bigJRo/KerbalControllerMk1/README.md

# KerbalControllerMk1

Code base for the **Kerbal Controller Mk1** — a modular hardware flight controller
for *Kerbal Space Program*, built around Teensy microcontrollers that talk to KSP
via the [KerbalSimpit](https://github.com/Simpit-team/KerbalSimpitRevamped) plugin.
The system is a set of I2C-networked panels and input modules coordinated by a
central master controller.

## Repository layout

| Path | Contents |
|---|---|
| [`Software/KCMk1_Master/`](Software/KCMk1_Master/README.md) | Master controller firmware (Teensy 4.1 on the Ctrl Module) ([design](Documents/Developer/Master_Firmware_Design.md)). It replaced `Controller_Main`, deleted at the cutover |
| `Software/Displays/` | Display-panel firmware and shared display libraries (see below) |
| `Software/Modules/` | Input-module firmware (buttons, switches, joysticks, encoders, 7-segment, etc.) |
| `Software/Libraries/`, `Software/Common/` | Shared cross-project code |
| `Documents/Developer/` | [Hardware inventory](Documents/Developer/Hardware_Inventory.md) (from the schematics; supersedes the Hardware Reference where they differ), [master firmware design](Documents/Developer/Master_Firmware_Design.md), hardware reference, I2C protocol spec, power budget, module/UI reference, ascent-autopilot interface, expansion-module spec, [display test plan](Documents/Developer/Display_Test_Plan.md) |
| `Documents/User/` | [Quick-start guide](Documents/User/Quick_Start_Guide.md), panel operating guide, and the display references: [Annunciator](Documents/User/Annunciator_Caution_Warning_Reference.md), [Information Displays](Documents/User/Info_Display_Screen_Reference.md), [Resource Display](Documents/User/Resource_Display_Reference.md) (each also as `.docx`) |

### Display panels (`Software/Displays/`)

The display subsystem targets **hardware rev 2**: Teensy 4.1 driving a 7″
1024×600 LT7683 (RA8876-compatible) TFT over a 16-bit 8080 parallel bus, with
FT5316 capacitive touch. (The LT7683 is the physical display controller; it is
register-compatible with the RA8876, whose driver library the firmware uses.)
(Porting status and hardware details are in
[`Software/Displays/PORTING_7inch_TFT.md`](Software/Displays/PORTING_7inch_TFT.md)
and [`Documents/Developer/Hardware_Reference.md`](Documents/Developer/Hardware_Reference.md).)

| Sketch / library | Role |
|---|---|
| `KCMk1_Annunciator/` | Caution & Warning annunciator panel (I2C 0x10) |
| `KCMk1_InfoDisp/` | Flight information display — 13 telemetry screens (I2C 0x12) |
| `KCMk1_ResourceDisp/` | Resource display (I2C 0x11) — up to 16 resource tape meters (9 by default) + EVA mode |
| `libraries/KerbalDisplayCommon/` | Shared UI toolkit — drawing, fonts, formatting, threshold colouring |
| `libraries/KCM_Display`, `KCM_Touch`, `KCMk1_SystemConfig` | Display driver wrapper, touch driver, shared pin map + thresholds |
| `libraries/KerbalDisplayAudio/` | Master-alarm audio (PAM8302A amp + speaker) + DFPlayer audio |
| [`SD_Cards/`](Software/Displays/SD_Cards/README.md) | Ready-to-copy microSD card contents, one folder per display firmware (built from `assets/`) |

Each panel sketch has its own README with per-panel wiring, dependencies, and
screen documentation.

## License

Licensed under the GNU General Public License v3.0 (GPL-3.0).
Written by J. Rostoker for Jeb's Controller Works.
