bigJRo/KerbalControllerMk1/Software/Displays/KCMk1_InfoDisp/README.md

# KCMk1_InfoDisp

**Kerbal Controller Mk1 — Information Display Panel Sketch** · v1.18.0
Teensy 4.1 firmware for the KSP flight information display module.
Part of the KCMk1 controller system. Operates as an I2C slave under a Teensy 4.1 master.

---

## Overview

The Information Display is a 1024×600 touchscreen panel that presents real-time KSP flight telemetry sourced from KerbalSimpit. It runs on a Teensy 4.1 and receives telemetry over USB serial from a running KSP instance.

The panel provides fourteen screens — Launch, Ascent Autopilot, Spacecraft/Aircraft/Rover/Vehicle (PFD), Orbit (+ Advanced Elements + Maneuver), Target/Docking/Navigation, Landing (Powered Descent + Re-entry) — ordered to follow mission phase progression from pre-launch through landing. Navigation is via a sidebar of six buttons on the panel's outboard edge. A first press of a button jumps to its context/primary screen; pressing the button that already owns the active screen cycles that button's modes, and the caption shows the active mode. Title-bar taps no longer switch screens.

**Two units, two roles.** The controller carries two Info Displays, and they are not clones. Both run this firmware and every screen is reachable from either panel, but each has a job and a different set of defaults:

| | Info Display 1 (0x12, panel A1) | Info Display 2 (0x13, panel B1) |
|---|---|---|
| Role | Vehicle-type — *what am I flying?* | Mission-phase — *what phase am I in?* |
| Holds | The PFD family: SPACECRAFT / AIRCRAFT / ROVER / VEHICLE | LAUNCH / LANDING / DOCKING / TARGET / NAVIGATION / MANEUVER / ORBIT |
| Resting screen | SPACECRAFT (PFD) | ORBIT |
| Home screen (boot / standby / demo) | SPACECRAFT (PFD) | LAUNCH |
| Sidebar edge | Left (outboard on A1) | Right (outboard on B1) |
| Sixth button | VEH — Vehicle Info | A/P — the autopilot consoles |
| Ascent Autopilot | Not carried; cannot send commands | Sole owner of the command channel |

Both panels sit inboard on their own half of the console, so their content areas meet at the centreline and read as one field, with the two button columns falling outboard under the pilot's respective hands.

**Context-switching:** Each panel runs its own ladder every frame and follows the mission to the most appropriate screen for its role; see [Context Switching](#context-switching) below. A deliberate sidebar selection latches, and releases when the situation it was set against passes, when the pilot presses back to the ladder's choice, or when the vessel or the scene changes.

**Colour conventions** are consistent across all screens: dark green = nominal, yellow = caution, white-on-red = alarm, dark grey = inactive/not applicable, cyan = pilot-entered or pending. Alarm thresholds are aligned with the KCMk1 Annunciator C&W panel.

The sidebar is deliberately outside that vocabulary: its keys are chrome, not data, so they are achromatic — white-on-black unselected, black-on-grey selected — and colour appears on a key only when it carries live state. This is the convention bezel-key flight decks use (a Garmin G1000 softkey row is exactly this), and it keeps the alerting colours available to the telemetry the sidebar frames.

---

## Hardware

| Component | Part | Interface |
|---|---|---|
| Microcontroller | Teensy 4.1 | — |
| Display | LT7683 (RA8876-compatible) 1024×600 7" IPS TFT | 8080 16-bit parallel |
| Touch controller | FT5316 capacitive | software I2C |
| SD card | Teensy 4.1 on-board microSD | SDIO (`BUILTIN_SDCARD`) |
| KSP telemetry | KerbalSimpit plugin | SerialUSB1 (second USB COM port, e.g. COM5) |
| I2C slave bus | Master Teensy 4.1 at 0x12 (Info Display 1) or 0x13 (Info Display 2) | Wire2 (pins 24/25) |

The display controller is the **LT7683** (the physical part on the ER-TFT070A2-6-5633 module); it is register-compatible with the RA8876, so the firmware drives it through the `wwatson4506/TeensyRA8876-8080` FlexIO3 driver (class `RA8876_t41_p`). "RA8876" therefore appears in driver/library/class names throughout, while the hardware part is the LT7683.

See `Documents/Developer/Hardware_Reference.md` (§8.3, KC-01-1912 carrier) for the display-carrier hardware detail.

### Pin Assignments

All pins are defined in `KCMk1_SystemConfig.h` (hardware rev 2: Teensy 4.1 + LT7683 (RA8876-compatible) 8080-parallel carrier, KC-01-1912). The 16 display data lines are driven by the Teensy 4.1 FlexIO3 hardware via the `wwatson4506/TeensyRA8876-8080` driver — the defines below are documentation; the driver owns the data/WR/RD lines.

| Pin(s) | Function | Direction | Define |
|---|---|---|---|
| 19,18,14,15,40,41,17,16,22,23,20,21,38,39,26,27 | Display data bus DB0..DB15 (FlexIO3) | — | `KCM_TFT_DB0..DB15` |
| 34 | Display /CS chip select | OUT | `KCM_TFT_CS` |
| 33 | Display RS register/data select | OUT | `KCM_TFT_RS` |
| 35 | Display /RESET | OUT | `KCM_TFT_RESET` |
| 36 | Display /WR write strobe | OUT | `KCM_TFT_WR` |
| 37 | Display /RD read strobe | OUT | `KCM_TFT_RD` |
| 32 | Display WAIT (busy from LT7683) | IN | `KCM_TFT_WAIT` |
| 31 | Display INT (from LT7683, unused) | IN | `KCM_TFT_INT` |
| 9 | Backlight enable / PWM | OUT | `KCM_TFT_BL` |
| 4 | Touch software-I2C SCL | — | `KCM_CTP_SCL` |
| 5 | Touch software-I2C SDA | — | `KCM_CTP_SDA` |
| 3 | Touch /RESET (active-LOW) | OUT | `KCM_CTP_RST` |
| 6 | Touch INT (data-ready) | IN | `KCM_CTP_INT` |
| 29 | Master-alarm tone → PAM8302A amp | OUT | `KCM_AUDIO_TONE_PIN` |
| 7,8 | DFPlayer Mini serial (Serial2 RX2/TX2) | — | `KCM_DFPLAYER_SERIAL` |
| 11 | DFPlayer BUSY (net AUDIO_BUSY, LOW = playing) | IN | `KCM_AUDIO_BUSY_PIN` |
| 24,25 | I2C slave bus to master (Wire2 SCL2/SDA2) | — | `KCM_I2C_BUS` |
| 0 | I2C INT (active-LOW, output to master) | OUT | `KCM_I2C_INT_PIN` |
| 1 | I2C RST (shared reset line from master) | IN | `KCM_I2C_RST_PIN` |

**Serial ports:**
- `Serial` (USB COM port 1) — debug output when `debugMode = true`
- `SerialUSB1` (second USB COM port, e.g. COM5) — KerbalSimpit telemetry

**I2C note:** The slave interface to the Teensy 4.1 master is on **Wire2 (pins 24/25)**. Pins 18/19 (Wire) and 16/17 (Wire1) are consumed by the display data bus, so FT5316 touch runs on a bit-banged software-I2C bus (pins 4/5).

---

## Dependencies

| Library | Version | Notes |
|---|---|---|
| KerbalDisplayCommon | ≥ 3.11.0 | Display primitives, fonts, value formatting (String and buffer forms), threshold colouring, the shared readout label colour (pulls in KCM_Display) |
| KCM_Display | ≥ 1.1.0 | `KCM_TFT` display type = `RA8876_t41_p` + shared resolution/pins; the `kcmBacklight*()` backlight helper (this repo) |
| KCM_Touch | — | FT5316 5-point capacitive touch driver (this repo) |
| KCMk1_SystemConfig | ≥ 1.3.0 | Shared hardware pin map + cross-panel threshold constants; the backlight defaults and the BACKLIGHT frame constants (this repo) |
| TeensyRA8876-8080 (`RA8876_t41_p`) + TeensyRA8876-GFX-Common | — | RA8876 8080-parallel display driver (wwatson4506) |
| ILI9341_fonts (PaulStoffregen) | — | ILI9341_t3 font format used by KerbalDisplayCommon |
| KerbalDisplayAudio | — | Master-alarm audio (`tone()`, pin 29 → PAM8302A amp) + DFPlayer support |
| KerbalSimpit | 2.4.0 | KSP telemetry plugin interface |

### KerbalSimpit Plugin Settings

Location: `KSP/GameData/KerbalSimpit/PluginData/Settings.cfg`

```
PortName    = COM5       # SerialUSB1 — the second USB COM port (Teensy dual serial)
BaudRate    = 115200
RefreshRate = 125
Verbose     = True
```

---

## Configuration

All tunables are in `AAA_Config.ino`. Cross-panel aligned thresholds are sourced from `KCMk1_SystemConfig.h` — edit there only.

### Operating Mode

| Constant | Default | Description |
|---|---|---|
| `INFO_DISP_UNIT` | `1` | **In `KCMk1_InfoDisp.h`, not this file.** `1` = Info Display 1 (0x12, vehicle-type role, left sidebar), `2` = Info Display 2 (0x13, mission-phase role, right sidebar, owns the Ascent Autopilot). Set before flashing each board. It lives in the header because the layout constants and sidebar tables are compile-time conditional on it. |
| `debugMode` | `false` | Serial debug output. Set `false` for production. |
| `demoMode` | `false` | `true` = sine-wave demo, no KSP. `false` = live Simpit. In demo the panel also stands in for the master on the Ascent Autopilot console: ARM/DISARM and parameter edits are applied to a demo-side autopilot model and echoed back, so the console's round trip closes on the bench. The demo boots armed; DISARM parks the ascent at IDLE and ARM resumes it. A full demo ascent runs about 53 s. At runtime only the master's I2C flag turns demo on or off: see **Demo Mode**. |
| `DISPLAY_ROTATION` | `0` | `0` = normal, `2` = 180° inverted. |

### Parachute CAG Assignments

| Constant | Default | Description |
|---|---|---|
| `DROGUE_DEPLOY_CAG` | `1` | CAG that deploys the drogue |
| `DROGUE_CUT_CAG` | `2` | CAG that cuts the drogue |
| `MAIN_DEPLOY_CAG` | `3` | CAG that deploys the main |
| `MAIN_CUT_CAG` | `4` | CAG that cuts the main |

Set to `0` to disable (always shows STOWED).

### Key Thresholds

Cross-panel aligned thresholds (edit in `KCMk1_SystemConfig.h`):

| Constant | Value | Annunciator equivalent |
|---|---|---|
| `LNDG_TGRND_ALARM_S` | `10.0` s | `CW_GROUND_PROX_S` |
| `G_ALARM_POS` | `9.0` g | `CW_HIGH_G_ALARM` |
| `G_ALARM_NEG` | `−5.0` g | `CW_HIGH_G_WARN` |
| `G_WARN_POS` | `4.0` g | `KCM_HIGH_G_WARN_POS` (caution tier) |
| `LNCH_G_WARN` / `LNCH_G_ALARM` | = `G_WARN_POS` / `G_ALARM_POS` | The ASCENT G readout uses the same two tiers |
| `G_WARN_NEG` | `−2.0` g | `KCM_HIGH_G_WARN_NEG` (caution tier) |
| `DV_STG_ALARM_MS` | `150.0` m/s | `CW_LOW_DV_MS` |
| `LNCH_BURNTIME_ALARM_S` | `60.0` s | `CW_LOW_BURN_S` |

### Context Routing Bounds (Info Display 2)

| Constant | Default | Description |
|---|---|---|
| `TGT_CONTEXT_MAX_M` | `2000.0` m | Outer bound of the TARGET auto-select window. Inside `DOCK_DIST_WARN_M` (200 m) the DOCKING screen takes priority; past this the RPOD scope has nothing useful to show and ORBIT is the better view. |
| `MNVR_CONTEXT_LEAD_S` | `600.0` s | How far ahead of ignition a planned node auto-selects MANEUVER. Gated on the burn being imminent rather than on a node merely existing, since nodes persist long after they matter. |

For the full threshold listing (aircraft, landing, docking, orbit, spacecraft thresholds), see `AAA_Config.ino`.

---

## I2C Protocol

The InfoDisp operates as an I2C slave on the Wire2 bus (`KCM_I2C_BUS`, pins 24/25). Both Info Display boards run this same firmware image; the unit is chosen at compile time by `INFO_DISP_UNIT` in `KCMk1_InfoDisp.h`:

- `INFO_DISP_UNIT 1` → **0x12** (`KCM_I2C_ADDR_INFODISP`) — Info Display 1
- `INFO_DISP_UNIT 2` → **0x13** (`KCM_I2C_ADDR_INFODISP_2`) — Info Display 2

Beyond the address, the unit selects the panel's role: which context ladder runs, which side the sidebar sits on, what button 5 is, and whether the Ascent Autopilot command channel is live. See the role table in the Overview.

The sync/framing byte (0xAE) is shared by both units. The System Info Display (0x14) is separate hardware and is future work — see `Documents/Developer/Hardware_Reference.md`. In the byte layouts below, `I2C_SLAVE_ADDR` resolves to whichever address the build targets.

### Outbound Packet — InfoDisp → Master

Size: **10 bytes** (`I2C_PACKET_SIZE`). Sent in response to `KCM_I2C_BUS.requestFrom(I2C_SLAVE_ADDR, 10)` (Wire2) after INT asserts. Bytes 0–2 are the status header; bytes 3–9 are the Ascent Autopilot command frame (see `Documents/Developer/Ascent_Autopilot_Interface.md`).

| Byte | Field | Description |
|---|---|---|
| 0 | Sync | `0xAE` (`KCM_I2C_SYNC_INFODISP`) — framing validation |
| 1 | Flags | Bit 0: `simpitConnected`  Bit 1: `flightScene`  Bit 2: `demoMode`  Bits 3–7: reserved (0) |
| 2 | `activeScreen` | Current `ScreenType` enum value (0–17) — the master pushes the status frame for the console on screen. **18** while the input test screen is open (unit 1; `inputTestScreenId()`), whatever screen is underneath. The master passes both units' byte 2 to the input test screen, which shows it as a short name |
| 3 | `cmdSeq` | Ascent-AP command sequence (0 = none; else 1–255, unique per queued command) |
| 4 | `cmdOp` | Ascent-AP command opcode (`AP_CMD_*`) |
| 5–8 | `cmdPayload` | IEEE-754 float32, little-endian (command argument) |
| 9 | `xsum` | XOR of bytes 3–8 (command-frame integrity) |

The master executes the command in bytes 4–8 once, then echoes `cmdSeq` back in the inbound `ackSeq` byte to pop it. Bytes 0–2 are unchanged from earlier revisions, so a master that reads only the first 4 bytes still gets valid status.

**Note:** The sync byte is `0xAE`, not `0xAD`. The value `0xAD` is used by the ResourceDisp — using it here would cause framing collisions if the master dispatches based on sync byte. Master sketches written before v0.13.3 should update their InfoDisp sync byte expectation accordingly.

### Inbound Command Packet — Master → InfoDisp

Size: **2 bytes**. Sent by master at any time.

| Byte | Field | Description |
|---|---|---|
| 0 | `controlByte` | See bit map below |
| 1 | `ackSeq` | Ascent-AP command acknowledgement — the `cmdSeq` just executed (0 = none) |

### Inbound Ascent-AP Status Push — Master → InfoDisp

Size: **40 bytes** (`I2C_AP_STATUS_SIZE`), sync `0xA5` (dispatched by sync byte — see the next section). The master pushes the autopilot's `AscentStatus` so the Ascent Autopilot screen can render live guidance and confirm accepted parameters. Byte 1 = flags (bit0 armed, bit1 southerly, bit2 rollEnable), byte 2 = phase, bytes 4–39 = nine float32 (targetAlt, inclination, loft, rollDeg, maxG, cmdPitch, cmdHeading, cmdThrottle, dynPressure). Full layout in `Documents/Developer/Ascent_Autopilot_Interface.md` §5.

### Inbound Autopilot Status Pushes — Master → InfoDisp

`onI2CReceive()` takes any inbound write of 3 to 64 bytes. A 4-byte write with sync `0xB8` is the BACKLIGHT frame and a `0xAA` write the summary, each latched on its own; anything else goes into one 64-byte buffer, which the main thread dispatches on **byte 0, the sync byte**: `0xAB` to `inputTestFrame()` (demo or not, below), the rest to `processStatusPush()` (live only). Lengths are fixed per frame but need not be unique. The master pushes the full frame only for the console on screen (`activeScreen`), at 5–10 Hz or on change; every 100 ms it also writes the 9-byte `0xAA` summary to both units, so the mission ladder and the console ring see an engaged autopilot from any screen (#83).

| Sync | Length | Console | Layout |
|---|---|---|---|
| `0xA5` | 40 | ASCENT AUTOPILOT (12) | `AscentStatus`, above |
| `0xA6` | 48 | AIRCRAFT AUTOPILOT (14) | flags (bit0 anyEngaged, bit1 thrustEngaged, bit2 leverTouched, bit3 leverDriven, bit4 ascentArmed), pitch / lateral / thrust mode bytes (pitch 5 = GS, lateral 3 = NAV), reason, reasonAge, then ten float32 (att, aoa, vs, alt, roll, hdg, ias, mach, gs angle, cmdThrottle) |
| `0xA7` | 36 | ROVER AUTOPILOT (15) | flags (bit0 cruise, bit1 hdg, bit2 tgt, bit3 brakes, bit4 slopeGuard, bit5 targetAvailable, bit6 follow), reason, reasonAge, then eight float32 (cruise, hdg, maxSpeed, maxSlope, maxRoll, followRange, stopDist, cmdWheel) |
| `0xA8` | 52 | ORBITAL AUTOPILOT (16) | flags (bit0 armed, bit1 executing, bit2 autoWarp, bit3 autoStage, bit4 targetAvailable, bit5 nodeAvailable, bit6 apprEngaged), mode, phase, reason, reasonAge, then eleven float32 (targetAp, targetPe, targetInc, apprRate, apprDist, dvTotal, dvRemaining, tIgnition, burnDuration, accelEst, cmdThrottle) |
| `0xAA` | 9 | any (summary) | ascent, aircraft, rover, orbital and landing flag bytes (each as byte 1 of its full frame), landing mode, entryEngaged, and the master's control group 1–6 (byte 8; an 8-byte summary from an older master reads as group 1). Applied after any full frame; ignored in demo mode |
| `0xA9` | 44 | LANDING AUTOPILOT (17) | flags (bit0 engaged, bit1 brakeArmed, bit2 brakeFiring, bit3 attRefVert, bit4 autoStage, bit5 landed, bit6 brakeMarginal, bit7 vertHold), mode, entryEngaged, reason, reasonAge, accelSource, then nine float32 (descRate, hovrAlt, twrOverride, margin, entryAoa, entryRoll, ignitionAlt, accelEst, cmdThrottle) |

Full layouts and opcodes: `Documents/Developer/Hold_Mode_Autopilot.md` §8 (aircraft, rover) and `Documents/Developer/Mission_Autopilot.md` §8 (orbital, landing).

### Inbound Input Test Frames — Master → Info Display 1

Sync `0xAB`, sent by the master only while this panel reports screen 18 in status byte 2 (I2C spec §15.3; byte layout in `Software/KCMk1_Master/input_test.h`):

| Byte 1 (page) | Length | Rate | Carries |
|---|---|---|---|
| `0` | 40 | every 100 ms | Module presence / FAULT / packet-seen bits, every button module's state word exactly as the module sent it (packet bytes 3 onward), both sticks (buttons, three axes as int8 %), GPWS and Pre-Warp recent presses and state, lever %, throttle touch / FINE / ACTIVE and recent presses, Dual Encoder recent presses, control group and ENC2 count, control mode, ABORT / STAGE safe lines |
| `1` | 24 | every 500 ms | Each module's INT line (0xFF none), the GPWS and Pre-Warp display values, each module's lifecycle (2 bits: 0 ACTIVE, 1 SLEEPING, 2 DISABLED, 3 BOOT_READY) |
| `2` | 24 | every 500 ms | The four 7" displays: which are answering, then from each one's last good status packet its flags (KSP link, flight scene, and the Annunciator's master alarm, the Info Displays' demo, the Resource Display's demo / caution / alarm / time tier), the Annunciator's C&W bits, both Info Displays' screens, the Resource Display's bar count and worst resource |

`inputTestFrame()` takes a frame only at its page's exact length, in demo too. See **Input Test Screen**.

### Inbound BACKLIGHT Frame — Master → InfoDisp

**4 bytes** (`KCM_I2C_BACKLIGHT_LEN`): `[0xB8, flight %, standby %, 0]` (`KCM_I2C_SYNC_BACKLIGHT`; I2C spec §15.3, GitHub #47). Latched in `onI2CReceive()` and applied on the main thread by `kcmBacklightSetLevels()` (KCM_Display). The master sends it to all four 7" displays at once on a change and every 2 s. See **Backlight**.

**`controlByte` bit map:**

| Bits | Field | Description |
|---|---|---|
| 7:4 | `requestType` | Command code — see table below |
| 3 | `idle_state` | `1` = switch to Standby when not in a flight scene |
| 2 | `trimEnabled` | `1` = trim hold engaged — shows the cyan `TRIM` annunciation on the SPACECRAFT / AIRCRAFT screens |
| 1 | `demoMode` | `1` = enable demo mode |
| 0 | `debugMode` | `1` = enable Serial debug output |

**Request type codes (`controlByte` bits 7:4):**

| Code | Name | Action |
|---|---|---|
| `0x0` | NOP | No operation |
| `0x1` | STATUS | Force immediate status packet — assert INT now |
| `0x2` | PROCEED | Release boot hold — InfoDisp enters main loop |
| `0x3` | MCU_RESET | Soft reboot the InfoDisp (USB disconnect then ARM AIRCR reset) |
| `0x4` | DISPLAY_RESET | Reset display state and force full redraw of current screen |

### Boot Handshake

After initialisation, the InfoDisp asserts INT and spins on `PROCEED` (0x2) before entering `loop()`. This synchronises the boot sequence across all KCMk1 panels. The master can include configuration flags (`idle_state`, `demoMode`, `debugMode`) in the same packet as PROCEED.

---

## Screens

The panel displays eighteen screens navigated by six outboard-edge sidebar buttons. Screen order follows mission phase progression. A first press of a button jumps to its context/primary screen; pressing the button that already owns the active screen cycles its modes, and the button caption shows the active mode. Several buttons are multi-mode: PFD covers SPACECRAFT / AIRCRAFT / ROVER (plus VEHICLE on unit 2), ORB covers ORBIT / Advanced Elements / MANEUVER, TGT covers TARGET / DOCKING / NAVIGATION, and LNDG covers POWERED DESCENT / RE-ENTRY. Title-bar taps no longer switch screens.

Buttons 0–4 are identical on both units, so every screen stays reachable from either panel and losing one display never costs a screen class. Only button 5 differs.

PFD is pinned to the top key on both units: it is the screen a pilot returns to from anywhere, it is unit 1's entire role, and the top key is the easiest to find without looking away from the content. The remaining five keep the original mission-phase progression — LNCH, ORB, TGT, LNDG — with the single-mode key at the bottom.

| Btn | Sidebar | Screen(s) | First press / cycle | Caption |
|-----|---|---|---|---|
| 0 | PFD | SPACECRAFT / AIRCRAFT / ROVER (/ VEHICLE) | First press = context screen (SPC/ACFT/ROVR by vessel). Press cycles SPC → ACFT → ROVR on unit 1, which carries VEH on its own button; unit 2 keeps the four-deep ring SPC → ACFT → ROVR → VEH | SPC / ACFT / ROVR / VEH |
| 1 | LNCH | LAUNCH | Pre-launch board shown automatically on pad (a press dismisses it into ascent); otherwise press cycles ASCENT ↔ CIRCULARIZATION | PRE / ASC / CIRC |
| 2 | ORB | ORBIT / ORBIT ADVANCED / MANEUVER | First press = ORBIT (Apsides); press cycles ORB → ORB+ (Advanced Elements) → MNVR (Maneuver) | ORB / ORB+ / MNVR |
| 3 | TGT | TARGET / DOCKING / NAVIGATION | First press = DOCKING when a target is within docking range, else TARGET; press cycles TGT → DOCK → NAV. NO TARGET SET / DOCKED fullscreen when applicable. NAV needs no target and works without one | TGT / DOCK / NAV |
| 4 | LNDG | POWERED DESCENT / RE-ENTRY | First press = POWERED DESCENT; press cycles DESC ↔ ENTR | DESC / ENTR |
| 5 | A/P *(unit 2)* | ASCENT / ORBITAL / LANDING / AIRCRAFT / ROVER AUTOPILOT | The five autopilot consoles, parked at the bottom below the display-nav cluster. First press = the console for the situation (a console with a mode engaged wins; else rover → ROVER AP, plane in atmosphere → AIRCRAFT AP, in orbit or with a node → ORBITAL AP, suborbital or descending → LANDING AP, else ASCENT); a repeat press cycles only the consoles the vessel type and situation can use (a landed rover cycles RVAP alone; a plane in atmosphere ACAP → ASC → ORAP → LDAP; a rocket ASC → ORAP → LDAP). Turns green while any autopilot is armed or engaged. On-screen keypad for parameter entry; touch ARM/EXEC or mode buttons. Unit 2 only: it is the sole owner of the autopilot command channel | A/P at rest; ASC / ORAP / LDAP / ACAP / RVAP while a console is on screen |
| 5 | VEH *(unit 1)* | VEHICLE INFO | Standalone, single-mode. Promoted out of the PFD ring on the vehicle-type panel — it is where the ladder routes a recoverable vessel, and moving it here shortens that panel's PFD ring from four modes to three | VEH |

**LNCH** — *Pre-launch board* (automatic when `sit_PreLaunch`, for every vessel type): vessel name, type, SAS, RCS, throttle, EC, crew count, CommNet signal, ΔV.Tot, and parachute CAG states. Tap content area or launch to advance to ascent. *Ascent:* left panel — altitude ladder (vessel + apoapsis markers, read against the labelled tick scale), ATMO gauge, V.VRT bar, V.ORB bar, FPA dial and heading tape. The three bar gauges each carry their **own value** in a boxed window between the name and the top endpoint label, so a bar and its digits read as one instrument. The **atmosphere column is the exception: a name and a bar, no window.** Its bar is the one gauge here whose own quantity is not worth digits — a percentage restates where the triangle already points, and raw density reaches `0.00` around 30 km with the triangle still a quarter of the way up, because the bar plots (ρ/ρ_surface)^0.25 so the thin upper atmosphere stays visible. The sky-to-navy gradient with a triangle on each side reads as "atmosphere, and how deep" without a number under it, and **Q** in the right column is the atmospheric number that does earn digits. The ladder's two markers are labelled **`ALT`** (filled, vessel) and **`Ap`** (hollow, apoapsis). Right column, seven rows, every one a value with no picture anywhere on the screen: **T+Ap, Thrtl, Q, Mach, G, Stg.Brn, ΔV.Stg**.

**Q (dynamic pressure)** is `½·ρ·v²` from `airDensity` and `surfaceVel`, in kPa — yellow past `LNCH_Q_WARN_KPA` (20), white-on-red past `LNCH_Q_ALARM_KPA` (40). This is the number the ATMO gauge cannot show: density falls monotonically from the pad, while Q rises to a peak near 5–8 km (10–15 kPa on a typical Kerbin ascent) and then falls, and that peak is the one structural event of an ascent. **G** uses the Annunciator's crew limits so the panels cannot disagree. **Stg.Brn** is stage endurance from `BURNTIME_MESSAGE` — the same field and the same name the circularisation phase uses.

*Circularization:* left half — orbit diagram with apsis markers, ΔV burn bar, attitude alignment disc, the T+Ign countdown, and on the rail beneath the disc **Ecc** and **Ap−Pe**: the shape of the orbit, beside the picture of it. The right third is an **apsis convergence tape**: a vertical altitude scale with apoapsis fixed near the top, periapsis climbing to meet it, and the orbit-safe altitude (`max(minSafe, lowSpace)` — the same line the mission ladder uses) drawn as the floor the orbit must clear. A bracket spans the two markers, which are **cyan for Ap and magenta for Pe — the same two colours the orbit diagram gives its dots**, so a marker on the tape and a dot on the diagram read as the same apsis. State is annunciated by form rather than hue: a marker draws hollow while its value is off the bottom of the scale. Beneath it, three rows describing the burn: **ΔV.Circ** (velocity change still needed, from vis-viva), **Burn Dur** (how long the planned burn runs) and **Stg.Brn** (seconds of thrust left in the stage, from Simpit's `BURNTIME_MESSAGE`). Read together they answer one question — can this stage finish this burn — which is why they sit together rather than scattered across the screen.

This column was eight numeric rows mirroring the ascent readout — Alt.SL, V.Orb, ApA, PeA, T+Ap, Thrtl, T.Brn, ΔV.Stg — of which seven also sit on the PFD on the other panel, in every phase this screen is up. 38% of the display restated the display beside it, while the one relationship the pilot is actually flying appeared on neither: both apsides are on the PFD as independent numbers, but the *gap between them* and the rate it is closing are not, and no readout can show a rate. The tape's scale quantises its ends to whole tick steps, so the frame holds still while the marker moves — one rescale across a whole Kerbin circularisation, measured on the host. A suborbital periapsis is hundreds of kilometres below the surface and cannot be framed with the apoapsis; its marker clamps to the bottom and draws hollow until the burn brings it into view.

**ASCENT → CIRCULARISATION switches on the engine, not on altitude.** The launch arc has three ordered stages — powered ascent, coast, circularisation burn — and this screen has two modes, so ASCENT is the powered ascent and CIRCULARISATION is everything from the coast onward. Two conditions start it: **throttle at or below `LNCH_COAST_THROTTLE`** (2%), and **apoapsis already at or above the orbit-safe altitude**, the second so a throttle-down through max Q or a staging gap does not read as a coast a minute after liftoff. It then **latches**, because the circularisation burn re-opens the throttle and a live test would drop back to ASCENT for the one burn CIRCULARISATION exists to fly. The latch clears on the surface and whenever apoapsis falls back below the line.

**ASC** — Ascent Autopilot touch console for the Simpit ascent autopilot (which runs on the master, `KCMk1_Master`). The ARM button, the ARMED/DISARMED banner and the sidebar ASC key all annunciate the autopilot's own reported state, never an unacknowledged tap: a tap raises a pending cue (cyan border, `ARMING…`/`DISARMING…`, `...` on the banner) and the state changes only when the master echoes it back. Three columns: MISSION inputs (target apoapsis, inclination, launch N/S), VEH PROFILE inputs (loft, roll hold, max-G) + the ARM/DISARM button, and GUIDANCE outputs (commanded pitch/heading/throttle, G, dynamic pressure, ApA, PeA). Boxed input fields open an on-screen numeric keypad (or toggle) and can be edited at any time; a pilot edit shows in cyan until the autopilot echoes the accepted value back. The phase banner and ARM button colour reflect the autopilot phase (IDLE / VERTICAL / GRAVITY TURN / COAST / CIRCULARIZE / COMPLETE / ABORT). Edits and ARM/DISARM are sent over I2C — see `Documents/Developer/Ascent_Autopilot_Interface.md`.

**ACAP** — Aircraft Autopilot console for the hold-mode autopilot's aircraft modes (which run on the master). Same grid as ASC. Column 1 PITCH: mode buttons ATT / AOA / V/S / ALT with a setpoint box each; column 2 LATERAL / THRUST: ROLL / HDG / IAS / MACH, then the LVL (wings level + V/S 0) and A/P OFF buttons; column 3 FLIGHT DATA: live pitch, roll, heading, V/S, altitude, IAS, Mach from the panel's own telemetry. Mode buttons are three-state — off (grey outline), pending (cyan outline: tap sent, not yet echoed), engaged (green fill). Tapping a mode engages it and the master captures the current value as the setpoint; tapping a box opens the keypad and applies whether or not the mode is engaged. The banner lists the engaged modes, carries a disconnect reason in orange for five seconds (STICK, A/T OFF: LEVER, NO ATMO, TELEMETRY, …), and shows `LEVER OFF` in grey when the autothrottle is engaged but the Throttle Module is not following it. Commanded throttle is deliberately not shown: with the autothrottle engaged the physical lever is the throttle readout. Design and byte contract: `Documents/Developer/Hold_Mode_Autopilot.md`.

**RVAP** — Rover Autopilot console. Column 1 DRIVE: CRUISE (signed speed), HDG (heading) and TGT (drive to the target bearing; HDG and TGT are exclusive); column 2 GUARD LIMITS: editable SPEED, SLOPE and ROLL limits and the A/P OFF button; column 3 DRIVE DATA: signed speed, heading, target bearing, pitch, roll, commanded wheel throttle and brake state. The slope guard scales the cruise setpoint down on steep grades (banner `SLOPE LIMIT`, speed and pitch readouts orange); the roll guard disconnects and brakes. Same three-state buttons, keypad and echo-confirmed cues as ACAP.

**NAV** — Navigation display: a plan view for atmospheric flight, and the other half of a glass-cockpit pair with the PFD on the opposite panel. ROVER's compass card at 1.12× (shared renderer, `Compass.ino`; every radius is ROVER's scaled by one factor, so the two read as one instrument at two sizes), with the nose fixed at 12 o'clock and two bearing markers: **green** for ground track — where the vessel is actually moving — and **violet** for target bearing, matching the target colour used elsewhere. A **ground-track line** runs from the aeroplane out to the green marker, so the crab angle is a visible wedge between the nose and the track rather than only the signed number in DRIFT. An **own-ship aircraft symbol** sits at the card centre with the rose turning around it, so the display reads heading-up rather than as a dial, and a **legend in the bottom-left corner names both markers** — colour alone is not a label, but a legend is reference material, so it sits where the eye goes last and in the smallest font on the screen. Heading box above the card, dark green like every other nominal readout on the panel; left column TRK, DRIFT and **BRG** (the violet marker's own number, so every marker on the card has digits somewhere); right column DIST, V.CLOSE and **T+INT** (all dashed when no target is set); no bottom strip — the card has that height instead. `T+INT` is range over closure rate, closing only — the same quantity, formula and label as TARGET's `T+Int` row, so one number does not carry two names across screens. **DRIFT** — ground track minus heading, the crab angle — is the one number on this screen that appears nowhere else on either panel, and it turns yellow past `NAV_DRIFT_WARN_DEG` (10°): it is the difference between a heading that is holding and one that is quietly sliding off. Track and drift are dashed below `NAV_TRK_MIN_MS` (5 m/s), where KSP's reported velocity heading wanders. Everything is derived from telemetry the panel already receives — no new Simpit channels.

**ORB** — *Apsides (default):* graphical orbit + inclination diagram with numeric readouts SMA, Ecc, PeA, ApA (left panel) and Inc, Period, Arg.Pe, T+Pe/T+Ap (right panel). *Advanced Elements:* text-only readout — SMA, Ecc, PeA, ApA, Alt.SL, V.Orb, Period (left column) and Inc, LAN, Arg.Pe, True Anom, Mean Anom, T+Pe, T+Ap (right column). Reached by cycling the ORB sidebar button (ORB → ORB+ → MNVR); a first press of ORB from another screen returns to Apsides.

**PFD** — Primary Flight Display (SPACECRAFT): full EADI ball with pitch ladder, roll pointer, fixed spacecraft (boresight) symbol, navball velocity/target/maneuver markers, and Hdg/Pitch/Roll readouts. Right panel: Alt.SL, V.Orb/V.Srf (label swaps with orbital mode), ApA, PeA, T+Ap, T+Ign, ΔV.Stg, and RCS/SAS buttons.

*On EVA* the ball is unchanged — you do orient on EVA — but the panel swaps rows 2–6, which otherwise show a Kerbal a stage ΔV, an apoapsis and a time-to-ignition that do not exist: **Alt.Rdr, V.Srf, Dist, V.Close, EC**. Row 1 pins to V.Orb rather than following orbital mode, so V.Orb and V.Srf are both always present — the pair is how you tell station-keeping from drifting. Dist and V.Close dash out when no target is selected; EC (suit charge) uses ROVER's thresholds, 20% caution and 5% alarm, and is the number that ends an EVA. RCS and SAS stay: both are exactly as meaningful for a Kerbal on a jetpack. The swap is triggered by `vesselType == type_EVA` and re-enters the screen so the row labels redraw, the same mechanism the V.Orb/V.Srf swap has always used.

**MNVR** — Burn alignment reticle (blue maneuver marker vs a fixed nose crosshair; neon-green alignment box when within 5°) plus a numeric panel: ΔV.Mnvr, ΔV.Plan (total across all planned nodes), ΔV.Stg, T+Ign, T+Mnvr, Burn Dur, Brg/Elv (nose-to-node error split), and RCS/SAS buttons. A ΔV-burn bar sits under the reticle. **NO MANEUVER** fullscreen when no node is planned.

**TGT** — RPOD scope reticle + numeric panel: Dist, V.Close (signed closure rate — negative = closing), bearing/elevation of the target from the nose (Brg/Elv), approach-path error about the target axis (V.Brg/V.Elv, same labels and quantity as DOCK), and T+Int (intercept time = Dist ÷ |closure|, shown only while closing). All scope markers are nose-referenced: the VEL marker sits at centre when the relative velocity runs along the boresight, and on the TGT marker when it is aimed at the target. Dist turns white-on-green below 200 m. NO TARGET SET fullscreen when no target.

**DOCK** — Approach reticle + numeric panel: Dist, T+Dock (Dist ÷ |closure|, closing only), V.Close (signed closure rate), V.Lat (total lateral drift magnitude), Brg/Elv (the port relative to the nose) and V.Brg/V.Elv (approach-path error about the target axis; `---` past 90°) — the same four angles TGT shows, in the same split-row layout — Nos.Off (total nose angular offset from the port, colour-banded), and RCS/SAS buttons. The green VEL marker shows the craft-to-port **relative velocity** referenced to the nose, and the whole marker layer is rotated into the craft's body axes (by −roll), so it flies like a prograde marker at any roll attitude: marker up and right of the crosshair → thrust left and down to centre it. SAS: TARGET = green, STAB = cyan, OFF = white-on-red, all other modes = red. DOCKED / NO TARGET SET fullscreen when applicable.

**LNDG** — *Powered descent:* V.Vrt, T+Grnd, Alt.Rdr, Stg.Brn, Fwd/Lat horizontal drift (roll-corrected, craft heading frame), ΔV.Stg, Throttle/RCS, Gear/SAS, beside the altitude tape, X-pointer, ATT bullseye, V.Vrt bar and ground-track compass. Fwd/Lat thresholds tighten as T+Grnd decreases.

**ENTR** — *Re-entry* (separate sidebar screen): graphical instrument screen — corridor tape, atmosphere-density bar, G meter, and a heat-shield / retrograde alignment ball — with a text panel of T+Grnd/T+Atm (row 0 toggles by descent phase), Alt.SL/Alt.Rdr (row 1 toggles by atmosphere state), V.Srf, V.Vrt, PeA, Mach, drogue/main parachute states, and Gear/SAS buttons. G load is shown by the graphical G meter, not a row. The corridor bands come from the body's corridor table (`_reCorridor()`, shared with the mission ladder); the two row toggles follow the atmosphere state and periapsis. SAS white-on-red above Mach 3 if OFF.

**VEH** — Vessel name, type, situation, control level, CommNet signal, crew/capacity, ΔV.Stg, ΔV.Tot.

**ACFT** — Full EADI ball (pitch ladder, roll pointer, aircraft symbol, Hdg/Pitch/Roll readouts) plus a right panel: Alt.SL (handing over to Alt.Rdr below `ACFT_ALT_RDR_ON_M`), V.Srf, IAS, V.Vrt, Ma/G split, AoA/Slip split, and GEAR / AIRBRK / BRAKES buttons. V.Vrt and the VSI bar take POWERED DESCENT's landing tiers (caution below 5 m/s down, alarm below 8) only on an approach, with the gear down or below the radar-altimeter handover height; in cruise a descent is reported, not alarmed. The AIRBRK button reads IN (stowed) or OUT (deployed, cyan) from the airbrake CAG: base `AIRBRAKE_CAG` 38, offset by the master's control group like the AIR BRAKE button (`38 + (group − 1) × 40`, the group from the summary frame's byte 8).

**ROVR** — Rotating compass (shared renderer, `Compass.ino`; heading readout, cardinal ring, rover icon, target-bearing triangle when a target is set) with a DIST / T+TGT strip along the bottom. Left column: V.SRF, TTE (time to empty at the measured discharge rate, sampled on every screen so it has an answer on entry), and BRAKES / GEAR / SAS buttons. Top corners: FWD / REV drive-state blocks (both muted = NEUTRAL) driven by wheel throttle. Right column: ALT.TRN (terrain elevation, Alt.SL − Alt.Rdr), Pitch and Roll tilt indicators. The rover art (top view at the compass centre; side and rear views, one pre-rotated frame per degree, in the tilt boxes) is read from the SD card's `/Rover/` folder (made by `tools/rover_art.py`; load the card from `SD_Cards/KCMk1_InfoDisp/`); without it the screen falls back to the vector rover.

### Context Switching

Each panel runs its own ladder. Splitting them is what makes two displays worth more than one: the single-display ladder had to interleave vessel-type and mission-phase rules and rank one above the other, and vessel type won — so a spaceplane on the pad never saw the pre-launch board, and neither a spaceplane nor a rover closing on a target ever auto-routed to DOCKING. With a panel per question, neither ladder masks the other and both are complete.

**Info Display 1 — `vehicleContextScreen()`**

| Priority | Condition | Screen |
|---|---|---|
| 1 | Rover | ROVER |
| 2 | Plane in the atmosphere | AIRCRAFT |
| 3 | Everything else | SPACECRAFT (PFD) |

This panel answers one question and admits no exceptions: the answer is always an instrument for the vehicle. VEHICLE INFO is a status summary rather than an instrument, so it belongs to the mission panel, which routes to it from the surface rule; it stays one press away here on the VEH key. With that, no reachable pairing shows the same screen on both panels.

**Info Display 2 — `missionContextScreen()`**

| Priority | Condition | Screen |
|---|---|---|
| 1 | Pre-launch (`sit_PreLaunch`) — every vessel type, spaceplanes included | LAUNCH (pre-launch board) |
| 2 | Descending, periapsis inside the atmosphere, and either above it or past `REENTRY_CTX_MACH` | RE-ENTRY |
| 3 | Descending faster than `LNDG_CTX_VVERT_MS` below `LNDG_CTX_ALT_M` radar altitude (planes in atmosphere excluded) | POWERED DESCENT |
| 4 | An aircraft flying in an atmosphere, apoapsis below the top of it — flying, not climbing out | NAVIGATION |
| 5 | Target within `DOCK_DIST_WARN_M` (200 m) | DOCKING |
| 6 | Landed or splashed | TARGET if one is set, else VEHICLE INFO |
| 7 | Climbing (vertical speed positive) with periapsis below the orbit-safe altitude | LAUNCH (ascent / circularisation) |
| 8 | Node planned and T+Ign < `MNVR_CONTEXT_LEAD_S` (10 min), including during the burn | MANEUVER |
| 9 | Target between 200 m and `TGT_CONTEXT_MAX_M` (2000 m) | TARGET |
| 10 | On EVA | TARGET |
| 11 | Everything else | ORBIT |

Rule 10 puts a Kerbal outside the craft on the screen for the one thing they are doing: getting to something. Rules 5 and 9 already cover a target that is set and close; rule 10 catches the rest, including the case that matters most — nothing selected, where TARGET's `NO TARGET SET` fullscreen is honest advice rather than a dead end, and where ORBIT was previously offering a Kerbal an apoapsis. It sits below the surface rule deliberately: a Kerbal standing on the Mun is not on an approach. Rule 7 gives LAUNCH the whole arc from liftoff to orbit insertion, not just the pad. Rule 1 covers `sit_PreLaunch` alone, so before this the screen vanished the instant the clamps released and the mission panel spent the entire ascent on ORBIT — a plan view of an orbit that does not exist yet, while the ascent readout it does have (ApA, T+Ap, T.Burn, ΔV.Stg) sat one press away. A circularisation node then pulled it to MANEUVER, the generic burn reticle, rather than the screen built for that specific burn.

Two tests say *going up, and not there yet*. **Periapsis below the orbit-safe altitude** — `max(minSafe, lowSpace)`, which `body_params.h` already defines as the boundary between an orbit and an aerobrake: the top of the atmosphere where there is one, the highest terrain where there is not (Kerbin 70 km, Mun 7.1 km). **Vertical speed positive** — still climbing, which is what keeps the rule off a descent. That second test matters most on an airless body, where neither RE-ENTRY nor POWERED DESCENT is watching: a lander coming down from Mun orbit also has a periapsis below the surface, and without it the panel would read LAUNCH all the way down. The release band (`LNCH_CTX_VVERT_RELEASE_MS`, −20 m/s) lets vertical speed pass through zero at the top of the coast, which is the middle of the arc rather than the end of it. Rovers and Kerbals are excluded — a rover cresting a hill and a Kerbal on a jetpack are both briefly climbing with no periapsis, and neither is launching. The screen picks its own mode inside the arc, so the rule only has to decide that the vessel is launching.

Rule 4 is what NAVIGATION exists for; see the screen entry above. Its condition is exactly the one Info 1 uses to put AIRCRAFT up, so NAV appears if and only if its partner PFD is the aircraft PFD — the two panels are the standard airliner pair, or they are not paired at all. Stated as bare "in an atmosphere" it also caught a booster a kilometre off the pad, handing a rocket a compass rose during ascent and then swapping to ORBIT mid-burn as apoapsis crossed the top of the atmosphere; the apoapsis test does the remaining work, keeping a spaceplane on ORBIT once it is climbing out.

It sits at 4 because nothing below it is an aircraft instrument. From the bottom of the ladder, TARGET and DOCKING outranked it, so a plane cruising to a waypoint 1.5 km ahead got the rendezvous scope and one at 150 m got the docking-port alignment reticle — exactly when the navigation display is most wanted. The only two rules that legitimately beat a compass sit above it: the pre-launch board, and the re-entry corridor, which is what a spaceplane at Mach 6 needs and NAV is not. Rollout and taxi are handed back to rule 6, which routes to the recovery summary.

**Aircraft must be typed as aircraft.** Both the AIRCRAFT PFD and NAVIGATION key off `vesselType == type_Plane`, so a plane KSP thinks is a Probe gets SPACECRAFT and ORBIT — no attitude display for an aircraft, and no navigation display to pair with it. This is a deliberate project rule rather than a gap to paper over: the vessel type is the pilot's declaration of what they are flying, and inferring it from a flight profile instead is what put a rocket on a compass rose in the first place. Rule 2 reuses the RE-ENTRY screen's own corridor classifier (`_reCorridor()` / `_rePeRegime()`), so the rule and the screen cannot disagree about what a re-entry is, and it fires before entry interface. Rule 3 replaced `type_Lander && sit_SubOrb`, which missed every Ship landing on the Mun and fired during ascent, since sub-orbital is also what a rocket climbing out looks like. Rule 6 replaced ORBIT-for-everything, which gave a rover parked on Duna an apoapsis, periapsis, inclination and period.

Three of these are new, and all three are things a single display could not afford:

- **ORBIT as the resting state.** Previously "Orbit is never auto-selected — reach it from the sidebar", because auto-selecting it would have cost the pilot their attitude reference. Info Display 1 now holds that permanently.
- **MANEUVER on an imminent burn** (rule 8), gated on time-to-ignition rather than on a node merely existing — nodes persist long after they stop being the pilot's concern. Negative time-to-ignition passes too, so the screen stays up through the burn.
- **TARGET in the approach window** (rule 9), bounded at both ends: inside 200 m rule 5 has already taken it, and past 2000 m the RPOD scope has nothing useful to show.

A deferred dock-check fires on the next `TARGETINFO` message after a vessel switch to catch the case where target distance is not yet known at switch time; it re-runs the ladder rather than routing to DOCKING directly.

**Both ladders run every frame.** They previously ran only at vessel and scene boundaries, which meant the panels did not follow the mission: liftoff, reaching orbit, a node coming due, a target closing and re-entry all passed without either panel reconsidering. Two guards keep continuous evaluation from flapping — a release band on every numeric rule (once a rule owns the screen its threshold widens, so station-keeping at 200 m cannot oscillate the panel) and a minimum dwell between automatic switches (`CONTEXT_DWELL_MS`).

**Manual selection latch.** A sidebar press that lands somewhere other than the ladder's current choice latches that choice. The override means *not this, now* rather than *never again*, so it releases three ways: when the ladder's answer changes (the situation it was set against has passed), when the pilot presses the button owning the screen the ladder currently wants (an explicit return to automatic), or on vessel change / scene entry. `contextSwitchAllowed()` is the gate every auto-route passes.

**AUTO / MAN chip.** A rounded-outline badge at the right of the title bar states, in words, whether the screen was chosen by the ladder or is being held by hand. MAN is dark green — engaged-mode green, the same assignment the ASC key uses while the autopilot is armed, since a held selection is a mode the pilot has engaged; AUTO is grey. Both are outlined rather than filled, matching the sidebar keys, so the badge reads as status and not as something to press. It covers the LAUNCH screen's own ASC/CIRC phase override too, which replaced that screen's red override dot.

### Annunciator Alignment

| Annunciator | InfoDisp equivalent | Match |
|---|---|---|
| `CW_GROUND_PROX` — T.Grnd < 10 s, gear up | T.Grnd / V.Vrt white-on-red at same condition | ✓ Exact |
| `CW_HIGH_G` — g > 9 or < −5 | G: white-on-red at same values | ✓ Exact |
| `CW_LOW_DV` — stage ΔV < 150 m/s | ΔV.Stg white-on-red at same value | ✓ Exact |
| `CW_ALT` — alt < 200 m | Alt.Rdr yellow at 500 m, white-on-red at 50 m | Related (different thresholds) |

### Input Test Screen (Info Display 1)

A hidden full-panel screen, sidebar included, showing what the master reads from every module, raw (Hardware Inventory §8.11). `InputTest.ino`; unit 1 only (unit 2 ignores the gesture).

- **Open and close:** a two-finger diagonal pull down from the top-right corner. Both fingers must land in the corner zone (`IT_ZONE_W` × `IT_ZONE_H`, 320 × 220 px), then their midpoint must move at least `IT_PULL_PX` (140 px) left **and** 140 px down within `IT_PULL_MS` (1.5 s). The same pull closes it. Available any time: flight, standby or demo. `processTouchEvents()` now runs on standby too, and hands every touch to `inputTestTouch()` before the single-finger filter; a touch the gesture has claimed never reaches the tap handling, even as the fingers lift one at a time.
- **While open:** taps do nothing; status byte 2 reads 18; `loop()` services only the overlay. The screen underneath is kept, and closing repaints it in full (or the standby splash, out of a flight scene and demo).
- **Data:** the master's three `0xAB` frames (above). The overlay is repainted when a frame arrives and at least every 250 ms. The title shows **LIVE**, or **NO DATA** when no page 0 has arrived for 1.5 s.
- **Module rows:** a row per module (UI, FUNCTION, ACTION, STABILITY, VEHICLE, TIME, AUX, ROTATION, TRANSLATION, GPWS, PRE-WARP, THROTTLE, DUAL ENC) with its address, INT line, state and inputs.
  - **State:** the lifecycle the module reports (page 1): ACTIVE green, SLEEPING sky, DISABLED amber, BOOT RDY magenta; MISSING red when it is not present; `...` until page 1 arrives. If its last packet had the FAULT bit (status byte bit 2) the cell is white on red. The header reads "INPUTS (lit = bit set)" and "red STATE = FAULT".
  - **Inputs** (lit boxes = bit set): on the button modules, the state word exactly as the module sent it, buttons and switches; stick buttons and axis %; recent presses with the module state and value on GPWS / Pre-Warp; recent presses, TOUCH, FINE, NOT ACTIVE on the throttle; recent presses, control group and ENC2 count on the Dual Encoder.
- **Right column:** TRANSLATION (left) and ROTATION (right), each with a position dot, twist bar, values as `X:+n  Y:+n  Z:+n` and STK / B1 / B2; the lever bar and % (blue while touched); the mode selector (SPC / PLN / RVR); the ABORT / STAGE safe lines; `CONTROL GROUP  n` on one line.
- **DISPLAYS** (bottom right, page 2): a row each for ANNUNC, INFO 1, INFO 2 and RESOURCE. `--` until page 2 arrives; NO ANSWER (red) when the master's last status read of it failed; otherwise LINK (green) / NO LINK (red), FLIGHT / STBY, then:
  - Annunciator: ALARM (red) while the master alarm is on, and `C&W n`, the number of lit tiles;
  - Info Displays: DEMO, and the screen on view as a short name (`itScreenName()`: LNCH, ORB, … ASC AP …, INPUT for screen 18, `?` past the table);
  - Resource Display: DEMO, CAUTION (yellow) or ALARM (red), and `n bars`.
- **Render:** `Documents/User/assets/InfoDisp1_INPUT.png`, made with `python3 tools/render_screen.py --sketch KCMk1_InfoDisp --suffix 1 INPUT` (in `Software/Displays`).

### Demo Mode

Demo follows the master's I2C flag and nothing else (Hardware Inventory §8.8). A scene change no longer clears it (the `demoMode = false` in `enterFlightScene()` and on leaving flight is gone).

- **In demo** `Demo.ino` drives `state`. `simpit.update()` still runs whenever `simpitConnected`, so the link stays up, but `onSimpitMessage()` hands every message to `demoLifecycle()`: `SCENE_CHANGE` and `FLIGHT_STATUS` keep `flightScene` current and a dock / undock keeps the docked flag; no screen changes, and the telemetry is dropped.
- **Leaving demo** (`leaveDemoMode()`, from `processI2CCommand()`) is a fresh start. In a flight scene: `resetForVesselSwitch()` (the per-vessel reset a vessel switch runs, now one function), `enterFlightScene()`, and the context switch once `FLIGHT_STATUS` reports the real vessel type. Otherwise the standby splash on the home screen. Then a full telemetry refresh. Simpit is started first if the unit booted in demo.
- A bench unit booted with `demoMode = true` has no Simpit link until the master clears the flag.

### Backlight

The backlight (pin 9, `KCM_TFT_BL`) is driven by the shared `kcmBacklight*()` helper in KCM_Display (GitHub #47): the **standby level** while the standby splash is up (`!flightScene && !demoMode`), the **flight level** otherwise. Both start at the KCMk1_SystemConfig defaults (`KCM_BL_BRIGHTNESS_PCT` 70 %, `KCM_BL_STANDBY_PCT` 20 %) and are replaced by the master's BACKLIGHT frame. Every level is clamped to `KCM_BL_MIN_PCT` (5 %) … 100 %, and the duty ramps to a new level (`KCM_BL_RAMP_MS`, 300 ms for the full range). Still to check on the real panel: flicker at low duty and the usable floor.

---

## Tab Structure

| File | Description |
|---|---|
| `KCMk1_InfoDisp.ino` | `setup()` and `loop()` only |
| `AAA_Config.ino` | All tunable constants |
| `AAA_Globals.ino` | Global state, `AppState`, `switchToScreen()`, the two context ladders + `contextScreen()`, the manual-selection latch, `drawStandbyScreen()` |
| `AAA_Screens.ino` | Shared screen infrastructure, layout constants, `drawValue()` helper, dispatch switches |
| `Screen_LNCH.ino` | Launch dispatcher (selects pre-launch / ascent / circularization) |
| `Screen_LNCH_PreLaunch.ino` | Launch pre-launch checklist board |
| `Screen_LNCH_Ascent.ino` | Launch ascent (graphical: ladder, V.Vrt/V.Orb bars, FPA dial, atmosphere gauge) |
| `Screen_LNCH_Circ.ino` | Launch circularization (graphical: orbit diagram, ATT/IGN/Burn-Dur cluster, ΔV bar) |
| `Screen_LNCH_AscentAP.ino` | Ascent Autopilot touch console (editable params, ARM/DISARM) |
| `Screen_ACFT_AP.ino` | Aircraft Autopilot console — hold modes ATT/AOA/V/S/ALT/GS, ROLL/HDG/NAV, IAS/MACH, LVL, A/P OFF (screen index 14) |
| `Screen_ROVR_AP.ino` | Rover Autopilot console — CRUISE / HDG / TGT / FOLLOW, guard limits, A/P OFF (screen index 15) |
| `Screen_ORBT_AP.ino` | Orbital Autopilot console — NODE / AP / PE / INC burns with plan readout and EXEC, approach-rate hold, auto-warp and auto-stage toggles (screen index 16) |
| `Screen_LNDG_AP.ino` | Landing Autopilot console — DESC / HOVR / BRAKE / ENTRY, ignition-altitude readout, TWR override, attitude reference (screen index 17) |
| `ConsoleShared.ino` | Shared by the five consoles: outbound command queue, numeric keypad modal, grid drawing helpers |
| `Screen_ORB.ino` | Orbit (Apsides default — graphical orbit + inclination diagram) |
| `Screen_OrbAdv.ino` | Orbit Advanced Elements (text-only; second stop on the ORB key's cycle) |
| `Screen_SCFT.ino` | Spacecraft / PFD — full EADI ball (sidebar PFD, screen index 2) |
| `EADIBall.ino` | Shared EADI attitude-ball renderer (used by the SPACECRAFT and AIRCRAFT PFDs) |
| `Screen_MNVR.ino` | Maneuver — alignment reticle + numeric panel |
| `Screen_TGT.ino` | Target / Rendezvous — RPOD scope + numeric panel |
| `Screen_DOCK.ino` | Docking — approach reticle + numeric panel |
| `Screen_LNDG.ino` | Landing dispatcher (selects powered descent / re-entry) |
| `Screen_LNDG_Powered.ino` | Landing powered descent (graphical: tape, X-Pointer, ATT, V.Vrt, ground-track compass) |
| `Screen_LNDG_Reentry.ino` | Landing re-entry (graphical: corridor tape, atmosphere bar, G meter, retro ball, text panel) |
| `Screen_VEH.ino` | Vehicle Info |
| `Screen_ACFT.ino` | Aircraft — full EADI ball |
| `Screen_ROVR.ino` | Rover — compass, FWD/REV drive-state blocks, tilt indicators (screen index 9) |
| `Screen_NAV.ino` | Navigation display — compass rose, ground track, target bearing (screen index 13) |
| `Compass.ino` | Shared rotating compass card renderer (ROVER and NAVIGATION) |
| `TouchEvents.ino` | Touch debounce and sidebar dispatch (mode cycling / screen switch); hands every touch to the input test gesture first |
| `SimpitHandler.ino` | KerbalSimpit message handler and channel registration |
| `I2CSlave.ino` | I2C slave at 0x12/0x13 (`INFO_DISP_UNIT`, set in `KCMk1_InfoDisp.h`) — packet build/fill, command processing, boot handshake |
| `BootScreen.ino` | Randomised KSP-themed boot sequences (B: Mission Log, C: Loading Tips, E: Pre-Flight Checklist) |
| `Demo.ino` | Demo mode — sine-wave `AppState` animation; stands in for the master for the ascent and hold-mode console commands |
| `InputTest.ino` | Input test screen (unit 1): the two-finger gesture tracker, the master's `0xAB` frames, the full-panel overlay (status byte 2 = 18 while open) |

**Tab naming note:** The `AAA_` prefix ensures `AAA_Screens.ino` compiles before all `Screen_*.ino` tabs. The `Screen_LNCH_*.ino` and `Screen_LNDG_*.ino` files are mode-specific sub-files dispatched by `Screen_LNCH.ino` and `Screen_LNDG.ino` respectively. Filename `Screen_SCFT.ino` corresponds to the SPACECRAFT screen (sidebar label PFD, screen index 2).

---

## Boot Sequence

1. Hardware init (display, SD, touch, I2C slave)
2. Boot screen renders (one of three KSP-themed sequences chosen at random; header shows live version string via `snprintf`)
3. Simpit connects (or demo mode initialises)
4. InfoDisp builds a status packet and **asserts pin 0 LOW** (INT)
5. Master reads the 10-byte status packet
6. Master sends a 2-byte command packet with `requestType = 0x2` (PROCEED)
7. InfoDisp receives PROCEED, enters `loop()`

The boot screen sequences are seeded from the ARM cycle counter for genuine boot-to-boot variation. Three themes are available, each drawing from a pool of 15 items: **B** — Jeb's Mission Log, **C** — KSP Loading Screen Tips, **E** — Gene's Pre-Flight Checklist.

---

## Readout label vocabulary

**Style.** Every label follows the KerbalDisplayCommon "Readout label style" rule (its README): grey (`KDC_LABEL_COLOR`), uppercase, no colon, value right-aligned in what the label leaves. Case is layout, not vocabulary, so the names below are unchanged by it; the widths were re-measured in every cell for the caps forms, which are about twelve percent wider than the mixed case they replaced, less the colon.

One quantity, one name. Every readout label on all fourteen screens was collected and
compared; where the same value carried two names, the shorter or less standard one was
renamed. Widths were measured against the real glyph data in each label's actual cell
before any rename was applied — `printValue()` reserves the label's width in the **value**
font and right-aligns the value in what is left, so a longer label eats the value's room.

| Quantity | Canonical | Was, and where |
|---|---|---|
| Throttle | `THRTL` | `THR` on ASCENT AUTOPILOT |
| Inclination | `INC` | `INCL` on ASCENT AUTOPILOT |
| Dynamic pressure | `Q` | `Q` on ASCENT AUTOPILOT |
| Drogue chute | `DROG` | `DROGUE` on PRE-LAUNCH (the RE-ENTRY cell only fits `DROG`) |
| Sideslip | `SLIP` | `SL` on the AIRCRAFT panel row — while the slip **ball** on the same screen said `SLIP` |
| Closure rate | `V.Close` | `V.CLS` on NAVIGATION (now `V.CLOSE`, since that screen's column heads are all-caps — case is layout, a different abbreviation is a second name) |
| Terrain elevation | `ALT.TRN` | `ELEV` on ROVER, one letter from the `ELV` that DOCKING / TARGET / MANEUVER use for an elevation **angle** — a different quantity in different units |
| Throttle (bar) | `THRTL` | `THR` on the SPACECRAFT throttle bar (its vertical label box grew 62 → 88 px to fit five letters) |
| Radar altitude | `ALT.RDR` | `RDR ALT` on LANDING AUTOPILOT |
| Sea-level altitude | `ALT.SL` | `ALT` in the AIRCRAFT AUTOPILOT flight data (the `ALT` mode button keeps its name) |
| Vertical speed | `V.VRT` | `V/S` in the AIRCRAFT and LANDING AUTOPILOT data columns (the `V/S` mode button keeps its name); `V.Vrt` on the ASCENT bar |
| Orbital speed | `V.ORB` | `V.Orb` on the ASCENT bar |
| Surface speed | `V.SRF` | `SPEED` in the ROVER AUTOPILOT data column |
| Stage / total / remaining Δv | `ΔV.STG`, `ΔV.TOT`, `ΔV.REM` | `STG ΔV`, `ΔV TOT`, `ΔV REM` on ORBITAL AUTOPILOT |
| Time to ignition | `T+IGN` | `T-IGN` on ORBITAL AUTOPILOT, which also counted the other way; it now counts down to zero and goes negative once passed, as every other T+ time |
| Burn duration | `BURN DUR` | `BURN` on ORBITAL AUTOPILOT |
| Distance to target | `DIST` | `RANGE` on ORBITAL AUTOPILOT |
| Time to ground | `T+GRND` | `T-IMP` on LANDING AUTOPILOT |
| Elevation / bearing to target | `ELV`, `BRG` | `TGT EL` on AIRCRAFT AUTOPILOT, `TGT BRG` on ROVER AUTOPILOT |
| Electric charge | `EC` | `EC%` on PRE-LAUNCH |
| Angle of attack | `AOA` | `AoA` on the AIRCRAFT arc |
| Battery time to empty | `TTE` | `ENDUR` on ROVER (the Resource Display's term) |
| Chute states | `STOW`, `ARM`, `CUT` | `STOWED`, `ARMED!`, `FIRED!` on PRE-LAUNCH |
| SAS modes | `PRO` `RETR` `NRM` `ANRM` `RAD+` `RAD-` `TGT` `ATGT` `MNVR` | spelled out on the PRE-LAUNCH SAS row; `RETRO` on the LANDING AUTOPILOT ATT REF toggle |
| Vessel situation | `FLIGHT` `SUB-ORBIT` `ORBIT` `ESCAPE` `SPLASH` `DOCK` | `IN FLIGHT`, `SUB-ORBITAL`, `IN ORBIT`, `ESCAPE ORBIT`, `SPLASHED`, `DOCKED` on VEHICLE INFO — now the Annunciator's tile names |

**Apoapsis and periapsis are the one case exception.** They read `Ap` and `Pe` in every
label (`ApA`, `PeA`, `T+Ap`, `T+Pe`, `Ap-Pe`, `ARG.Pe`, `TGT Ap`, the Orbital Autopilot's
`Ap` / `Pe` buttons), matching the graphic markers and the Annunciator's `Pe LOW` /
`Ap LOW`, by the owner's decision (1.16.4).

**One exception, and it is measured rather than careless.** AIRCRAFT keeps `MA` where
ASCENT and RE-ENTRY say `MACH`. Its split cells are 180 px; `MACH` is 101 px at the
value font against a widest reading of 95, which overflows by 26, and dropping a decimal
does not save it. The abbreviation is forced by the cell. It is recorded in the code so it
is not "fixed" later without re-measuring.

Case differences that are purely layout are not renames: NAVIGATION's column heads are
all-caps (`DIST`, `T+INT`) where the same tokens appear as `DIST` and `T+INT` in
label-and-value rows elsewhere.

## Version History

| Version | Notes |
|---|---|
| **1.19.0** | **A proper rover on the ROVER screen.** The compass centre and the PITCH and ROLL boxes showed grey boxes with wheels. They now show an original near-future pressurised rover — white cabin with an orange stripe, wraparound windscreen, roof solar array, comms mast and dish, six wheels on rocker suspension, rear airlock — in matching top, side and rear views. The art is anti-aliased and pre-rendered by `tools/rover_art.py` into `assets/Rover/`: `Top.bmp` (116×164, drawn once with the chrome) and 91 frames per tilt view (`Pm45`..`Pp45`, `Rm45`..`Rp45`, 124×124), so tilting is a single blit of the frame for the whole-degree angle: no erase, no flicker. Each frame fills the box's 125-px picture area and keeps clear of the horizon ticks at ±45°. If a file cannot be drawn (no card, file missing) the screen uses the old vector rover until it is next entered. Copy `Software/Displays/SD_Cards/KCMk1_InfoDisp/` (which includes `Rover/`) to the card root. |
| **1.18.0** | **Input test screen (unit 1); demo follows the master's flag only; backlight dimming.** *Input test screen* (Hardware Inventory §8.11, §11 #14): a hidden full-panel overlay opened and closed by a two-finger diagonal pull down from the top-right corner (both fingers in the 320 × 220 px corner zone, midpoint ≥ 140 px left and down within 1.5 s), any time; status byte 2 reads 18 while open and the master pushes three `0xAB` frames (page 0, the inputs, 40 bytes every 100 ms; page 1, INT lines, display-module values and lifecycles, and page 2, the four 7" displays' status, 24 bytes each every 500 ms), taken in demo too. Button modules light from the state word as sent; STATE shows the reported lifecycle, red on a FAULT; a DISPLAYS section shows the four displays; NO DATA after 1.5 s without page 0. New tab `InputTest.ino`; render scenario `INPUT`. *Demo* (§8.8, §11 #10): the leftover `demoMode = false` on scene changes is removed; Simpit is serviced in demo and `demoLifecycle()` takes only the lifecycle; leaving demo (`leaveDemoMode()`) re-enters the flight scene with the per-vessel reset (`resetForVesselSwitch()`, factored out of the vessel-switch handler) or shows standby. *Backlight* (GitHub #47): the 4-byte BACKLIGHT frame; standby level on the standby splash, clamped to 5 %, ramped over 300 ms (KCM_Display 1.1.0, KCMk1_SystemConfig 1.3.0). Checked on the host by `tools/behaviour_selftest.py`. |
| **1.17.1** | **Names for the master's interlock reasons.** The `KCMk1_Master` autopilots report three new disconnect reasons — 22 A/P INHIB (the A/P INHIB / ARM switch), 23 ENG SAFE (ENGINE SAFE dropped a throttle mode), 24 A/P DISC (the stick's A/P disconnect) — which the consoles showed as a blank note. They now read `A/P INHIB`, `ENG SAFE` and `A/P DISC`. |
| **1.17.0** | **AIRBRK follows the control group.** The indicator read CAG 38 whatever the control group, so in groups 2–6 it showed group 1's air brake while the AIR BRAKE button toggled another group. The master now sends its control group in byte 8 of the summary frame (9 bytes; an 8-byte summary still reads as group 1); the display keeps the last CAGSTATUS and re-reads the indicator when the group changes (`airbrakeCag()`, `refreshCagIndicators()`). |
| **1.16.5** | **One name per quantity across the screens.** The readouts that carried a second name now use the flight screens' one (`ALT.RDR`, `ALT.SL`, `V.VRT`, `V.SRF`, `ΔV.STG`, `ΔV.TOT`, `ΔV.REM`, `T+IGN`, `BURN DUR`, `DIST`, `T+GRND`, `ELV`, `BRG`, `THRTL`, `EC`, `AOA`, `V.ORB`, `TTE`); the PRE-LAUNCH SAS row uses the SAS indicator names and its chute rows the RE-ENTRY states (`DROG`, `STOW`, `ARM`, `CUT`); VEHICLE INFO's STATUS uses the Annunciator's situation tile names; the landing console's ATT REF reads `RETR`. The Orbital Autopilot's T+IGN now counts down to zero and goes negative once passed, as every other T+ time. The SPACECRAFT throttle bar's label box grew to fit `THRTL`. See *Readout label vocabulary*. |
| **1.16.4** | **Apsis labels in mixed case.** Every on-screen abbreviation of apoapsis and periapsis now reads `Ap` / `Pe`, matching the graphic markers and the Annunciator's `Pe LOW` / `Ap LOW` tiles: `ApA` / `PeA` (SPACECRAFT, ORBIT, ORBIT ADVANCED, RE-ENTRY, ASCENT AUTOPILOT), `T+Ap` / `T+Pe` (SPACECRAFT, ASCENT, ORBIT, ORBIT ADVANCED), `Ap-Pe` (CIRCULARIZATION), `ARG.Pe` (ORBIT, ORBIT ADVANCED), `TGT Ap` (ASCENT AUTOPILOT) and the Orbital Autopilot's `Ap` / `Pe` burn buttons. Labels only; no layout or logic change. |
| **1.16.3** | **Autopilot summary on both units** (#83). Controller_Main pushed autopilot status only for the console on screen and only to unit 2, so off that console the mission ladder's rule 0 and the console ring could not see an engaged autopilot, and unit 1 never could. A new 8-byte `0xAA` summary frame (every console's flag byte plus the landing mode and ENTRY) goes to both units every 100 ms; `I2CSlave.ino` keeps it in its own buffer so it never displaces a full frame, and `processSummary()` applies it after any full frame. Demo mode ignores it. |
| **1.16.2** | **Landing Autopilot: VERT replaces RADIAL** (#68). Controller_Main no longer flies the landing on SAS RADIAL OUT, which is vertical only while moving horizontally and lies near the horizon in a vertical descent; near zero speed (and always, with ATT REF on VERT) it holds the nose straight up with its own attitude loop, SAS off. The console's ATT REF toggle reads RETRO / VERT (`ldVert()`, bit 3 still the pilot's choice), and the landing frame's new bit 7, `vertHold`, says the hold is flying: POWERED DESCENT's SAS button then reads `VERT` in green rather than alarming on SAS off. RAD+ on that button is now white on red with the other non-landing modes (it was green while it was the autopilot's reference, #67). The demo reports bit 7 as Controller_Main does. |
| **1.16.1** | **Cleanup sweep.** *DOCKING V.LAT* prints two decimals and is coloured by the value as printed; at one decimal 0.06 m/s read `0.1` in green and 0.10 m/s read `0.1` in yellow (#73). *Autopilot consoles* format whole-number speeds through `conFmtWhole()` with thousands separators (`1,450 m/s`, where they printed `1450 m/s`); the bordered NODE box drops the space before the unit only for a 10,000+ m/s burn, which would otherwise cover the box border (#74). *ROVER* DIST and ALT.TRN print whole metres (`850 m`), not a rounded value through `formatAlt`'s two decimals (`850.00 m`) (#75). *ORBIT* takes radius, atmosphere top and SOI from `currentBody` (the shared `body_params.h`) instead of its own copy, which had drifted for Kerbol; its table is now names only (#76). Cache sentinels written `-1 << 30` (undefined before C++20) on ASCENT and CIRCULARIZATION are named `-(1 << 30)` constants, so the panel builds with no warnings (#78). The unused `CON_LBL` / `CON_EDT` are gone; `panel_lint.py` reports nothing (#79). NAVIGATION's track test takes `fabsf(surfaceVel)` as ROVER does (#81). |
| **1.16.0** | **Stage readouts go neutral on a craft with no propellant** (#72). A re-entry capsule reports 0 stage ΔV and 0 burn time, so every stage readout showed its low-fuel alarm for a vessel with no fuel to be low on. The panel now registers KerbalSimpit's whole-vessel `LF_MESSAGE` and `OX_MESSAGE` (`state.lfAmount` / `oxAmount`, Alternate Resource Panel in KSP1), and while the vessel carries neither (`noPropellant()`, below `PROP_EMPTY_UNITS` of both) the ΔV.STG, STG.BRN, ΔV.TOT and STG ΔV readouts on SPACECRAFT, ASCENT, CIRCULARIZATION, POWERED DESCENT, MANEUVER, VEHICLE INFO, the pre-launch board and the Orbital Autopilot take the neutral dark grey (`propNeutral()`), value kept. LF-only craft (nuclear, jets) are unaffected, and nothing changes until an LF/OX message has arrived for the vessel, so a setup without the mod behaves as before. The node ΔV bars on MANEUVER and CIRCULARIZATION colour by the node, not the stage, and are unchanged. |
| **1.15.3** | **Behaviour review of four screen decisions, and a label bug it found.** *SAS radial modes were named backwards on every screen* (#66): KerbalSimpit's `AutopilotMode` has 5 = radial in and 6 = radial out, and the panel called 5 `RAD+` (pre-launch: `RAD-OUT`); 5 is now `RAD-` / `RAD-IN` and 6 `RAD+` / `RAD-OUT`. *POWERED DESCENT's SAS button* named only STAB and RETR and showed every other mode as a grey, nameless `SAS` — including RAD+, the Landing Autopilot's own vertical reference; it now names every mode, with STAB, RETR and RAD+ green and the rest white on red (#67). *RE-ENTRY holds to the ground* (#69): rule 2 released at Mach 3, so a capsule sat on ORBIT from Mach 3 to 10 km and spent its parachute phase on POWERED DESCENT, whose fuel rows read white on red for a vessel with no engine, while the chute states were on RE-ENTRY. Once chosen it now holds until touchdown, a clear climb (`REENTRY_HOLD_CLIMB_MS`), leaving the atmosphere, or thrust (`REENTRY_HOLD_THROTTLE` with stage burn time), which hands a powered landing to POWERED DESCENT; planes are excluded so a spaceplane reaches NAVIGATION below Mach 3. *V.CLOSE holding-station dead band* (#70): TARGET and DOCKING coloured by the raw sign, so a rate printed as zero flickered green/yellow; anything that prints as zero (`TGT_VCLOSE_HOLD_MS`, `DOCK_VCLOSE_HOLD_MS`) is now green, and TARGET's closure bar uses the same test. ASCENT's Q caution now reads the shared `KCM_HIGH_Q_PA` (still 20 kPa), the Annunciator's new HIGH Q limit (#71). Requires KCMk1_SystemConfig 1.2.0. |
| **1.15.2** | **Bug sweep from the user-manual renders.** Rendering every screen for the manual turned up twelve defects (issues #50–#61) and a set of stale comments (#64). *RE-ENTRY:* the drogue cell's `DROGUE` label lost its last letter under the STOW value and read `DROGUISTOW`; it is now `DROG`, the name the CHUTE DEPLOY tag already used (#50). In thin air both chute safe speeds are past the end of the airspeed scale, and the clamped MAIN and DROG boundary lines and tags were drawn on top of each other at its right end; a boundary is now drawn only when it is on the scale (#51). The RETRO ALIGNMENT ring labels moved to the lower axis, where the bank pointer no longer covers the `40`, and print transparent so they no longer notch the rings (#52). *CIRCULARIZATION:* `ΔV.CIRC` clamped periapsis to the surface before the vis-viva step, so on any real ascent it read a fraction of the burn (74 m/s against a 497 m/s node); it now uses the true ellipse (#53). *ORBIT:* the yellow "dips into the atmosphere" orbit colour never fired below sea level, because it tested the geometry's clamped apsides; it now tests the raw apsides against the orbit-safe altitude (atmosphere top, else highest terrain), so an impact trajectory on an airless body is yellow (#54). *NAVIGATION:* DIST's hundredths froze between whole metres, the same cache-key defect V.CLOSE had in 1.13.0 (#55). *DOCKING:* `tgtDistance` is never cleared, so a target dropped inside 200 m kept the mission ladder (and the TGT key's first press) on DOCKING with NO TARGET SET for the rest of the flight; a target now counts as present while `targetAvailable` is set or a TARGETINFO arrived in the last `TGT_INFO_FRESH_MS` (2 s) (#56). *SPACECRAFT / AIRCRAFT:* the bank pointer turned opposite to the horizon above it; it is now a sky pointer, turning with the horizon as RE-ENTRY's already did (#58). *LAUNCH:* dismissing the pre-launch board with the LNCH key (rather than a tap) set the ASC/CIRC phase override, which survived liftoff, so LAUNCH read MAN and never switched to CIRC at the coast (#59). *ORBITAL AUTOPILOT:* the BURN column hint ran into the column divider (#60). *A/P key:* the first press tested `verticalVel < -LNDG_CTX_VVERT_MS` with a constant that is already negative, so anything below 10 km not climbing faster than 5 m/s got the LANDING console; it is now the mission ladder's own descent test (#61). The Orbital Autopilot's `ACCEL` unit gains its `²` from KerbalDisplayCommon 3.11.1, now required (#57). |
| **1.15.1** | **The autopilot key reads `A/P` at rest.** The sixth key's base caption was `ASC`, the ascent console's own mode caption, so from any other screen the key named one console of five rather than the cluster. It now reads `A/P` until a console is on screen, then that console's caption (ASC / ORAP / LDAP / ACAP / RVAP), the same rule the other multi-mode keys follow. **Demo: A/P OFF disarms the ascent autopilot too.** The demo boots with the ascent autopilot armed and its A/P OFF handler cleared every model but that one, so on the aircraft, rover, orbital and landing consoles A/P OFF left the key green and the ascent phase running; only the ascent console's DISARM turned everything off. Controller_Main's `arbAllOff()` has always disarmed the ascent autopilot on A/P OFF; the demo now does the same. |
| **1.15.0** | **Orbital and Landing Autopilot consoles.** Two more screens on unit 2's sixth key — `ORBITAL AUTOPILOT` (16) and `LANDING AUTOPILOT` (17) — for the mission autopilot on Controller_Main (`Documents/Developer/Mission_Autopilot.md`): node / apoapsis / periapsis / inclination burns with a plan readout and an EXEC button, an approach-rate hold, and DESC / HOVR / BRAKE / ENTRY landing modes with the computed ignition altitude. The aircraft console gains **GS** and **NAV**; the rover console gains **FOLLOW** and a stop distance for TGT. The key is now a five-console ring filtered by vessel type and situation (`apConsoleNext()`), the first press is situation-aware (`apConsoleContextScreen()`), and the mission ladder's rule 0 routes to a console only while that console has a mode engaged (`apConsoleEngaged()`). `I2CSlave.ino` now dispatches every inbound push on its **sync byte** rather than its length: one 64-byte buffer, `processStatusPush()` on the main thread; the aircraft frame grew to 48 bytes and the rover frame to 36, and the new 52-byte orbital (`0xA8`) and 44-byte landing (`0xA9`) frames join them. `AppState` gains the `ob*` / `ld*` echo fields. Demo mode plays Controller_Main for every new opcode. |
| **1.14.0** | **Aircraft and Rover Autopilot consoles.** Two new screens on unit 2's sixth key — `AIRCRAFT AUTOPILOT` (14) and `ROVER AUTOPILOT` (15) — for the hold-mode autopilot that runs on Controller_Main (`Documents/Developer/Hold_Mode_Autopilot.md`). The key becomes a three-mode key: a first press lands on the console for the vessel type (`apConsoleContextScreen()`), a repeat press cycles ASC → ACAP → RVAP, and it is green while *any* autopilot is armed or engaged. Mode buttons are three-state (off / pending / engaged) and, like the ARM button, annunciate only what the master echoes back; a tap shows as a pending outline and times out after 3 s if the master refuses. The ascent console's command queue and keypad moved to `ConsoleShared.ino` so all three consoles use one queue and one modal; the ascent screen's behaviour is unchanged. `I2CSlave.ino` accepts two new inbound pushes (44-byte aircraft, sync `0xA6`; 28-byte rover, sync `0xA7`), dispatched by length as the 40-byte ascent push is, and snapshots them under `noInterrupts()` the same way. `AppState` gains the `hp*` / `rv*` echo fields. Demo mode plays Controller_Main for the new opcodes so both consoles can be laid out and exercised with no master attached. |
| **1.13.1** | **Approach-only VSI tiers, aliased G bands, heap-free row values.** AIRCRAFT coloured vertical speed on POWERED DESCENT's landing tiers at all times, so a normal cruise descent painted the VSI bar and the V.VRT row red; the tiers now apply only with the gear down or below the radar-altimeter handover height (`ACFT_ALT_RDR_ON_M`), and a cruise descent is reported in green. The ASCENT G readout's bands (`LNCH_G_WARN` / `LNCH_G_ALARM`) alias the panel-wide `G_WARN_POS` / `G_ALARM_POS`, the Annunciator's crew limits, in place of their own 3 / 5 g. KerbalDisplayCommon 3.11.0 adds buffer forms of `formatAlt`, `formatTimeCompact`, `formatTime` and `formatSep`; with them ORBIT, ORBIT ADVANCED, the ASCENT AUTOPILOT console and the pre-launch board format every row into a stack buffer and compare against the row cache before a `String` is built, so a frame in which nothing changed allocates nothing (ORBIT ADVANCED alone was fourteen heap allocations a frame). `drawValue` / `drawPanelValue` gained C-string overloads so any screen can do the same. |
| **1.13.0** | **Bug sweep, optimisation and cleanup pass.** *Fixed:* both inbound I2C buffers (the 2-byte command and the 40-byte Ascent-AP status push) were read on the main thread straight from the buffers the Wire interrupt writes, so a push landing mid-read could tear its floats; they are snapshotted under `noInterrupts()` first, and every path that raises INT now goes through one guarded publish. SPACECRAFT's row 4 could never show `T+PE`: the label is chrome and printValue never repaints it, so it kept `T+AP` while showing time to periapsis; the row now repaints its chrome on a swap, as row 5 already did. SPACECRAFT and RE-ENTRY painted one frame of labels over empty rows on entry whenever their mode flags were stale (a vessel switch resets them; EVA can begin on another screen), because the first draw pass found the mismatch and re-entered the screen before writing a value; the chrome now sets the flags to what it paints. TARGET's split-row dividers were drawn for the old seven-row layout and put a line through the `T+INT` row. NAVIGATION's `V.CLOSE` was cached on whole metres while printing tenths, so the decimal froze. The TARGET closure bar and MANEUVER ΔV bar coloured on two inputs but repainted on one, so a range crossing or a staging event left the bar disagreeing with its row. The circularisation tape's static wipe and a bottom-clamped periapsis strip both erased the divider above the three burn rows and nothing redrew it. ROVER's endurance window restarted on every screen entry (so `ENDUR` read `---` for the first seconds of each visit) and survived a vessel switch (so the step in charge became a spurious rate for 48 s); it is now sampled from `loop()` on every screen and reset only on a vessel switch. A LAUNCH sidebar press set a phase override that nothing but leaving the pad ever cleared, so one press killed ASC/CIRC auto-switching for the session; it is cleared with the other latches at vessel change and scene entry. The Ascent Autopilot's pending cues are raised only for a command that was actually queued, as the ARM path already did. The circularisation `T+IGN` cache rounded where the text truncated, so the display lagged the value by up to half a second. The demo never drove the wheel throttle, so ROVER's FWD / REV blocks sat on NEUTRAL. *Label rule:* ROVER, ORBIT, ORBIT ADVANCED and NAVIGATION still drew their readout captions white; all take `KDC_LABEL_COLOR` now, so the 1.12.0 claim holds. *Optimised:* `drawValue` / `drawPanelValue` took their value `String` by copy on every row every frame; the `TRIM` flag on both PFDs was re-rasterised every frame while set; POWERED DESCENT computed the drift vector twice a frame. *Cleaned:* the write-only `_orbAdvancedMode`, the unused `compassUpdateMarker()`, `histGameAgo`-style dead state on SPACECRAFT and ASCENT, ORBIT's leftover minimum-interval gate state, the unused roll arguments to the EADI chevrons, the no-op `clearTouchISR()` calls, redundant row-cache invalidations in five chromes (drawStaticScreen does it), literal screen indices on VEHICLE, DOCKING and POWERED DESCENT, the AIRCRAFT AoA tables sized by a literal, hand-rolled heading wraps where `eadiHdgDelta` exists, and new named constants for the transonic band and the `T+DOCK` tiers. The `intercept*` stubs left AppState. The KerbalDisplayCommon requirement is 3.10.0. *Comments and README:* the title-tap and altitude-switch narratives that survived the sidebar and coast-latch reworks, the "Phase 2 implementation notes" block, the screen summaries for ORBIT, TARGET, POWERED DESCENT, RE-ENTRY, AIRCRAFT and ROVER, the ladder rule numbers in the Context Switching section, the tab table (NAV and Compass were missing), and the pre-launch board's "bypassed for planes and rovers". |
| **1.12.0** | **Readout labels: grey, uppercase, no colon.** All 83 labels now follow the KerbalDisplayCommon 3.10.0 "Readout label style" rule shared by the three panels: `ALT.SL`, `V.ORB`, `ΔV.STG`, `T+IGN`, `THRTL`, in `KDC_LABEL_COLOR` grey with the value carrying the white or state colour, as on the Shuttle's DPS pages and on EICAS/ECAM, where colour and alignment tell a caption from its value rather than punctuation. The abbreviation vocabulary is unchanged; case is layout. Every caps form was measured against the mixed-case one it replaced in the label fonts (24 to 48 px): the growth is 2 to 24 px per label, and the tight cells on record (the AIRCRAFT 180 px halves, the DOCKING halves, the Ascent Autopilot's 122 px label column) all still clear. `MA` stays on AIRCRAFT for the reason `Ma` did. |
| **1.11.5** | **A sidebar press was undoing itself, and it needed no telemetry to move.** Five mission rules widen their threshold once their screen has been chosen, so the panel does not oscillate on a boundary — DOCKING enters at 200 m and leaves at 250, MANEUVER at 600 s and leaves at 700, POWERED DESCENT at 10 km and 12, TARGET at 200/2000 m and 150/2400, LAUNCH at V.Vrt ≥ 0 and releases at −20. Those bands were keyed on `activeScreen`, which `switchToScreen()` sets — so pressing away from an auto-chosen screen collapsed its own band in the same frame. Parked at 220 m the panel shows DOCKING (inside the 250 m release limit); press PFD; `activeScreen` is no longer `screen_DOCK`; the limit snaps back to 200; 220 no longer qualifies; the ladder's answer changes to ORBIT — which releases the manual latch that the same press had just set *against* DOCKING, and the router switches you to ORBIT on that very pass. Deterministic, reproducible with the telemetry frozen, and every band had such a trap; the widest is LAUNCH's, where anything coasting near apoapsis sits. The bands are now keyed on `_lastContextWant`, the ladder's own previous answer, which makes `contextScreen()` a function of telemetry and its own history and nothing else — where the pilot has navigated cannot perturb it. That also fixes the quieter half of the same bug: under the old test the hysteresis did nothing at all while the pilot was parked on a manually chosen screen, so the ladder's answer could oscillate across a threshold unaided and release latches with no press involved. **Second, a press now carries its own dwell.** The gap was recorded only when the *router* switched, so a manual selection had no floor under it: the instant the latch released for any reason, the time since the last automatic switch was usually already spent and the router fired on the same frame — measured at 100 ms after a press. `MANUAL_DWELL_MS` (10 s) against `CONTEXT_DWELL_MS` (4 s), because a deliberate press outranks an automatic one. The latch still carries the meaning; this is only the floor beneath it. Both pieces of routing state are dropped on a vessel or scene change, alongside the latch they already released. |
| **1.11.4** | **The PFD geometry stopped being written out three times.** SPACECRAFT, AIRCRAFT and the shared `EADIBall` renderer draw one instrument, so they have to agree pixel for pixel about where the disc, the tapes and the value boxes are — and they used to say so three times over, each re-deriving the whole layout from its own copy of `CX`/`CY`/`R`. Comparing every `EADI_*` constant against its `ACFT_*` and `SCFT_*` counterpart: **84 pairs, 84 identical, zero differing** — equal only because nobody had yet edited one of the three. Forty of them were entirely **dead**: declared, never read, and reading like live geometry, so editing `SCFT_PTAPE_MRK_HW` moved nothing. `EADIBall.ino` is now the single definition and the screens alias it. **Sixty-four dead constants removed** in total, among them a `LNCH_AS_*PANEL_*` block still describing the rev-1 720×480 screen, and a second copy of the ASCENT readout column under a different name in the same file. **Twenty-one stale value-assertion comments fixed**: when the disc was enlarged, fourteen derived comments across ACFT/SCFT kept quoting the pre-enlargement numbers (`// 133` on a constant that evaluates to 76, `// 406` on one that is 514), and two layout decisions in the 1.11 series were made by reading those comments instead of the arithmetic and came out wrong. **`TGT_VCLOSURE_WARN_MS` removed** — documented in three places as a yellow "fast approach" band, read by no code, and the row's yellow already means the opposite thing (closure *negative*, i.e. opening). That is 1.11.1's `STALL_SPEED_MS` defect again, which is why `tools/panel_lint.py` now exists to fail a build on either. **Version discipline**: this pass also found that the closure-sign fix shipped inside 1.10.19 and the DTCM fix inside 1.11.2, neither with a bump — on a panel where three boards are flashed separately, a version string that does not move is a version string that lies. No behaviour change here: every retained geometry value is provably identical and the formatter's output is byte-identical over 40,269 differential test values. |
| **1.11.3** | **Three readout collisions found on the bench, all invisible to the host harnesses** — which verify what a function draws, never what its neighbours paint over it afterwards. The **SPACECRAFT rate cluster** started at y=96, but the roll readout is right-justified into x 497..583 and paints its value row at y 97..130 — squarely on the "P" label and the top of the pitch bar, so every change in the roll digits erased them. Moved to y=136, bars shortened 100 → 92 so the yaw bar still ends above `TRIM`'s erase rect; both bounds are now measured from real glyph metrics and written into the source. The **IAS trend chevrons** are thicker (3-scanline stroke, height 7, pitch 10) and **magenta** rather than dark green: they are a six-second *prediction*, and magenta is what a glass cockpit reserves for computed guidance as against green for live state. The **ROVER target strip** overlapped its own label at any two-digit minute count — the cells were budgeted for `"59m 30s"` (142 px), but `formatTimeCompact` below one hour is identical to `formatTime`, which emits `"59 m: 30 s"` at 171 px in a 155 px cell, and `textRight` does not clip, it starts further left, so the value walked back over the label. Distance had the same defect and worse, since `formatSep` emits two decimals below 1000. Strip dropped to Roboto_Black_28 and all four cells re-cut so a string *filling* its cell still cannot reach past that cell's left edge. |
| **1.11.2** | **ROVER trades charge level for endurance and gains a time to target — and the build stopped fitting in RAM.** `EC%` was already on the Resource panel and answers the wrong question anyway: a percentage does not tell a driver whether they can get somewhere. `Endur:` is a 32-sample ring at 1.5 s (~48 s window) differentiating the charge, showing `CHG` on a net gain and `---` below the floor, red under 10 minutes and yellow under an hour. `T+Tgt` joins the target strip, computed from `state.tgtVelocity` — which `SimpitHandler` resolves onto the line of sight, so it accounts for a rover's heading rarely pointing at the target — and coloured by **reachability** rather than by the ETA itself: green below 0.8 × endurance, yellow to 1.0×, white-on-red beyond, because arriving at zero charge is not arriving. One-way only; it says nothing about getting home. **Shipped in the same version, without its own bump**, the DTCM fix: the build began failing with `Error while determining sketch size: exit status 0xffffffff`, which is not a compile error — on Teensy 4 the ITCM/DTCM split of the 512 KB FlexRAM is computed *after* linking, so the linker succeeds and `teensy_size` fails with no diagnostic. Cause was ~189 KB of glyph data in `.data`, i.e. DTCM, because a plain `const` array on this part goes there rather than to flash. Fixed in KerbalDisplayCommon 3.7.1; RAM1 went from a 15,840-byte deficit to 144,928 bytes free. **Every panel needs its build cache cleared**, or a stale object links the old DTCM-resident fonts straight back in. Nothing in the host harnesses could have caught this: they compile for x86 against a fake framebuffer and say nothing about ARM section placement. |
| **1.11.1** | **Extreme-attitude chevrons, an IAS trend, and a stall warning that never existed.** Red chevrons at ±30° pitch on the shared ladder (hysteresis 32/28), drawn from inside `eadiDrawLadder` so they inherit its dirty-scanline erase. A **1–3 chevron IAS trend** on a six-second prediction, the standard Garmin cue. And the removal of a branch on `STALL_SPEED_MS`, which was `0.0f` in `AAA_Config.ino` — so the threshold arm had never once executed, the row was permanently dark green, and the code implied a feature the panel did not have. KSP and Simpit give no V-speeds at any price, so the banded version is unavailable; AoA is available, is already computed, and is the physically correct stall predictor regardless of speed, so the AoA arc and row are the single stall channel. Do not re-add a speed threshold without a real per-airframe stall speed to put in it. |
| **1.11.0** | **The pilot can choose the reference frame, and AIRCRAFT gets a radar altimeter.** A `SRF`/`ORB` chip mirrors `TRIM` at the heading tape's left edge and annunciates the velocity reference for the prograde marker, both tapes and row 1; one tap pins the other reference, or drops back to automatic if that is what automatic already wants. It deliberately does *not* cover altitude — SRF and ORB differ by a rotation about the body's spin axis, and altitude is radial and unchanged by that rotation, so `Alt.SL` is the same number in both frames and there is no such thing as an orbital altitude. AIRCRAFT row 0 switches `Alt.SL`/`Alt.Rdr` on the same mechanism with 750/850 m hysteresis, formatted to 0.1 m under 10 m and 1 m under 100 m, because the last hundred metres is where a radar altimeter is actually read. Generalised into `ModeOverride` + `modeResolve`/`modeToggle`/`modeClearOverride` in the sketch header — a struct passed by reference to a hoisted prototype has to live in the header, since the Arduino builder hoists prototypes but not types. |
| **1.10.21** | **PFD row 5 counts a noded burn down.** The row was always `V.Vrt`, which on a spacecraft above the atmosphere is a number nothing is flown to. It is now three-state — `V.Vrt` when vertical speed means something, `T+Ign` when a node is pending, and `dV.Rem` once the burn is lit — so the row carries whichever of the three the current phase actually turns on. `dV.Rem` comes from the maneuver message's `deltaVNextManeuver`, which KSP decrements as the burn proceeds, so it counts down to zero the way a real burn is flown. |
| **1.10.20** | **The SPACECRAFT ball gets rate pointers.** The one conspicuous thing both real attitude balls carry that this one did not: the Shuttle ADI has three rate pointers and the Apollo FDAI the same three needles, because a spacecraft is flown on rates — an RCS pulse is judged by the rate it produces, not by where the ball settles ten seconds later. Three stacked vertical bars right of the disc, ±10°/s full scale, all reading the same way (up is positive: roll right, nose up, nose right). The placement is not the Shuttle's, and the numbers say why rather than the eye: the throttle scale runs to x≈54, the pitch tape occupies 75..112, the bezel is 137..553, the bank labels reach x=556 and the panel divider is at 578 — three usable columns of 18, 23 and 20 px, and nothing horizontal wider than 23 px anywhere on the screen. Consistency between the three beat matching a layout that does not fit. Rates come from `kcmRateUpdate` (KerbalDisplayCommon 3.7.0), which differentiates the *rotation* rather than the Euler angles so it stays conditioned at the ±90° pitch a launch sits in. |
| **1.10.19** | **The spacecraft PFD gets vertical speed — in the regime where it means something.** The panel had no `V.Vrt` at all. The fix is not to add one: in a circular orbit vertical speed is flatly **zero**, and in an eccentric one it peaks at hundreds of m/s (451 m/s in a 100×500 km Kerbin orbit, 1,156 on a Mun transfer) but goes to zero **exactly at the apsides** — so in orbit it is a worse-resolution restatement of where you are between them, which `T+Ap`/`T+Pe` already answers better. It is the number being flown only near a body. **Real spacecraft agree, and treat altitude rate as phase-specific rather than permanent.** The Shuttle's MEDS PFD carries a vertical-speed tape only in its entry configuration — on orbit (MM 105–303) it shows the ADI ball alone — and its dedicated AVVI has a radar portion live only in MM305. Apollo gave the **LM** a dedicated ALT/ALT RATE tapemeter because the LM lands; the **CM** had none and read altitude rate from the DSKY on demand (V06 N62). Orion puts altitude rate on its **entry** format. So PFD row 5 is now regime-switched on `_scftOrbMode()` — the mission-mode switch the screen already runs for row 1 — showing **`T+Ign` above** the switch altitude (36 km climbing / 33 km descending on Kerbin, scaled by body radius) and **`V.Vrt` below**. Each row shows the useful half: above, a node countdown, and the PFD is the *only* place one appears outside MANEUVER's ten-minute window, so it must not simply be dropped; below, descent rate. The existing `orbMode != _scftPrevOrbMode` handler already forces a full chrome repaint, so the label follows. `V.Vrt` is **reported, not alarmed** — reusing POWERED DESCENT's landing thresholds (alarm −8 m/s) would paint the row red for the whole of a normal descent, the always-on alarm that teaches a pilot to ignore colour; that screen owns the alarm and has the radar altitude to justify it, and the Shuttle's AVVI is likewise an unalarmed tape. |
| **1.10.19a** | **Target closure had never been signed, so three time-to-arrival readouts had never worked.** Shipped inside 1.10.19 without its own bump — recorded separately here because it is a behaviour change and the version string did not say so. `AppState` documented `tgtVelocity` as "negative = closing", but Simpit's `TargetInfo.cs` sets `velocity = ship_tgtVelocity.magnitude` and never returns a negative. So `T+INT`, `T+Int` and `T+Dock` were gated on a condition that could not be true and showed `---` forever, and two `V.Close` rows could never go green. Fixed at ingestion in both InfoDisp and Annunciator by resolving the velocity onto the line of sight (`-|v| · cos θ` between the velocity and bearing unit vectors), so the sign now means what every consumer already assumed it meant. It survived two content reviews because `Demo.ino` writes `state.tgtVelocity` directly with a signed sine and bypasses ingestion entirely — the demo showed the feature working. |
| **1.10.18** | **The missing glyph got added instead of worked around.** 1.10.17 spelled VEHICLE's status separator as `-` because `0xB7` was not in `Roboto_Black_48`. It was not in *any* Roboto Black size: the family's second index range ended at 181 and `0xB7` is 183. `KerbalDisplayCommon 3.6.0` adds it to all ten sizes via `fonts_ili/add_middot.py`, which builds the dot from each size's **own period ink** centred on that size's cap band rather than drawing one by hand, and asserts all 149 pre-existing glyphs decode identically before and after. The status row now reads `SPLASHED · RECOVERABLE`. Worth knowing generally: a glyph outside a font's index range **measures zero and draws nothing** — both `getFontStringWidth()` and `kcmDrawString()` skip it — so a missing character is a silent gap, never an error, and is only ever caught by measuring. |
| **1.10.17** | **VEHICLE's status row stopped throwing away the situation.** `RECOVERABLE` *replaced* the situation rather than qualifying it, and it discarded the more informative half exactly where it mattered: KSP reports a vessel on the pad as recoverable — the same quirk `vehicleContextScreen()` already has to shield against — so the row read `RECOVERABLE` instead of `PRE-LAUNCH`. Splashed lost to it too, and being in the water is worth knowing before pressing recover. It now reads `SPLASHED - RECOVERABLE`, still sky blue when recoverable. There was never a reason to choose: the value cell is 749 px against a worst case of 689. Spelled out rather than marked with a middle dot, because **0xB7 is not in `Roboto_Black_48`** — a missing glyph measures zero and draws nothing, so the row would have silently read `LANDED  RECOVERABLE` with an unexplained gap. **Nothing was added to the screen.** Its eight rows are the only ones on the mission panel with no duplication against their Info 1 partner at all, and every plausible addition already lives on another panel of the controller: the **SOI body** and **core temperature** are on the Annunciator, and **electric charge** has a whole panel of its own in the Resource Display. That check — against all four panels rather than the two Info Displays — is one the duplication review had not previously made. |
| **1.10.16** | **One name per quantity, across all fourteen screens.** Every readout label was collected and compared; seven quantities carried two names and are now canonical — `Thrtl:` (was `Thr:` on the autopilot), `Inc:` (was `Incl:`), `Q:` (was `q:`), `Drogue:` (was `Drog:` on RE-ENTRY), `Slip:` (the AIRCRAFT panel row said `Sl:` while the slip **ball** on the same screen said `Slip:`), `V.CLOSE` on NAVIGATION (was `V.CLS`), and `Alt.Trn:` on ROVER (was `Elev:`, one letter from the `Elv:` that three other screens use for an elevation *angle* — a different quantity in different units). Each rename was **measured in its actual cell first**, against the real glyph data: `printValue()` reserves the label's width in the value font and right-aligns the value in what is left, so a longer label eats the value's room. That check blocked one of them — AIRCRAFT keeps `Ma:` because its 180 px split cell cannot hold `Mach:` (101 px label + 95 px widest value), and dropping a decimal does not save it. The exception is now written into the code so it is not "fixed" later without re-measuring. The full table is under **Readout label vocabulary** above. |
| **1.10.15** | **TARGET drops `Alt.SL` and `V.Orb`, and the five rows that are left grow from 76 px to 106.** Both were duplicated on this screen's partner — TARGET is reached from three of the mission ladder's rules and SPACECRAFT is the vehicle panel in all three — and, unlike `Dist` and `V.Close`, neither related to anything on the scope. That distinction is the whole test: **the scope is purely angular**, plotting the bearing and elevation of the target and of the relative velocity vector, so range and closure are the two numbers it *cannot* show, which is exactly what earns them their rows. Altitude above sea level and orbital speed are not about the target at all. Nothing replaces them — the closest-approach fields in `AppState` are KSP2-only stubs and there is no relative inclination or phase angle in the telemetry — so the height goes to legibility, the same trade ASCENT made when it went from eight rows to seven. |
| **1.10.14** | **POWERED DESCENT trades a row that carried no information for one that decides the landing.** `V.Srf` was not merely duplicated on SPACECRAFT — it was **derivable from three numbers on its own screen**: the panel shows `V.Vrt`, and `Fwd`/`Lat` are the components of the horizontal speed, which is itself √(V.Srf²−V.Vrt²). A reader with the other three already had it. In its place, **`Stg.Brn`** — seconds of thrust left — which has no picture on either panel and is the number a powered descent actually turns on, using the same field, label and thresholds ASCENT and CIRCULARISATION already use, so a burn-time warning means the same thing going up and coming down. |
| **1.10.13** | **ORBIT's readout strip gains the two numbers its own diagram cannot show.** The PLAN side carried three rows against the INCL side's four, and the free slot at y=448 plus `Alt.SL` make two. `Alt.SL` goes because it was duplicated on this screen's partner — ORBIT is the mission panel's resting state, so that partner is SPACECRAFT in every phase it appears in — and because it annotated nothing: `PeA` and `ApA` are duplicated there too and stay regardless, since they are the magenta and blue **labels for the apsis markers**, drawn in the markers' own colours, and an orbit diagram with unnamed apsides is worse than a repeated number. `Alt.SL`'s white label named the green vessel dot only by inference. In their place, **SMA** and **Ecc**, promoted from ORBIT ADVANCED with the same labels, the same formats and the same order — they are the PLAN diagram's own two parameters, since it draws `a_px = MAX_R` *always* (so the picture is normalised and deliberately cannot show orbit size) and `b_px = MAX_R·√(1−e²)`. SMA restores the dimension the normalisation throws away; Ecc names the one it draws. Making room exposed a bound that had gone stale: **`PLAN_Y1` was 478 because the strip used to start at 485**, and the scene repaint `fillRect`s down to it — so the new top row's label, which is chrome drawn once, was wiped on every scene change. It is now 441, level with `INCL_Y1`, which is the same relationship it always encoded (marker labels clamp to `PLAN_Y1−6` and reach `PLAN_Y1+4`). The harness checks the label's **height**, not just its presence: the old bound left 3 rows of 33, which a "did anything paint?" test accepts. And a latent bug the build warnings surfaced: `_orbVesselPxPlan()` returns false on four paths and leaves `vx`/`vy` **unwritten** on every one, while the caller compared them regardless. Besides being undefined, it decided whether a dot that had just passed behind the body got erased — if the indeterminate values landed within `VESSEL_PX_THRESH` of the cached position, the stale dot stayed on the orbit until something else moved. Visibility is now its own trigger. |
| **1.10.12** | **The track arrow's head kept coming off its body.** Not cosmetic — the two were being drawn at *different angles*. `compassUpdateMarkerPair()` redraws **both** markers whenever **either** has changed, re-syncing both caches to the live bearing, so the ground-track triangle followed sub-threshold bearing changes every time the *target* marker moved. The stalk, testing its own movement threshold against the live bearing, did not follow — so the head walked up to a degree away from the body, which at r=123 is two pixels of lateral offset. The stalk now takes its angle from **the marker's own cache** and tests exact equality rather than a threshold, so the two cannot disagree by construction. A second, smaller cause: a marker's erase box is padded 3 px past its triangle and reaches r≈120, one pixel into the stalk's top, so `compassUpdateMarkerPair()` now **returns whether it redrew** and the stalk is redrawn with it. The regression counts connected blobs across the whole arrow, stem through head: it reports **2 blobs with the old code and 1 with the fix**. The **stem is thicker** (5 px) and is now a **filled quad instead of a bundle of parallel lines**. Offsetting several Bresenham lines by a rounded perpendicular gives uneven spacing on a diagonal — at 22° the offsets land on (1,0) and (2,1) — so the stem was stippled along both edges. Two triangles give clean edges at any bearing and make the width a single float. |
| **1.10.11** | **A ground-track line, and why the card gets no range rings.** The obvious use of the compass interior is a range ring and a plotted target, and the measurements argue against it. The free band is r=78 — the aeroplane's furthest painted pixel, a wingtip — to r=123 where the bearing markers start: **45 px of radius**, and it cannot be widened, because the rose's label boxes are 33 px tall centred on r=176 so their inner corners reach r≈150, which is exactly why the markers top out at 143. Auto-ranging defeats itself in that space (keeping the target at 40–100% of the ring means the blip barely moves and the scale label just restates DIST to a decade), and a fixed three-decade log scale would put the decade rings 11 px apart around a bright white aeroplane. What the band does carry well is a **track line**: a stalk from the aeroplane out to the ground-track marker, so **DRIFT** — the one value on this screen that appears nowhere else on either panel, and the only one that had no picture — becomes a visible wedge between the nose at 12 o'clock and the track. Its inner end is found by **sampling the own-ship bitmap along the stalk's own bearing** rather than using a fixed radius: r=78 is the wingtip maximum, but at 22° the silhouette ends at r≈33, so a fixed start left a 53 px gap and the stalk read as a detached dash. Sampling also guarantees the stalk never overlaps the aeroplane at any bearing, which is what lets its erase be a plain black repaint with nothing underneath to repair. Only the ground track gets a stalk: two radial lines from a common centre are collinear whenever their bearings match, so erasing one would erase the other exactly where they overlap — the same collision the two markers had — and a bearing pointer conventionally carries no tail. |
| **1.10.10** | **Four NAVIGATION cells were blank on entry instead of showing `---`.** The bench saw it on DRIFT. The cause is general: every value cell is change-detected against a cached previous value, and DRIFT's cache reset to `-9999` — the *same* sentinel the cell uses for "no ground track". Entering the screen with nothing to show therefore compared equal to the reset value and the cell was never drawn at all, staying black rather than dashed. V.CLS had the identical collision on `-9999`, and DIST and T+INT on `-1`; only BRG escaped, by accident, because its reset and its no-value marker happened to differ. One reset sentinel that no cell can produce (`INT16_MIN` / `INT32_MIN`) ends the class, and DIST's parallel `_navPrevDistAvail` flag goes with it — availability was already encoded in the value. A regression enters the screen with no target and no ground track and requires every one of the seven cells to have painted; with the old sentinels restored it reports four failures, which is how the other three were found. Also: the **TRK and BRG column headings are white** like every other heading on the panel. Tinting them to their marker's colour duplicated the job the corner legend already does. |
| **1.10.9** | **Bench pass on the NAVIGATION card.** The own-ship symbol is **25% larger** (138×152), which the card has room for — its furthest painted pixel is a wingtip at r=78 against the bearing markers' annulus at r=123, and the harness now checks that from the painted pixels rather than the bounding box, since the box's corners are empty and the wingtips are what actually reach. A **stub rectangle poked out behind the tail**: the outline ran the fuselage straight back at full half-width to y=1.0, past the tailplane, instead of tapering to a tail cone. Fixed in `tools/nav_ship_bitmap.py`, which is the point of holding the artwork as geometry — it is a two-point edit to the outline and a regenerate, not pixel surgery. The **marker legend moves to the bottom-left corner** at Black_16 instead of sitting under the left column at Black_24: it is read once and then never again, so it belongs where the eye goes last rather than in line with the readouts. The corner is free — at y=536 the ring's left edge is x=313 and the legend ends at x=151. |
| **1.10.8** | **The compass markers were erasing each other, and the card gets an aeroplane.** Two bugs behind one bench report of green and violet trails. First, the screen cleared each marker cache's `prevAvail` whenever the card rotated, on the premise that the tick and label redraw wiped the marker band — it does not (ticks live at r=199–219 and label boxes at ~164–188, markers at 123–143), so clearing it suppressed the only erase those markers had. Second, and why the green marker eventually vanished outright rather than smearing: the two markers **share one annulus**, so the moving target-bearing marker's erase box sweeps over the stationary ground-track marker and nothing puts it back. New shared primitive `compassUpdateMarkerPair()` applies the discipline the ascent ladder's markers already use — when either has changed, erase both and draw both; a proximity test asking whether they are close enough to interfere is the version that leaves half a marker on screen. A host regression sweeps the heading a full turn and counts connected blobs of each marker colour in the annulus: one each, or it fails. **Own-ship symbol** at the card centre. It is a **1-bit bitmap**, generated by `tools/nav_ship_bitmap.py` from a single normalised outline that is mirrored, supersampled 8× and thresholded — two hand-drawn attempts out of `fillTriangle` primitives came out as arrowheads, because a swept wing is a long thin quadrilateral and neither a rounded nose nor a clean swept leading edge survives at this size. The artwork is edited as geometry and regenerated rather than nudged pixel by pixel. Also from the bench: the heading readout is **dark green**, the house colour for a nominal value and what ASCENT's heading box already uses — white was the odd one out; **BRG** joins the left column so the violet marker has a number the way the green one has TRK; and a two-row **legend** draws each marker's own triangle beside its name. The harness now dumps the content area as an image, which is how the arrowhead was caught — and with it a bug in the harness's own `fillTriangle`, which filled between only the first two edge crossings it recorded and rendered a thin swept wing as a solid wedge. |
| **1.10.7** | **NAVIGATION's bottom strip is gone and the compass card has the height.** The strip carried `V.Srf` and `Alt.Rdr`, and NAV's routing rule is the same condition Info 1 uses to put AIRCRAFT up — so its partner is *always* AIRCRAFT, which shows both numbers at the same size, in 13 phases of 13. A duplicated strip was shrinking the one instrument this screen exists to be. Searching `AppState` for a replacement found none: there is no lat/long in the telemetry (and this screen takes no new Simpit channels), Mach and G are on AIRCRAFT too, and temperatures and EC are not navigation — everything NAV can add beyond its partner is target-dependent, and that is already the right column's job. So the space goes to the card: **r 200 → 224, cy 344 → 370**, chosen from the budget rather than by eye — the heading box hangs off the nose base, which scales with the radius, so `cy - noseRBase - 6 - 52` lands the box at y=67 (5 px under the title rule) and `cy + r` lands the ring at y=594 (5 px above the edge), with the ring spanning x 246–694 and clearing both 190 px side columns by 56. Sizing it by eye is how an earlier attempt put the box four pixels *into* the rule, so the harness now asserts all four constraints, plus that ticks stay inside the ring and labels inside the ticks, plus that **all ten radii are ROVER's scaled by 1.12 to within half a pixel** — the instrument-family claim checked rather than stated. ROVER's own card cannot grow: its strip carries target distance, which is not duplicated anywhere. |
| **1.10.6** | **NAVIGATION's target group is completed with `T+INT`.** DIST and V.CLS were already in the right column and neither answers "how long" — on an approach that is the number being flown to, and it is nowhere on this screen's partner, which is always AIRCRAFT. It is range over closure rate, dashed unless actually closing, in a third block under the other two. It reuses TARGET's **label as well as its formula**: that screen calls the same computation `T+Int`, and one quantity with two names across screens is the thing the label audit exists to prevent. Column widths were measured against the real Black_36 glyph data first — the worst case in a 190 px block is `"999,999 m"` at 176 px, so DIST, V.CLS and T+INT all fit with room. A host harness now compiles `Compass.ino` and `Screen_NAV.ino` together in Arduino's file order on the virtual framebuffer and checks that all three blocks paint, stay inside the column, and clear both the compass ring and the bottom strip. |
| **1.10.5** | **Three bench defects, two of them older than the ascent rework.** The **atmosphere column loses its value window**: the percentage restated the triangle, and the `T+Vac` that briefly replaced it was a different quantity from the one the bar plots, which forced the column name to label the number instead of the gauge. It is a name and a bar now — Q, in the right column, is the atmospheric number worth digits. The ladder's vessel marker is labelled **`ALT`** (it had been `V`, which read as a velocity, then nothing at all) and the apoapsis marker `Ap`. **Chrome the marker erase destroyed was never put back.** The reference-line labels (`GND` / `ATM` / `TGT`+`ORB`) start at x=118 and the marker erase box reaches x=132, so a marker passing a reference line bit a piece out of its label — and `_lnchAsRepairRefLines()` repaired the *lines* only. The label bite stayed until the next ladder scale change. Chrome and repair now draw those labels through one pair of helpers, so they cannot drift apart. **One marker's erase clipped the other.** The redraw guard was `abs(other - this) <= 6`, but the erase box and a marker's own drawn extent are both 19 rows, so they interfere up to 18 px apart: a near miss left a half-erased marker on the ladder indefinitely. The proximity arithmetic is gone — when either marker moves, both are erased, the chrome under both is repaired, and both are redrawn. Two triangles and two short labels cost nothing; getting the guard wrong cost correctness. A regression test diffs the ladder after a 280-frame two-marker sweep against the same chrome drawn once into a clean buffer; it reported 250 differing pixels before these fixes and reports 0 now. And **switching screens flashed a frame that was half of each screen**: `loop()` computed `screenChanged` from `prevScreen` and *then* ran `updateContextScreen()` — the mission and vehicle ladders, the last thing in a frame that can change `activeScreen`. A switch the ladder made on that pass was invisible to the test just above it, so the frame took the incremental branch and drew the **new** screen's change-detected values onto a BTE copy of the **old** screen's chrome: one frame of two screens superimposed, then a proper full paint on the next pass. Touch and Simpit switches never hit it because both run above that point, which is why it showed up only when a panel followed the mission on its own. Transition detection now runs after context routing. |
| **1.10.4** | **Bench fixes on the ascent panel.** The **ATMO and V.Vrt value windows were touching and the divider between them flickered**: the ATMO window was a fixed 100 px box centred on the bar (x 152–252) while the V.Vrt window starts at 248, so the two `drawRect`s painted the same four columns and whichever repainted last owned them. The window now matches the column's true extent, triangle to triangle (166–238, 72 px), giving all three windows the same width and the same 10 px gap between them. The **ATMO window's percentage was dropped**: restating where the triangle already points adds nothing — the same objection that moved the bar values out of the readout column in the first place. It now shows **`T+Vac`**, time until the vessel leaves the atmosphere, which is the question the bar cannot answer: the bar says how deep, this says how much longer the air shapes the trajectory. The name row changed with it, because this is the only column where bar and window differ — see the LNCH notes above. On the ladder, the vessel marker's **`V` label is gone** (it read as a velocity; a filled pointer on an altitude scale is "you are here" without being told) and the apoapsis marker's `A` became **`Ap`**, with `LNCH_AS_MARKER_LBL_W` widened 16 → 24 because that constant sizes the marker *erase* as well as the label cell. Regression tests added to the host harness: the three value windows are checked for overlap from the geometry constants, and a 200-frame ladder sweep confirms each marker leaves exactly one band in the virtual framebuffer (the ORBIT reference line is dashed in the vessel marker's own colour, so its rows are excluded before counting). All new strings measured against the real glyph data: `T+Vac` 58 px, `59:59` 54 px, `Ap` 20 px. |
| **1.10.3** | **Correcting a claim about the ascent ladder.** 1.10.0 said its two markers carry their values. They do not — that half was never built, so `Alt.SL` and `ApA` have no digits on this screen at all, only marker position against the labelled tick scale. Nor can they easily: the left panel is packed to 573 px of 576, and the gap between the ladder's marker letters (ending x=116) and the ATMO gauge's left triangle (x=166) is 10 px, where `"101 km"` needs about 60. Considered and rejected: returning both to the readout column at the cost of two of Q / Mach / G, and inlining them into the ladder's own tick-label column. **Position-only stands as the decision** — the ladder marks both against a labelled scale, and the PFD on the other panel carries both in the great majority of ascent phases. The exception is a spaceplane still in the atmosphere, where that panel is AIRCRAFT and has neither; that is an accepted cost, now written down rather than left implied. Docs and code comments corrected to say what the screen actually does. |
| **1.10.2** | **Bench fixes on the reworked ascent panel.** The gauge windows are **boxed**, so each reads as part of its gauge rather than as loose text floating above it. The **ATMO window showed raw density and appeared dead**: the bar plots (ρ/ρ_surface)^0.25 — a fourth root, precisely so the thin upper atmosphere stays visible — while the window printed kg/m³ at two decimals, which reaches `0.00` around 30 km with the triangle still 23% up the bar. Density was wired correctly; the format was wrong. It now shows the gauge's own scale position as a percentage, so the window is the bar's readout rather than a second, differently-scaled quantity that looks like it stopped updating. Also fixed a change-detection bug in **Q**: its colours were decided from the thresholds and *then* overridden for the `---` placeholder, so every out-of-atmosphere frame compared a green threshold colour against a stored grey one and repainted forever. Colours are now settled before the change test. |
| **1.10.1** | **Dead code from the ascent rework.** `_lnchAs2UpdateAlt()` and `_lnchAs2UpdateApA()` were the shared updaters for the Alt.SL and ApA rows in both LAUNCH phases. Neither has a caller any more — the circularisation phase replaced its readout column with the apsis tape in 1.9.0, and 1.10.0 dropped those two rows in favour of the altitude ladder's markers — so the Teensy build reported both as `defined but not used`. Removed, and the comment above the shared block corrected to name the two updaters that are left. The host harness could have caught this: `-Wunused-function` is in `-Wall` and applies to static functions. It did not, because the harness runs were filtering compiler output for `error` and discarding warnings. They now build with `-Wall -Wextra` and report warnings from the file under test. |
| **1.10.0** | **The ascent gauges get their own digits.** Four of the readout column's eight rows were the numeric readout of a gauge on the same screen — `Alt.SL` and `ApA` for the altitude ladder's two markers, `V.Vrt` and `V.Srf` for the two bars — and none of those gauges printed a value of its own, so the pilot read magnitude on the left and precision 400 px away on the right. A tape whose digital window is at the other end of the display is two half-instruments. The three bar gauges now carry their values in a row between the name and the top endpoint label; one anchor constant makes the room, which is what that anchor block exists for. `Alt.SL` and `ApA` were dropped outright rather than moved — see 1.10.3. The column drops to **seven taller rows carrying only what has no picture**: T+Ap, Thrtl, **Q**, **Mach**, **G**, Stg.Brn, ΔV.Stg. Q is the addition that earns its place — the ATMO gauge shows density, which falls monotonically from the pad, while dynamic pressure peaks near 5–8 km and that peak is the one structural event of an ascent. `T.Brn` becomes **`Stg.Brn`** here too, matching 1.9.3 and ending the split where one field had two labels on two modes of one screen. **TWR was cut from the plan**: there is no mass and no thrust in `AppState`, so it cannot be computed — it was proposed in the review without checking. Two ordering bugs were caught by compiling the whole file in Arduino's order rather than the new code alone: `LNCH_AS2_NROWS` was used 1,300 lines above its definition (the builder hoists function prototypes, not constants), and `_lnchAsShowOrbitalVelocity()` had been deleted with the rows it used to serve while the V.Orb window still needed it. Field widths were measured against the real glyph data before shipping and caught the bar windows overflowing: `fmtMs()` carries " m/s", making even `"-12.0 m/s"` 90 px in a 72 px box, so the windows show bare numbers — the endpoint labels above and below already state the units. |
| **1.9.4** | **Ap−Pe overflowed its box across the whole normal range.** `formatAlt()` only switches to km above 1,000,000 m, so every gap from 100 km to 1000 km rendered as six digits and a separator — `"513,000 m"` measures 135 px against a 130 px rail box. That band is where a Kerbin circularisation *starts*: apoapsis at 101 km with periapsis still hundreds of kilometres underground gives a 513 km gap, so the very first frame of the burn overflowed. A local compact formatter promotes a unit band early enough that the scaled value never reaches five digits, capping the widest output at `"9,999 Mm"` (128 px); the 9999.5 thresholds are what stop rounding at the top of a band producing that fifth digit, and the scaled value goes through `formatSepI64` rather than `formatSep`, which renders two decimals below 1000 and would have given `"513.00 km"` — 134 px, still too wide. Measured, not estimated: a host test compiles the real `Roboto_Black_28` glyph data and the real `getFontCharWidth()` against the helper extracted from the shipping source, and sweeps every gap from 1 m to 1e13 m. The other readouts on the screen were checked the same way and are clear — eccentricity peaks at 88 px, and the three right-column rows have 217 px or more of value width against a 128 px worst case. |
| **1.9.3** | **The circularisation screen sorted by subject rather than by history.** The three numbers that describe the burn were scattered: ΔV Circ and Burn Dur sat on the left rail because that is where they had always been, while the right column carried Ecc and Ap−Pe — which describe the *orbit*, not the burn, and had landed there only because they were the values the PFD did not duplicate. They swap. The right column is now **ΔV.Circ / Burn Dur / Stg.Brn**, three numbers that read top to bottom as one question: can this stage finish this burn. The left rail takes **Ecc** and **Ap−Pe**, beside the orbit diagram they describe — the gap in particular is the distance between the two dots drawn just above it, a number the picture shows but cannot state. `T.Brn` is renamed **`Stg.Brn`**: it is Simpit's `BURNTIME_MESSAGE`, seconds of thrust left in the tank, and the old label read like a countdown of *this* burn beside two numbers that genuinely are. Both rail slots now share one draw helper, and its value box narrows from 140 px to the 130 the ΔV Circ readout used — Burn Dur's 140 reached x=144, past the orbit diagram's documented leftmost extent at 140, and only got away with it because nothing was drawn there. |
| **1.9.2** | **Marker trails on both halves of the circularisation screen.** One cause: the 1.9.1 rename had run over a region defined as "everything after the tape", but the orbit diagram's code sits *below* the tape in the file, so `_lnchOrPrevApY` / `_lnchOrPrevPeY` were renamed there too — leaving the tape and the diagram sharing one marker cache, each erasing at the other's row. Both trailed, which is exactly what was reported. The diagram's names are restored and the two no longer touch. The tape's Ap and Pe markers now take **cyan and magenta**, matching the dots on the diagram beside them, and the green/yellow periapsis state colour is dropped — the hollow off-scale marker and the floor line already carry that. **The harness gained a framebuffer.** The 1.9.1 test recorded only a bounding box, which cannot see a trail by construction; it now rasterises into a real 1024×600 buffer, drives *both* halves of the screen every frame (running only the tape is what let a shared-variable bug through), and counts colour bands per marker — a properly erased marker leaves one, a trail leaves more. Reintroducing the collision makes it fail with three Pe bands, so the test is known to catch the bug it was written for. It also caught its own text stub over-measuring glyphs, which had invented five stale pixels that were not really there. |
| **1.9.1** | **Build fix for the apsis tape.** Three compile errors, all of them things a host test that compiled the new code *in isolation* could not see. `struct OrTape` lived in the `.ino`, and Arduino hoists a generated prototype for every function to the top of the sketch — so the prototype for the helper returning one by value was emitted ahead of the struct: *'OrTape' does not name a type*. It moves to the header beside `ReCorridor`, whose comment documents this exact failure, and is renamed `ApsisTape`. The tape's state block sat below `_lnchOrResetState()`, which clears it, so the reset could not see it; it moves above. And `_lnchOrPrevApY` / `_lnchOrPrevPeY` were already the orbit diagram's own marker pixels a hundred lines up — the tape's are now `_lnchOrTp*`, which also avoids `_lnchOrPrevPeVal` shadowing the diagram's `_lnchOrPrevPeValid` by prefix. The host harness was the real defect: it extracted the new block and compiled that alone, which by construction cannot catch a duplicate definition, a use-before-declaration, or a hoisting problem. It now compiles the whole file in file order with the Arduino builder's prototype hoisting emulated, and drives a full circularisation through it. |
| **1.9.0** | **The circularisation readout becomes an instrument.** Its right third was eight numeric rows mirroring the ascent panel, and the pairing review measured seven of the eight as also present on the PFD beside it in every phase this screen is up — 88% of the column, restating the panel two feet away with 38% of the display. Swapping the values for better ones was the cheap fix and the wrong one: the replacements were all check-once numbers, and the space would still have been spent on text a glance exhausts. What the phase actually needs is a feedback loop. A circularisation burn is a single task — raise periapsis until it meets apoapsis — and while both apsides are on the PFD as independent numbers, the *gap between them* and the rate it is closing are on neither panel, and no readout can show a rate. The column is now an **apsis convergence tape**: apoapsis fixed near the top, periapsis climbing to meet it, the orbit-safe altitude as the floor, a bracket spanning the two, and three rows beneath (Ecc, Ap−Pe, T.Brn) carrying the only values here the PFD lacks. Making the orbit diagram bigger instead was measured and rejected — it has 35 px of slack above and 36 below, so it is boxed in by height while the freed space is 360 px of width; a tape is the instrument that fits a tall narrow column. Scale ends quantise to whole tick steps so the frame holds still while the marker moves (one rescale across a full Kerbin circularisation, measured on the host), the 1-2-5 step walks upward until at most eight ticks fit, and an off-scale suborbital periapsis clamps to the bottom and draws hollow until the burn brings it into view. Verified on the host: tick counts and clamping across Kerbin, Mun, Duna, a 1000 km ellipse and a 72 km grazing orbit, and a 400-frame burn that paints nothing outside x 578–939, y 62–599. |
| **1.8.1** | **The ASCENT/CIRCULARISATION switch moves off altitude.** It fired at 6% of body radius — 36 km on Kerbin — which put the screen into CIRCULARISATION while the vessel was still climbing under power, long before the burn that mode exists to fly. Altitude turned out to be the wrong axis entirely rather than a threshold set too low: a spaceplane can have its apoapsis parked above the atmosphere while still burning at 35 km, and a Mun ascent finishes below the Kerbin threshold altogether, so no single number serves both. The switch now keys off the engine — throttle closed, with apoapsis already above the orbit-safe altitude so a throttle-down through max Q is not mistaken for a coast — and **latches**, since the circularisation burn re-opens the throttle and a live test would bounce back to ASCENT for exactly the burn in question. Walking the missions caught one bug in the latch: it survived a landing, so a Mun surface departure began in CIRCULARISATION, `sit_PreLaunch` being the only reset and a surface launch never passing through it. It now also clears on the ground. The row-3 V.Srf/V.Orb label swap keeps the altitude test — which velocity is the meaningful one really is an altitude question — and the two are no longer the same formula. |
| **1.8.0** | **LAUNCH owns the ascent, not just the pad.** Rule 1 routes to it on `sit_PreLaunch` alone, so the screen vanished the instant the clamps released — and the mission panel spent the whole climb to orbit on ORBIT, a plan view of an orbit that does not exist yet, while the ascent readout it does have sat one press away. A circularisation node then pulled it to MANEUVER, the generic burn reticle, rather than the screen built for that exact burn. New rule 7 gives LAUNCH the arc from liftoff to orbit insertion, on two tests that together say *going up, and not there yet*: periapsis below `max(minSafe, lowSpace)` — the boundary `body_params.h` already defines between an orbit and an aerobrake — and vertical speed positive, with a −20 m/s release band so a coast through apoapsis does not drop the screen. The climb test is what keeps the rule off a descent, and it earns its keep on airless bodies where neither RE-ENTRY nor POWERED DESCENT is watching: a lander returning from Mun orbit also has a periapsis below the surface, and without it the panel would read LAUNCH all the way down. Rovers and Kerbals are excluded — cresting a hill and flying a jetpack are both briefly climbing with no periapsis, and neither is launching. Across the ten missions this converts 20 phases that read ORBIT or MANEUVER into LAUNCH, and ORBIT drops from 29 phases to 18 — it is now the resting state for a vessel that is actually in orbit rather than the fallback for everything that had not been claimed. Also corrected in the scenario harness: Duna's re-entry altitude was 30 km, invented; the real table says 20 km. |
| **1.7.2** | **NAVIGATION moves up the ladder, above DOCKING and TARGET.** The scenario walk found it ranked below both, which meant a plane cruising to a waypoint 1.5 km ahead got the RPOD rendezvous scope, and one at 150 m got the docking-port alignment reticle — two spacecraft instruments, at exactly the moment a navigation display is most wanted. It is now rule 4, directly below the pre-launch board and the re-entry corridor: the only two rules that legitimately beat a compass, the second being what a spaceplane at Mach 6 needs and NAV is not. Landed and splashed are excluded from the rule, so rollout and taxi stay with the surface rule and its recovery summary. Re-walking the ten missions confirms the change is confined to the two aircraft cases; every other phase is byte-identical, and no phase shows the same screen on both panels. Also documented as a project rule: **aircraft must be typed as aircraft.** Both AIRCRAFT and NAVIGATION key off `type_Plane`, so a plane KSP thinks is a Probe gets neither — deliberately, since inferring vessel role from a flight profile is what put a rocket on a compass rose to begin with. |
| **1.7.1** | **NAVIGATION was capturing rocket ascent.** Walking the ten mission scenarios against the ladders caught it immediately: a booster a kilometre off the pad is also in an atmosphere with a trivial apoapsis, so 1.6.0's rule handed a vertical rocket a compass rose from liftoff — and then swapped to ORBIT mid-burn, the moment apoapsis crossed the top of the atmosphere. Two wrong screens and an oscillation, on the busiest three minutes of a flight. The rule now requires the aircraft condition, which is the one Info 1 already uses to put AIRCRAFT up: NAV appears if and only if its partner PFD is the aircraft PFD, so the two panels are the standard airliner pair or they are not paired at all. The apoapsis test stays and does the remaining work, keeping a spaceplane on ORBIT once it is climbing out. |
| **1.7.0** | **EVA gets instruments.** The InfoDisp had no EVA awareness at all — `type_EVA` appeared in exactly two label lookups and in neither ladder — while the other two panels already handled it (the Annunciator tracks `inEVA`, the ResourceDisp swaps to a fixed EVA bar set). What a Kerbal outside the craft actually saw: **SPACECRAFT** on the vehicle panel, whose attitude ball is right but whose numeric panel offered ΔV.Stg, ApA, PeA, T+Ap and T+Ign — five rows, none of which a person holding a jetpack has; and **ORBIT** on the mission panel whenever no target was set, which is an apoapsis for a Kerbal. Both are fixed. SPACECRAFT swaps rows 2–6 to Alt.Rdr, V.Srf, Dist, V.Close and EC, pins row 1 to V.Orb so the V.Orb/V.Srf pair is always readable as one (station-keeping vs drifting), and keeps RCS and SAS, which mean exactly as much on a jetpack. Suit charge takes row 6 because ΔV.Stg would read a flat green 0 m/s, and it is the number that ends an EVA; it uses ROVER's own thresholds and reads the same field. The mission ladder gains rule 8, EVA → TARGET, below the surface rule (a Kerbal standing on the Mun is not on an approach) and above NAVIGATION. With no target that is TARGET's `NO TARGET SET` fullscreen, which at that moment is honest advice rather than a dead end. |
| **1.6.0** | **A navigation display, and one compass instead of two.** The mission panel had nothing to offer during atmospheric flight: every rule above it wanted a spacecraft, so a plane in cruise fell through to ORBIT, whose apsides and period mean nothing to an aircraft. **NAVIGATION** fills that gap as the plan view beside the PFD — the standard airliner pairing — showing where the vessel is pointed, where it is actually going, and where the target is. The discriminator that makes the rule safe is apoapsis against the top of the atmosphere: a jet in cruise and a spaceplane climbing out are both in atmosphere at the same altitude and speed, but only one has an apoapsis above `currentBody.lowSpace`, and the spaceplane keeps ORBIT, which is what it wants. **DRIFT** — ground track minus heading — is the only number on the screen that appears nowhere else on either panel; in an atmosphere it is the crab angle, and it is the difference between a heading that is holding and one that is quietly sliding off. NAV joins the TGT key's ring (TGT → DOCK → NAV) and needs no target to be useful. **The compass rose moved to `Compass.ino`**, shared by ROVER and NAV, following the consolidation the reticle layer (MNVR/TGT/DOCK) and the EADI tape (SCFT/ACFT) already went through — a second hand-maintained rose would have been the third place to fix any bug found in the first. The split is the same one those two use: the shared layer is pure geometry and pixels, owning no telemetry and no state, while each screen supplies its own radii (`CompassGeom`) and its own prev-drawn caches (`CompassCache`, `CompassMarkerCache`) so redraw gating stays per-screen, and decides what a marker means — ROVER draws one, NAV two. ROVER's rendering is unchanged and was proven so rather than assumed: the old and new geometry were extracted and run side by side on the host, comparing every emitted draw call — coordinates, colours and call order — at every heading and every marker bearing in quarter-degree steps, 23,041 comparisons with zero divergence. NAV adopts ROVER's card geometry outright, since the vertical budget between the title rule and the bottom edge is identical on both screens and ROVER's numbers already spend it correctly; sizing the card independently had put the heading box four pixels into the title rule. |
| **1.5.0** | **VEHICLE INFO belongs to the mission panel alone.** Info Display 1 routed to it for a recoverable vessel, which made `VEH \| VEH` reachable — the only pairing where both panels showed the same screen — for a capsule down and awaiting recovery. VEHICLE INFO is a status summary, not an instrument, so it is mission-panel material; the surface rule added in 1.4.0 already routes there. `vehicleContextScreen()` is now exactly the vessel-type question with no exceptions, and every one of the fourteen reachable pairings shows two different screens. VEH remains one press away on Info 1's own key. **AUTO/MAN chip restyled:** a rounded-rectangle outline (`drawRoundRectOutline()`, built from `drawLine` plus a Bresenham quarter-arc since the driver has no round-rect primitive), with MAN in dark green rather than cyan — engaged-mode green, matching the ASC key's armed colour, since a held selection is a mode the pilot has engaged rather than an exception. Outlined rather than filled, like the sidebar keys, so it reads as status and not as a control. |
| **1.4.1** | **The recoverable rule outranked the vehicle it was flying.** `vehicleContextScreen()` tested `isRecoverable` first, so a rover being driven on Kerbin — recoverable, since KSP reports anything on the home body that way — showed VEHICLE INFO instead of ROVER, and a plane rolling out after landing showed it instead of AIRCRAFT. Worse, the mission panel's new surface fallback also routes to VEHICLE INFO, so both panels showed the same static summary while the pilot was actively driving. The single-screen ladder this was split from had the recoverable rule at position 6, below plane and rover; flattening it to the top in 1.1.0 was the regression, and it only became visible once 1.4.0 made the ladder run every frame instead of at boundaries. Vessel type now comes first and recoverable is the fallback before SPACECRAFT, restoring the original precedence. `ROVR \| VEH` and `ACFT \| VEH` are good pairings — the instrument for what you are operating beside the summary of it. |
| **1.4.0** | **The panels follow the mission.** Both ladders were evaluated only at vessel and scene boundaries — `contextScreen()` had three call sites, none of them per-frame — so liftoff, reaching orbit, a node coming due, a target closing and re-entry all passed without either panel reconsidering. Whatever was true at the last boundary stayed on screen until the pilot pressed something, which made the MANEUVER and TARGET rules added in 1.1.0 effectively unreachable in ordinary flight, and left a spaceplane on AIRCRAFT in vacuum showing IAS, Mach and AoA. New `updateContextScreen()` runs both ladders every frame. **Flap guards:** a release band on each numeric rule (the threshold widens once that rule owns the screen, so holding station at 200 m or a burn sitting at ten minutes out cannot oscillate the panel) plus `CONTEXT_DWELL_MS`, a minimum gap between automatic switches, as a blanket guard for what the bands do not cover. **The latch became releasable**, which continuous evaluation requires — otherwise one exploratory press would disable routing for the whole flight. An override now records what the ladder was recommending when it was set (`_latchedAgainst`) and releases when that answer changes, so parking on ORBIT during a rendezvous holds until the target actually reaches docking range; pressing the button that owns the ladder's current choice is an explicit return to automatic. `isManualLockScreen()` is gone: RE-ENTRY pinned itself because it was manual-only and a `VESSEL_CHANGE` would yank it away, and both halves of that are now false. **Three new rules.** RE-ENTRY, reusing the RE-ENTRY screen's own corridor classifier so rule and screen agree by construction, gated on speed so an aircraft in level flight — whose periapsis is far underground and therefore "in the corridor" — does not trip it. POWERED DESCENT re-gated on proximity and descent rate instead of `type_Lander && sit_SubOrb`, which missed every Ship landing on the Mun and fired on the way up. And a surface fallback: landed or splashed routes to TARGET when one is set, otherwise VEHICLE INFO, replacing ORBIT-for-everything. **AUTO / MAN chip** in the title bar states which mode the panel is in, in words rather than a coloured dot; it replaces the LAUNCH screen's red override dot and covers that screen's phase override too. |
| **1.3.1** | **Demo mode now acknowledges the Ascent Autopilot console.** With 1.3.0 making annunciations wait for Controller_Main, and `apEnqueueCmd()` a no-op in demo, the ARM button on the bench did nothing at all — correct, but useless for exercising the console. The demo now plays the master's part: `apDemoApplyCommand()` applies ARM/DISARM and all six parameter setters to a demo-side autopilot model, and `stepDemoState()` publishes that model into `state.ap*` instead of the literals it used to hardcode, so the command-out/value-back round trip closes and the pending cue clears exactly as it does in flight. Previously the demo overwrote every AP field every frame, so even if a command had been applied the demo would have stamped over it on the next tick — which is why a parameter edit's cyan pending value could never clear on the bench either. The ascent animation is now gated on the armed state rather than deriving it: the demo boots armed so the guidance outputs animate as they always have, DISARM parks it in IDLE and holds the timer, ARM resumes where it left off. The `AP_CMD_*` opcodes and `AP_ROLL_OFF` moved from the console tab to `KCMk1_InfoDisp.h`, which is their proper home as the command contract shared by the console, the I2C layer and now the demo — and is required, since `Demo.ino` compiles before `Screen_LNCH_AscentAP.ino` in the concatenated sketch. |
| **1.3.0** | **Armed annunciations now show the autopilot's state, not the pilot's request.** Tapping DISARM flipped the ARM button and the ARMED/DISARMED banner to DISARMED immediately, before Controller_Main had acknowledged anything — so a command that was delayed, dropped, or never sent left the panel reading DISARMED while the autopilot was still flying the vehicle. That is the one direction of this control that must not be optimistic. The two questions are now separate functions and named for which is which: `apArmCommanded()` (what the pilot has asked for) decides only what the *next* tap does, so a second tap reverses a pending command rather than repeating it and a lost acknowledgement cannot lock the button out; `apArmedAnnunciated()` (what the autopilot reports) is what everything that *tells* the pilot anything reads — the button, the banner, and the sidebar ASC key — so none of them can disagree and none can say DISARMED while the vehicle is armed. Applied to ARM as well as DISARM: claiming ARMED before the autopilot has it is the same class of lie. **A tap still gets immediate feedback**, since a touchscreen has no detent — but as a pending cue rather than a state change: the ARM button's border goes to the same cyan the editable fields use for an unreconciled value, its hint reads `ARMING…` / `DISARMING…`, and the banner appends `...`. The cue clears when the echo lands. `apEnqueueCmd()` now returns whether it actually queued anything and the cue is gated on that, so in demo mode — and on unit 1, where the command channel is compiled out — a tap that sends nothing does not leave a cue that can never clear. |
| **1.2.1** | **A panel booting into a running flight no longer sits on standby.** `flightScene` was only ever set by `SCENE_CHANGE_MESSAGE`, which Simpit sends as an *event* — there is no way to ask for the current scene. A panel that boots (or whose USB re-enumerates) while a flight is already running therefore never hears it and sits on the standby screen until the pilot happens to change scene or vessel. Since Simpit sends `FLIGHT_STATUS` only from a flight scene, receiving it while the panel believes it is not in one is proof that the transition was missed, so the panel now adopts the scene there. Both routes go through one new `enterFlightScene()` so they cannot drift apart. The hook sits at the end of the `FLIGHT_STATUS` handler rather than earlier, so the message's own vessel data is already applied and the context ladder routes on the real vessel rather than on default state. The same defect and the same fix apply to the Annunciator and the Resource Display, which share the pattern and boot alongside this panel. |
| **1.2.0** | **PFD is now the top sidebar key on both units.** It was second, below LNCH, because the sidebar was ordered purely by mission phase. That ordering made sense when one panel had to serve every phase; with the roles split it buries the screen a pilot returns to from anywhere — and on unit 1 it buried that panel's entire reason for existing. The remaining five keys keep the mission-phase progression (LNCH, ORB, TGT, LNDG) and the single-mode key (VEH on unit 1, ASC on unit 2) stays at the bottom, so the change is a promotion rather than a reshuffle. Order is identical on both panels, so one reach serves either. `SB_PFD_BTN` and `SB_LNCH_BTN` swap values and the two tables reorder; every consumer already went through the named constants, so nothing else moved. |
| **1.1.3** | **The ASC key stayed green after a DISARM.** The sidebar read `state.apArmed` — the armed flag Controller_Main echoes back in its AscentStatus push — while everything on the Ascent Autopilot screen reads `apGArmed()`, which prefers the pilot's commanded intent while a tap is still in flight. So the ARM button flipped to DISARMED on touch and the key stayed green until the echo landed, and stayed green *indefinitely* whenever it did not: in demo mode `stepDemoState()` drives `state.apArmed` from the demo phase and never acknowledges a DISARM tap at all, so the override never cleared and the two annunciations disagreed permanently. Two things annunciating one fact were reading different sources of truth. New public `apArmedEffective()` exposes what the ARM button itself renders, and both `drawSidebar()` and `updateSidebar()` now read it, so the key and the button cannot disagree — including during the command round-trip, where the key now turns green on the tap rather than on the echo, matching the button. |
| **1.1.2** | **The sidebar stops spending the alerting colours.** Its keys were filled `TFT_NAVY` (#00007B) when unselected and `TFT_CORNELL` when selected — and `TFT_CORNELL` is a red, #B51C19. That put the vocabulary's highest-urgency colour on screen permanently, on every screen, for the whole flight, marking the least urgent fact the panel knows (the page you are already looking at) while this same panel uses white-on-red for the ΔV, G-load and ground-proximity alarms. The ASC key was purple/violet, a hue flight-deck convention does not assign at all. Meanwhile the content-area buttons (RCS, SAS, GEAR, BRAKES) already followed the project's documented language correctly, so the sidebar was the one place using a different vocabulary. The keys are now achromatic and selection is reverse video — white-on-black unselected, black-on-grey selected — which is what bezel-key flight decks do: the Garmin G1000 softkey row, the closest analogue to this sidebar, is exactly this, and FAA display guidance assigns light grey to inactive soft-button labels for the same reason. No new colour constants; both `ButtonLabel` literals come from the existing palette, and legend contrast improves at the ends (21:1 unselected, 5.5:1 selected). **Colour returns to the sidebar with a job:** the ASC key is `TFT_DARK_GREEN` while the autopilot is armed — engaged-mode green, the standard assignment — so the one sidebar key with state worth annunciating is the only key that carries a hue, and only while that state holds. It previously looked identical whether the autopilot was idle or flying the vehicle. That state colour needs a repaint path, since `drawSidebar()` runs from `drawStaticScreen()` and therefore only on a screen change: new `updateSidebar()` runs once per steady-state frame and repaints the 84 px strip only when the armed state actually flips, so the key turns green during an ascent rather than at the pilot's next screen switch. It compiles out on unit 1, which has no state-coloured key. Geometry is unchanged — the flat fills, square corners and 1 px rules were already right. |
| **1.1.1** | **Info Display 1 now actually comes up on the PFD.** Two defaults were still pointing at LAUNCH after the 1.1.0 role split. First, `SCREEN_HOME`: the panel's boot value, its demo-mode entry screen and the screen it parks on behind the standby splash were all hard-coded to `screen_LNCH` on both units, so the vehicle-type panel opened on LAUNCH and only reached the PFD once a scene or vessel change fired a context switch — and never at all if the panel booted into an already-running flight scene. It is now per unit: SPACECRAFT on unit 1, LAUNCH on unit 2. This is the role's resting screen, not its ladder fallback — unit 2's ladder rests on ORBIT, but a panel that has never seen telemetry is far likelier to be about to launch. Second, and the reason the PFD did not appear even on the pad: **`vehicleContextScreen()` returned VEHICLE INFO for a vessel sitting on the launchpad.** KSP reports a pre-launch vessel as recoverable, and the split had left the recoverable rule as the ladder's top entry. In the old combined ladder the pre-launch rule sat above it and shielded it; moving pre-launch to the mission panel removed that shield without replacing it. The rule is now gated on `!(situation & sit_PreLaunch)` explicitly, so a rocket, spaceplane or rover on the pad routes to its attitude screen while a landed-and-recoverable vessel after a flight still routes to VEHICLE INFO. Five ladder cases added for the pad. |
| **1.1.0** | **The two Info Displays stop being clones.** They ran byte-identical firmware differing only in I2C address, so both auto-routed to the same screen at the same moment: two panels showing one screenful of information, twice, and re-converging at exactly the busiest moments — crossing 200 m to a target snapped both to DOCKING and destroyed whatever second view the pilot had set up. Each panel now has a role. **Info Display 1 is the vehicle-type panel** (*what am I flying?*) and holds the PFD family; **Info Display 2 is the mission-phase panel** (*what phase am I in?*) and holds the plan and target views. This is not just a default: the old `contextScreen()` was two unrelated ladders interleaved, forced to rank one above the other, and vessel type won — so its rules 1–2 masked its rules 3–5. A spaceplane on the pad never saw the pre-launch board; neither a spaceplane nor a rover closing on a target ever auto-routed to DOCKING. `contextScreen()` now splits into `vehicleContextScreen()` and `missionContextScreen()`, one per panel, and neither masks the other. The plane/rover exclusion on the pre-launch board — which existed only to paper over that masking — is gone. **Three routes the second panel pays for:** ORBIT becomes the mission panel's resting state (previously never auto-selected, because on one display it would have stolen the attitude reference); MANEUVER auto-selects on an imminent burn, gated on time-to-ignition (`MNVR_CONTEXT_LEAD_S`, 10 min) rather than on a node merely existing, and stays up through the burn; TARGET auto-selects in a bounded approach window (200 m to `TGT_CONTEXT_MAX_M`, 2000 m). **Manual selection now latches** — any sidebar press survives context events until the vessel or scene changes (`contextSwitchAllowed()`), generalising the per-button `_pfdManualOverride` pattern; with each panel doing a job, a screen the pilot parked is a screen they are using. **Sidebars moved outboard.** Both panels sit inboard on their own half of the console, so their inner edges meet at the centreline; unit 1's sidebar moves to its left edge, mirroring the pair about that line. The content areas become adjacent and read as one field, every content-area touch target on unit 1 moves 84 px inboard rather than away, and each button column falls under its own hand. Implemented as a canvas-origin offset (`canvasContentRegion()`) rather than by editing ~700 drawing calls: the RA8876 canvas stride stays `SCREEN_W`, so advancing the base address by `CONTENT_X` pixels shifts every row identically. Unit 2's offset is zero and its register writes are unchanged. **Button 5 is per-unit:** unit 2 keeps the Ascent Autopilot console and is now its sole owner — `apEnqueueCmd()` compiles to a no-op on unit 1, so the single-editor assumption behind the pending-edit reconcile is a property of the command channel rather than of the navigation table. Unit 1 carries VEH there instead, which also shortens its PFD ring from four modes to three. **Cycling is quicker:** a repeat press on the same sidebar button now debounces at 150 ms instead of 500 ms (a first press, a different button, and content-area taps keep the full window), so a three-deep cycle no longer costs 1.5 s of enforced waiting. Buttons 0–4 remain identical on both units and all thirteen screens stay reachable from either panel — the units differ in defaults, not in capability. `INFO_DISP_UNIT` moved from `AAA_Config.ino` to `KCMk1_InfoDisp.h`, since the layout constants and sidebar tables are now compile-time conditional on it. |
| **1.0.8** | **DOCK now carries the same four angle rows as TGT.** It showed only `V.Brg`/`V.Elv`, as two full-width rows, with the nose-to-port angle available solely as the unsigned `Nos.Off` magnitude — so the signed pair TGT shows was missing on the screen that needs it most. Rows 4 and 5 are now split pairs mirroring TGT exactly: `Brg`\|`Elv` (the port relative to the nose, informational) then `V.Brg`\|`V.Elv` (approach-path error about the target axis, colour-banded, `---` past 90°). `Nos.Off` keeps the freed full-width row 6 and stays colour-banded, so alignment status is still signalled and DOCK is a superset of TGT rather than a rearrangement. One trade-off: the half-width cells cannot hold a decimal — measured against the real font, `V.Brg:` plus `+12.3°` needs 204 px against 178 available — so both pairs are whole degrees, matching TGT. `V.Lat` (m/s, two decimals) remains the precision instrument at docking range, and the marker itself gives sub-degree visual resolution. |
| **1.0.7** | **Off-scale markers are now dimmed instead of silently lying.** All three reticles clamp a marker that falls beyond full scale, which keeps its direction honest but discards its distance — and drew it identically to a real reading. The ambiguous bands were wide: DOCK honest to 17.3° then pinned all the way to 162.9° where the anti-target takes over (146° wide), TGT honest to 51.9° then pinned to 128.5° (77°), MNVR honest to 17.3° then pinned to 180° with no antipodal marker at all (163°). A pinned marker is now drawn at half brightness — `TFT_DIM_VIOLET` for the port/target, `TFT_DIM_NEON_GRN` for velocity, `TFT_NAVY` for MNVR's maneuver diamond — so it reads as pegged rather than as a live value, while `Nos.Off` / `Brg` / `Elv` carry the true angle. The colour change is forced through the redraw gate by a cached pinned flag: the transition can move the marker as little as 1 px, which the `>1 px` movement test would otherwise swallow. |
| **1.0.6** | **Angle readouts now come from the same projection the markers do, and each quantity has one name.** The `Brg`/`Elv`/`Err` rows still computed horizon-frame heading/pitch differences after 1.0.3 moved the markers to a true boresight projection, so the numbers contradicted the picture *and* the ring-derived colour bands: a node 10° off the nose printed 13.8° at 45° pitch and 62.9° at 80°, and a 6° approach-path error printed 9.9° at 60° pitch — yellow, while the marker sat inside the green ring. MNVR's `Brg`/`Elv` now come from the same boresight angles that place its marker and gate its alignment box. **TGT's `Brg`/`Elv` row was showing the vessel's compass bearing:** it printed `state.tgtHeading` wrapped to ±180 under a comment claiming "positive = target to the right", so a target dead ahead on heading 120 read +120 instead of 0. It is now nose-relative, the same quantity MNVR shows. **Naming:** DOCK's `Vel.Brg`/`Vel.Elv` and TGT's `Err`/`Err` were the identical value under two names — both are now **`V.Brg`/`V.Elv`**, matching the project's existing `V.` prefix for velocity quantities. That pair is now measured about the target axis, making it the exact 3D approach-path error rather than a horizon-frame difference, and it shows `---` past 90° (the idiom `T+Int`/`T+Dock` already use) where the signed pair stops being flyable — which also keeps it inside TGT's 178 px half-cells, verified against the real font metrics. |
| **1.0.5** | **The reticle rings are now the colour bands.** Every reticle draws its good zone at full-scale/4 and its middle ring at full-scale/2, but the numeric thresholds agreed with neither on DOCK (ring 5°, numbers green to 10°) nor TGT (ring 15°, numbers yellow at 5°). Warn and alarm are now exactly those two radii — DOCK/MNVR 5°/10°, TGT 15°/30° — so green inside the inner ring, yellow to the middle ring, red beyond, and the picture cannot disagree with the numbers. This also corrects an inversion: TGT was *tighter* than DOCK (5/15 vs 10/20), the opposite of its own comment and of what the two phases need. MNVR's `angCol` lambda ignored its argument and returned a fixed colour, so its angle readouts never changed colour at all; it now uses `ATT_ERR_WARN_DEG`/`ATT_ERR_ALARM_DEG` (new) like the other two. A distinct target-prograde glyph for the TGT/DOCK velocity marker was prototyped in this cycle and **not adopted** — the plain prograde symbol is kept on both the reticles (target-relative velocity) and the PFD ball (orbital/surface), with context and the per-screen legend distinguishing them. |
| **1.0.4** | **Every boresight display is now body-referenced.** MNVR and TGT joined DOCK, the EADI ball markers and the re-entry retro ball in building their axes with the vessel roll, so screen up is always the craft's roof and one pilot instinct serves every display. Previously MNVR and TGT were horizon-referenced: with the craft rolled 90°, pitching up slid the MNVR node marker *sideways* rather than toward the crosshair. TGT mattered for a second reason — TGT and DOCK are the same task at different ranges (shared sidebar button; the Dist row goes white-on-green below 200 m to say "switch to DOCK"), so a frame difference re-anchored every marker at exactly the moment the pilot crossed over. With no screen left wanting the horizon frame, `reticleComputeAngles()` drops its `bodyReferenced` argument and the rule is documented rather than configured. Note the two marker classes respond oppositely, on every screen and by design: steer *toward* a position marker (node/port/target), thrust *away* from a velocity marker (prograde). |
| **1.0.3** | **True boresight projection on every attitude display.** MNVR / TGT / DOCK, the EADI ball markers and the re-entry retro ball all plotted world directions by subtracting headings and pitches and scaling the differences — valid only near zero pitch. Because heading lines converge toward the poles, the bearing axis stretched by roughly 1/cos(pitch): a 10° error read 14° at 45° pitch and 20° at 60°, so the degree-labelled rings were misreporting, anisotropically. Past ~80° it inverted outright — which is exactly where **a radial-in/out maneuver node puts the vessel**, making MNVR's alignment marker actively wrong for that class of burn. All five now call `kspBodyAxes` + `kspBoresightAngles` (KerbalDisplayCommon 3.3.0): the vessel attitude resolves into 3D body axes and the direction projects azimuthal-equidistant about the boresight, so a marker's distance from the crosshair is its true angular offset at any attitude. `Nos.Off` (DOCK) and the MNVR alignment box are now exact rather than Pythagorean approximations, and re-entry `AoA` is the true nose-to-airflow angle. `ReticleGeom::rollRef` is gone — body vs horizon reference is now chosen by whether the caller builds its axes with roll or with 0 — and `reticleComputeAngles()` takes that flag. MNVR stays horizon-referenced pending a separate decision (`MNVR_BODY_REF`). Verified over 17,664 attitude/offset combinations: worst radius error 0.02°. |
| **1.0.2** | **Reticle consolidation + one roll handedness.** The marker layer moved out to KerbalDisplayCommon 3.2.0 (`ReticleGeom` / `ReticleDotCache` / `ReticleAngles`, `reticleProject` / `reticleClampDot` / `reticleEraseDot` / `reticleRepairDotChrome` / `reticleUpdateDots`), beside the `reticleDrawBase` chrome it already drew on; `reticleComputeAngles()` stays in `AAA_Screens.ino` as the only reticle code that reads `state`. **MNVR now runs the shared layer**, deleting its own `_mnvrClampMrk` and `_mnvrRepairChrome` copies (a byte-for-byte duplicate of the DOCK/TGT chrome repair) — three reticle screens, one implementation. `reticleUpdateDots` takes a `ReticleAngles` instead of eight loose floats and no longer reads the global `state` for roll (it rides in `ReticleAngles::roll`). **Fixed: the re-entry retro-ball marker rotated by `+state.roll`** while the EADI ball and the re-entry screen's own bank pointer both use `-state.roll` — it spun the wrong way as bank built up. All three body-referenced displays now call the single `kspCockpitOffset`, so this class of disagreement can no longer exist. `eadiHdgDelta` moved to the library; the last three single-use wrappers (`_mnvrWrapErr`, `_reWrap180`, `_dockWrapErr`/`_tgtWrapErr`) are gone. |
| **1.0.1** | **DOCK/TGT velocity marker frame fix.** The green VEL marker was plotted target-referenced (`tgtHeading − tgtVelHeading`) on a nose-referenced reticle, so it mixed two frames and did not respond to RCS translation the way a prograde marker should. All four reticle markers are now nose-referenced in `reticleComputeAngles()`; the target-referenced approach-path error moved to new `appBrg`/`appElv` fields, which still drive DOCK Vel.Brg/Vel.Elv and TGT B.Err/E.Err unchanged (and are now exactly the on-screen VEL↔PORT gap). DOCK additionally sets the new `ReticleGeom::rollRef`, rotating its marker layer by −roll into the craft's body axes — the same transform `eadiDrawAdiMarker()` applies to navball markers — so screen up/right always matches the RCS translation axes: velocity marker up and right → thrust left and down. TGT/MNVR stay horizon-referenced. |
| **1.0.0** | Production release. **Navigation redesign:** mode switching moved from title-bar taps to the left sidebar, which cycles its buttons; sidebar reduced from ten buttons to **six**. A first press of a button jumps to its context/primary screen; pressing the button that already owns the active screen cycles its modes, and the caption shows the active mode. Multi-mode buttons: **PFD** covers SPACECRAFT / AIRCRAFT / ROVER / VEHICLE, **ORB** covers ORBIT / Advanced Elements / MANEUVER, **TGT** covers TARGET / DOCKING, **LNDG** covers POWERED DESCENT / RE-ENTRY; **ASC** (Ascent Autopilot) stays standalone. Title-bar taps no longer switch screens. VEH and MNVR are reachable by cycling their host button (VEH still auto-selected for recoverable vessels via context). **Refactors:** shared `sasNavballLabel()` for SCFT/ACFT/ROVR; heading-wrap routed through `eadiHdgDelta`; dead EADI-ball constants removed; shared Ascent/Circ 8-row readout panel; shared SCFT/ACFT EADI tape + roll-readout scaffolding; shared TGT/DOCK reticle dot layer. **Fixes (audit batches A/E/F):** core/infra cleanup, reticle-bar stale statics, corrected AoA-arc comment. Compile-time `INFO_DISP_UNIT` selector picks the target board (Info Display 1 = 0x12, Info Display 2 = 0x13) from one firmware. Chip naming standardized to LT7683 (RA8876-compatible). README navigation section rewritten for the six-button model. Requires KerbalDisplayCommon ≥ 3.1.2. |
| **0.14.0** | Ascent Autopilot screen added (sidebar button **ASC**, screen index 12) — touch console for the Simpit ascent autopilot with an on-screen numeric keypad, editable mission/vehicle parameters, and touch ARM/DISARM. Outbound I2C packet extended 4→10 bytes with an Ascent-AP command frame (`cmdSeq`/`cmdOp`/float payload/XOR); inbound control byte 1 now carries the command `ackSeq`; new 40-byte Master→InfoDisp `AscentStatus` push (sync `0xA5`, dispatched by length). New `Documents/Developer/Ascent_Autopilot_Interface.md` byte-level contract. ORB+ (Advanced Elements) moved from its own button to an ORBIT title tap; Re-entry is now its own **ENTR** sidebar screen. KSP navball markers (prograde/retrograde/target/maneuver) doubled in size and thickened. Reticle markers now sourced from the shared `KerbalDisplayCommon` library (`drawThickLine` added). Hardware baseline updated to Teensy 4.1 + LT7683 1024×600 parallel carrier (KC-01-1912). Dead code removed (`SCREEN_IDS`, unused row-geometry helpers, `_prevShowAp`); stale comments corrected (INT pin 0, 10-byte packet). Bug fixes: keypad modal reset on screen leave/return, relative reconcile tolerance for high target apoapsis, demo-mode command-queue guard. |
| **0.13.3** | Phase 3 complete: I2C slave interface and boot handshake. I2C sync byte corrected from `0xAD` to `0xAE` (collision with ResourceDisp). I2C constants consolidated to `KCMk1_SystemConfig.h`. `idleState` change now immediately calls `drawStandbyScreen()`. Demo→live I2C transition now calls `initSimpit()`. Loop order corrected: touch processed before Simpit (matches Annunciator/ResourceDisp). `setKDCDebugMode()` moved to immediately after `SerialUSB1.begin()`. `simpit` object moved to `AAA_Globals.ino`. `switchToScreen()` now records `lastScreenSwitch` timestamp. `_lndgReentryMode`, `_orbAdvancedMode`, `_prevShowAp`, `_attPrevOrbMode` now reset on vessel switch. `stepDemoState()` now returns immediately if `!demoMode`. `stgWarn` float cast added in `Screen_VEH`. Touch count filter changed to `!= 1`. Boot screen header shows live version string. Phase markers in comments updated. Updated to KerbalDisplayCommon 2.1.0 (thresholdColor float overload, formatTime int64_t, drawValue split-column overload, drawStandbySplash, fmtTime removed — call sites now call formatTime() directly). |
| **0.13.2** | Phase 2 complete: KerbalSimpit integration verified for all 10 screens. Hover screen name corrected (TARGET/TGT). Parachute state machine (STOWED→ARMED→OPEN) implemented. Re-entry 6-state phase logic. DOCK drift decomposition. ATT heading/pitch error colouring gated on atmosphere. Maneuver screen `---` suppression when no node planned. |
| **0.13.0** | Phase 1 complete: display framework with all 10 screens, sidebar navigation, demo mode. |

---

## Notes

- **`debugMode`** defaults to `false`. Set `true` only during development.
- **`demoMode`** defaults to `false` (live Simpit telemetry). Set `true` for the sine-wave demo without KSP. At runtime only the master's flag changes it.
- **Display rotation** — `DISPLAY_ROTATION = 2` for inverted mounting, `0` for production.
- **Backlight** is on pin 9 (`KCM_TFT_BL`, PWM from the master's BACKLIGHT levels, `KCM_BL_BRIGHTNESS_PCT` / `KCM_BL_STANDBY_PCT` until the first frame; see **Backlight**); the master-alarm tone (`tone()` → PAM8302A amp) is on pin 29 (amp enable TONE_EN on pin 30) and the DFPlayer on Serial2 — all defined in `KCMk1_SystemConfig.h`.
- **KerbalDisplayCommon ≥ 3.11.0** is required (hardware rev 2 / `KCM_TFT`, `RA8876_t41_p`; 3.5.0 carries the shared reticle marker layer and the `kspBodyAxes` / `kspBoresightAngles` boresight projection). Do not downgrade.
- **Closure velocity** — the TARGET and DOCKING screens both show closure as a signed **V.Close** value (negative = closing, positive = opening); the intercept-time rows (T+Int / T+Dock) are shown only while closing.
- **EC** on the pre-launch board and Rover screen may require the Alternate Resource Panel (ARP) mod in KSP1.

Licensed under the GNU General Public License v3.0.
Final code written by J. Rostoker for Jeb's Controller Works.
