bigJRo/KerbalControllerMk1/Documents/Developer/Master_Firmware_Design.md

# KCMk1 Master Firmware — Design

| | |
|---|---|
| **Document type** | Developer — design for approval |
| **Location** | `Documents/Developer/Master_Firmware_Design.md` |
| **Status** | Draft 5, approved. All eight stages are built in `Software/KCMk1_Master` (§16) and `Controller_Main` is deleted (cutover done). Rules settled while building are marked *(stage n)* |
| **Draft 5** | Rebuilt from the board-by-board and panel-by-panel review recorded in `Hardware_Inventory.md`. Adds the start-up / boot reporting design, demo and debug modes, the new autopilot authority rule, the Sys Info Display, and the watchdog design (§12.3) |
| **Supersedes** | Drafts 1–4, and `Controller_Main_IO_Design.md` |

---

## At a glance

We are replacing the master firmware (`Software/Controller_Main`) with a **new sketch written from the ground up**, `Software/KCMk1_Master/`.

- **Why:** the old sketch and the Hardware Reference are out of date and contradict the rev-2 hardware. For example, none of the old sketch's interrupt pins matches the rev-2 Ctrl Module.
- **Built from:** the hardware inventory, made from the schematics and confirmed panel by panel. It covers every board, connector, slot, switch and button label.
- **Kept:** the autopilots' control laws and consoles. They are ported, with one behaviour change agreed in the review: sticks no longer disconnect them (§11).
- **How:** eight stages, one PR each, every one checked on the host before it merges (§16). Display and module firmware changes are a separate list (§17).

---

## Contents

1. [Decisions](#1-decisions)
2. [Sources](#2-sources)
3. [What the master does](#3-what-the-master-does)
4. [Architecture](#4-architecture)
5. [Start-up and boot reporting](#5-start-up-and-boot-reporting)
6. [Module bus](#6-module-bus)
7. [Outputs to KSP](#7-outputs-to-ksp)
8. [Panel behaviour](#8-panel-behaviour)
9. [Annunciator fields](#9-annunciator-fields)
10. [Demo and debug modes](#10-demo-and-debug-modes)
11. [Autopilots](#11-autopilots)
12. [Board services and the watchdog](#12-board-services-and-the-watchdog)
13. [Display carriers](#13-display-carriers)
14. [Sys Info Display](#14-sys-info-display)
15. [Verification](#15-verification)
16. [Stages](#16-stages)
17. [Work outside the master](#17-work-outside-the-master)
18. [Open items](#18-open-items)
- [Appendix A — Pin map](#appendix-a--pin-map)
- [Appendix B — Glossary](#appendix-b--glossary)

---

## 1. Decisions

- **New sketch, from the ground up**, in `Software/KCMk1_Master/`. `Controller_Main` got no further changes and was deleted at cutover (stage 8), after its autopilots were ported (stage 7).
- **The autopilots are ported, not rewritten.** Their control laws, state machines and console protocol carry over. The interfaces they use to reach the rest of the master are re-pointed, and the pilot-override rule is replaced (§11).
- **Hardware truth is `Hardware_Inventory.md`.** It was made from the schematics and confirmed against the panels. The Hardware Reference and the Module UI Reference are rewritten from it at cutover.
- **Plan first.** This document is approved before stage 1 starts.
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
