bigJRo/KerbalControllerMk1/Documents/Developer/assets/sysinfo/SysInfo_BOOT.png

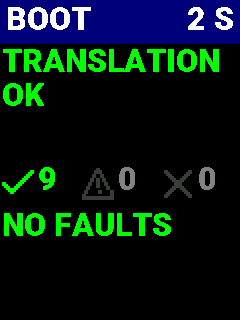
Documents/Developer/assets/sysinfo/SysInfo_BOOT.png
