bigJRo/KerbalControllerMk1/Documents/Developer/assets/sysinfo/SysInfo_BOOT_WAIT.png

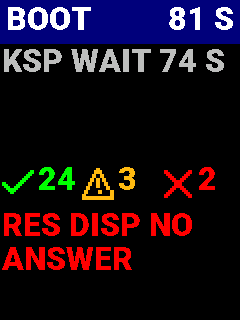
Documents/Developer/assets/sysinfo/SysInfo_BOOT_WAIT.png
