bigJRo/KerbalControllerMk1/Documents/Developer/assets/sysinfo/SysInfo_STATUS_FAULTS_2.png

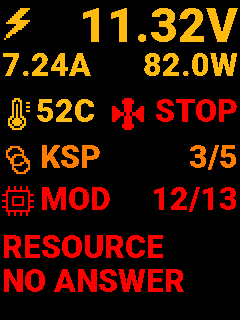
Documents/Developer/assets/sysinfo/SysInfo_STATUS_FAULTS_2.png
