bigJRo/KerbalControllerMk1/Documents/Developer/assets/sysinfo/SysInfo_STATUS_SERVICE.png

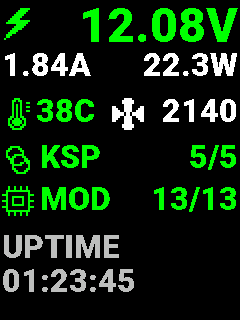
Documents/Developer/assets/sysinfo/SysInfo_STATUS_SERVICE.png
