bigJRo/KerbalControllerMk1/Documents/Developer/assets/sysinfo/SysInfo_SWITCH_ERR.png

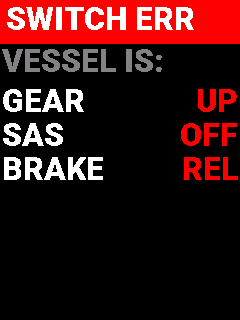
Documents/Developer/assets/sysinfo/SysInfo_SWITCH_ERR.png
