bigJRo/KerbalControllerMk1/Documents/Developer/assets/sysinfo/SysInfo_SWITCH_ERR_PAGED.png

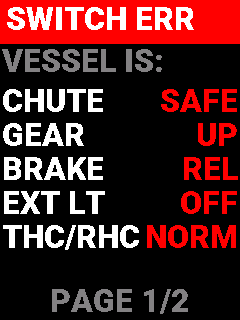
Documents/Developer/assets/sysinfo/SysInfo_SWITCH_ERR_PAGED.png
