bigJRo/KerbalControllerMk1/Documents/Labels/A2/Action_Control_0x22/AG_01.png

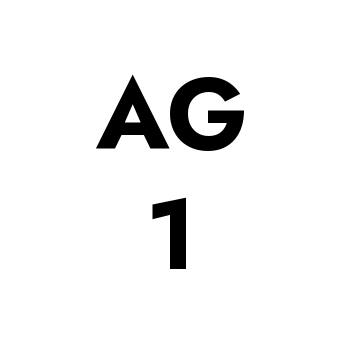
Documents/Labels/A2/Action_Control_0x22/AG_01.png
