bigJRo/KerbalControllerMk1/Documents/Labels/A2/Function_Control_0x21/06_FLAPS.png

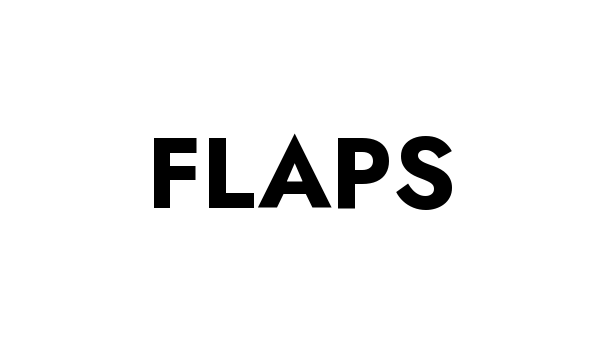
Documents/Labels/A2/Function_Control_0x21/06_FLAPS.png
