bigJRo/KerbalControllerMk1/Documents/Labels/A2/Function_Control_0x21/07_ALT.png

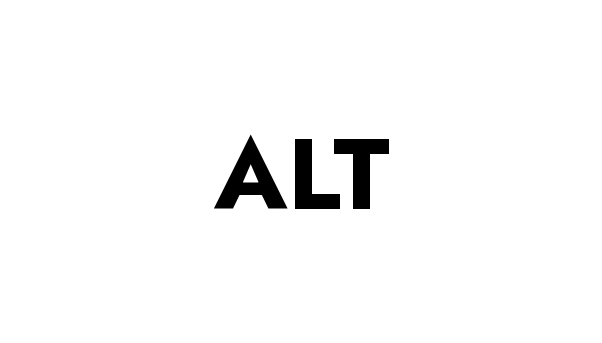
Documents/Labels/A2/Function_Control_0x21/07_ALT.png
