bigJRo/KerbalControllerMk1/Documents/Labels/A2/Function_Control_0x21/08_COLLECT.png

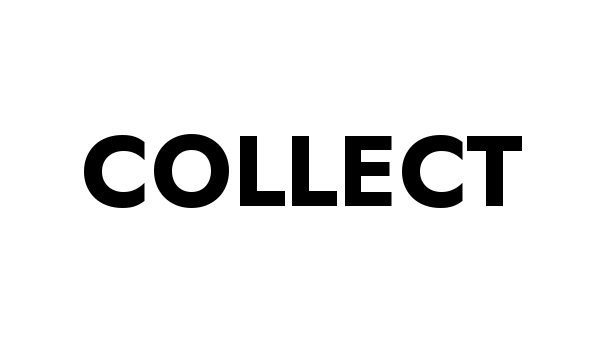
Documents/Labels/A2/Function_Control_0x21/08_COLLECT.png
