bigJRo/KerbalControllerMk1/Documents/Labels/A2/Function_Control_0x21/11_GROUP_2.png

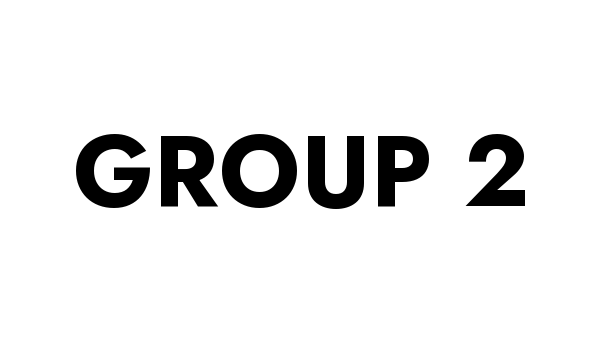
Documents/Labels/A2/Function_Control_0x21/11_GROUP_2.png
