bigJRo/KerbalControllerMk1/Documents/Labels/A2/GPWS_0x2A/02_PROX.png

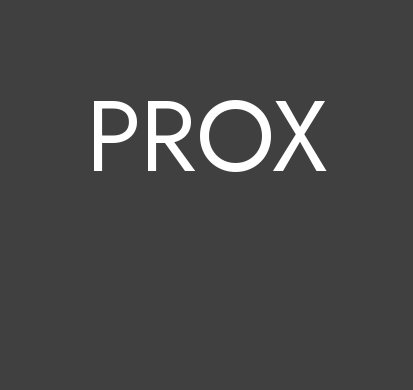
Documents/Labels/A2/GPWS_0x2A/02_PROX.png
