bigJRo/KerbalControllerMk1/Documents/Labels/A2/GPWS_0x2A/GPWS_7seg_8888_fit.png

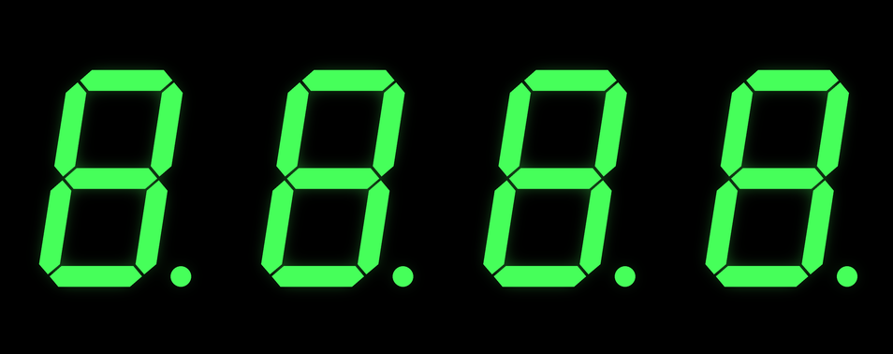
Documents/Labels/A2/GPWS_0x2A/GPWS_7seg_8888_fit.png
