bigJRo/KerbalControllerMk1/Documents/Labels/A2/UI_Control_0x20/01_ENA.png

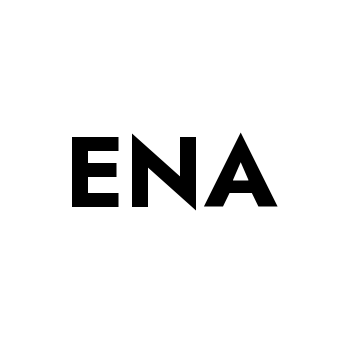
Documents/Labels/A2/UI_Control_0x20/01_ENA.png
