bigJRo/KerbalControllerMk1/Documents/Labels/A2/UI_Control_0x20/02_LEFT.png

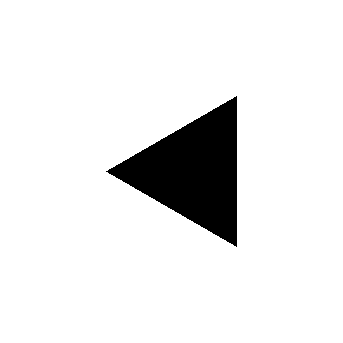
Documents/Labels/A2/UI_Control_0x20/02_LEFT.png
