bigJRo/KerbalControllerMk1/Documents/Labels/A2/UI_Control_0x20/04_RESET.png

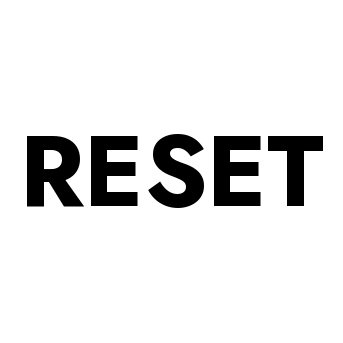
Documents/Labels/A2/UI_Control_0x20/04_RESET.png
