bigJRo/KerbalControllerMk1/Documents/Labels/A2/UI_Control_0x20/06_SCREEN_SHOT.png

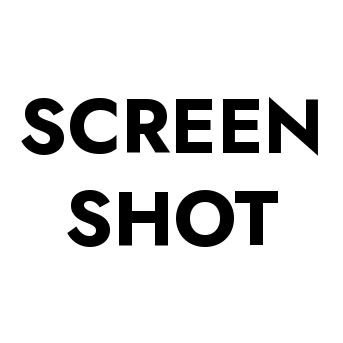
Documents/Labels/A2/UI_Control_0x20/06_SCREEN_SHOT.png
