bigJRo/KerbalControllerMk1/Documents/Labels/A2/UI_Control_0x20/10_CYCLE_NAV.png

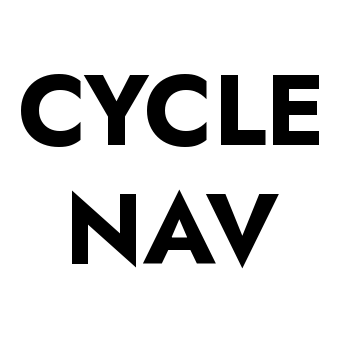
Documents/Labels/A2/UI_Control_0x20/10_CYCLE_NAV.png
