bigJRo/KerbalControllerMk1/Documents/Labels/B2/AUX_CTRL_0x26/B00_EVA_LIGHTS.png

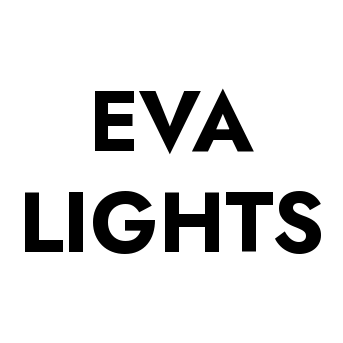
Documents/Labels/B2/AUX_CTRL_0x26/B00_EVA_LIGHTS.png
