bigJRo/KerbalControllerMk1/Documents/Labels/B2/AUX_CTRL_0x26/B05_GRAB.png

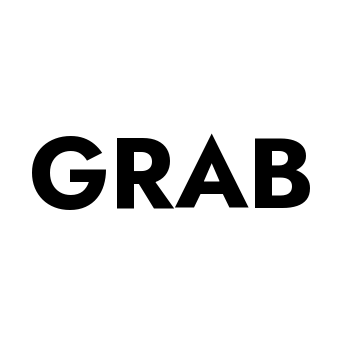
Documents/Labels/B2/AUX_CTRL_0x26/B05_GRAB.png
