bigJRo/KerbalControllerMk1/Documents/Labels/B2/AUX_CTRL_0x26/B06_EVA_CHUTE.png

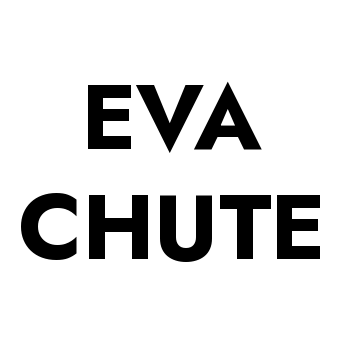
Documents/Labels/B2/AUX_CTRL_0x26/B06_EVA_CHUTE.png
