bigJRo/KerbalControllerMk1/Documents/Labels/B2/AUX_CTRL_0x26/B08_UN_DOCK.png

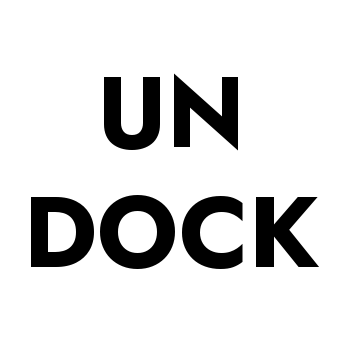
Documents/Labels/B2/AUX_CTRL_0x26/B08_UN_DOCK.png
