bigJRo/KerbalControllerMk1/Documents/Labels/B2/AUX_CTRL_0x26/B11_ALT.png

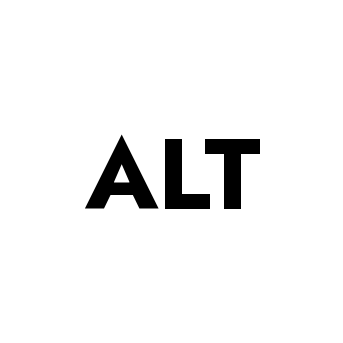
Documents/Labels/B2/AUX_CTRL_0x26/B11_ALT.png
