bigJRo/KerbalControllerMk1/Documents/Labels/B2/PreWarp_Time_0x2B/02_1_HR.png

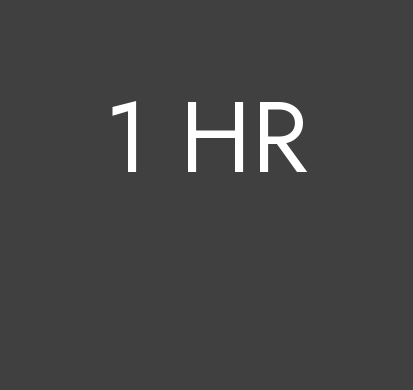
Documents/Labels/B2/PreWarp_Time_0x2B/02_1_HR.png
