bigJRo/KerbalControllerMk1/Documents/Labels/B2/PreWarp_Time_0x2B/03_1_DAY.png

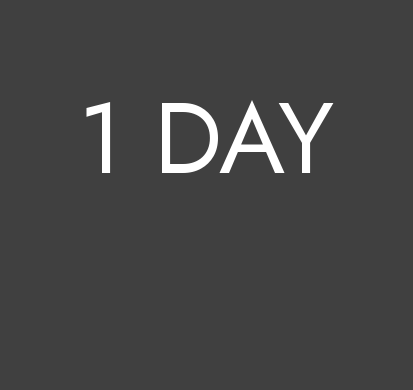
Documents/Labels/B2/PreWarp_Time_0x2B/03_1_DAY.png
