bigJRo/KerbalControllerMk1/Documents/Labels/B2/PreWarp_Time_0x2B/PreWarp_7seg_60.png

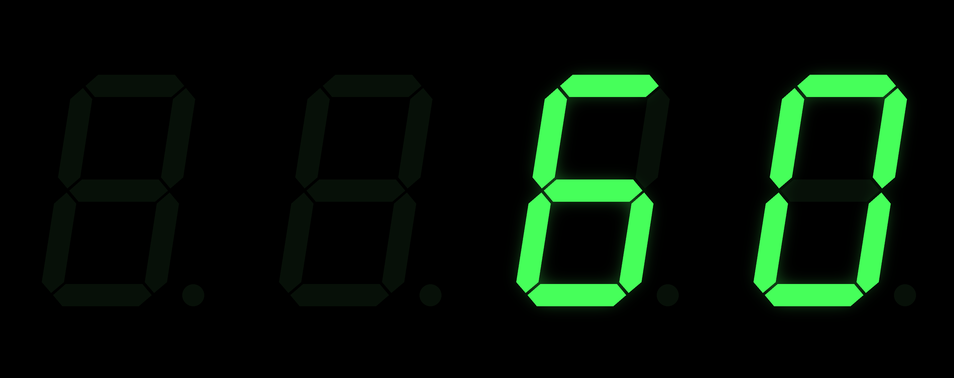
Documents/Labels/B2/PreWarp_Time_0x2B/PreWarp_7seg_60.png
