bigJRo/KerbalControllerMk1/Documents/Labels/B2/Rotation_Joystick_0x28/_layout.png

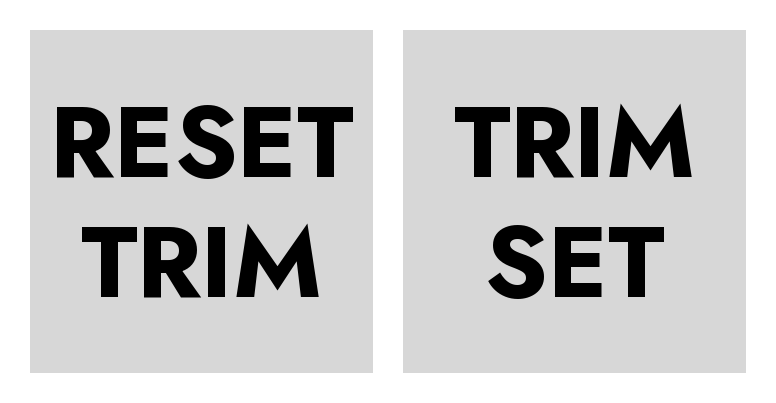
Documents/Labels/B2/Rotation_Joystick_0x28/_layout.png
