bigJRo/KerbalControllerMk1/Documents/Labels/B2/Rotation_Joystick_0x28/BTN01_RESET_TRIM.png

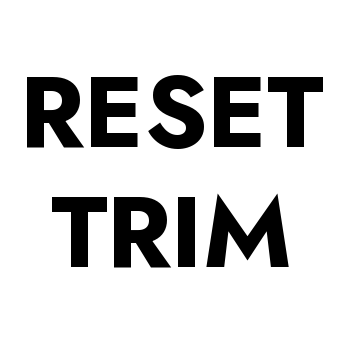
Documents/Labels/B2/Rotation_Joystick_0x28/BTN01_RESET_TRIM.png
