bigJRo/KerbalControllerMk1/Documents/Labels/B2/Rotation_Joystick_0x28/BTN02_TRIM_SET.png

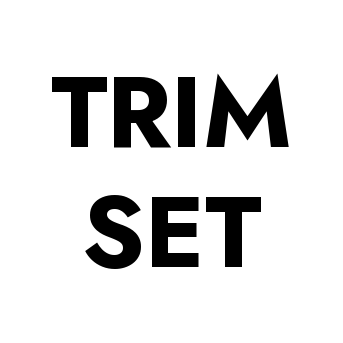
Documents/Labels/B2/Rotation_Joystick_0x28/BTN02_TRIM_SET.png
