bigJRo/KerbalControllerMk1/Documents/Labels/B2/Stability_Control_0x23/_layout_colour.png

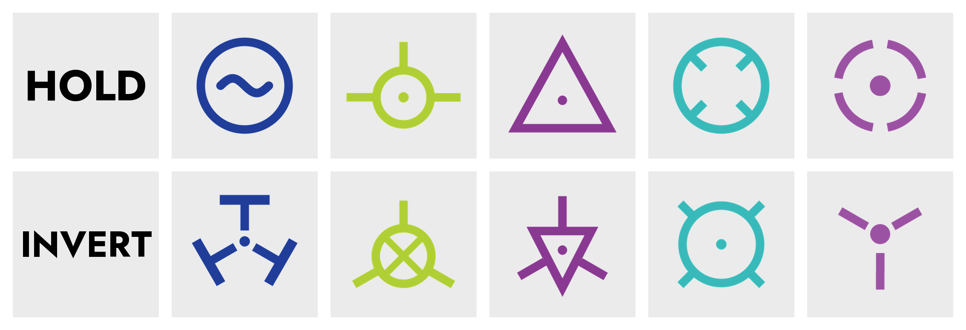
Documents/Labels/B2/Stability_Control_0x23/_layout_colour.png
