bigJRo/KerbalControllerMk1/Documents/Labels/B2/Stability_Control_0x23/black/B01_ANTI_TARGET.png

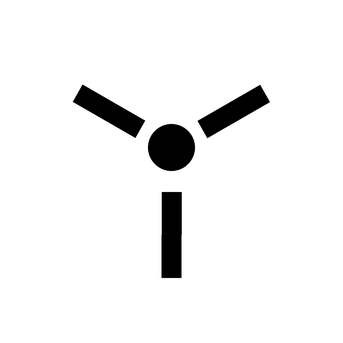
Documents/Labels/B2/Stability_Control_0x23/black/B01_ANTI_TARGET.png
