bigJRo/KerbalControllerMk1/Documents/Labels/B2/Stability_Control_0x23/black/B03_RADIAL_OUT.png

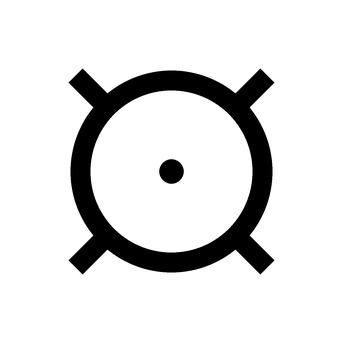
Documents/Labels/B2/Stability_Control_0x23/black/B03_RADIAL_OUT.png
