bigJRo/KerbalControllerMk1/Documents/Labels/B2/Stability_Control_0x23/black/B04_NORMAL.png

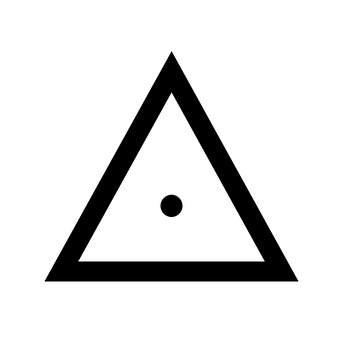
Documents/Labels/B2/Stability_Control_0x23/black/B04_NORMAL.png
