bigJRo/KerbalControllerMk1/Documents/Labels/B2/Time_Control_0x25/_layout.png

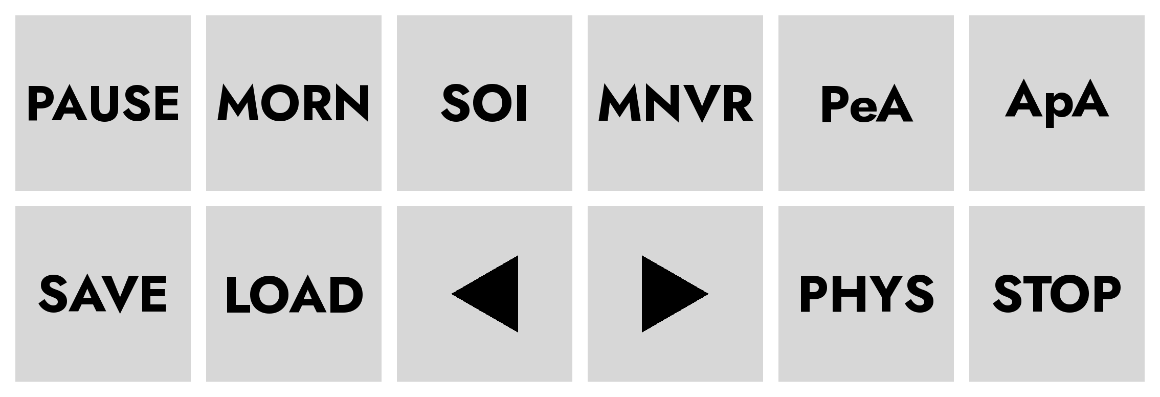
Documents/Labels/B2/Time_Control_0x25/_layout.png
