bigJRo/KerbalControllerMk1/Documents/Labels/B2/Time_Control_0x25/B05_FASTER.png

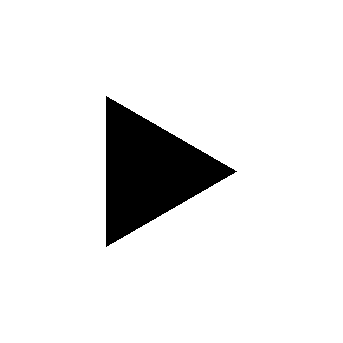
Documents/Labels/B2/Time_Control_0x25/B05_FASTER.png
