bigJRo/KerbalControllerMk1/Documents/Labels/B2/Time_Control_0x25/B10_PAUSE.png

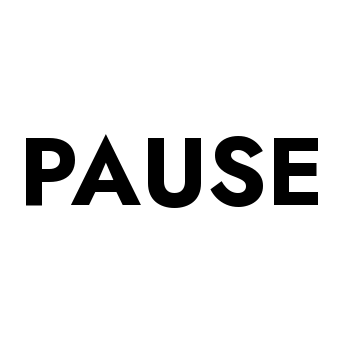
Documents/Labels/B2/Time_Control_0x25/B10_PAUSE.png
