bigJRo/KerbalControllerMk1/Documents/Labels/B2/Vehicle_Control_0x24/B04_FUEL_CELL.png

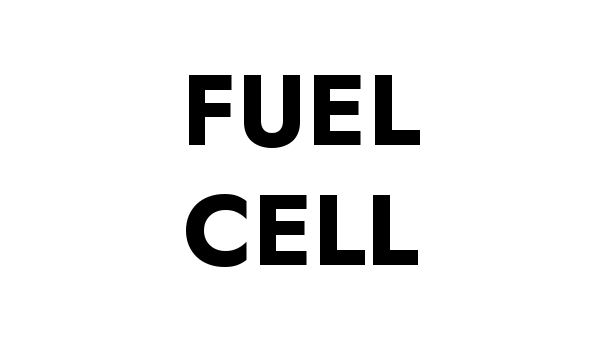
Documents/Labels/B2/Vehicle_Control_0x24/B04_FUEL_CELL.png
