bigJRo/KerbalControllerMk1/Documents/Labels/B2/Vehicle_Control_0x24/B05_SOLAR_ARRAY.png

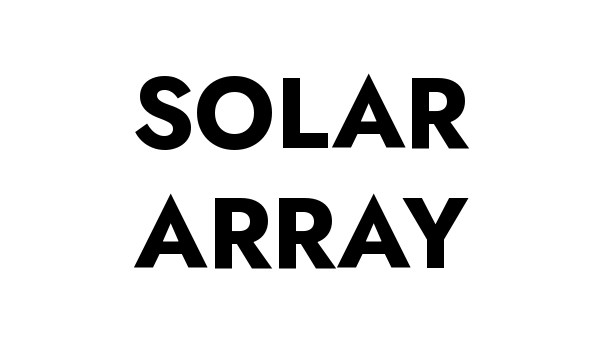
Documents/Labels/B2/Vehicle_Control_0x24/B05_SOLAR_ARRAY.png
