bigJRo/KerbalControllerMk1/Documents/Labels/B2/Vehicle_Control_0x24/B08_HEAT_SHIELD.png

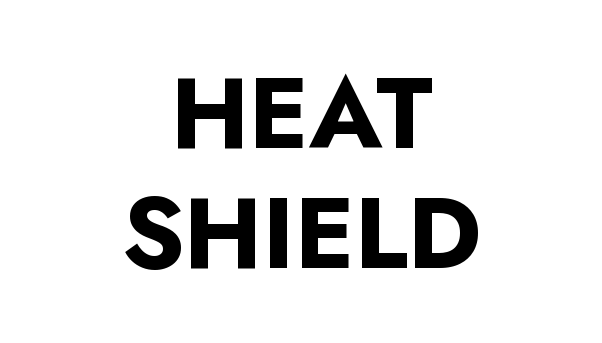
Documents/Labels/B2/Vehicle_Control_0x24/B08_HEAT_SHIELD.png
