bigJRo/KerbalControllerMk1/Documents/Labels/B2/Vehicle_Control_0x24/B10_MAIN.png

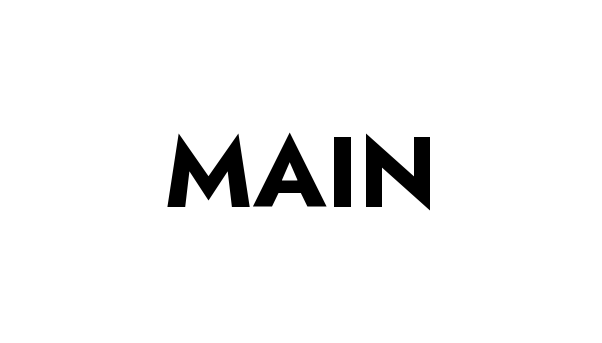
Documents/Labels/B2/Vehicle_Control_0x24/B10_MAIN.png
