bigJRo/KerbalControllerMk1/Documents/User/assets/Annunciator_MainOrbit.png

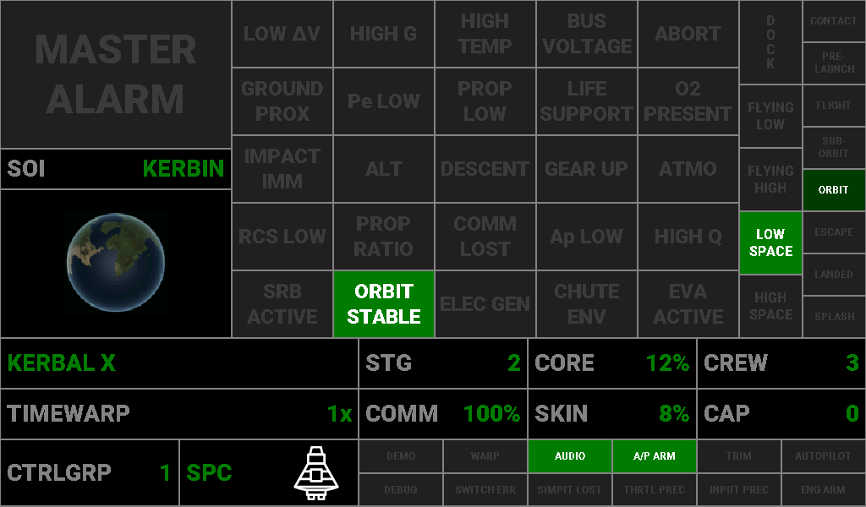
Documents/User/assets/Annunciator_MainOrbit.png
