bigJRo/KerbalControllerMk1/Documents/User/assets/Annunciator_MainReentry.png

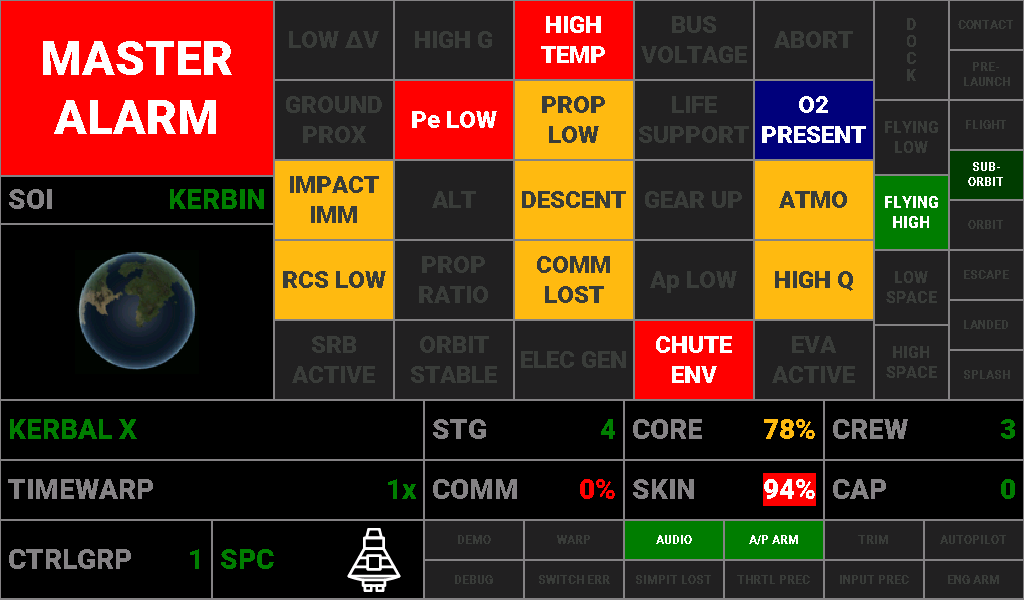
Documents/User/assets/Annunciator_MainReentry.png
