bigJRo/KerbalControllerMk1/Documents/User/assets/InfoDisp1_ACFT.png

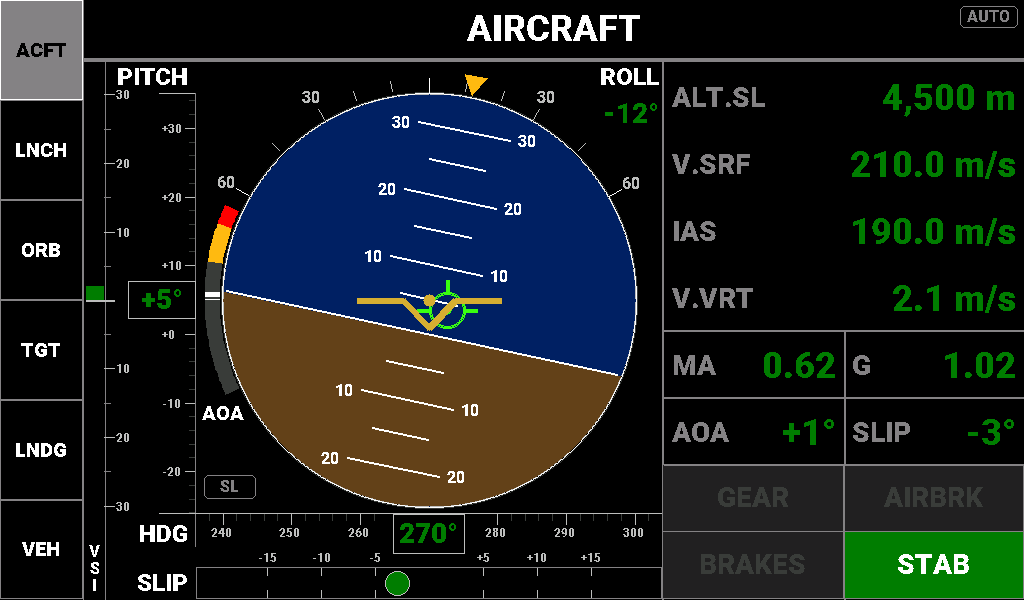
Documents/User/assets/InfoDisp1_ACFT.png
