bigJRo/KerbalControllerMk1/Documents/User/assets/InfoDisp1_ROVR.png

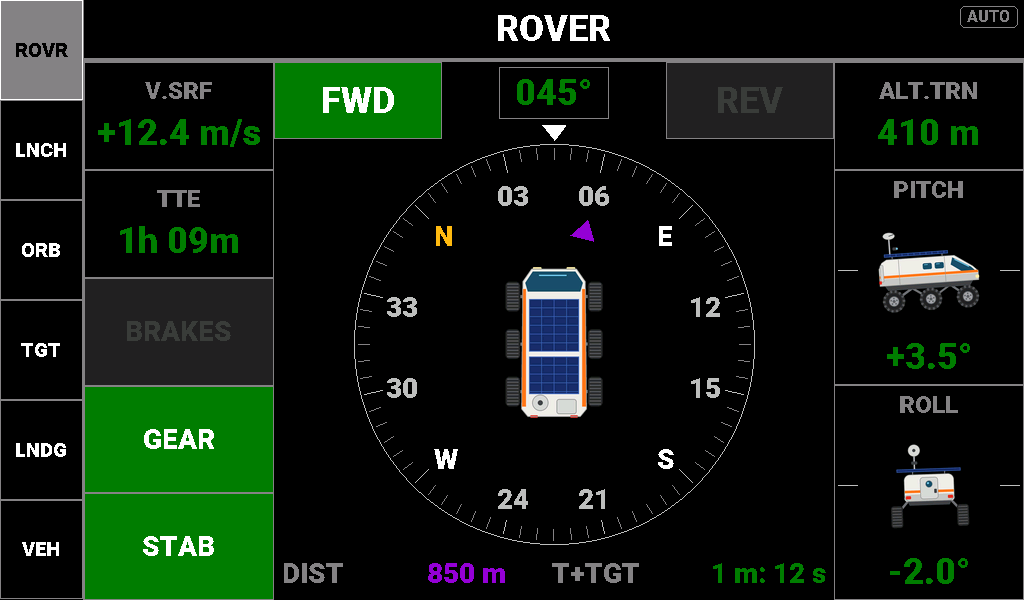
Documents/User/assets/InfoDisp1_ROVR.png
