bigJRo/KerbalControllerMk1/Documents/User/assets/InfoDisp2_ACFTAP.png

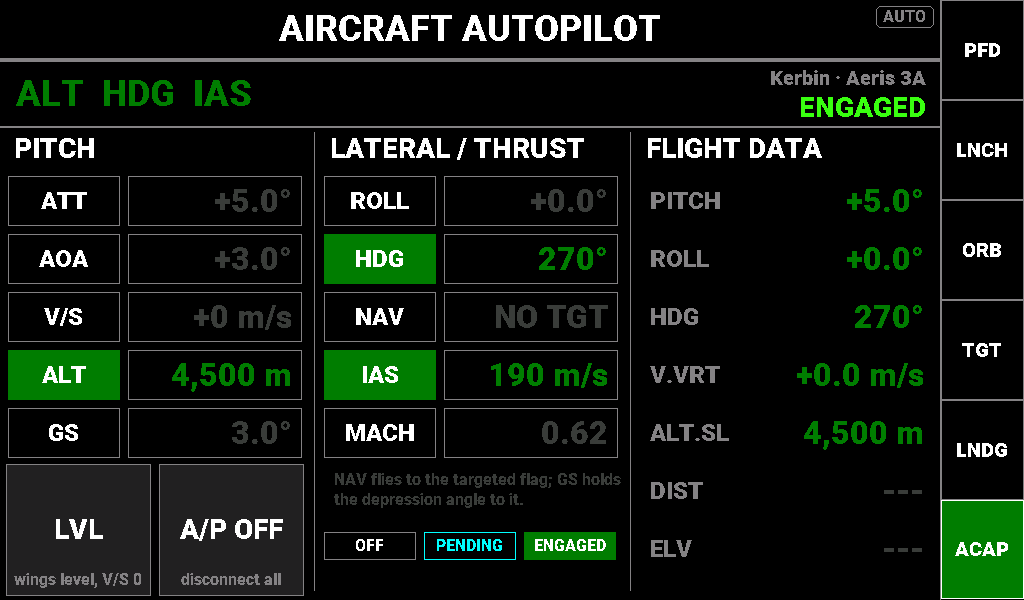
Documents/User/assets/InfoDisp2_ACFTAP.png
