bigJRo/KerbalControllerMk1/Documents/User/assets/InfoDisp2_DOCK.png

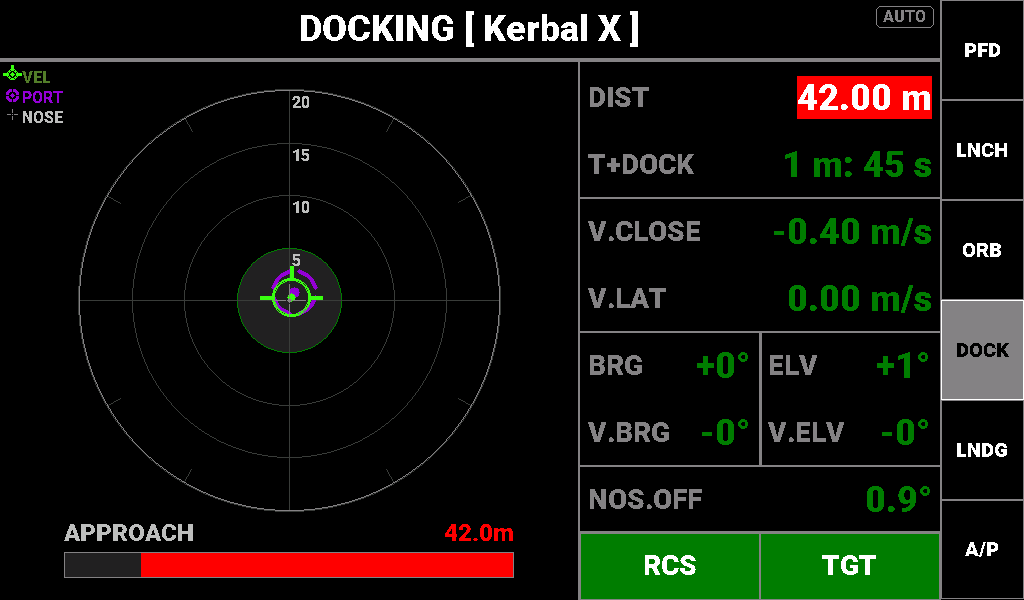
Documents/User/assets/InfoDisp2_DOCK.png
