bigJRo/KerbalControllerMk1/Documents/User/assets/InfoDisp2_LNCH.png

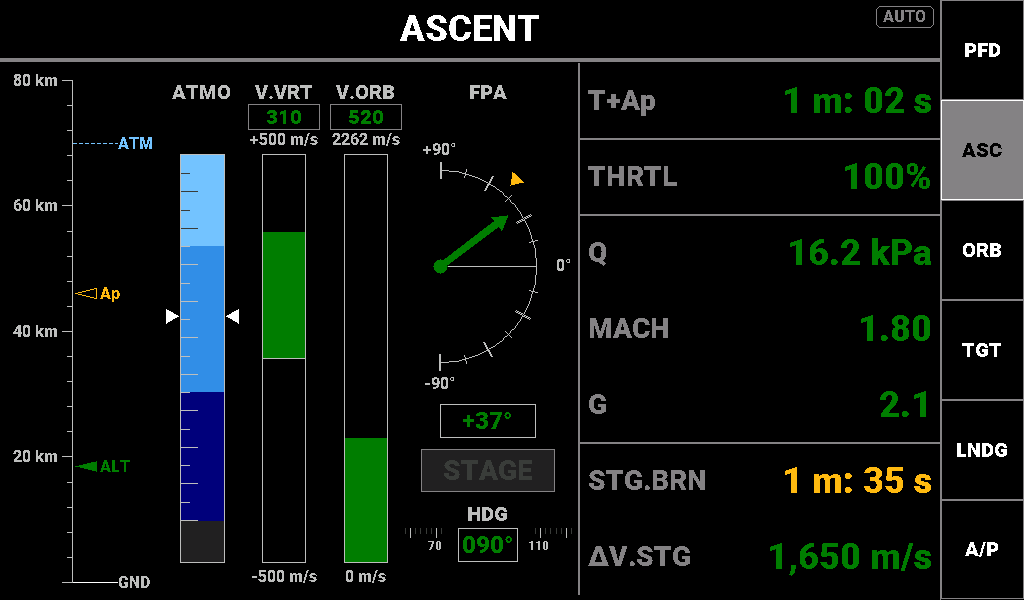
Documents/User/assets/InfoDisp2_LNCH.png
