bigJRo/KerbalControllerMk1/Documents/User/assets/InfoDisp2_LNCHAP.png

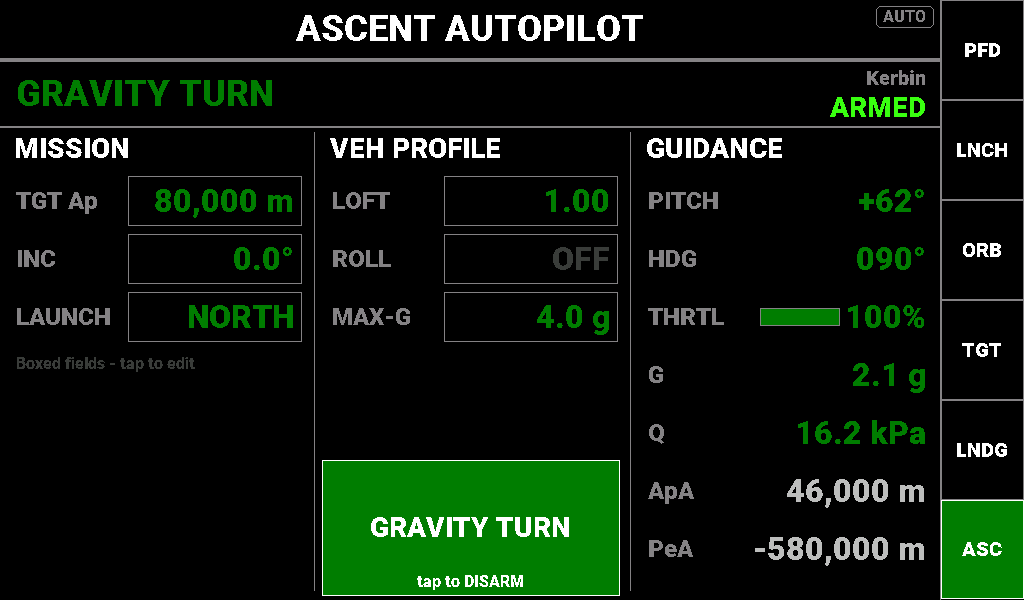
Documents/User/assets/InfoDisp2_LNCHAP.png
