bigJRo/KerbalControllerMk1/Documents/User/assets/InfoDisp2_LNCHPRE.png

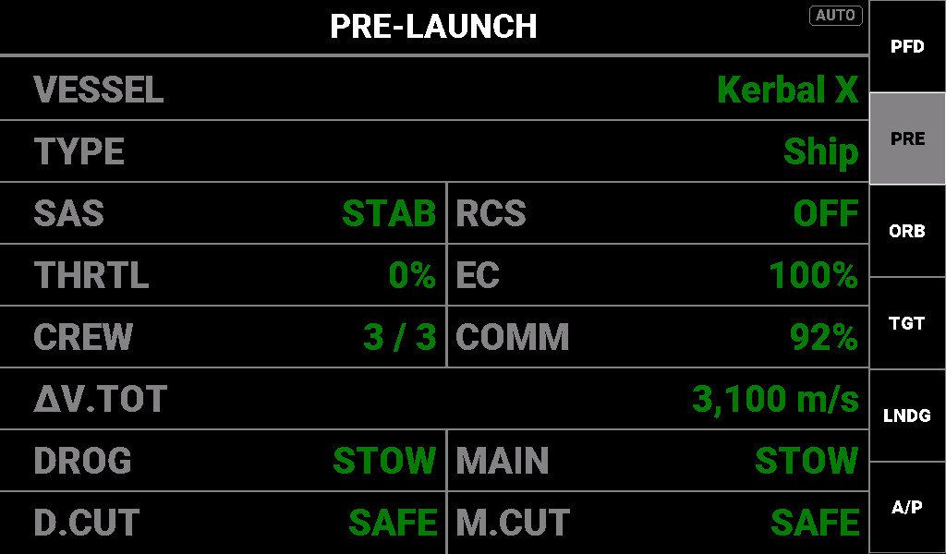
Documents/User/assets/InfoDisp2_LNCHPRE.png
