bigJRo/KerbalControllerMk1/Documents/User/assets/InfoDisp2_ORB.png

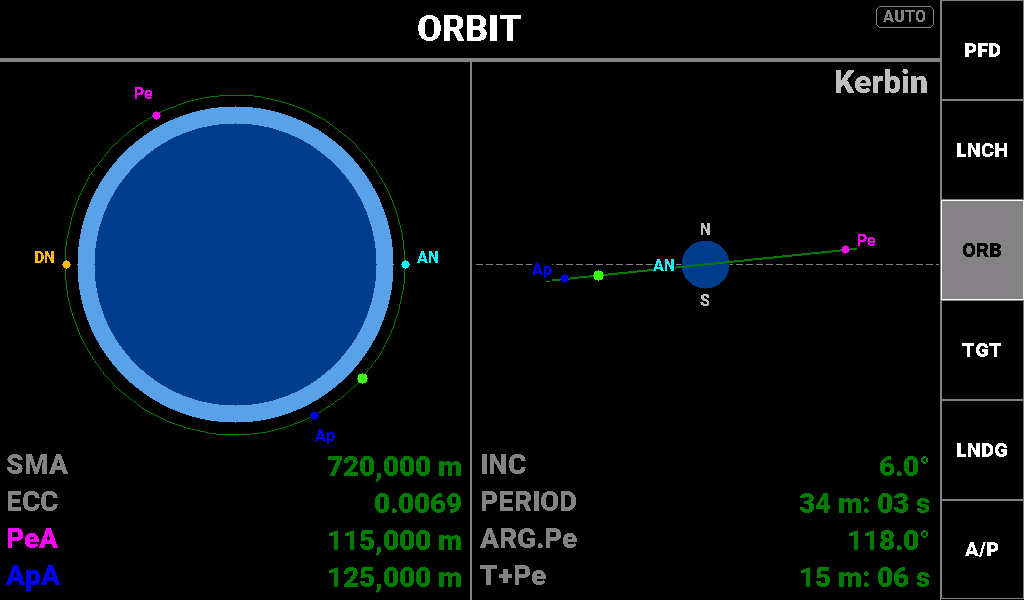
Documents/User/assets/InfoDisp2_ORB.png
