bigJRo/KerbalControllerMk1/Documents/User/assets/InfoDisp2_ROVRAP.png

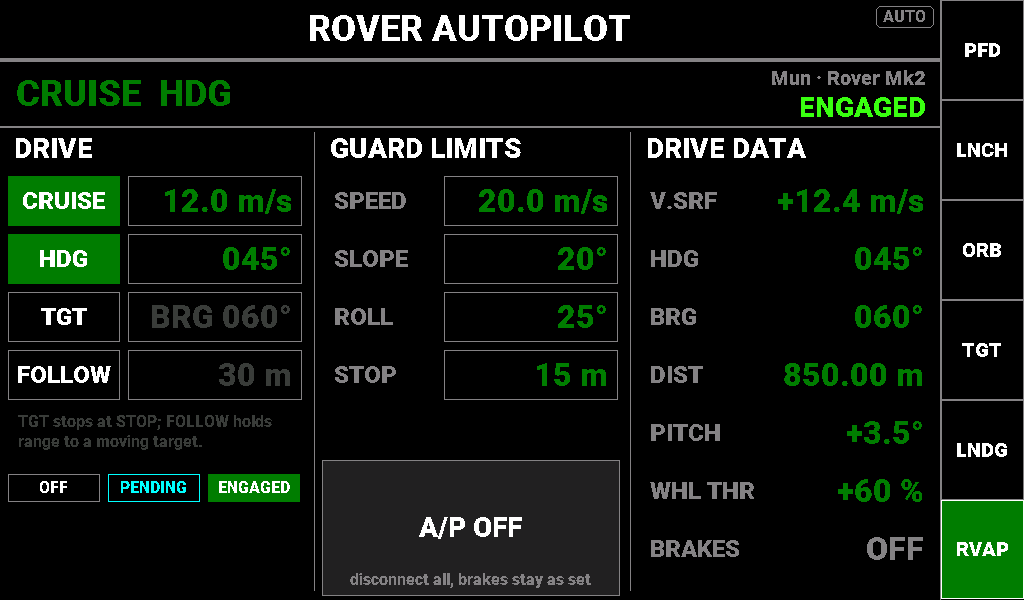
Documents/User/assets/InfoDisp2_ROVRAP.png
