bigJRo/KerbalControllerMk1/Documents/User/assets/InfoDisp2_TGT.png

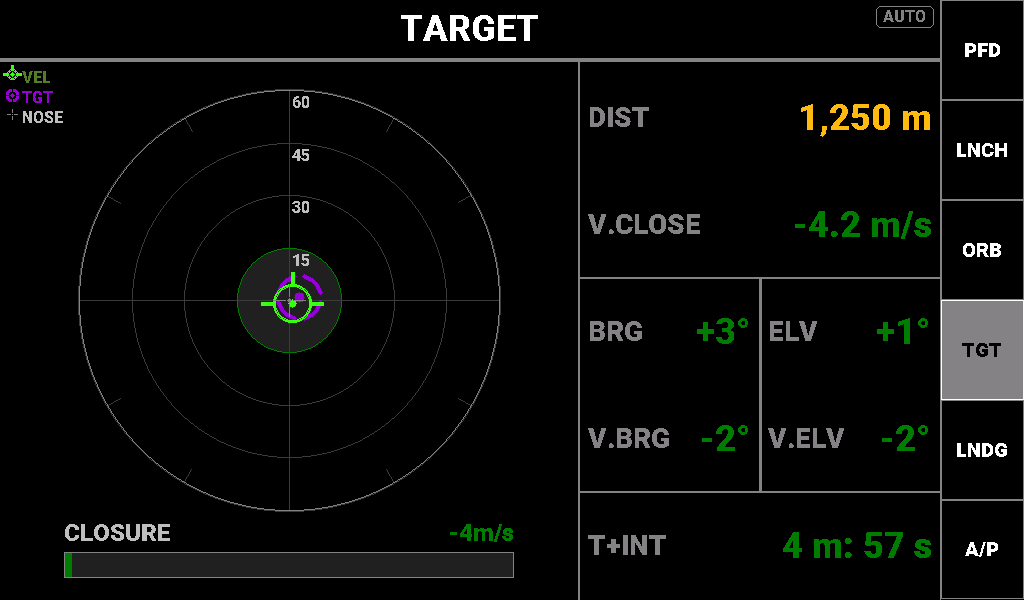
Documents/User/assets/InfoDisp2_TGT.png
