bigJRo/KerbalControllerMk1/Documents/User/assets/ResourceDisp_Detail.png

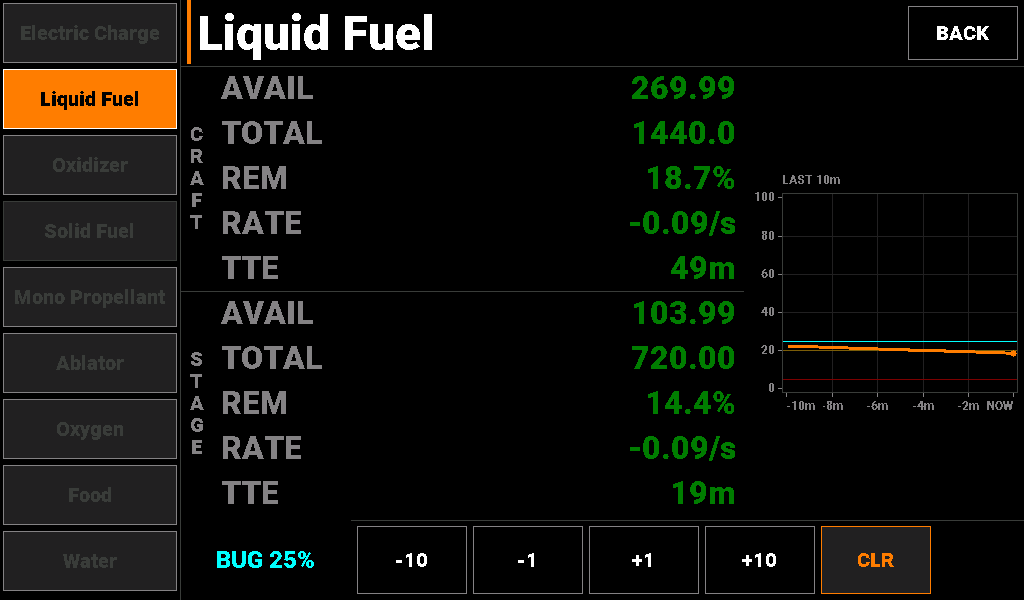
Documents/User/assets/ResourceDisp_Detail.png
