bigJRo/KerbalControllerMk1/Documents/User/assets/ResourceDisp_MainTTE.png

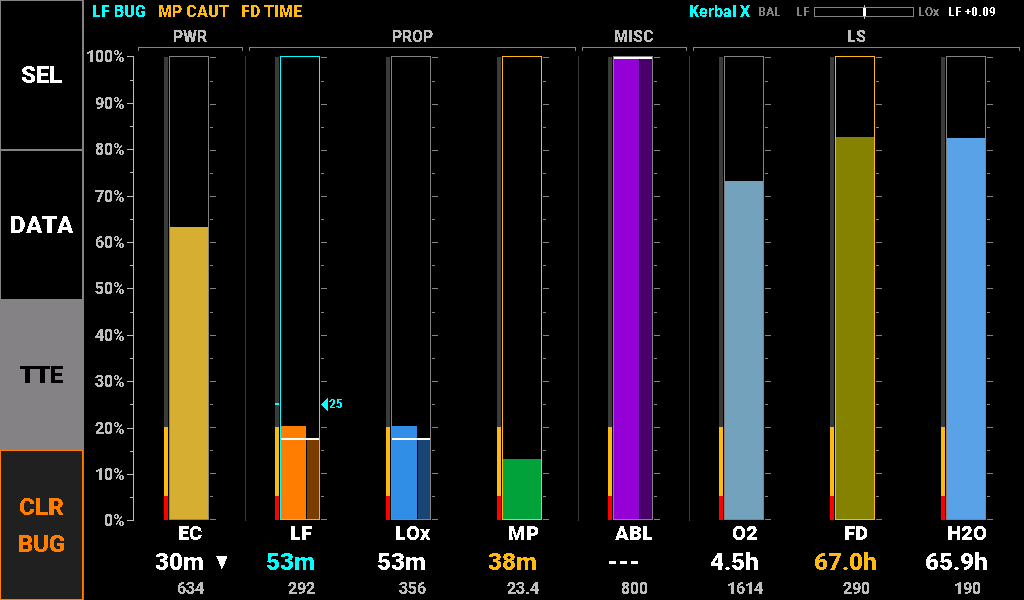
Documents/User/assets/ResourceDisp_MainTTE.png
