bigJRo/KerbalControllerMk1/Documents/User/assets/ResourceDisp_Select.png

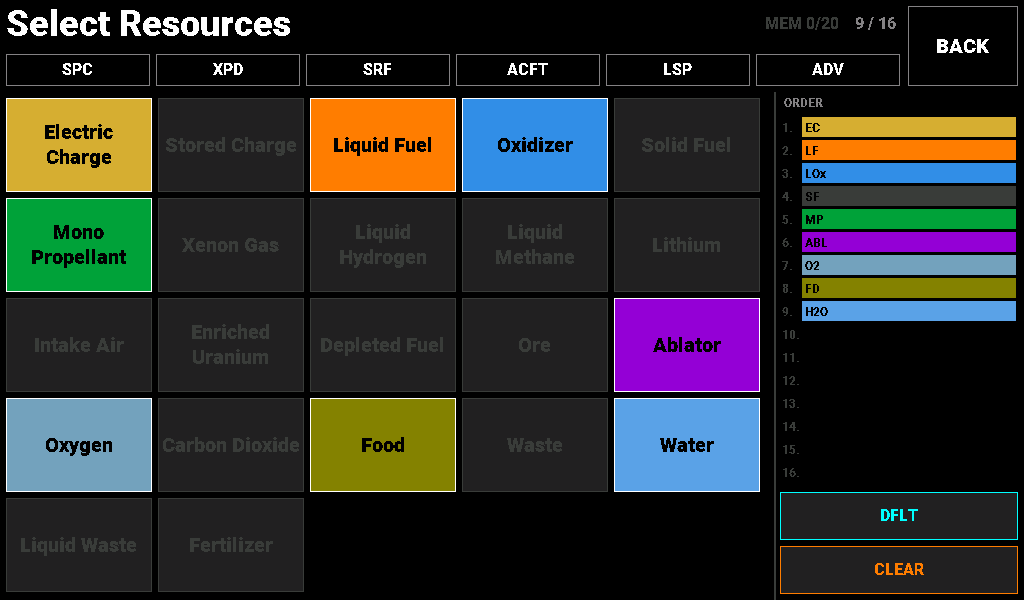
Documents/User/assets/ResourceDisp_Select.png
