bigJRo/KerbalControllerMk1/Documents/User/assets/sysinfo/SysInfo_BOOT_HUNG.png

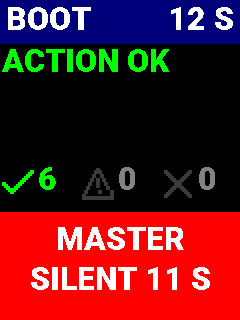
Documents/User/assets/sysinfo/SysInfo_BOOT_HUNG.png
