bigJRo/KerbalControllerMk1/Documents/User/assets/sysinfo/SysInfo_STATUS_FAULTS.png

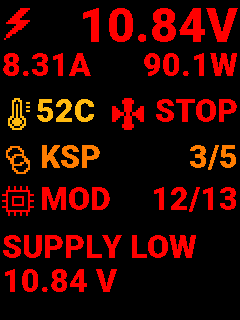
Documents/User/assets/sysinfo/SysInfo_STATUS_FAULTS.png
