bigJRo/KerbalControllerMk1/Documents/User/assets/sysinfo/SysInfo_STATUS_FAULTS_2.png

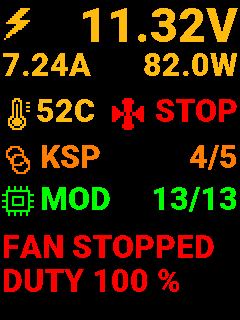
Documents/User/assets/sysinfo/SysInfo_STATUS_FAULTS_2.png
