bigJRo/KerbalControllerMk1/Software/Displays/assets/Bop-Display_236x164.bmp

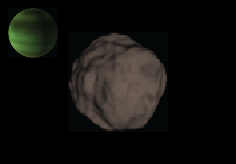
Software/Displays/assets/Bop-Display_236x164.bmp
