bigJRo/KerbalControllerMk1/Software/Displays/assets/Duna-Display_236x164.bmp

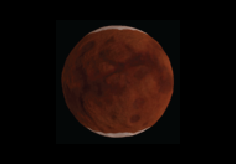
Software/Displays/assets/Duna-Display_236x164.bmp
