bigJRo/KerbalControllerMk1/Software/Displays/assets/Jool-Display_236x164.bmp

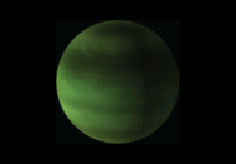
Software/Displays/assets/Jool-Display_236x164.bmp
