bigJRo/KerbalControllerMk1/Software/Displays/assets/KASA_Meatball_236x164.bmp

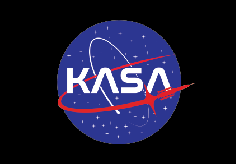
Software/Displays/assets/KASA_Meatball_236x164.bmp
