bigJRo/KerbalControllerMk1/Software/Displays/assets/KASA_Meatball_800x480.bmp

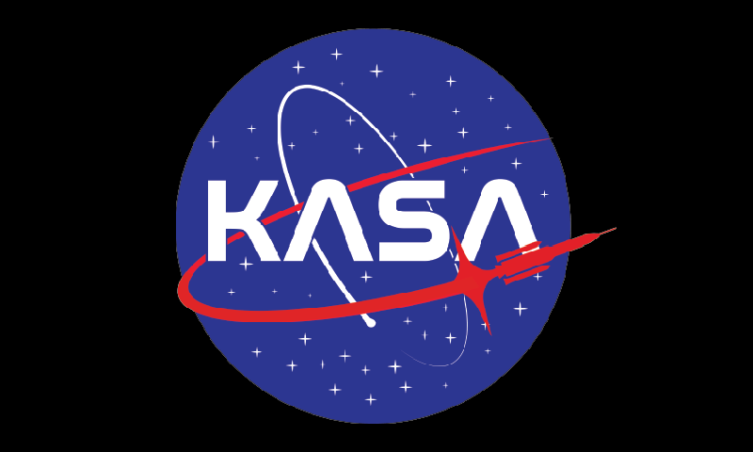
Software/Displays/assets/KASA_Meatball_800x480.bmp
