bigJRo/KerbalControllerMk1/Software/Displays/assets/KASA_Retro_800x480.bmp

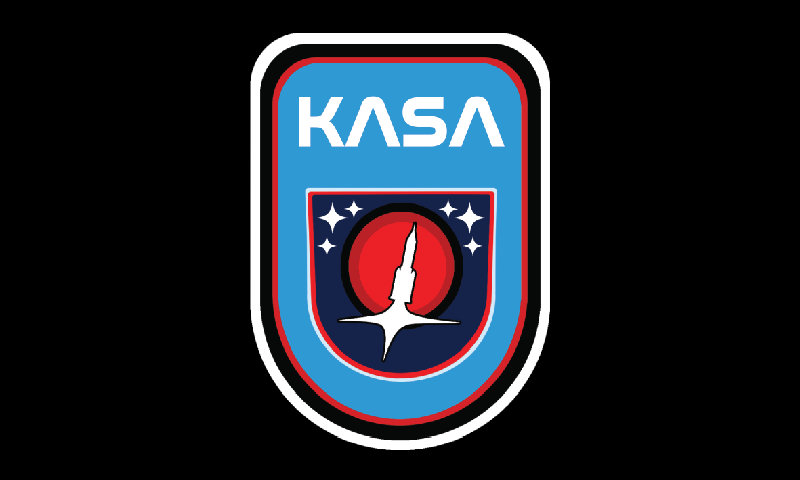
Software/Displays/assets/KASA_Retro_800x480.bmp
