bigJRo/KerbalControllerMk1/Software/Displays/assets/KASA_Worm_1024x600.bmp

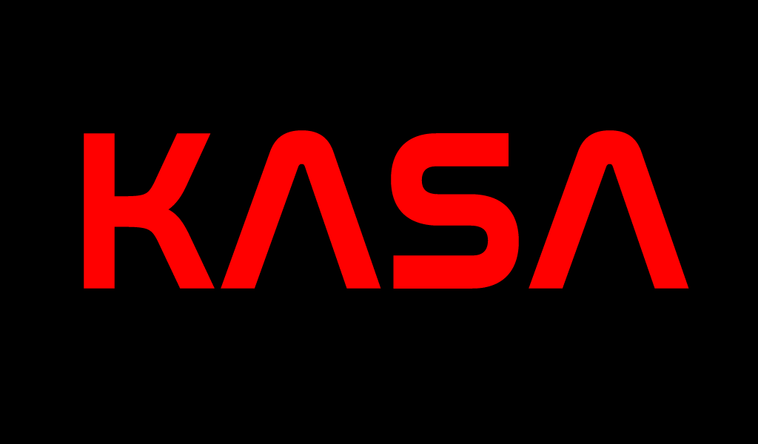
Software/Displays/assets/KASA_Worm_1024x600.bmp
