bigJRo/KerbalControllerMk1/Software/Displays/assets/Kerbin-Display_236x164.bmp

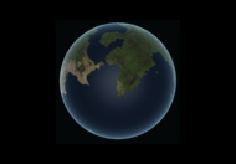
Software/Displays/assets/Kerbin-Display_236x164.bmp
