bigJRo/KerbalControllerMk1/Software/Displays/assets/Kerbol-Display_236x164.bmp

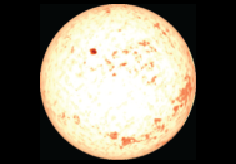
Software/Displays/assets/Kerbol-Display_236x164.bmp
