bigJRo/KerbalControllerMk1/Software/Displays/assets/Laythe-Display_236x164.bmp

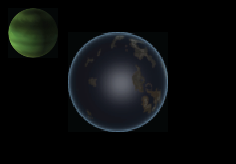
Software/Displays/assets/Laythe-Display_236x164.bmp
