bigJRo/KerbalControllerMk1/Software/Displays/assets/Rover/Pm02.bmp

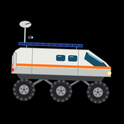
Software/Displays/assets/Rover/Pm02.bmp
