bigJRo/KerbalControllerMk1/Software/Displays/assets/Rover/Pm07.bmp

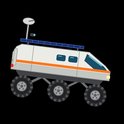
Software/Displays/assets/Rover/Pm07.bmp
