bigJRo/KerbalControllerMk1/Software/Displays/assets/Rover/Pm15.bmp

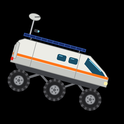
Software/Displays/assets/Rover/Pm15.bmp
