bigJRo/KerbalControllerMk1/Software/Displays/assets/Rover/Pm21.bmp

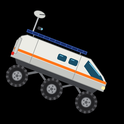
Software/Displays/assets/Rover/Pm21.bmp
