bigJRo/KerbalControllerMk1/Software/Displays/assets/Rover/Pm25.bmp

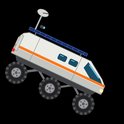
Software/Displays/assets/Rover/Pm25.bmp
