bigJRo/KerbalControllerMk1/Software/Displays/assets/Rover/Pm35.bmp

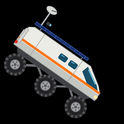
Software/Displays/assets/Rover/Pm35.bmp
