bigJRo/KerbalControllerMk1/Software/Displays/assets/Rover/Pm45.bmp

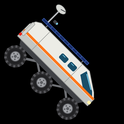
Software/Displays/assets/Rover/Pm45.bmp
