bigJRo/KerbalControllerMk1/Software/Displays/assets/Rover/Pp02.bmp

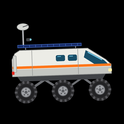
Software/Displays/assets/Rover/Pp02.bmp
