bigJRo/KerbalControllerMk1/Software/Displays/assets/Rover/Pp08.bmp

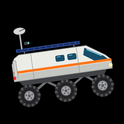
Software/Displays/assets/Rover/Pp08.bmp
