bigJRo/KerbalControllerMk1/Software/Displays/assets/Rover/Pp13.bmp

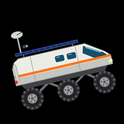
Software/Displays/assets/Rover/Pp13.bmp
