bigJRo/KerbalControllerMk1/Software/Displays/assets/Rover/Pp21.bmp

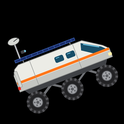
Software/Displays/assets/Rover/Pp21.bmp
