bigJRo/KerbalControllerMk1/Software/Displays/assets/Rover/Pp33.bmp

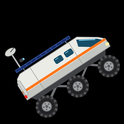
Software/Displays/assets/Rover/Pp33.bmp
