bigJRo/KerbalControllerMk1/Software/Displays/assets/Rover/Pp39.bmp

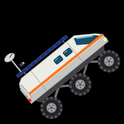
Software/Displays/assets/Rover/Pp39.bmp
