bigJRo/KerbalControllerMk1/Software/Displays/assets/Rover/Rm02.bmp

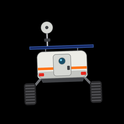
Software/Displays/assets/Rover/Rm02.bmp
