bigJRo/KerbalControllerMk1/Software/Displays/assets/Rover/Rm14.bmp

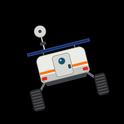
Software/Displays/assets/Rover/Rm14.bmp
