bigJRo/KerbalControllerMk1/Software/Displays/assets/Rover/Rm35.bmp

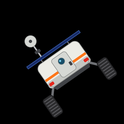
Software/Displays/assets/Rover/Rm35.bmp
