bigJRo/KerbalControllerMk1/Software/Displays/assets/Rover/Rm42.bmp

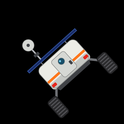
Software/Displays/assets/Rover/Rm42.bmp
