bigJRo/KerbalControllerMk1/Software/Displays/assets/Rover/Rp01.bmp

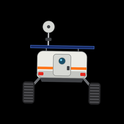
Software/Displays/assets/Rover/Rp01.bmp
