bigJRo/KerbalControllerMk1/Software/Displays/assets/Rover/Rp10.bmp

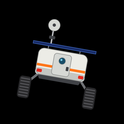
Software/Displays/assets/Rover/Rp10.bmp
