bigJRo/KerbalControllerMk1/Software/Displays/assets/Rover/Rp14.bmp

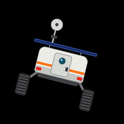
Software/Displays/assets/Rover/Rp14.bmp
