bigJRo/KerbalControllerMk1/Software/Displays/assets/Rover/Rp28.bmp

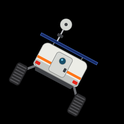
Software/Displays/assets/Rover/Rp28.bmp
