bigJRo/KerbalControllerMk1/Software/Displays/assets/Rover/Rp35.bmp

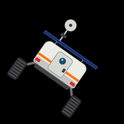
Software/Displays/assets/Rover/Rp35.bmp
