bigJRo/KerbalControllerMk1/Software/Displays/SD_Cards/KCMk1_Annunciator/Eve-Display_236x164.bmp

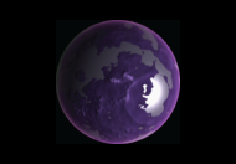
Software/Displays/SD_Cards/KCMk1_Annunciator/Eve-Display_236x164.bmp
