bigJRo/KerbalControllerMk1/Software/Displays/SD_Cards/KCMk1_InfoDisp/Rover/Pm40.bmp

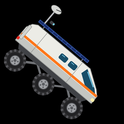
Software/Displays/SD_Cards/KCMk1_InfoDisp/Rover/Pm40.bmp
