bigJRo/KerbalControllerMk1/Software/Displays/SD_Cards/KCMk1_InfoDisp/Rover/Pp27.bmp

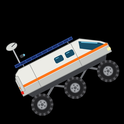
Software/Displays/SD_Cards/KCMk1_InfoDisp/Rover/Pp27.bmp
