bigJRo/KerbalControllerMk1/Software/Displays/SD_Cards/KCMk1_InfoDisp/Rover/Rm05.bmp

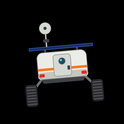
Software/Displays/SD_Cards/KCMk1_InfoDisp/Rover/Rm05.bmp
