bigJRo/KerbalControllerMk1/Software/Displays/SD_Cards/KCMk1_InfoDisp/Rover/Rm10.bmp

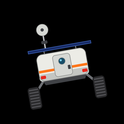
Software/Displays/SD_Cards/KCMk1_InfoDisp/Rover/Rm10.bmp
