bigJRo/KerbalControllerMk1/Software/Displays/SD_Cards/KCMk1_InfoDisp/Rover/Rm21.bmp

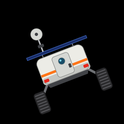
Software/Displays/SD_Cards/KCMk1_InfoDisp/Rover/Rm21.bmp
