bigJRo/KerbalControllerMk1/Software/Displays/SD_Cards/KCMk1_InfoDisp/Rover/Rp43.bmp

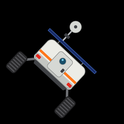
Software/Displays/SD_Cards/KCMk1_InfoDisp/Rover/Rp43.bmp
