bigJRo/KerbalControllerMk1/Documents/Drawings/KC-01-1703_V2.0_Control Module_BOM.pdf

DWG No: | KC-01-1703
Revision: | V2.0
Drawn: | J. Rostoker | 6/20/2026
Approved: | J. Kerman | 6/20/2026
Issued: | 6/20/2026
Status: | RELEASED
Doc Type: | CCA Parts List
No. | Designator | Footprint | Quantity | Manufacturer Part | Manufacturer | Supplier | Supplier Part | Value | JLCPCB Part Class | Primary Category | Secondary Category
1 | C1 | C0805 | 1 | CL21B475KAFNNNE | SAMSUNG(三星) | LCSC | C98195 | 4.7uF | Extended Part | Capacitors | Multilayer Ceramic Capacitors MLCC - SMD/SMT
2 | C2 | C0805 | 1 | CL21B106KAYQNNE | SAMSUNG(三星) | LCSC | C3039694 | 10uF | Extended Part | Capacitors | Multilayer Ceramic Capacitors MLCC - SMD/SMT
3 | C3,C5,C18,C21 | C0402 | 4 | CL05A105KA5NQNC | SAMSUNG(三星) | LCSC | C52923 | 1uF | Basic Part | Capacitors | Multilayer Ceramic Capacitors MLCC - SMD/SMT
4 | C4,C11,C15,C20,C23 | C0402 | 5 | CL05B104KO5NNNC | SAMSUNG(三星) | LCSC | C1525 | 100nF | Basic Part | Capacitors | Multilayer Ceramic Capacitors MLCC - SMD/SMT
5 | C6 | CAP-SMD_BD6.3-L6.6-W6.6-LS7.2-R-RD | 1 | RVT1E101M0607 | HONOR(荣誉) | LCSC | C3338 | 100uF | Extended Part | Capacitors | Aluminum Electrolytic Capacitors - SMD
6 | C7,C8,C13 | C0603 | 3 | CC0603KRX7R9BB104 | YAGEO(国巨) | LCSC | C14663 | 100nF | Basic Part | Capacitors | Multilayer Ceramic Capacitors MLCC - SMD/SMT
7 | C9 | C0805 | 1 | CL21A106KAYNNNE | SAMSUNG(三星) | LCSC | C15850 | 10uF | Basic Part | Capacitors | Multilayer Ceramic Capacitors MLCC - SMD/SMT
8 | C10 | C0603 | 1 | CL10A105KB8NNNC | SAMSUNG(三星) | LCSC | C15849 | 1uF | Basic Part | Capacitors | Multilayer Ceramic Capacitors MLCC - SMD/SMT
9 | C12,C14,C19,C22 | C0603 | 4 | CL10A106KP8NNNC | SAMSUNG(三星) | LCSC | C19702 | 10uF | Basic Part | Capacitors | Multilayer Ceramic Capacitors MLCC - SMD/SMT
10 | C16,C17 | C0402 | 2 | CL05B103KB5NNNC | SAMSUNG(三星) | LCSC | C15195 | 10nF | Basic Part | Capacitors | Multilayer Ceramic Capacitors MLCC - SMD/SMT
11 | CN1 | CONN-TH_4P-P2.54_HF1004E | 1 | HF1004E | FOXCONN(富士康) | LCSC | C2761402 | | Extended Part | Connectors | Wire To Board Connector
12 | CN2 | CONN-TH_50P-P2.54_LX_XDFH-0254-2X25P | 1 | XDFH-0254-2*25P | LX(连欣科技) | LCSC | C19193816 | | Extended Part | Connectors | IDC Connectors
13 | CN3,CN4 | IDC-TH_34P-P2.54_BOOMELE-2X17P | 2 | 2.54-2*17P直简牛 | BOOMELE(博穆精密) | LCSC | C20920 | | Extended Part | Connectors | IDC Connectors
14 | D1 | SOD-323_L1.8-W1.3-LS2.5-RD | 1 | 1N4148WS | CJ(江苏长电/长晶) | LCSC | C2128 | | Basic Part | Diodes | Switching Diodes
15 | DC1 | DC-IN-TH_DC-042C-Z-2.5-A | 1 | DC-042Z-10A-2.5 | XKB Connection(中国星坤) | LCSC | C706901 | | Extended Part | Connectors | DC Power Connectors
16 | H1 | HDR-TH_4P-P2.54-V-M-R2-C2-S2.54 | 1 | PZ254V-12-4P | XFCN(兴飞) | LCSC | C492419 | | Extended Part | Connectors | Pin Headers
17 | H2,H3 | HDR-TH_24P-P2.54-V-F | 2 | X6511FV-24-C85D32 | XKB Connectivity(中国星坤) | LCSC | C2883741 | | Extended Part | Connectors | Female Headers
18 | H4 | HDR-TH_2P-P2.54-V-M-1 | 1 | | | | | | | Connectors | Pin Headers
19 | LED1 | LED0805-R-RD | 1 | KT-0805G | KENTO | LCSC | C2297 | | Basic Part | Optoelectronics | LED Indication - Discrete
20 | LED2 | LED-SMD_L1.6-W0.8-R-RD | 1 | KT-0603R | KENTO | LCSC | C2286 | | Basic Part | Optoelectronics | LED Indication - Discrete
21 | LED3 | LED0805-R-RD | 1 | KT-0805Y | KENTO | LCSC | C2296 | | Basic Part | Optoelectronics | LED Indication - Discrete
22 | Q1 | TO-263-2_L10.0-W9.1-P5.08-LS15.2-TL | 1 | IRF9540NSTRLPBF | Infineon(英飞凌) | LCSC | C33903 | | Extended Part | Transistors/Thyristors | MOSFETs
23 | Q2 | SOT-23-3_L2.9-W1.3-P1.90-LS2.4-BR | 1 | AO3400A | AOS | LCSC | C20917 | | Basic Part | Transistors/Thyristors | MOSFETs
24 | R1 | R0402 | 1 | 0402WGF1003TCE | UNI-ROYAL(厚声) | LCSC | C25741 | 100kΩ | Basic Part | Resistors | Chip Resistor - Surface Mount
25 | R2 | R0402 | 1 | FRC0402F1912TS | FOJAN(富捷) | LCSC | C2998158 | 19.1k Ω | Extended Part | Resistors | Chip Resistor - Surface Mount
26 | R3 | R2512 | 1 | HoYLR2512-3W-15mR-1% | Milliohm(毫欧) | LCSC | C5375466 | 15mΩ | Extended Part | Resistors | Current Sense Resistors / Shunt Resistors
27 | R4 | R0603 | 1 | 0603WAF1002T5E | UNI-ROYAL(厚声) | LCSC | C25804 | 10kΩ | Basic Part | Resistors | Chip Resistor - Surface Mount
28 | R5,R8 | R0603 | 2 | 0603WAF1003T5E | UNI-ROYAL(厚声) | LCSC | C25803 | 100kΩ | Basic Part | Resistors | Chip Resistor - Surface Mount
29 | R6,R9 | R0603 | 2 | 0603WAF2001T5E | UNI-ROYAL(厚声) | LCSC | C22975 | 2kΩ | Basic Part | Resistors | Chip Resistor - Surface Mount
30 | R7 | R0603 | 1 | 0603WAF2700T5E | UNI-ROYAL(厚声) | LCSC | C22966 | 270Ω | Basic Part | Resistors | Chip Resistor - Surface Mount
31 | R10 | R0603 | 1 | 0603WAF3003T5E | UNI-ROYAL(厚声) | LCSC | C23024 | 300kΩ | Basic Part | Resistors | Chip Resistor - Surface Mount
32 | R11,R12,R20,R21,R22,R23 | R0402 | 6 | 0402WGF1002TCE | UNI-ROYAL(厚声) | LCSC | C25744 | 10kΩ | Basic Part | Resistors | Chip Resistor - Surface Mount
33 | R13,R15 | R0603 | 2 | 0603WAF470JT5E | UNI-ROYAL(厚声) | LCSC | C23182 | 47Ω | Basic Part | Resistors | Chip Resistor - Surface Mount
34 | R14,R16,R17,R18,R19 | R0402 | 5 | 0402WGF4701TCE | UNI-ROYAL(厚声) | LCSC | C25900 | 4.7kΩ | Basic Part | Resistors | Chip Resistor - Surface Mount
35 | R24,R25 | R0402 | 2 | 0402WGF5101TCE | UNI-ROYAL(厚声) | LCSC | C25905 | 5.1kΩ | Basic Part | Resistors | Chip Resistor - Surface Mount
36 | TP1 | HDR-TH_3P-P2.54-V-M | 1 | | | | | | | Connectors | Pin Headers
37 | U1 | QFN-20_L5.0-W3.0-TL-MPM3610GQV-Z | 1 | MPM3610GQV-Z | MPS(芯源) | LCSC | C5183856 | | Extended Part | Power Modules | DC-DC Power Modules
38 | U2 | SOT-25-5_L2.9-W1.6-P0.95-LS2.8-BL | 1 | AP2112K-3.3TRG1 | DIODES(美台) | LCSC | C51118 | | Extended Part | Power Management (PMIC) | Voltage Regulators - Linear, Low Drop Out (LDO) Regulators
39 | U3 | VSSOP-10_L3.0-W3.0-P0.50-LS4.9-BL | 1 | INA228AIDGSR | TI(德州仪器) | LCSC | C2887910 | | Extended Part | Amplifiers/Comparators | Current Sense Amplifiers
40 | U5 | MSOP-8_L3.0-W3.0-P0.65-LS4.9-BL | 1 | EMC2101-R-ACZL-TR | MICROCHIP(美国微芯) | LCSC | C626968 | | Extended Part | Sensors | Temperature Sensors
41 | U6,U7 | SC-70-6_L2.1-W1.3-P0.65-LS2.1-BR | 2 | LTC4311CSC6#TRPBF | ADI(亚德诺) | LCSC | C580856 | | Extended Part | Interface | Signal Buffers, Repeaters, Splitters
42 | U8,U9 | QFN-24_L4.0-W4.0-P0.50-BL-EP2.8 | 2 | CH334F | WCH(南京沁恒) | LCSC | C5187527 | | Extended Part | Interface | USB HUB Controllers
43 | USB1,USB2,USB3,USB4,USB 5,USB6 | MICRO-USB-SMD_MICROXNJ_1 | 6 | MicroXNJ | SHOU HAN(首韩) | LCSC | C404969 | | Extended Part | Connectors | USB Connectors
44 | USBC1,USBC2 | USB-C_SMD-TYPE-C-31-M-12_1 | 2 | TYPE-C-31-M-12 | 韩国韩荣 | LCSC | C165948 | | Extended Part | Connectors | USB Connectors

45 | X1,X2 | CRYSTAL-SMD_4P-L3.2-W2.5-BL
2 | X322512MSB4SI | YXC(扬兴晶振
) | LCSC | C9002
12MH z | Basic Part | Crystals, Oscillators, Resonators | Crystals
