bigJRo/KerbalControllerMk1/Documents/Drawings/KC-01-1713_V2.0_Control Module Extension_BOM.pdf

DWG No: | KC-01-1713
Revision: | V2.0
Drawn: | J. Rostoker | 6/20/2026
Approved: | J. Kerman | 6/20/2026
Issued: | 6/20/2026
Status: | RELEASED
Doc Type: | CCA Parts List
No. | Designator | Footprint | Quantity | Manufacturer Part | Manufacturer | Supplier | Supplier Part | Value | JLCPCB Part Class | Primary Category | Secondary Category
1 | CN1 | CONN-TH_50P-P2.54_LX_XDFH-0254-2X25P | 1 | XDFH-0254-2*25P | LX(连欣科技) | LCSC | C19193816 | | Extended Part | Connectors | IDC Connectors
2 | CN2 | CONN-TH_10P-P3.81_DB125-3.81-10P-GN-S | 1 | DB125-3.81-10P-GN-S | DORABO(地博电气) | LCSC | C5137189 | | Extended Part | Connectors | Screw Terminal Blocks
3 | CN3 | CONN-TH_4P-P2.54_HF1004E | 1 | HF1004E | FOXCONN(富士康) | LCSC | C2761402 | | Extended Part | Connectors | Wire To Board Connector
4 | CN4,CN5 | IDC-TH_34P-P2.54_BOOMELE-2X17P | 2 | 2.54-2*17P直简牛 | BOOMELE(博穆精密) | LCSC | C20920 | | Extended Part | Connectors | IDC Connectors
