bigJRo/KerbalControllerMk1/Documents/Drawings/KC-01-1733_V2.0_Panel Hub_BOM.pdf

DWG No: | KC-01-11733
Revision: | V2.0
Drawn: | J. Rostoker | 6/13/2026
Approved: | J. Kerman | 6/13/2026
Issued: | 6/13/2026
Status: | RELEASED
Doc Type: | CCA Parts List
No. | Designator | Footprint | Quantity | Manufacturer Part | Manufacturer | Supplier | Supplier Part | Value | JLCPCB Part Class | Primary Category | Secondary Category
1 | C1 | C0805 | 1 | CL21B475KAFNNNE | SAMSUNG(三星) | LCSC | C98195 | 4.7uF | Extended Part | Capacitors | Multilayer Ceramic Capacitors MLCC - SMD/SMT
2 | C2 | C0805 | 1 | CL21B106KAYQNNE | SAMSUNG(三星) | LCSC | C3039694 | 10uF | Extended Part | Capacitors | Multilayer Ceramic Capacitors MLCC - SMD/SMT
3 | C3,C5 | C0402 | 2 | CL05A105KA5NQNC | SAMSUNG(三星) | LCSC | C52923 | 1uF | Basic Part | Capacitors | Multilayer Ceramic Capacitors MLCC - SMD/SMT
4 | C4 | C0402 | 1 | CL05B104KO5NNNC | SAMSUNG(三星) | LCSC | C1525 | 100nF | Basic Part | Capacitors | Multilayer Ceramic Capacitors MLCC - SMD/SMT
5 | CN1 | IDC-TH_34P-P2.54_BOOMELE-2X17P | 1 | 2.54-2*17P直简牛 | BOOMELE(博穆精密) | LCSC | C20920 | | Extended Part | Connectors | IDC Connectors
6 | P1,P2,P3,P4,P5,P6,P7,P8 | IDC-TH_16P-P2.54_C3406 | 8 | 2.54-2*8P简牛 | BOOMELE(博穆精密) | LCSC | C3406 | | Extended Part | Connectors | IDC Connectors
7 | R1 | R0402 | 1 | 0402WGF1003TCE | UNI-ROYAL(厚声) | LCSC | C25741 | 100kΩ | Basic Part | Resistors | Chip Resistor - Surface Mount
8 | R2 | R0402 | 1 | FRC0402F1912TS | FOJAN(富捷) | LCSC | C2998158 | 19.1kΩ Extended Part | | Resistors | Chip Resistor - Surface Mount
9 | R3 | R0402 | 1 | 0402WGF1002TCE | UNI-ROYAL(厚声) | LCSC | C25744 | 10kΩ | Basic Part | Resistors | Chip Resistor - Surface Mount
10 | R4 | R0402 | 1 | 0402WGF2002TCE | UNI-ROYAL(厚声) | LCSC | C25765 | 20kΩ | Basic Part | Resistors | Chip Resistor - Surface Mount
11 | U1 | QFN-20_L5.0-W3.0-TL-MPM3610GQV-Z | 1 | MPM3610GQV-Z | MPS(芯源) | LCSC | C5183856 | | Extended Part | Power Modules | DC-DC Power Modules
12 | U2 | SOT-25-5_L2.9-W1.6-P0.95-LS2.8-BL | 1 | AP2112K-3.3TRG1 | DIODES(美台) | LCSC | C51118 | | Extended Part | Power Management (PMIC) | Voltage Regulators - Linear, Low Drop Out (LDO) Regulators
13 | U4 | CONN-TH_6P-P5.08_DIBO_DB127S-5.08-6P-GN | 1 | DB127S-5.08-6P-GN-S | DORABO(地博电气) | LCSC | C2997523 | | Extended Part | Connectors | Screw Terminal Blocks
