bigJRo/KerbalControllerMk1/Documents/Drawings/KC-01-1833_V2.0_Joystick Module_BOM.pdf

DWG No: | KC-01-1833
Revision: | V2.0
Drawn: | J. Rostoker | 6/13/2026
Approved: | J. Kerman | 6/13/2026
Issued: | 6/13/2026
Status: | RELEASED
Doc Type: | CCA Parts List
No. | Designator | Footprint | Quantity | Manufacturer Part | Manufacturer | Supplier | Supplier Part | Value | JLCPCB Part Class | Primary Category | Secondary Category
1 | C1,C5,C6,C8 | C0402 | 4 | CL05B104KO5NNNC | SAMSUNG(三星) | LCSC | C1525 | 100nF | Basic Part | Capacitors | Multilayer Ceramic Capacitors MLCC - SMD/SMT
2 | C2 | C0402 | 1 | 0402CG101J500NT | FH(风华) | LCSC | C1546 | 100pF | Basic Part | Capacitors | Multilayer Ceramic Capacitors MLCC - SMD/SMT
3 | C3 | C0805 | 1 | CL21B475KAFNNNE | SAMSUNG(三星) | LCSC | C98195 | 4.7uF | Extended Part | Capacitors | Multilayer Ceramic Capacitors MLCC - SMD/SMT
4 | C4 | C0805 | 1 | CL21B106KAYQNNE | SAMSUNG(三星) | LCSC | C3039694 | 10uF | Extended Part | Capacitors | Multilayer Ceramic Capacitors MLCC - SMD/SMT
5 | C7 | C0402 | 1 | CL05A105KA5NQNC | SAMSUNG(三星) | LCSC | C52923 | 1uF | Basic Part | Capacitors | Multilayer Ceramic Capacitors MLCC - SMD/SMT
6 | D1 | SMA_L4.3-W2.6-LS5.2-RD | 1 | SS34 | MDD(辰达半导体) | LCSC | C8678 | | Basic Part | Diodes | Schottky Diodes
7 | D2 | SOT-23-3_L2.9-W1.6-P1.90-LS2.8-BR | 1 | BAT54C | CJ(江苏长电/长晶) | LCSC | C2135 | | Extended Part | Diodes | Schottky Diodes
8 | F1 | F1812 | 1 | MF-MSMF150/24X-2 | BOURNS | LCSC | C78695 | | Extended Part | Circuit Protection | Resettable Fuses
9 | H1 | HDR-TH_3P-P2.54-V-M-1 | 1 | 2.54-1*3P针 | BOOMELE(博穆精密) | LCSC | C49257 | | Extended Part | Connectors | Pin Headers
10 | P1 | IDC-TH_16P-P2.54_C3406 | 1 | 2.54-2*8P简牛 | BOOMELE(博穆精密) | LCSC | C3406 | | Extended Part | Connectors | IDC Connectors
11 | R1,R2 | R0402 | 2 | 0402WGF4701TCE | UNI-ROYAL(厚声) | LCSC | C25900 | 4.7kΩ | Basic Part | Resistors | Chip Resistor - Surface Mount
12 | R3 | R0402 | 1 | 0402WGF1003TCE | UNI-ROYAL(厚声) | LCSC | C25741 | 100kΩ | Basic Part | Resistors | Chip Resistor - Surface Mount
13 | R4 | R0402 | 1 | FRC0402F1912TS | FOJAN(富捷) | LCSC | C2998158 | 19.1kΩ Extended Part | | Resistors | Chip Resistor - Surface Mount
14 | R5,R7 | R0402 | 2 | 0402WGF1000TCE | UNI-ROYAL(厚声) | LCSC | C25076 | 100Ω | Basic Part | Resistors | Chip Resistor - Surface Mount
15 | R6,R8,R9,R11 | R0402 | 4 | 0402WGF1002TCE | UNI-ROYAL(厚声) | LCSC | C25744 | 10kΩ | Basic Part | Resistors | Chip Resistor - Surface Mount
16 | R10 | R0402 | 1 | 0402WGF2002TCE | UNI-ROYAL(厚声) | LCSC | C25765 | 20kΩ | Basic Part | Resistors | Chip Resistor - Surface Mount
17 | R12 | R0402 | 1 | 0402WGF3300TCE | UNI-ROYAL(厚声) | LCSC | C25104 | 330Ω | Basic Part | Resistors | Chip Resistor - Surface Mount
18 | SW1,SW2 | PB26-13M | 2 | PB26-13M RGB | Honyone
19 | U1 | SM8_L3.2-W2.9-P0.65-LS4.3-BL | 1 | PCA9306DCTR | TI(德州仪器) | LCSC | C123752 | | Extended Part | Logic | Translators, Level Shifters
20 | U2 | QFN-20_L5.0-W3.0-TL-MPM3610GQV-Z | 1 | MPM3610GQV-Z | MPS(芯源) | LCSC | C5183856 | | Extended Part | Power Modules | DC-DC Power Modules
21 | U3,U4 | SOP-8_L4.9-W3.9-P1.27-LS6.0-BL | 2 | WS2811 | worldsemi | LCSC | C114581 | | Extended Part | LED Drivers | LED Drivers
22 | U5 | UQFN-20_L3.0-W3.0-P0.40-BL-EP1.7 | 1 | ATTINY816-MNR | MICROCHIP(美国微芯) | LCSC | C2052778 | | Extended Part | Embedded Processors & Controllers | Microcontrollers (MCU/MPU/SOC)
23 | U6 | CONN-TH_6P-P5.08_DIBO_DB127S-5.08-6P-GN | 1 | DB127S-5.08-6P-GN-S | DORABO(地博电气) | LCSC | C2997523 | | Extended Part | Connectors | Screw Terminal Blocks
