bigJRo/KerbalControllerMk1/Documents/Drawings/KC-01-1843_V2.0_7-Segment Display Module_BOM.pdf

DWG No: | KC-01-1843
Revision: | V2.0
Drawn: | J. Rostoker | 6/13/2026
Approved: | J. Kerman | 6/13/2026
Issued: | 6/13/2026
Status: | RELEASED
Doc Type: | CCA Parts List
No. | Designator | Footprint | Quantity | Manufacturer Part | Manufacturer | Supplier | Supplier Part | Value | JLCPCB Part Class | Primary Category | Secondary Category
1 | C1,C6,C9,C11,C12,C13 | C0402 | 6 | CL05B104KO5NNNC | SAMSUNG(三星) | LCSC | C1525 | 100nF | Basic Part | Capacitors | Multilayer Ceramic Capacitors MLCC - SMD/SMT
2 | C2 | C0402 | 1 | 0402CG101J500NT | FH(风华) | LCSC | C1546 | 100pF | Basic Part | Capacitors | Multilayer Ceramic Capacitors MLCC - SMD/SMT
3 | C3 | C0805 | 1 | CL21B475KAFNNNE | SAMSUNG(三星) | LCSC | C98195 | 4.7uF | Extended Part | Capacitors | Multilayer Ceramic Capacitors MLCC - SMD/SMT
4 | C4 | C0805 | 1 | CL21B106KAYQNNE | SAMSUNG(三星) | LCSC | C3039694 | 10uF | Extended Part | Capacitors | Multilayer Ceramic Capacitors MLCC - SMD/SMT
5 | C5 | C0402 | 1 | CL05A105KA5NQNC | SAMSUNG(三星) | LCSC | C52923 | 1uF | Basic Part | Capacitors | Multilayer Ceramic Capacitors MLCC - SMD/SMT
6 | C7,C8 | C0402 | 2 | CL05B103KB5NNNC | SAMSUNG(三星) | LCSC | C15195 | 10nF | Basic Part | Capacitors | Multilayer Ceramic Capacitors MLCC - SMD/SMT
7 | C10 | C0402 | 1 | CL05A106MQ5NUNC | SAMSUNG(三星) | LCSC | C15525 | 10uF | Basic Part | Capacitors | Multilayer Ceramic Capacitors MLCC - SMD/SMT
8 | D1 | SMA_L4.3-W2.6-LS5.2-RD | 1 | SS34 | MDD(辰达半导体) | LCSC | C8678 | | Basic Part | Diodes | Schottky Diodes
9 | D2 | SOT-23-3_L2.9-W1.6-P1.90-LS2.8-BR | 1 | BAT54C | CJ(江苏长电/长晶) | LCSC | C2135 | | Extended Part | Diodes | Schottky Diodes
10 | F1 | F1812 | 1 | MF-MSMF150/24X-2 | BOURNS | LCSC | C78695 | | Extended Part | Circuit Protection | Resettable Fuses
11 | H1 | HDR-TH_3P-P2.54-V-M-1 | 1 | 2.54-1*3P针 | BOOMELE(博穆精密) | LCSC | C49257 | | Extended Part | Connectors | Pin Headers
12 | LED1,LED2,LED3 | LED-SMD_4P-L3.2-W2.8_SK6812MINI-EA | 3 | SK6812MINI-EA | 欧思科光电 | LCSC | C5378731 | | Extended Part | Optoelectronics | RGB LEDs(Built-in IC)
13 | LED4 | LED-SEG-TH_12P-L40.4-W16.0-P2.54-S12.70-BL | 1 | FJ4401AG | 志浩 | LCSC | C19186 | | Extended Part | Displays | LED Segment Displays
14 | P1 | IDC-TH_16P-P2.54_C3406 | 1 | 2.54-2*8P简牛 | BOOMELE(博穆精密) | LCSC | C3406 | | Extended Part | Connectors | IDC Connectors
15 | R1,R2 | R0402 | 2 | 0402WGF4701TCE | UNI-ROYAL(厚声) | LCSC | C25900 | 4.7kΩ | Basic Part | Resistors | Chip Resistor - Surface Mount
16 | R3 | R0402 | 1 | 0402WGF1003TCE | UNI-ROYAL(厚声) | LCSC | C25741 | 100kΩ | Basic Part | Resistors | Chip Resistor - Surface Mount
17 | R4 | R0402 | 1 | FRC0402F1912TS | FOJAN(富捷) | LCSC | C2998158 | 19.1k Ω | Extended Part | Resistors | Chip Resistor - Surface Mount
18 | R5,R6,R7,R8,R9,R11,R12,R1 5,R16,R17,R18 | R0402 | 11 | 0402WGF1002TCE | UNI-ROYAL(厚声) | LCSC | C25744 | 10kΩ | Basic Part | Resistors | Chip Resistor - Surface Mount
19 | R10 | R0402 | 1 | 0402WGF2002TCE | UNI-ROYAL(厚声) | LCSC | C25765 | 20kΩ | Basic Part | Resistors | Chip Resistor - Surface Mount
20 | R13 | R0402 | 1 | 0402WGF9531TCE | UNI-ROYAL(厚声) | LCSC | C96273 | 9.53k Ω | Extended Part | Resistors | Chip Resistor - Surface Mount
21 | R14 | R0402 | 1 | 0402WGF3300TCE | UNI-ROYAL(厚声) | LCSC | C25104 | 330Ω | Basic Part | Resistors | Chip Resistor - Surface Mount
22 | SW1 | SW-TH_5P-L12.5-W13.4-P2.50-LS14.5-EH13.2 | 1 | PEC11R-4220F-S0024 | BOURNS | LCSC | C143797 | | Extended Part | Switches | Rotary Encoders
23 | U1 | SM8_L3.2-W2.9-P0.65-LS4.3-BL | 1 | PCA9306DCTR | TI(德州仪器) | LCSC | C123752 | | Extended Part | Logic | Translators, Level Shifters
24 | U2 | QFN-20_L5.0-W3.0-TL-MPM3610GQV-Z | 1 | MPM3610GQV-Z | MPS(芯源) | LCSC | C5183856 | | Extended Part | Power Modules | DC-DC Power Modules
25 | U3 | UQFN-20_L3.0-W3.0-P0.40-BL-EP1.7 | 1 | ATTINY816-MNR | MICROCHIP(美国微芯) | LCSC | C2052778 | | Extended Part | Embedded Processors & Controllers | Microcontrollers (MCU/MPU/SOC)
26 | U4 | SOIC-24_L15.4-W7.5-P1.27-LS10.3-BL | 1 | MAX7219CWG+T | ADI(亚德诺)/MAXIM(美 信) | LCSC | C9964 | | Extended Part | LED Drivers | Digital Tube Drivers
