bigJRo/KerbalControllerMk1/Documents/Drawings/KC-01-1853_V2.0_Encoder Module_BOM.pdf

DWG No: | KC-01-1853
Revision: | V2.0
Drawn: | J. Rostoker | 6/20/2026
Approved: | J. Kerman | 6/20/2026
Issued: | 6/20/2026
Status: | RELEASED
Doc Type: | CCA Parts List
No. | Designator | Footprint | Quantity | Manufacturer Part | Manufacturer | Supplier | Supplier Part | Value | JLCPCB Part Class | Primary Category | Secondary Category
1 | C1,C2 | C0402 | 2 | CL05B103KB5NNNC | SAMSUNG(三星) | LCSC | C15195 | 10nF | Basic Part | Capacitors | Multilayer Ceramic Capacitors MLCC - SMD/SMT
2 | H1 | HDR-TH_5P-P2.54-V-M | 1 | | | | | | | Connectors | Pin Headers
3 | R1,R2,R3,R4,R5 | R0402 | 5 | 0402WGF1002TCE | UNI-ROYAL(厚声) | LCSC | C25744 | 10kΩ | Basic Part | Resistors | Chip Resistor - Surface Mount
4 | SW1 | SW-TH_5P-L12.5-W13.4-P2.50-LS14.5-EH13.2 | 1 | PEC11R-4220F-S0024 | BOURNS | LCSC | C143797 | | Extended Part | Switches | Rotary Encoders
