bigJRo/KerbalControllerMk1/Documents/Drawings/KC-01-1873_V2.0_Throttle Module_BOM.pdf

DWG No: | KC-01-1873
Revision: | V2.0
Drawn: | J. Rostoker | 6/21/2026
Approved: | J. Kerman | 6/21/2026
Issued: | 6/21/2026
Status: | RELEASED
Doc Type: | CCA Parts List
No. | Designator | Footprint | Quantity | Manufacturer Part | Manufacturer | Supplier | Supplier Part | Value | JLCPCB Part Class | Primary Category | Secondary Category
1 | C1,C6 | C0402 | 2 | CL05B104KO5NNNC | SAMSUNG(三星) | LCSC | C1525 | 100nF | Basic Part | Capacitors | Multilayer Ceramic Capacitors MLCC - SMD/SMT
2 | C2 | C0402 | 1 | 0402CG101J500NT | FH(风华) | LCSC | C1546 | 100pF | Basic Part | Capacitors | Multilayer Ceramic Capacitors MLCC - SMD/SMT
3 | C3,C15 | C0805 | 2 | CL21B475KAFNNNE | SAMSUNG(三星) | LCSC | C98195 | 4.7uF | Extended Part | Capacitors | Multilayer Ceramic Capacitors MLCC - SMD/SMT
4 | C4,C16 | C0805 | 2 | CL21B106KAYQNNE | SAMSUNG(三星) | LCSC | C3039694 | 10uF | Extended Part | Capacitors | Multilayer Ceramic Capacitors MLCC - SMD/SMT
5 | C5 | C0402 | 1 | CL05A105KA5NQNC | SAMSUNG(三星) | LCSC | C52923 | 1uF | Basic Part | Capacitors | Multilayer Ceramic Capacitors MLCC - SMD/SMT
6 | C9 | C0402 | 1 | CL05C100JB5NNNC | SAMSUNG(三星) | LCSC | C32949 | 10pF | Basic Part | Capacitors | Multilayer Ceramic Capacitors MLCC - SMD/SMT
7 | C10,C12,C13 | C0603 | 3 | CC0603KRX7R9BB104 | YAGEO(国巨) | LCSC | C14663 | 100nF | Basic Part | Capacitors | Multilayer Ceramic Capacitors MLCC - SMD/SMT
8 | C11 | C0402 | 1 | 0402B223K500NT | FH(风华) | LCSC | C1532 | 22nF | Basic Part | Capacitors | Multilayer Ceramic Capacitors MLCC - SMD/SMT
9 | C14 | CAP-SMD_BD6.3-L6.6-W6.6-LS7.2-FD | 1 | RVT100UF16V67RV001 6 | KNSCHA(科尼盛) | LCSC | C2887276 | 100uF | Extended Part | Capacitors | Aluminum Electrolytic Capacitors - SMD
10 | D1 | SMA_L4.3-W2.6-LS5.2-RD | 1 | SS34 | MDD(辰达半导体) | LCSC | C8678 | | Basic Part | Diodes | Schottky Diodes
11 | D2 | SOT-23-3_L2.9-W1.6-P1.90-LS2.8-BR | 1 | BAT54C | CJ(江苏长电/长晶) | LCSC | C2135 | | Extended Part | Diodes | Schottky Diodes
12 | F1 | F1812 | 1 | MF-MSMF150/24X-2 | BOURNS | LCSC | C78695 | | Extended Part | Circuit Protection | Resettable Fuses
13 | H1 | HDR-TH_3P-P2.54-V-M-1 | 1 | 2.54-1*3P针 | BOOMELE(博穆精密) | LCSC | C49257 | | Extended Part | Connectors | Pin Headers
14 | LED1 | LED0603-RD | 1 | KT-0603R | KENTO | LCSC | C2286 | | Basic Part | Optoelectronics | LED Indication - Discrete
15 | LED2 | LED0603-RD | 1 | LTST-C190KGKT | LITEON(光宝) | LCSC | C125094 | | Extended Part | Optoelectronics | LED Indication - Discrete
16 | P1 | IDC-TH_16P-P2.54_C3406 | 1 | 2.54-2*8P简牛 | BOOMELE(博穆精密) | LCSC | C3406 | | Extended Part | Connectors | IDC Connectors
17 | Q1,Q2,Q3,Q4,Q5 | SOT-23-3_L2.9-W1.3-P1.90-LS2.4-TR | 5 | 2N3904 | KEC | LCSC | C18536 | | Extended Part | Transistors/Thyristors | Bipolar (BJT)
18 | R1,R2 | R0402 | 2 | 0402WGF4701TCE | UNI-ROYAL(厚声) | LCSC | C25900 | 4.7kΩ | Basic Part | Resistors | Chip Resistor - Surface Mount
19 | R3,R21 | R0402 | 2 | 0402WGF1003TCE | UNI-ROYAL(厚声) | LCSC | C25741 | 100kΩ | Basic Part | Resistors | Chip Resistor - Surface Mount
20 | R4 | R0402 | 1 | FRC0402F1912TS | FOJAN(富捷) | LCSC | C2998158 | 19.1k Ω | Extended Part | Resistors | Chip Resistor - Surface Mount
21 | R5,R7,R8,R9,R11,R12,R13,R 14,R17,R18,R19,R20,R22 | R0402 | 13 | 0402WGF1002TCE | UNI-ROYAL(厚声) | LCSC | C25744 | 10kΩ | Basic Part | Resistors | Chip Resistor - Surface Mount
22 | R6 | R0402 | 1 | 0402WGF2002TCE | UNI-ROYAL(厚声) | LCSC | C25765 | 20kΩ | Basic Part | Resistors | Chip Resistor - Surface Mount
23 | R10 | R0603 | 1 | 0603WAF1002T5E | UNI-ROYAL(厚声) | LCSC | C25804 | 10kΩ | Basic Part | Resistors | Chip Resistor - Surface Mount
24 | R15,R16 | R0603 | 2 | 0603WAF1001T5E | UNI-ROYAL(厚声) | LCSC | C21190 | 1kΩ | Basic Part | Resistors | Chip Resistor - Surface Mount
25 | U1 | SM8_L3.2-W2.9-P0.65-LS4.3-BL | 1 | PCA9306DCTR | TI(德州仪器) | LCSC | C123752 | | Extended Part | Logic | Translators, Level Shifters
26 | U2,U12 | QFN-20_L5.0-W3.0-TL-MPM3610GQV-Z | 2 | MPM3610GQV-Z | MPS(芯源) | LCSC | C5183856 | | Extended Part | Power Modules | DC-DC Power Modules
27 | U3 | UQFN-20_L3.0-W3.0-P0.40-BL-EP1.7 | 1 | ATTINY816-MNR | MICROCHIP(美国微芯) | LCSC | C2052778 | | Extended Part | Embedded Processors & Controllers | Microcontrollers (MCU/MPU/SOC)
28 | U5,U7,U8,U10,U11 | CONN-TH_KF127S-3.81-4P | 5 | KF127S-3.81-4P | KEFA(科发) | LCSC | C2974912 | | Extended Part | Connectors | Screw Terminal Blocks
29 | U6 | SOT-23-6_L2.9-W1.6-P0.95-LS2.8-BR | 1 | AT42QT1010-TSHR | MICROCHIP(美国微芯) | LCSC | C74512 | | Extended Part | Sensors | Touch Sensors
30 | U9 | SOP-20_L13.2-W7.8-P1.27-LS10.4-BL | 1 | L293DD013TR | ST(意法半导体) | LCSC | C21610 | | Extended Part | Motor Driver ICs | Stepper Motor Driver
31 | VR1 | RES-ADJ-TH_RSA0N11M9A0J | 1 | RSA0N11M9A0J | ALPSALPINE(阿尔卑斯 阿尔派) | LCSC | C470594 | 10kΩ | Extended Part | Resistors | Potentiometers, Variable Resistors
