bigJRo/KerbalControllerMk1/Documents/Drawings/KC-01-1903_V2.0_2in TFT Display Driver_BOM.pdf

DWG No: | KC-01-1903
Revision: | V2.0
Drawn: | J. Rostoker | 6/20/2026
Approved: | J. Kerman | 6/20/2026
Issued: | 6/20/2026
Status: | RELEASED
Doc Type: | CCA Parts List
No. | Designator | Footprint | Quantity | Manufacturer Part | Manufacturer | Supplier | Supplier Part | Value | JLCPCB Part Class | Primary Category | Secondary Category
1 | C1 | C0805 | 1 | CL21B475KAFNNNE | SAMSUNG(三星) | LCSC | C98195 | 4.7uF | Extended Part | Capacitors | Multilayer Ceramic Capacitors MLCC - SMD/SMT
2 | C2 | C0805 | 1 | CL21B106KAYQNNE | SAMSUNG(三星) | LCSC | C3039694 | 10uF | Extended Part | Capacitors | Multilayer Ceramic Capacitors MLCC - SMD/SMT
3 | C3,C5 | C0402 | 2 | CL05A105KA5NQNC | SAMSUNG(三星) | LCSC | C52923 | 1uF | Basic Part | Capacitors | Multilayer Ceramic Capacitors MLCC - SMD/SMT
4 | C4 | C0402 | 1 | CL05B104KO5NNNC | SAMSUNG(三星) | LCSC | C1525 | 100nF | Basic Part | Capacitors | Multilayer Ceramic Capacitors MLCC - SMD/SMT
5 | C6 | C0603 | 1 | CL10A106KP8NNNC | SAMSUNG(三星) | LCSC | C19702 | 10uF | Basic Part | Capacitors | Multilayer Ceramic Capacitors MLCC - SMD/SMT
6 | C7 | C0603 | 1 | CC0603KRX7R9BB104 | YAGEO(国巨) | LCSC | C14663 | 100nF | Basic Part | Capacitors | Multilayer Ceramic Capacitors MLCC - SMD/SMT
7 | CARD1 | TF-SMD_TF-PUSH | 1 | TF PUSH | SHOU HAN(首韩) | LCSC | C393941 | | Extended Part | Connectors | SD Card / Memory Card Connector
8 | D1 | SMA_L4.3-W2.6-LS5.2-RD | 1 | SS34 | MDD(辰达半导体) | LCSC | C8678 | | Basic Part | Diodes | Schottky Diodes
9 | D2 | SMA_L4.2-W2.6-LS5.0-RD_1 | 1 | SS14 | MDD(辰达半导体) | LCSC | C2480 | | Basic Part | Diodes | Schottky Diodes
10 | F1 | F1812 | 1 | MF-MSMF150/24X-2 | BOURNS | LCSC | C78695 | | Extended Part | Circuit Protection | Resettable Fuses
11 | H1,H2 | HDR-TH_7P-P2.54-V-F | 2 | PM254V-11-07-H85 | XFCN(兴飞) | LCSC | C2832270 | | Extended Part | Connectors | Female Headers
12 | H3 | HDR-TH_8P-P2.54-V-F | 1 | 2.54-1*8P母环保 | BOOMELE(博穆精密) | LCSC | C27438 | | Extended Part | Connectors | Female Headers
13 | P1 | IDC-TH_16P-P2.54_C3406 | 1 | 2.54-2*8P简牛 | BOOMELE(博穆精密) | LCSC | C3406 | | Extended Part | Connectors | IDC Connectors
14 | R1 | R0402 | 1 | 0402WGF1003TCE | UNI-ROYAL(厚声) | LCSC | C25741 | 100kΩ | Basic Part | Resistors | Chip Resistor - Surface Mount
15 | R2 | R0402 | 1 | FRC0402F1912TS | FOJAN(富捷) | LCSC | C2998158 | 19.1k Ω | Extended Part | Resistors | Chip Resistor - Surface Mount
16 | R3,R4 | R0402 | 2 | 0402WGF1002TCE | UNI-ROYAL(厚声) | LCSC | C25744 | 10kΩ | Basic Part | Resistors | Chip Resistor - Surface Mount
17 | U1 | QFN-20_L5.0-W3.0-TL-MPM3610GQV-Z | 1 | MPM3610GQV-Z | MPS(芯源) | LCSC | C5183856 | | Extended Part | Power Modules | DC-DC Power Modules
18 | U2 | SOT-25-5_L2.9-W1.6-P0.95-LS2.8-BL | 1 | AP2112K-3.3TRG1 | DIODES(美台) | LCSC | C51118 | | Extended Part | Power Management (PMIC) | Voltage Regulators - Linear, Low Drop Out (LDO) Regulators
