bigJRo/KerbalControllerMk1/Documents/Drawings/KC-01-1913_V2.0_7in TFT Display Driver_BOM.pdf

DWG No: | KC-01-1913
Revision: | V2.0
Drawn: | J. Rostoker | 6/20/2026
Approved: | J. Kerman | 6/20/2026
Issued: | 6/20/2026
Status: | RELEASED
Doc Type: | CCA Parts List
No. | Designator | Footprint | Quantity | Manufacturer Part | Manufacturer | Supplier | Supplier Part | Value | JLCPCB Part Class | Primary Category | Secondary Category
1 | BUZZER1 | BUZ-TH_BD12.5-P5.00-D0.9 | 1 | PS1240P02BT | TDK | LCSC | C76871 | 4kHz | Extended Part | Audio Products / Vibration Motors | Buzzers
2 | C1,C3 | C0402 | 2 | CL05A105KA5NQNC | SAMSUNG(三星) | LCSC | C52923 | 1uF | Basic Part | Capacitors | Multilayer Ceramic Capacitors MLCC - SMD/SMT
3 | C2 | C0402 | 1 | CL05B104KO5NNNC | SAMSUNG(三星) | LCSC | C1525 | 100nF | Basic Part | Capacitors | Multilayer Ceramic Capacitors MLCC - SMD/SMT
4 | C4 | C0805 | 1 | CL21B475KAFNNNE | SAMSUNG(三星) | LCSC | C98195 | 4.7uF | Extended Part | Capacitors | Multilayer Ceramic Capacitors MLCC - SMD/SMT
5 | C5 | C0805 | 1 | CL21B106KAYQNNE | SAMSUNG(三星) | LCSC | C3039694 | 10uF | Extended Part | Capacitors | Multilayer Ceramic Capacitors MLCC - SMD/SMT
6 | C8 | CAP-SMD_BD5.0-L5.3-W5.3-FD | 1 | RVT1A101M0505 | HONOR(荣誉) | LCSC | C3347 | 100uF | Extended Part | Capacitors | Aluminum Electrolytic Capacitors - SMD
7 | C12 | C0603 | 1 | CL10A106KP8NNNC | SAMSUNG(三星) | LCSC | C19702 | 10uF | Basic Part | Capacitors | Multilayer Ceramic Capacitors MLCC - SMD/SMT
8 | C13 | C0603 | 1 | CC0603KRX7R9BB104 | YAGEO(国巨) | LCSC | C14663 | 100nF | Basic Part | Capacitors | Multilayer Ceramic Capacitors MLCC - SMD/SMT
9 | CN1 | IDC-TH_34P-P2.54_BOOMELE-2X17P | 1 | 2.54-2*17P直简牛 | BOOMELE(博穆精密) | LCSC | C20920 | | Extended Part | Connectors | IDC Connectors
10 | D1 | SMA_L4.3-W2.6-LS5.2-RD | 1 | SS34 | MDD(辰达半导体) | LCSC | C8678 | | Basic Part | Diodes | Schottky Diodes
11 | F1 | F1812 | 1 | MF-MSMF150/24X-2 | BOURNS | LCSC | C78695 | | Extended Part | Circuit Protection | Resettable Fuses
12 | H1 | HDR-TH_40P-P2.54-V-F-R2-C20-S2.54 | 1 | ZX-PM2.54-2-20PY | Megastar(兆星) | LCSC | C7499354 | | Extended Part | Connectors | Female Headers
13 | H2,H3 | HDR-TH_24P-P2.54-V-F | 2 | X6511FV-24-C85D32 | XKB Connectivity(中国星坤) | LCSC | C2883741 | | Extended Part | Connectors | Female Headers
14 | LED1 | LED0603-RD | 1 | KT-0603R | KENTO | LCSC | C2286 | | Basic Part
15 | P1,P2,P3,P5 | IDC-TH_16P-P2.54_C3406 | 4 | 2.54-2*8P简牛 | BOOMELE(博穆精密) | LCSC | C3406 | | Extended Part | Connectors | IDC Connectors
16 | P6,P7 | HDR-TH_8P-P2.54-V-F-1 | 2 | 2.54-1*8P母环保 | BOOMELE(博穆精密) | LCSC | C27438 | | Extended Part | Connectors | Female Headers
17 | Q1 | SOT-23-3_L3.0-W1.7-P0.95-LS2.9-BR | 1 | S8050 | CJ(江苏长电/长晶) | LCSC | C2146 | | Basic Part | Transistors/Thyristors | Bipolar (BJT)
18 | Q2 | SOT-23-3_L2.9-W1.3-P1.90-LS2.4-BR | 1 | SS8550 | CJ(江苏长电/长晶) | LCSC | C8542 | | Basic Part | Transistors/Thyristors | Bipolar (BJT)
19 | R1 | R0402 | 1 | 0402WGF1003TCE | UNI-ROYAL(厚声) | LCSC | C25741 | 100kΩ | Basic Part | Resistors | Chip Resistor - Surface Mount
20 | R2 | R0402 | 1 | FRC0402F1912TS | FOJAN(富捷) | LCSC | C2998158 | 19.1k Ω | Extended Part | Resistors | Chip Resistor - Surface Mount
21 | R3,R4,R6,R7,R8 | R0402 | 5 | 0402WGF1002TCE | UNI-ROYAL(厚声) | LCSC | C25744 | 10kΩ | Basic Part | Resistors | Chip Resistor - Surface Mount
22 | R5 | R0603 | 1 | 0603WAF1001T5E | UNI-ROYAL(厚声) | LCSC | C21190 | 1kΩ | Basic Part | Resistors | Chip Resistor - Surface Mount
23 | R9 | R0402 | 1 | 0402WGF2002TCE | UNI-ROYAL(厚声) | LCSC | C25765 | 20kΩ | Basic Part | Resistors | Chip Resistor - Surface Mount
24 | R10 | R0603 | 1 | 0603WAF4700T5E | UNI-ROYAL(厚声) | LCSC | C23179 | 470Ω | Basic Part | Resistors | Chip Resistor - Surface Mount
25 | SPKR1 | CONN-TH_S2B-PH-K-LF-SN | 1 | S2B-PH-K(LF)(SN) | JST | LCSC | C265016 | | Extended Part | Connectors | Wire To Board Connector
26 | U1 | SOT-25-5_L2.9-W1.6-P0.95-LS2.8-BL | 1 | AP2112K-3.3TRG1 | DIODES(美台) | LCSC | C51118 | | Extended Part | Power Management (PMIC) | Voltage Regulators - Linear, Low Drop Out (LDO) Regulators
27 | U2 | QFN-20_L5.0-W3.0-TL-MPM3610GQV-Z | 1 | MPM3610GQV-Z | MPS(芯源) | LCSC | C5183856 | | Extended Part | Power Modules | DC-DC Power Modules
28 | U3 | CONN-TH_6P-P5.08_DIBO_DB127S-5.08-6P-GN | 1 | DB127S-5.08-6P-GN-S | DORABO(地博电气) | LCSC | C2997523 | | Extended Part | Connectors | Screw Terminal Blocks
