bigJRo/KerbalControllerMk1/Documents/Developer/assets/KCMk1_Wiring_Diagram.png

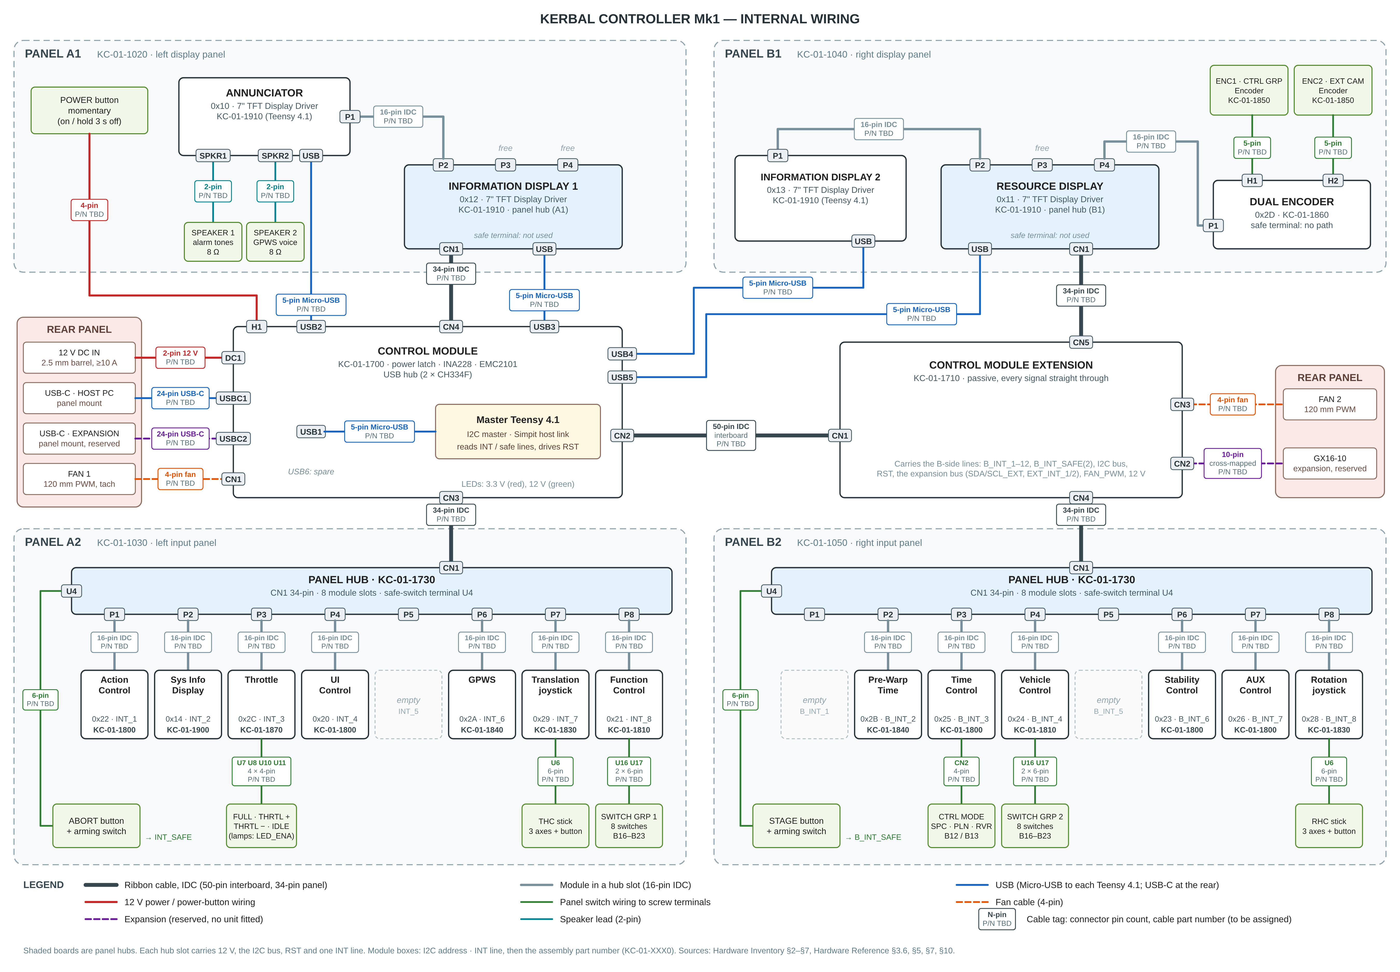
Documents/Developer/assets/KCMk1_Wiring_Diagram.png
