bigJRo/KerbalControllerMk1/Documents/Developer/assets/KCMk1_Wiring_Overview.png

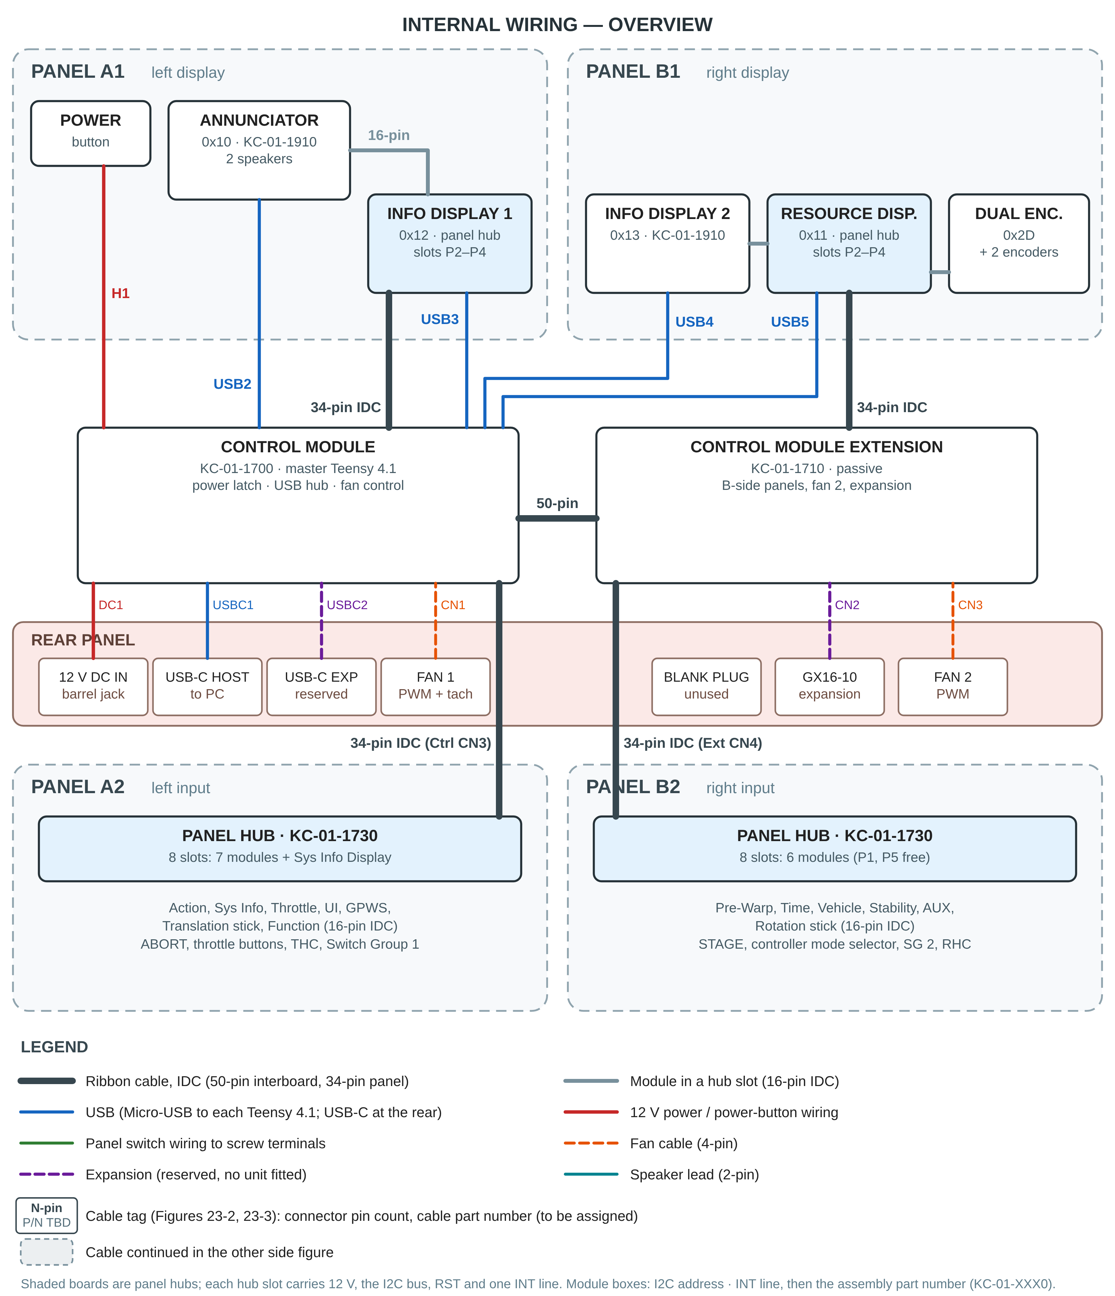
Documents/Developer/assets/KCMk1_Wiring_Overview.png
