bigJRo/KerbalControllerMk1/Documents/Developer/assets/KCMk1_Wiring_SideA.png

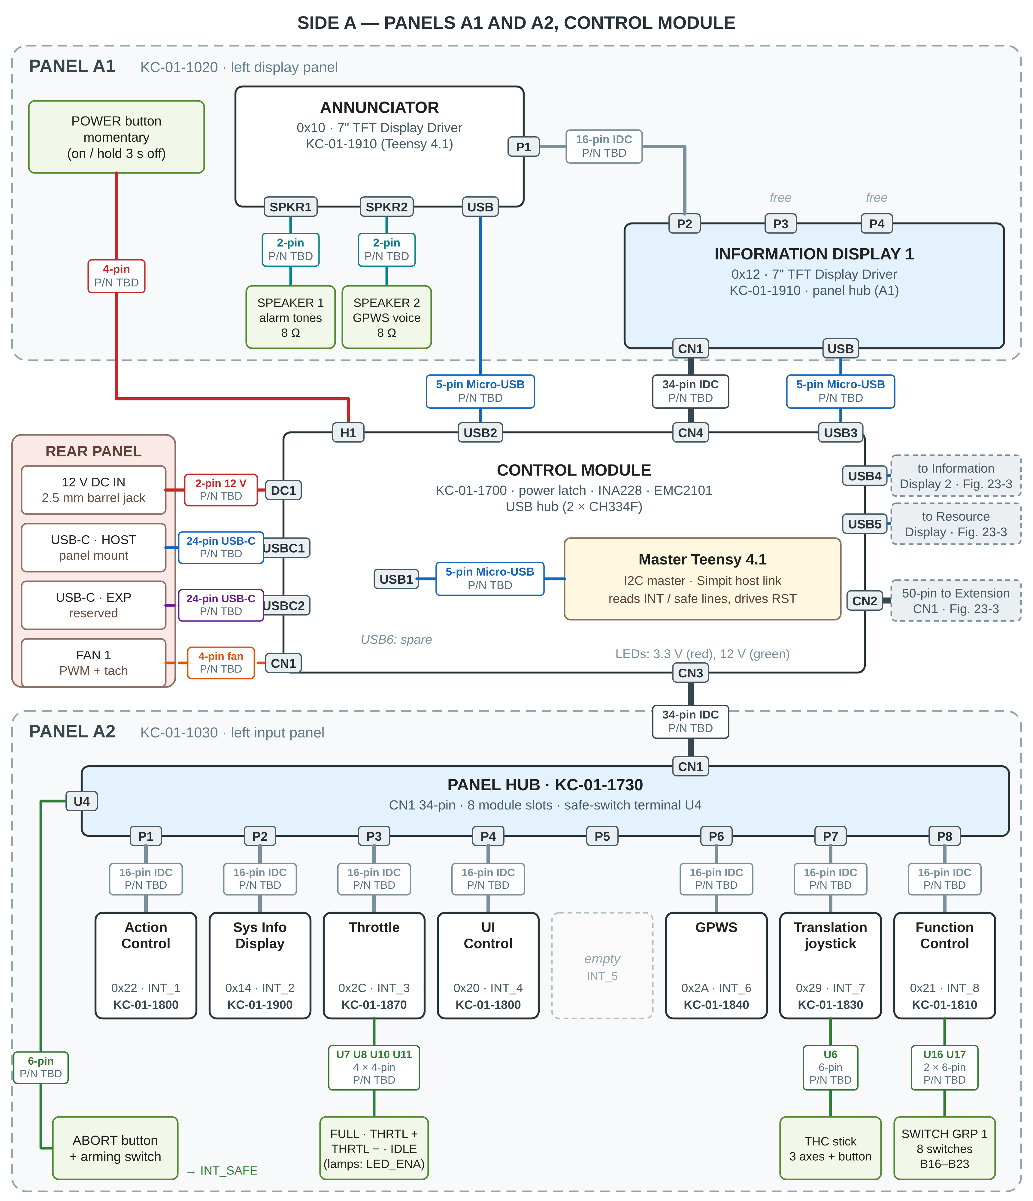
Documents/Developer/assets/KCMk1_Wiring_SideA.png
