bigJRo/KerbalControllerMk1/Software/Modules/0_Test Set/KCMk1_Module_Tester/README.md

# KCMk1 Module Tester

**Version:** 2.0.0
**Date:** 2026-06-28
**Author:** J. Rostoker — Jeb's Controller Works
**License:** GNU General Public License v3.0 (GPL-3.0)
**Board:** KC-01-9001 v2.0 / KC-01-9002

---

## Overview

A standalone, touchscreen field-validation tester for every Kerbal Controller Mk1
I2C target module. It powers a single module under test, scans the bus, identifies
the module, and presents a live test dashboard — button/axis/encoder state, LED-state
test controls, lifecycle commands, and real-time supply voltage/current/power.

This is a **ground-up rewrite** of the original serial-menu tester. It targets the new
hardware (Seeed XIAO RA4M1 + capacitive TFT + INA228) and tracks the current I2C
protocol by including the shared **KerbalModuleCommon** library as its single source of
truth for type IDs, commands, packet sizes, and LED states — so it cannot silently drift
from the modules the way the old hard-coded tester did.

---

## Hardware (KC-01-9001 v2.0)

| Block | Part |
|---|---|
| MCU | Seeed **XIAO RA4M1** (Renesas RA4M1, Arduino UNO R4 core) |
| Display | **ER-TFT028A3-4** — 2.8" 240×320 **ST7789V**, 4-wire SPI |
| Touch | **FT6236** capacitive, I2C `0x38` + `CTP_INT` |
| Power monitor | **INA228** high-side V/I sensor, 15 mΩ shunt, I2C `0x40` |
| Power | 12 V barrel → MPM3610 (5 V) → AP2112K (3V3), soft-latching switch |
| Module port (P1) | 12 V, 3V3, GND, I2C (SDA/SCL), INT, RST — **3.3 V logic, direct** |

### XIAO RA4M1 pin map

| Pin | Net | Function |
|---|---|---|
| D0 | CTP_INT | Capacitive-touch interrupt |
| D1 | INT_BUS | Module INT (active low) |
| D2 | RST | Module reset (active low) |
| D3 | TFT_DC | Display data/command |
| D4 / D5 | SDA / SCL | I2C — module + INA228 + touch (shared) |
| D6 | BACKLITE | Display backlight enable |
| D7 | TFT_CS | Display chip select |
| D8 / D9 / D10 | SCK / MISO / MOSI | SPI to display |

The touch controller (`0x38`) and INA228 (`0x40`) share the bus with the module under
test (`0x20`–`0x2E`); the scan logic skips the on-board addresses.

---

## Firmware structure

| File | Role |
|---|---|
| `KCMk1_Module_Tester.ino` | App state machine: SPLASH → SCAN → DASHBOARD |
| `TesterConfig.h` | Pin map, I2C addresses, INA228 calibration, timing |
| `ModuleCatalog.h/.cpp` | Per-module metadata (name, kind, input labels) |
| `TesterHW.h/.cpp` | I2C controller ops, packet parsing, INA228 driver |
| `TesterUI.h/.cpp` | LovyanGFX + FT6236 touchscreen UI (splash / scan / dashboard / construction test) |
| `ConstructionTest.h/.cpp` | Per-board-type guided construction-test sequences |

All protocol constants (`KMC_TYPE_*`, `KMC_CMD_*`, `KMC_*_PACKET_SIZE`, `KMC_LED_*`,
`KMC_STATUS_*`, nibble helpers) come from **KerbalModuleCommon**.

---

## Dependencies

| Library | Notes |
|---|---|
| **Adafruit ST7735 and ST7789 Library** | Display driver (`Adafruit_ST7789`). The panel is an **ST7789V** — see the controller note below. Pulls in Adafruit_GFX + Adafruit_BusIO |
| **Adafruit_GFX** (latest) | Graphics primitives (dependency of the above) |
| **Adafruit_FT6206** | Capacitive touch driver — the FT6236 is register-compatible |

> **Controller note — this panel is ST7789V, not ILI9341.** The ER-TFT028A3-4 uses an
> ST7789V. An ILI9341 driver *mostly* works (shared MIPI-DCS commands) but its init
> programs ILI9341-specific display-function/power/VCOM registers that misconfigure the
> ST7789V's line drive — symptom: a permanent band of garbage pixels at the bottom of
> the panel that no drawing clears, plus an unexpected rotation direction. Use
> `Adafruit_ST7789` with `tft.init(240, 320)`. If colours ever appear inverted, toggle
> `tft.invertDisplay()` in `uiBegin()`.
| **KerbalModuleCommon** | Shared KCMk1 protocol/palette header (this repo), v1.7.1+ |
| Wire / SPI | Arduino core |

> **Why not LovyanGFX?** It has no Renesas RA4M1 (renesas_uno) platform port — its
> generic fallback fails to compile on the UNO R4 core, and it also defines a global
> `RGBColor` alias that collides with KerbalModuleCommon's `struct RGBColor`. The
> Adafruit stack works on the RA4M1 via generic SPI/Wire.

> **XIAO RA4M1 note — `wiring_private.h` shim may be required.** Some Adafruit display
> libraries guard their `#include "wiring_private.h"` only for the *official* UNO R4
> board macros (`ARDUINO_UNOR4_MINIMA`/`_WIFI`). The Seeed XIAO RA4M1 sets a different
> board macro, so the build can fail with `wiring_private.h: No such file or directory`
> from inside the library. Fix: create an **empty file** named `wiring_private.h` in
> that library's source folder (next to the failing `.cpp` — e.g.
> `Documents/Arduino/libraries/Adafruit_ST7735_and_ST7789_Library/`). The quoted
> include resolves to the shim and the build proceeds. Re-create it after library
> updates. This was confirmed needed for Adafruit_ILI9341 and may equally apply to the
> ST7735/ST7789 library.

---

## Build & flash

| Setting | Value |
|---|---|
| Board | Seeed XIAO RA4M1 (Arduino UNO R4 / Renesas RA4M1 core) |
| Libraries | Adafruit ST7735 and ST7789 Library, Adafruit_GFX, Adafruit_FT6206, KerbalModuleCommon |
| Programmer | USB (UF2 / bootloader) |

1. Install the Renesas Arduino core (Arduino UNO R4 / XIAO RA4M1).
2. Library Manager: install **Adafruit ST7735 and ST7789 Library** (accept its
   Adafruit_GFX/BusIO dependencies) and **Adafruit_FT6206**.
3. Ensure `KerbalModuleCommon` (v1.7.1+, header-only) is on the library path.
4. Open this folder in the Arduino IDE and upload. If the ST7735/ST7789 library
   fails on `wiring_private.h`, apply the empty-file shim described above.

---

## Usage

1. **Power on** (soft-latch switch). The splash screen appears, then the scan screen.
2. **Connect a module** to P1. The tester scans `0x20`–`0x2E`, identifies each module,
   and lists it. The top bar shows live module supply **V / A / W** from the INA228.
3. **Touch a module** to open its dashboard:
   - Header shows lifecycle (ACTIVE / SLEEPING / DISABLED / BOOT), fault flag, and the
     transaction counter.
   - The input area shows live button / switch-group / axis / encoder / value state for
     that module type.
   - Control buttons: **Enbl / Dsbl / Slp / Wake / Rst / Bulb / LED / Back**
     (`CMD_ENABLE`, `CMD_DISABLE`, `CMD_SLEEP`, `CMD_WAKE`, `CMD_RESET`, `CMD_BULB_TEST`,
     LED-state cycle, return to scan).
   - **LED** steps every position through the full LED-state set
     (ENABLED → ACTIVE → WARNING → ALERT → ARMED → PARTIAL_DEPLOY → CUT → ACTIVE_ALT).
   - **Test** launches the guided construction test for the module (below).

---

## Construction test

The **Test** control on the dashboard runs a guided, per-board-type sequence for
validating a freshly assembled board. Each step drives the board's outputs and/or
verifies its inputs; some steps auto-pass on detection, others ask the operator to
confirm PASS / FAIL (with RETRY where useful). ABORT exits at any point; a final
summary lists each step's result.

| Board kind | Steps |
|---|---|
| Button (12 / 24) | Enable → **LED walk** (each NeoPixel/discrete LED lit in turn) → **Button walk** (press every input incl. switch groups) → summary |
| Joystick | Enable → **Axis sweep** (move full range; captures min/max per axis) → **Button walk** → **LED check** → summary |
| Display (7-seg) | Enable → **Segment test** (drives 8888/1234) → **Encoder** (turn up/down) → **Button walk** (incl. encoder button) → **LED check** → summary |
| Throttle | Enable → **Motor sweep** (drives 0/100/50 %) → **Touch + wiper** (grab and slide) → **Bulb test** → **Button walk** → summary |
| Dual Encoder | **ENC1** (CW/CCW) → **ENC2** (CW/CCW) → **Button walk** → summary |

Drive commands used: `CMD_SET_LED_STATE` (LED walk), `CMD_SET_THROTTLE` (motor sweep),
`CMD_SET_VALUE` (segment test), `CMD_BULB_TEST` (discrete LEDs).

---

## Verification status

This firmware is written against the schematic and the current protocol but **has not
been compiled or run on hardware here**. On first bring-up, verify:

- The FT6236 **touch coordinate mapping**: the UI runs portrait 240×320
  (rotation 0), so touch coordinates pass straight through in `rawTouch()`
  (`TesterUI.cpp`). If taps land mirrored on hardware, flip the axes there
  as commented.
- INA228 address (`0x40`, A0/A1 = GND) and the current/power calibration
  (`INA228_MAX_CURRENT_A`, `INA228_RSHUNT_OHMS` in `TesterConfig.h`) against bench readings.
- The module reset polarity/pulse on P1.

---

## Revision History

| Version | Date | Notes |
|---|---|---|
| 1.0 | 2026-04-18 | Serial-menu tester for the KC-01-9001 v1.0 board (XIAO SAMD21). |
| 2.0 | 2026-06-28 | Ground-up rewrite for KC-01-9001 v2.0 (XIAO RA4M1): capacitive touchscreen UI (LovyanGFX), INA228 power telemetry, current protocol (v2.9) via KerbalModuleCommon, all current module types. |
