bigJRo/KerbalControllerMk1/Documents/Developer/Display_Test_Plan.html

# KCMk1 Display Test Run

INFO 1.18.0 · C&W 3.10.0 · RES 3.15.0 · plan v1.4

0 run0 pass0 fail0 n/a0 open

AllOpenFailed

Run logClear run

Loading…

## Purpose and how to use this plan

This is an in-game run-through of every screen and feature on the three TFT display panels. It is organised as a sequence of mission phases so the whole plan can be flown in order across a handful of KSP sessions, with each test point checked off as the situation arises. Test points that need a specific vessel type (aircraft, rover, EVA) are grouped into their own sessions.

Test point IDs are <session>-<number>, e.g. ASC-04. Each row lists the action, the expected result and the source of truth (threshold or rule) so a disagreement can be traced to the README or config constant rather than argued. Readout names are written as the screens print them (ALT.RDR, ΔV.STG, T+IGN); the per-screen detail is in Documents/User/Info_Display_Screen_Reference.md and Documents/User/Annunciator_Caution_Warning_Reference.md.

Recording results. The interactive version of this plan, Display_Test_Plan.html beside this file (generated from it by assets/build_test_plan.py), gives every test point a PASS / FAIL / N/A control and a note, keeps the run in the browser, and builds the run log for you. Otherwise copy the tables into a run log (or print them) and mark each row P / F / N/A, with a note on any failure; the defect-log template in §24 collects failures for triage. Record the firmware version strings from each boot screen at the top of the log.

Panel names used below.

Name | Panel | I2C | Role
Info 1 | A1 | 0x12 | Vehicle-type PFD panel, sidebar on the left, sixth key VEH
Info 2 | B1 | 0x13 | Mission-phase panel, sidebar on the right, sixth key A/P (owns every autopilot console)
C&W | A1 | 0x10 | Annunciator: Main / SOI / Standby
RES | B1 | 0x11 | Resource Display: Main / Select / Detail / Standby, plus EVA layout

Colour vocabulary (applies to every panel): green = nominal, yellow = caution, white-on-red = alarm, dark grey = inactive / not applicable (also a stage readout on a craft with no propellant), cyan = pilot-entered (reserve bugs) or a console mode tap waiting for the master, sky blue = a console setpoint edit waiting for the master, orange = disconnect reason / guard. Sidebar keys are achromatic (white-on-black unselected, black-on-grey selected) and only take colour when they carry live state.

## Prerequisites

### Software

- KSP1 with KerbalSimpit installed and the serial port bound to the controller. All four panels show the standby splash until a flight scene starts.
- Optional mods that enable specific test points (mark N/A if not installed): TAC Life Support (RES life-support meters, C&W LIFE SUPPORT), Community Resource Pack (RES XPD / ADV presets), Alternate Resource Panel (EC% on the pre-launch board and ROVER screen).
- On the Annunciator: the DFPlayer microSD populated with clips 001–034 for the GPWS session (the master turns audio on; see §2.3). It can be skipped; mark those rows N/A.
- All panels flashed with demoMode = false, debugMode = false, standaloneMode = false.

### The master controller

The master is Software/KCMk1_Master (it replaced Controller_Main; design Master_Firmware_Design.md). It handles every input module, so translation, SAS, RCS, gear, lights, action groups and time warp come from the controller panels. Its own bench checks are in Software/KCMk1_Master/README.md. It feeds every Annunciator field:

- Control-mode tile: the SPC / PLN / RVR selector on Time Control.
- CTRLGRP: Dual Encoder ENC1.
- AUDIO: the AUDIO switch (Switch Group 2).
- Panel condition block: TRIM (rotation stick BTN02), INPUT PREC (THC / RHC PREC), THRTL PREC (THRTL FINE), ENG ARM (ENGINE SAFE / ARM), SWITCH ERR (a switch disagreeing with the vessel) and SIMPIT LOST (no KSP traffic for 5 s in flight).
- Bit 3 is A/P ARM (the A/P INHIB / ARM switch); the tile reads A/P ARM from Annunciator v3.9.
- CAP reads 0.
- Backlight: the master sends every 7" panel its flight and standby levels (70 % / 20 % by default); the backlight console command changes them (session BKLT).
- Input test screen: the master feeds Info 1's input test screen while it is open (session INPUT).

### Test craft (build these in the VAB/SPH before starting)

Craft | Used in | Build notes
T1 Rocket | LNCH, ASC, ORB, MNVR, ENTR, DESC, AP consoles | Two liquid stages plus a pair of SRBs, crewed capsule, heat shield, drogue on CAG 1 (cut on 2), main on CAG 3 (cut on 4), landing gear or legs, RCS + monoprop, antenna. Capable of Kerbin orbit and return
T2 Target | TGT, DOCK, EVA | Any craft with a docking port left in a ~100 km Kerbin orbit ahead of time. Set it as target from T1
T3 Lander | DESC, LDAP, VEH | Mun-capable lander with legs and radar-visible descent, or reuse T1 for a Kerbin powered descent
T4 Aircraft | ACFT, NAV, ACAP, GPWS | Jet, vessel type set to Plane in the VAB/SPH naming dialog. Gear on the normal gear group, airbrakes on CAG 38 (AIRBRAKE_CAG)
T5 Rover | ROVR, RVAP | Wheeled rover, vessel type set to Rover, with a battery and a target flag planted a few hundred metres away
T6 EVA | EVA rows | Any crewed craft in orbit; a Kerbal on EVA with jetpack fuel

The vessel-type rule is deliberate: the AIRCRAFT and ROVER instruments key off the declared type, not the flight profile. A plane typed as Probe fails the ACFT session by design.

## 03BOOTpower-on, boot screens, standby

Power the controller on with KSP at the main menu.

ID

Action

Expected

Source

Result

## 04NAVsidebar navigation and mode cycling (both Info panels)

Run on the pad or in a stable orbit. Repeat every row on both Info panels; note the sidebar is left-edge on Info 1 and right-edge on Info 2.

ID

Action

Expected

Source

Result

## 05PADpre-launch (T1 on the launch pad)

ID

Action

Expected

Source

Result

## 06ASCascent (launch T1)

ID

Action

Expected

Source

Result

## 07ORBin orbit (T1 in a ~100 km Kerbin orbit)

ID

Action

Expected

Source

Result

## 08MNVRmaneuver node (T1 in orbit)

ID

Action

Expected

Source

Result

## 09ORAPOrbital Autopilot console (Info 2 only)

Requires the master (KCMk1_Master) running the mission autopilot. All annunciations reflect the master's echoed state: a tap shows a cyan pending cue and only turns green when the master confirms.

ID

Action

Expected

Source

Result

## 10TGTrendezvous and target (T1 approaching T2)

ID

Action

Expected

Source

Result

## 11DOCKdocking (T1 to T2)

ID

Action

Expected

Source

Result

## 12EVAKerbal on EVA (T6)

ID

Action

Expected

Source

Result

## 13ENTRre-entry (T1 returning to Kerbin)

ID

Action

Expected

Source

Result

## 14DESCpowered descent (T3 landing on the Mun, or T1 propulsive landing)

ID

Action

Expected

Source

Result

## 15LDAPLanding Autopilot console (Info 2 only)

ID

Action

Expected

Source

Result

## 16ACFTaircraft (T4, vessel type Plane)

ID

Action

Expected

Source

Result

### GPWS aircraft profile (audio, C&W panel)

Set the GPWS input panel to GREEN unless stated. The master relays the panel's mode, options and bug to the Annunciator.

ID

Action

Expected

Source

Result

## 17ROVRrover (T5, vessel type Rover)

ID

Action

Expected

Source

Result

### Rover Autopilot console (Info 2)

ID

Action

Expected

Source

Result

## 18ASCAPAscent Autopilot console (T1 on the pad, Info 2)

ID

Action

Expected

Source

Result

### Aircraft Autopilot console (T4 in flight, Info 2)

ID

Action

Expected

Source

Result

## 19RESResource Display (any crewed vessel, best done in orbit with T1)

### Main screen and meters

ID

Action

Expected

Source

Result

### Reserve bugs

ID

Action

Expected

Source

Result

### Select screen

ID

Action

Expected

Source

Result

### Detail screen

ID

Action

Expected

Source

Result

## 20CTXcontext ladder cross-checks (run alongside the sessions above)

These confirm the ladder guards. Tick them as the situations occur.

ID

Situation

Expected

Source

Result

## 21DEMOdemo mode round trip (SCE switch on Switch Group 1)

Demo follows the master's flag and nothing else (Hardware Inventory §8.8). Start in flight with T1, with a RES layout of your own saved for it (vessel name cyan on the alert strip), and the Sys Info Display in view.

ID

Action

Expected

Source

Result

## 22BKLTbacklight dimming (all four 7" panels)

Uses the master's serial console (first USB port). Run at the Space Center and in any flight.

ID

Action

Expected

Source

Result

## 23INPUTinput test screen (Info 1)

Needs the master, the modules and the other three 7" displays. The screen shows what the master reads, raw (Hardware Inventory §8.11).

ID

Action

Expected

Source

Result

## Appendix A — threshold cheat sheet

Quantity | Caution | Alarm | Where
Positive G | 4 g | 9 g | ASCENT G row, PFD, C&W HIGH G
Negative G | −2 g | −5 g | Same
Stage ΔV | 300 m/s | 150 m/s | ΔV.STG, C&W LOW ΔV
Stage burn time | 120 s | 60 s | STG.BRN, C&W LOW ΔV
Time to ground | 30 s | 10 s | T+GRND; C&W IMPACT IMM at 60 s, GROUND PROX at 10 s (gear ignored)
Dynamic pressure | 20 kPa | 40 kPa | ASCENT Q; C&W HIGH Q at 20 kPa
Angle of attack | 10° | 20° | AIRCRAFT AOA, GPWS STALL
Docking distance | 200 m | 50 m | DOCK DIST
Docking / target context | enter 200 m, leave 250 m | — | Mission rule 5
Target context window | 200–2000 m (release 150 / 2400) | — | Mission rule 9
Maneuver context | T+IGN < 600 s (release 700) | — | Mission rule 8
Powered-descent context | < 10 km radar, faster than −5 m/s (release 12 km) | — | Mission rule 3
Re-entry context | Pe in atmosphere and above it or Mach > 3 | — | Mission rule 2
Radar altitude | 500 m (200 m on POWERED DESCENT) | 50 m | ALT.RDR on DESC / ENTR / ACFT
Surface altitude | 200 m | — | C&W ALT / GEAR UP
Impact imminent | 60 s | — | C&W IMPACT IMM
Resource level (consumable) | 20% | 5% | RES bands, C&W PROP LOW / RCS LOW / BUS VOLTAGE
Depleted Fuel (fills up) | 80% | 95% | RES bands (TAC-LS waste products have none)
EC time remaining | 15 min | 5 min | RES time tier
O2 time remaining | 30 min | 10 min | RES, C&W LIFE SUPPORT
Water time remaining | 12 h | 4 h | Same
Food time remaining | 72 h | 24 h | Same
Part temperature | 50% (75% on Info Display bars) | 90% | C&W HIGH TEMP, CORE / SKIN
NAV drift | 10° | — | NAVIGATION DRIFT
Reticle angle (DOCK / MNVR) | 5° | 10° | Ring bands
Reticle angle (TGT) | 15° | 30° | Ring bands

## Appendix B — suggested session order

1. BOOT, NAV, PAD, ASCAP (one pad load, then launch under the autopilot)
2. ASC, ORB, MNVR, ORAP, RES (one orbit session)
3. TGT, DOCK, EVA (rendezvous with T2)
4. ENTR (return T1)
5. DESC, LDAP (Mun landing with T3)
6. ACFT, GPWS, ACAP (T4)
7. ROVR, RVAP (T5)
8. CTX rows as they come up across all of the above
9. DEMO, BKLT, INPUT (any flight and the Space Center; BKLT-06 and INPUT need the panels on the bench or in view of the console)

## Run log

Builds a markdown run log from the results above: totals, a defect table from every FAIL with its note, notes on other points, and the list of points not yet run. Paste it into an issue or the repo.

Build and copy run log
