bigJRo/KerbalControllerMk1/Documents/User/assets/Annunciator_MainLampTest.png

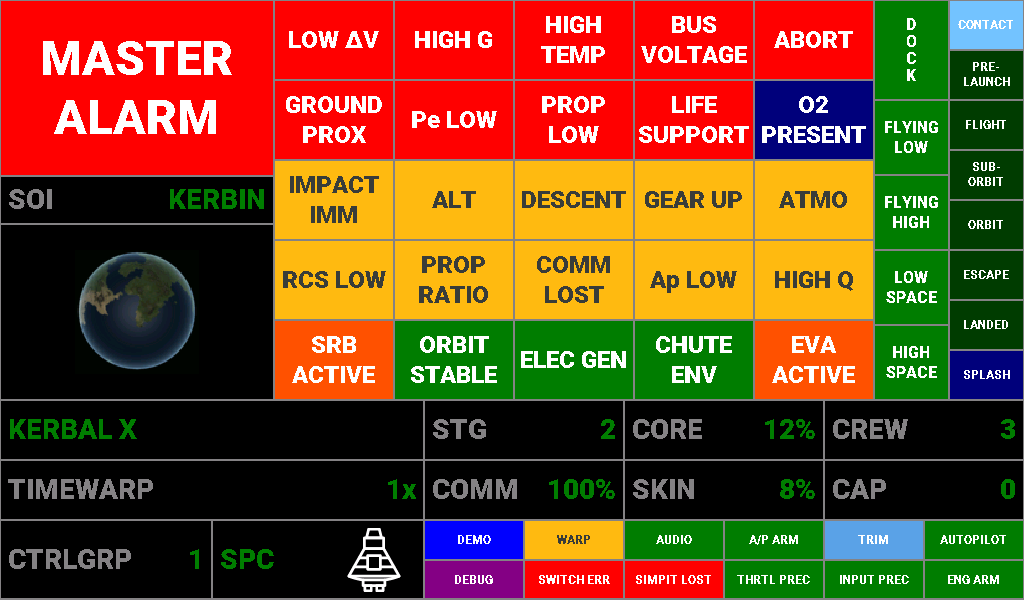
Documents/User/assets/Annunciator_MainLampTest.png
