bigJRo/KerbalControllerMk1/Documents/Drawings/KC-01-1070_Rev-_Internal Brace Assembly.pdf

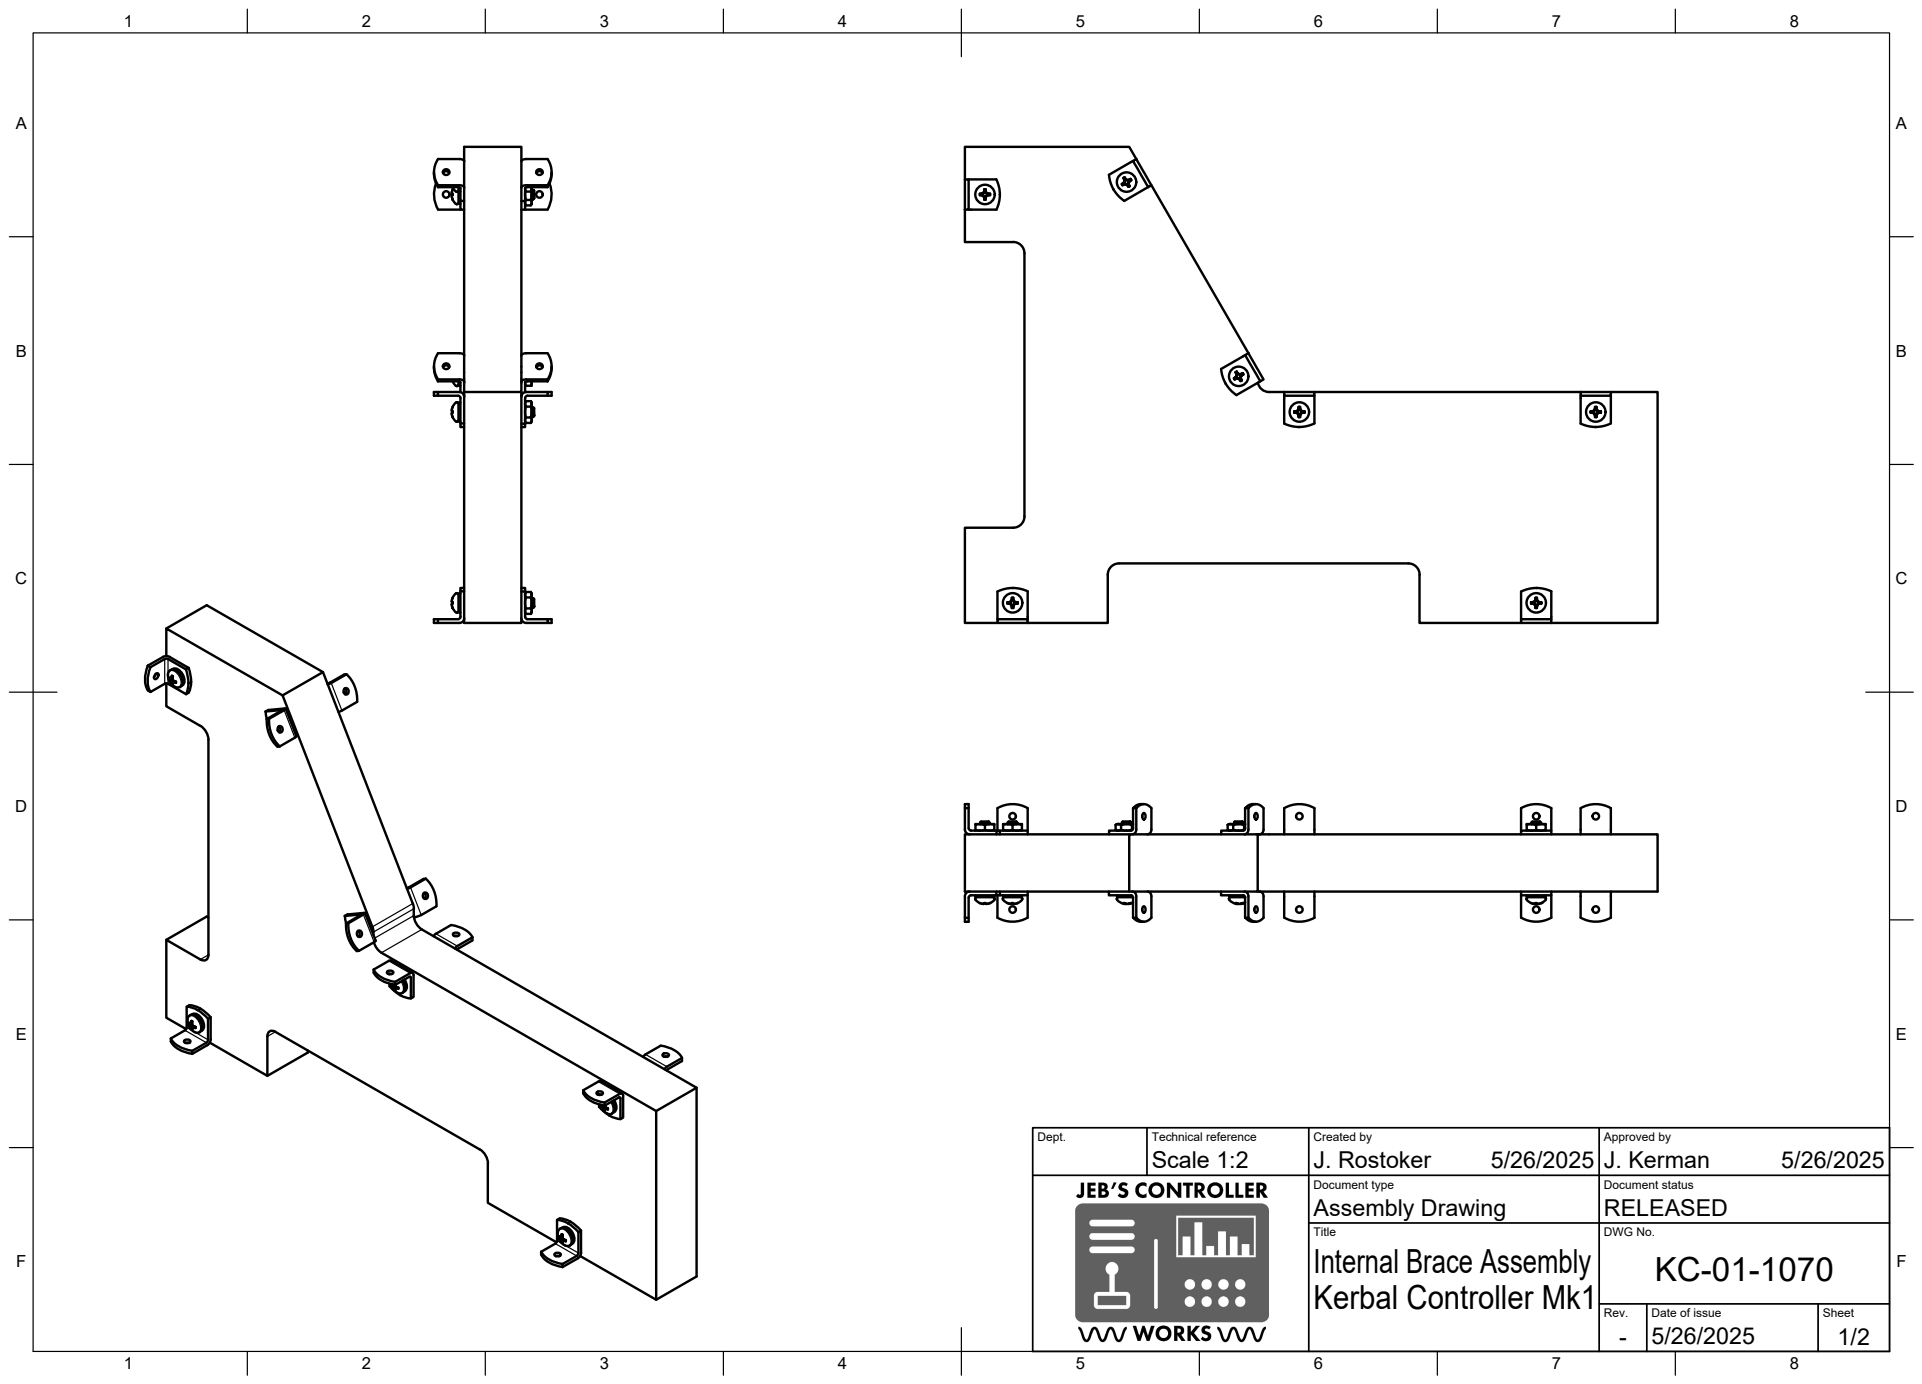
[picture p112: page 1]
Title; DWG No.; Rev.; Date of issue; Sheet -; Kerbal Controller Mk1; Internal Brace Assembly

Dept. | Technical reference Scale 1:2 | Created by J. Rostoker 5/26/2025 | Approved by J. Kerman 5/26/2025

Document type Assembly Drawing | Document status RELEASED

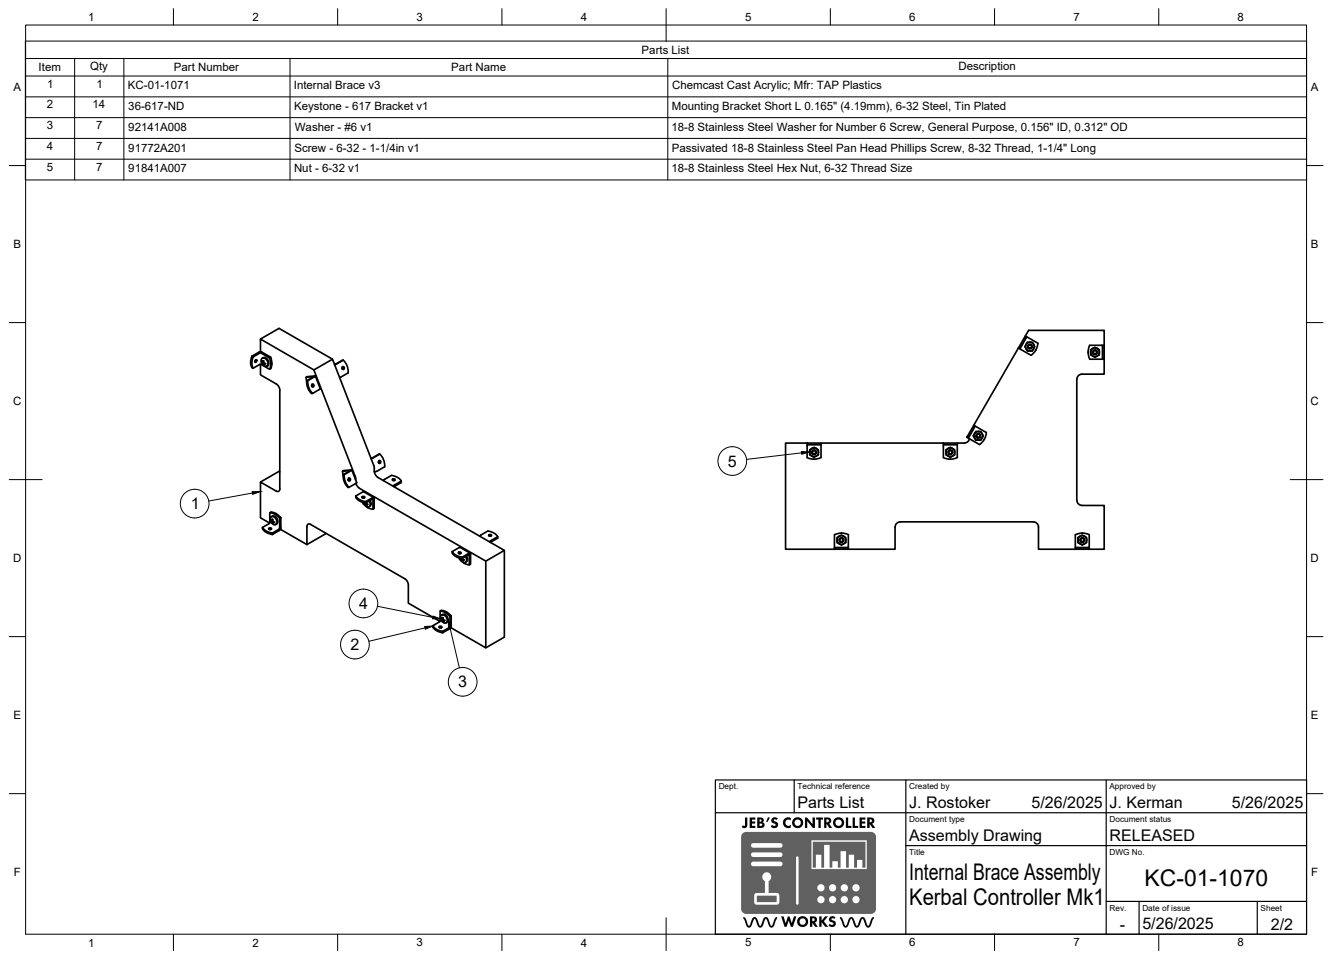
[picture p113: page 2]
Parts List

Item | Qty | Part Number | Part Name | Description
1 | 1 | KC-01-1071 | Internal Brace v3 | Chemcast Cast Acrylic; Mfr: TAP Plastics
2 | 14 | 36-617-ND | Keystone - 617 Bracket v1 | Mounting Bracket Short L 0.165" (4.19mm), 6-32 Steel, Tin Plated
3 | 7 | 92141A008 | Washer - #6 v1 | 18-8 Stainless Steel Washer for Number 6 Screw, General Purpose, 0.156" ID, 0.312" OD
4 | 7 | 91772A201 | Screw - 6-32 - 1-1/4in v1 | Passivated 18-8 Stainless Steel Pan Head Phillips Screw, 8-32 Thread, 1-1/4" Long
5 | 7 | 91841A007 | Nut - 6-32 v1 | 18-8 Stainless Steel Hex Nut, 6-32 Thread Size

Dept. | Technical reference Parts List | Created by J. Rostoker 5/26/2025 | Approved by J. Kerman 5/26/2025

Document type Assembly Drawing | Document status RELEASED

Title Internal Brace Assembly Kerbal Controller Mk1 | DWG No. KC-01-1070

Rev. | Date of issue 5/26/2025 | Sheet -2/2
