bigJRo/KerbalControllerMk1/Documents/Drawings/KC-01-1911_V2.1_7in TFT Display Driver_SCH.pdf

# +3.3V Regulator

# Microcontroller

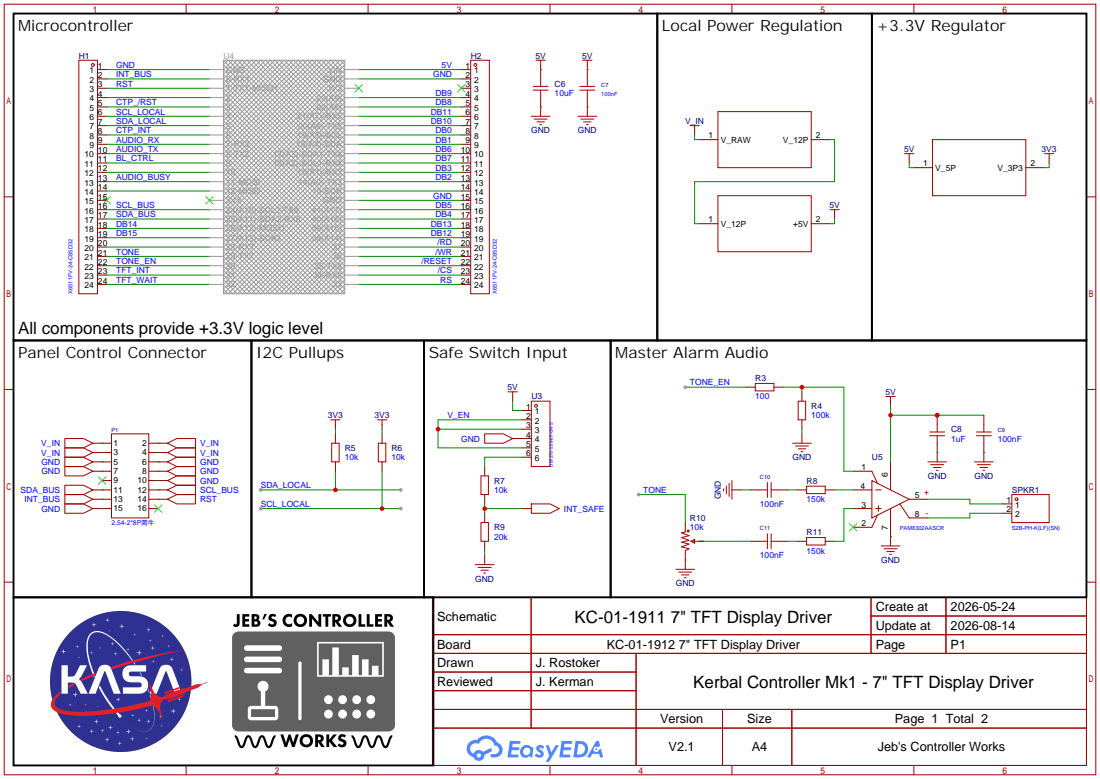
[picture p114: page 1]

Schematic | KC-01-1911 7" TFT Display Driver | Create at | 2026-05-24

Update at | 2026-08-14

Board | KC-01-1912 7" TFT Display Driver | Page | P1
Drawn | J. Rostoker | Kerbal Controller Mk1 - 7" TFT Display Driver
Reviewed | J. Kerman

Version | Size | Page 1 Total 2
V2.1 | A4 | Jeb's Controller Works

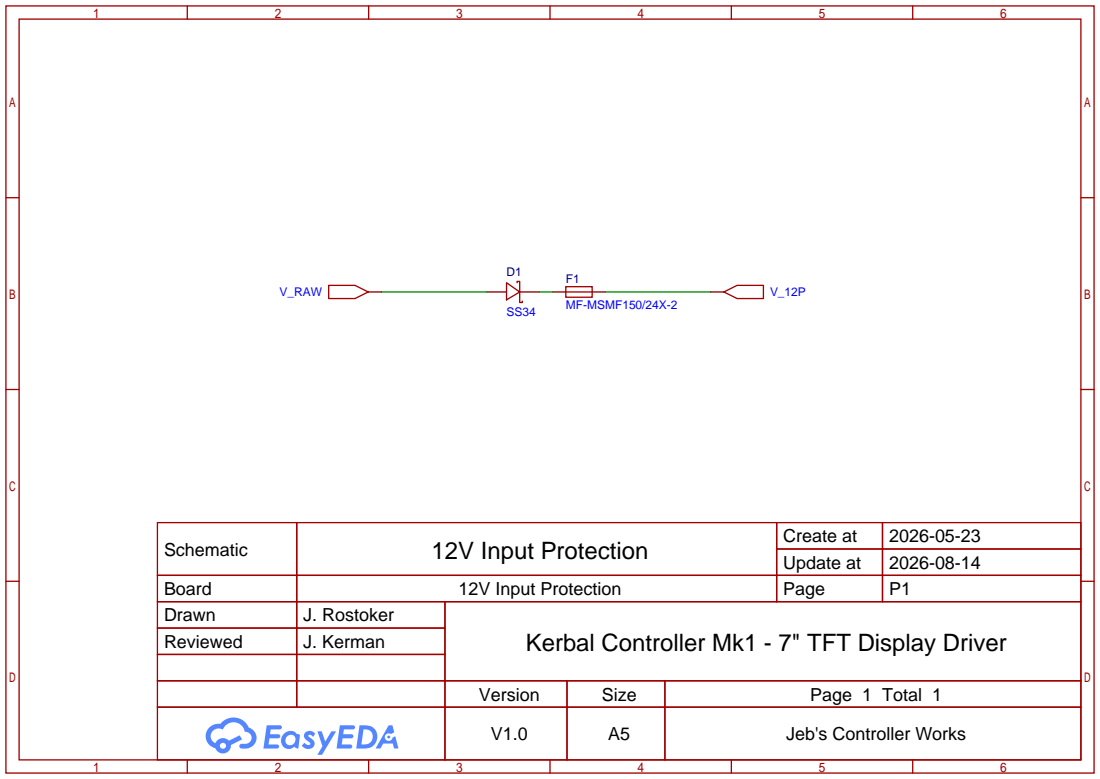
[picture p115: page 2]

Schematic | 12V Input Protection | Create at | 2026-05-23

Update at | 2026-08-14

Board | 12V Input Protection | Page | P1
Drawn | J. Rostoker | Kerbal Controller Mk1 - 7" TFT Display Driver
Reviewed | J. Kerman

Version | Size | Page 1 Total 1
V1.0 | A5 | Jeb's Controller Works

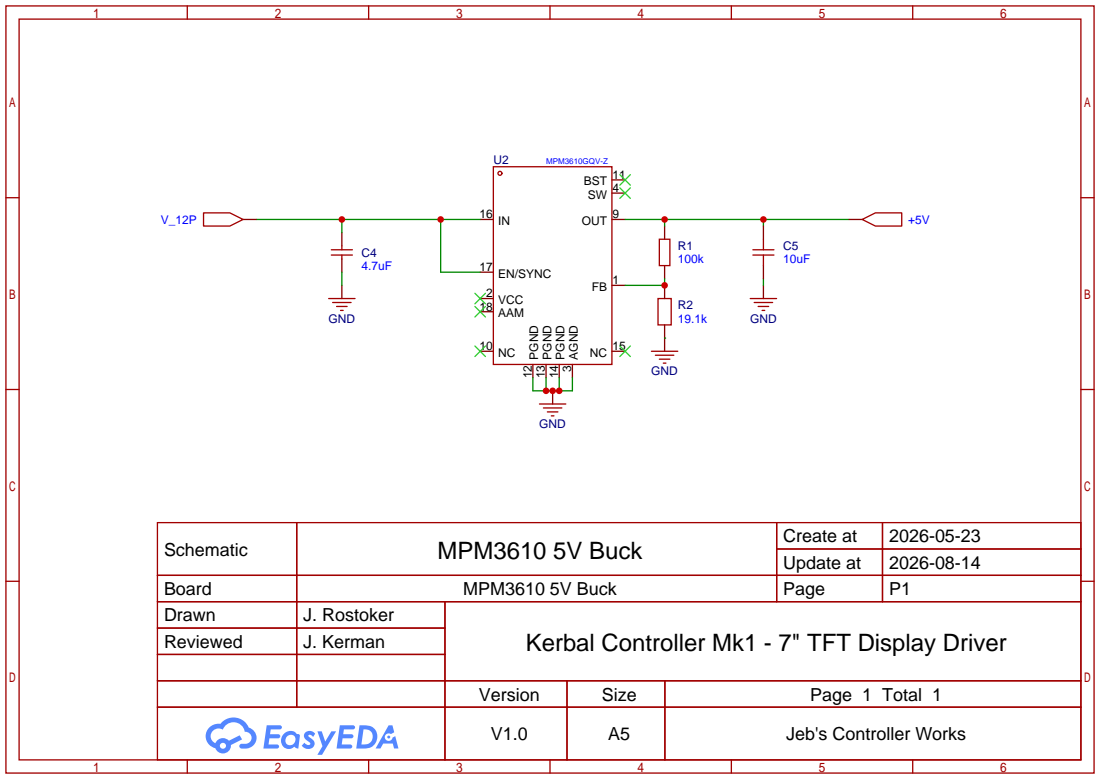
[picture p116: page 3]

Schematic | MPM3610 5V Buck | Create at | 2026-05-23

Update at | 2026-08-14

Board | MPM3610 5V Buck | Page | P1
Drawn | J. Rostoker | Kerbal Controller Mk1 - 7" TFT Display Driver
Reviewed | J. Kerman

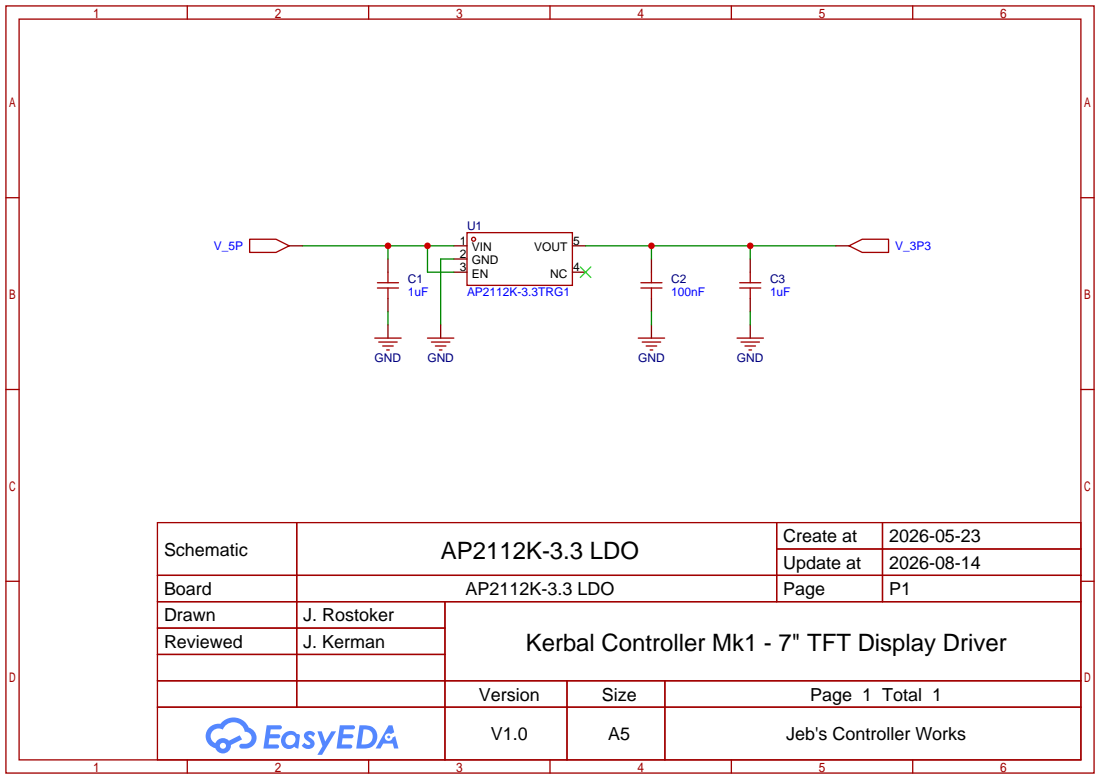
[picture p117: page 4]

Schematic | AP2112K-3.3 LDO | Create at | 2026-05-23

Update at | 2026-08-14

Board | AP2112K-3.3 LDO | Page | P1
Drawn | J. Rostoker | Kerbal Controller Mk1 - 7" TFT Display Driver
Reviewed | J. Kerman

# TFT Display Connector

## 7 inch 1024x600 IPS TFT Touch Display Module with I2C SPI for Arduino

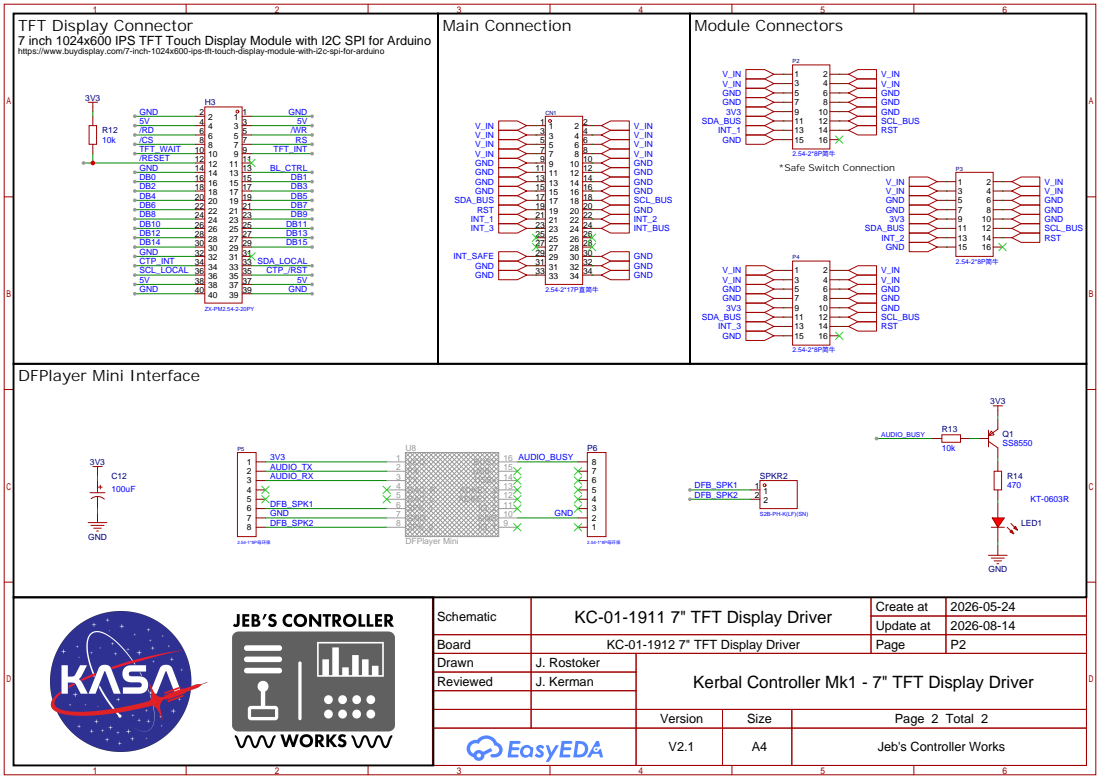
[picture p118: page 5]

https://www.buydisplay.com/7-inch-1024x600-ips-tft-touch-display-module-with-i2c-spi-for-arduino

GND 10 IO_2 11 ADKEY_1 12 ADKEY_2 13 USB+ 14 USB- 15 BUSY 16

Schematic | KC-01-1911 7" TFT Display Driver | Create at | 2026-05-24

Update at | 2026-08-14

Board | KC-01-1912 7" TFT Display Driver | Page | P2
Drawn | J. Rostoker | Kerbal Controller Mk1 - 7" TFT Display Driver
Reviewed | J. Kerman

Version | Size | Page 2 Total 2
V2.1 | A4 | Jeb's Controller Works
