bigJRo/KerbalControllerMk1/Documents/Drawings/KC-01-1010_Rev-_Kerbal Controller - Acrylic Box.pdf

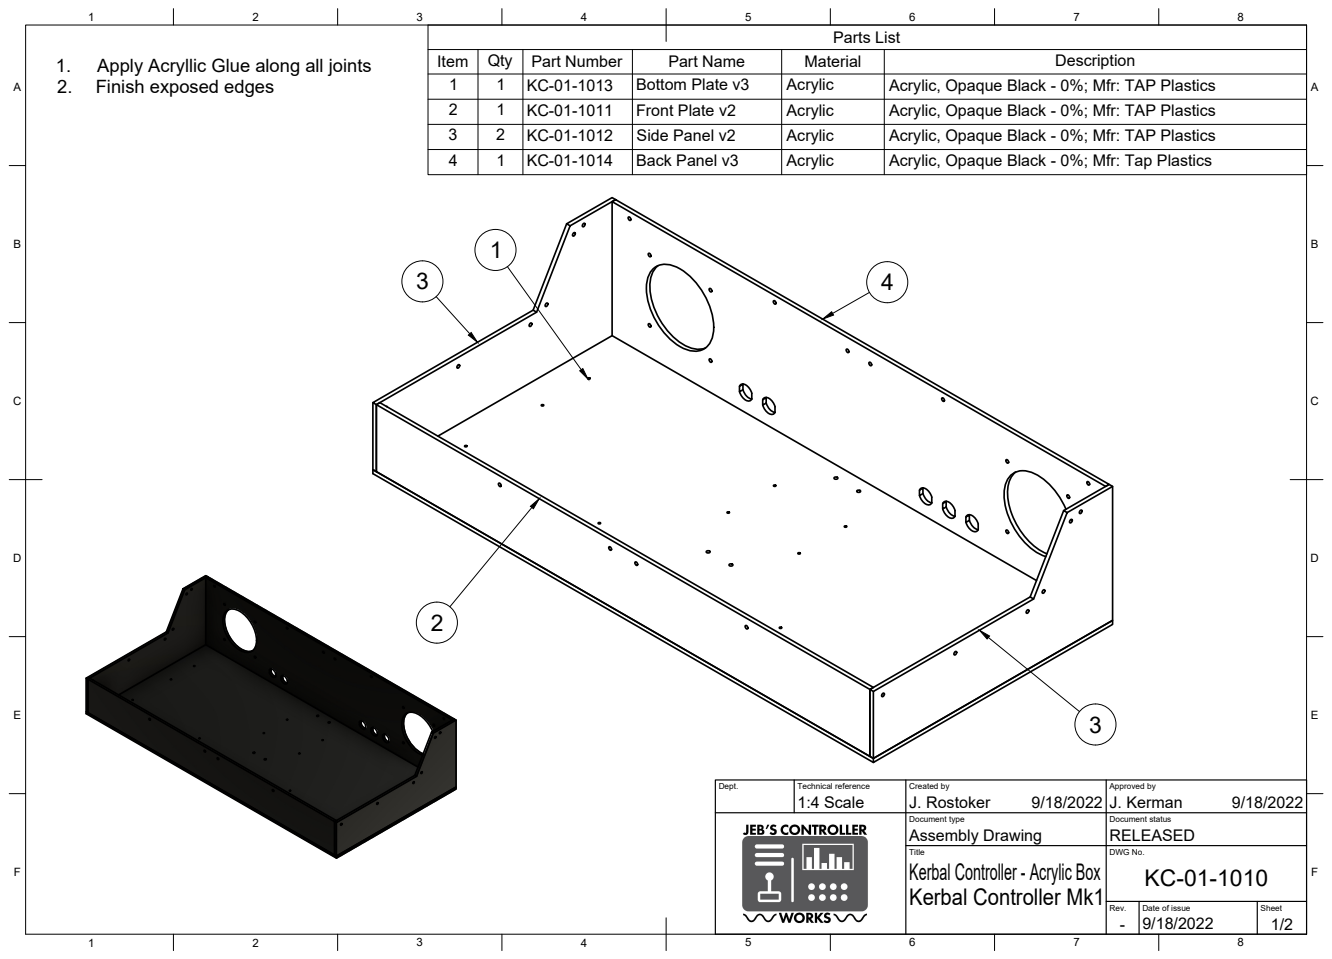
[picture p119: page 1]
Title; DWG No.; Rev.; Date of issue; Sheet -; Kerbal Controller Mk1; Kerbal Controller - Acrylic Box; Parts List

1. Apply Acryllic Glue along all joints
2. Finish exposed edges

Item | Qty | Part Number | Part Name | Material | Description
1 | 1 | KC-01-1013 | Bottom Plate v3 | Acrylic | Acrylic, Opaque Black - 0%; Mfr: TAP Plastics
2 | 1 | KC-01-1011 | Front Plate v2 | Acrylic | Acrylic, Opaque Black - 0%; Mfr: TAP Plastics
3 | 2 | KC-01-1012 | Side Panel v2 | Acrylic | Acrylic, Opaque Black - 0%; Mfr: TAP Plastics
4 | 1 | KC-01-1014 | Back Panel v3 | Acrylic | Acrylic, Opaque Black - 0%; Mfr: Tap Plastics

Dept. | Technical reference 1:4 Scale | Created by J. Rostoker 9/18/2022 | Approved by J. Kerman 9/18/2022

Document type Assembly Drawing | Document status RELEASED

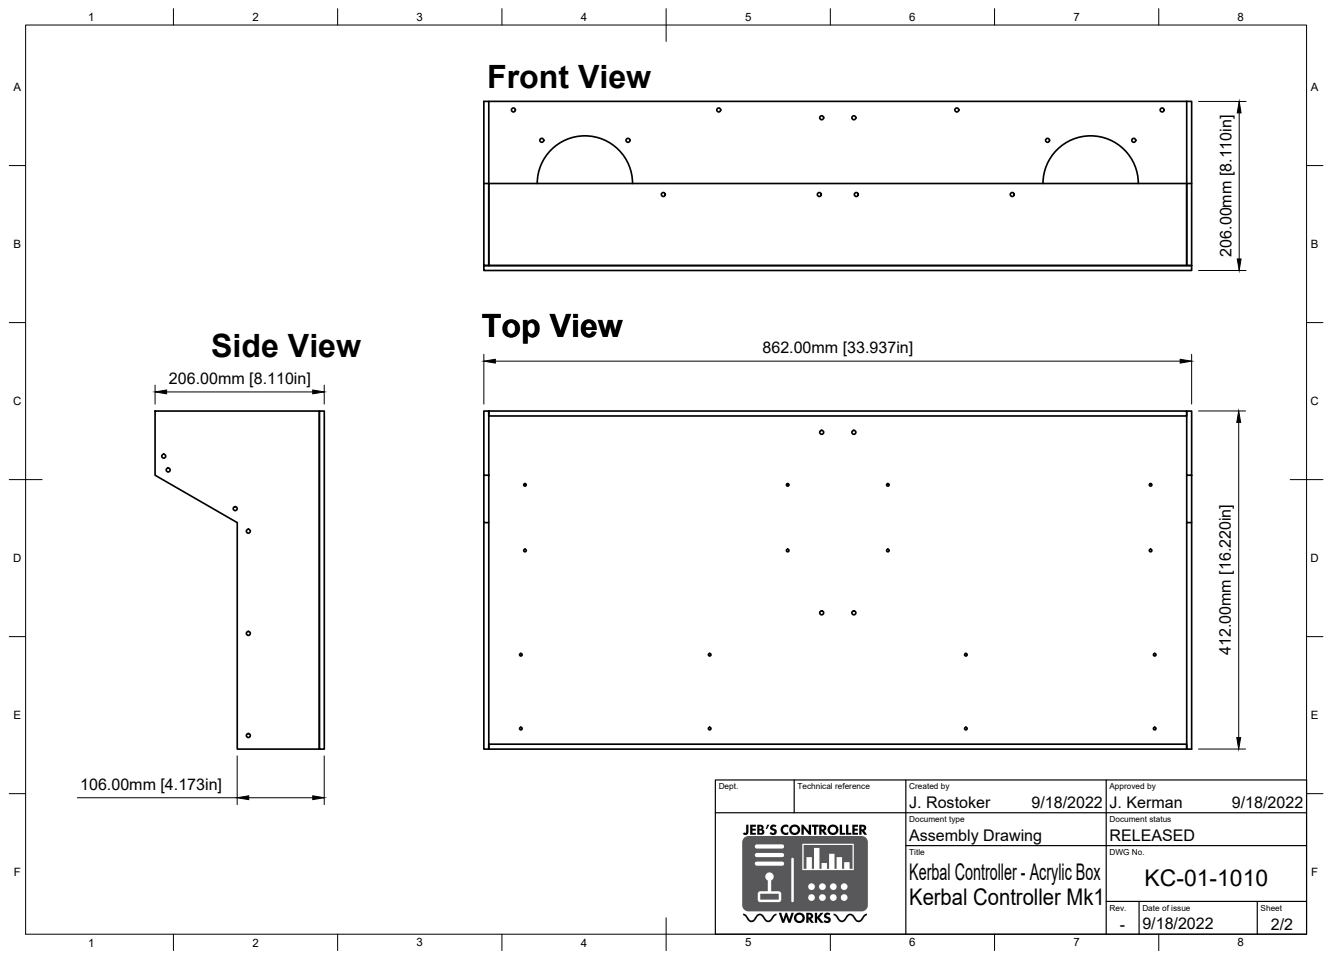
[picture p120: page 2]
Title; DWG No.; Rev.; Date of issue; Sheet -; Kerbal Controller Mk1; Kerbal Controller - Acrylic Box; J. Rostoker; J. Kerman; Top View; Front View; Side View

Dept. | Technical reference | Created by 9/18/2022 | Approved by 9/18/2022

Document type Assembly Drawing | Document status RELEASED
