bigJRo/KerbalControllerMk1/Documents/Drawings/KC-01-1011_Rev-_Front Plate.pdf

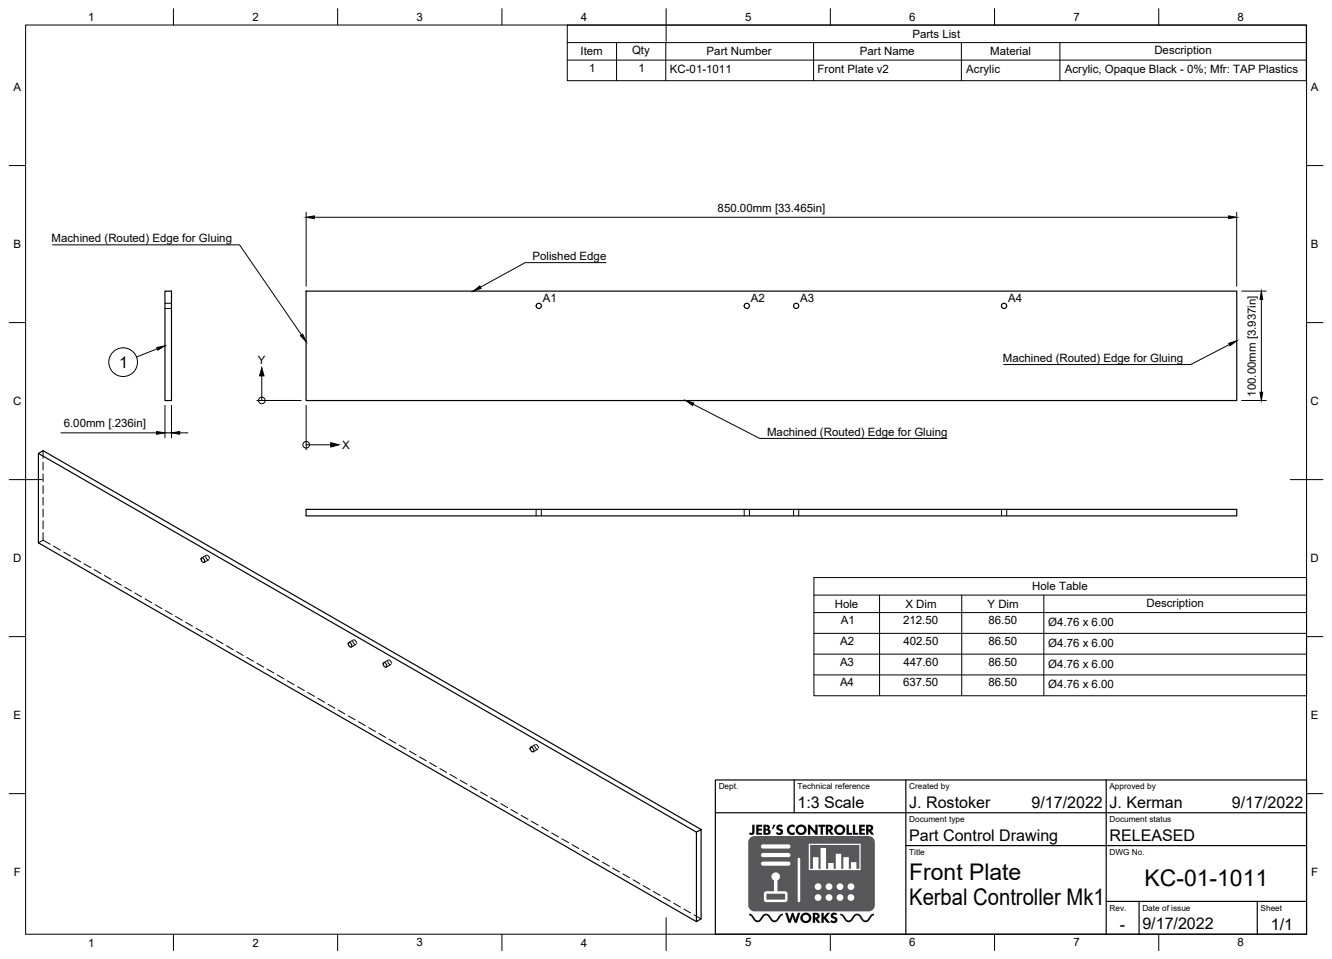
[picture p121: page 1]
Title; DWG No.; Rev.; Date of issue; Sheet -; Kerbal Controller Mk1; Front Plate; Polished Edge; Machined (Routed) Edge for Gluing; Hole Table

Parts List

Item | Qty | Part Number | Part Name | Material | Description
1 | 1 | KC-01-1011 | Front Plate v2 | Acrylic | Acrylic, Opaque Black - 0%; Mfr: TAP Plastics

Machined (Routed) Edge for Gluing

Hole | X Dim | Y Dim | Description
A1 | 212.50 | 86.50 | Ø4.76 x 6.00
A2 | 402.50 | 86.50 | Ø4.76 x 6.00
A3 | 447.60 | 86.50 | Ø4.76 x 6.00
A4 | 637.50 | 86.50 | Ø4.76 x 6.00

Dept. | Technical reference 1:3 Scale | Created by J. Rostoker 9/17/2022 | Approved by J. Kerman 9/17/2022

Document type Part Control Drawing | Document status RELEASED
