bigJRo/KerbalControllerMk1/Documents/Drawings/KC-01-1012_Rev-_Side Panel.pdf

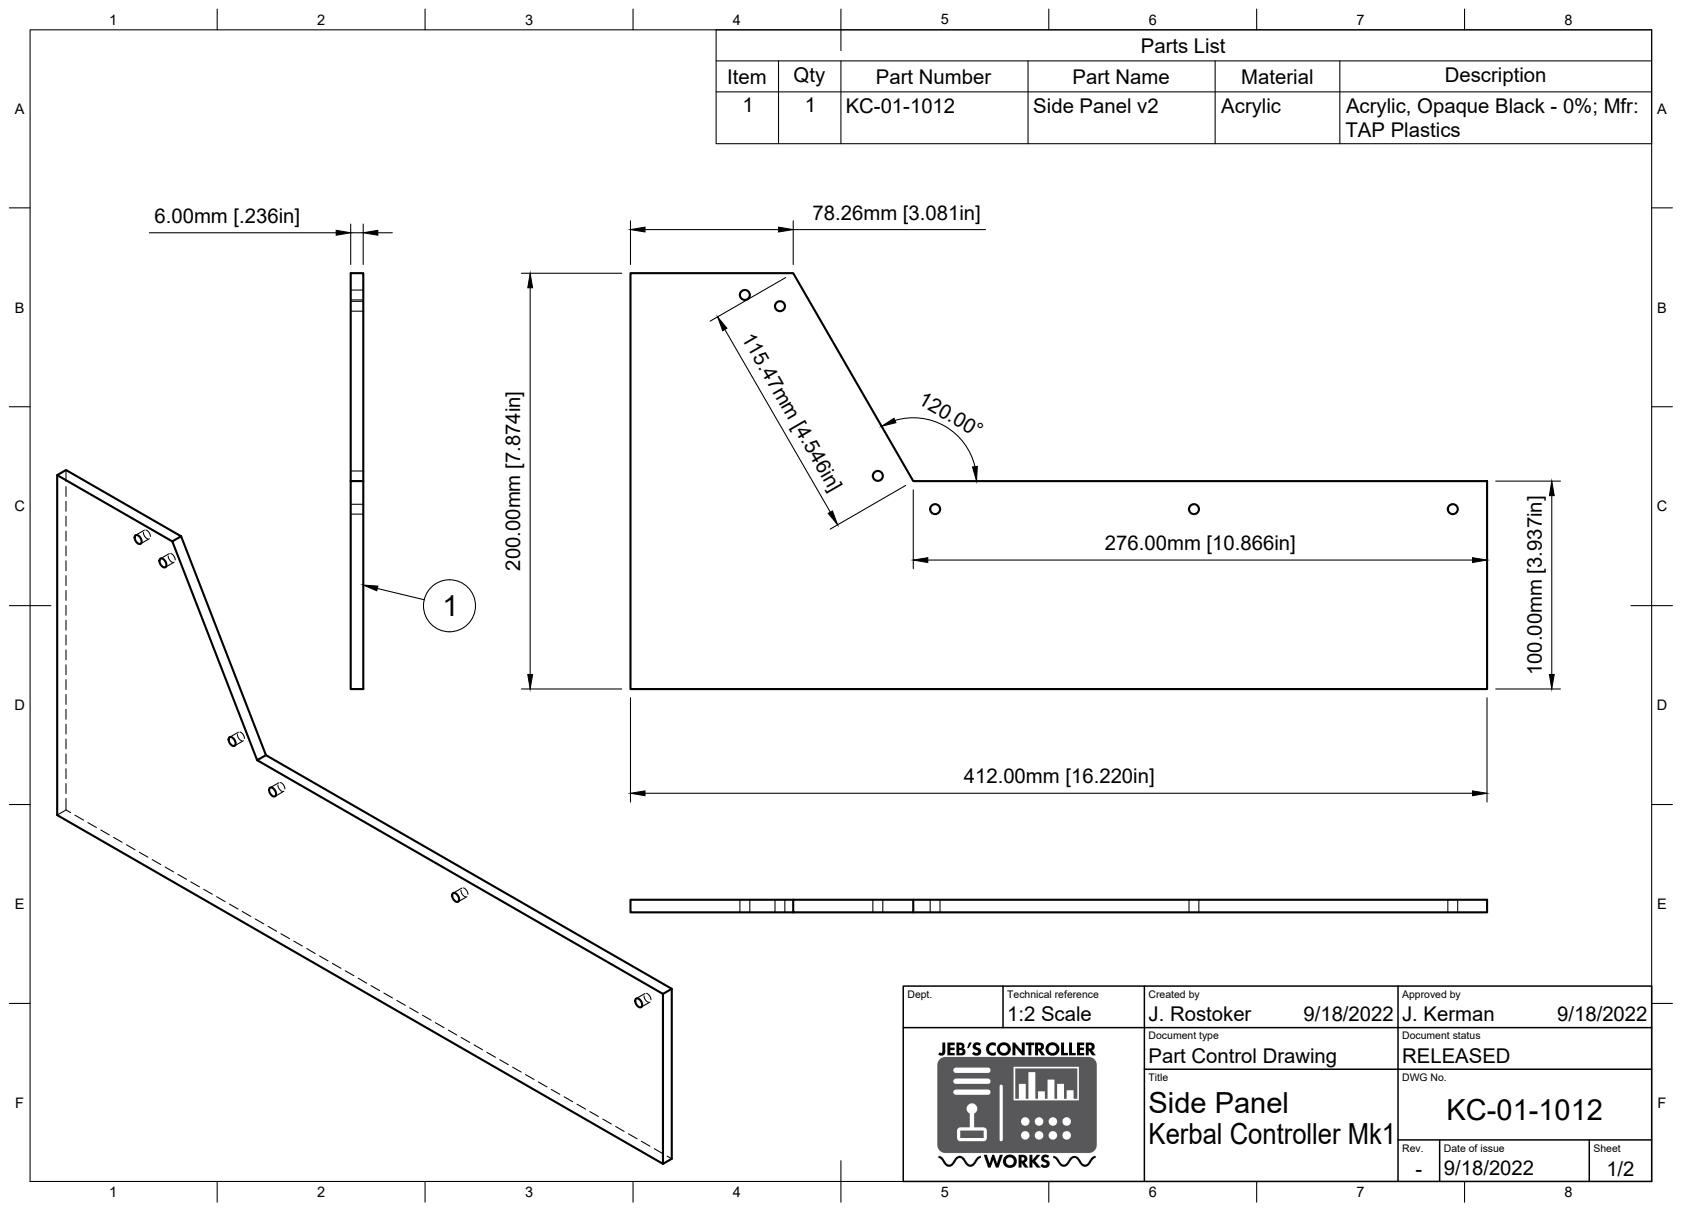
[picture p122: page 1]
Title; DWG No.; Rev.; Date of issue; Sheet -; Kerbal Controller Mk1; Side Panel; Parts List

Item | Qty | Part Number | Part Name | Material | Description
1 | 1 | KC-01-1012 | Side Panel v2 | Acrylic | Acrylic, Opaque Black - 0%; Mfr: TAP Plastics

Dept. | Technical reference 1:2 Scale | Created by J. Rostoker 9/18/2022 | Approved by J. Kerman 9/18/2022

Document type Part Control Drawing | Document status RELEASED

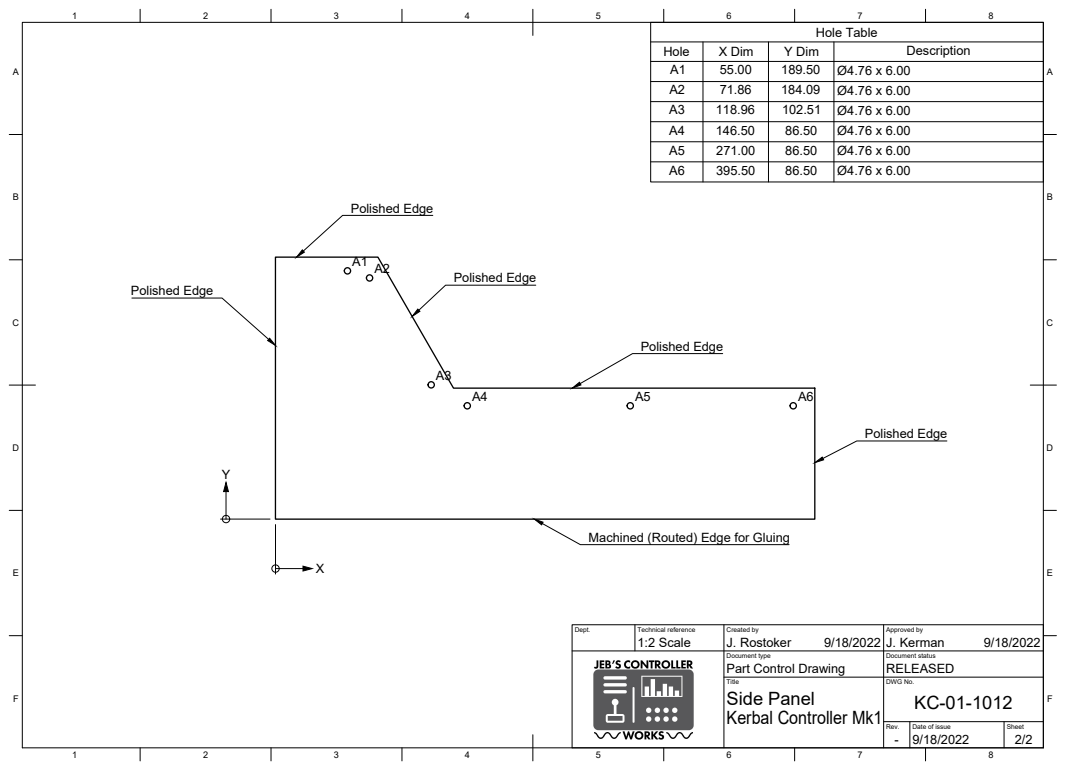
[picture p123: page 2]
Title; DWG No.; Rev.; Date of issue; Sheet -; Kerbal Controller Mk1; Side Panel; Hole Table; Polished Edge

Hole | X Dim | Y Dim | Description
A1 | 55.00 | 189.50 | Ø4.76 x 6.00
A2 | 71.86 | 184.09 | Ø4.76 x 6.00
A3 | 118.96 | 102.51 | Ø4.76 x 6.00
A4 | 146.50 | 86.50 | Ø4.76 x 6.00
A5 | 271.00 | 86.50 | Ø4.76 x 6.00
A6 | 395.50 | 86.50 | Ø4.76 x 6.00

Machined (Routed) Edge for Gluing

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

Document type Part Control Drawing | Document status RELEASED
