bigJRo/KerbalControllerMk1/Documents/Drawings/KC-01-1013_Rev-_Bottom Plate.pdf

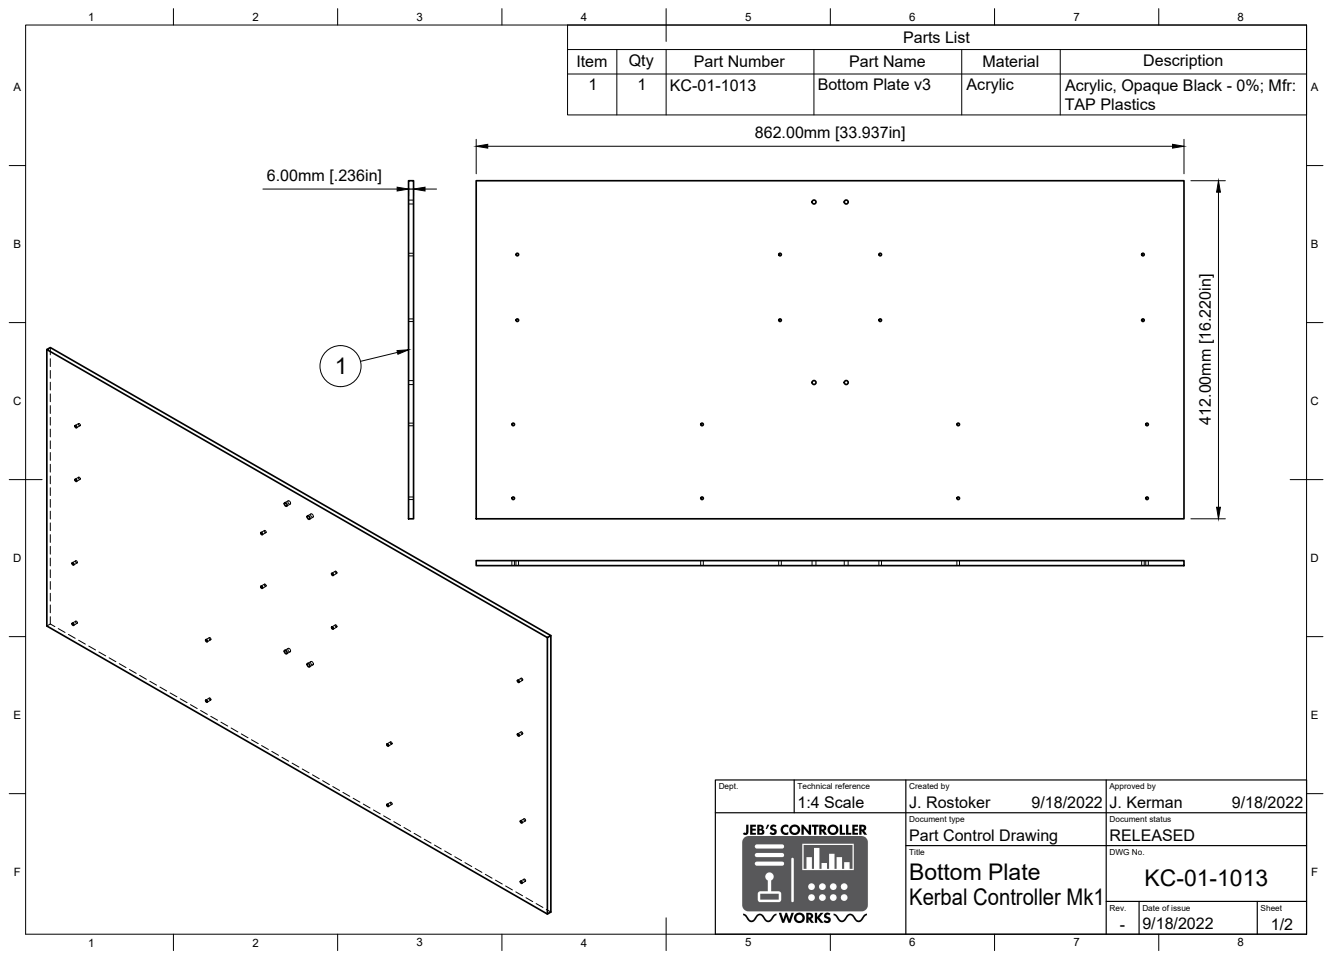
[picture p124: page 1]
Title; DWG No.; Rev.; Date of issue; Sheet -; Kerbal Controller Mk1; Bottom Plate; Parts List

Item | Qty | Part Number | Part Name | Material | Description
1 | 1 | KC-01-1013 | Bottom Plate v3 | Acrylic | Acrylic, Opaque Black - 0%; Mfr: TAP Plastics

Dept. | Technical reference 1:4 Scale | Created by J. Rostoker 9/18/2022 | Approved by J. Kerman 9/18/2022

Document type Part Control Drawing | Document status RELEASED

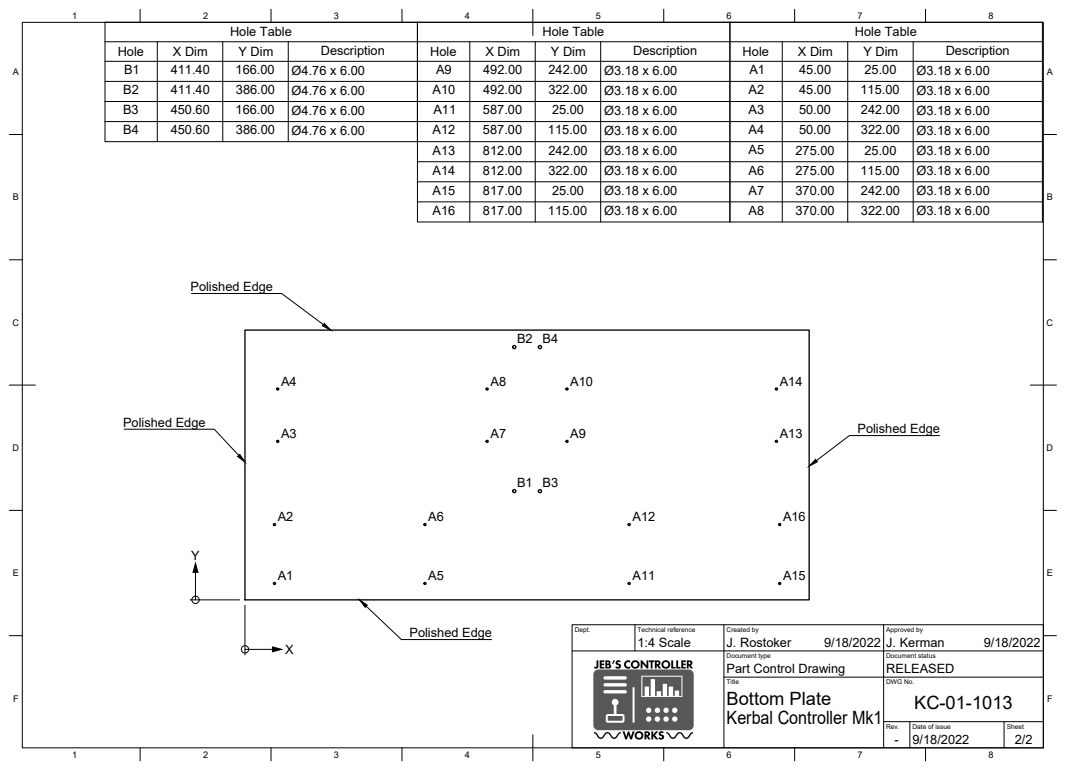
[picture p125: page 2]
Title; DWG No.; Rev.; Date of issue; Sheet -; Kerbal Controller Mk1; Bottom Plate; Hole Table; Polished Edge

Hole Table | | | Hole Table

Hole | X Dim | Y Dim | Description | Hole | X Dim | Y Dim | Description | Hole | X Dim | Y Dim | Description
B1 | 411.40 | 166.00 | Ø4.76 x 6.00 | A9 | 492.00 | 242.00 | Ø3.18 x 6.00 | A1 | 45.00 | 25.00 | Ø3.18 x 6.00
B2 | 411.40 | 386.00 | Ø4.76 x 6.00 | A10 | 492.00 | 322.00 | Ø3.18 x 6.00 | A2 | 45.00 | 115.00 | Ø3.18 x 6.00
B3 | 450.60 | 166.00 | Ø4.76 x 6.00 | A11 | 587.00 | 25.00 | Ø3.18 x 6.00 | A3 | 50.00 | 242.00 | Ø3.18 x 6.00
B4 | 450.60 | 386.00 | Ø4.76 x 6.00 | A12 | 587.00 | 115.00 | Ø3.18 x 6.00 | A4 | 50.00 | 322.00 | Ø3.18 x 6.00

A13 | 812.00 | 242.00 | Ø3.18 x 6.00 | A5 | 275.00 | 25.00 | Ø3.18 x 6.00
A14 | 812.00 | 322.00 | Ø3.18 x 6.00 | A6 | 275.00 | 115.00 | Ø3.18 x 6.00
A15 | 817.00 | 25.00 | Ø3.18 x 6.00 | A7 | 370.00 | 242.00 | Ø3.18 x 6.00
A16 | 817.00 | 115.00 | Ø3.18 x 6.00 | A8 | 370.00 | 322.00 | Ø3.18 x 6.00

Dept. | Technical reference 1:4 Scale | Created by J. Rostoker 9/18/2022 | Approved by J. Kerman X 9/18/2022

Document type Part Control Drawing | Document status RELEASED
