bigJRo/KerbalControllerMk1/Documents/Drawings/KC-01-1014_Rev-_Back Panel.pdf

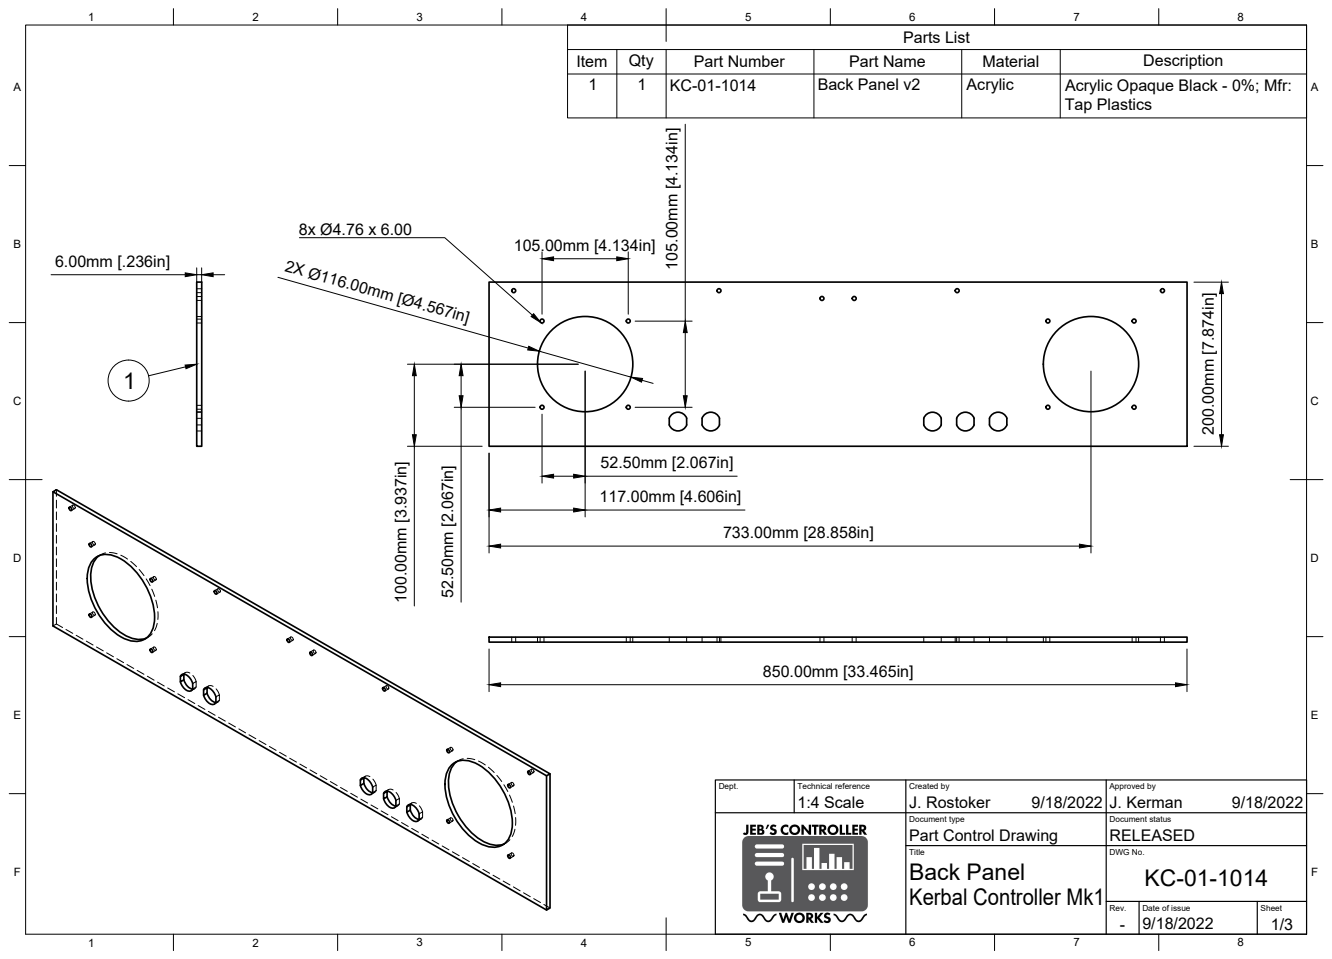
[picture p126: page 1]
Title; DWG No.; Rev.; Date of issue; Sheet -; Kerbal Controller Mk1; Back Panel; 1:4 Scale; J. Rostoker; J. Kerman; Parts List

Item | Qty | Part Number | Part Name | Material | Description
1 | 1 | KC-01-1014 | Back Panel v2 | Acrylic | Acrylic Opaque Black - 0%; Mfr: Tap Plastics

Dept. | Technical reference | Created by 9/18/2022 | Approved by 9/18/2022

Document type Part Control Drawing | Document status RELEASED

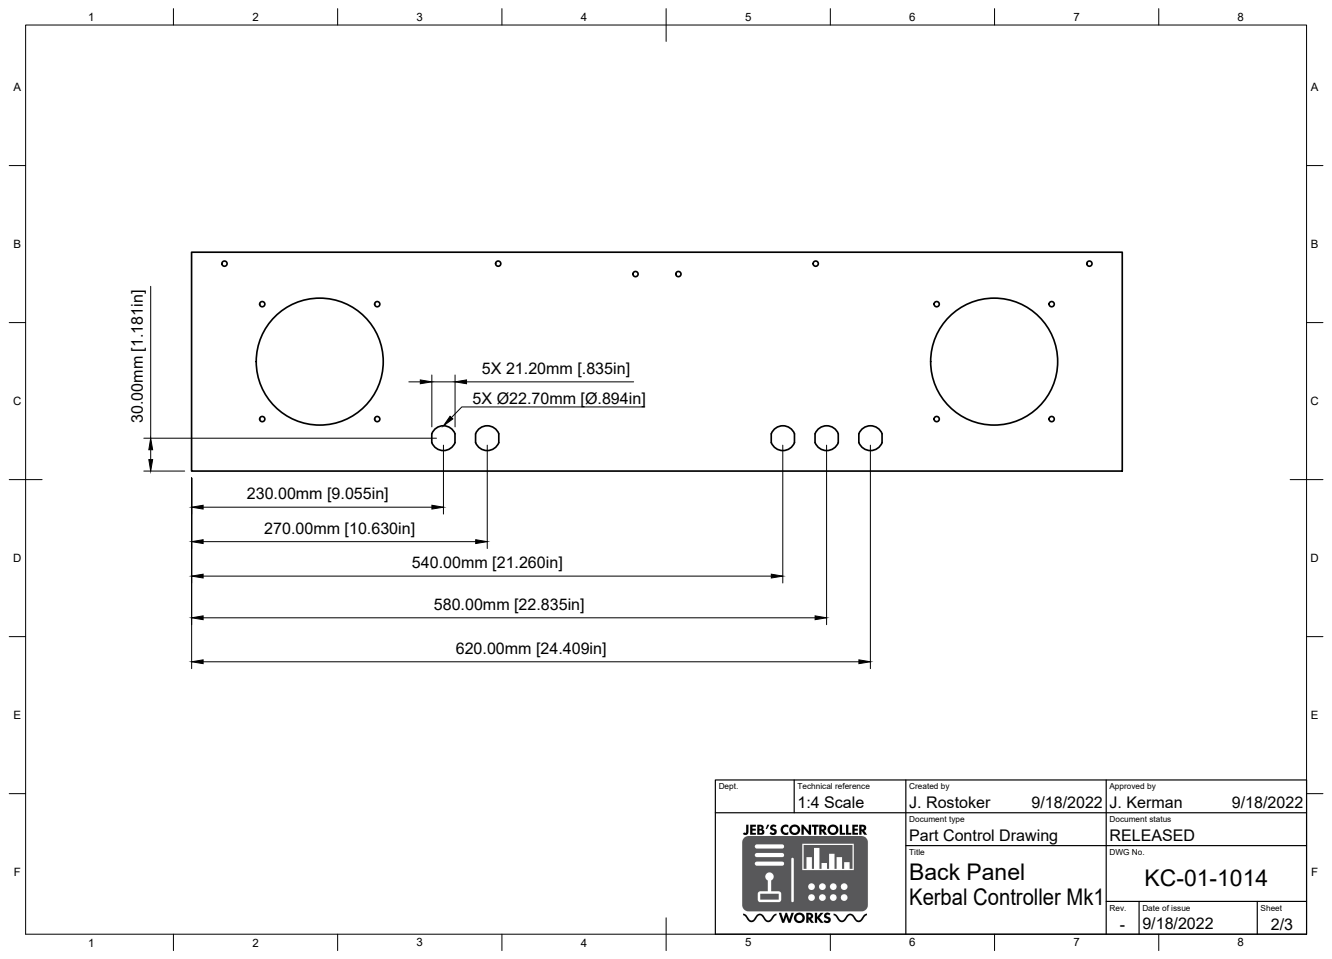
[picture p127: page 2]
Title; DWG No.; Back Panel; 1:4 Scale; J. Rostoker; J. Kerman 30.00mm [1.181in]

Dept. | Technical reference | Created by 9/18/2022 | Approved by 9/18/2022

Document type Part Control Drawing | Document status RELEASED

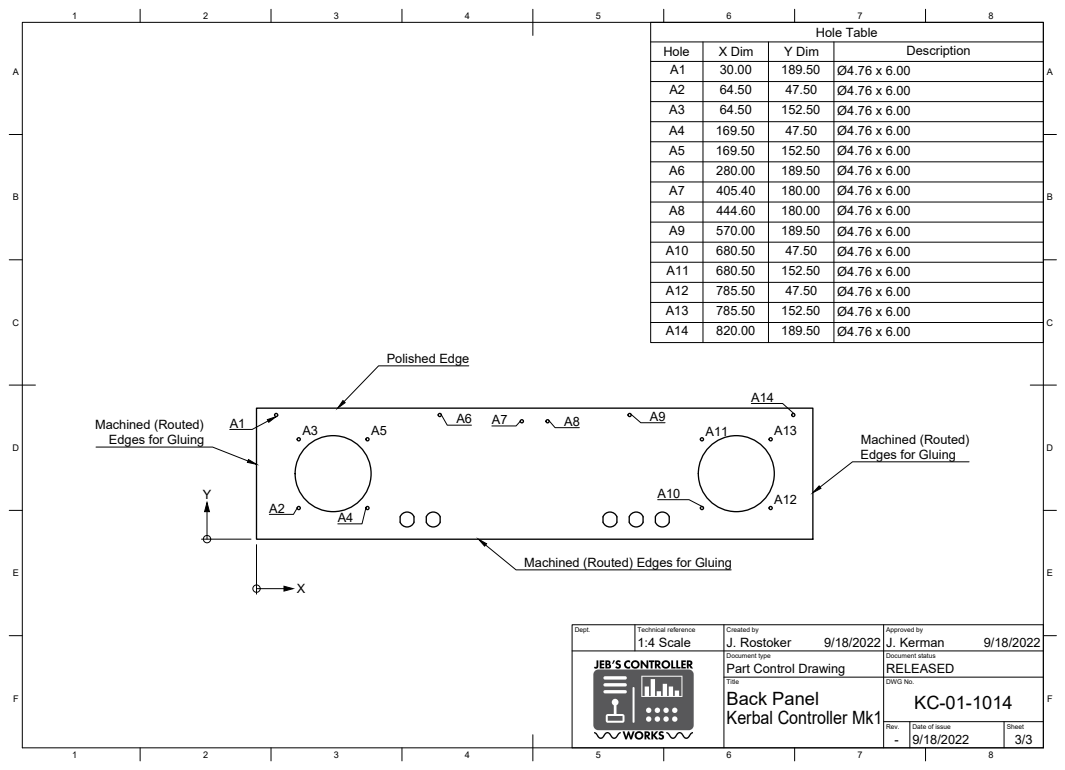
[picture p128: page 3]
Title; DWG No.; Back Panel; Hole Table; Polished Edge

Hole | X Dim | Y Dim | Description
A1 | 30.00 | 189.50 | Ø4.76 x 6.00
A2 | 64.50 | 47.50 | Ø4.76 x 6.00
A3 | 64.50 | 152.50 | Ø4.76 x 6.00
A4 | 169.50 | 47.50 | Ø4.76 x 6.00
A5 | 169.50 | 152.50 | Ø4.76 x 6.00
A6 | 280.00 | 189.50 | Ø4.76 x 6.00
A7 | 405.40 | 180.00 | Ø4.76 x 6.00
A8 | 444.60 | 180.00 | Ø4.76 x 6.00
A9 | 570.00 | 189.50 | Ø4.76 x 6.00
A10 | 680.50 | 47.50 | Ø4.76 x 6.00
A11 | 680.50 | 152.50 | Ø4.76 x 6.00
A12 | 785.50 | 47.50 | Ø4.76 x 6.00
A13 | 785.50 | 152.50 | Ø4.76 x 6.00
A14 | 820.00 | 189.50 | Ø4.76 x 6.00

Machined (Routed)
Edges for Gluing

Machined (Routed) Edges for Gluing

Dept. | Technical reference 1:4 Scale | Created by J. Rostoker 9/18/2022 | Approved by J. Kerman 9/18/2022

Document type Part Control Drawing | Document status RELEASED
