bigJRo/KerbalControllerMk1/Documents/Drawings/KC-01-1020_RevA_Panel A1 Complete.pdf

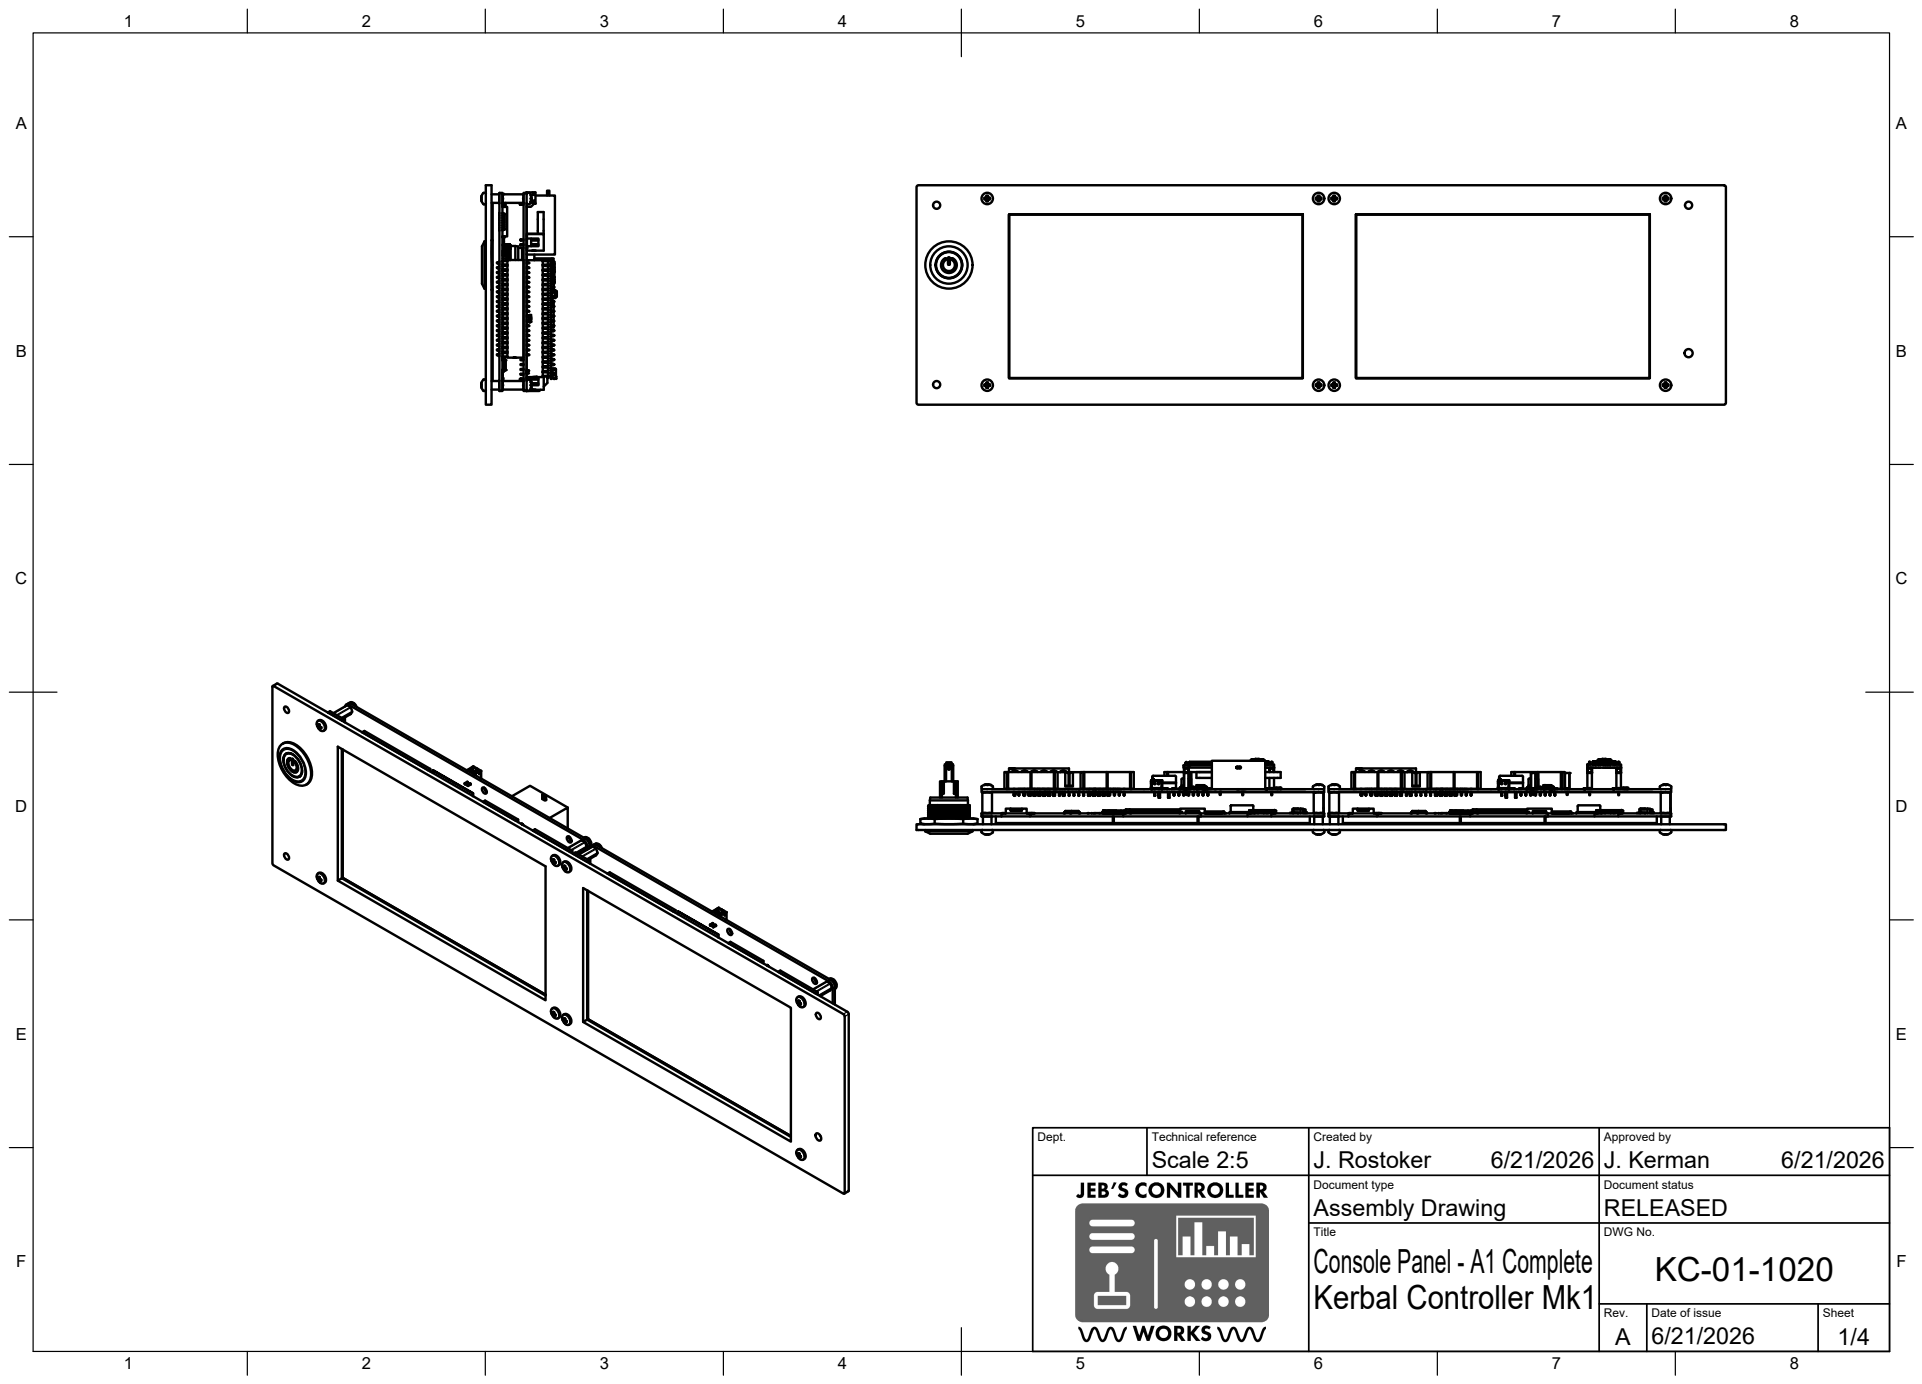
[picture p129: page 1]
Dept.; Technical reference; Created by; Approved by; Document type; Document status; Title; DWG No.; Rev.; Date of issue; Sheet; Assembly Drawing; RELEASED; Kerbal Controller Mk1; Console Panel - A1 Complete; Scale 2:5; J. Rostoker; J. Kerman

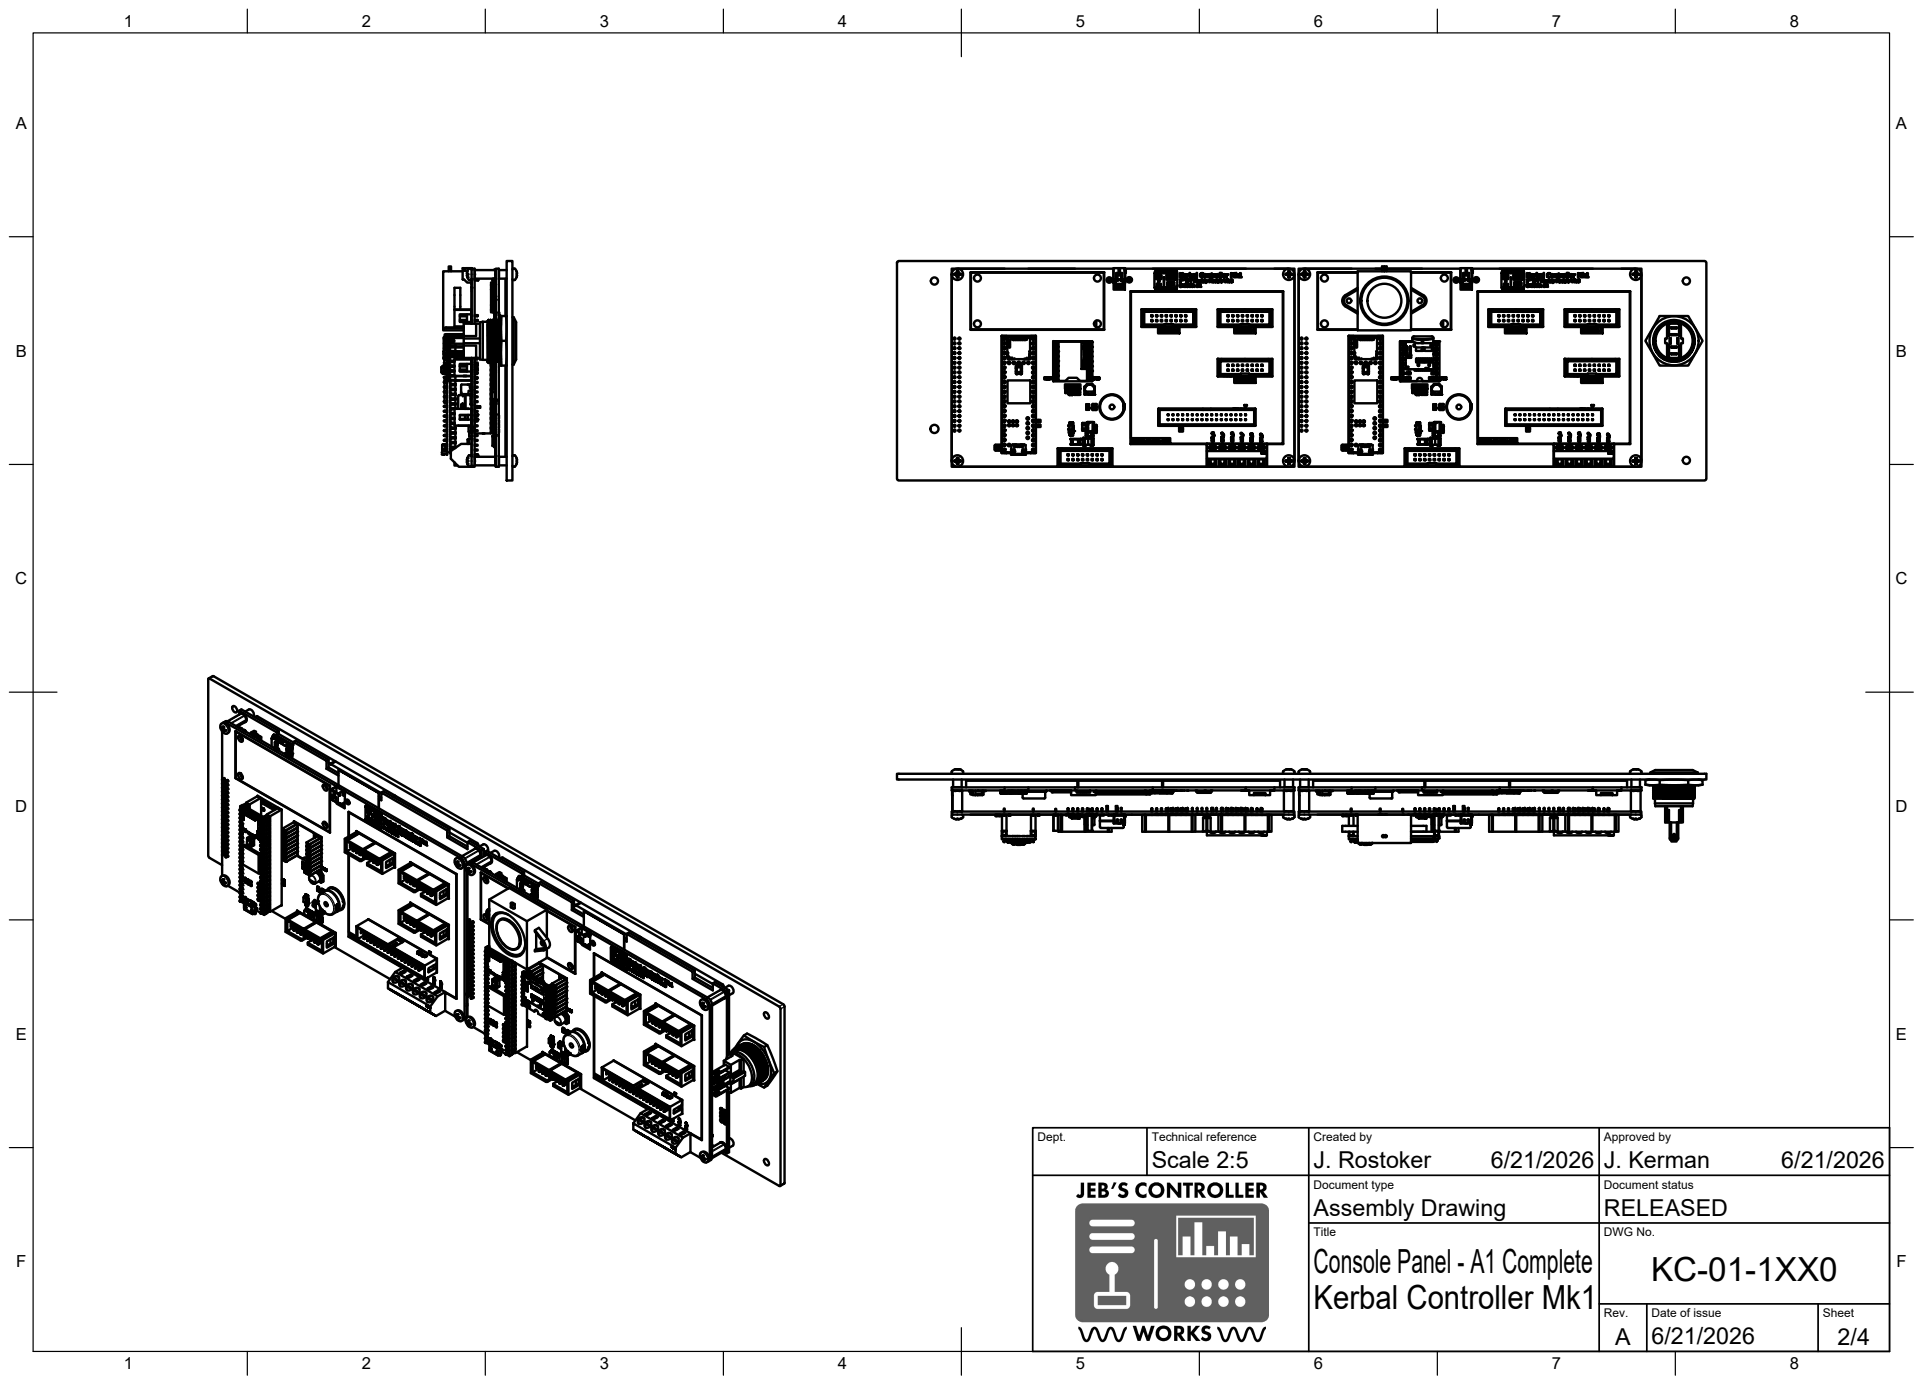
[picture p130: page 2]
Dept.; Technical reference; Created by; Approved by; Document type; Document status; Title; DWG No.; Assembly Drawing; RELEASED; Console Panel - A1 Complete; Scale 2:5; J. Rostoker; J. Kerman

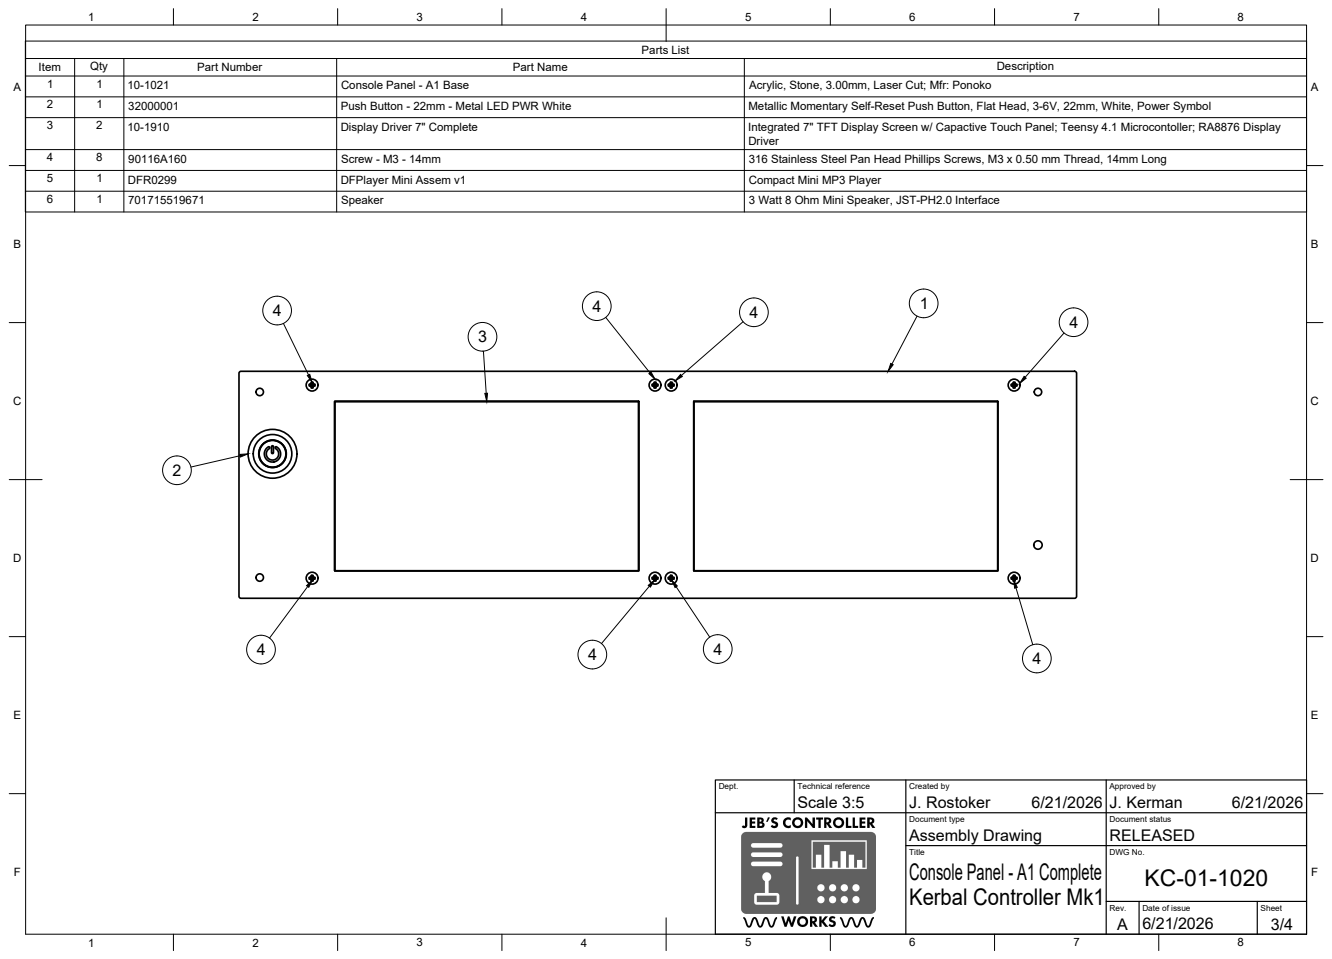
[picture p131: page 3]
Parts List

Item | Qty | Part Number | Part Name | Description
1 | 1 | 10-1021 | Console Panel - A1 Base | Acrylic, Stone, 3.00mm, Laser Cut; Mfr: Ponoko
2 | 1 | 32000001 | Push Button - 22mm - Metal LED PWR White | Metallic Momentary Self-Reset Push Button, Flat Head, 3-6V, 22mm, White, Power Symbol
3 | 2 | 10-1910 | Display Driver 7" Complete | Integrated 7" TFT Display Screen w/ Capactive Touch Panel; Teensy 4.1 Microcontoller; RA8876 Display Driver

4 | 8 | 90116A160 | Screw - M3 - 14mm | 316 Stainless Steel Pan Head Phillips Screws, M3 x 0.50 mm Thread, 14mm Long
5 | 1 | DFR0299 | DFPlayer Mini Assem v1 | Compact Mini MP3 Player
6 | 1 | 701715519671 | Speaker | 3 Watt 8 Ohm Mini Speaker, JST-PH2.0 Interface

Dept. | Technical reference Scale 3:5 | Created by J. Rostoker 6/21/2026 | Approved by J. Kerman 6/21/2026

Document type Assembly Drawing | Document status RELEASED

Title Console Panel - A1 Complete | DWG No. KC-01-1020

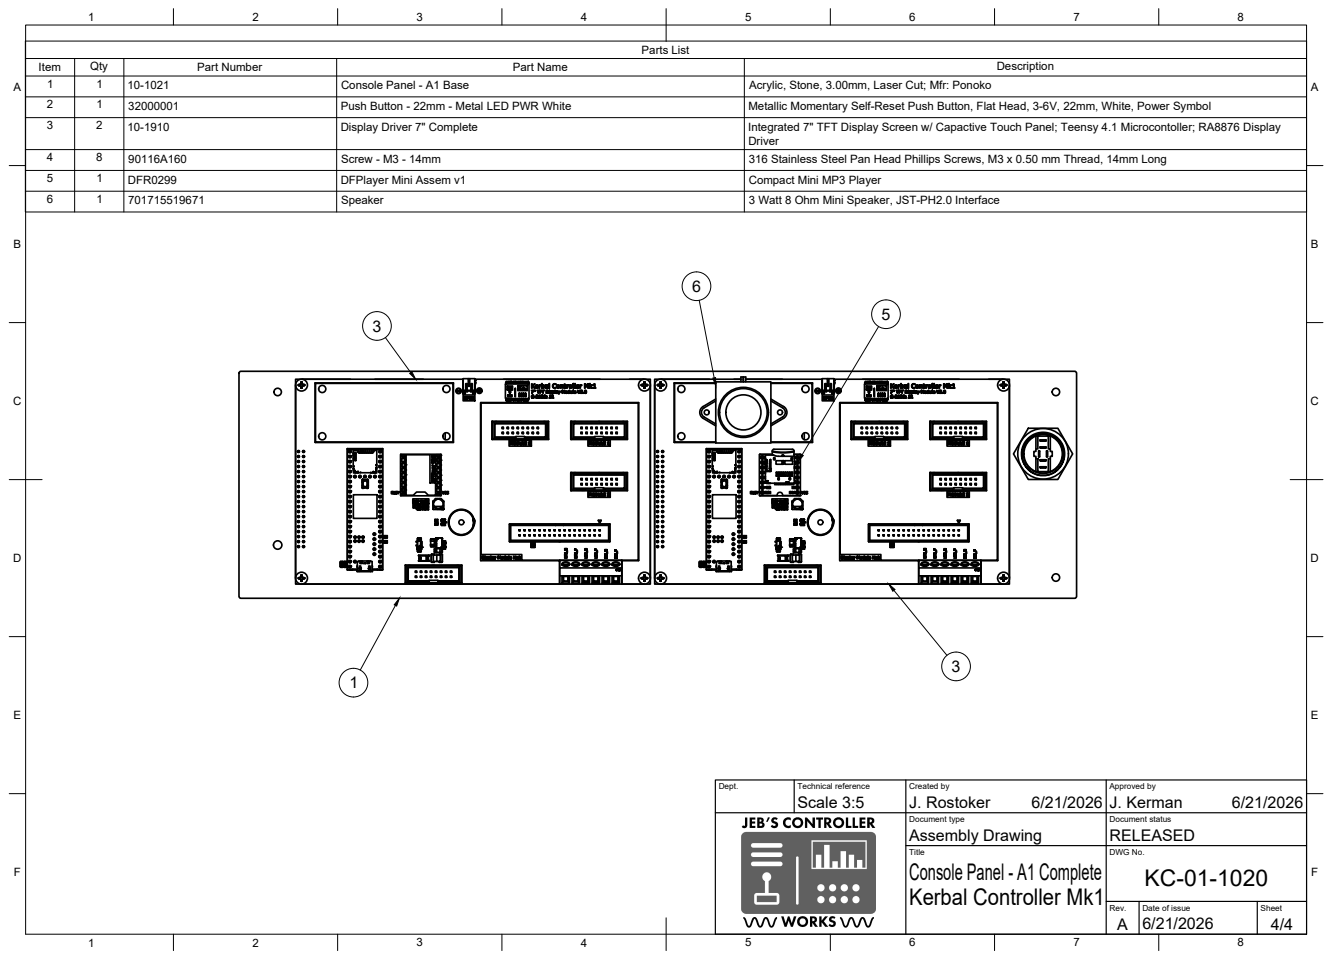
[picture p132: page 4]
Dept.; Technical reference; Created by; Approved by; Document type; Document status; Title; DWG No.; Assembly Drawing; RELEASED; Console Panel - A1 Complete; Scale 3:5; J. Rostoker; J. Kerman; Parts List; Item; Qty; Part Number; Part Name; Description; Console Panel - A1 Base; Acrylic, Stone, 3.00mm, Laser Cut; Mfr: Ponoko; Push Button - 22mm - Metal LED PWR White; Metallic Momentary Self-Reset Push Button, Flat Head, 3-6V, 22mm, White, Power Symbol; Display Driver 7" Complete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
