bigJRo/KerbalControllerMk1/Documents/Drawings/KC-01-1030_RevA_Panel A2 Complete.pdf

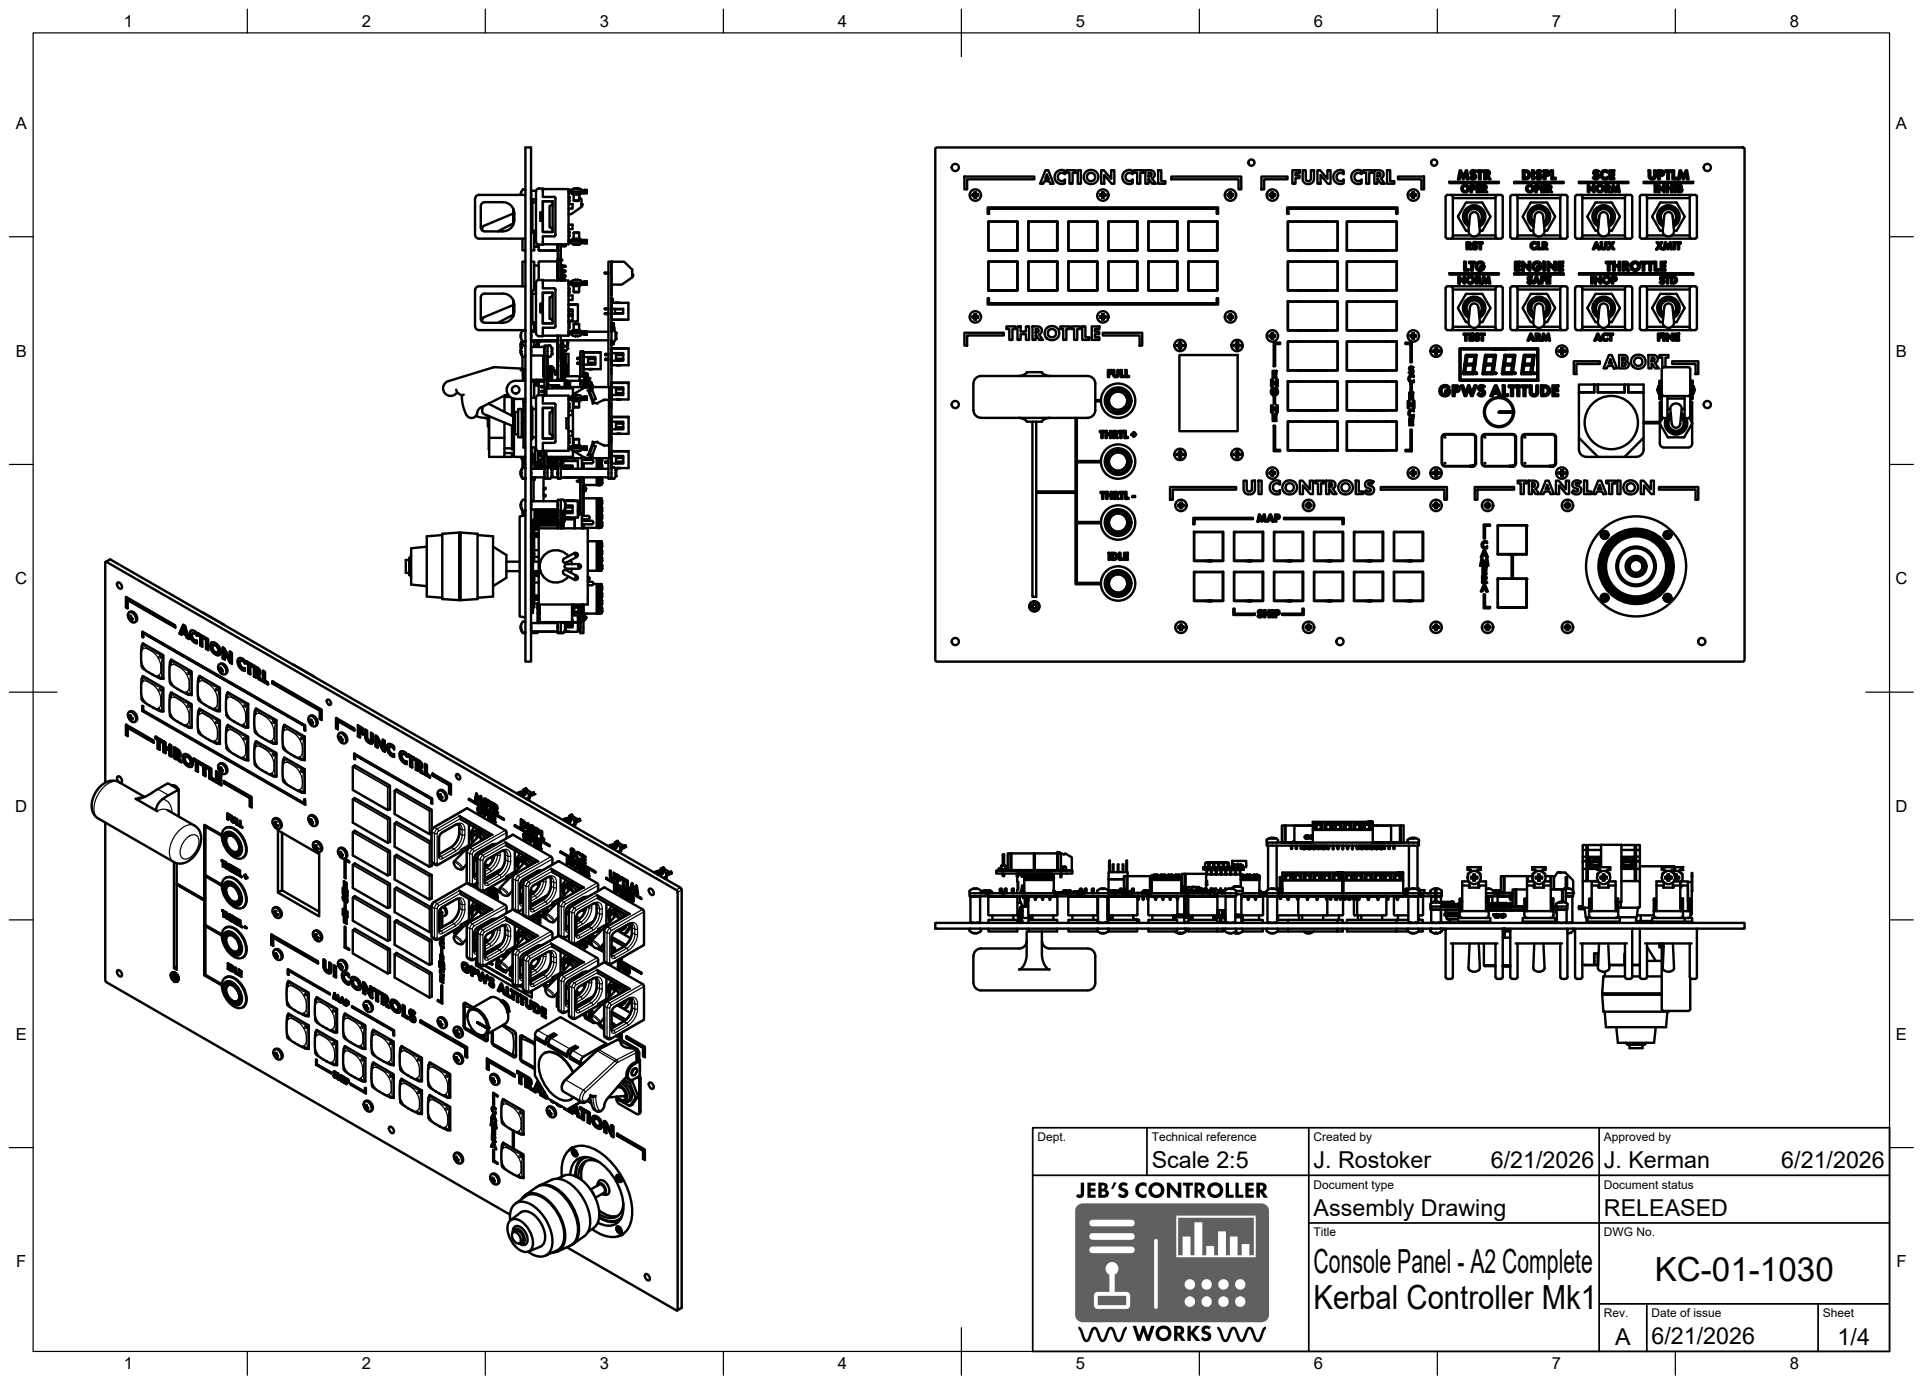
[picture p133: page 1]
Dept.; Technical reference; Created by; Approved by; Document type; Document status; Title; DWG No.; Rev.; Date of issue; Sheet; Assembly Drawing; RELEASED; Kerbal Controller Mk1; Console Panel - A2 Complete; Scale 2:5; J. Rostoker; J. Kerman

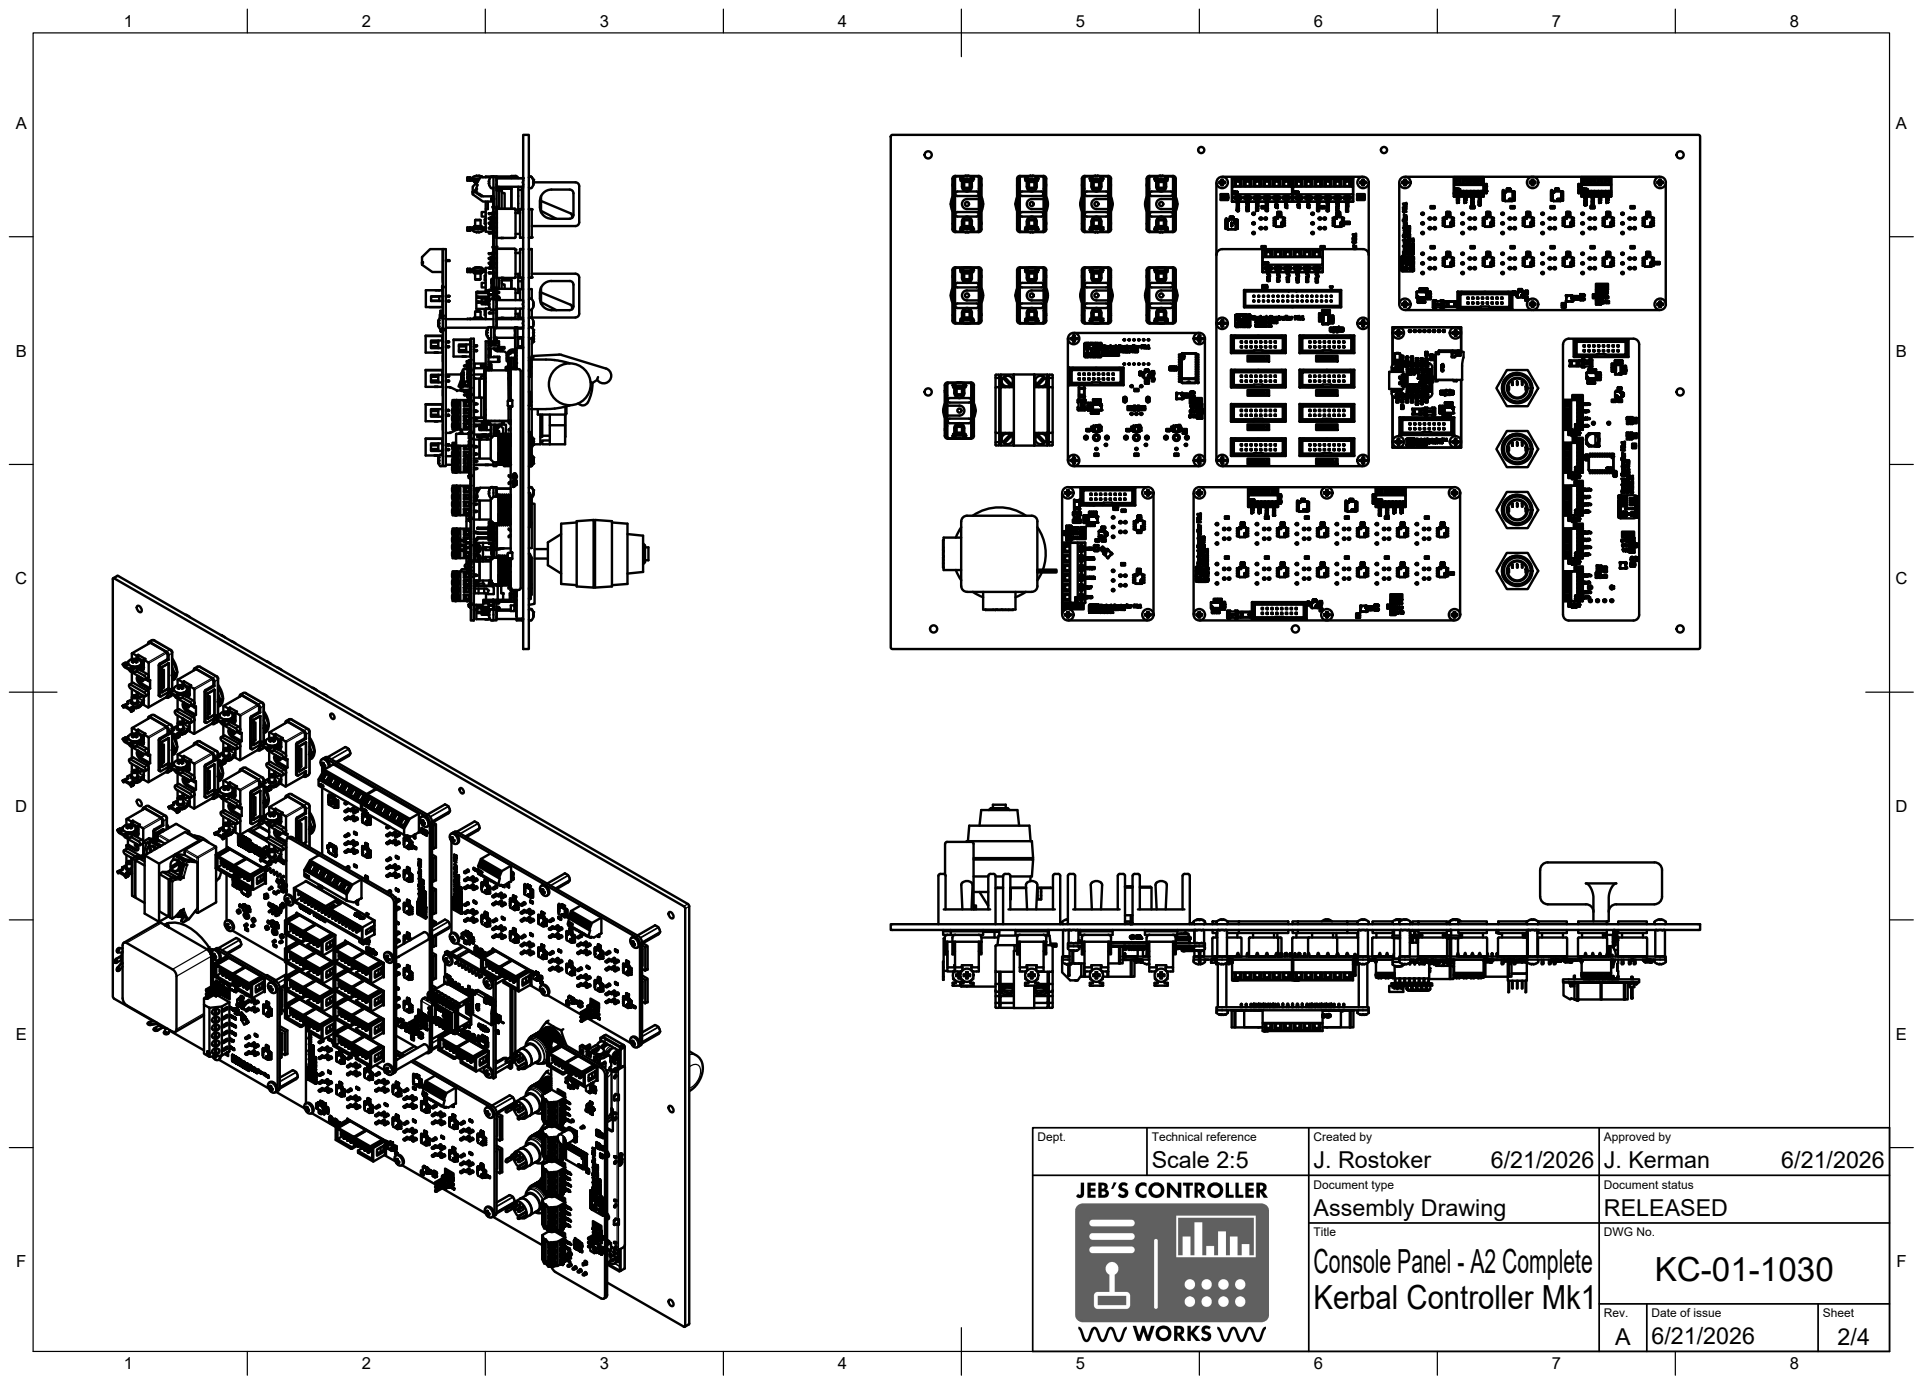
[picture p134: page 2]
Dept.; Technical reference; Created by; Approved by; Document type; Document status; Title; DWG No.; Assembly Drawing; RELEASED; Console Panel - A2 Complete; Scale 2:5; J. Rostoker; J. Kerman

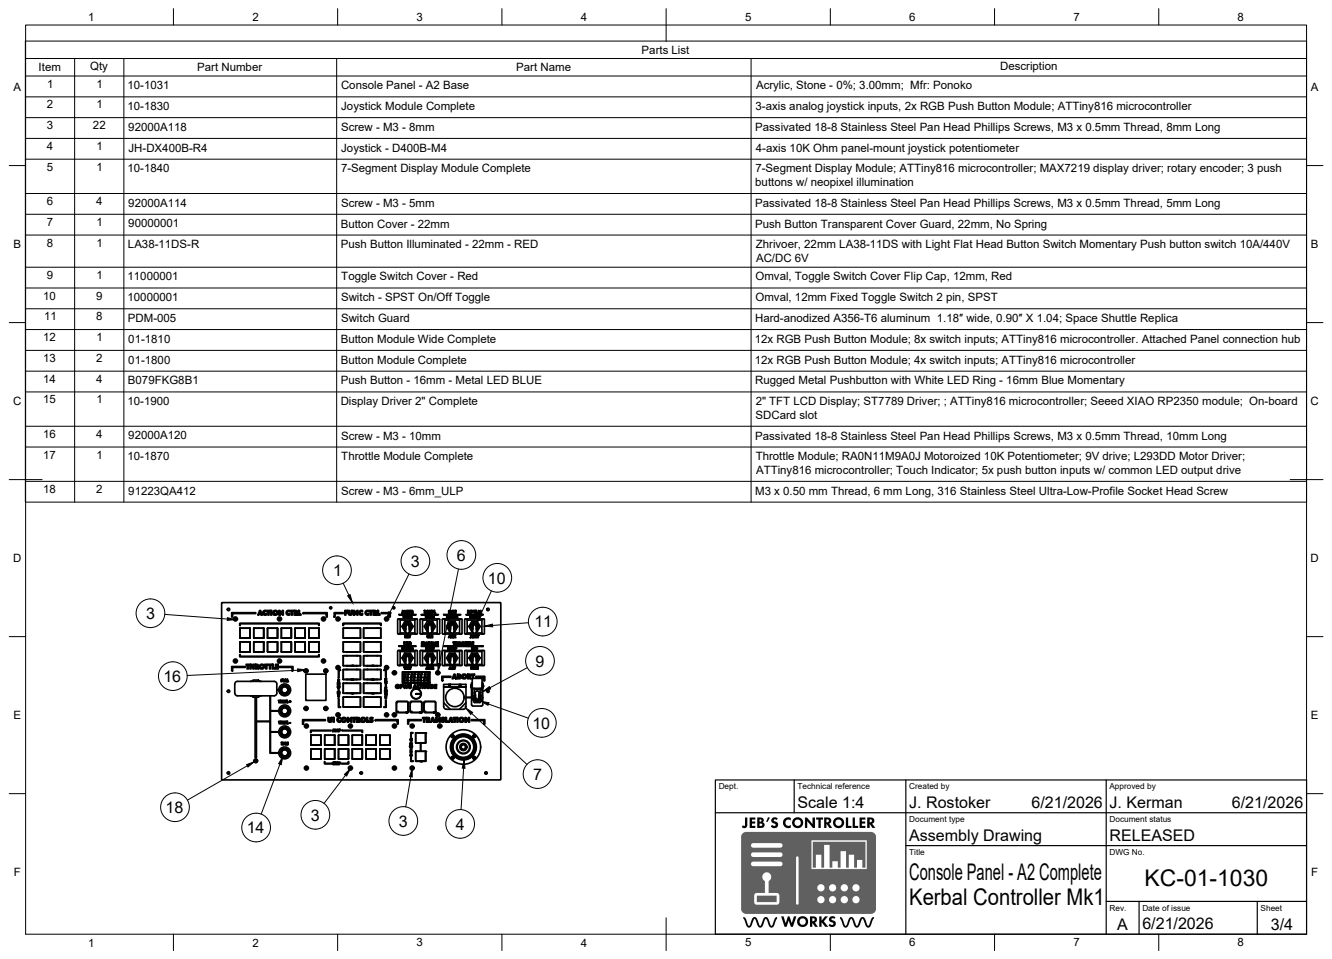
[picture p135: page 3]
Dept.; Technical reference; Created by; Approved by; Document type; Document status; Title; DWG No.; Assembly Drawing; RELEASED; Console Panel - A2 Complete; Scale 1:4; J. Rostoker; J. Kerman; Parts List; Item; Qty; Part Number; Part Name; Description; Console Panel - A2 Base; Acrylic, Stone - 0%; 3.00mm; Mfr: Ponoko; Joystick Module Complete; 3-axis analog joystick inputs, 2x RGB Push Button Module; ATTiny816 microcontroller; Screw - M3 - 8mm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

buttons w/ neopixel illumination

ATTiny816 microcontroller; Touch Indicator; 5x push button inputs w/ common LED output drive

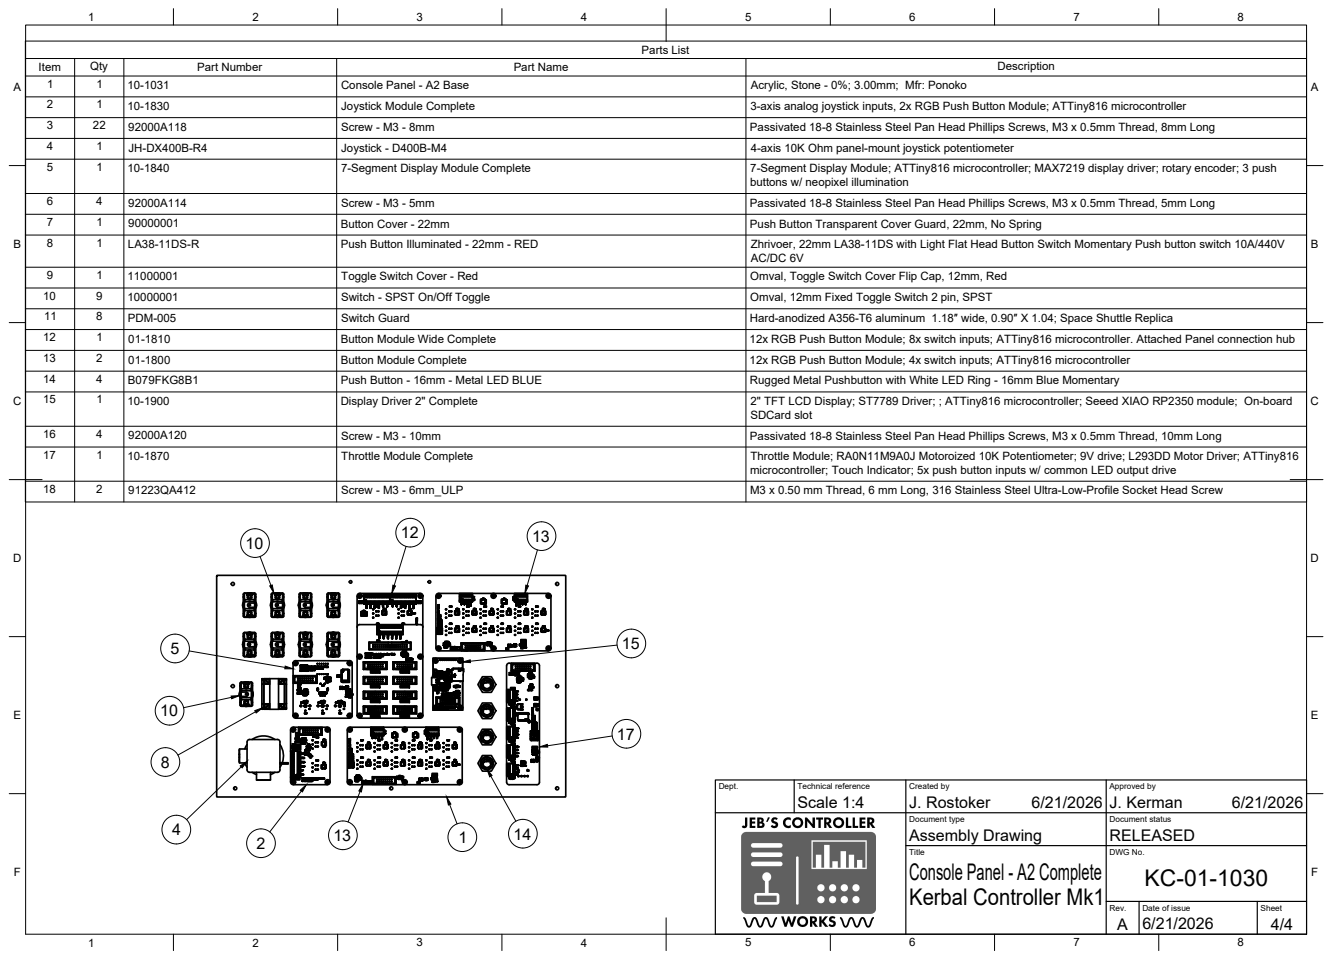
[picture p136: page 4]
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

buttons w/ neopixel illumination

microcontroller; Touch Indicator; 5x push button inputs w/ common LED output drive
