bigJRo/KerbalControllerMk1/Documents/Drawings/KC-01-1040_RevA_Panel B1 Complete.pdf

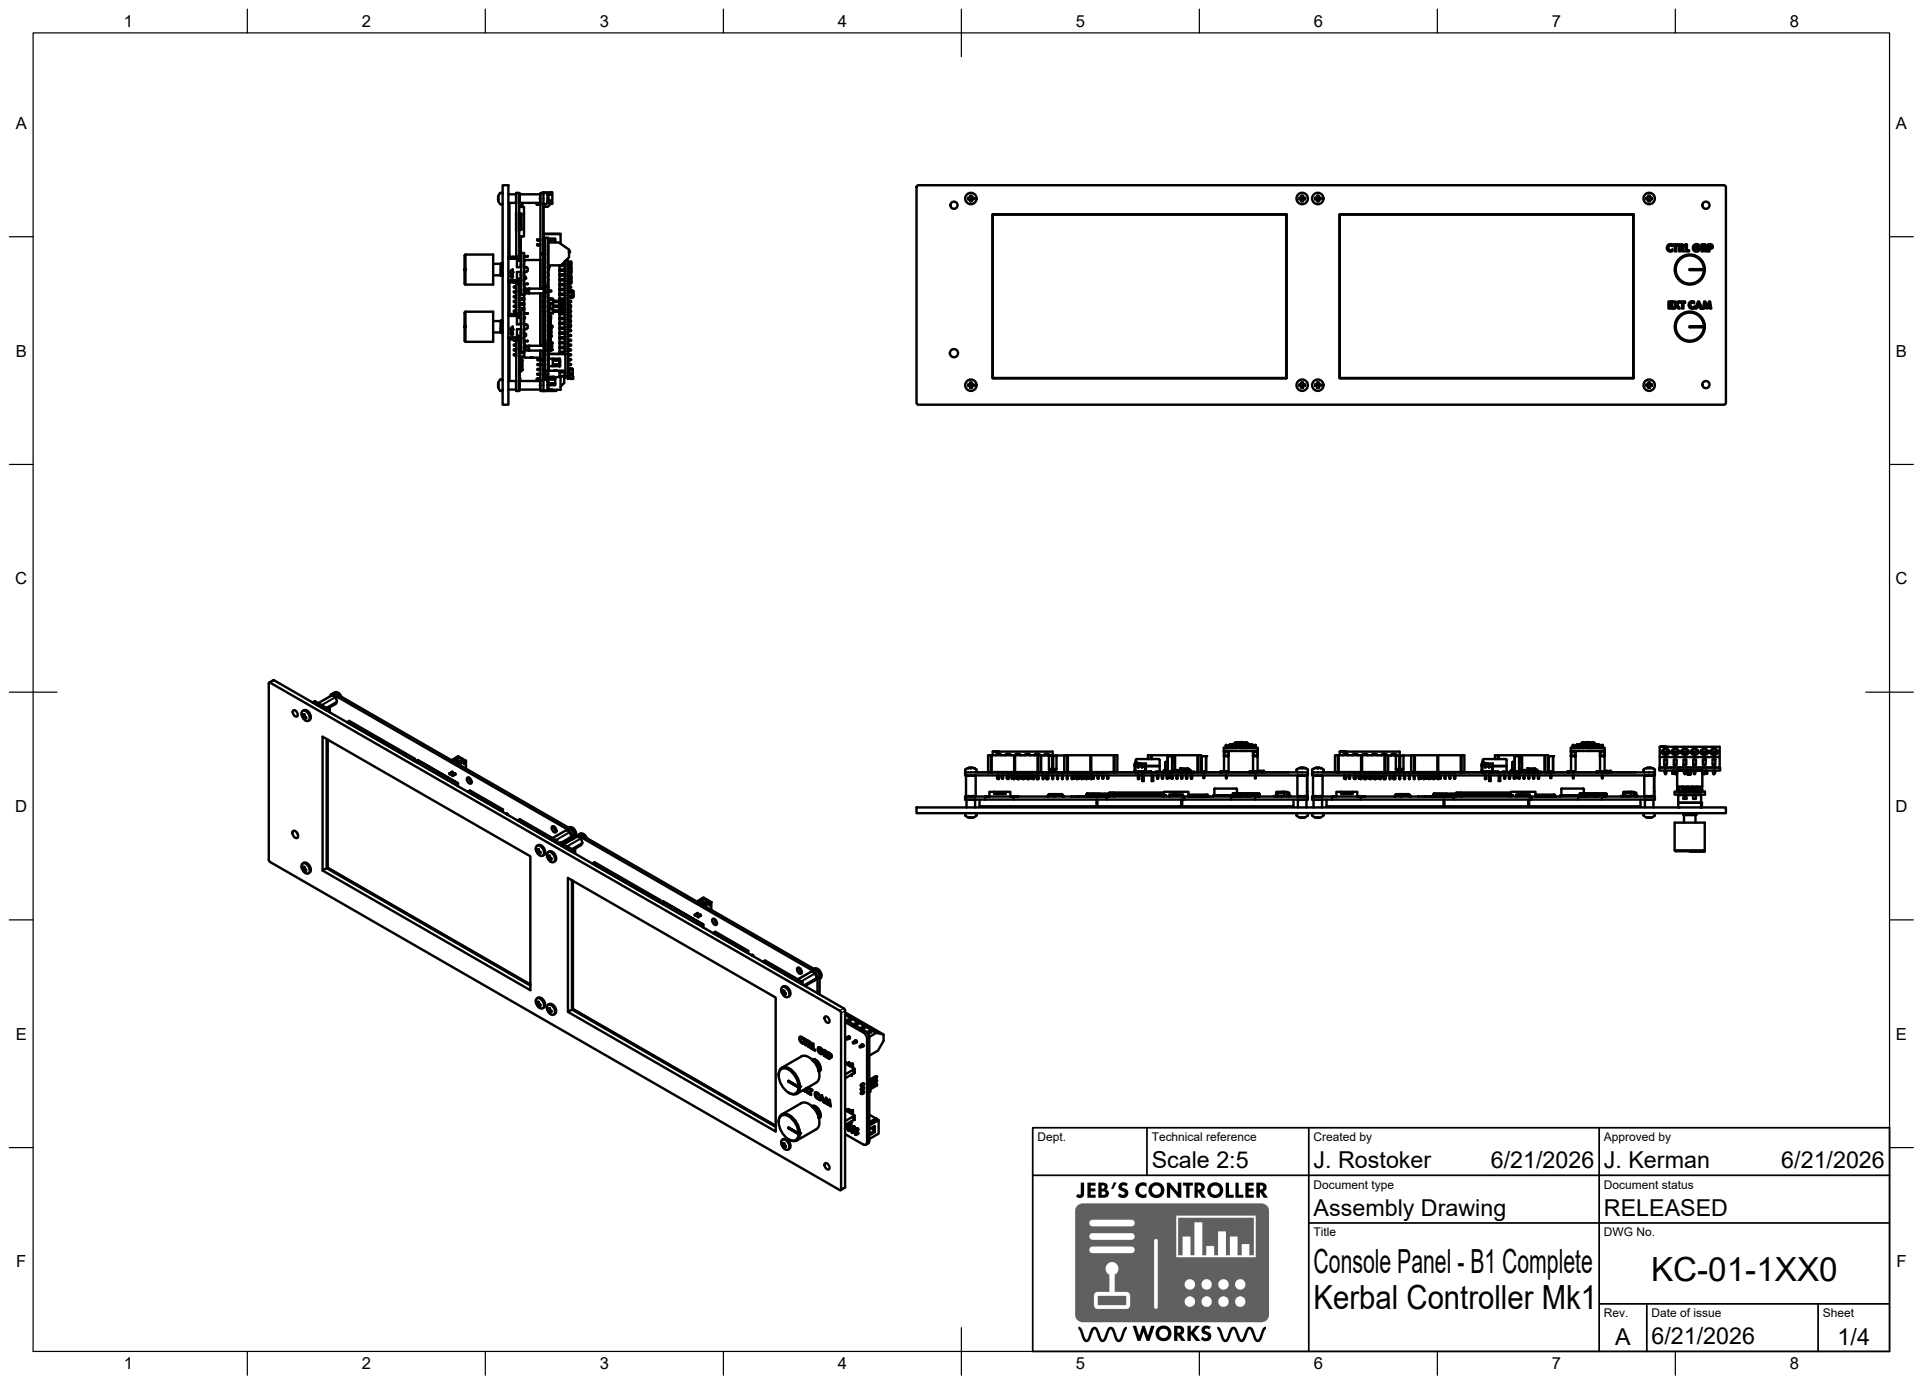
[picture p137: page 1]
Dept.; Technical reference; Created by; Approved by; Document type; Document status; Title; DWG No.; Rev.; Date of issue; Sheet; Assembly Drawing; RELEASED; Kerbal Controller Mk1; Console Panel - B1 Complete; Scale 2:5; J. Rostoker; J. Kerman

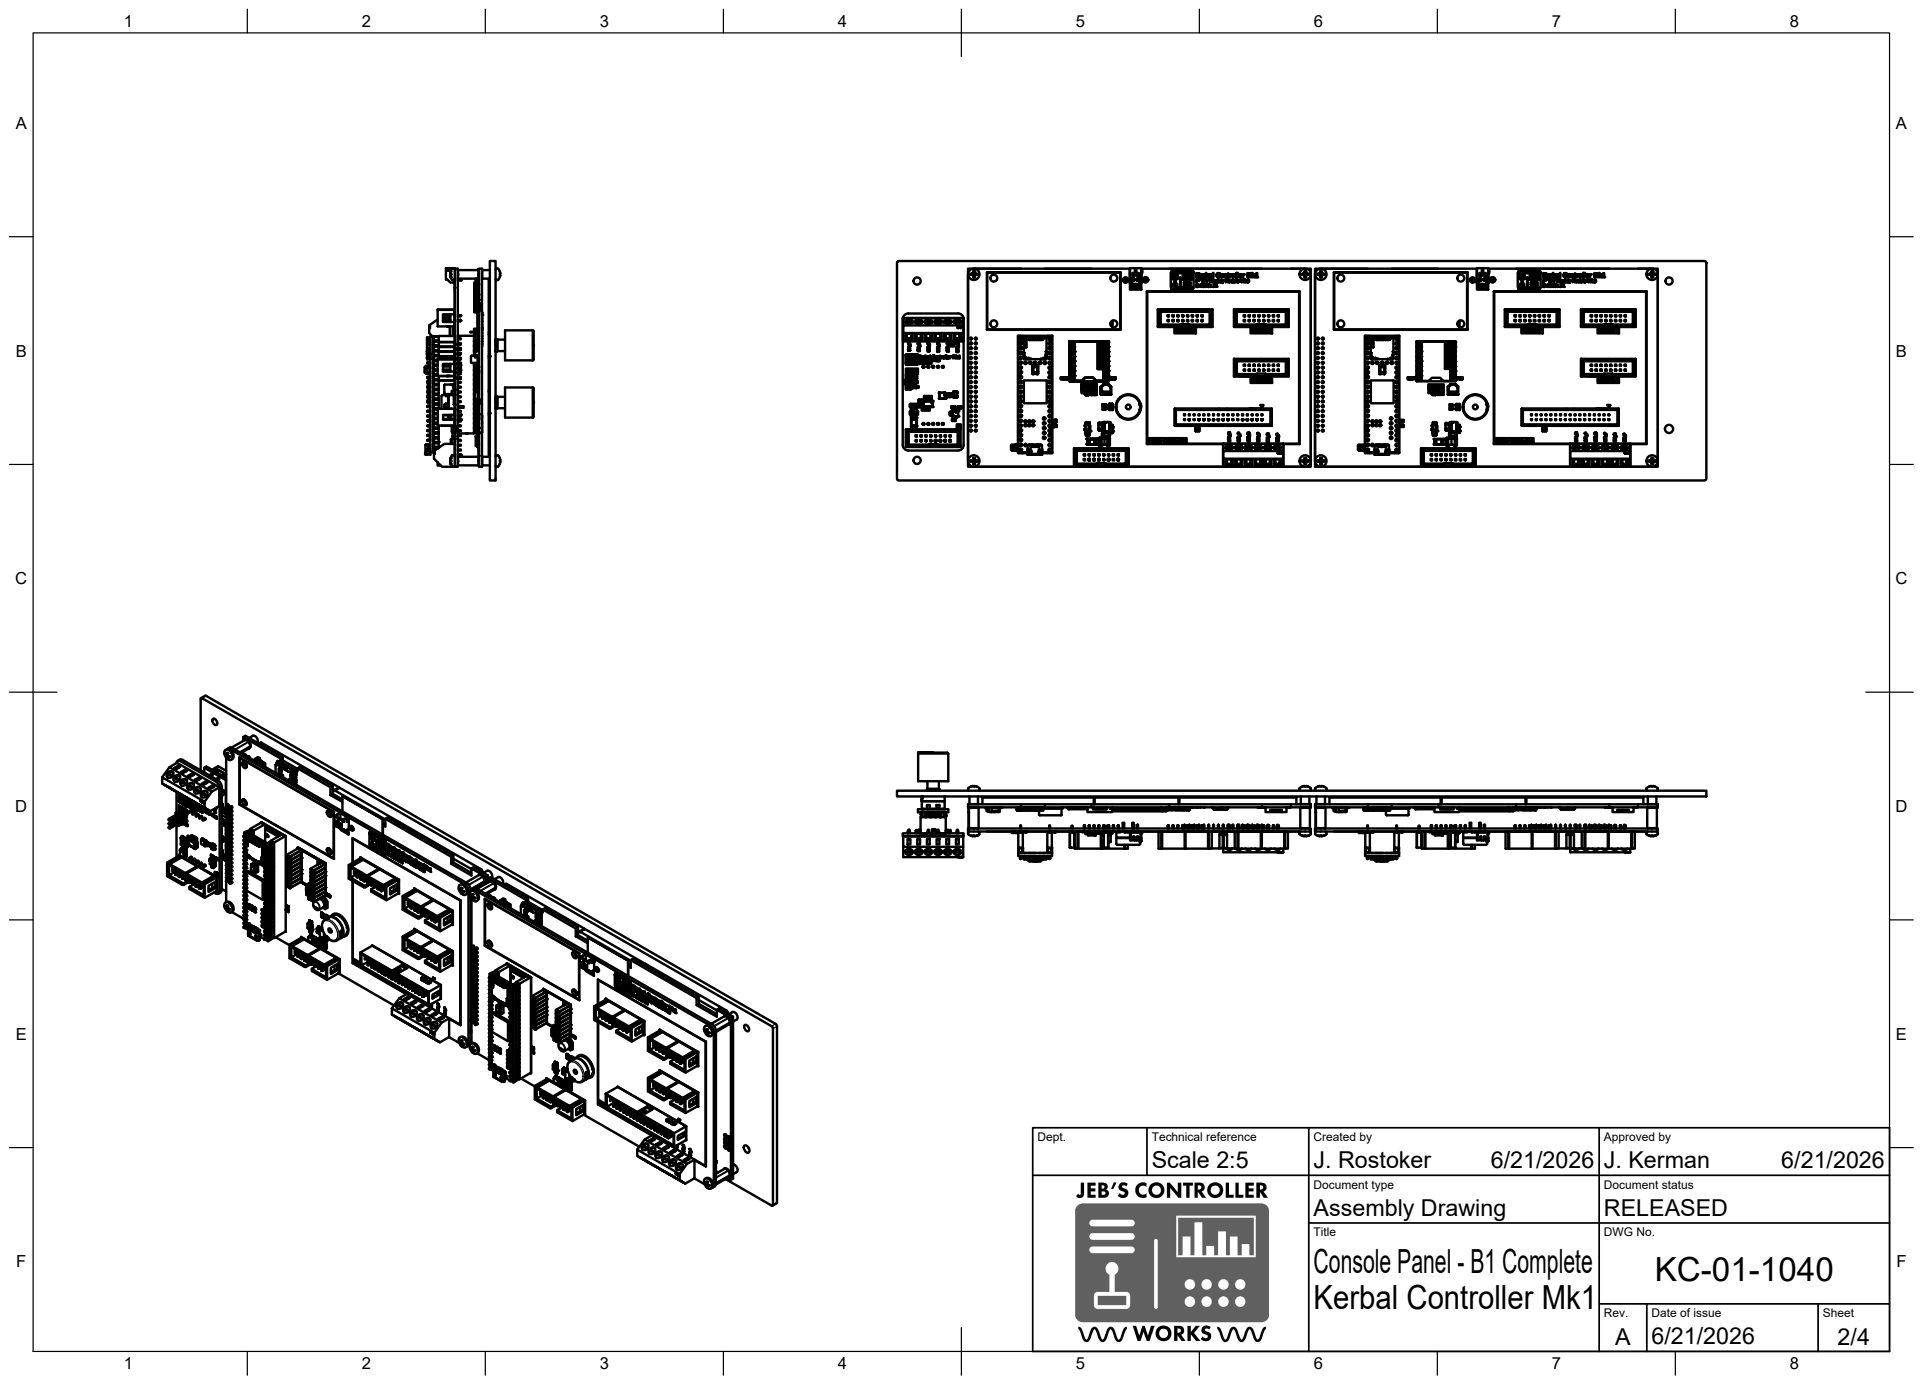
[picture p138: page 2]
Dept.; Technical reference; Created by; Approved by; Document type; Document status; Title; DWG No.; Assembly Drawing; RELEASED; Console Panel - B1 Complete; Scale 2:5; J. Rostoker; J. Kerman

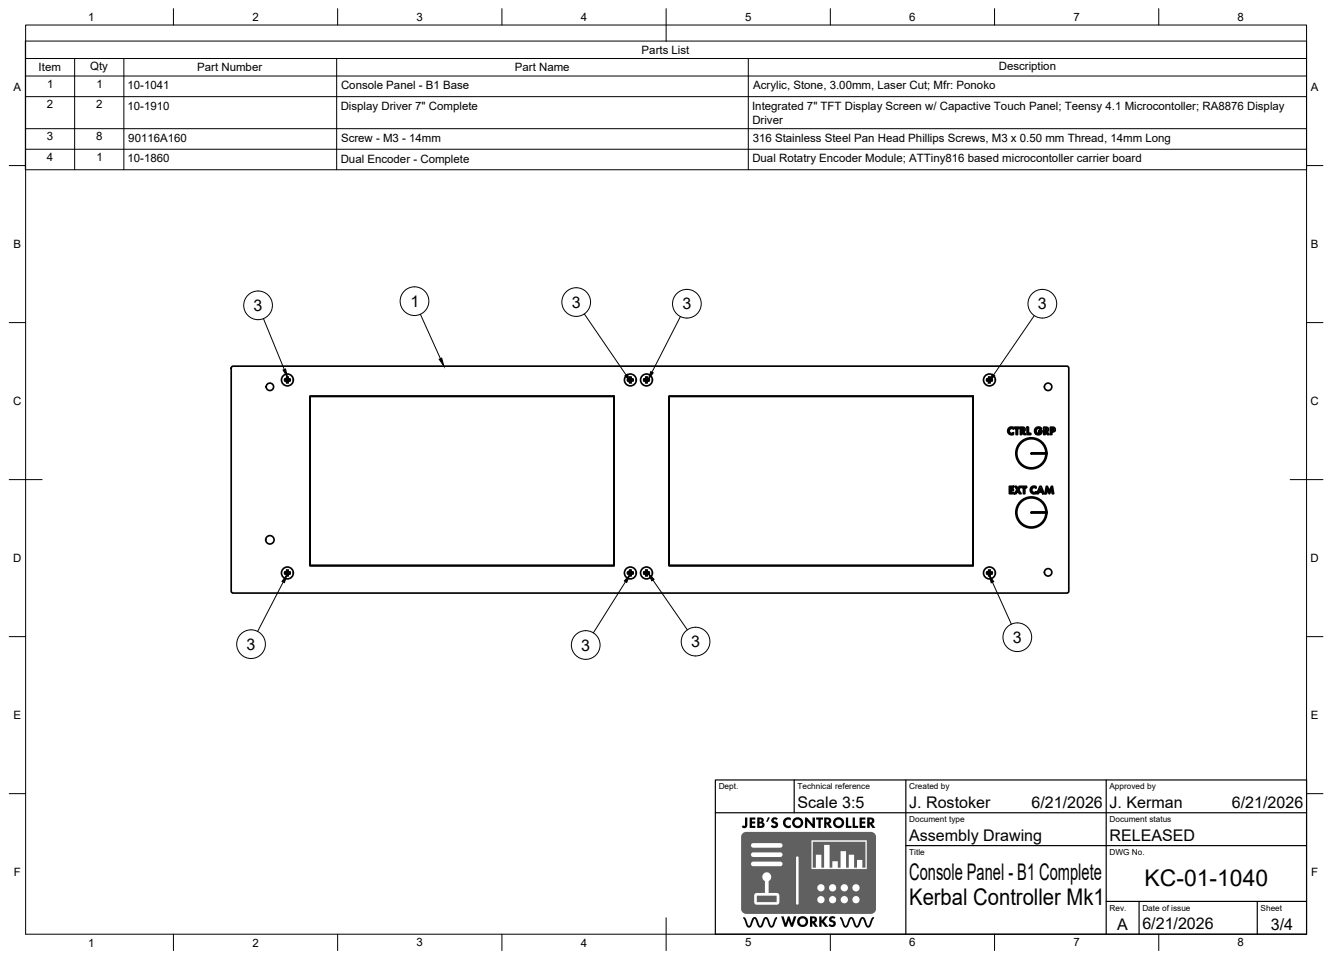
[picture p139: page 3]
Parts List

Item | Qty | Part Number | Part Name | Description
1 | 1 | 10-1041 | Console Panel - B1 Base | Acrylic, Stone, 3.00mm, Laser Cut; Mfr: Ponoko
2 | 2 | 10-1910 | Display Driver 7" Complete | Integrated 7" TFT Display Screen w/ Capactive Touch Panel; Teensy 4.1 Microcontoller; RA8876 Display Driver

3 | 8 | 90116A160 | Screw - M3 - 14mm | 316 Stainless Steel Pan Head Phillips Screws, M3 x 0.50 mm Thread, 14mm Long
4 | 1 | 10-1860 | Dual Encoder - Complete | Dual Rotatry Encoder Module; ATTiny816 based microcontoller carrier board

Dept. | Technical reference Scale 3:5 | Created by J. Rostoker 6/21/2026 | Approved by J. Kerman 6/21/2026

Document type Assembly Drawing | Document status RELEASED

Title Console Panel - B1 Complete | DWG No. KC-01-1040

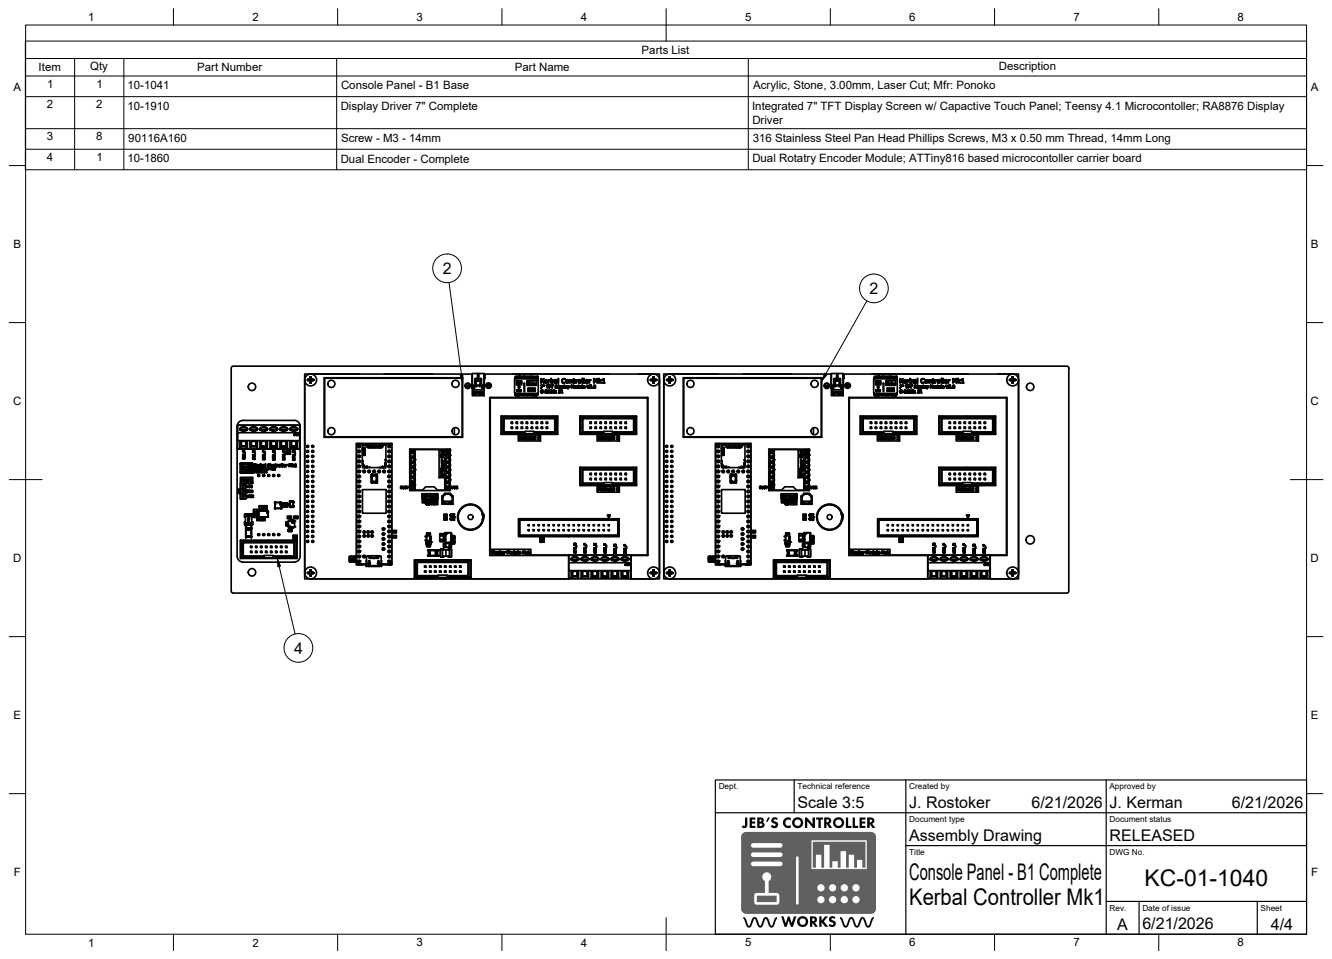
[picture p140: page 4]
Dept.; Technical reference; Created by; Approved by; Document type; Document status; Title; DWG No.; Assembly Drawing; RELEASED; Console Panel - B1 Complete; Scale 3:5; J. Rostoker; J. Kerman; Parts List; Item; Qty; Part Number; Part Name; Description; Console Panel - B1 Base; Acrylic, Stone, 3.00mm, Laser Cut; Mfr: Ponoko; Display Driver 7" Complete; Integrated 7" TFT Display Screen w/ Capactive Touch Panel; Teensy 4.1 Microcontoller; RA8876 Display; Screw - M3 - 14mm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
