bigJRo/KerbalControllerMk1/Documents/Drawings/KC-01-1050_RevA_Panel B2 Complete.pdf

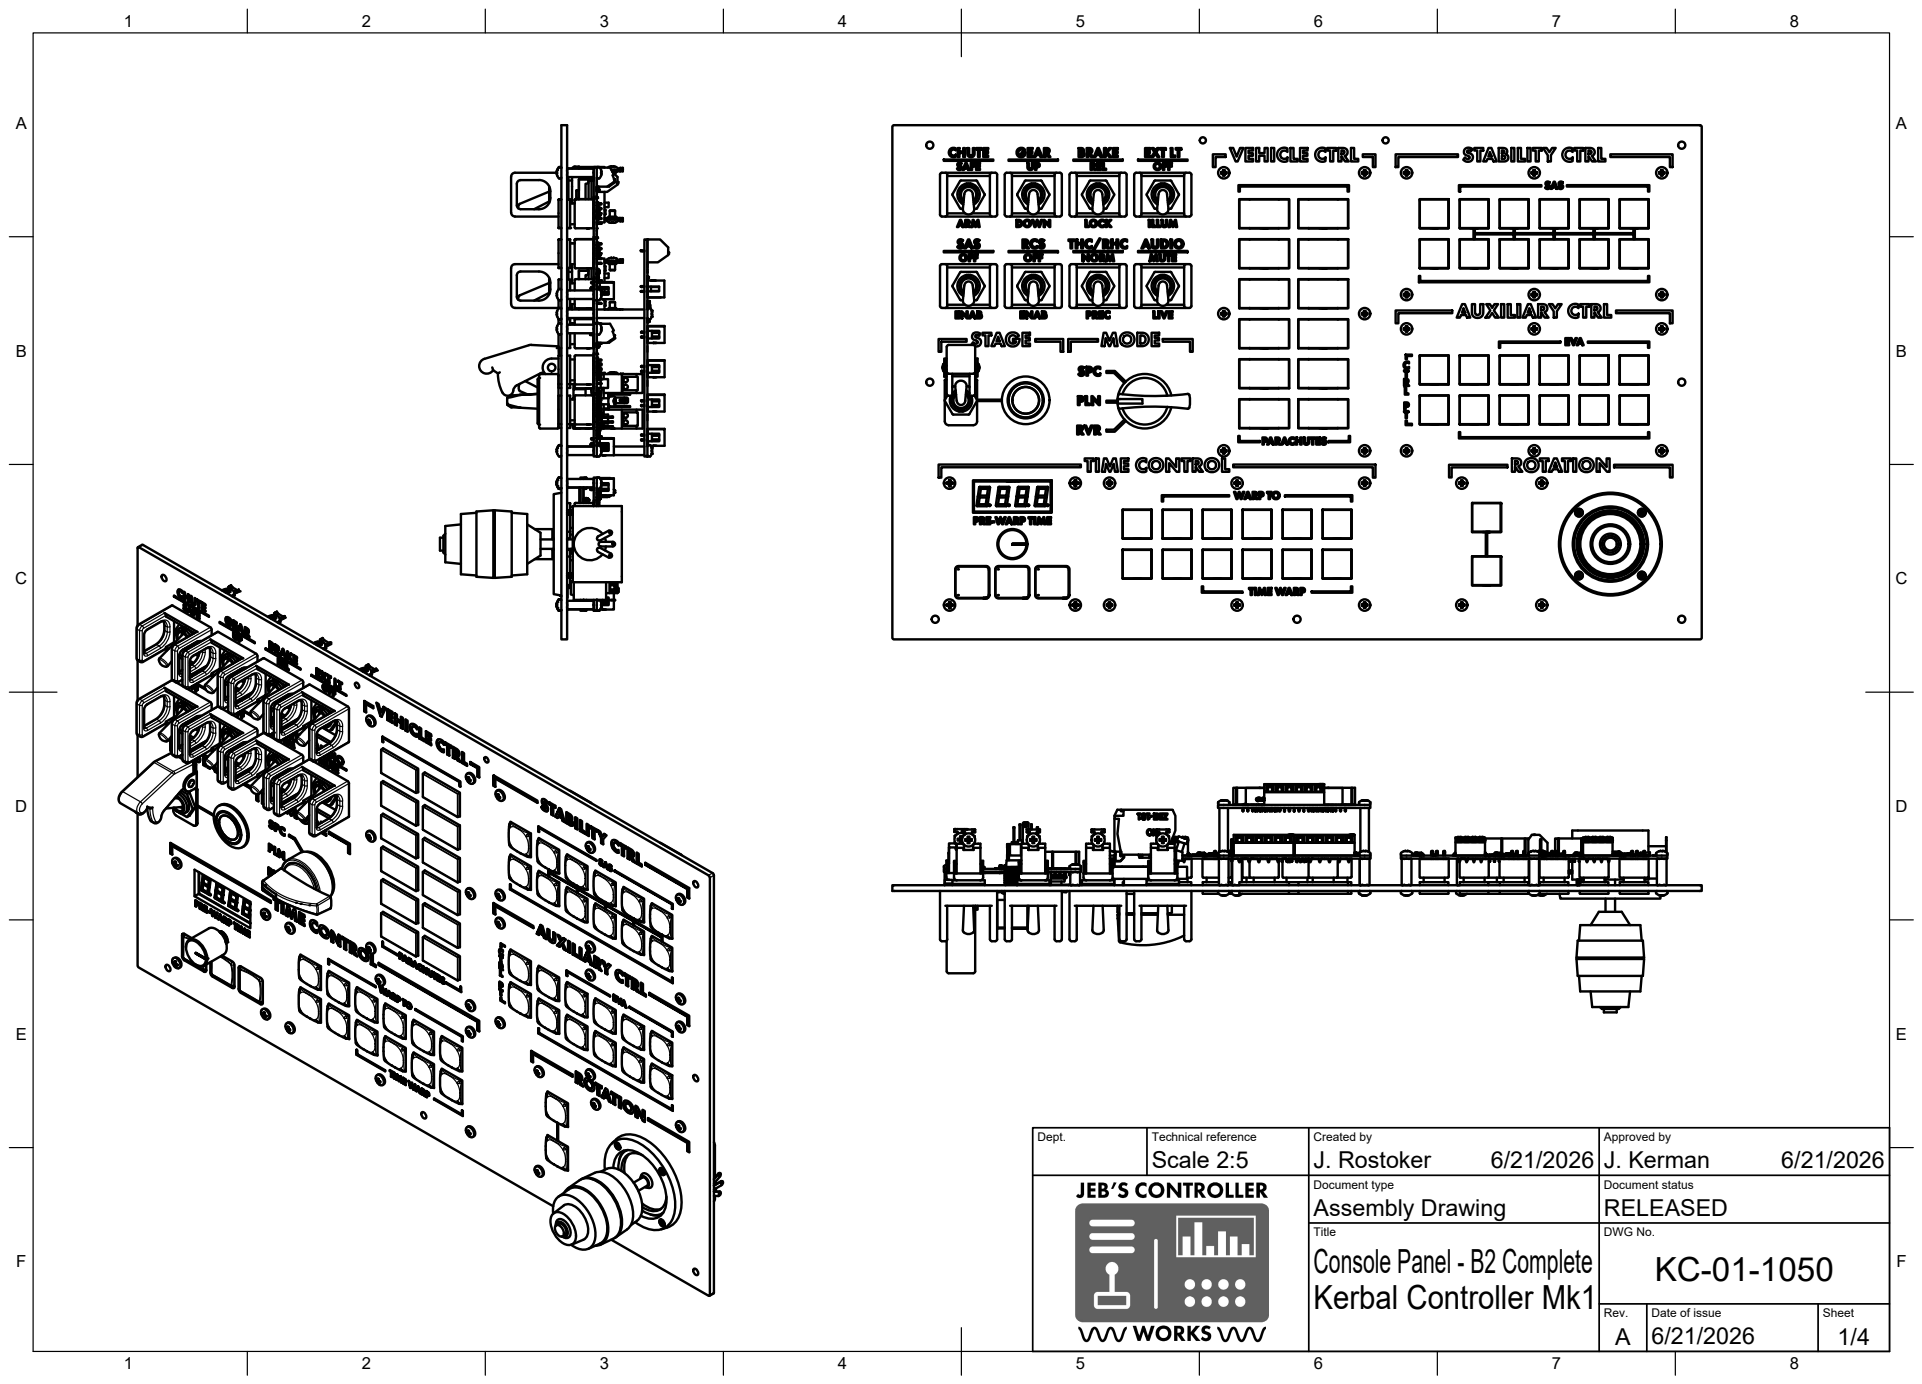
[picture p141: page 1]
Dept.; Technical reference; Created by; Approved by; Document type; Document status; Title; DWG No.; Rev.; Date of issue; Sheet; Assembly Drawing; RELEASED; Kerbal Controller Mk1; Console Panel - B2 Complete; Scale 2:5; J. Rostoker; J. Kerman

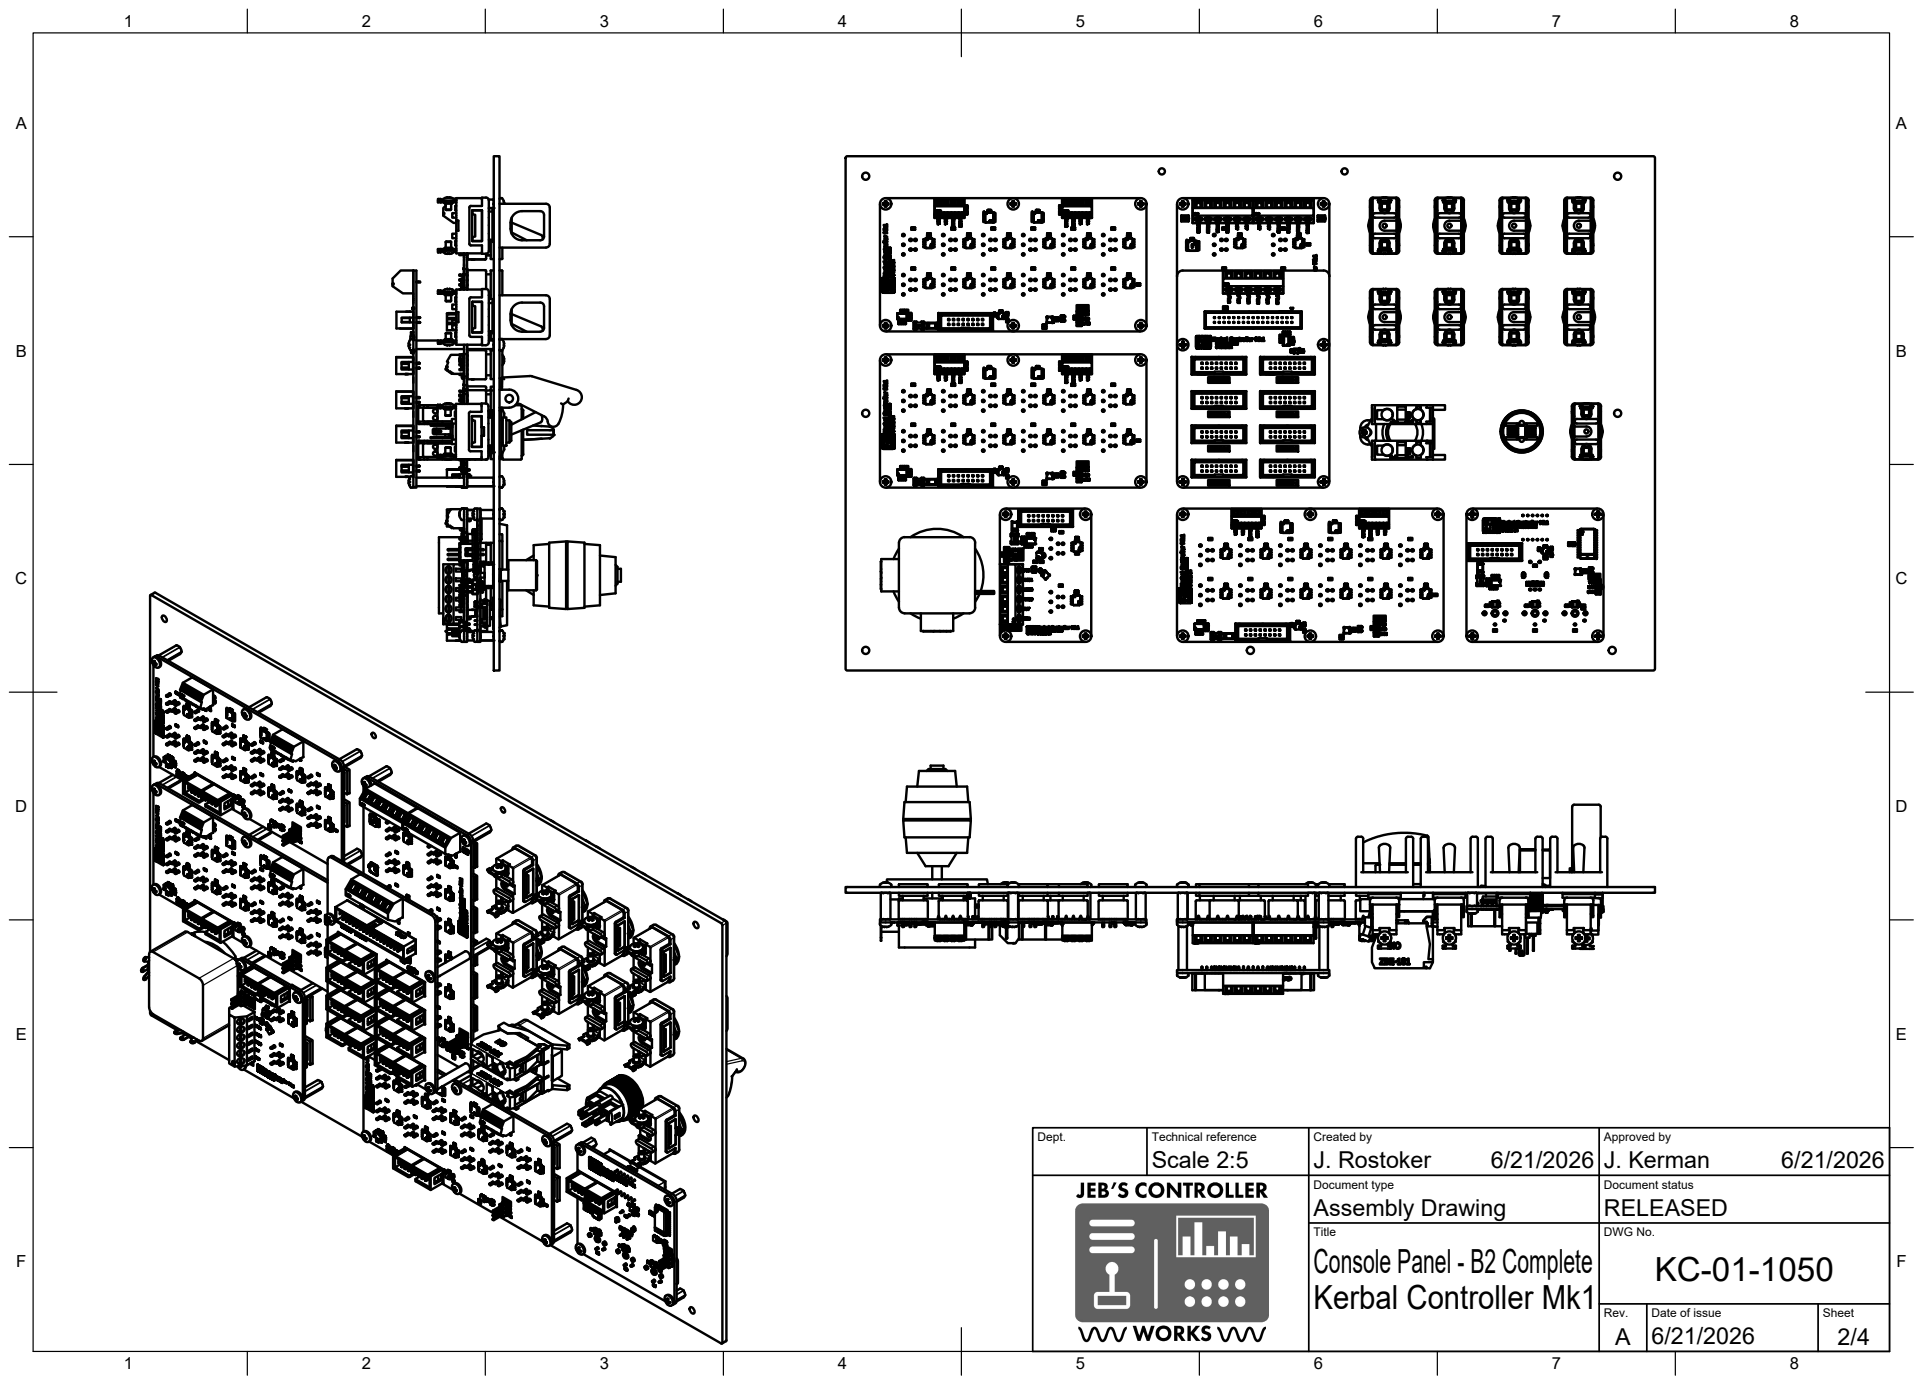
[picture p142: page 2]
Dept.; Technical reference; Created by; Approved by; Document type; Document status; Title; DWG No.; Assembly Drawing; RELEASED; Console Panel - B2 Complete; Scale 2:5; J. Rostoker; J. Kerman

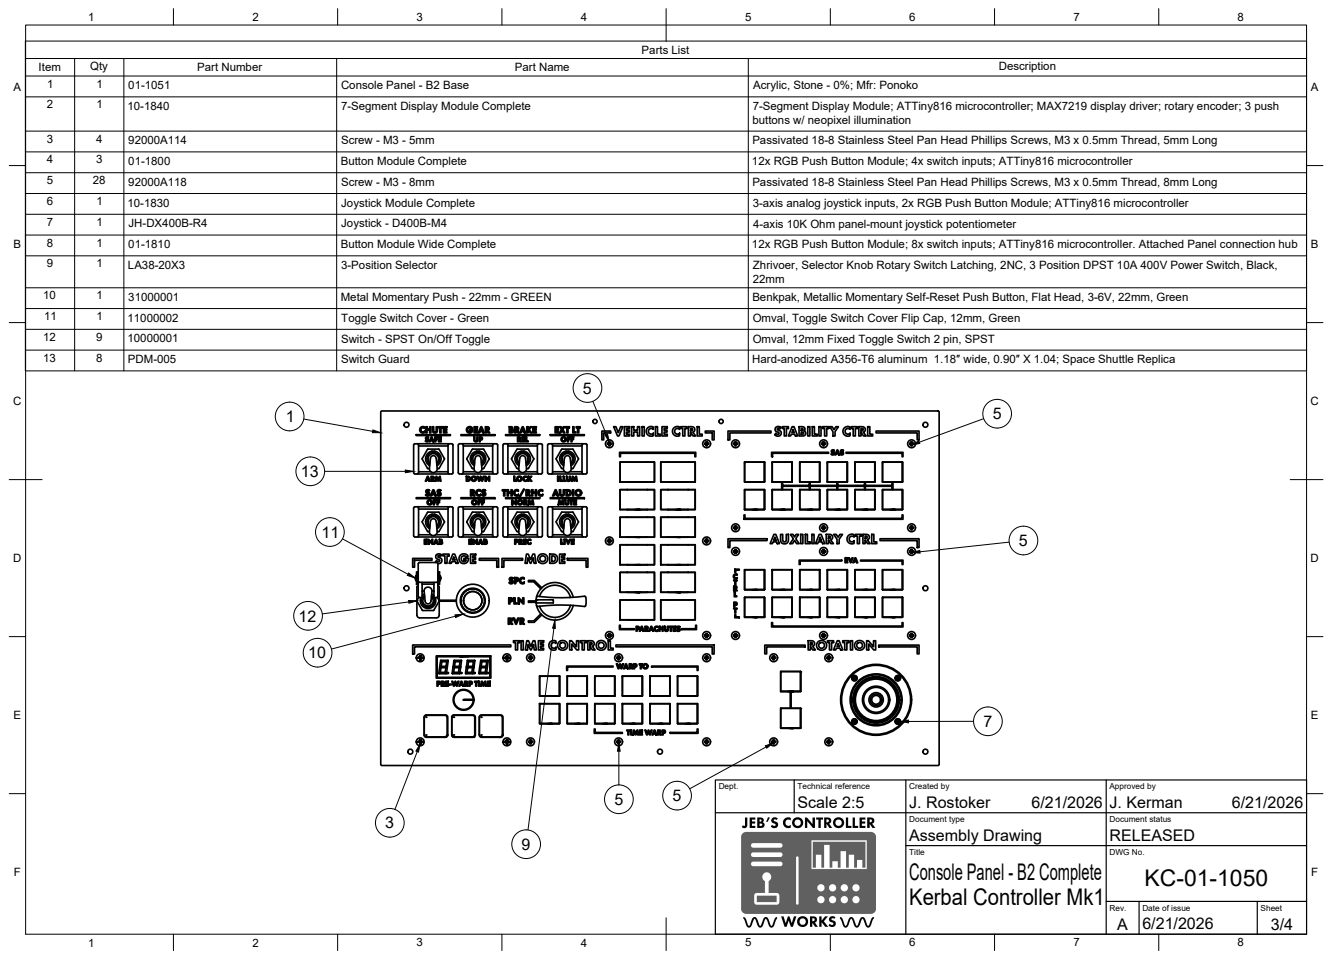
[picture p143: page 3]
Dept.; Technical reference; Created by; Approved by; Document type; Document status; Title; DWG No.; Assembly Drawing; RELEASED; Console Panel - B2 Complete; Scale 2:5; J. Rostoker; J. Kerman; Parts List; Item; Qty; Part Number; Part Name; Description; Console Panel - B2 Base; Acrylic, Stone - 0%; Mfr: Ponoko; 7-Segment Display Module Complete; 7-Segment Display Module; ATTiny816 microcontroller; MAX7219 display driver; rotary encoder; 3 push; Screw - M3 - 5mm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

buttons w/ neopixel illumination

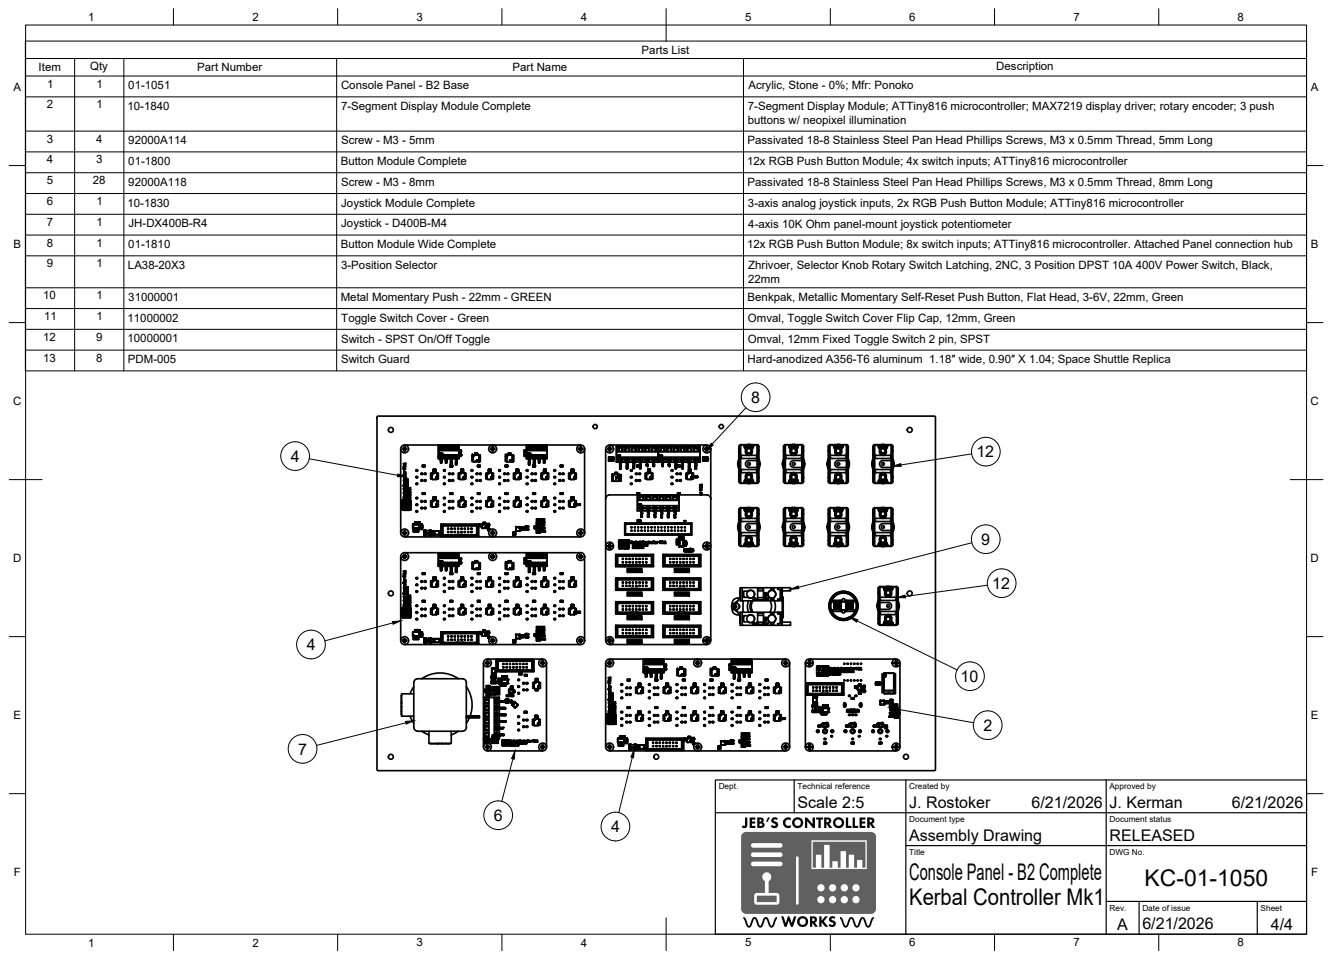
[picture p144: page 4]
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

buttons w/ neopixel illumination
