bigJRo/KerbalControllerMk1/Documents/Drawings/KC-01-1060_Rev-_Top Cover Plate.pdf

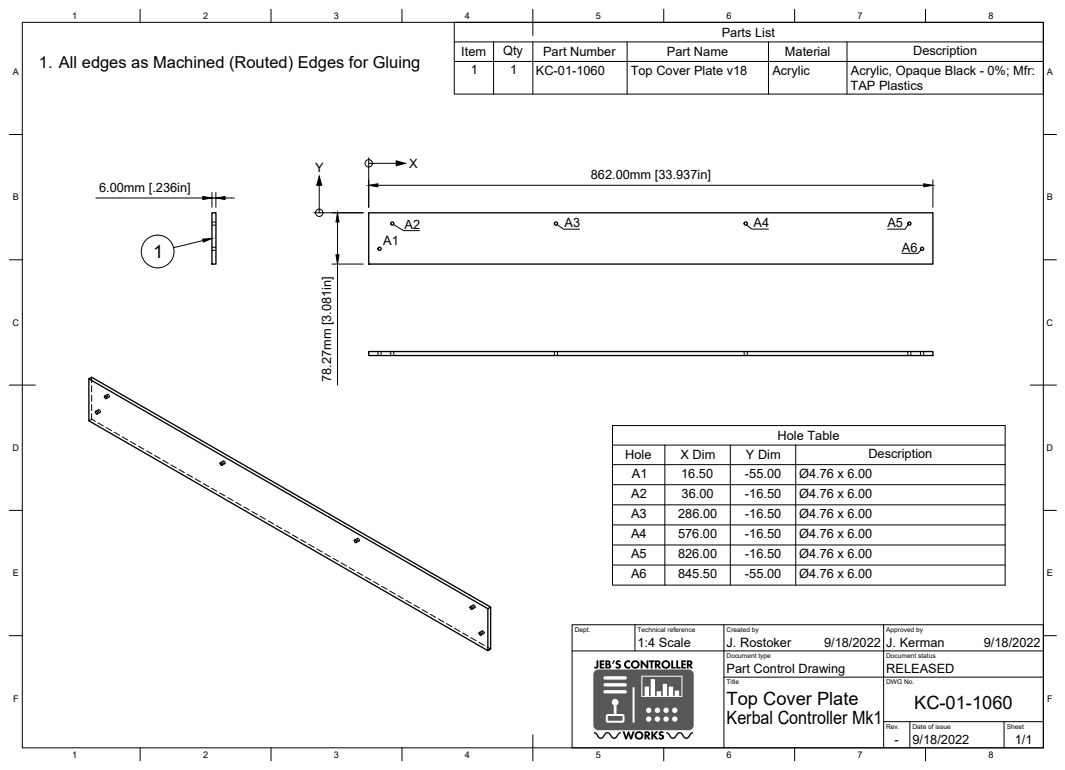
[picture p145: page 1]
Title; DWG No.; Rev.; Date of issue; Sheet -; Kerbal Controller Mk1; Top Cover Plate; Parts List; Hole Table

Item | Qty | Part Number | Part Name | Material | Description
1 | 1 | KC-01-1060 | Top Cover Plate v18 | Acrylic | Acrylic, Opaque Black - 0%; Mfr: TAP Plastics

1. All edges as Machined (Routed) Edges for Gluing

Hole | X Dim | Y Dim | Description
A1 | 16.50 | -55.00 | Ø4.76 x 6.00
A2 | 36.00 | -16.50 | Ø4.76 x 6.00
A3 | 286.00 | -16.50 | Ø4.76 x 6.00
A4 | 576.00 | -16.50 | Ø4.76 x 6.00
A5 | 826.00 | -16.50 | Ø4.76 x 6.00
A6 | 845.50 | -55.00 | Ø4.76 x 6.00

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

Document type Part Control Drawing | Document status RELEASED
