bigJRo/KerbalControllerMk1/Documents/Drawings/KC-01-1071_RevC_Internal Brace.pdf

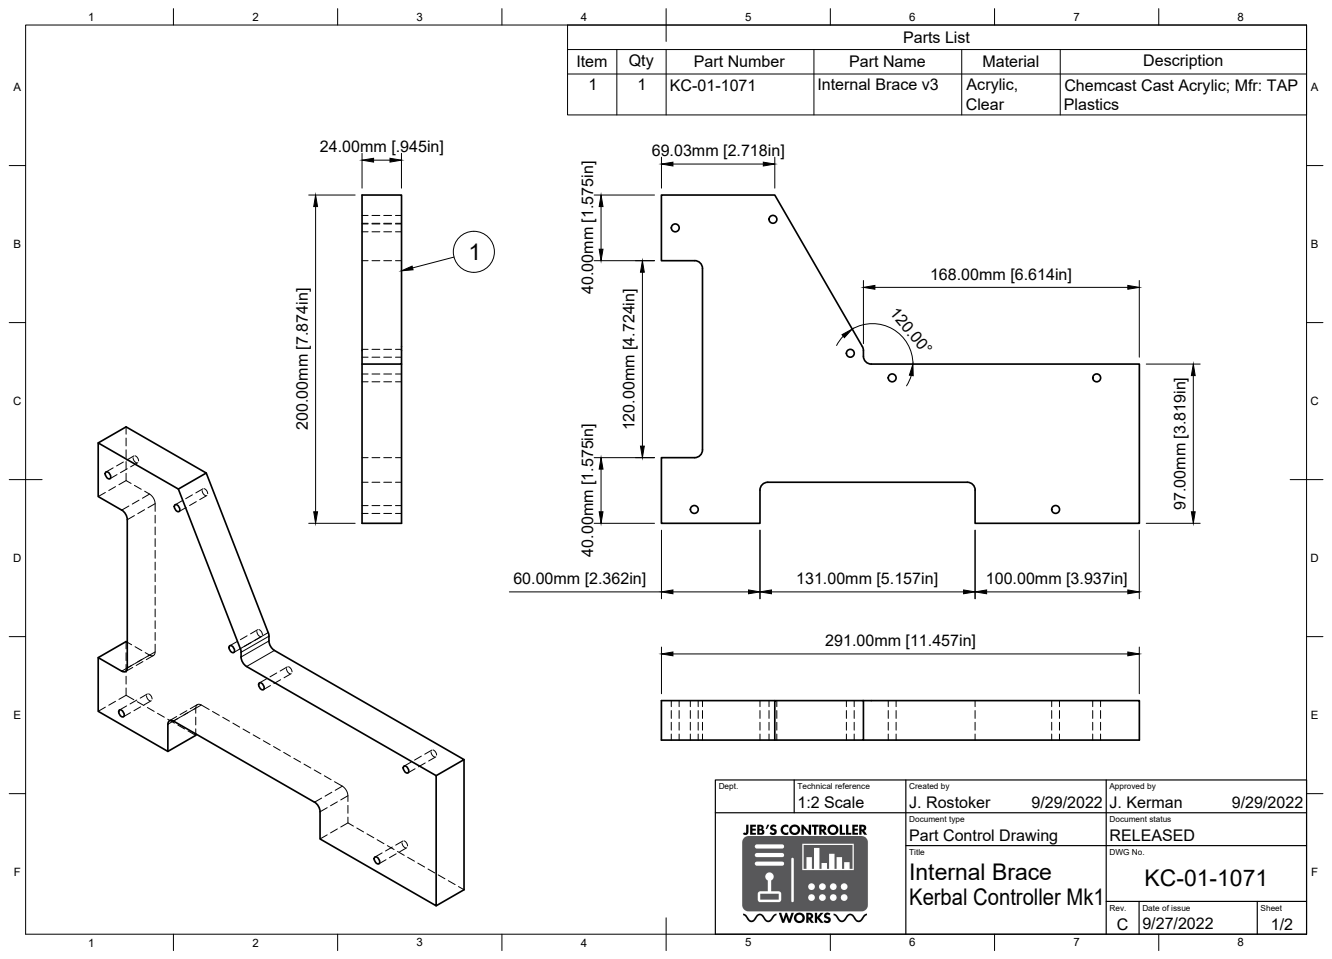
[picture p146: page 1]
Title; DWG No.; Rev.; Date of issue; Sheet; Kerbal Controller Mk1; Internal Brace; Parts List

Item | Qty | Part Number | Part Name | Material | Description
1 | 1 | KC-01-1071 | Internal Brace v3 | Acrylic, Clear | Chemcast Cast Acrylic; Mfr: TAP Plastics

Dept. | Technical reference 1:2 Scale | Created by J. Rostoker 9/29/2022 | Approved by J. Kerman 9/29/2022

Document type Part Control Drawing | Document status RELEASED

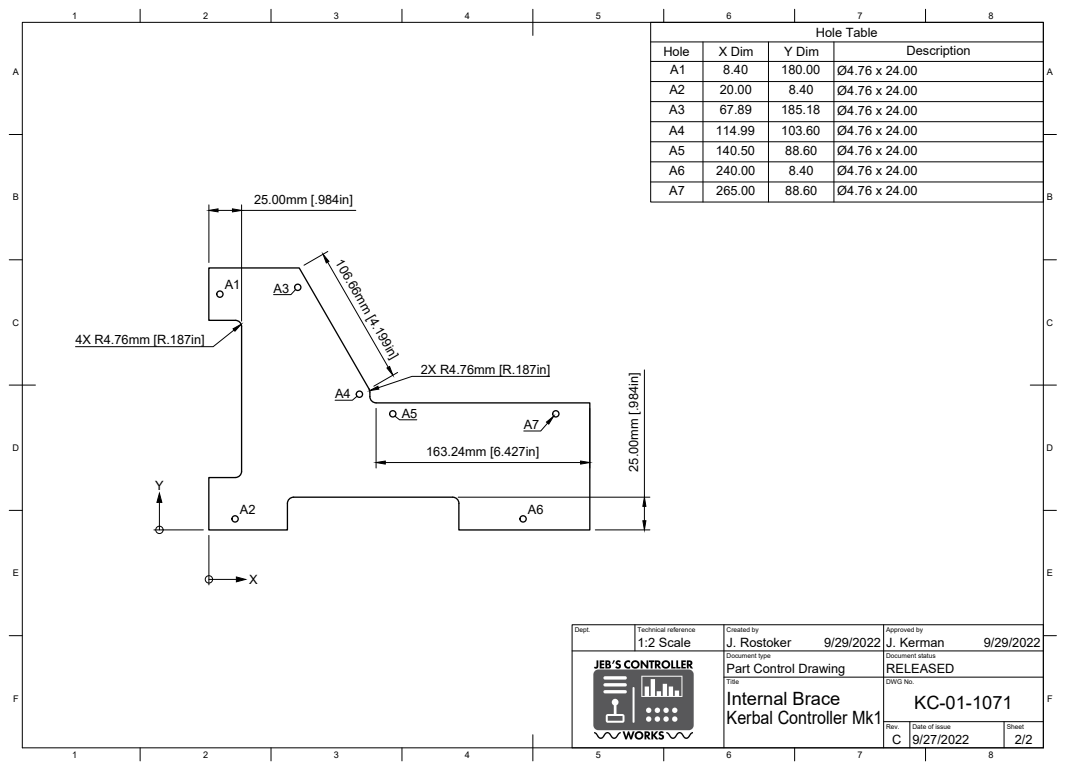
[picture p147: page 2]
Title; DWG No.; Rev.; Date of issue; Sheet; Kerbal Controller Mk1; Internal Brace; Hole Table

Hole | X Dim | Y Dim | Description
A1 | 8.40 | 180.00 | Ø4.76 x 24.00
A2 | 20.00 | 8.40 | Ø4.76 x 24.00
A3 | 67.89 | 185.18 | Ø4.76 x 24.00
A4 | 114.99 | 103.60 | Ø4.76 x 24.00
A5 | 140.50 | 88.60 | Ø4.76 x 24.00
A6 | 240.00 | 8.40 | Ø4.76 x 24.00
A7 | 265.00 | 88.60 | Ø4.76 x 24.00

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

Document type Part Control Drawing | Document status RELEASED
