bigJRo/KerbalControllerMk1/Documents/Drawings/KC-01-1080_RevA_Panel Brace.pdf

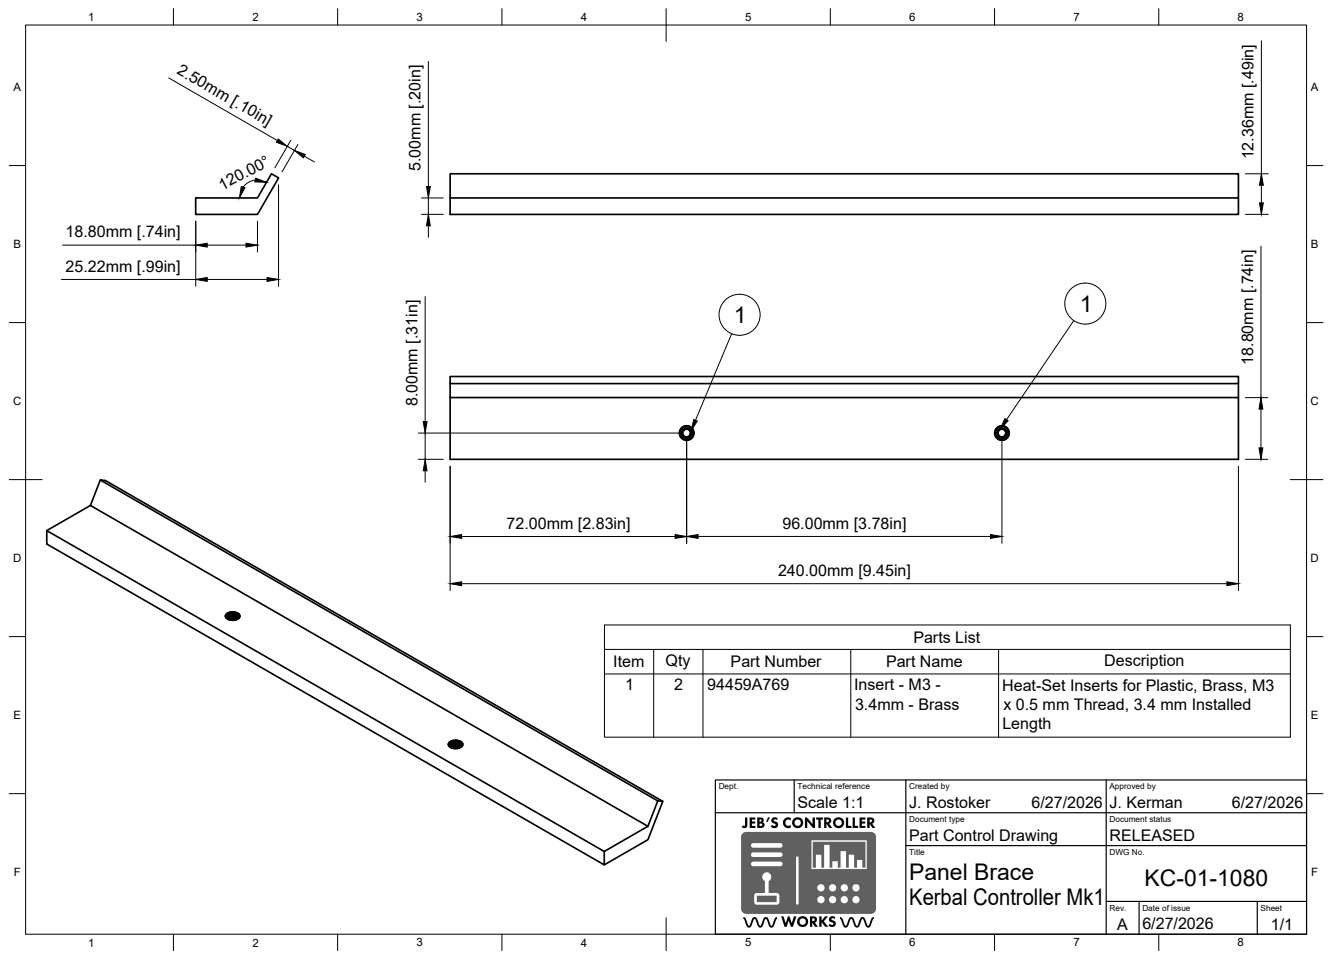
[picture p148: page 1]
Title; DWG No.; Rev.; Date of issue; Sheet; Kerbal Controller Mk1; Panel Brace; Scale 1:1; J. Rostoker; J. Kerman 5.00mm [.20in]; Parts List

Item | Qty | Part Number | Part Name | Description
1 | 2 | 94459A769 | Insert - M3 -3.4mm - Brass | Heat-Set Inserts for Plastic, Brass, M3 x 0.5 mm Thread, 3.4 mm Installed Length

Dept. | Technical reference | Created by 6/27/2026 | Approved by 6/27/2026

Document type Part Control Drawing | Document status RELEASED
