bigJRo/KerbalControllerMk1/Documents/Drawings/KC-01-1700_RevA_Control Module Complete.pdf

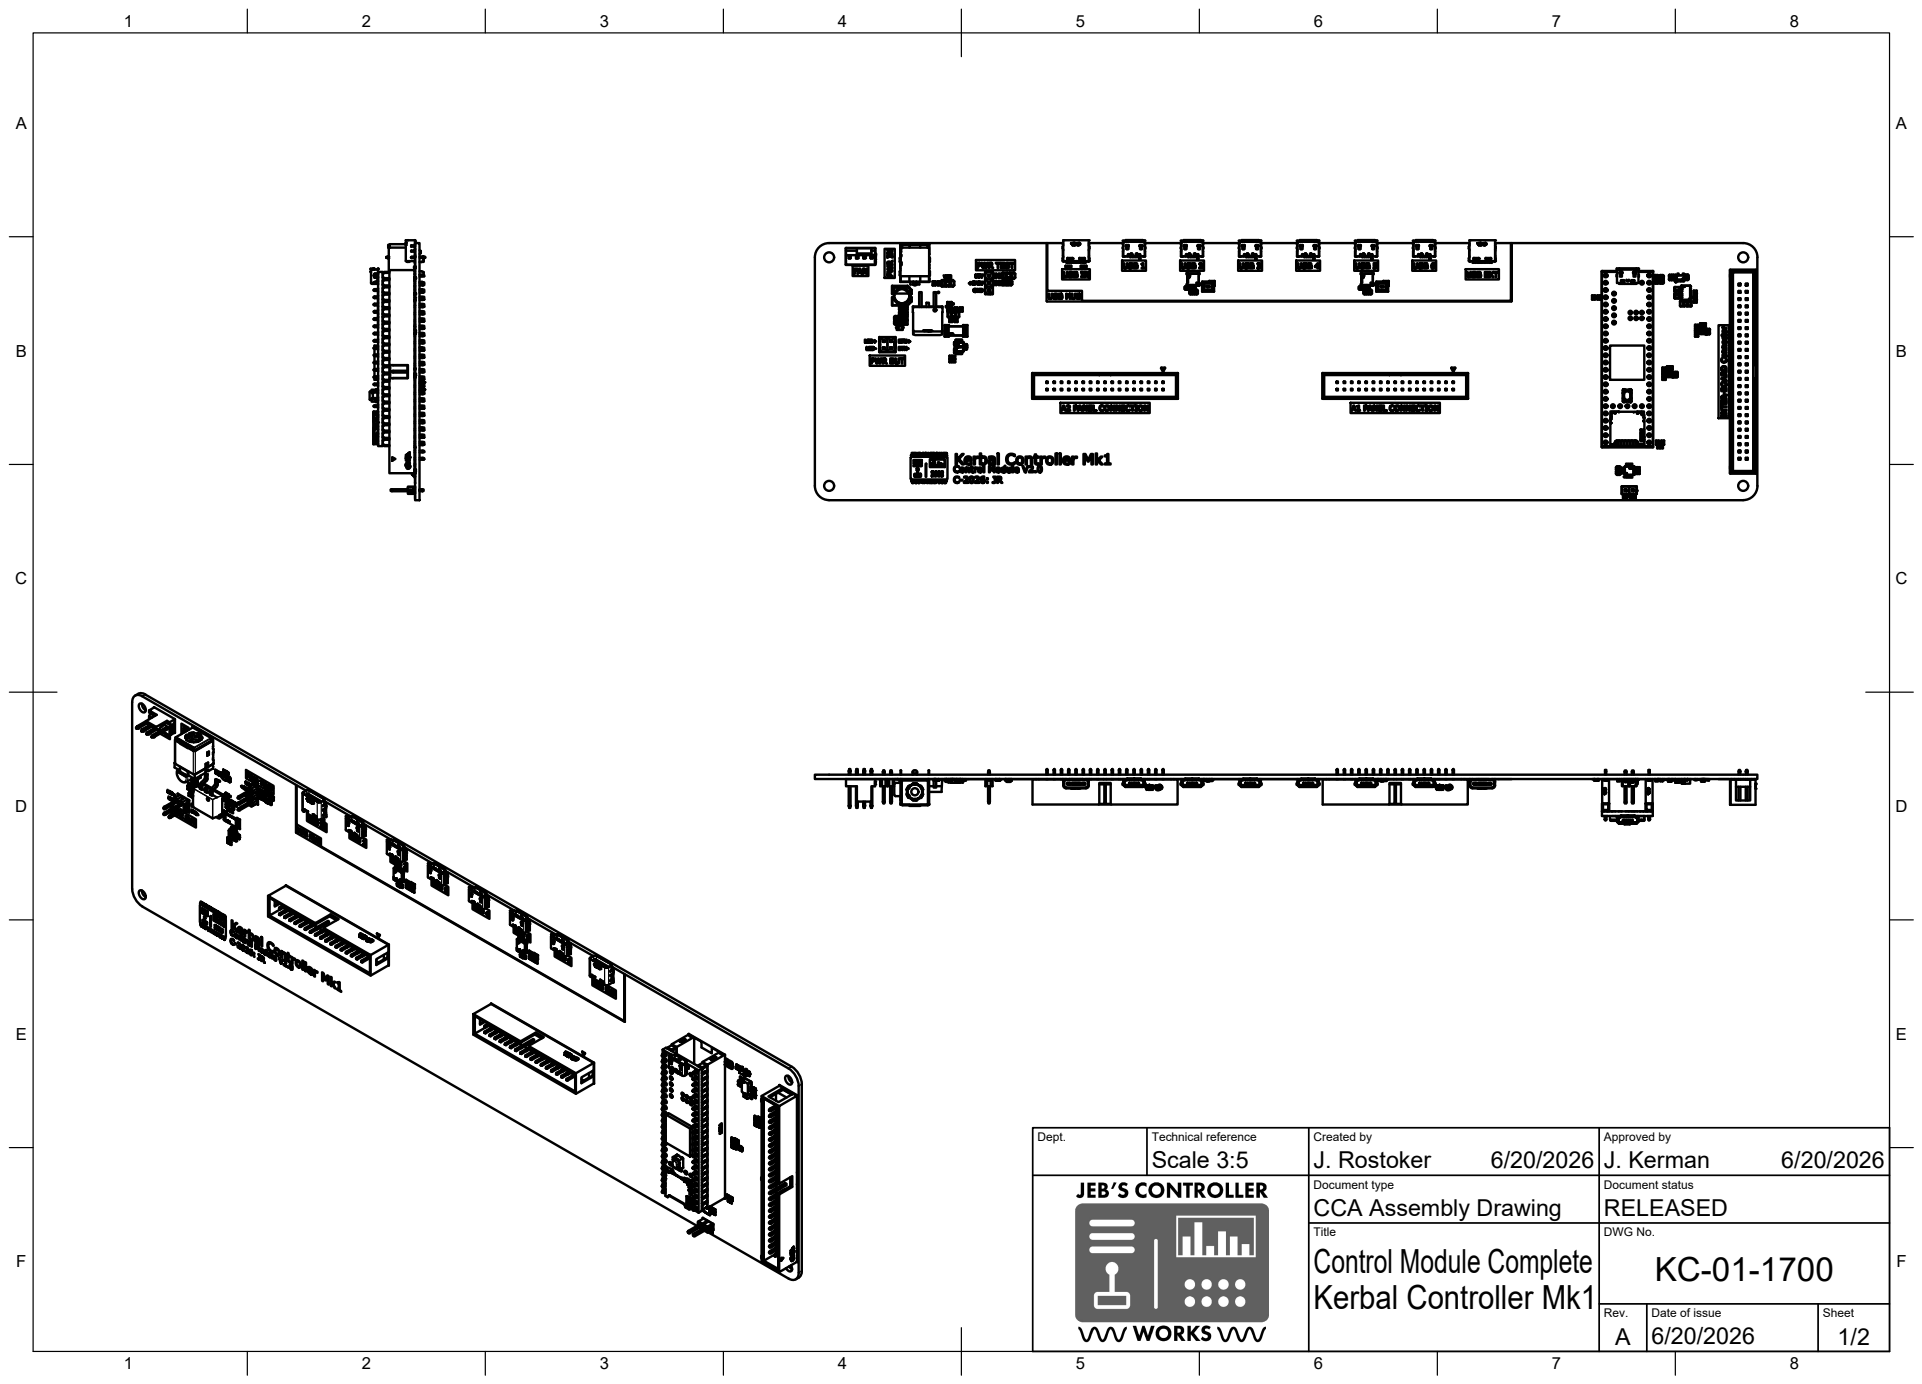
[picture p149: page 1]
Dept.; Technical reference; Created by; Approved by; Document type; Document status; Title; DWG No.; Rev.; Date of issue; Sheet; CCA Assembly Drawing; RELEASED; Kerbal Controller Mk1; Control Module Complete; Scale 3:5; J. Rostoker; J. Kerman

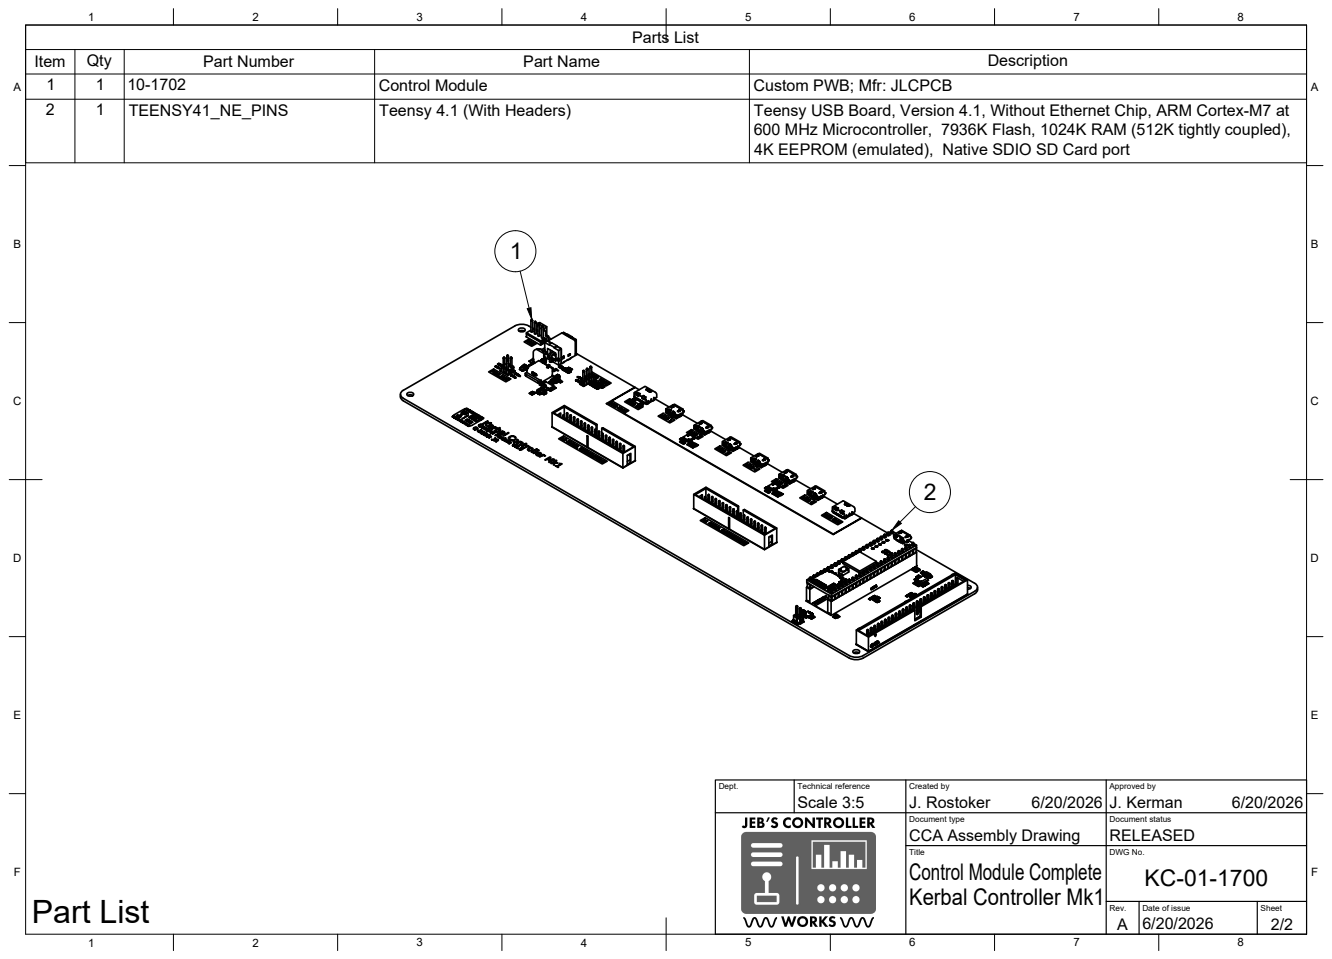
[picture p150: page 2]
Dept.; Technical reference; Created by; Approved by; Document type; Document status; Title; DWG No.; Rev.; Date of issue; Sheet; CCA Assembly Drawing; RELEASED; Kerbal Controller Mk1; Control Module Complete; Scale 3:5; J. Rostoker; J. Kerman; Part List; Parts List; Item; Qty; Part Number; Part Name; Description; Control Module; Custom PWB; Mfr: JLCPCB; TEENSY41_NE_PINS; Teensy 4.1 (With Headers); Teensy USB Board, Version 4.1, Without Ethernet Chip, ARM Cortex-M7 at

600 MHz Microcontroller, 7936K Flash, 1024K RAM (512K tightly coupled),
4K EEPROM (emulated), Native SDIO SD Card port
