bigJRo/KerbalControllerMk1/Documents/Drawings/KC-01-1701_V2.0_Control Module_SCH.pdf

# Power On - Soft Latching Circuit

# Fan Connector

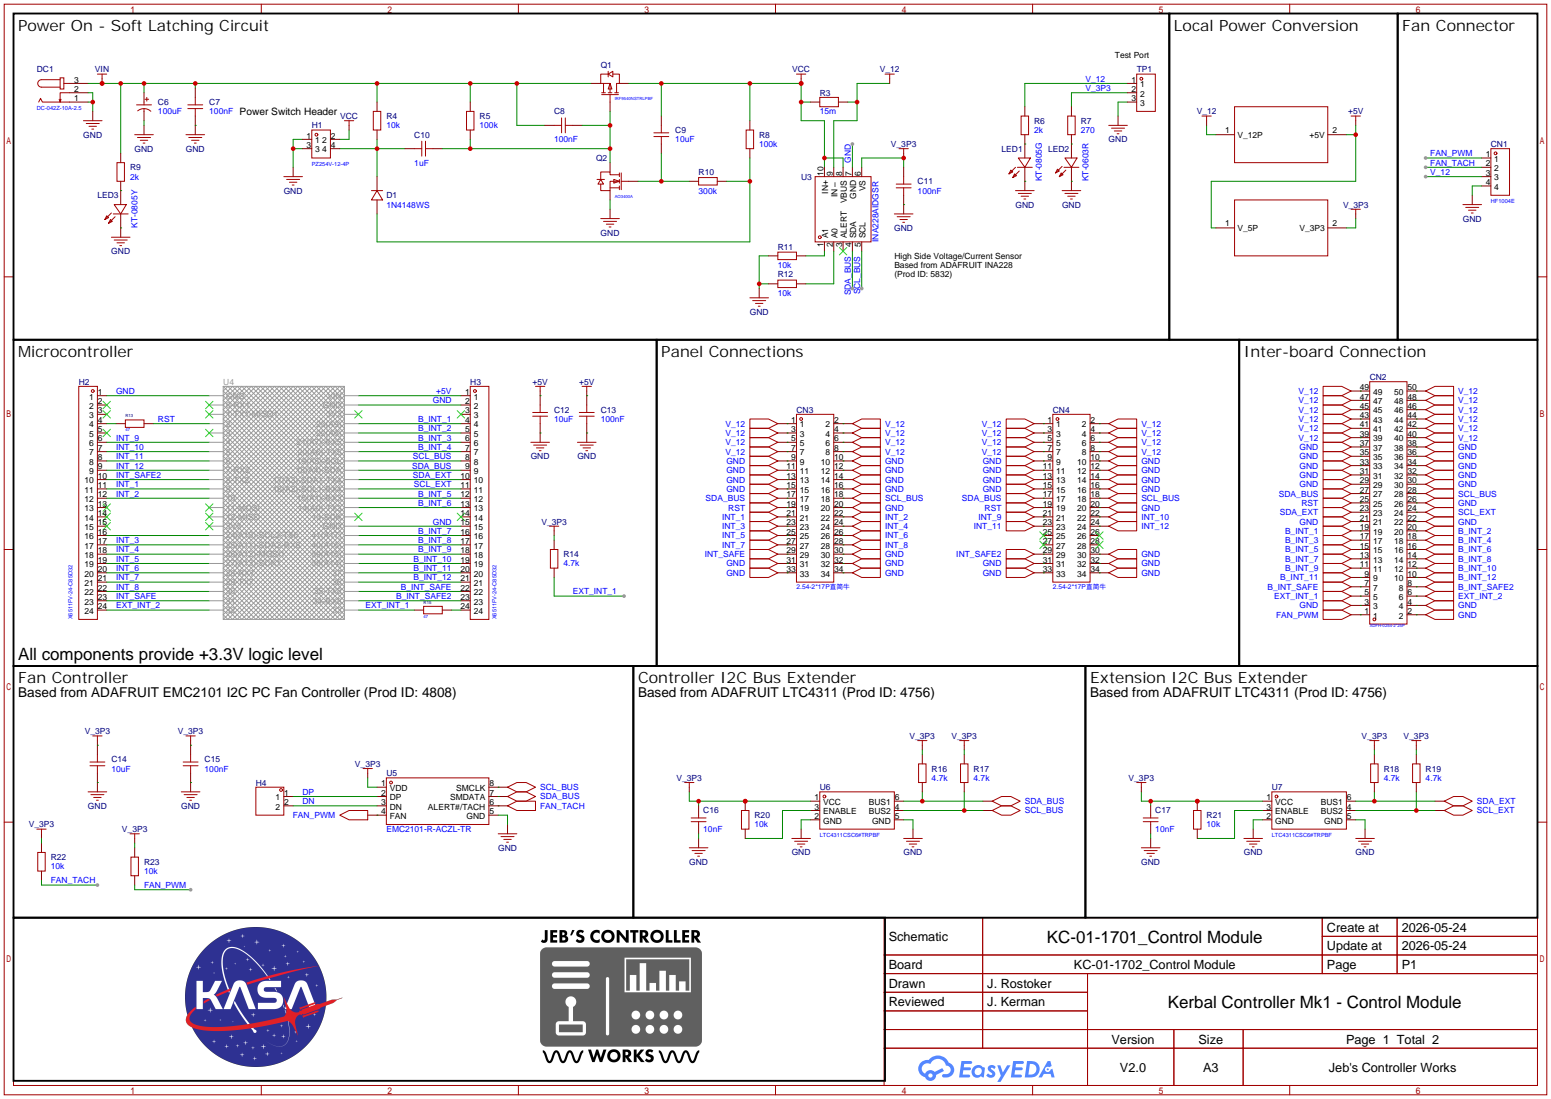
[picture p151: page 1]

High Side Voltage/Current Sensor
Based from ADAFRUIT INA228
(Prod ID: 5832)

Controller I2C Bus Extender
Based from ADAFRUIT LTC4311 (Prod ID: 4756)

Extension I2C Bus Extender

Schematic | KC-01-1701_Control Module | Create at | 2026-05-24

Update at | 2026-05-24

Board | KC-01-1702_Control Module | Page | P1
Drawn | J. Rostoker | Kerbal Controller Mk1 - Control Module
Reviewed | J. Kerman

Version | Size | Page 1 Total 2
V2.0 | A3 | Jeb's Controller Works

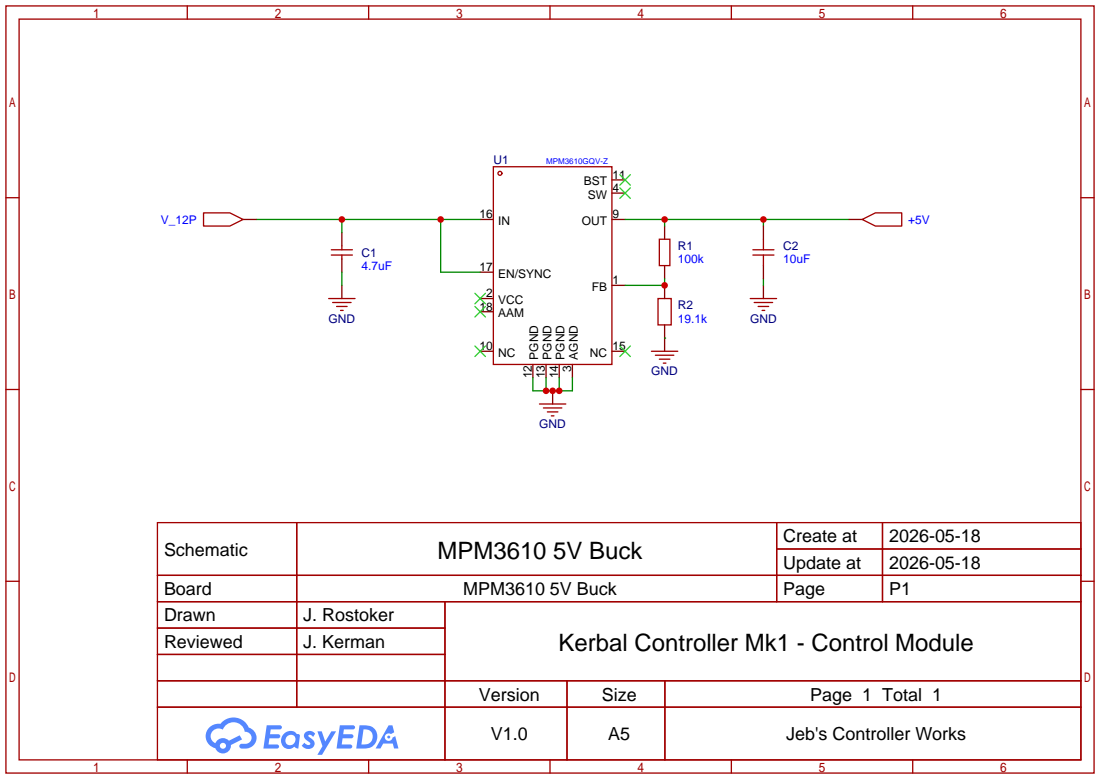
[picture p152: page 2]

Schematic | MPM3610 5V Buck | Create at | 2026-05-18

Update at | 2026-05-18

Board | MPM3610 5V Buck | Page | P1
Drawn | J. Rostoker | Kerbal Controller Mk1 - Control Module
Reviewed | J. Kerman

Version | Size | Page 1 Total 1
V1.0 | A5 | Jeb's Controller Works

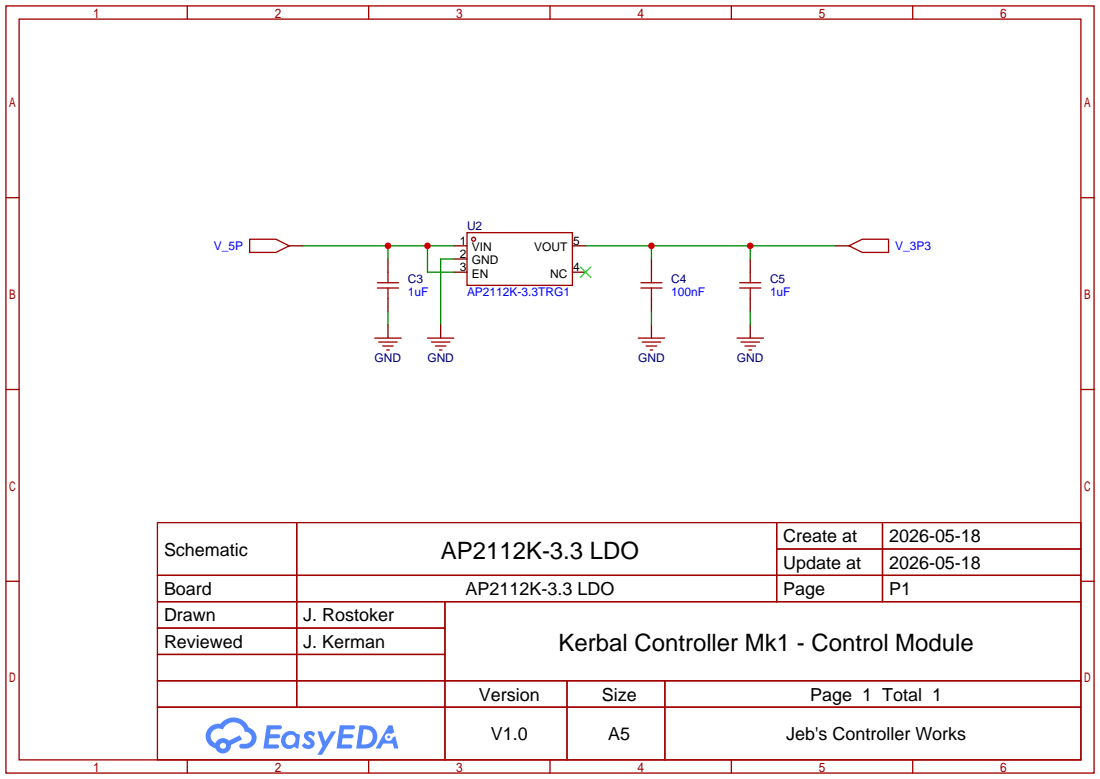
[picture p153: page 3]

Schematic | AP2112K-3.3 LDO | Create at | 2026-05-18

Update at | 2026-05-18

Board | AP2112K-3.3 LDO | Page | P1
Drawn | J. Rostoker | Kerbal Controller Mk1 - Control Module
Reviewed | J. Kerman

Version | Size | Page 1 Total 1
V1.0 | A5 | Jeb's Controller Works

# Embedded USB Hub

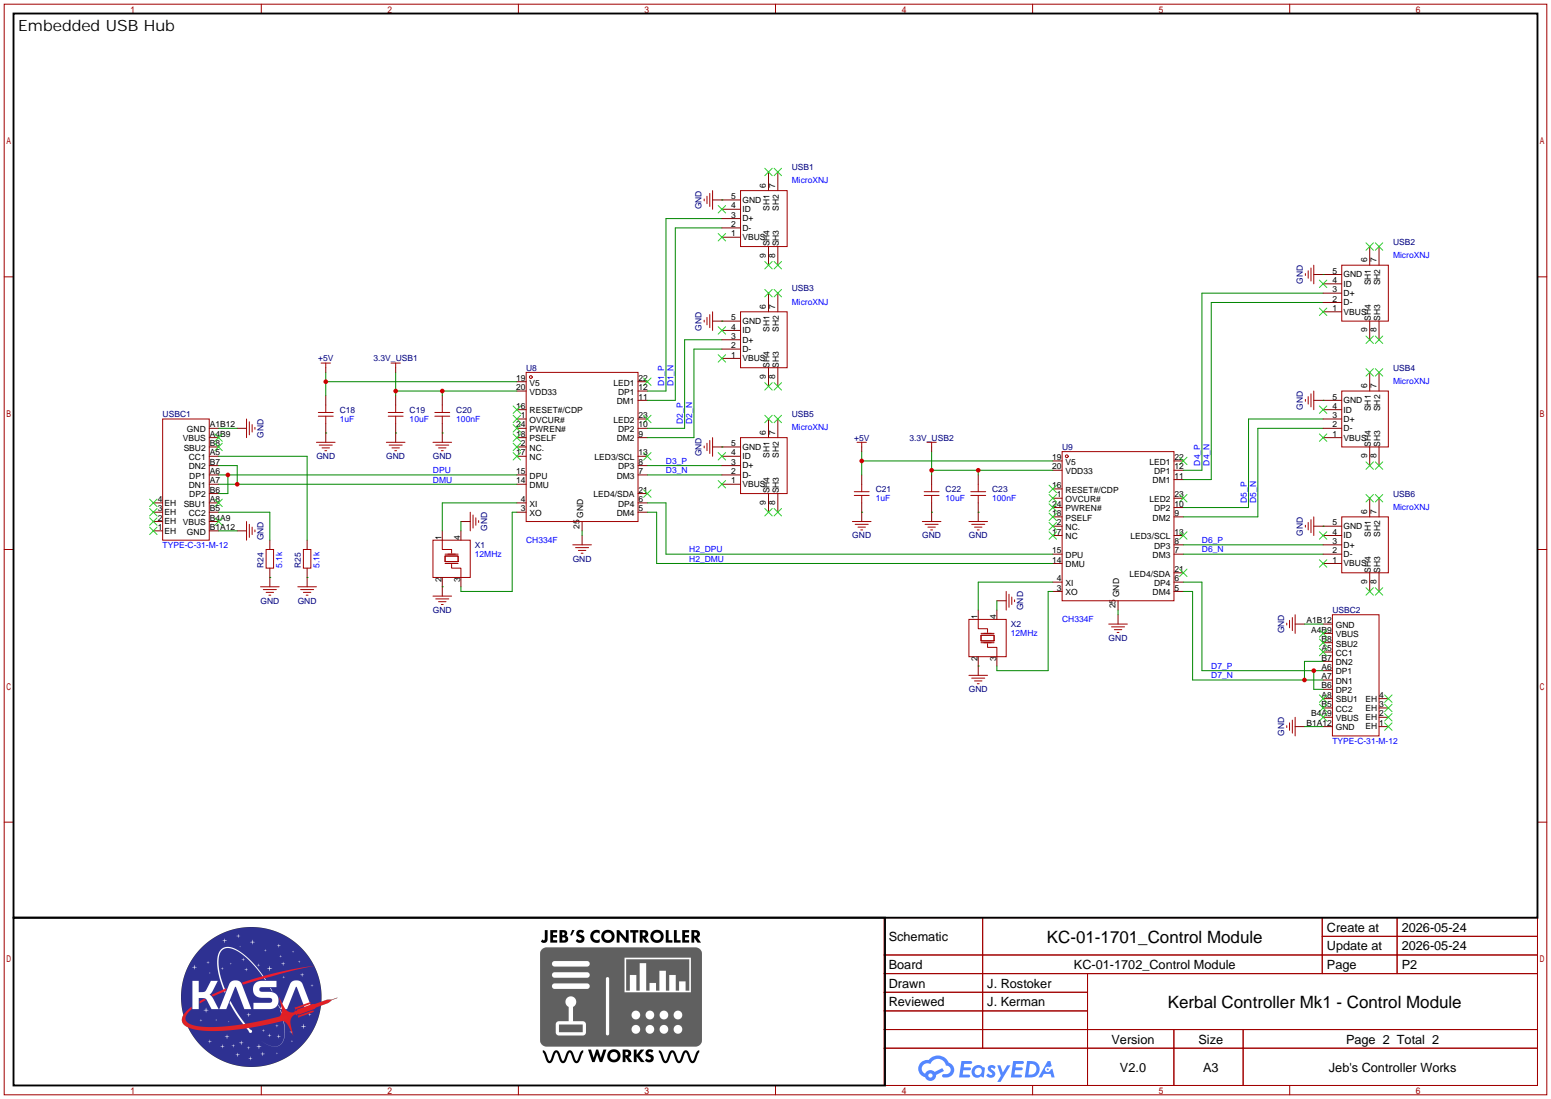
[picture p154: page 4]

Schematic | KC-01-1701_Control Module | Create at | 2026-05-24

Update at | 2026-05-24

Board | KC-01-1702_Control Module | Page | P2
Drawn | J. Rostoker | Kerbal Controller Mk1 - Control Module
Reviewed | J. Kerman

Version | Size | Page 2 Total 2
V2.0 | A3 | Jeb's Controller Works
