bigJRo/KerbalControllerMk1/Documents/Drawings/KC-01-1702_V2.0_Control Module_PWB.pdf

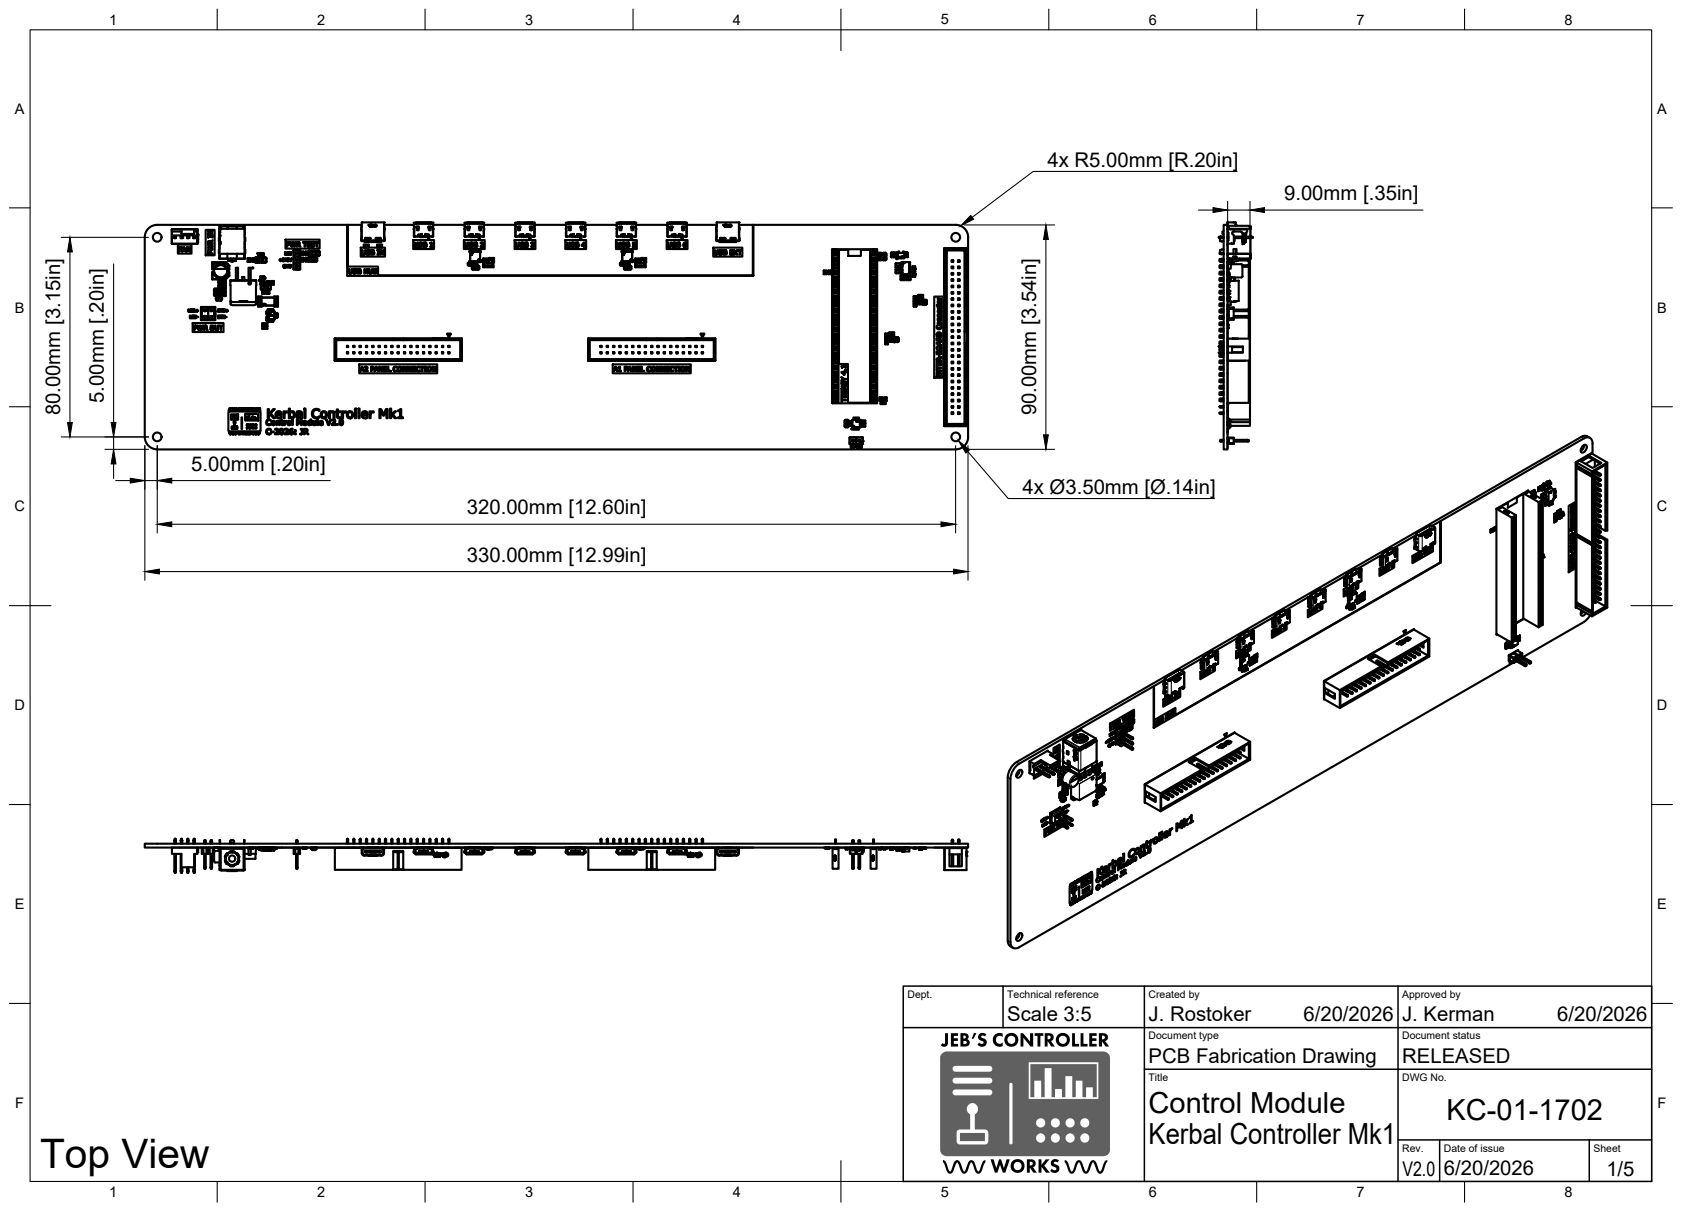
[picture p155: page 1]
Dept.; Technical reference; Created by; Approved by; Document type; Document status; Title; DWG No.; Rev.; Date of issue; Sheet; PCB Fabrication Drawing; RELEASED; Kerbal Controller Mk1; Control Module; Scale 3:5; J. Rostoker; J. Kerman; Top View

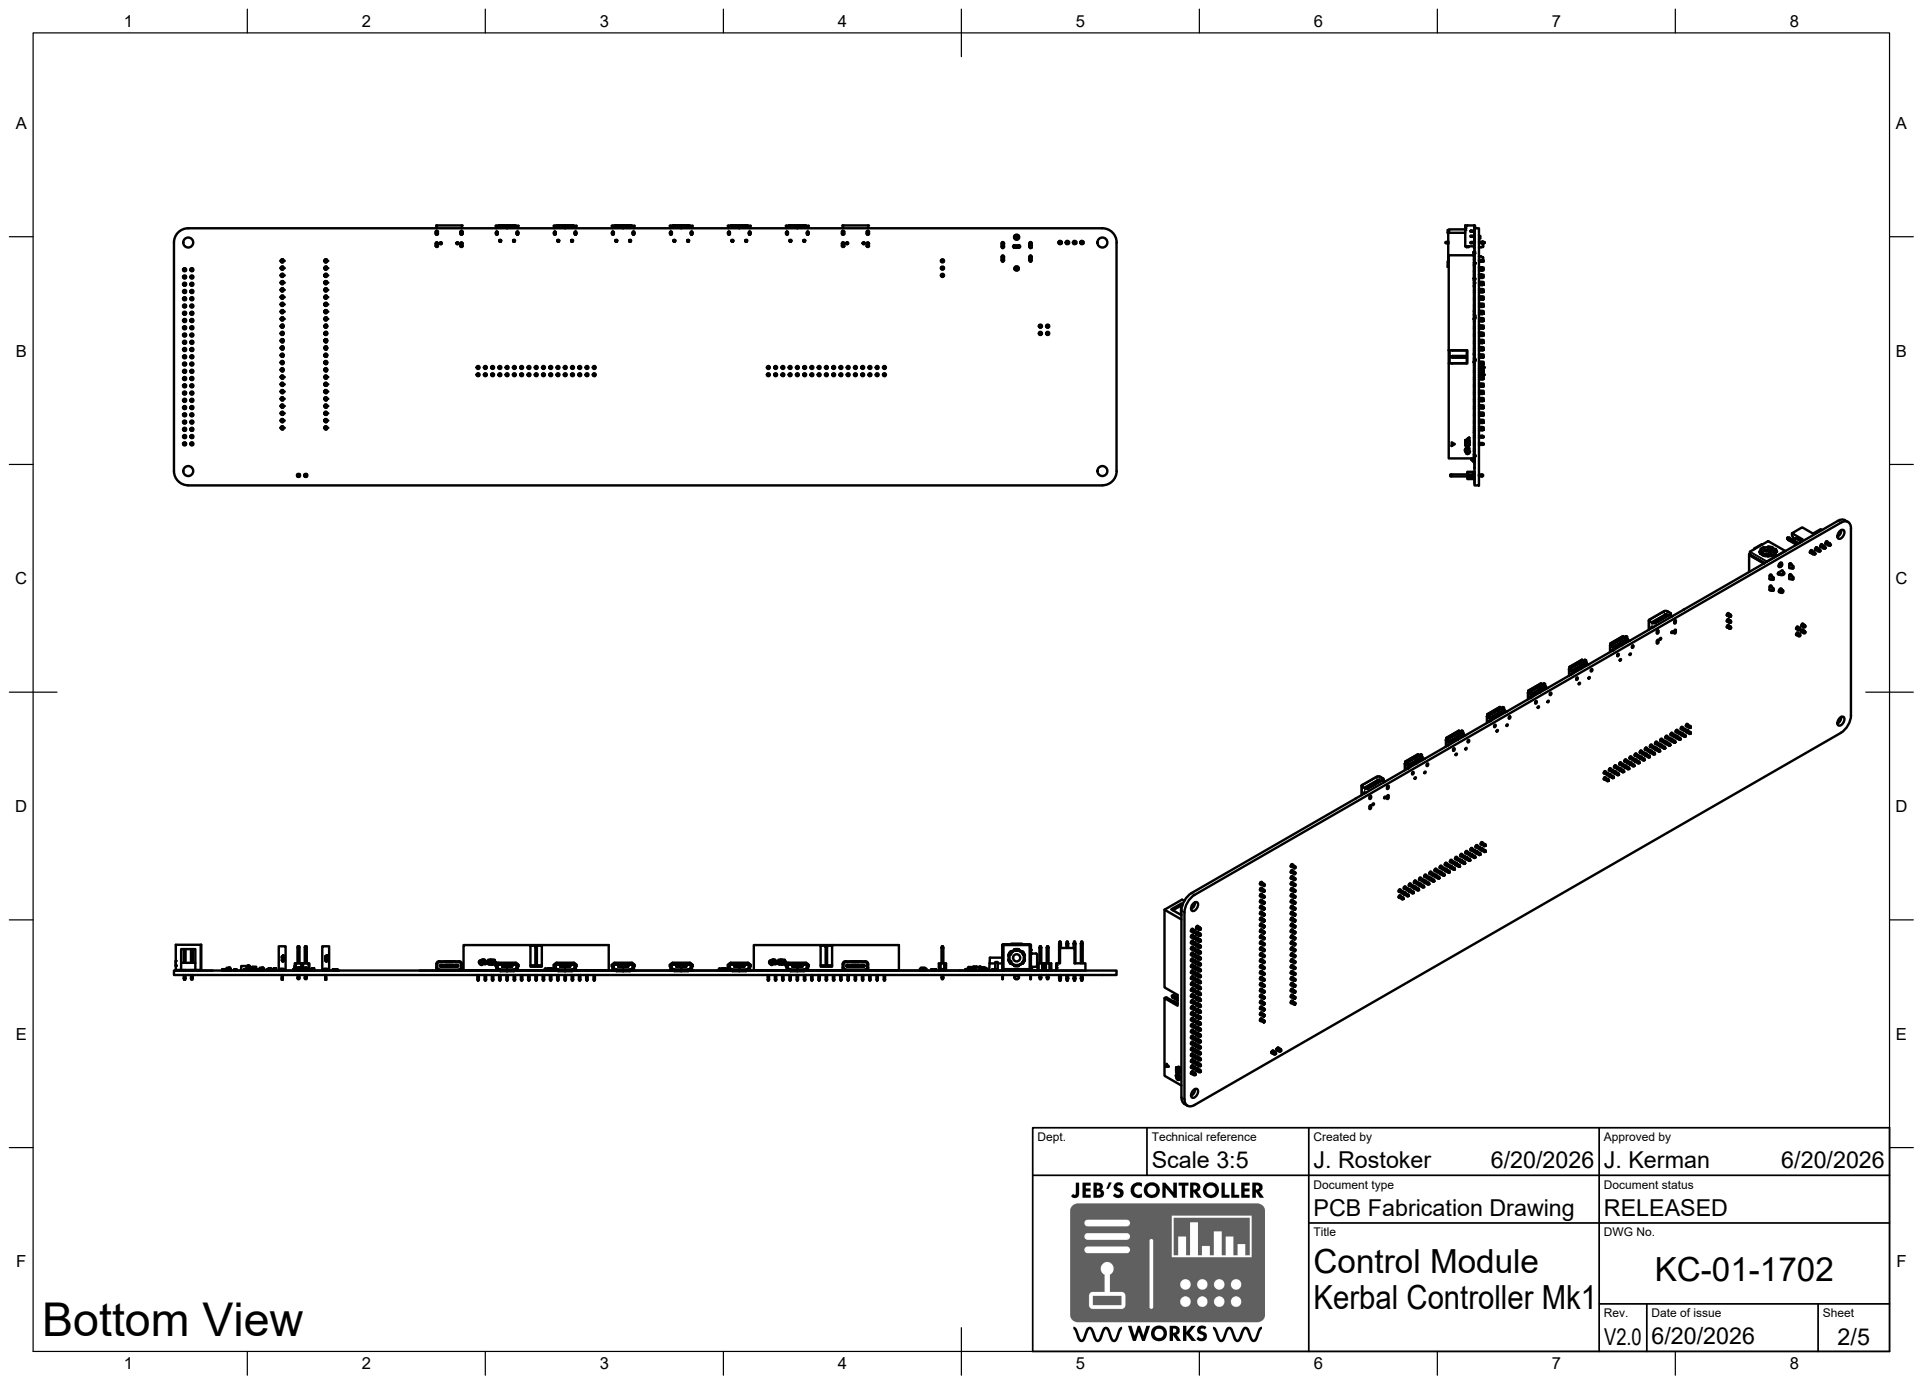
[picture p156: page 2]
Dept.; Technical reference; Created by; Approved by; Document type; Document status; Title; DWG No.; PCB Fabrication Drawing; RELEASED; Control Module; Scale 3:5; J. Rostoker; J. Kerman; Bottom View

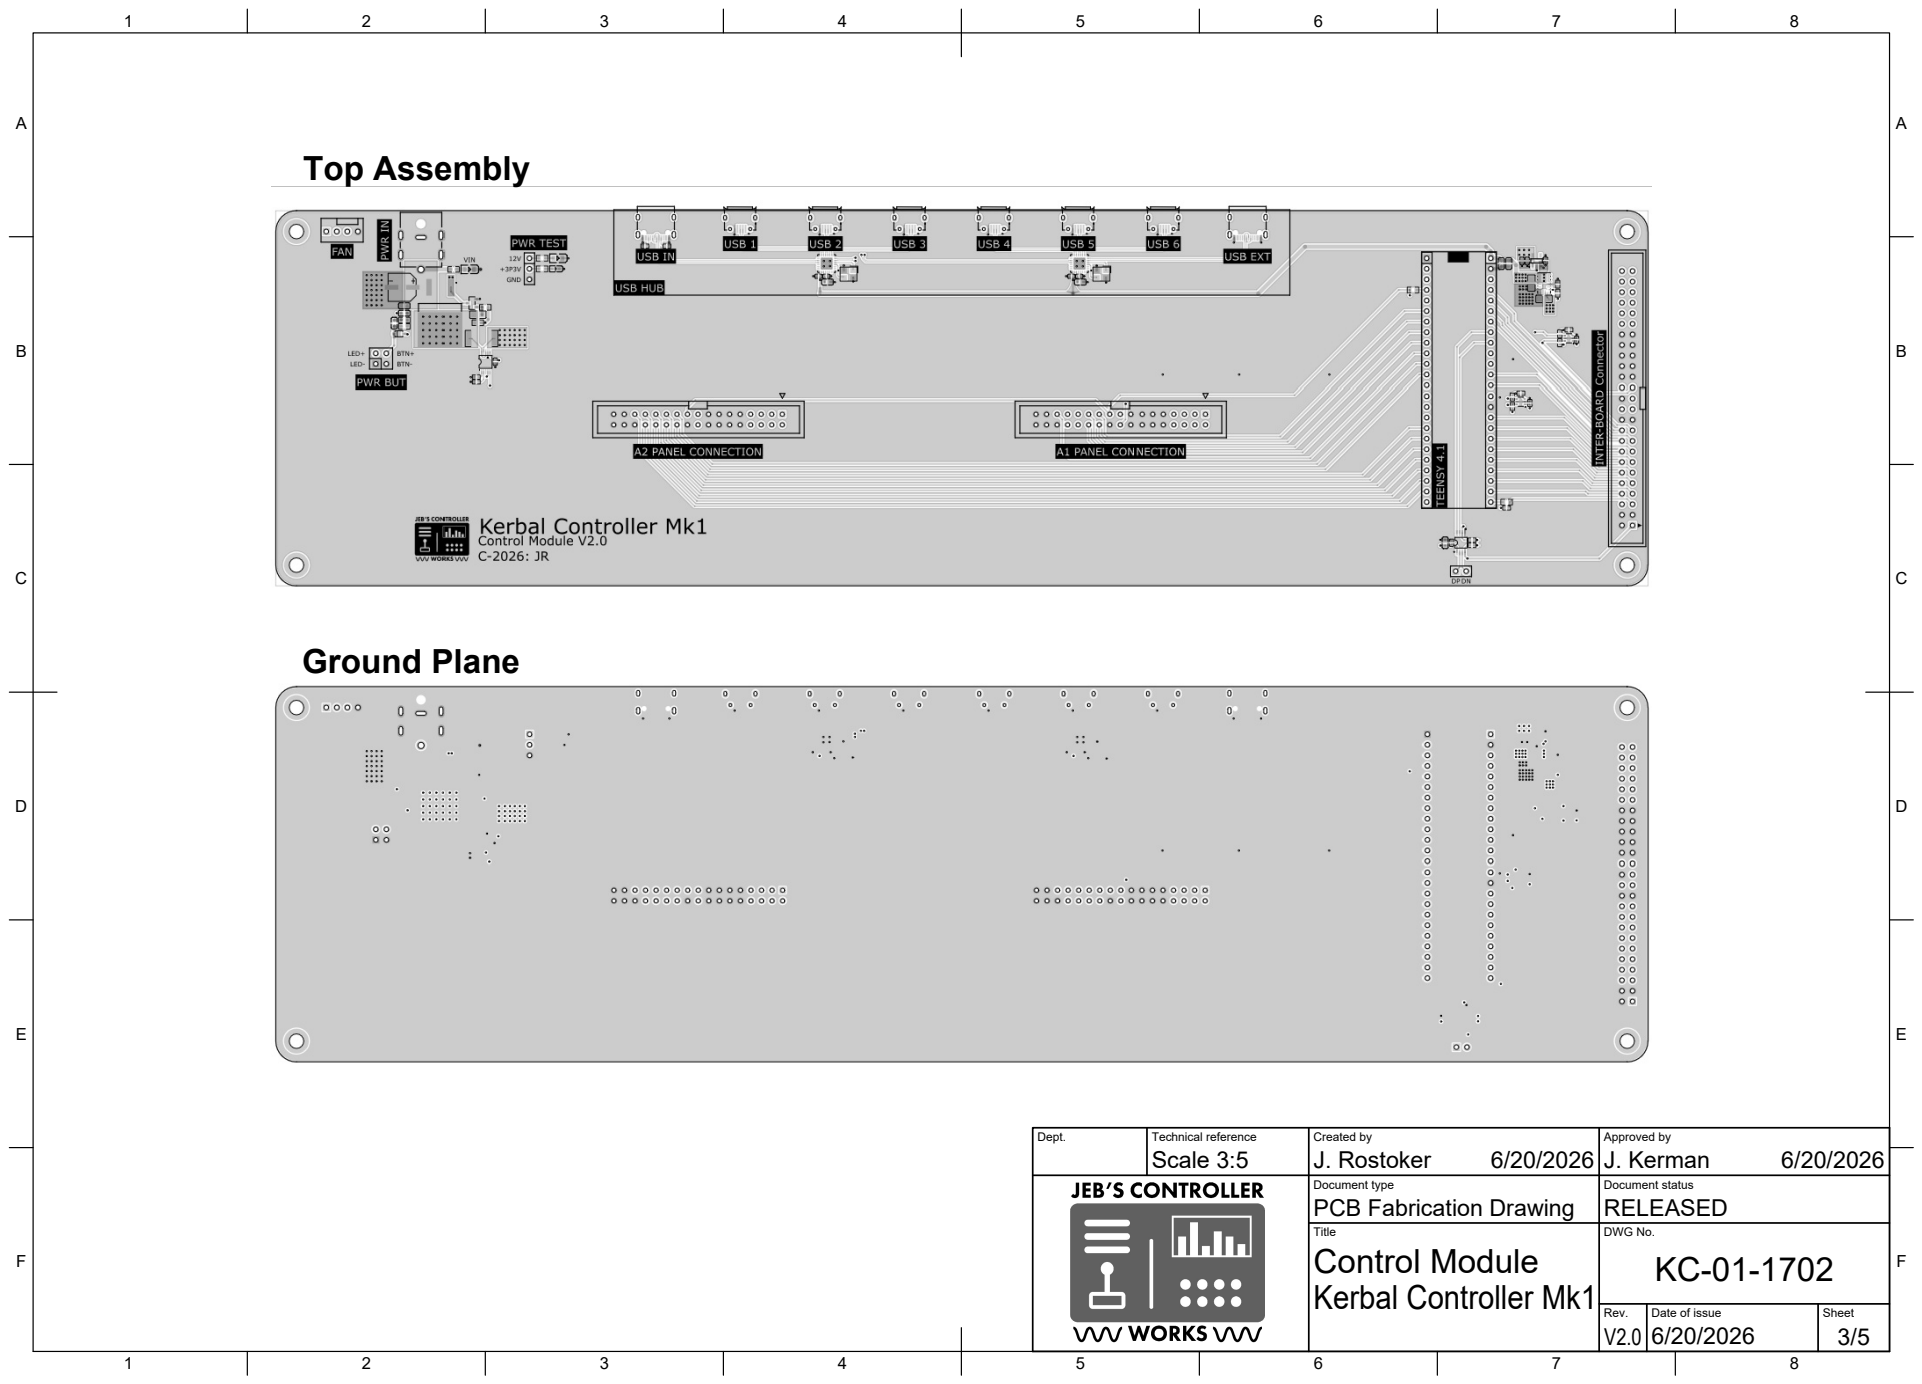
[picture p157: page 3]
Title; DWG No.; Control Module; Top Assembly; Ground Plane

Dept. | Technical reference Scale 3:5 | Created by J. Rostoker 6/20/2026 | Approved by J. Kerman 6/20/2026

Document type PCB Fabrication Drawing | Document status RELEASED

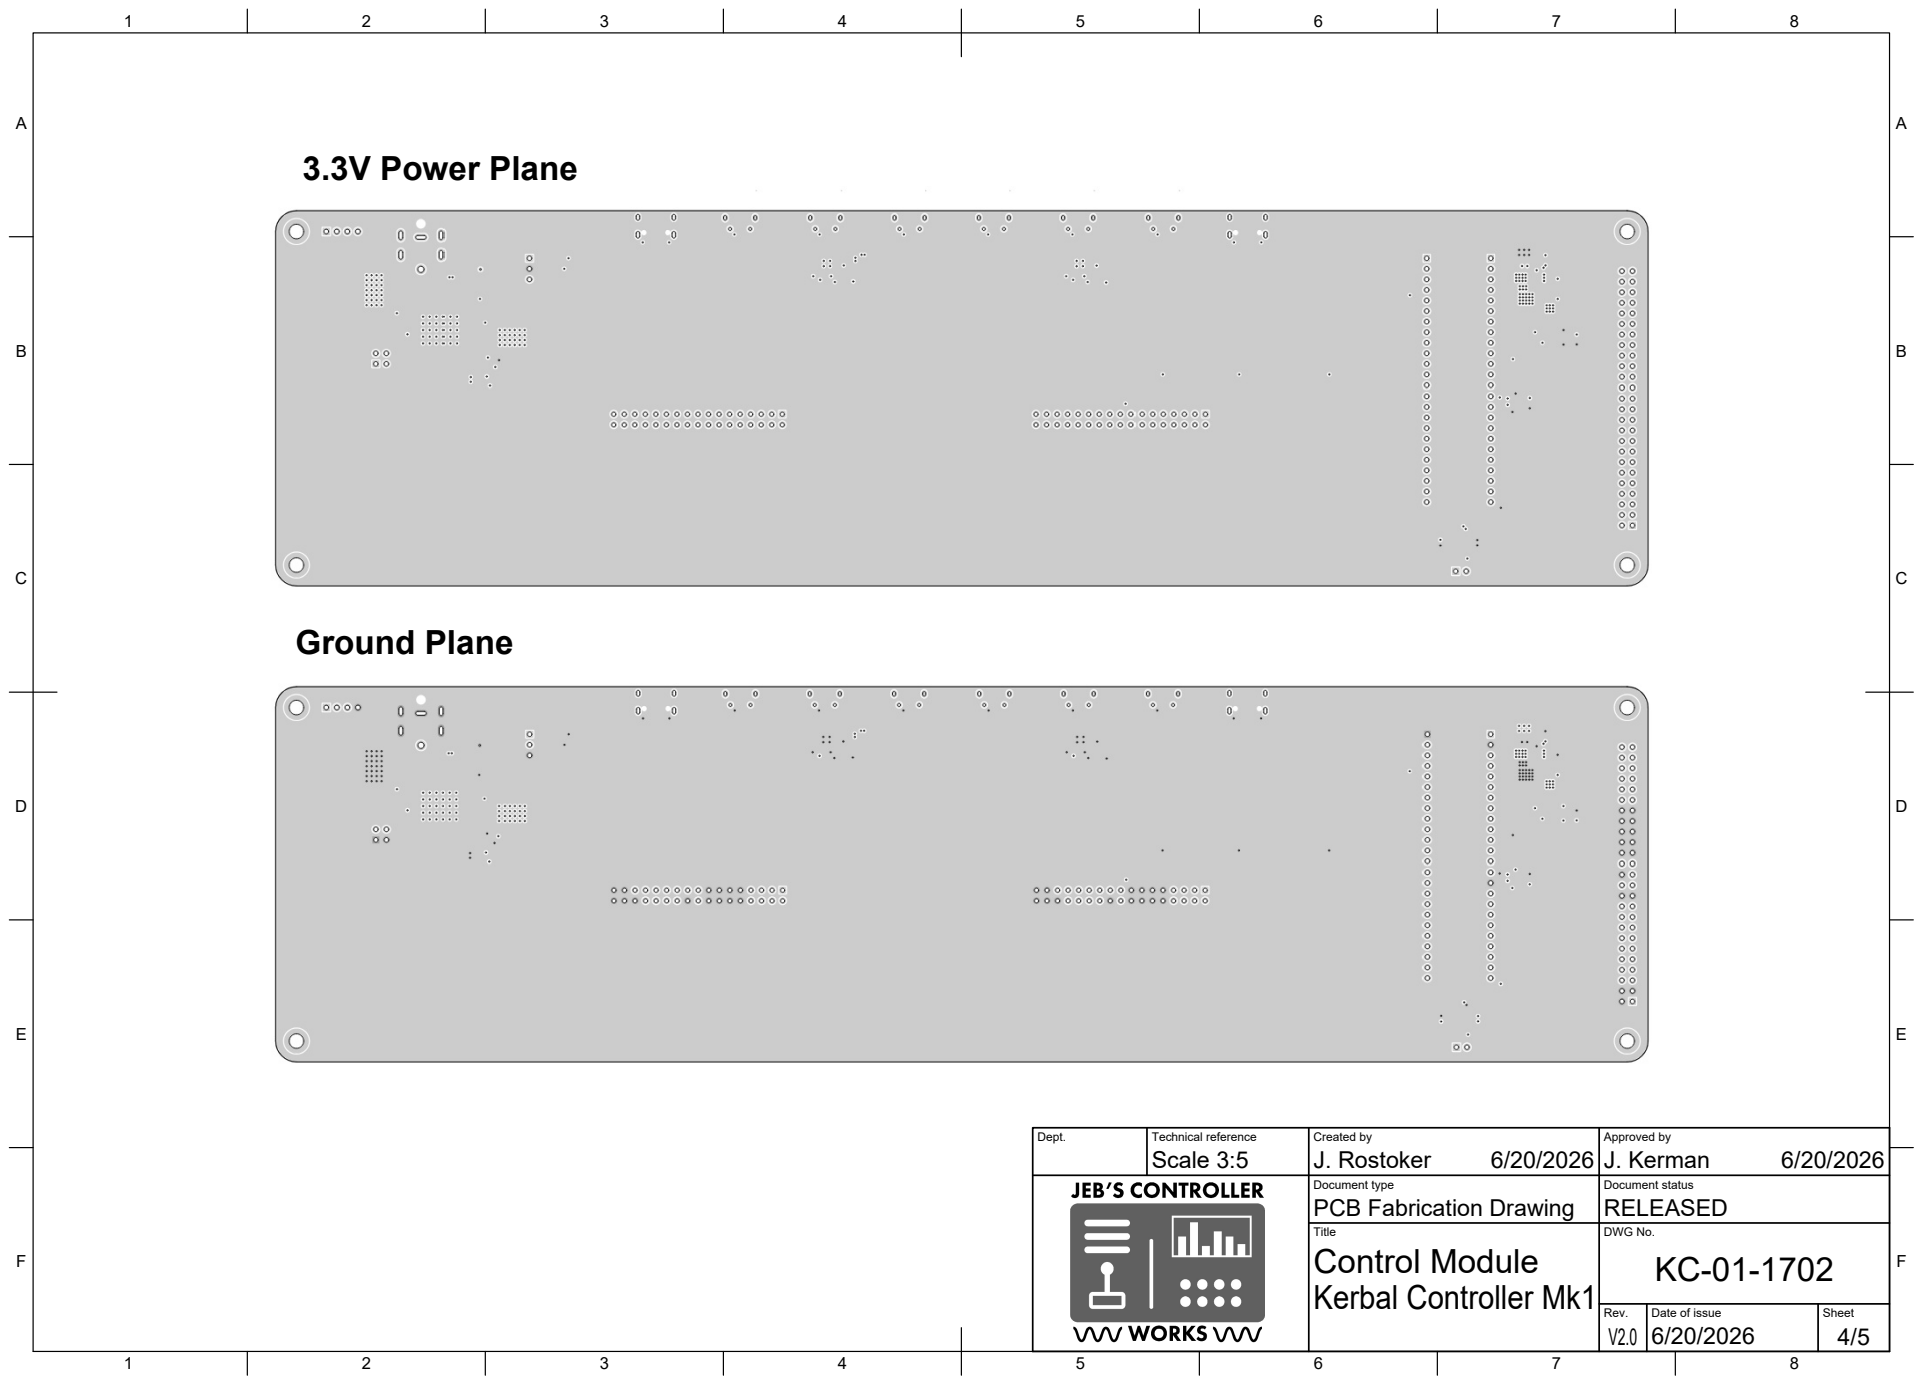
[picture p158: page 4]
Title; DWG No.; Control Module; 3.3V Power Plane; Ground Plane

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

Document type PCB Fabrication Drawing | Document status RELEASED

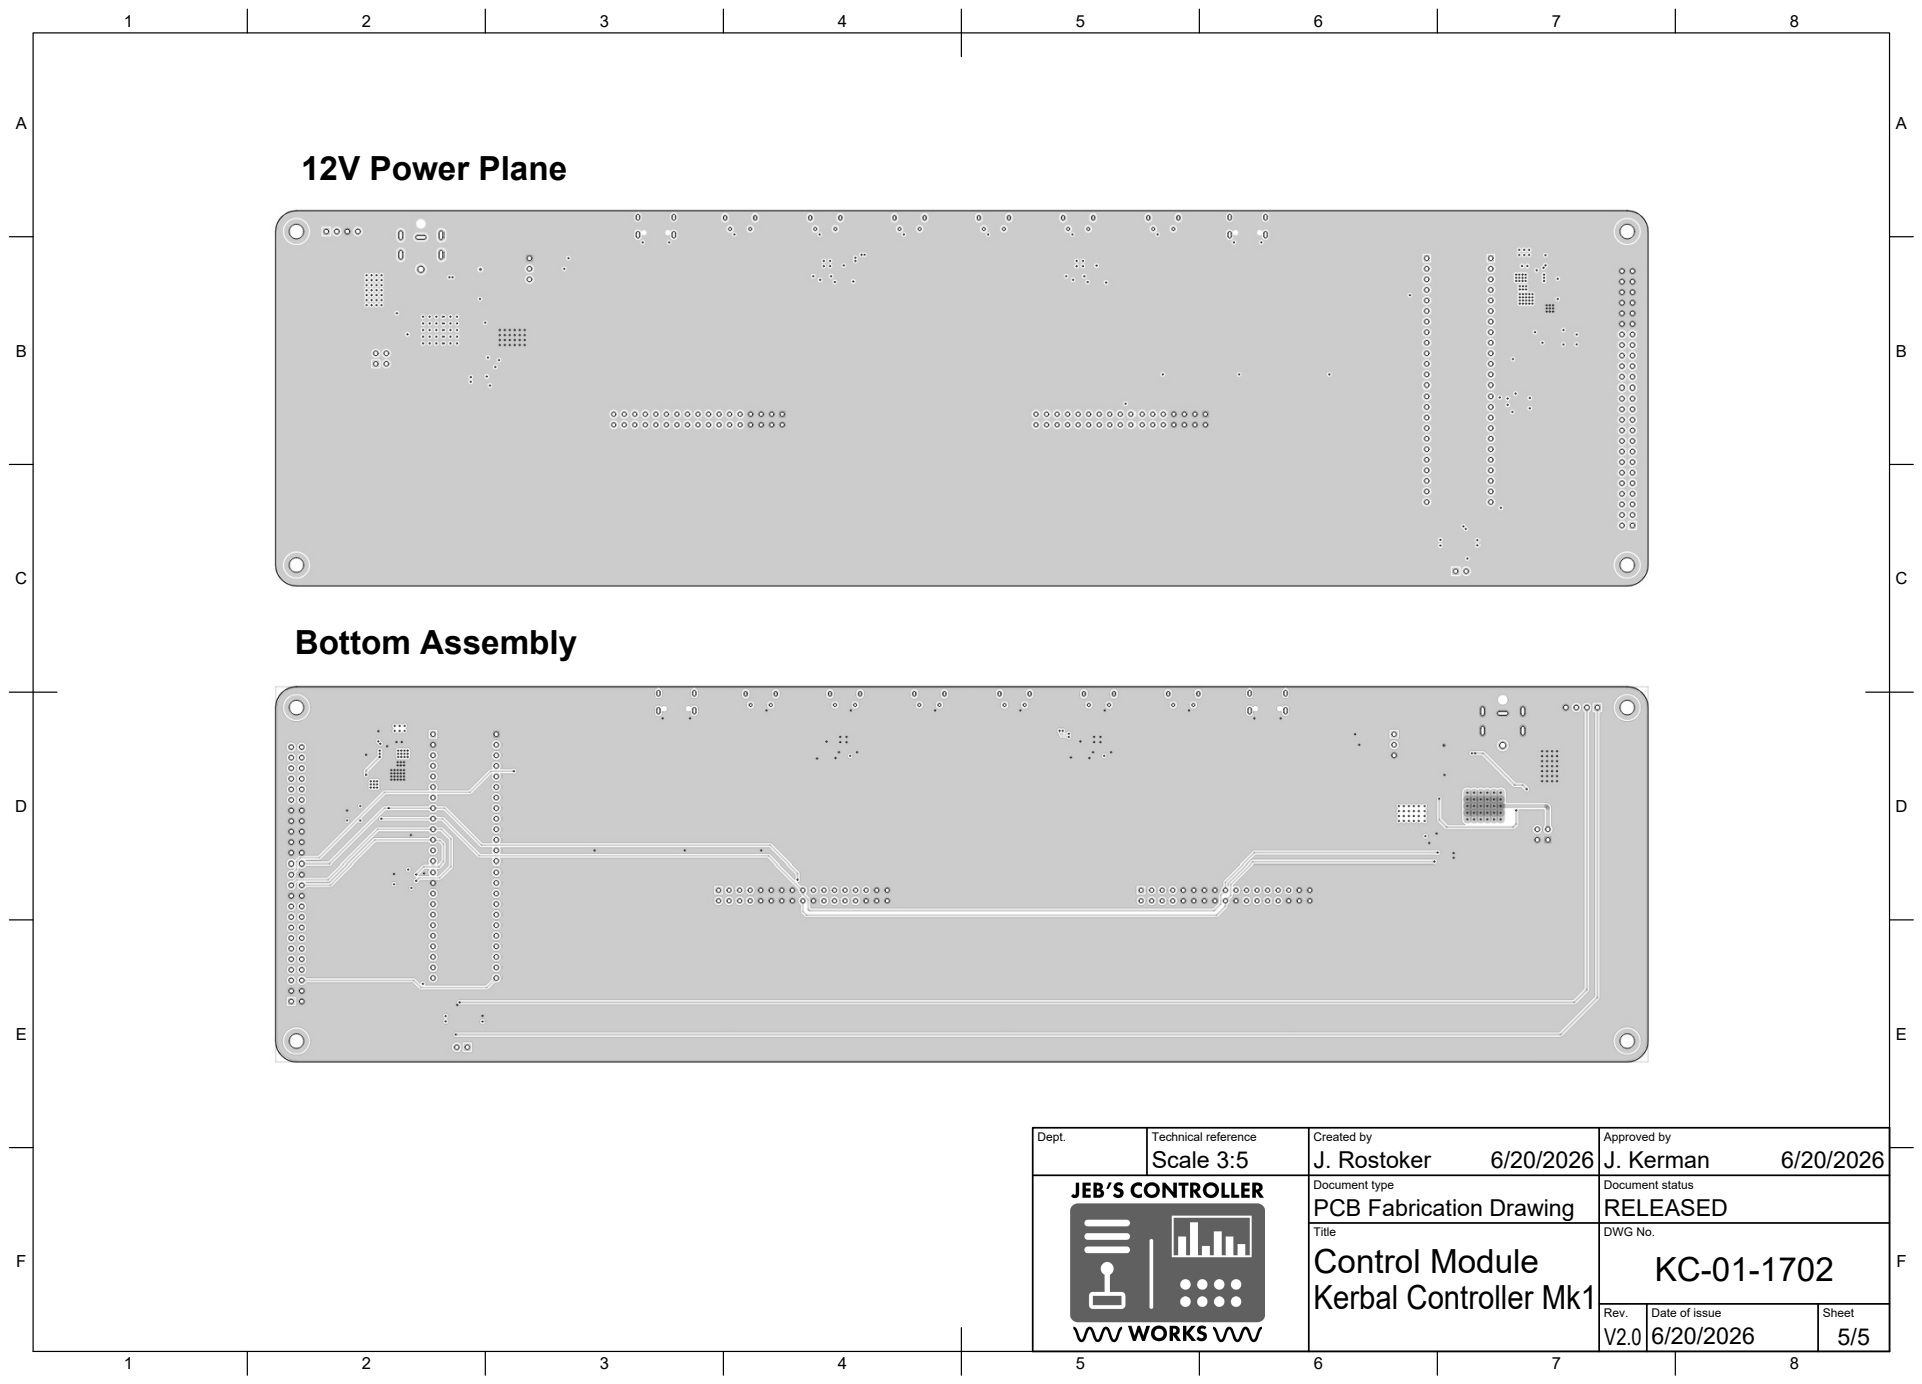
[picture p159: page 5]
Title; DWG No.; Control Module; 12V Power Plane; Bottom Assembly

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

Document type PCB Fabrication Drawing | Document status RELEASED
