bigJRo/KerbalControllerMk1/Documents/Drawings/KC-01-1711_V2.0_Control Module Extension_SCH.pdf

# Fan Connector

# Inter-board Connection

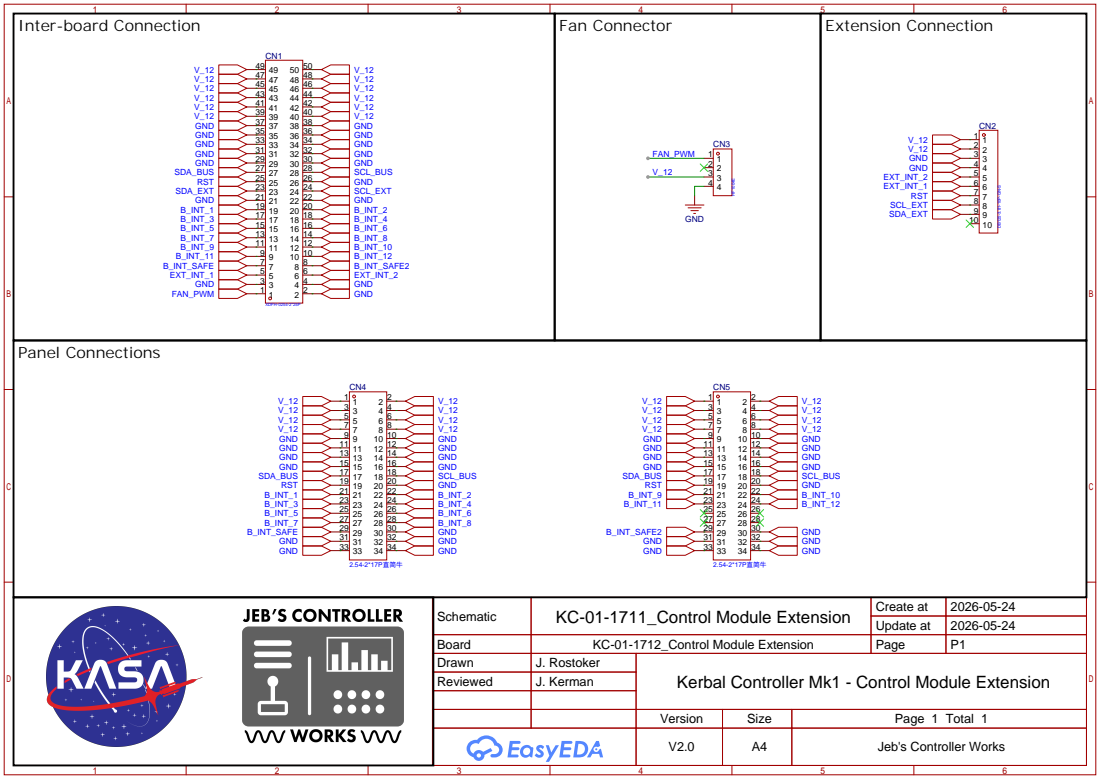
[picture p160: page 1]

Schematic | KC-01-1711_Control Module Extension | Create at | 2026-05-24

Update at | 2026-05-24

Board | KC-01-1712_Control Module Extension | Page | P1
Drawn | J. Rostoker | Kerbal Controller Mk1 - Control Module Extension
Reviewed | J. Kerman

Version | Size | Page 1 Total 1
V2.0 | A4 | Jeb's Controller Works
