bigJRo/KerbalControllerMk1/Documents/Drawings/KC-01-1712_V2.0_Control Module Extension_PWB.pdf

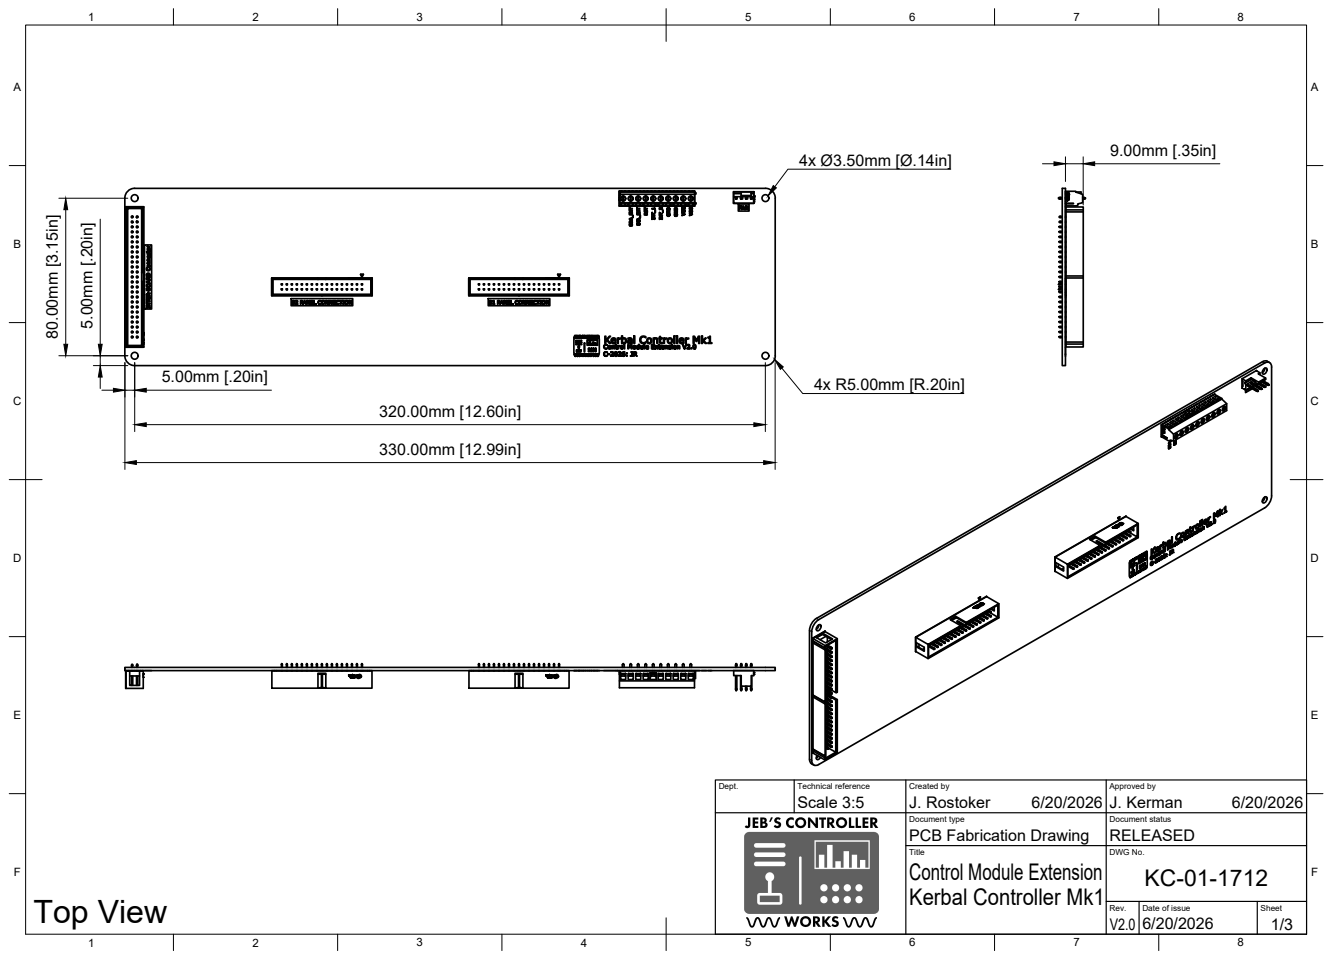
[picture p161: page 1]
Dept.; Technical reference; Created by; Approved by; Document type; Document status; Title; DWG No.; Rev.; Date of issue; Sheet; PCB Fabrication Drawing; RELEASED; Kerbal Controller Mk1; Control Module Extension; Scale 3:5; J. Rostoker; J. Kerman; Top View 5.00mm [.20in] 80.00mm [3.15in]

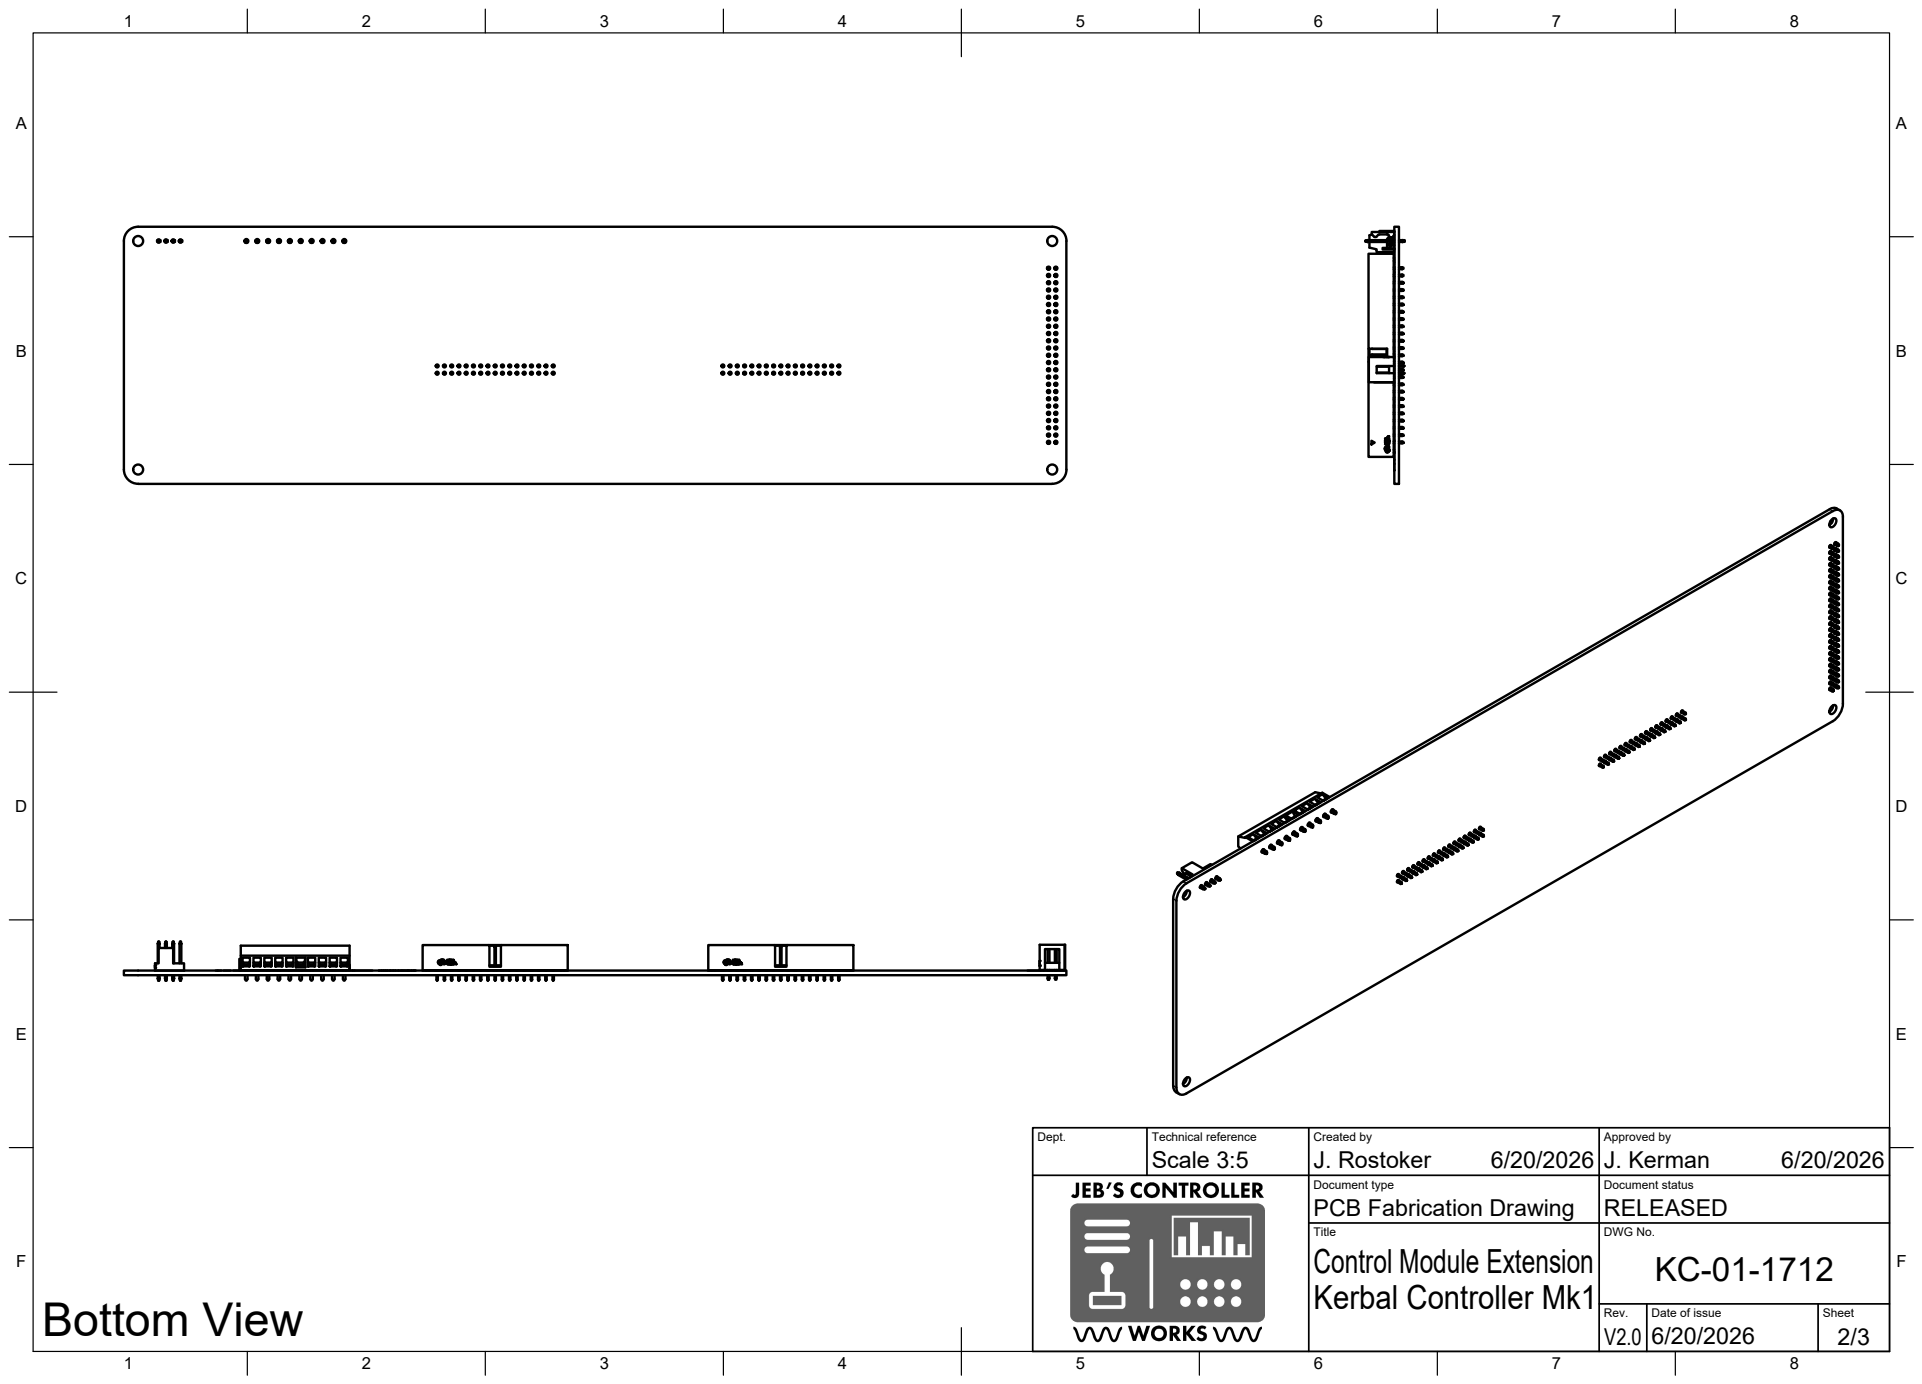
[picture p162: page 2]
Title; DWG No.; Control Module Extension; Bottom View

Dept. | Technical reference Scale 3:5 | Created by J. Rostoker 6/20/2026 | Approved by J. Kerman 6/20/2026

Document type PCB Fabrication Drawing | Document status RELEASED

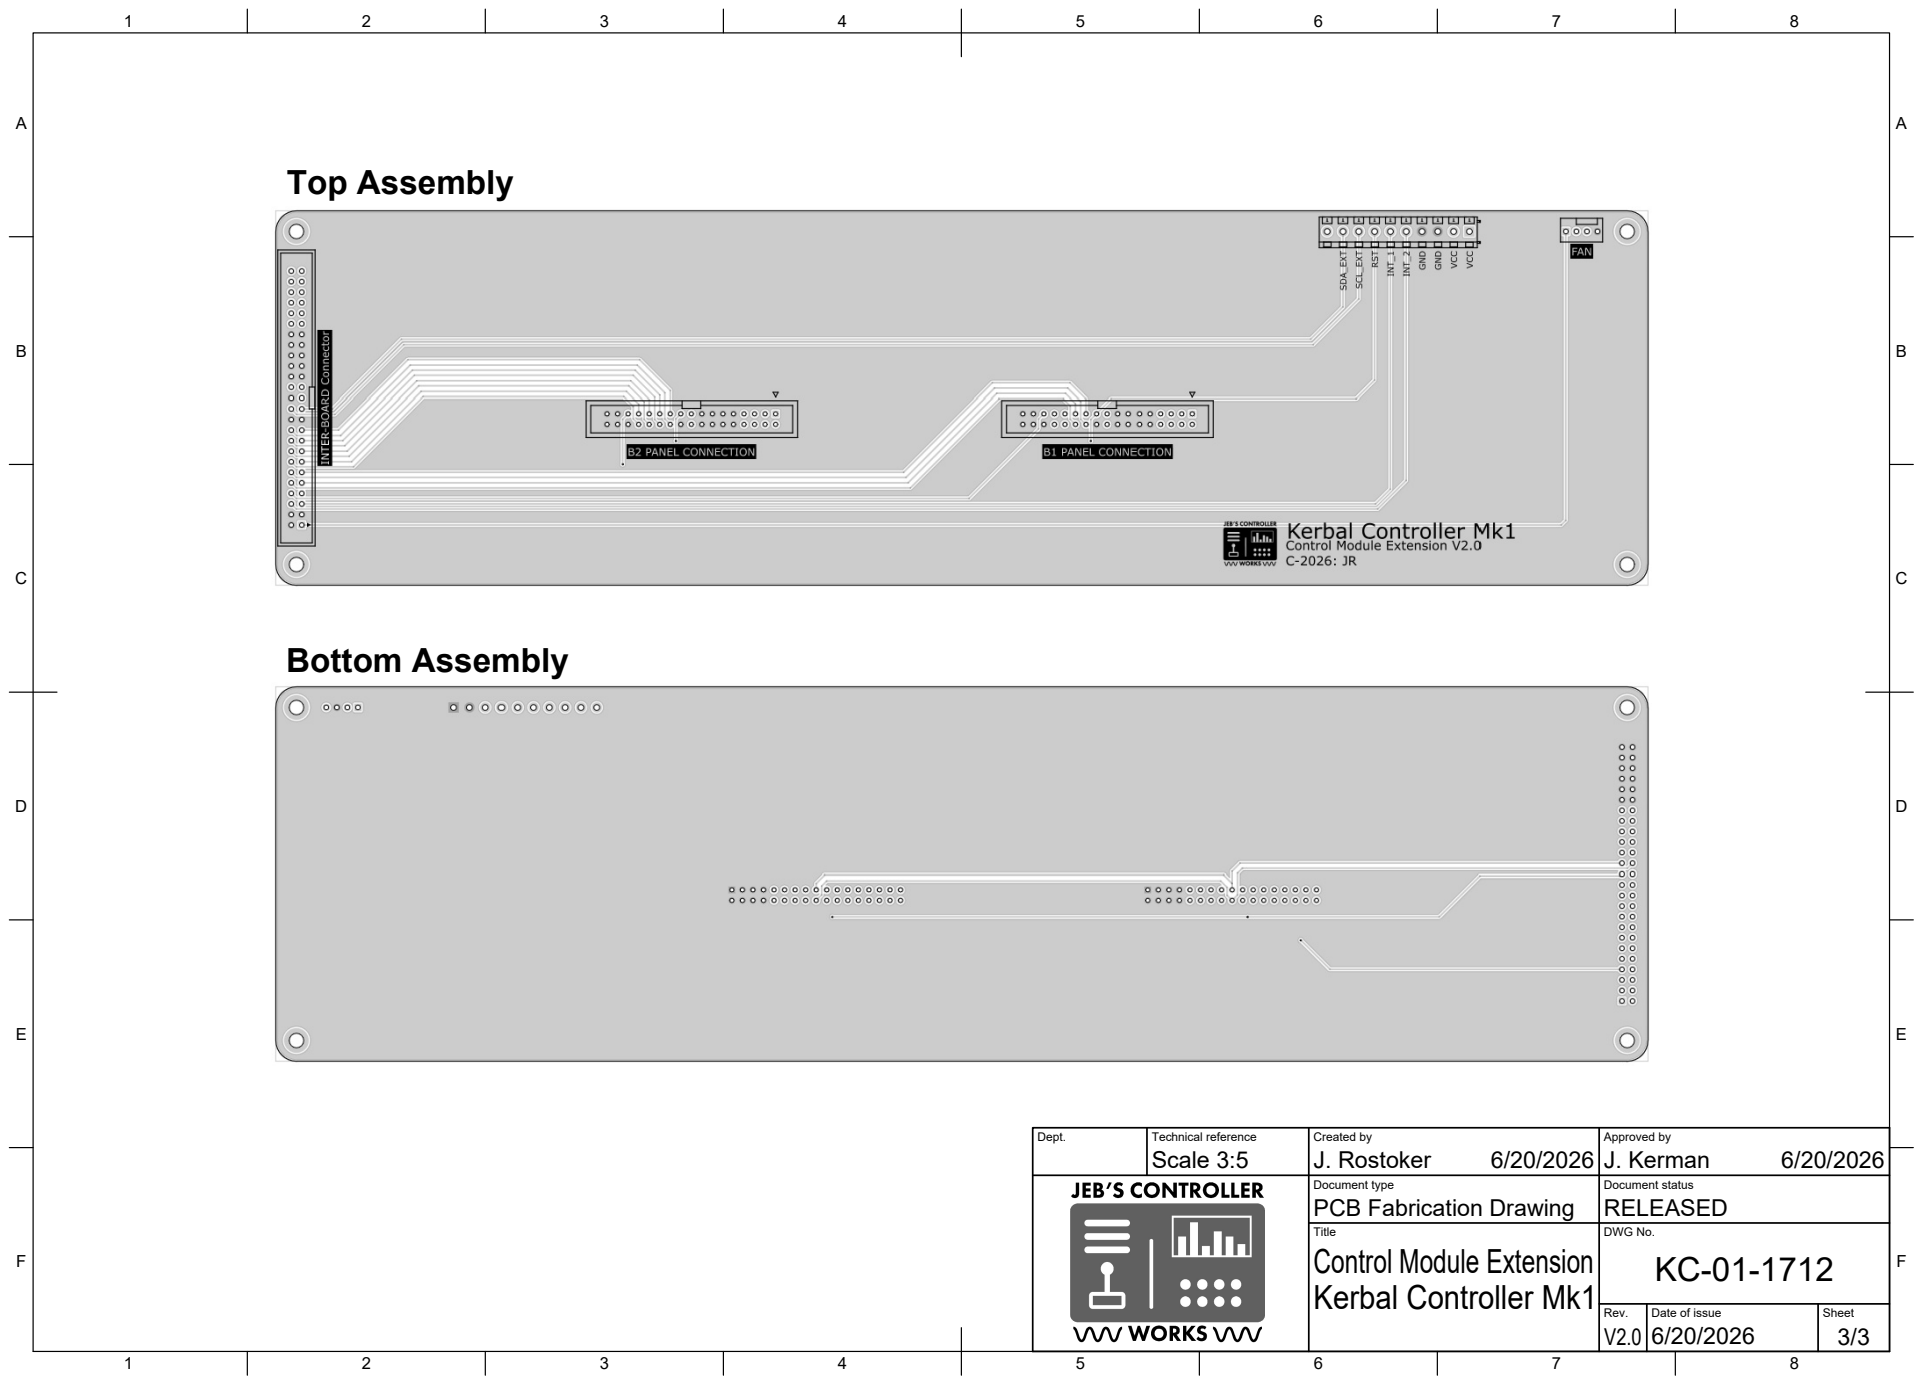
[picture p163: page 3]
Title; DWG No.; Control Module Extension; Top Assembly; Bottom Assembly

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

Document type PCB Fabrication Drawing | Document status RELEASED
