bigJRo/KerbalControllerMk1/Documents/Drawings/KC-01-1731_V2.0_Panel Hub_SCH.pdf

# Module Connectors

# Main Connection

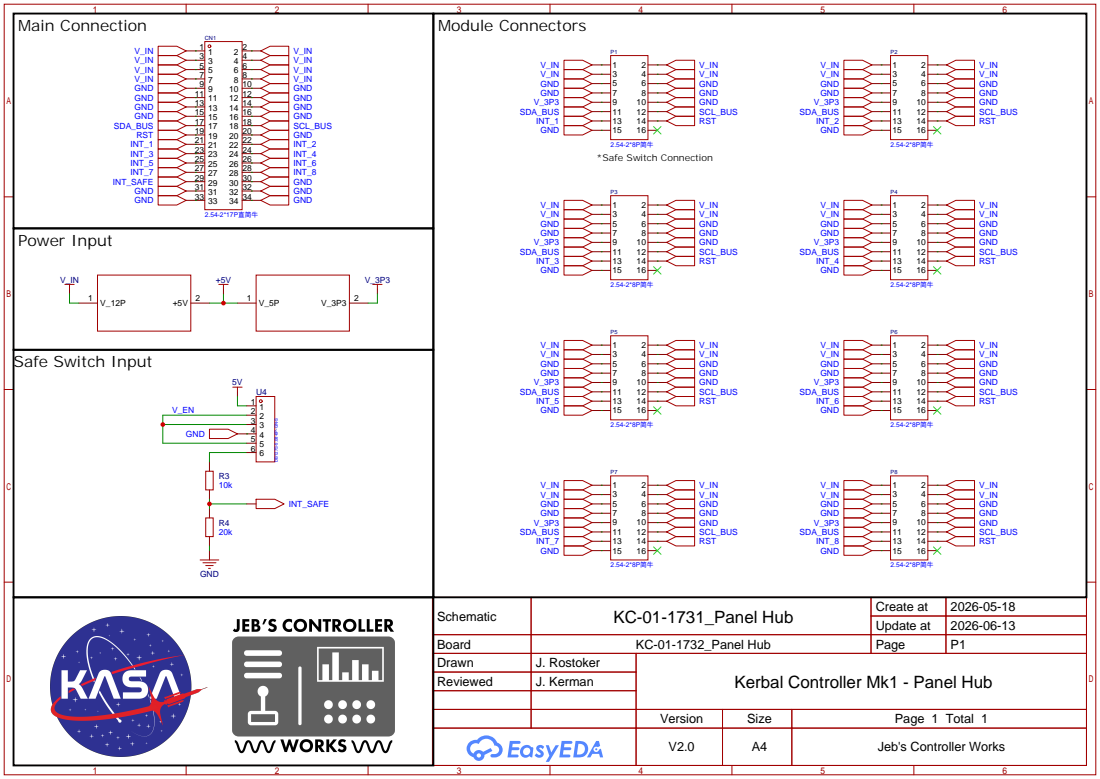
[picture p164: page 1]

Schematic | KC-01-1731_Panel Hub | Create at | 2026-05-18

Update at | 2026-06-13

Board | KC-01-1732_Panel Hub | Page | P1
Drawn | J. Rostoker | Kerbal Controller Mk1 - Panel Hub
Reviewed | J. Kerman

Version | Size | Page 1 Total 1
V2.0 | A4 | Jeb's Controller Works

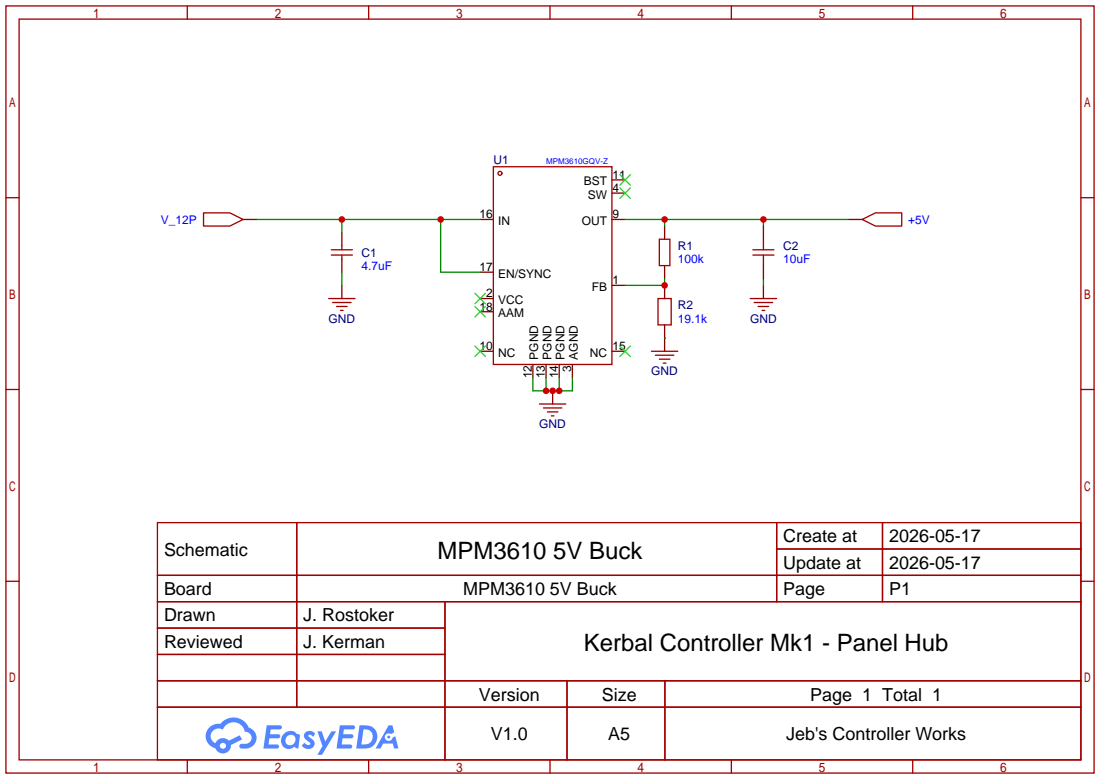
[picture p165: page 2]

Schematic | MPM3610 5V Buck | Create at | 2026-05-17

Update at | 2026-05-17

Board | MPM3610 5V Buck | Page | P1
Drawn | J. Rostoker | Kerbal Controller Mk1 - Panel Hub
Reviewed | J. Kerman

Version | Size | Page 1 Total 1
V1.0 | A5 | Jeb's Controller Works

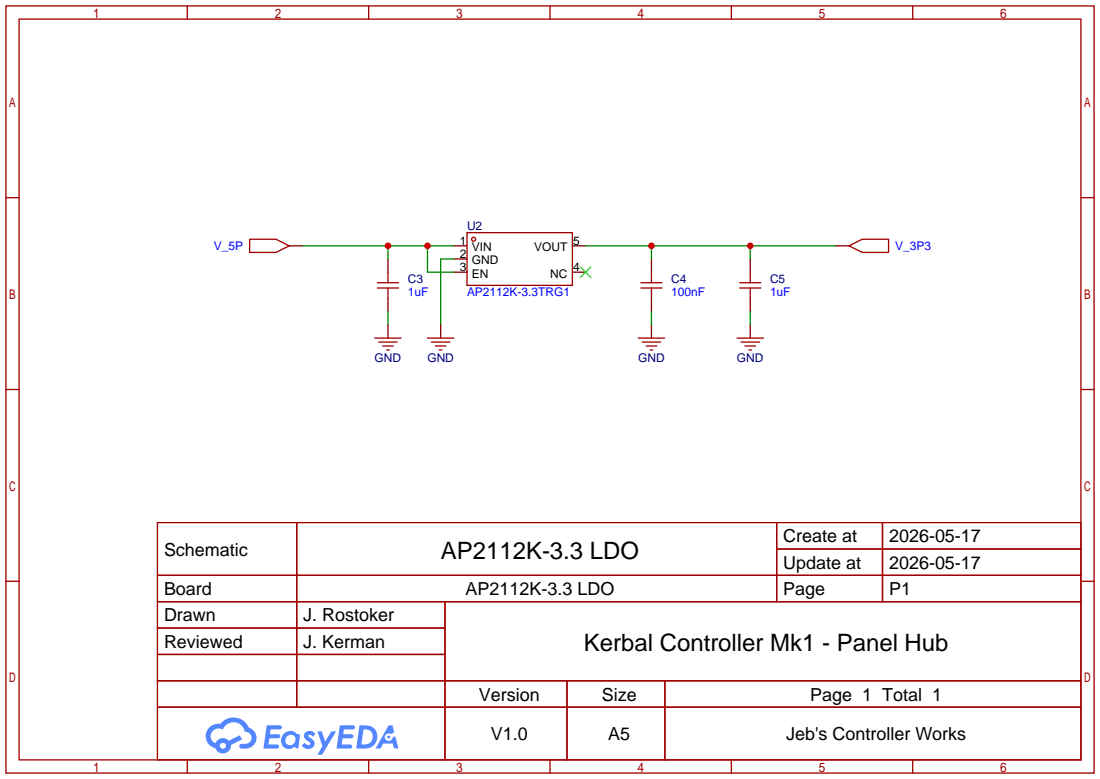
[picture p166: page 3]

Schematic | AP2112K-3.3 LDO | Create at | 2026-05-17

Update at | 2026-05-17

Board | AP2112K-3.3 LDO | Page | P1
Drawn | J. Rostoker | Kerbal Controller Mk1 - Panel Hub
Reviewed | J. Kerman

Version | Size | Page 1 Total 1
V1.0 | A5 | Jeb's Controller Works
