bigJRo/KerbalControllerMk1/Documents/Drawings/KC-01-1732_V2.0_Panel Hub_PWB.pdf

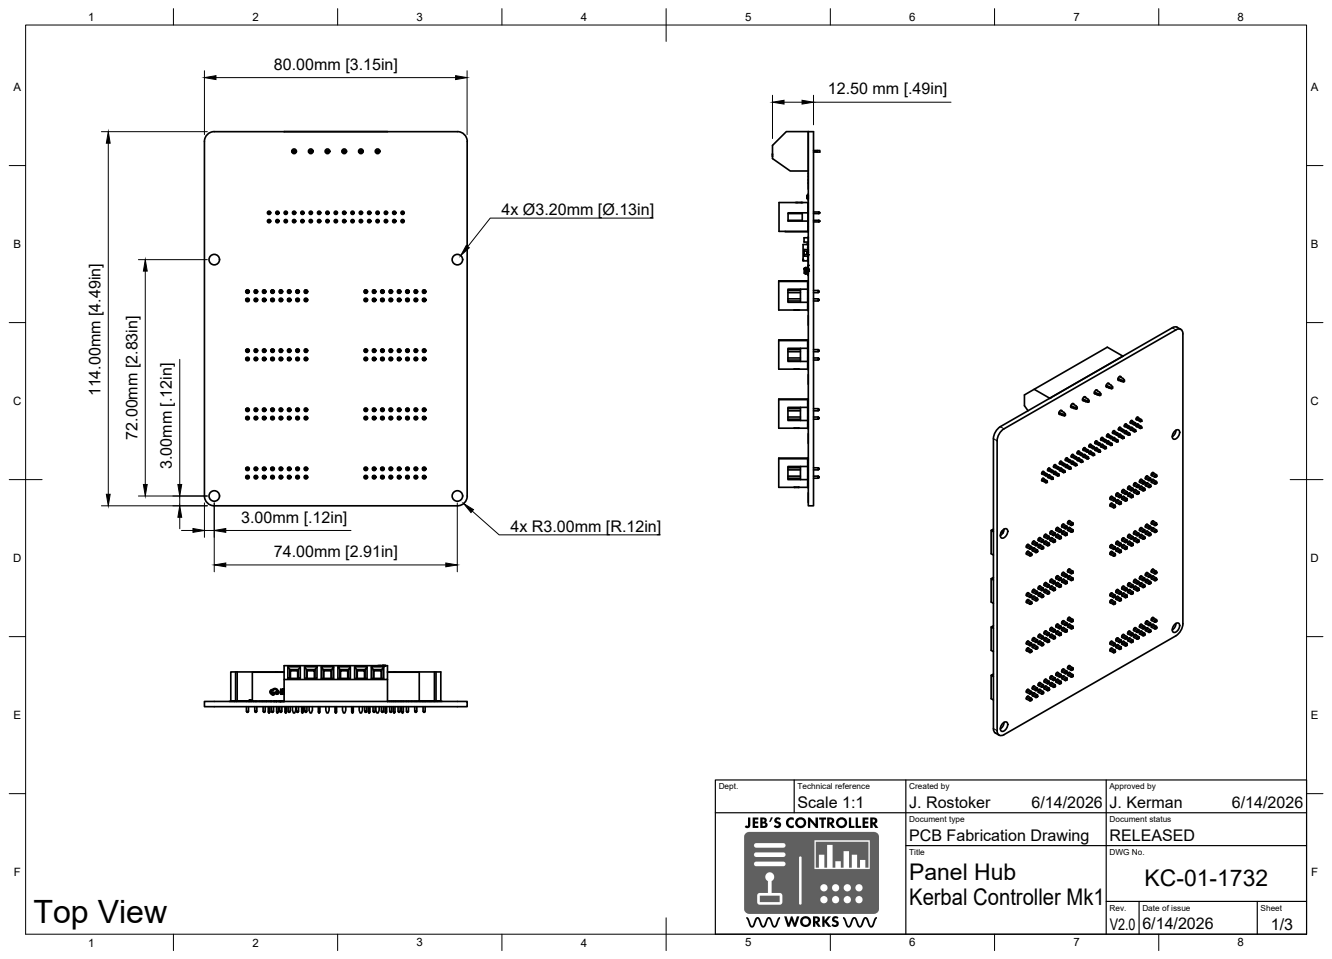
[picture p167: page 1]
Title; DWG No.; Rev.; Date of issue; Sheet; Kerbal Controller Mk1; Panel Hub; Top View

Dept. | Technical reference Scale 1:1 | Created by J. Rostoker 6/14/2026 | Approved by J. Kerman 6/14/2026

Document type PCB Fabrication Drawing | Document status RELEASED

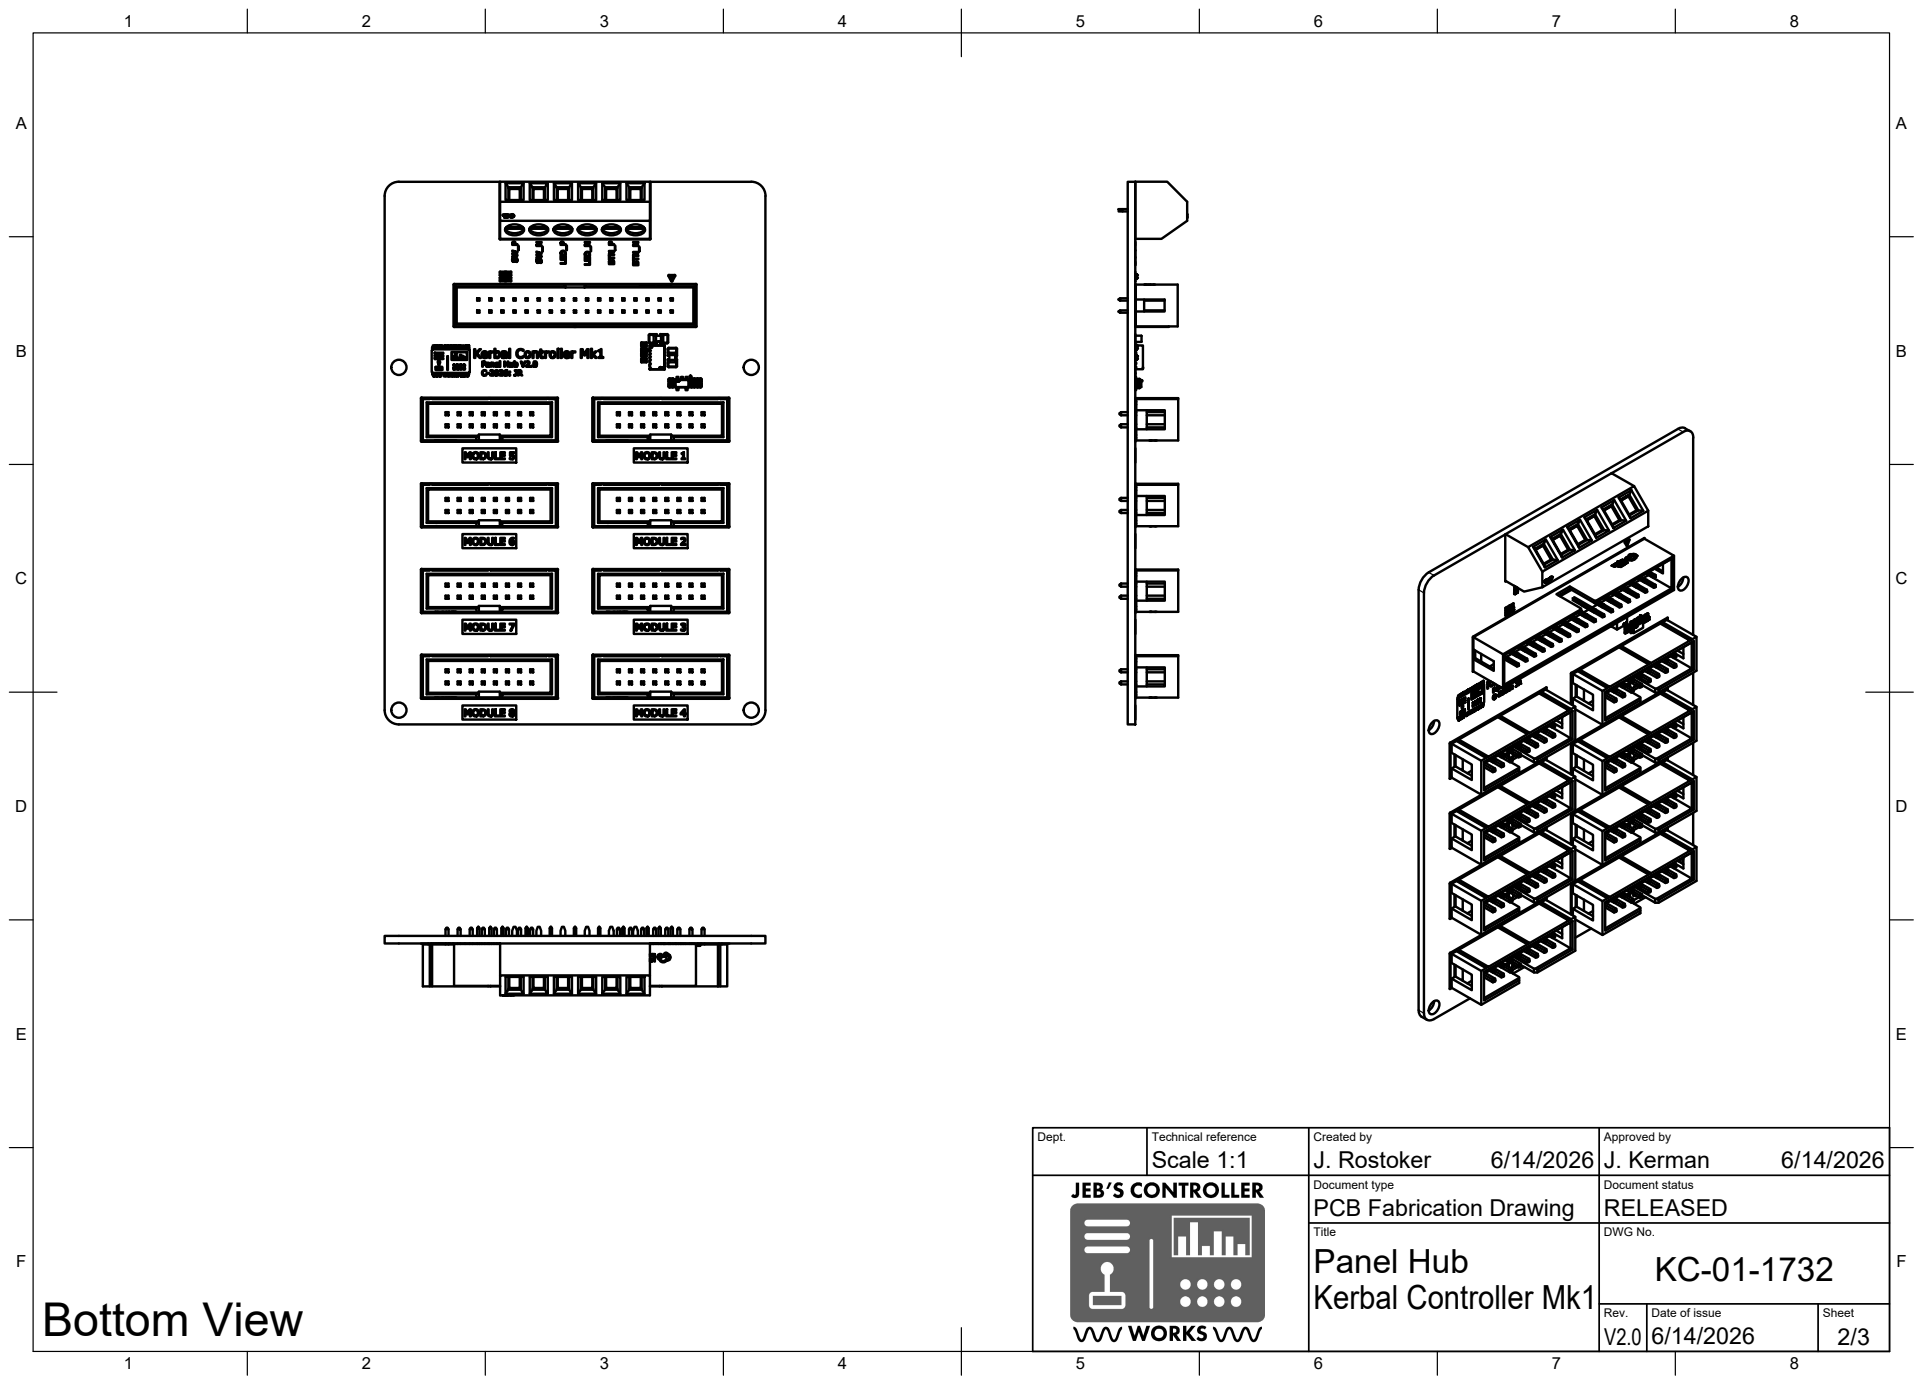
[picture p168: page 2]
Dept.; Technical reference; Created by; Approved by; Document type; Document status; Title; DWG No.; PCB Fabrication Drawing; RELEASED; Panel Hub; Scale 1:1; J. Rostoker; J. Kerman; Bottom View

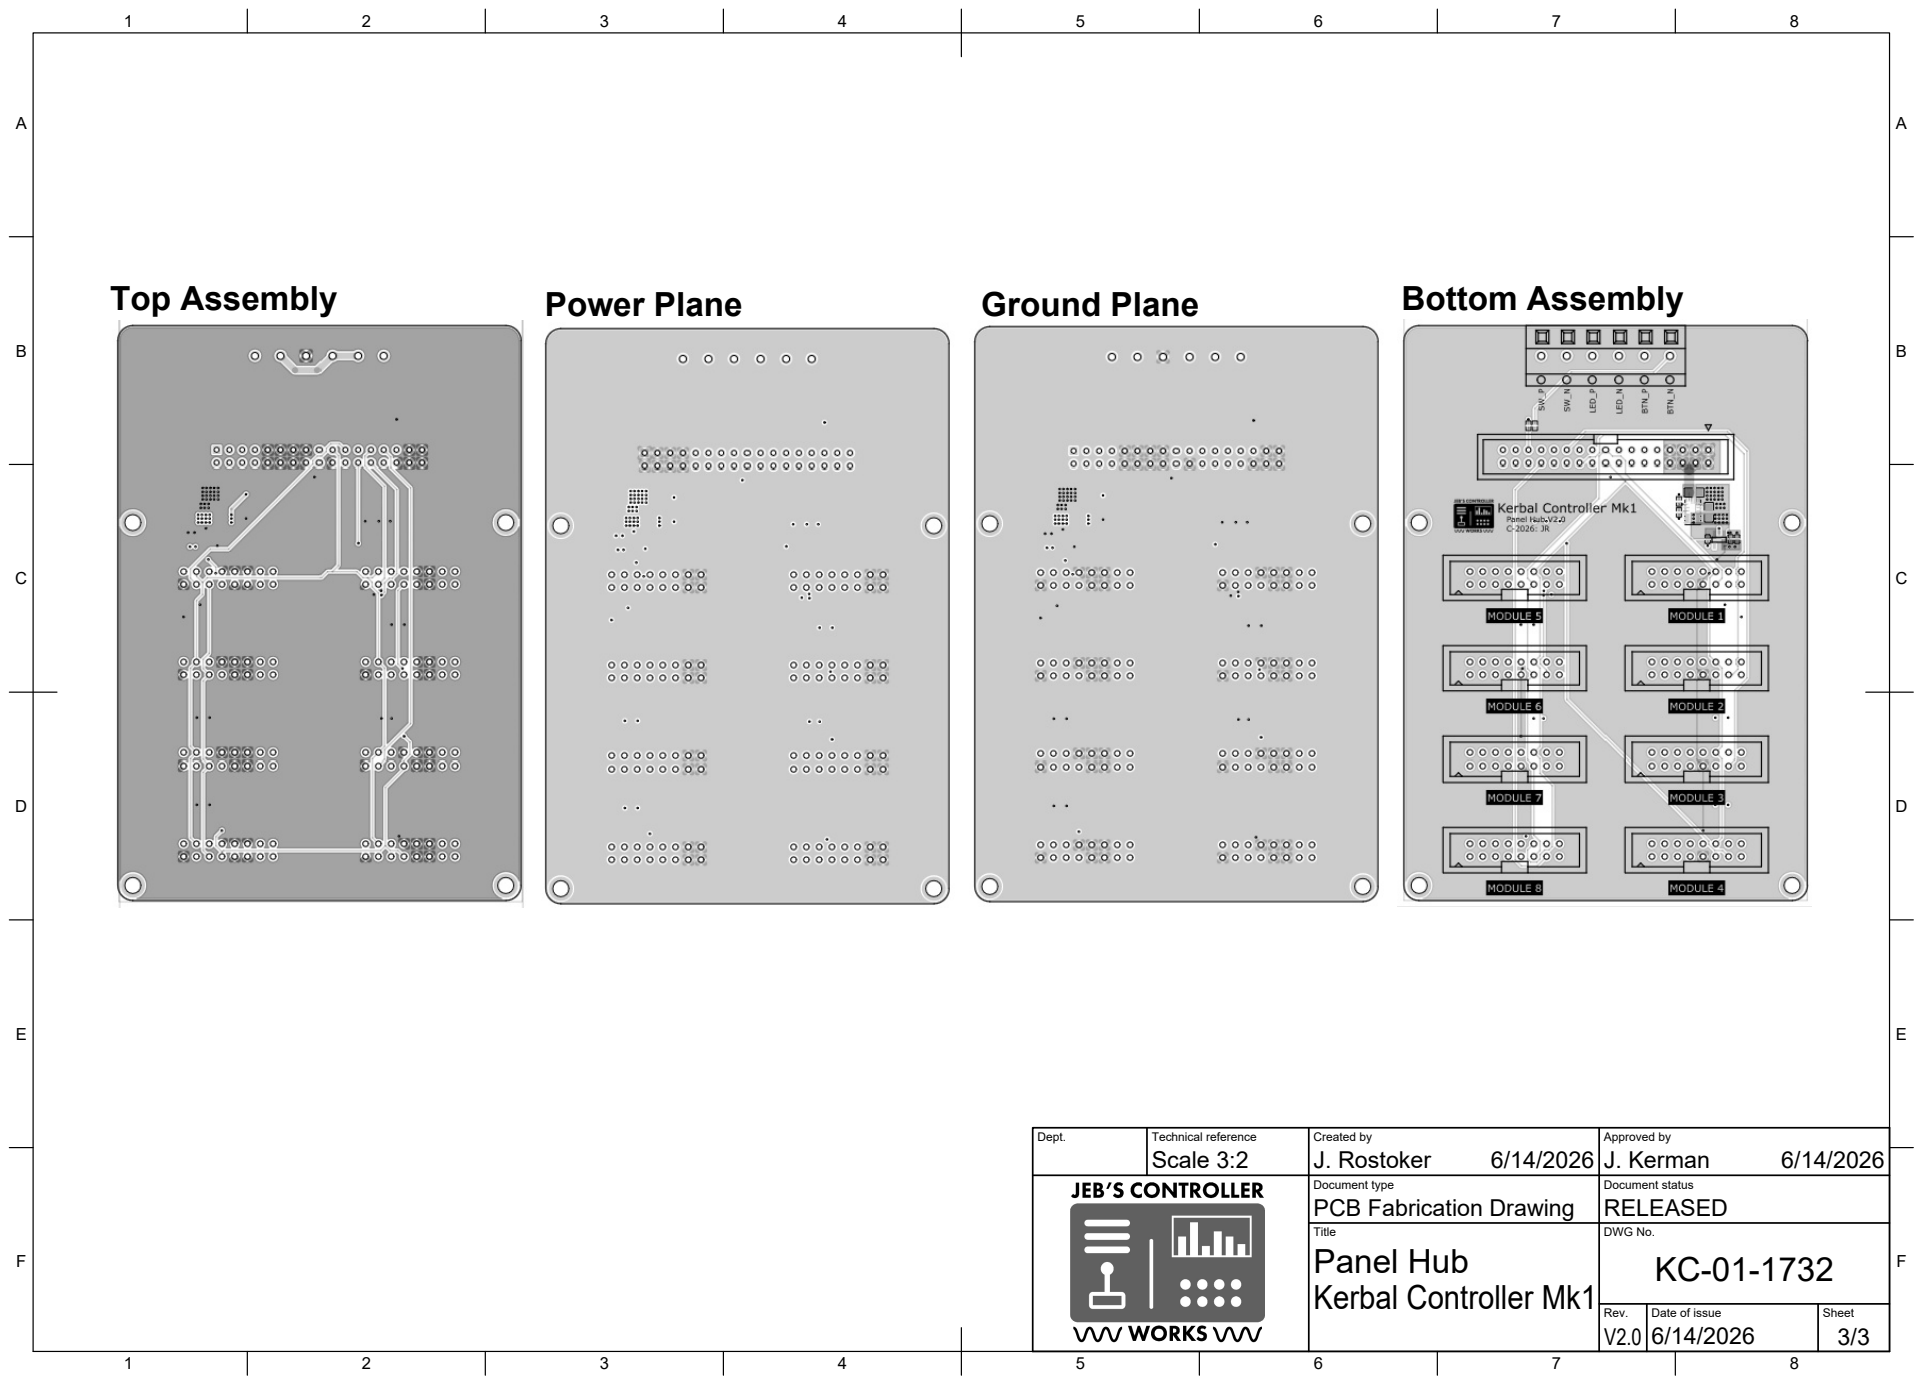
[picture p169: page 3]
Title; DWG No.; Panel Hub; Top Assembly; Power Plane; Ground Plane; Bottom Assembly

Dept. | Technical reference Scale 3:2 | Created by J. Rostoker 6/14/2026 | Approved by J. Kerman 6/14/2026

Document type PCB Fabrication Drawing | Document status RELEASED
