bigJRo/KerbalControllerMk1/Documents/Drawings/KC-01-1800_RevA_Button Module Complete.pdf

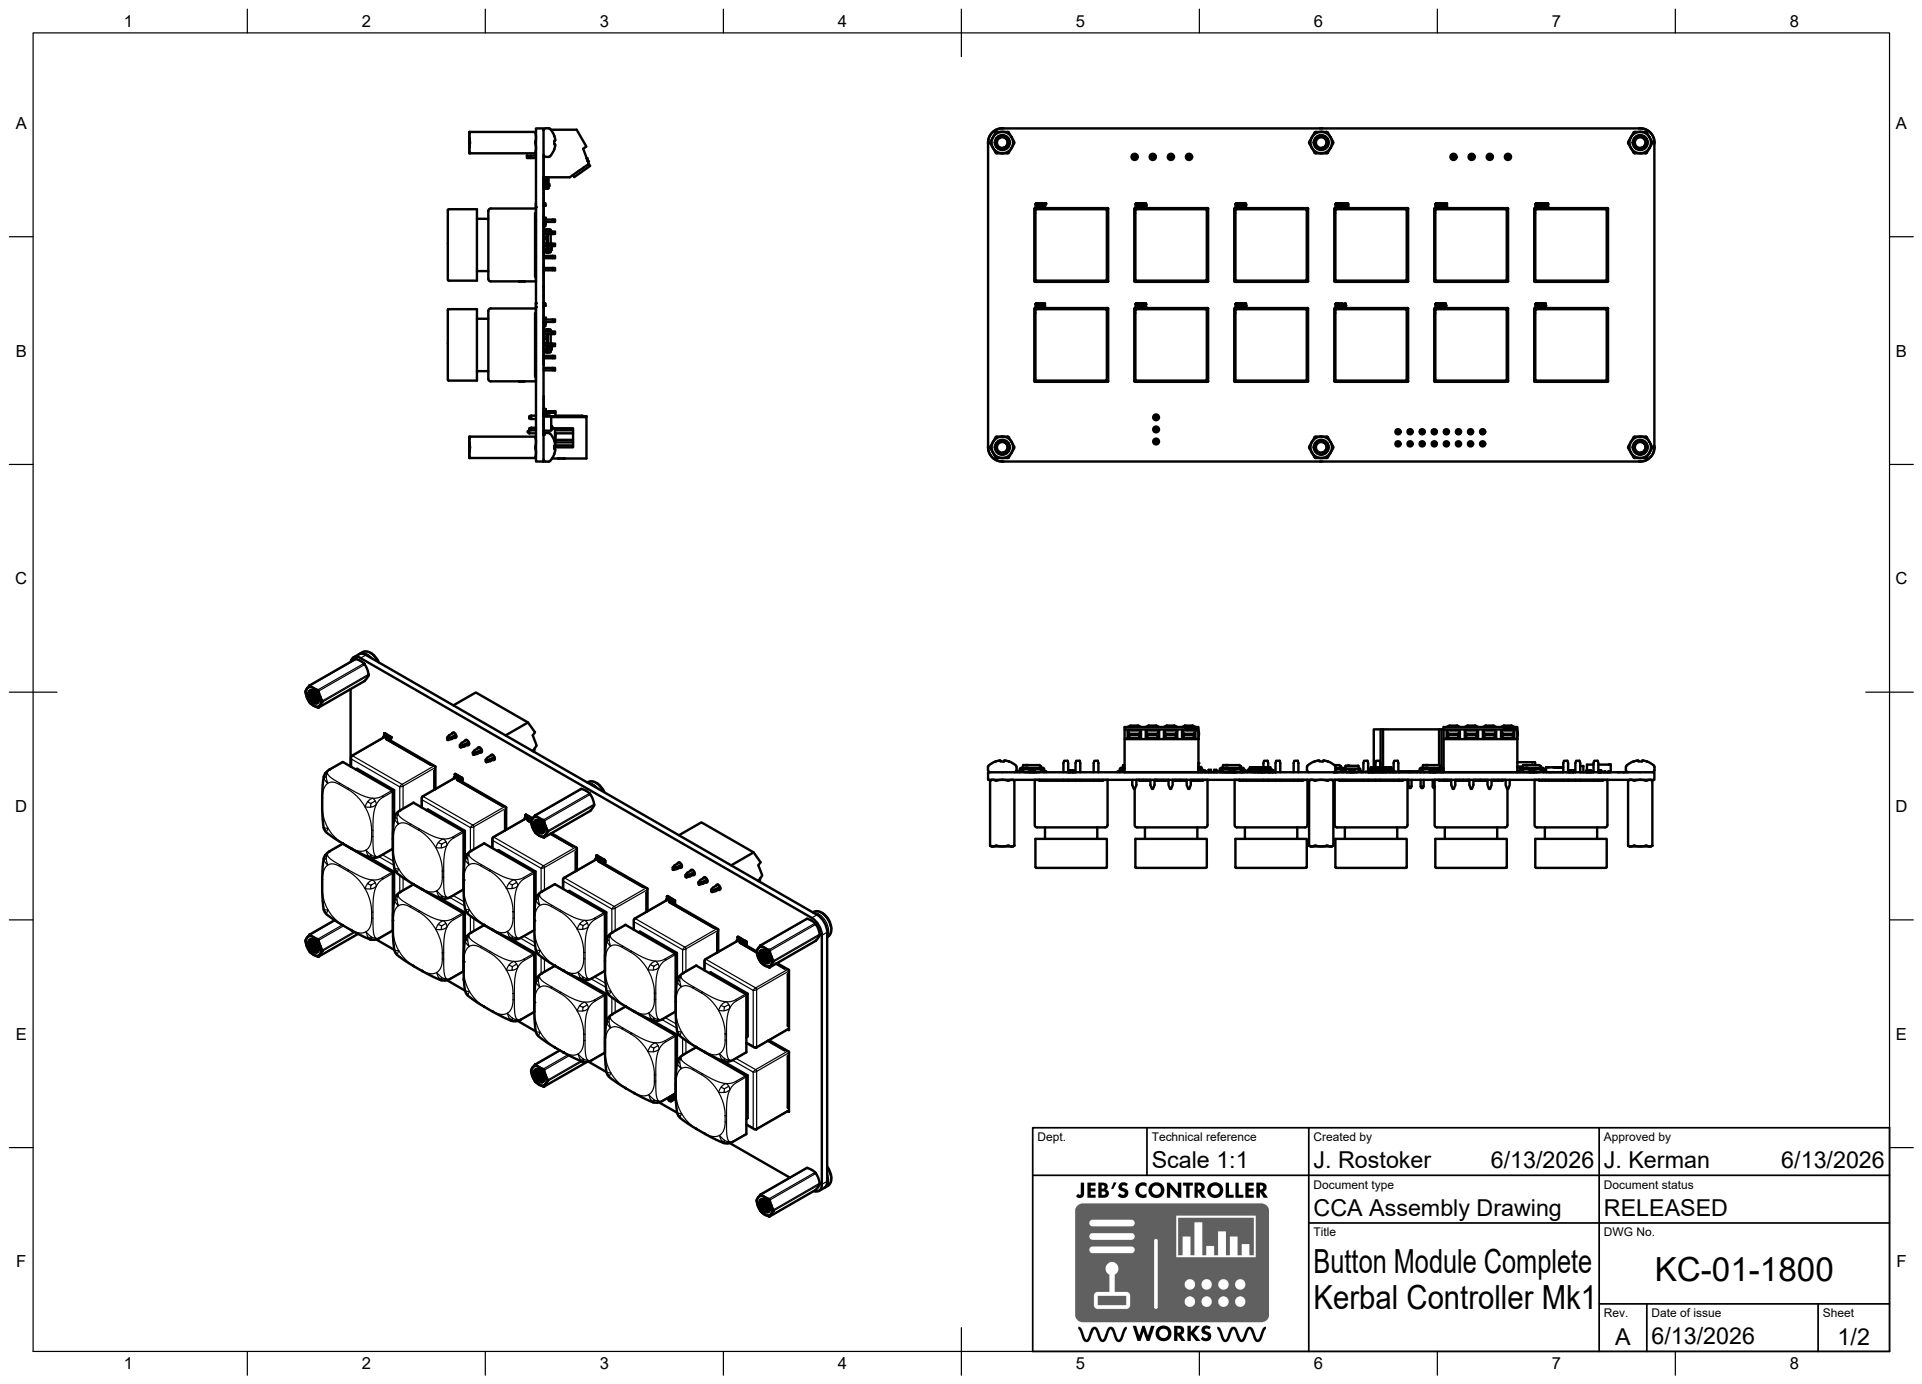
[picture p170: page 1]
Dept.; Technical reference; Created by; Approved by; Document type; Document status; Title; DWG No.; Rev.; Date of issue; Sheet; CCA Assembly Drawing; RELEASED; Kerbal Controller Mk1; Button Module Complete; Scale 1:1; J. Rostoker; J. Kerman

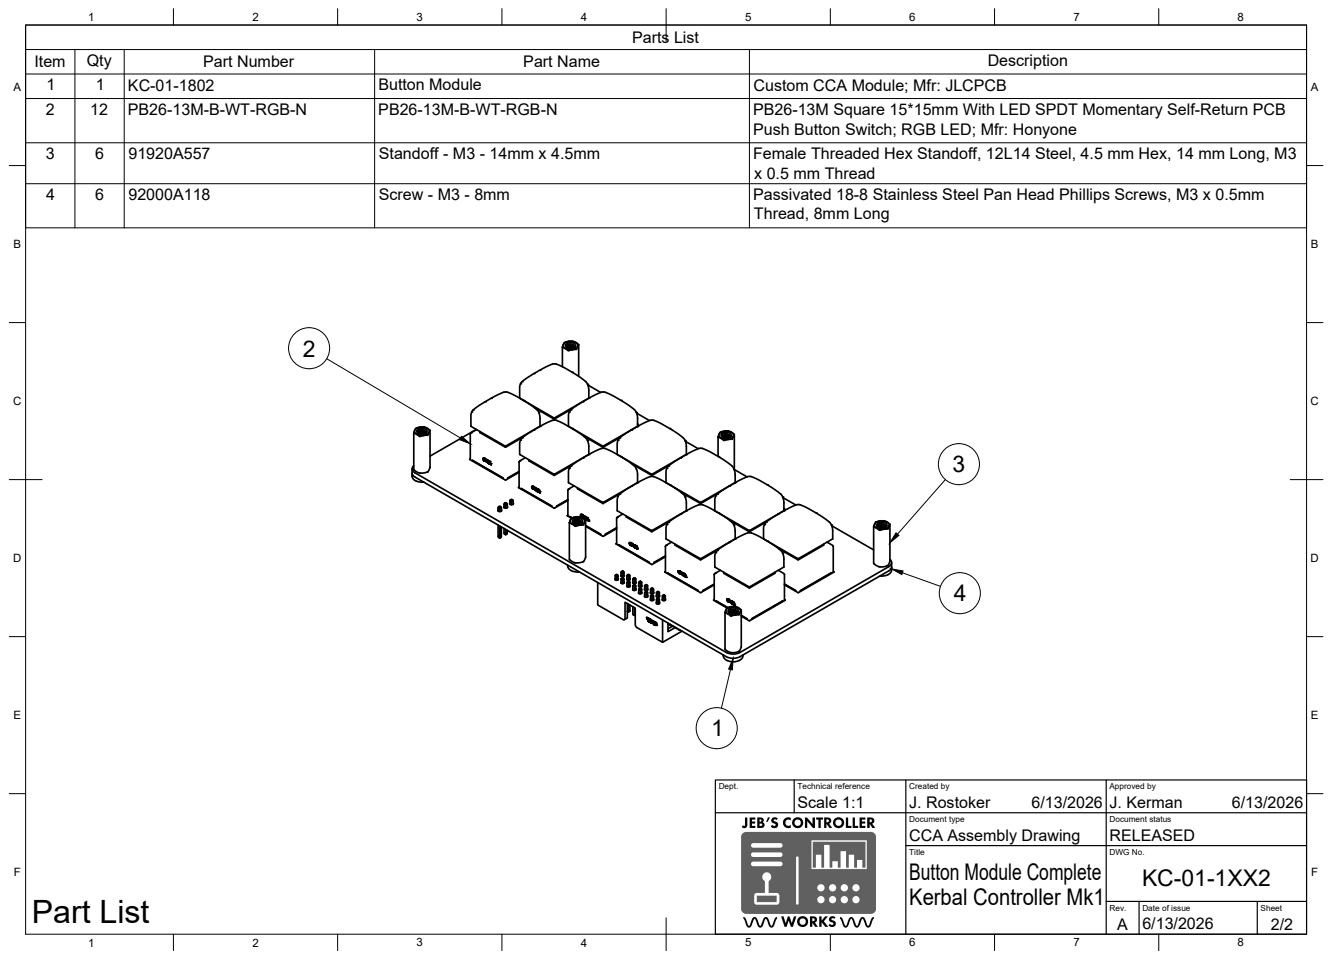
[picture p171: page 2]
Part List

Parts List

Item | Qty | Part Number | Part Name | Description
1 | 1 | KC-01-1802 | Button Module | Custom CCA Module; Mfr: JLCPCB
2 | 12 | PB26-13M-B-WT-RGB-N | PB26-13M-B-WT-RGB-N | PB26-13M Square 15*15mm With LED SPDT Momentary Self-Return PCB Push Button Switch; RGB LED; Mfr: Honyone

3 | 6 | 91920A557 | Standoff - M3 - 14mm x 4.5mm | Female Threaded Hex Standoff, 12L14 Steel, 4.5 mm Hex, 14 mm Long, M3 x 0.5 mm Thread

4 | 6 | 92000A118 | Screw - M3 - 8mm | Passivated 18-8 Stainless Steel Pan Head Phillips Screws, M3 x 0.5mm Thread, 8mm Long

Dept. | Technical reference Scale 1:1 | Created by J. Rostoker 6/13/2026 | Approved by J. Kerman 6/13/2026

Document type CCA Assembly Drawing | Document status RELEASED

Title Button Module Complete Kerbal Controller Mk1 | DWG No. KC-01-1XX2

Rev. A | Date of issue 6/13/2026 | Sheet 2/2
