bigJRo/KerbalControllerMk1/Documents/Drawings/KC-01-1801_V2.0_Button Module_SCH.pdf

Microcontroller | Panel Connector

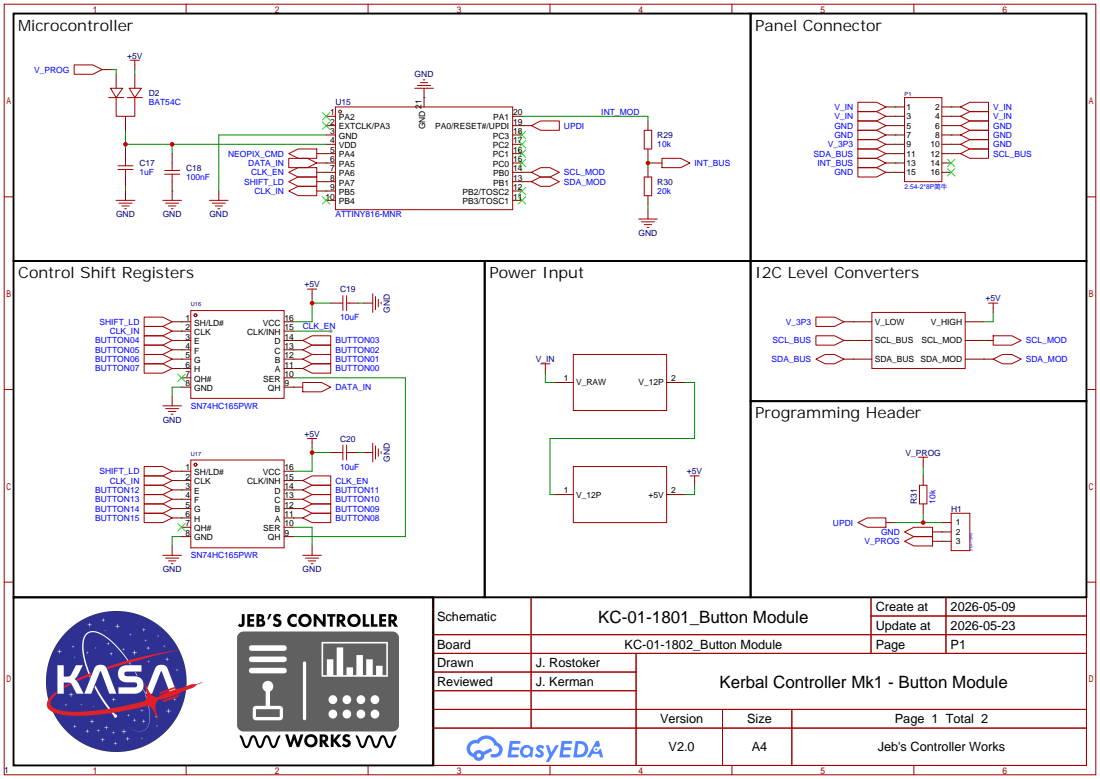
[picture p172: page 1]

Schematic | KC-01-1801_Button Module | Create at | 2026-05-09

Update at | 2026-05-23

Board | KC-01-1802_Button Module | Page | P1
Drawn | J. Rostoker | Kerbal Controller Mk1 - Button Module
Reviewed | J. Kerman

Version | Size | Page 1 Total 2
V2.0 | A4 | Jeb's Controller Works

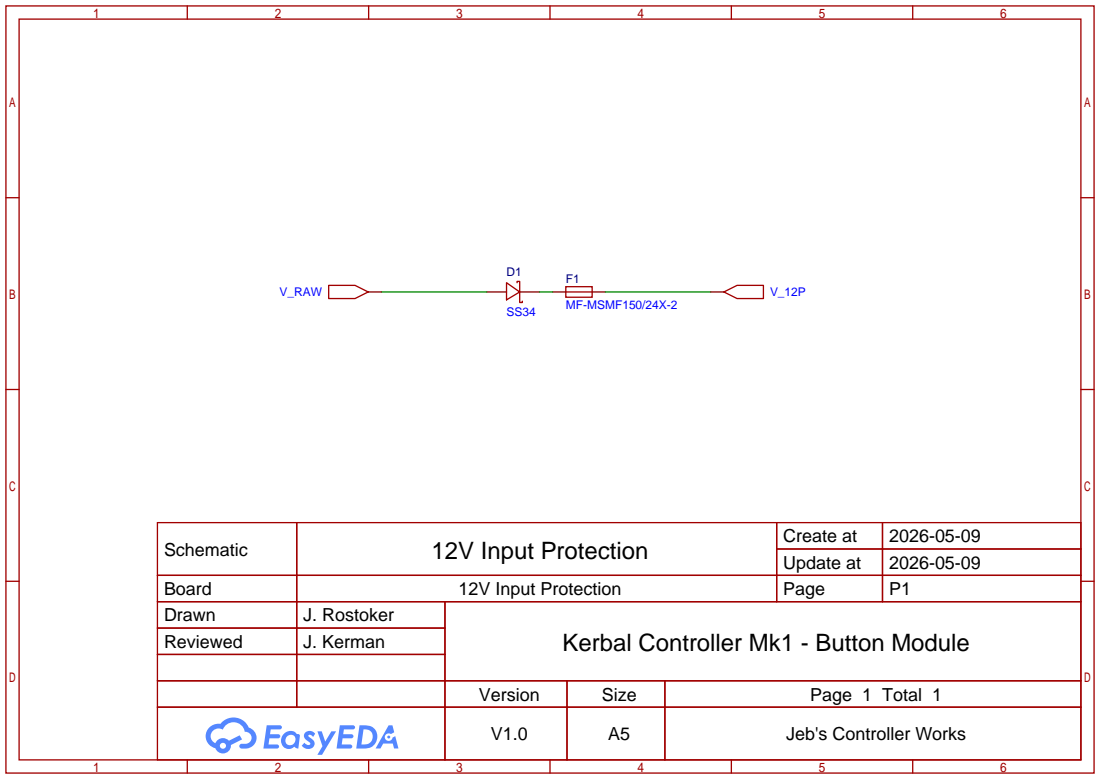
[picture p173: page 2]

Schematic | 12V Input Protection | Create at | 2026-05-09

Update at | 2026-05-09

Board | 12V Input Protection | Page | P1
Drawn | J. Rostoker | Kerbal Controller Mk1 - Button Module
Reviewed | J. Kerman

Version | Size | Page 1 Total 1
V1.0 | A5 | Jeb's Controller Works

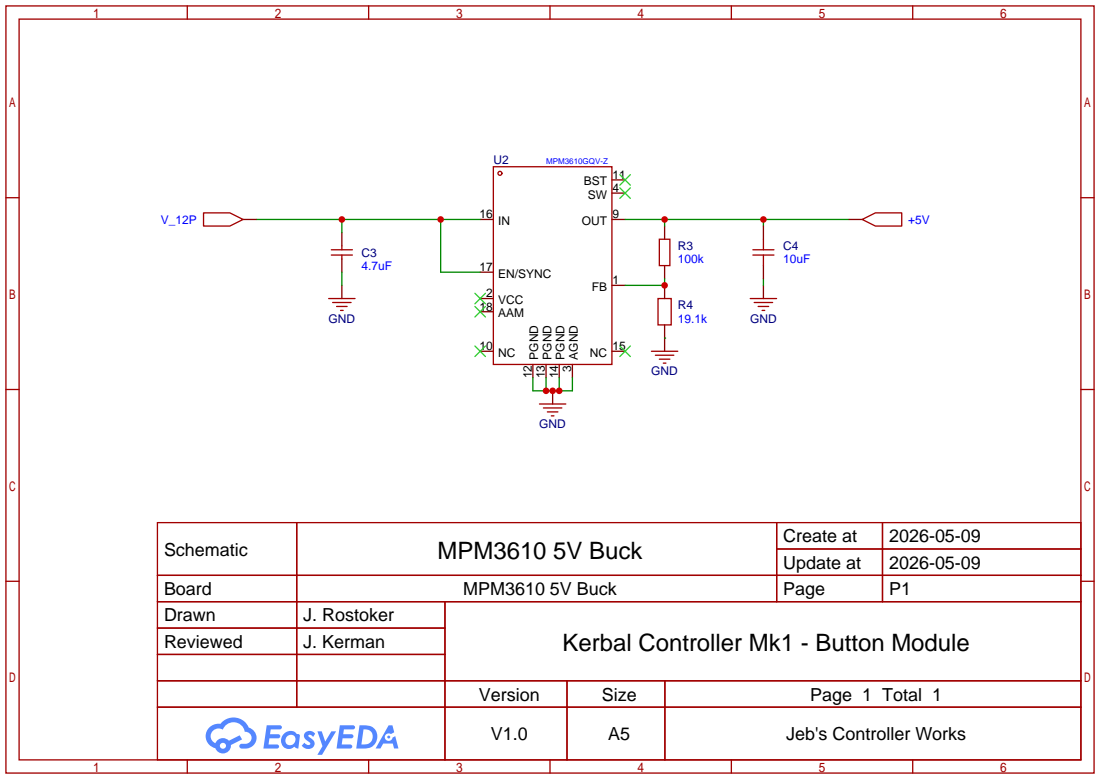
[picture p174: page 3]

Schematic | MPM3610 5V Buck | Create at | 2026-05-09

Update at | 2026-05-09

Board | MPM3610 5V Buck | Page | P1
Drawn | J. Rostoker | Kerbal Controller Mk1 - Button Module
Reviewed | J. Kerman

Version | Size | Page 1 Total 1
V1.0 | A5 | Jeb's Controller Works

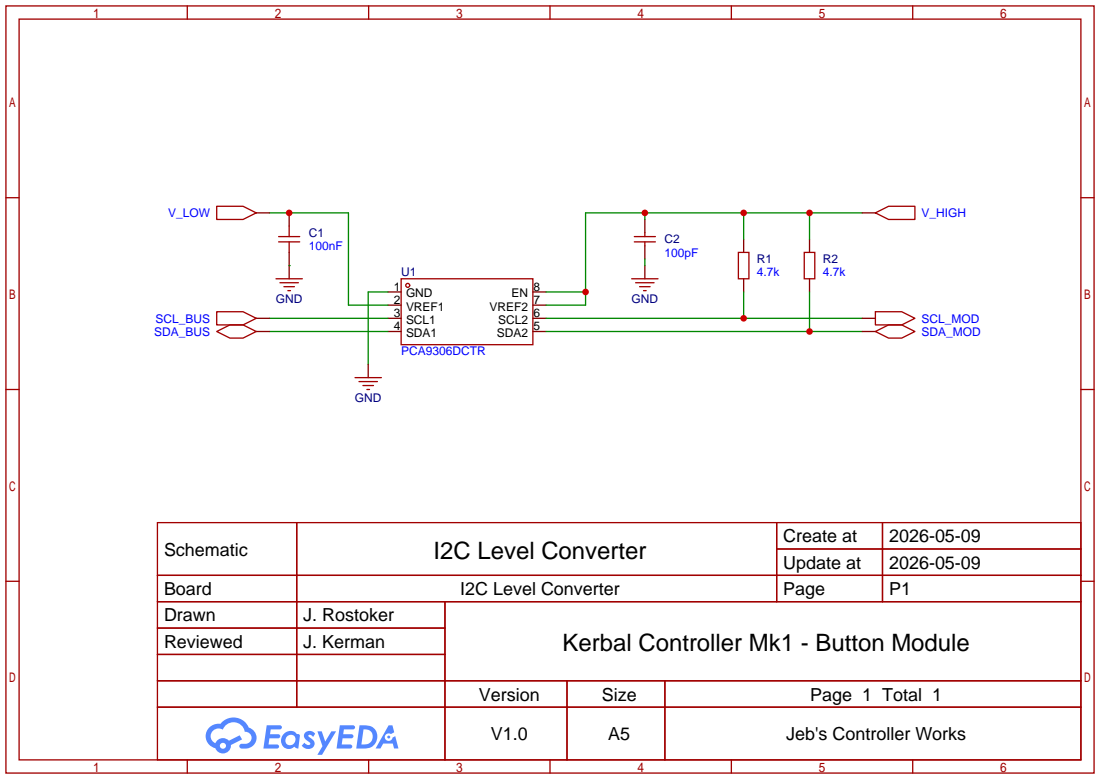
[picture p175: page 4]

Schematic | I2C Level Converter | Create at | 2026-05-09

Update at | 2026-05-09

Board | I2C Level Converter | Page | P1
Drawn | J. Rostoker | Kerbal Controller Mk1 - Button Module
Reviewed | J. Kerman

Version | Size | Page 1 Total 1
V1.0 | A5 | Jeb's Controller Works

# Button Connections

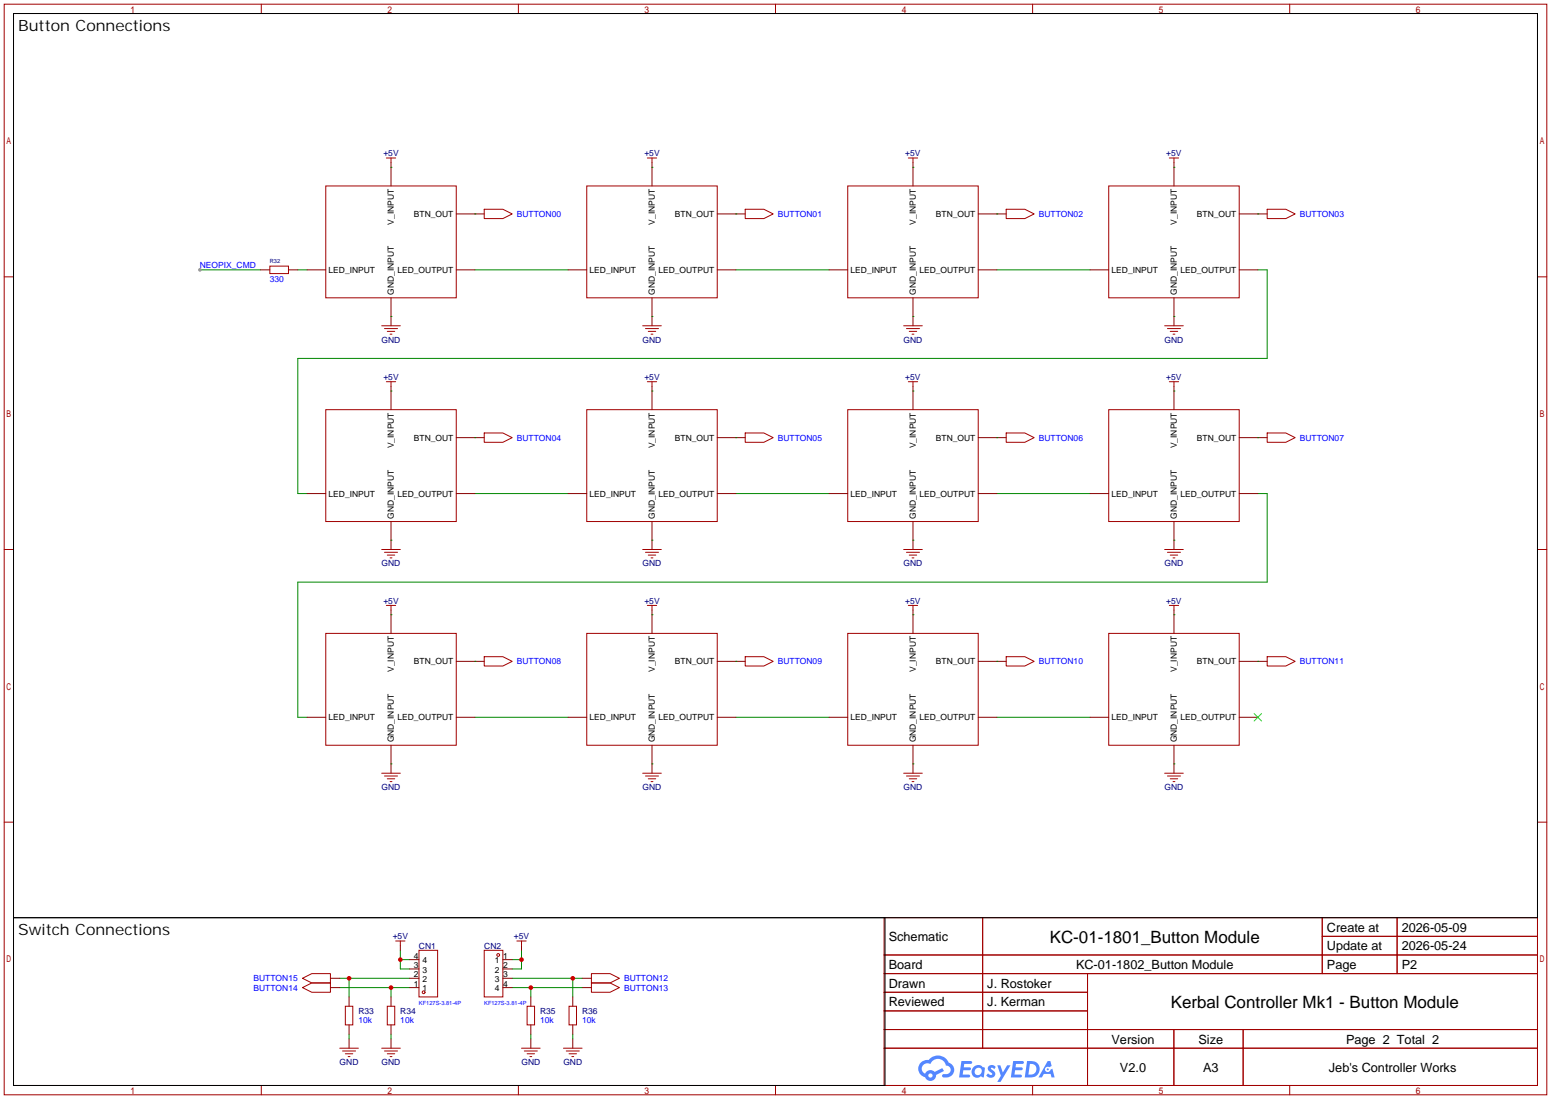
[picture p176: page 5]

Schematic | KC-01-1801_Button Module | Create at | 2026-05-09

Update at | 2026-05-24

Board | KC-01-1802_Button Module | Page | P2
Drawn | J. Rostoker | Kerbal Controller Mk1 - Button Module
Reviewed | J. Kerman

Version | Size | Page 2 Total 2
V2.0 | A3 | Jeb's Controller Works

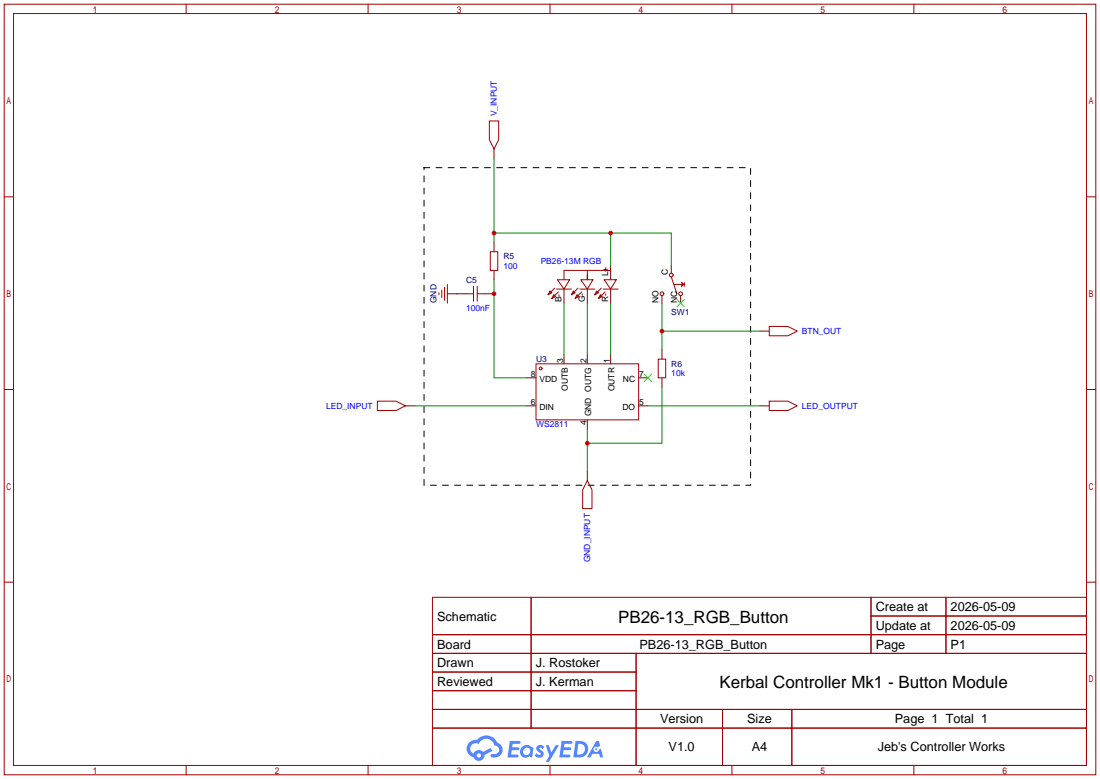
[picture p177: page 6]

Schematic | PB26-13_RGB_Button | Create at | 2026-05-09

Update at | 2026-05-09

Board | PB26-13_RGB_Button | Page | P1
Drawn | J. Rostoker | Kerbal Controller Mk1 - Button Module
Reviewed | J. Kerman

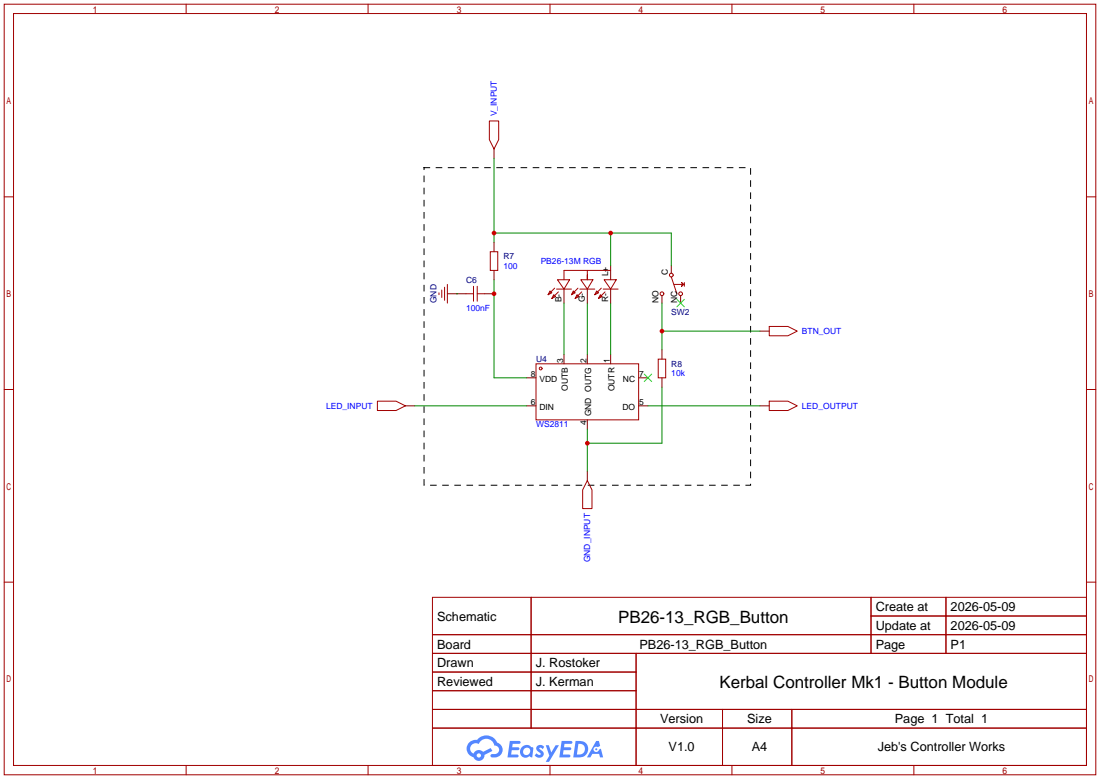
[picture p178: page 7]

Schematic | PB26-13_RGB_Button | Create at | 2026-05-09

Update at | 2026-05-09

Board | PB26-13_RGB_Button | Page | P1
Drawn | J. Rostoker | Kerbal Controller Mk1 - Button Module
Reviewed | J. Kerman

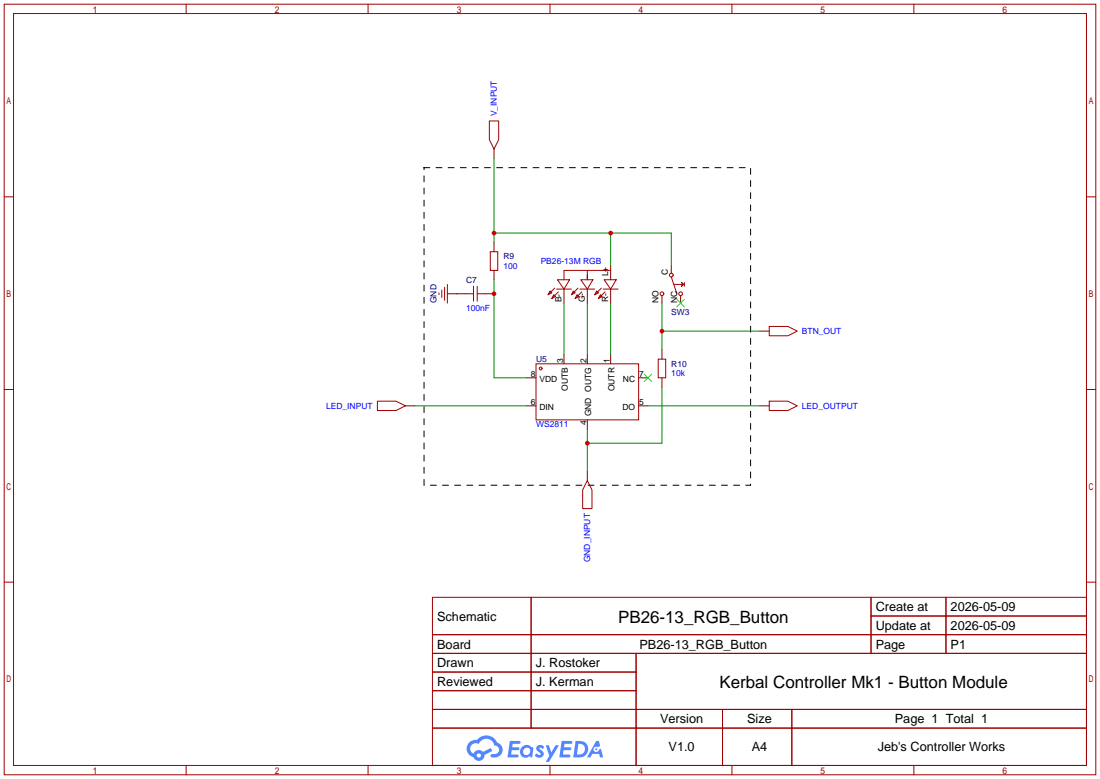
[picture p179: page 8]

Schematic | PB26-13_RGB_Button | Create at | 2026-05-09

Update at | 2026-05-09

Board | PB26-13_RGB_Button | Page | P1
Drawn | J. Rostoker | Kerbal Controller Mk1 - Button Module
Reviewed | J. Kerman

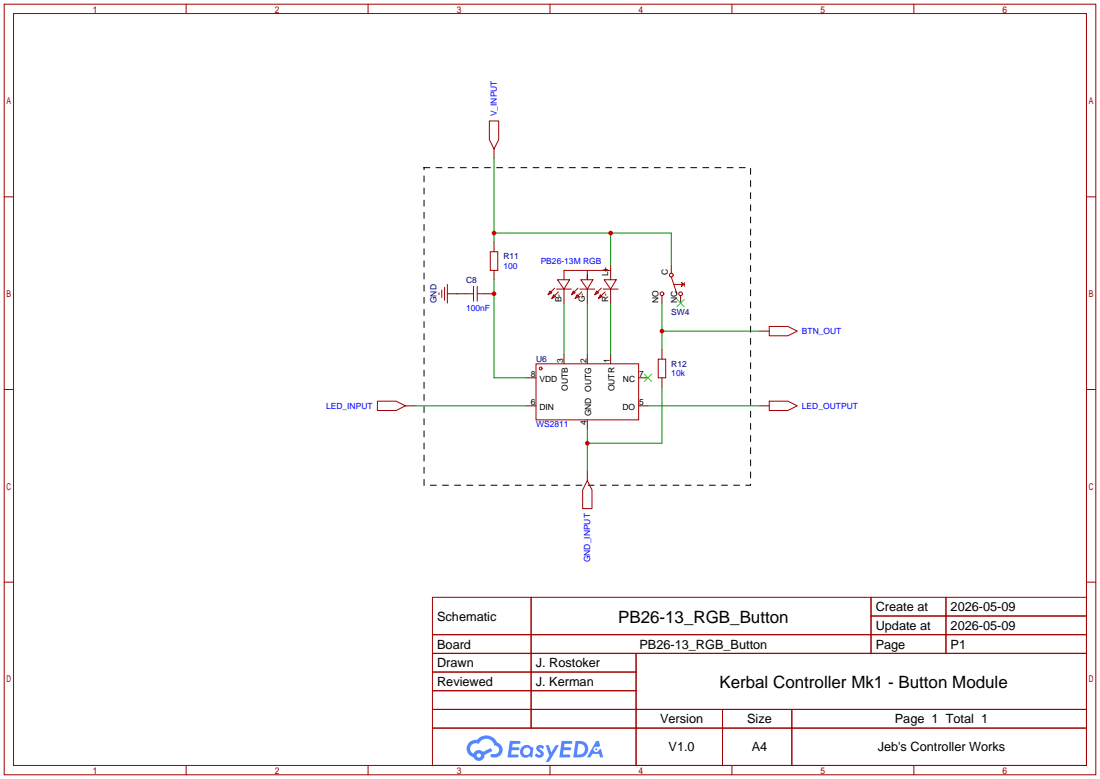
[picture p180: page 9]

Schematic | PB26-13_RGB_Button | Create at | 2026-05-09

Update at | 2026-05-09

Board | PB26-13_RGB_Button | Page | P1
Drawn | J. Rostoker | Kerbal Controller Mk1 - Button Module
Reviewed | J. Kerman

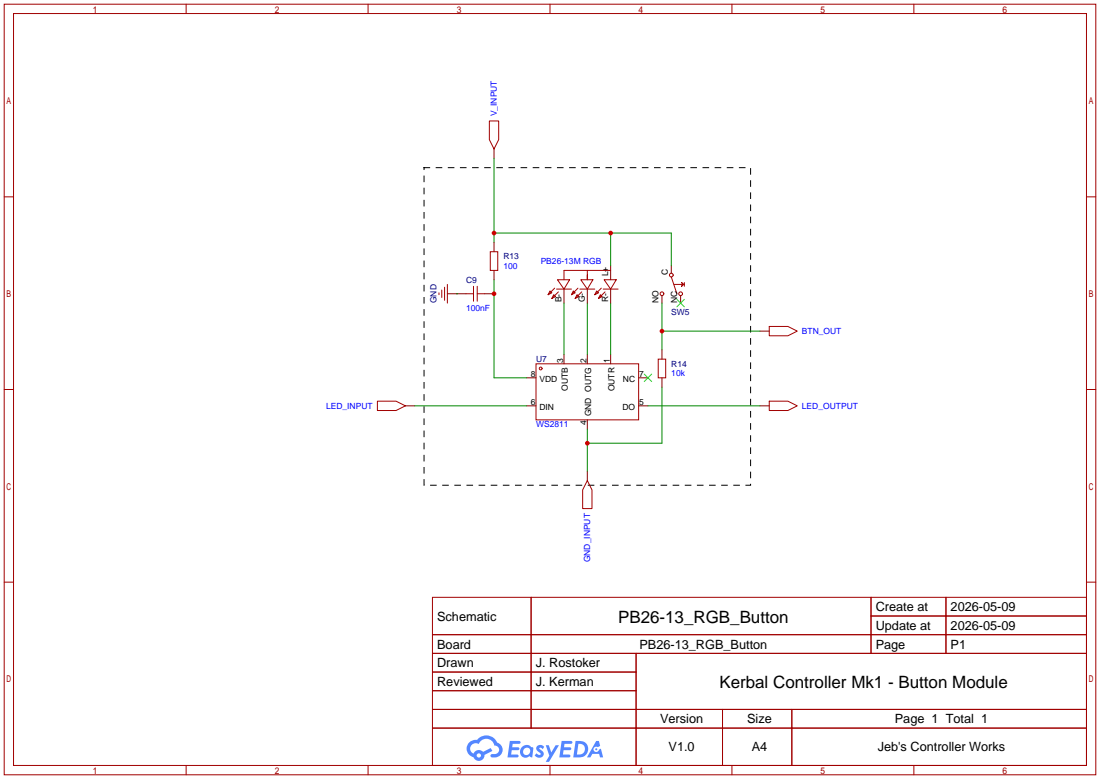
[picture p181: page 10]

Schematic | PB26-13_RGB_Button | Create at | 2026-05-09

Update at | 2026-05-09

Board | PB26-13_RGB_Button | Page | P1
Drawn | J. Rostoker | Kerbal Controller Mk1 - Button Module
Reviewed | J. Kerman

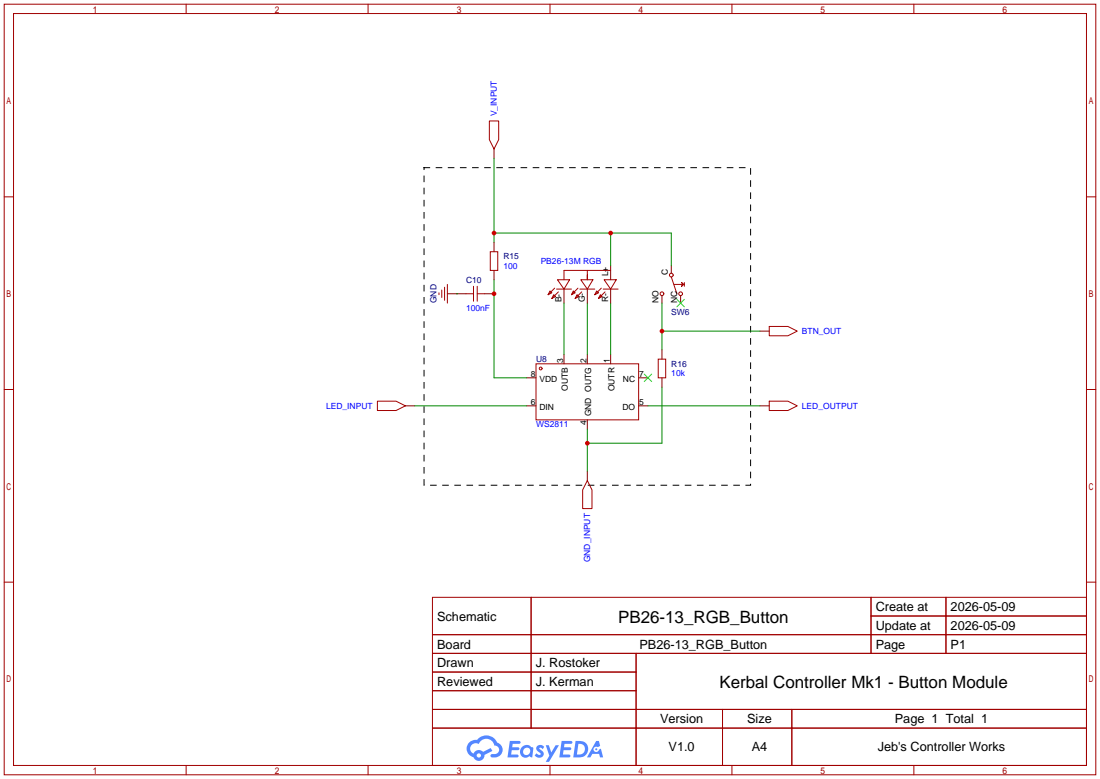
[picture p182: page 11]

Schematic | PB26-13_RGB_Button | Create at | 2026-05-09

Update at | 2026-05-09

Board | PB26-13_RGB_Button | Page | P1
Drawn | J. Rostoker | Kerbal Controller Mk1 - Button Module
Reviewed | J. Kerman

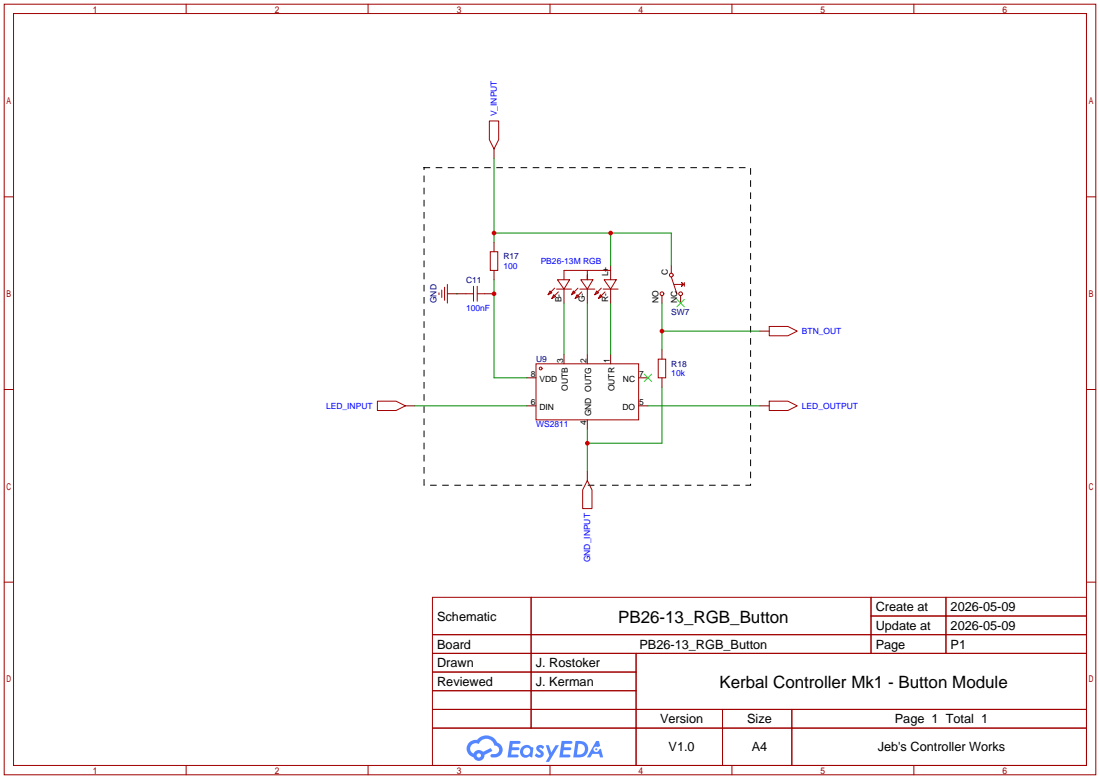
[picture p183: page 12]

Schematic | PB26-13_RGB_Button | Create at | 2026-05-09

Update at | 2026-05-09

Board | PB26-13_RGB_Button | Page | P1
Drawn | J. Rostoker | Kerbal Controller Mk1 - Button Module
Reviewed | J. Kerman

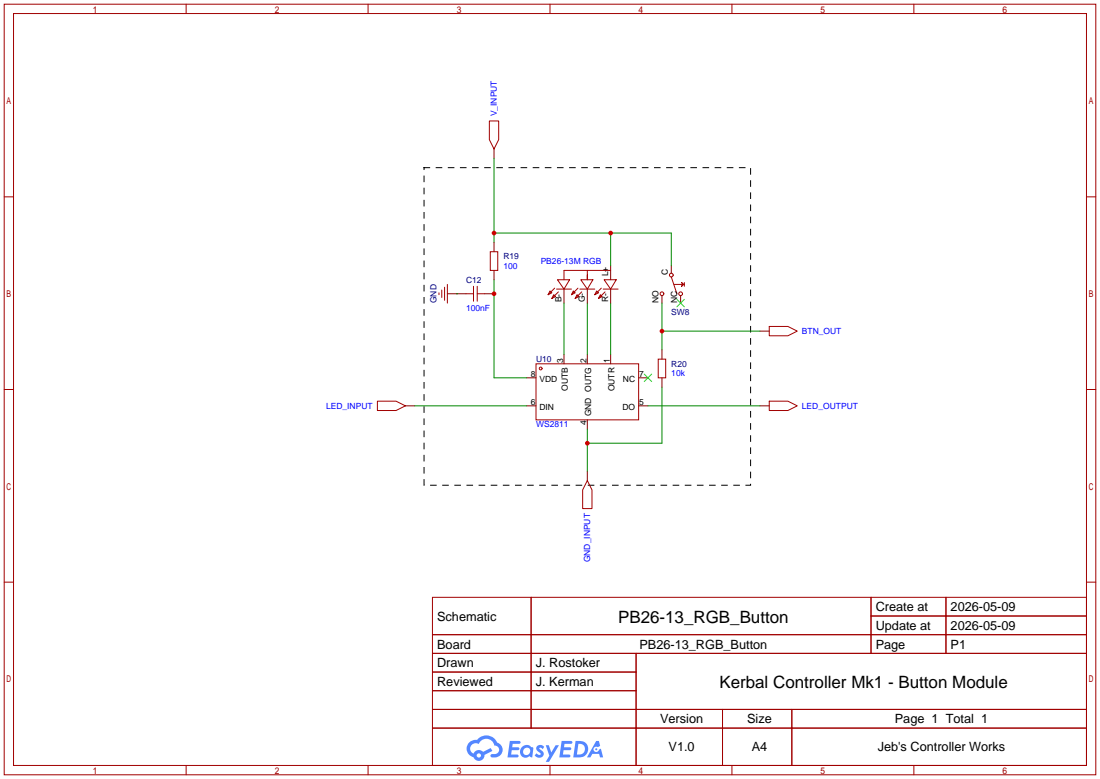
[picture p184: page 13]

Schematic | PB26-13_RGB_Button | Create at | 2026-05-09

Update at | 2026-05-09

Board | PB26-13_RGB_Button | Page | P1
Drawn | J. Rostoker | Kerbal Controller Mk1 - Button Module
Reviewed | J. Kerman

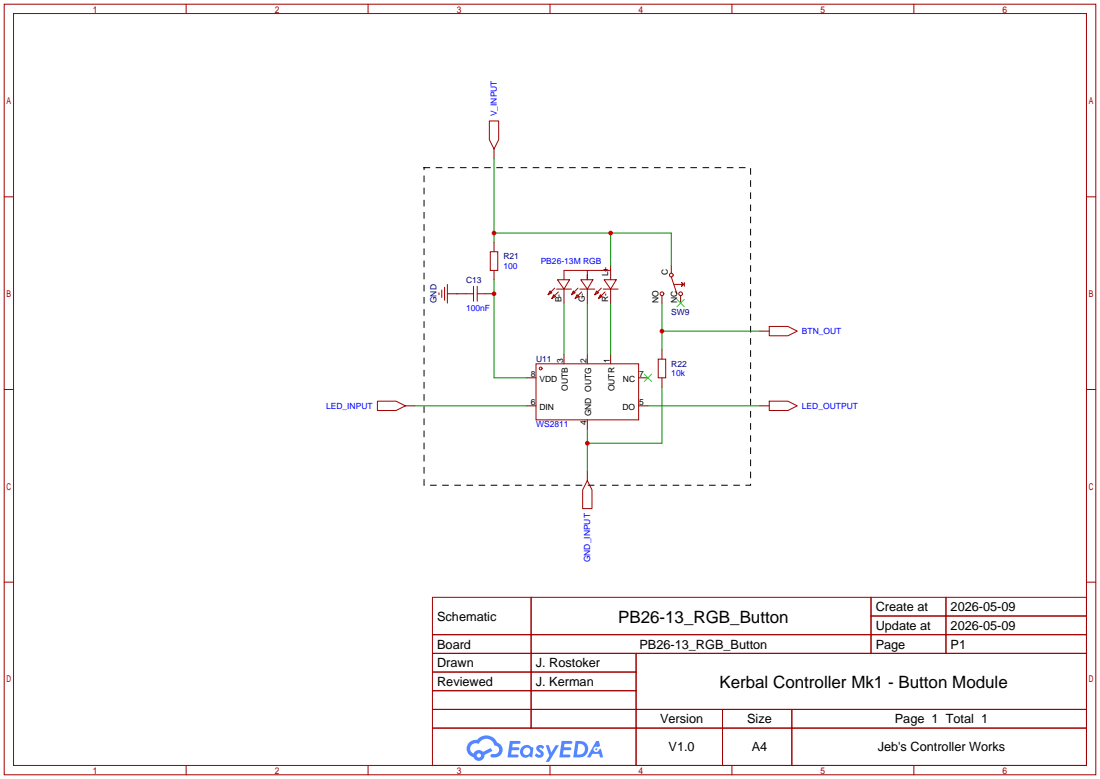
[picture p185: page 14]

Schematic | PB26-13_RGB_Button | Create at | 2026-05-09

Update at | 2026-05-09

Board | PB26-13_RGB_Button | Page | P1
Drawn | J. Rostoker | Kerbal Controller Mk1 - Button Module
Reviewed | J. Kerman

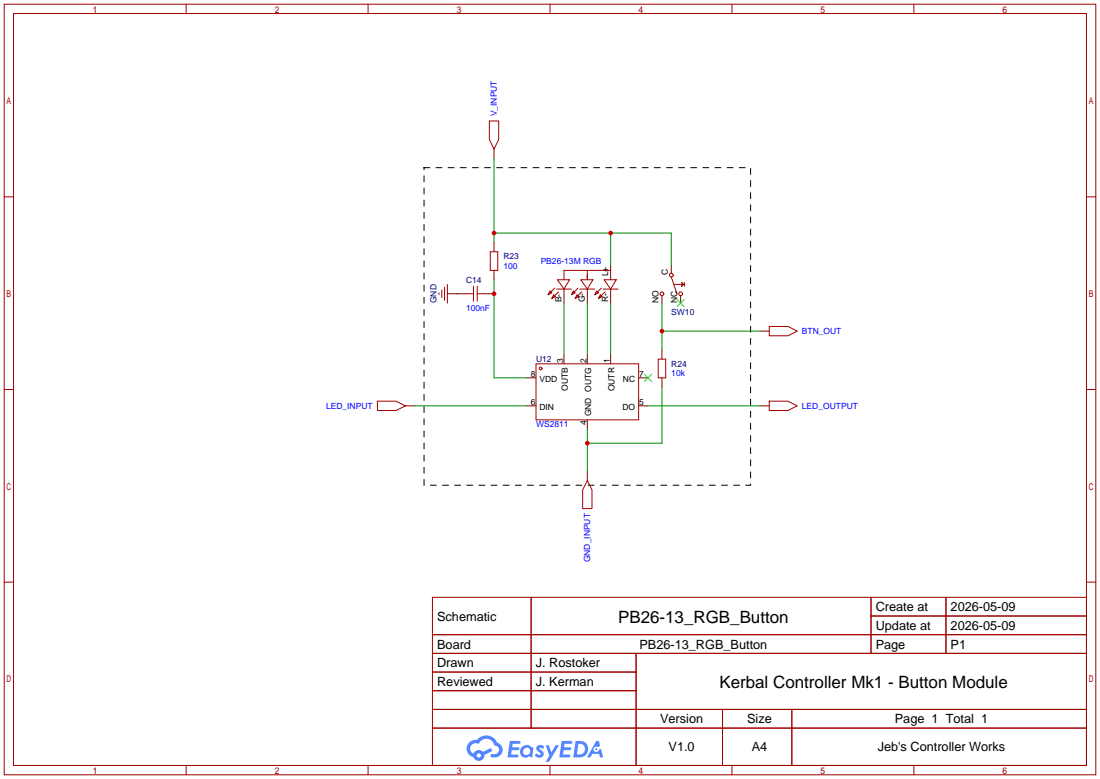
[picture p186: page 15]

Schematic | PB26-13_RGB_Button | Create at | 2026-05-09

Update at | 2026-05-09

Board | PB26-13_RGB_Button | Page | P1
Drawn | J. Rostoker | Kerbal Controller Mk1 - Button Module
Reviewed | J. Kerman

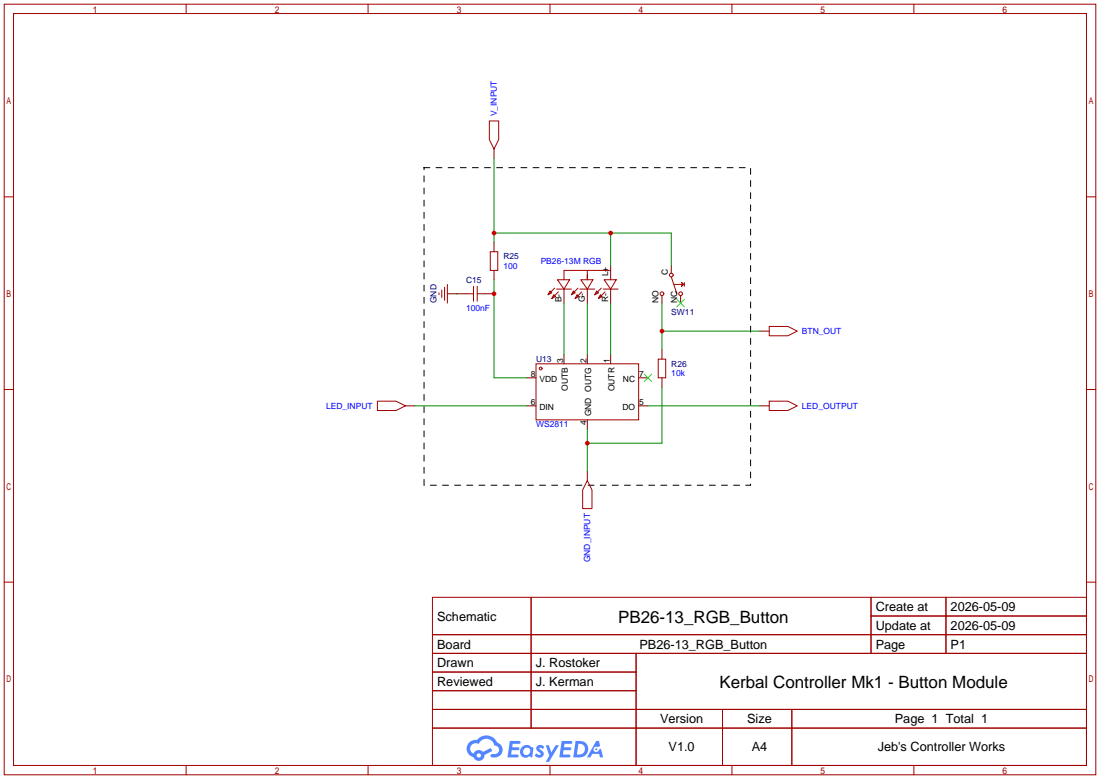
[picture p187: page 16]

Schematic | PB26-13_RGB_Button | Create at | 2026-05-09

Update at | 2026-05-09

Board | PB26-13_RGB_Button | Page | P1
Drawn | J. Rostoker | Kerbal Controller Mk1 - Button Module
Reviewed | J. Kerman

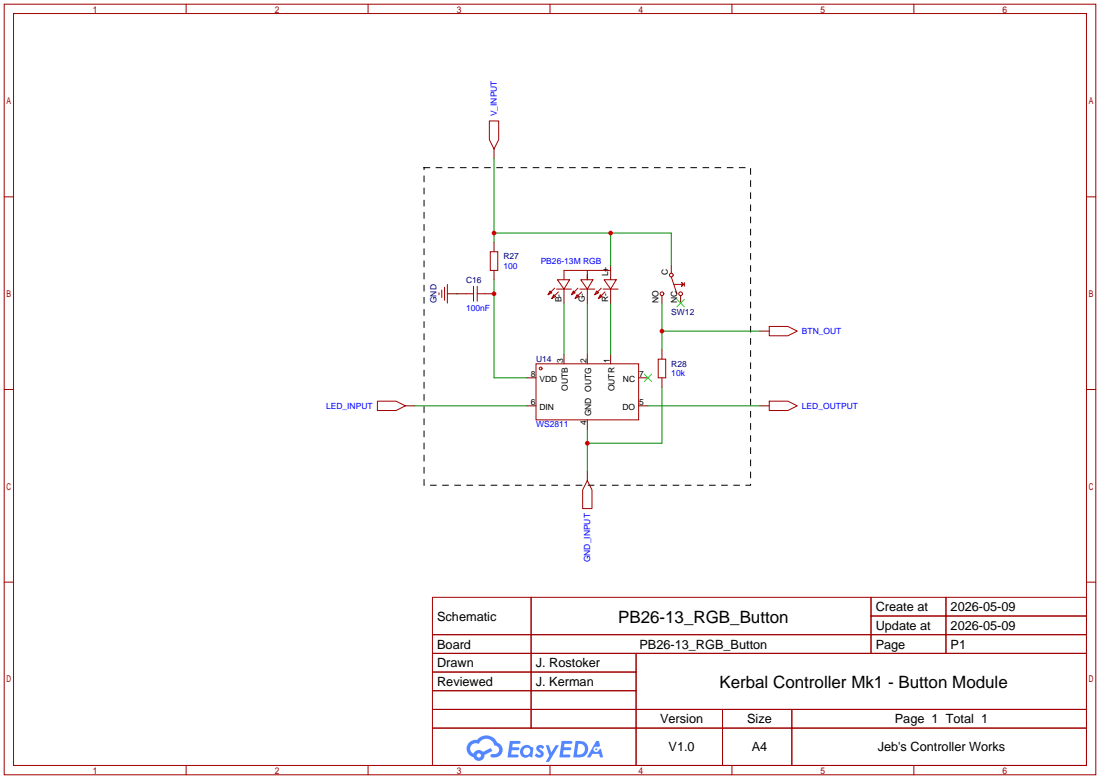
[picture p188: page 17]

Schematic | PB26-13_RGB_Button | Create at | 2026-05-09

Update at | 2026-05-09

Board | PB26-13_RGB_Button | Page | P1
Drawn | J. Rostoker | Kerbal Controller Mk1 - Button Module
Reviewed | J. Kerman
