bigJRo/KerbalControllerMk1/Documents/Drawings/KC-01-1802_V2.0_Button Module_PCB.pdf

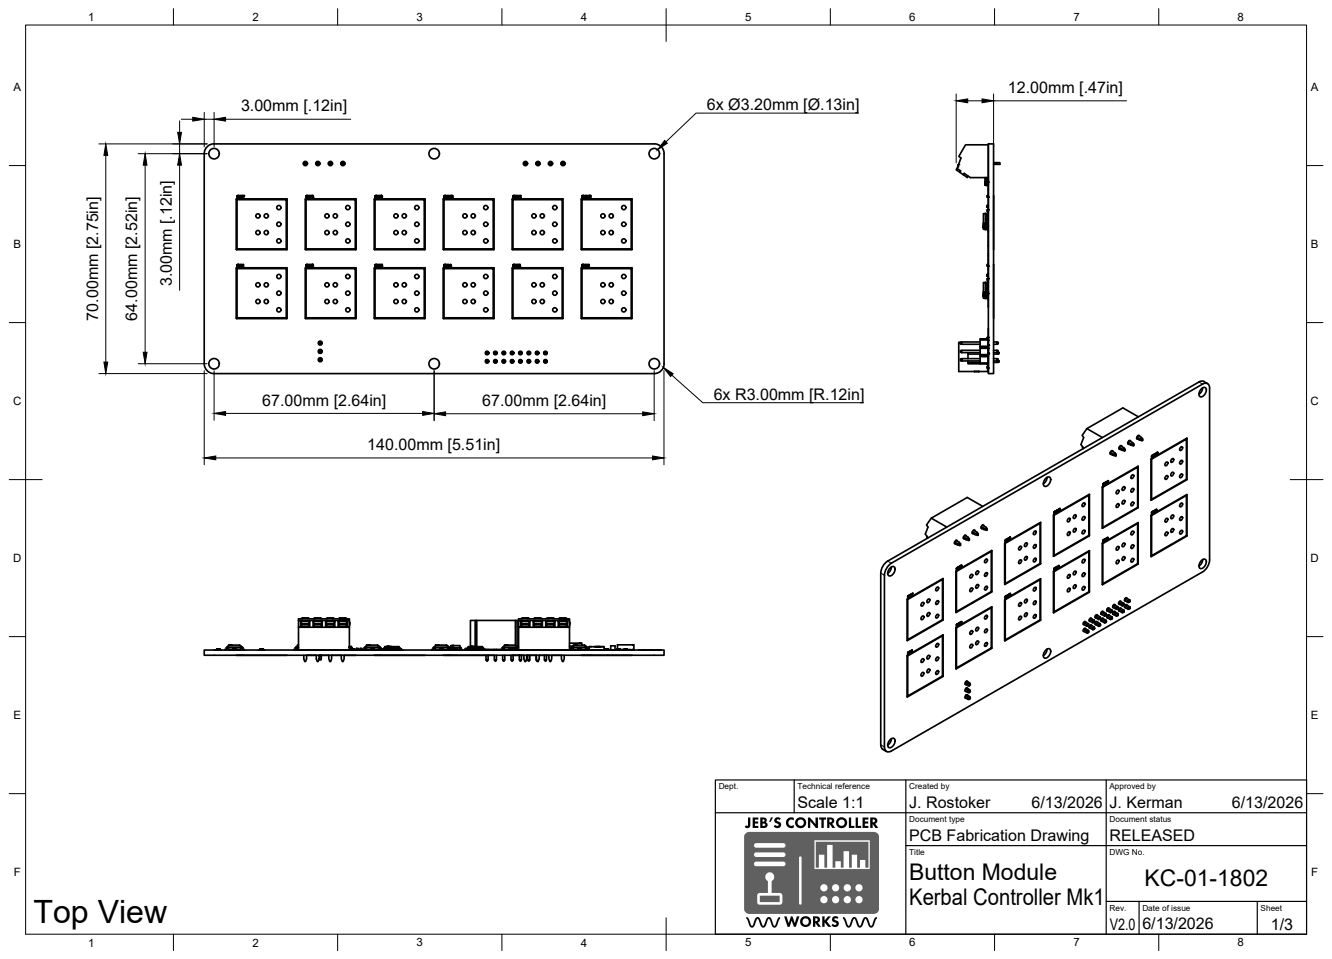
[picture p189: page 1]
Dept.; Technical reference; Created by; Approved by; Document type; Document status; Title; DWG No.; Rev.; Date of issue; Sheet; PCB Fabrication Drawing; RELEASED; Kerbal Controller Mk1; Button Module; Scale 1:1; J. Rostoker; J. Kerman; Top View

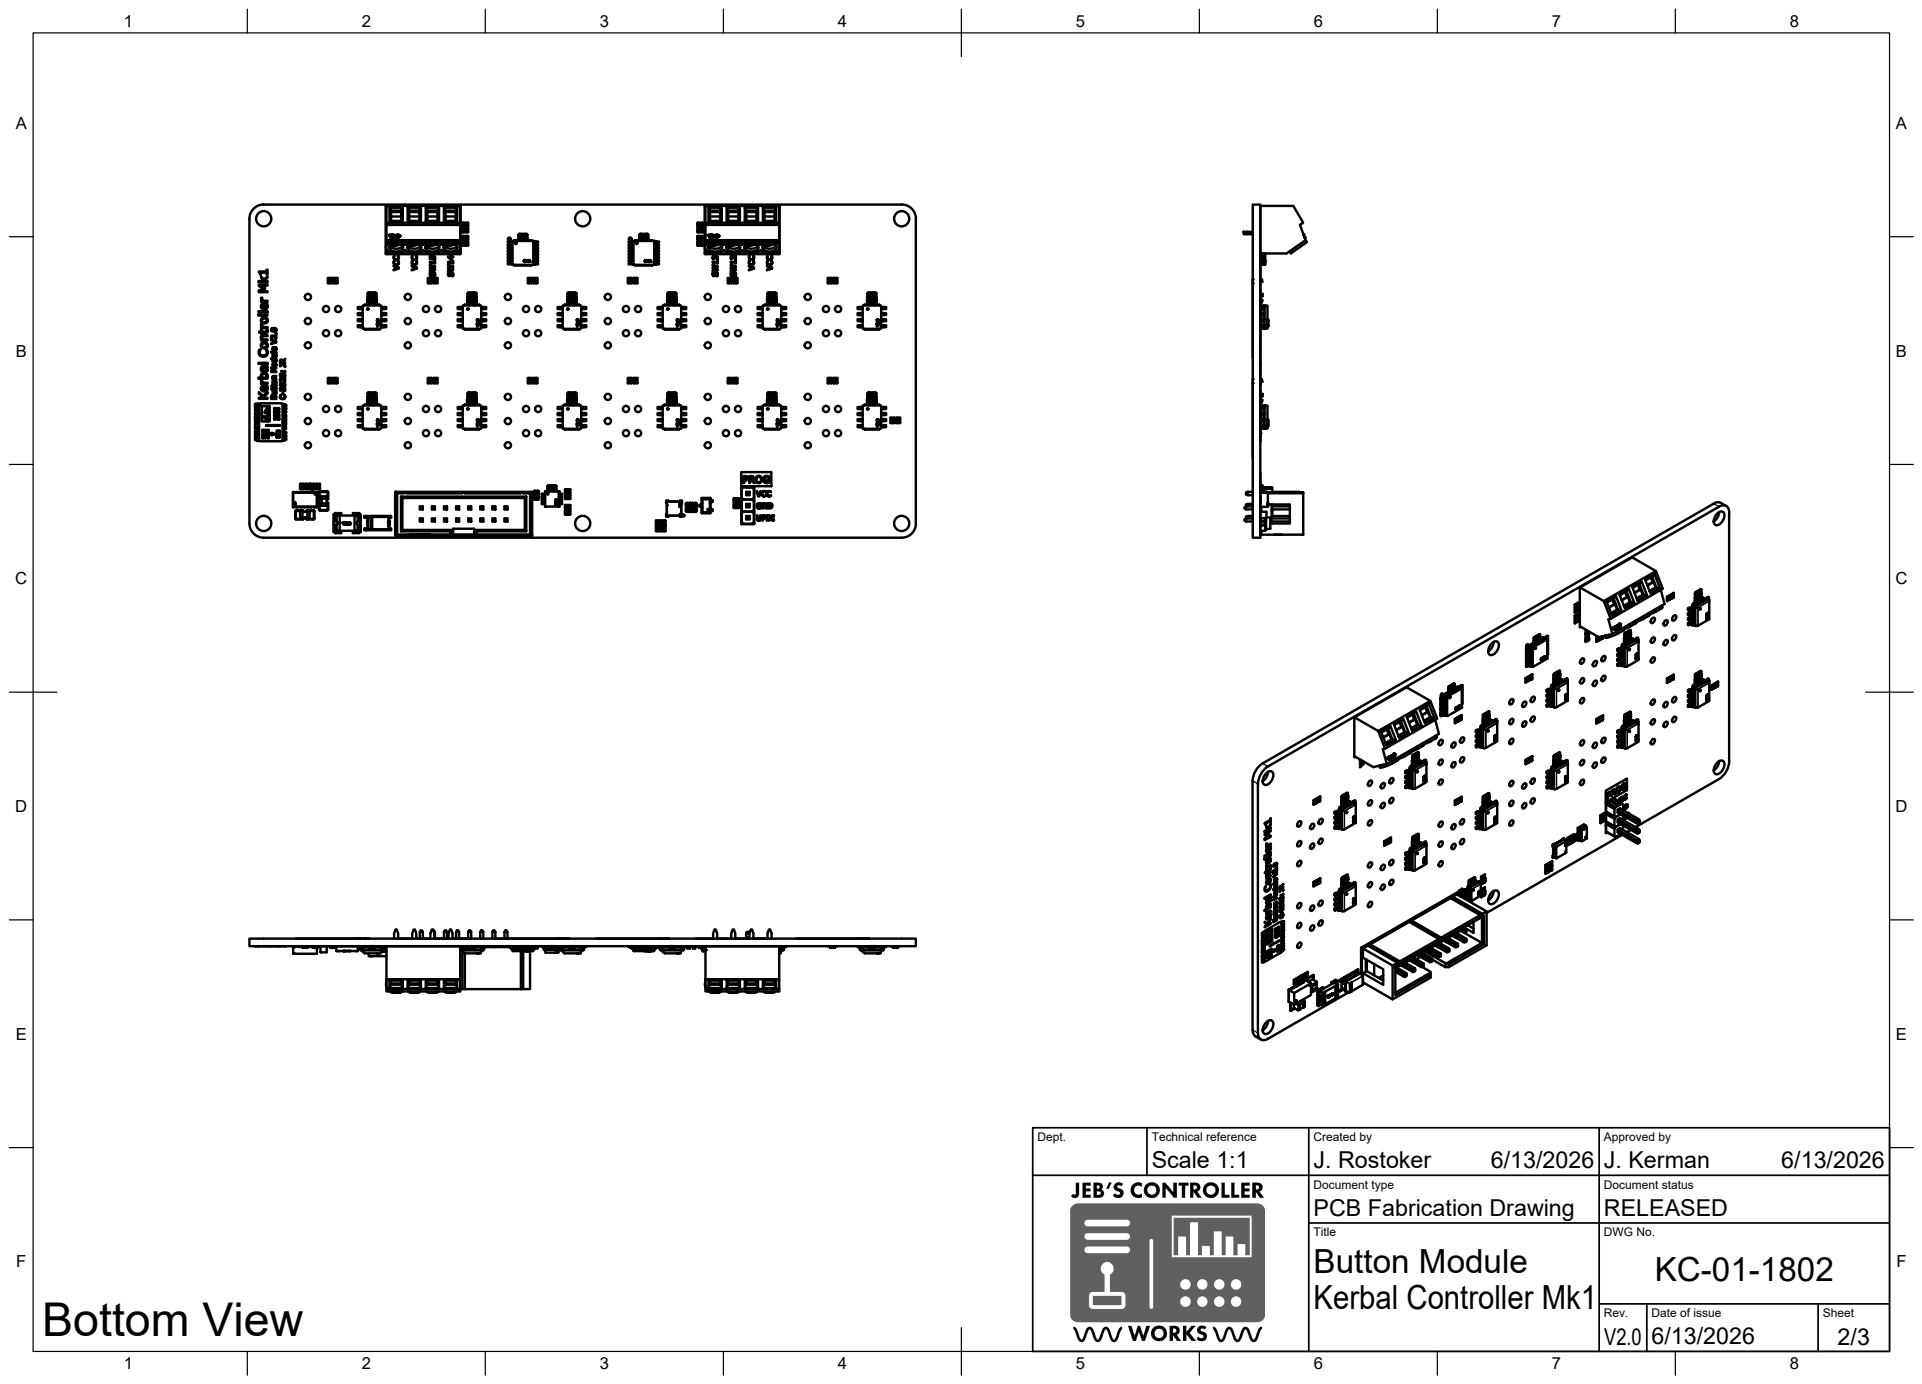
[picture p190: page 2]
Dept.; Technical reference; Created by; Approved by; Document type; Document status; Title; DWG No.; PCB Fabrication Drawing; RELEASED; Button Module; Scale 1:1; J. Rostoker; J. Kerman; Bottom View

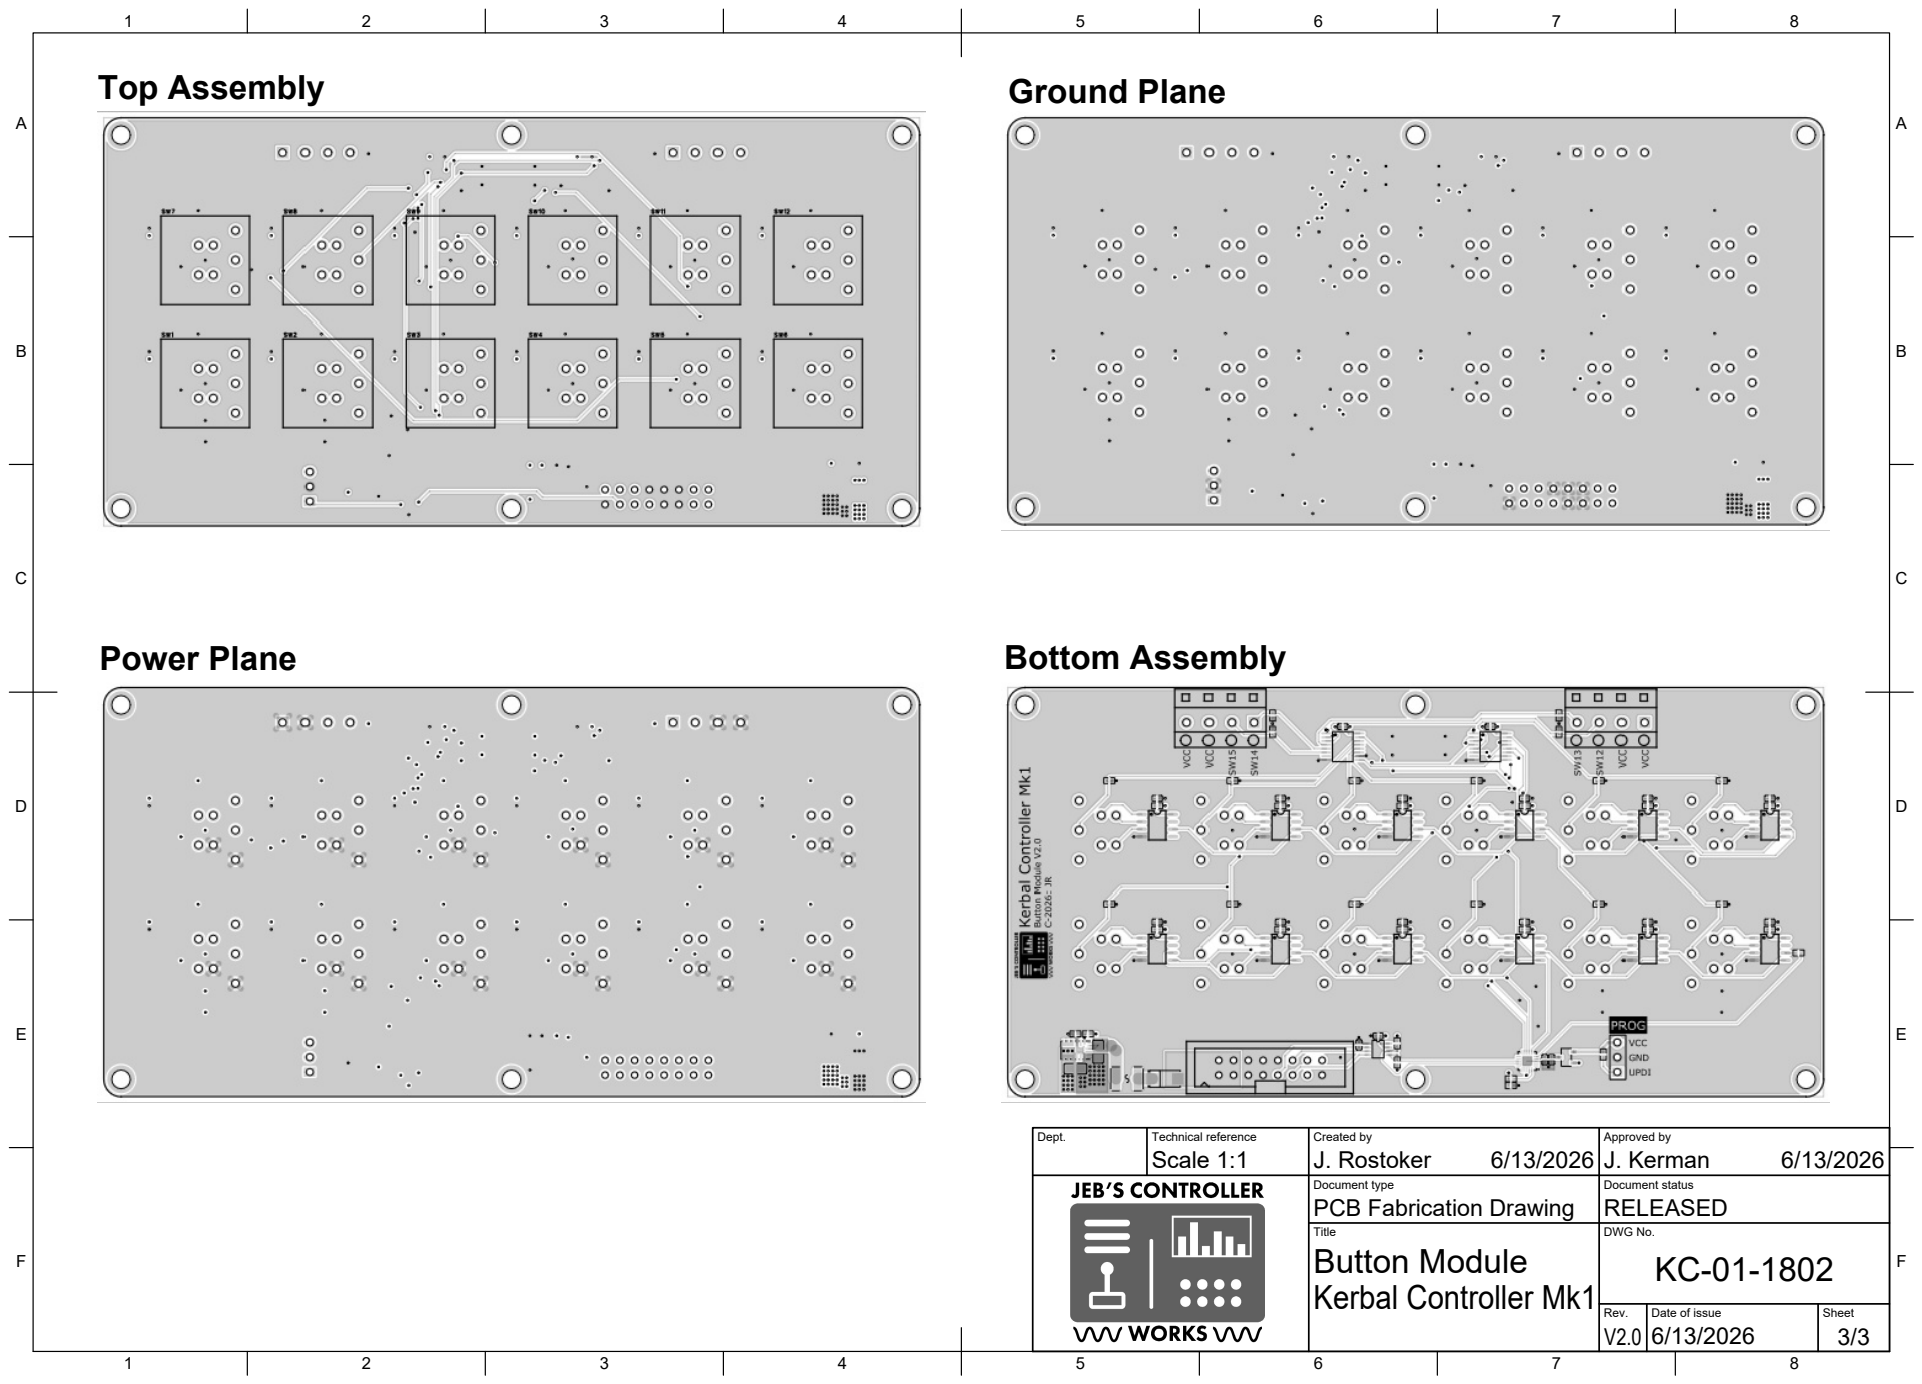
[picture p191: page 3]
Title; DWG No.; Button Module; Top Assembly; Power Plane; Bottom Assembly; Ground Plane

Dept. | Technical reference Scale 1:1 | Created by J. Rostoker 6/13/2026 | Approved by J. Kerman 6/13/2026

Document type PCB Fabrication Drawing | Document status RELEASED
