bigJRo/KerbalControllerMk1/Documents/Drawings/KC-01-1811_V2.0_Wide Button Module_SCH.pdf

Microcontroller | Panel Control Connector

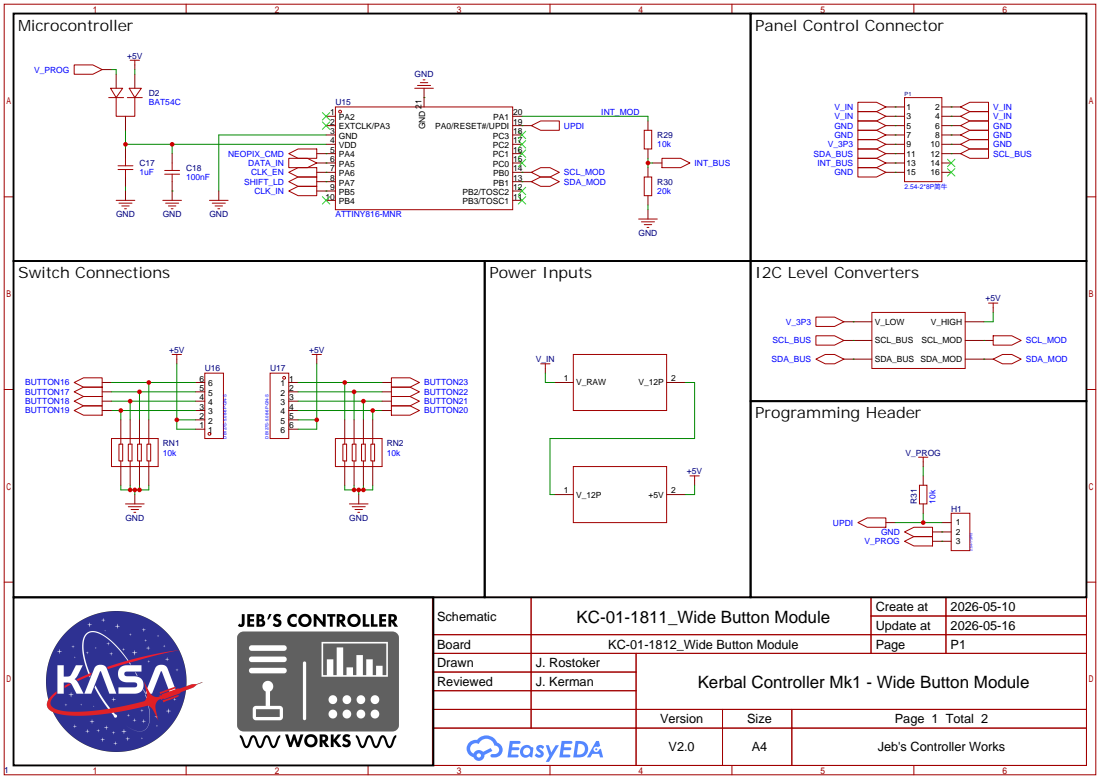
[picture p194: page 1]

Schematic | KC-01-1811_Wide Button Module | Create at | 2026-05-10

Update at | 2026-05-16

Board | KC-01-1812_Wide Button Module | Page | P1
Drawn | J. Rostoker | Kerbal Controller Mk1 - Wide Button Module
Reviewed | J. Kerman

Version | Size | Page 1 Total 2
V2.0 | A4 | Jeb's Controller Works

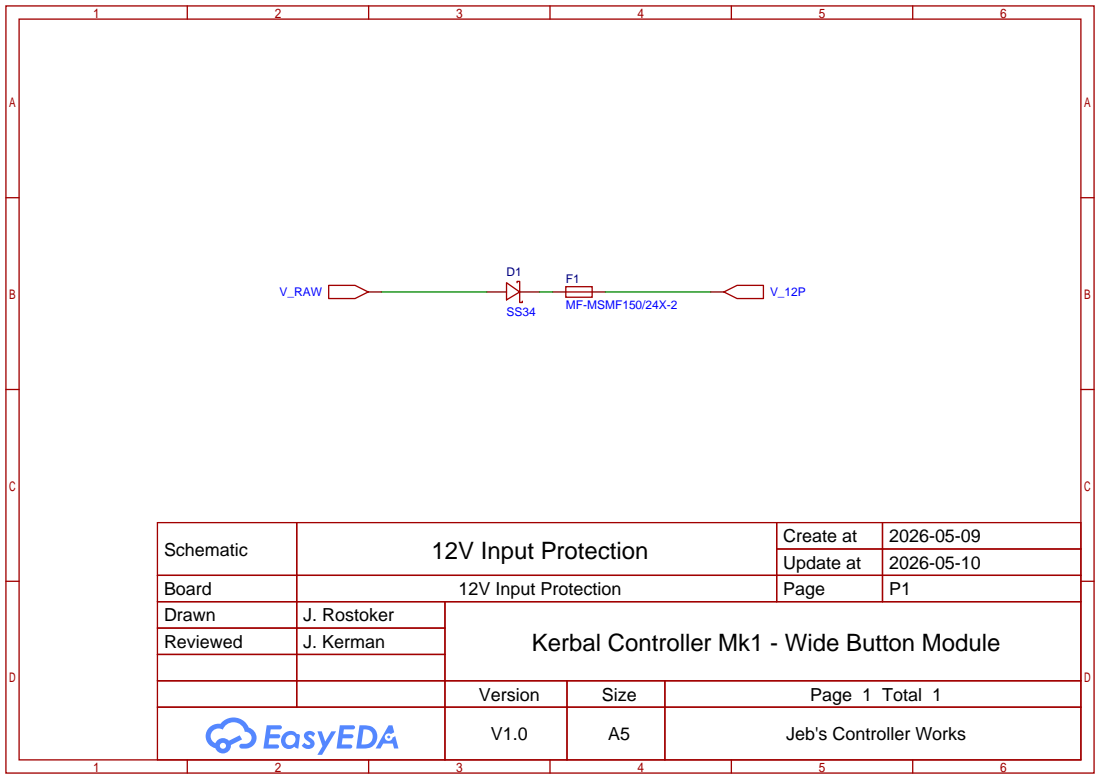
[picture p195: page 2]

Schematic | 12V Input Protection | Create at | 2026-05-09

Update at | 2026-05-10

Board | 12V Input Protection | Page | P1
Drawn | J. Rostoker | Kerbal Controller Mk1 - Wide Button Module
Reviewed | J. Kerman

Version | Size | Page 1 Total 1
V1.0 | A5 | Jeb's Controller Works

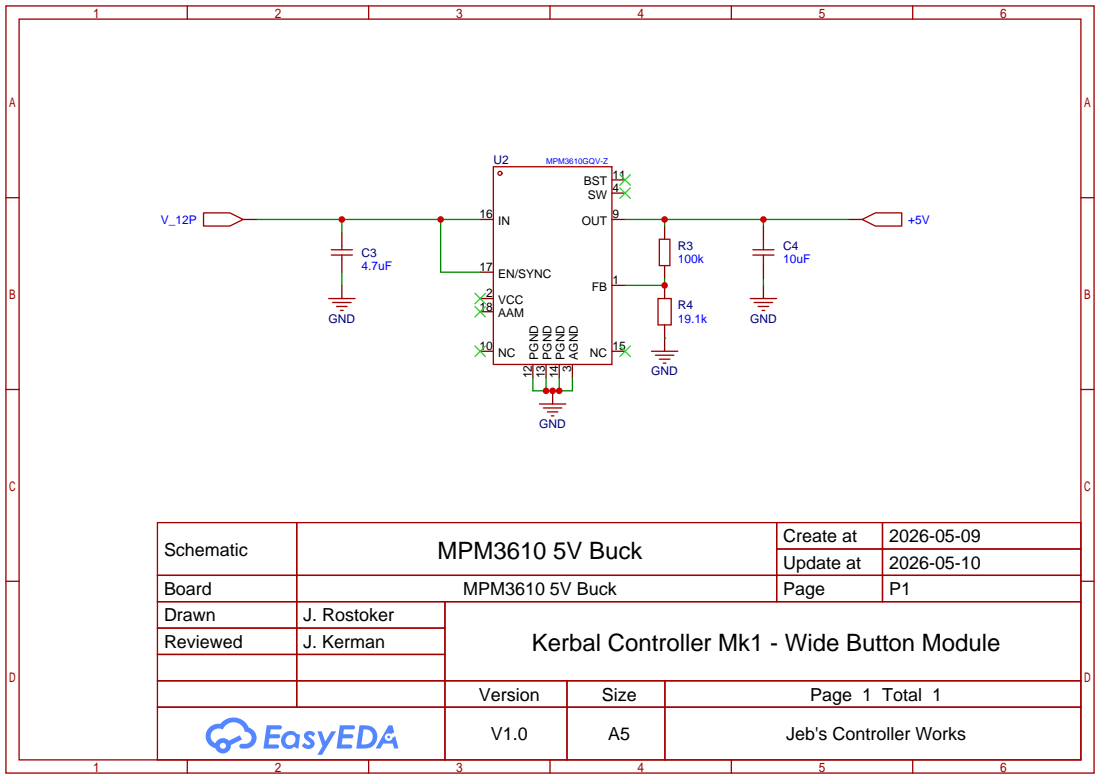
[picture p196: page 3]

Schematic | MPM3610 5V Buck | Create at | 2026-05-09

Update at | 2026-05-10

Board | MPM3610 5V Buck | Page | P1
Drawn | J. Rostoker | Kerbal Controller Mk1 - Wide Button Module
Reviewed | J. Kerman

Version | Size | Page 1 Total 1
V1.0 | A5 | Jeb's Controller Works

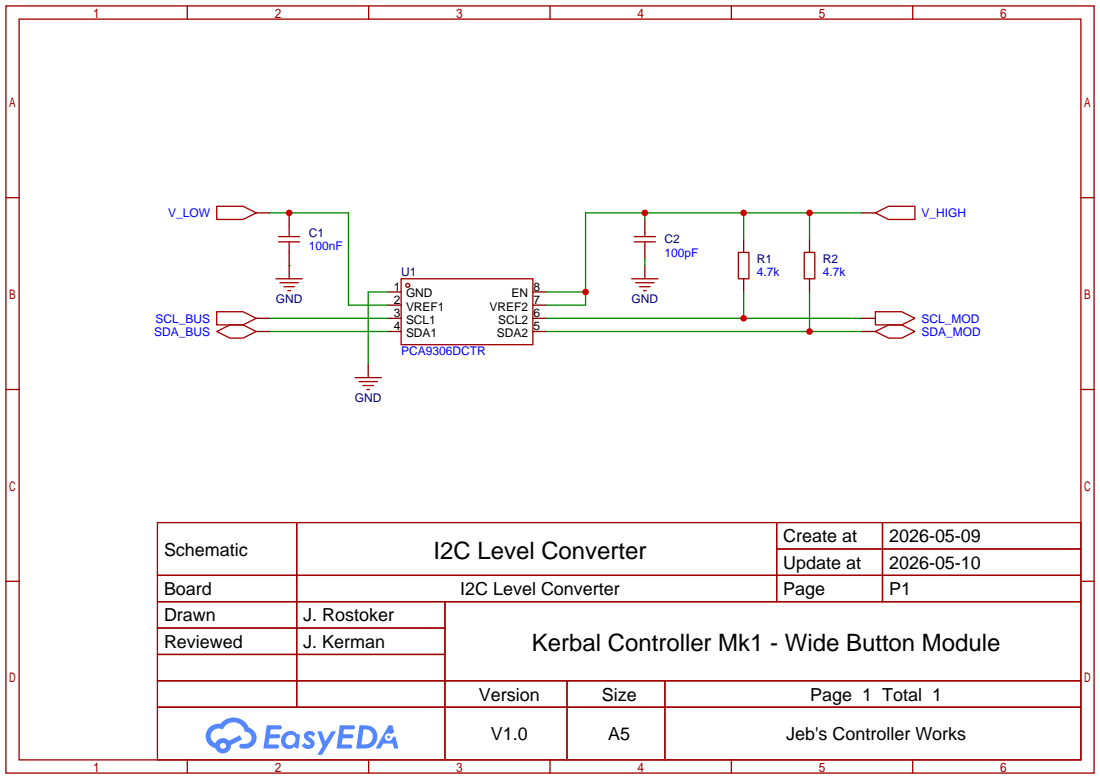
[picture p197: page 4]

Schematic | I2C Level Converter | Create at | 2026-05-09

Update at | 2026-05-10

Board | I2C Level Converter | Page | P1
Drawn | J. Rostoker | Kerbal Controller Mk1 - Wide Button Module
Reviewed | J. Kerman

Version | Size | Page 1 Total 1
V1.0 | A5 | Jeb's Controller Works

# Button Connections & Control Shift Registers

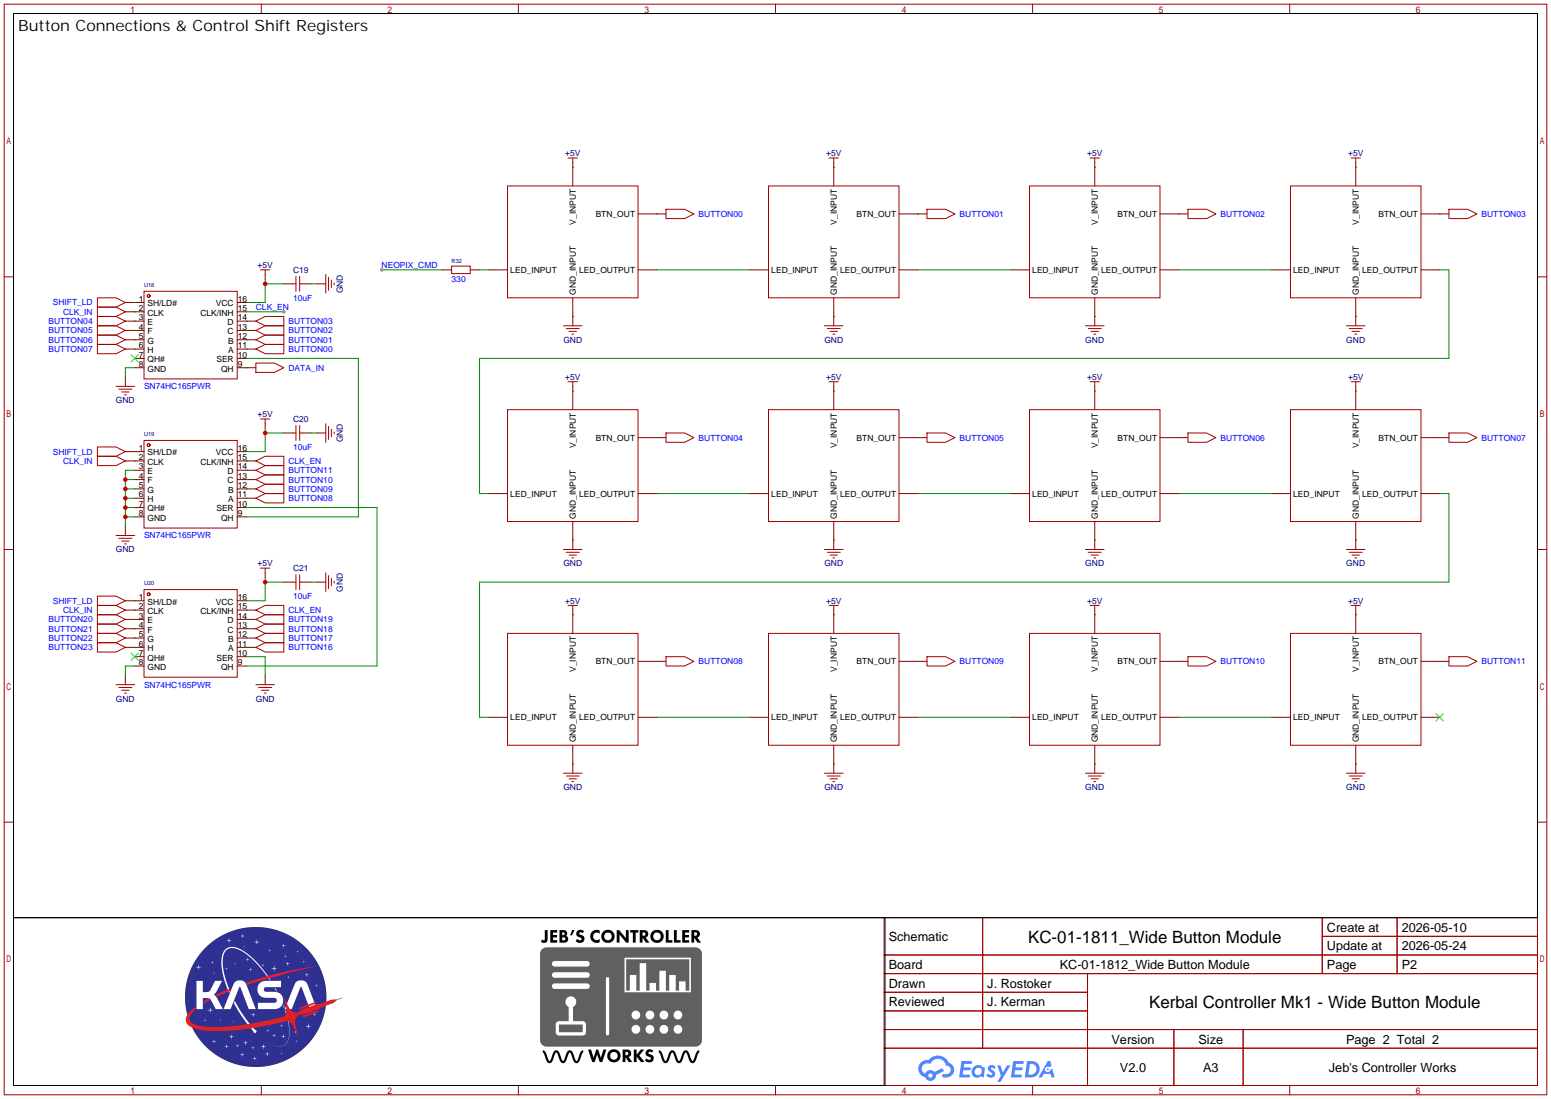
[picture p198: page 5]

Schematic | KC-01-1811_Wide Button Module | Create at | 2026-05-10

Update at | 2026-05-24

Board | KC-01-1812_Wide Button Module | Page | P2
Drawn | J. Rostoker | Kerbal Controller Mk1 - Wide Button Module
Reviewed | J. Kerman

Version | Size | Page 2 Total 2
V2.0 | A3 | Jeb's Controller Works

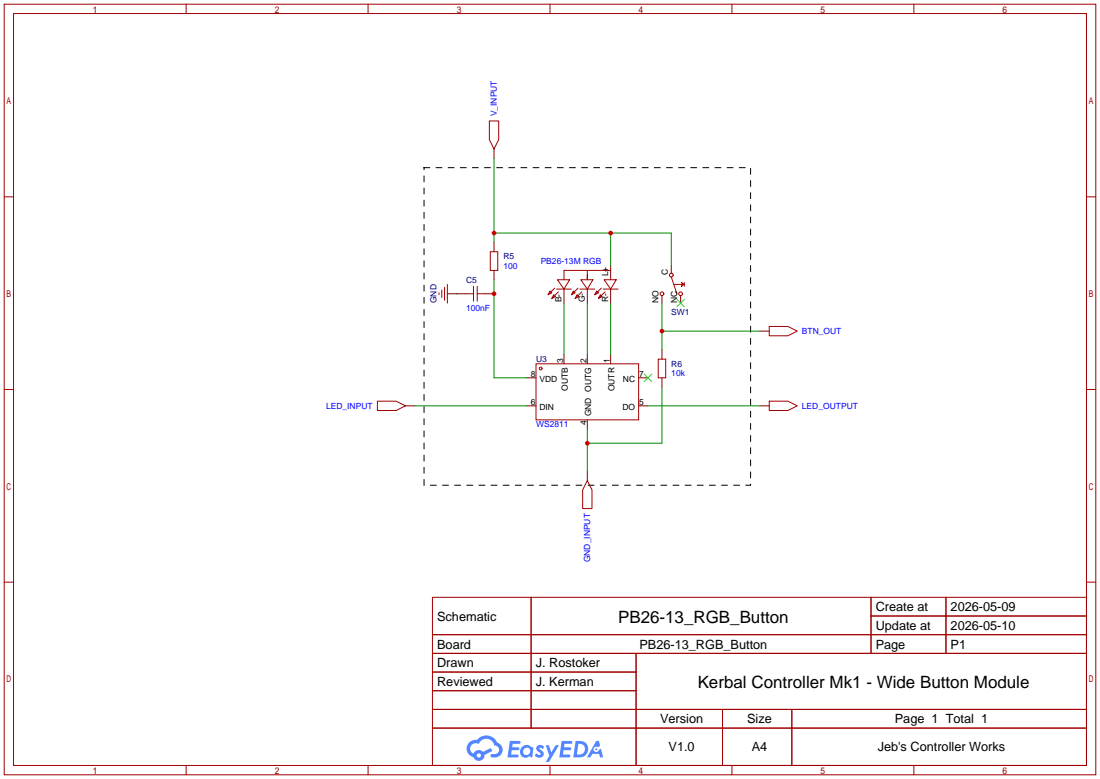
[picture p199: page 6]

Schematic | PB26-13_RGB_Button | Create at | 2026-05-09

Update at | 2026-05-10

Board | PB26-13_RGB_Button | Page | P1
Drawn | J. Rostoker | Kerbal Controller Mk1 - Wide Button Module
Reviewed | J. Kerman

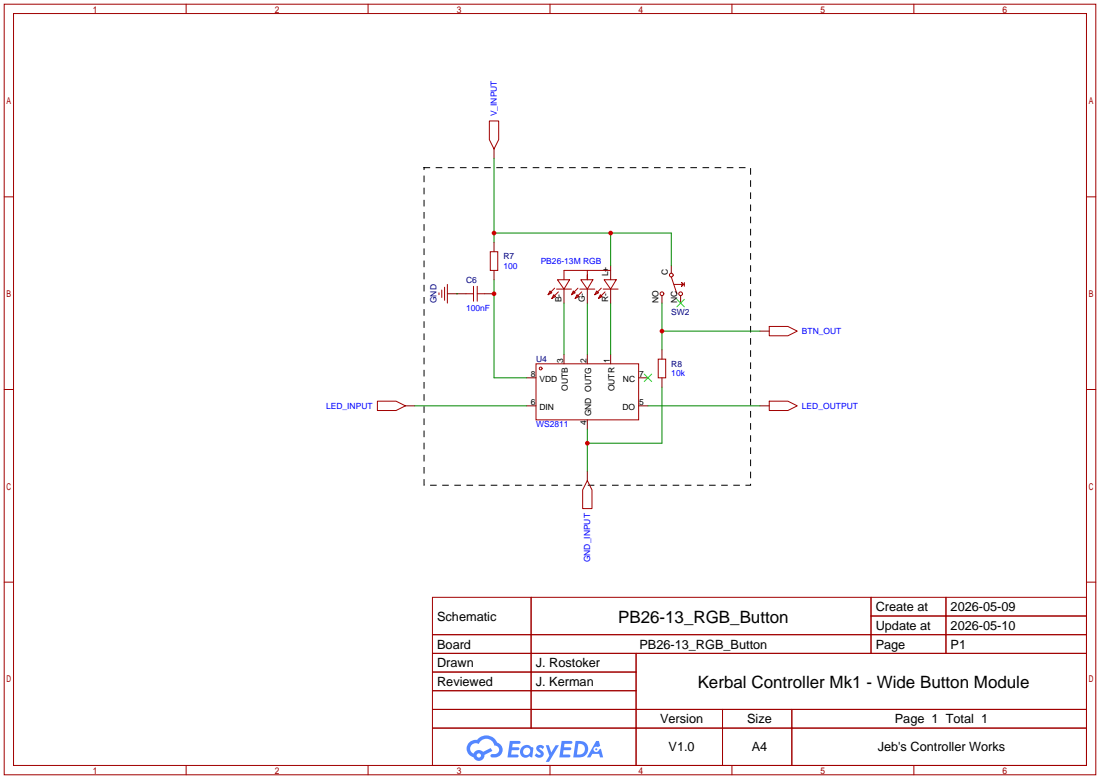
[picture p200: page 7]

Schematic | PB26-13_RGB_Button | Create at | 2026-05-09

Update at | 2026-05-10

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

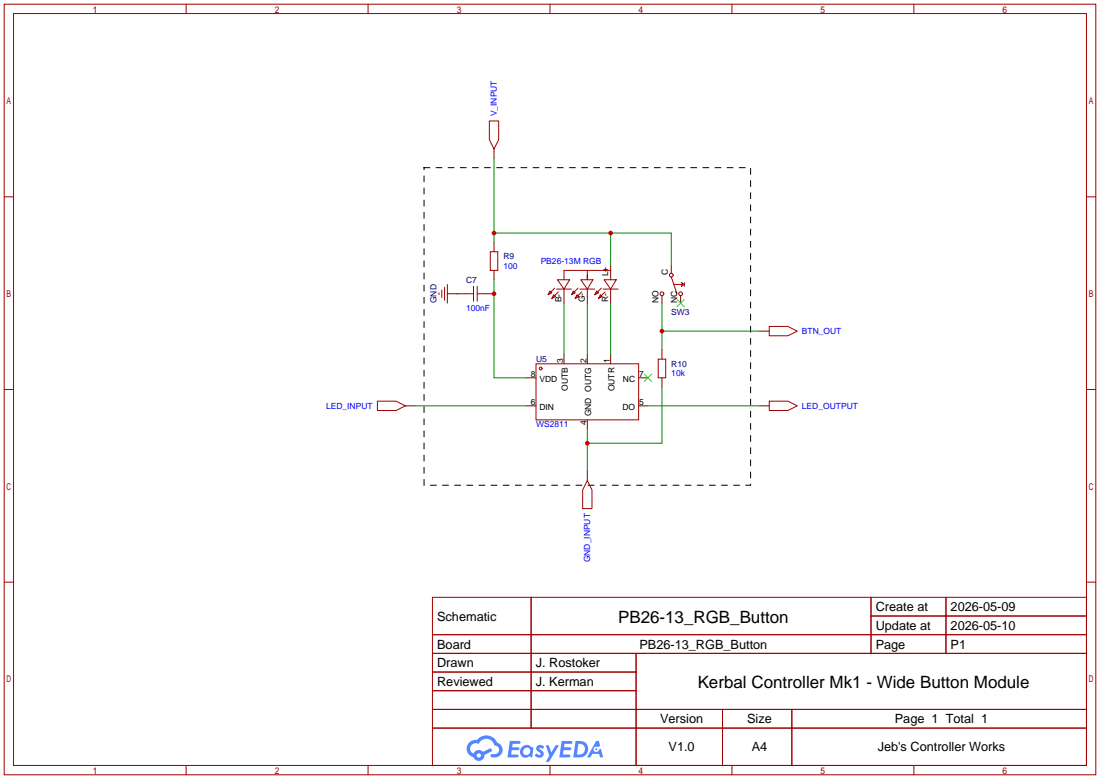
[picture p201: page 8]

Schematic | PB26-13_RGB_Button | Create at | 2026-05-09

Update at | 2026-05-10

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

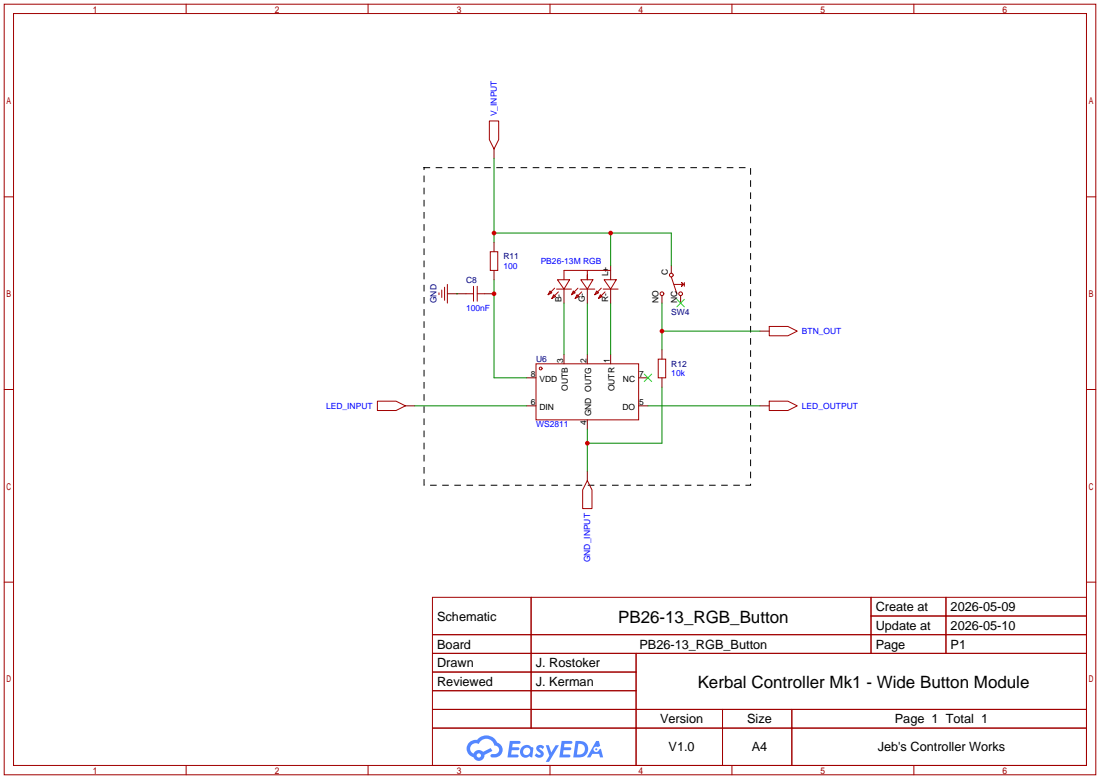
[picture p202: page 9]

Schematic | PB26-13_RGB_Button | Create at | 2026-05-09

Update at | 2026-05-10

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

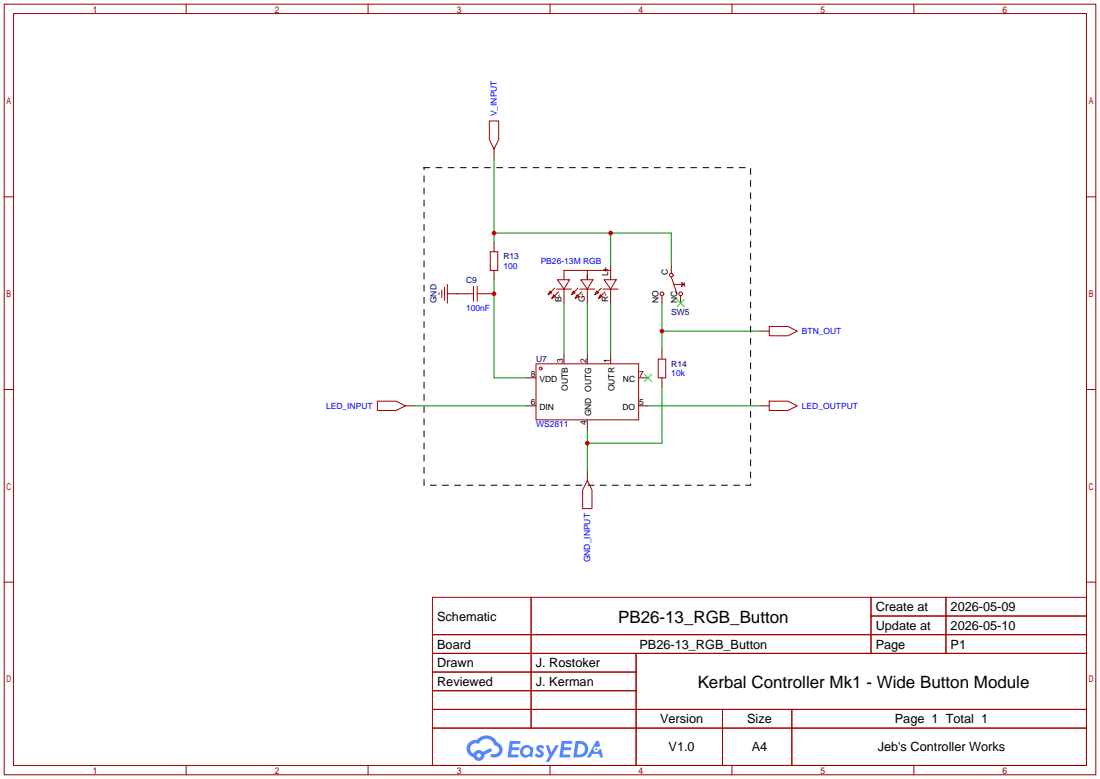
[picture p203: page 10]

Schematic | PB26-13_RGB_Button | Create at | 2026-05-09

Update at | 2026-05-10

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

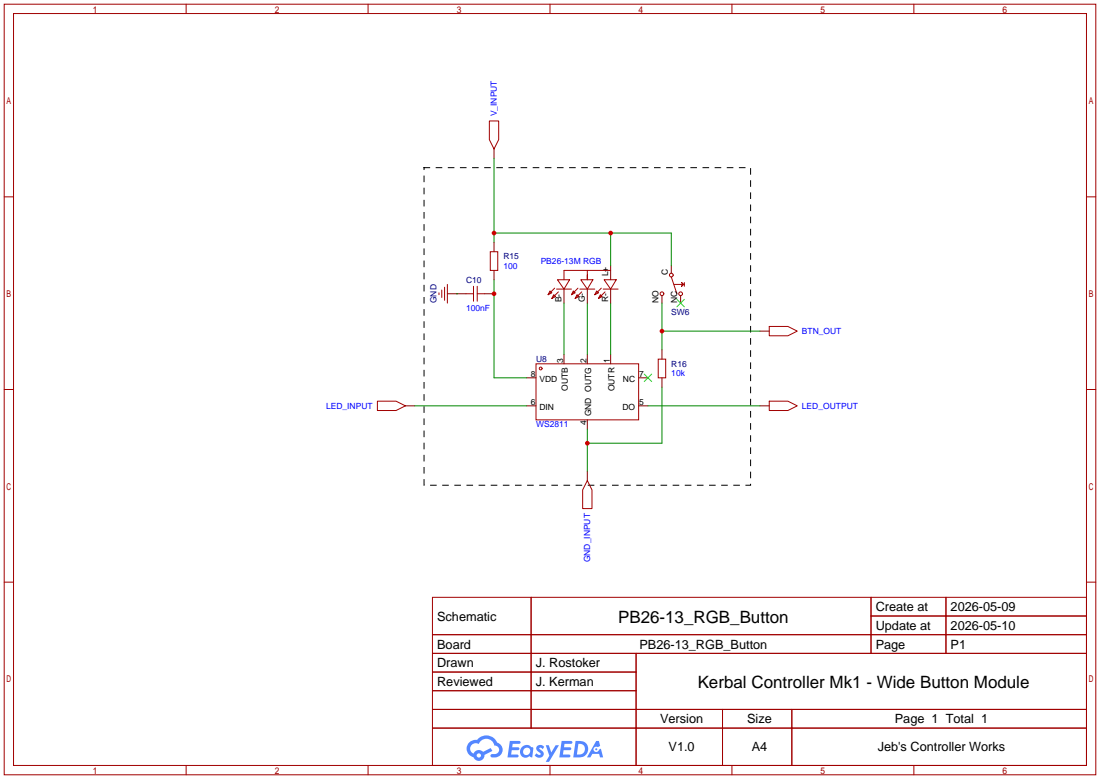
[picture p204: page 11]

Schematic | PB26-13_RGB_Button | Create at | 2026-05-09

Update at | 2026-05-10

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

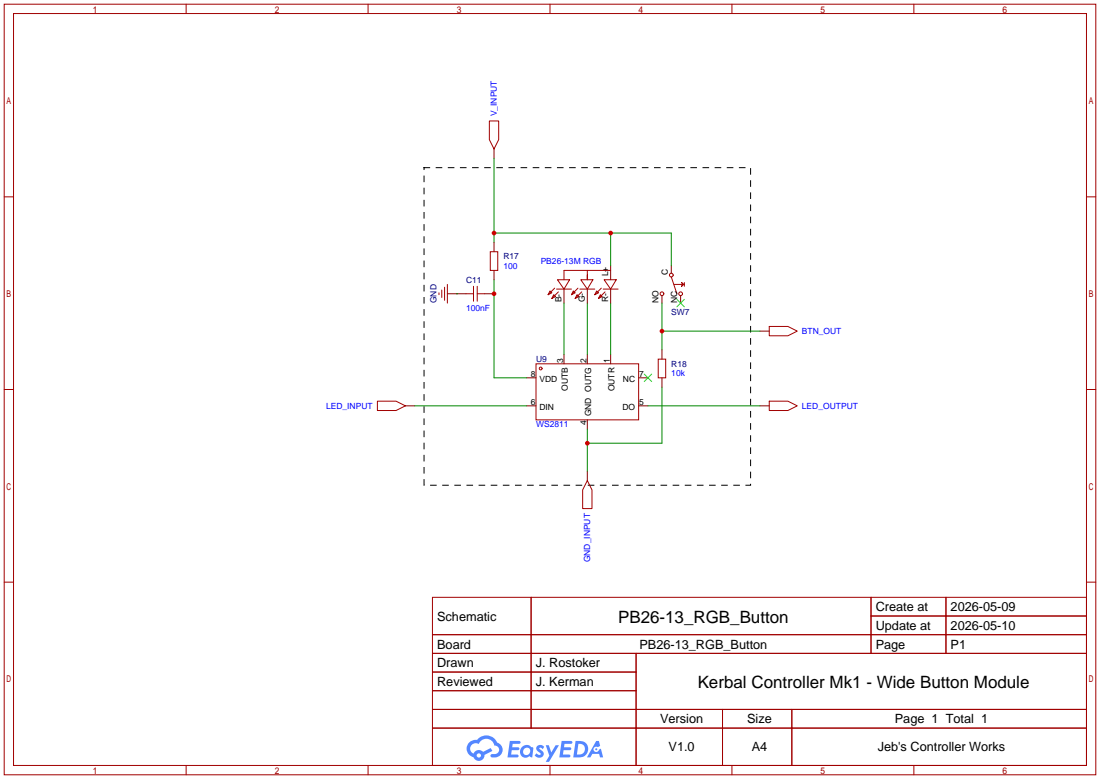
[picture p205: page 12]

Schematic | PB26-13_RGB_Button | Create at | 2026-05-09

Update at | 2026-05-10

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

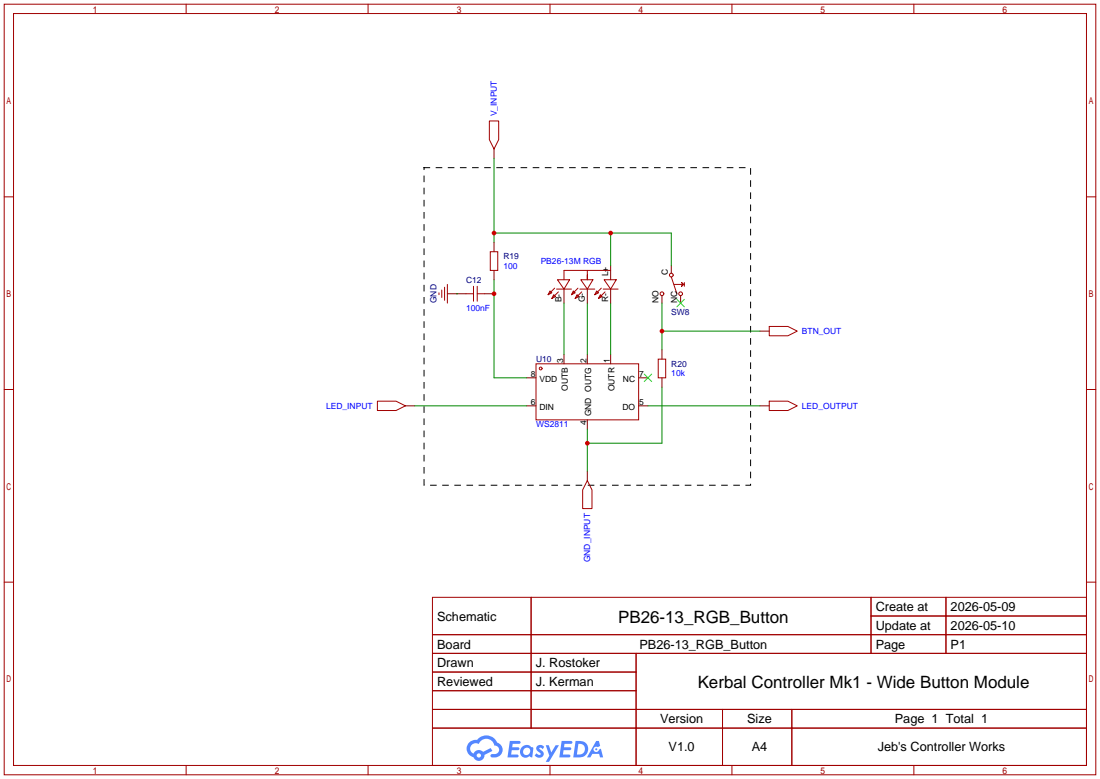
[picture p206: page 13]

Schematic | PB26-13_RGB_Button | Create at | 2026-05-09

Update at | 2026-05-10

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

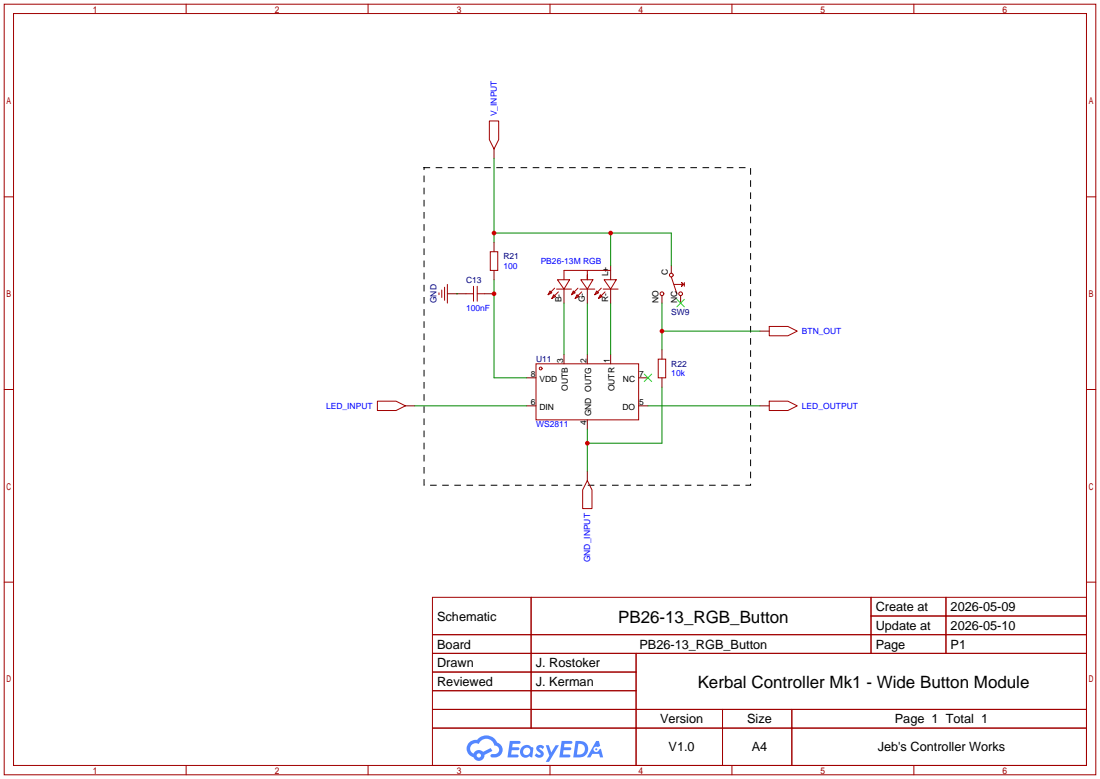
[picture p207: page 14]

Schematic | PB26-13_RGB_Button | Create at | 2026-05-09

Update at | 2026-05-10

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

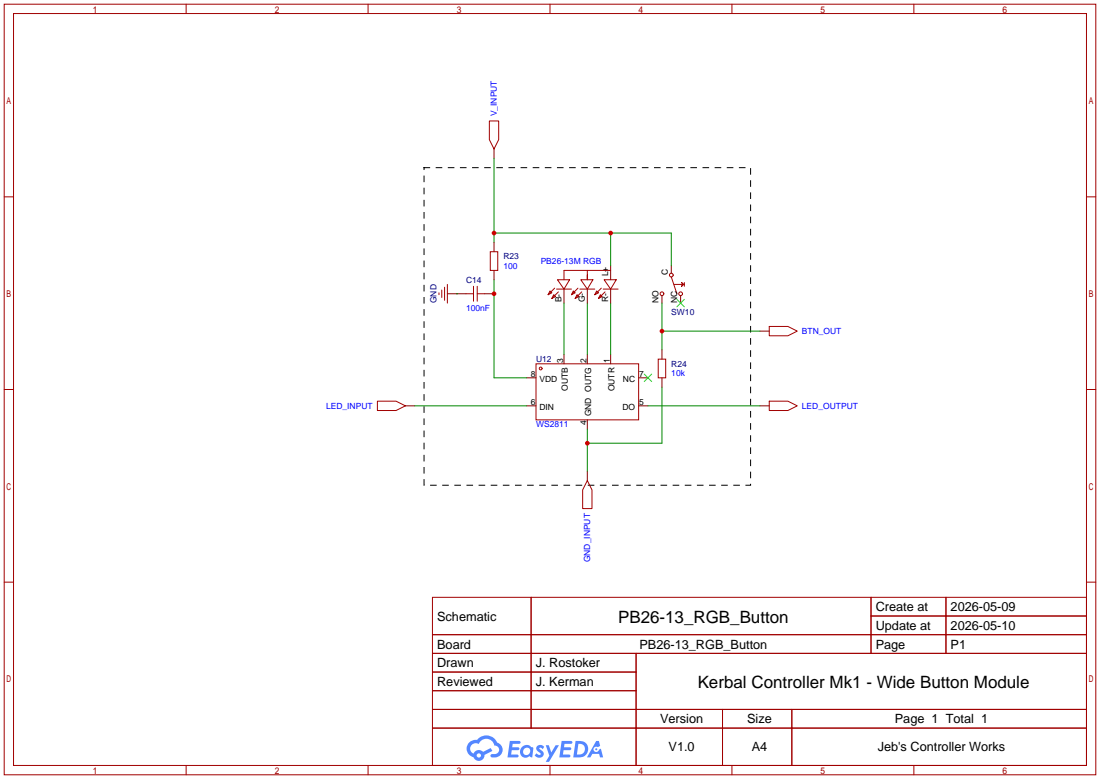
[picture p208: page 15]

Schematic | PB26-13_RGB_Button | Create at | 2026-05-09

Update at | 2026-05-10

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

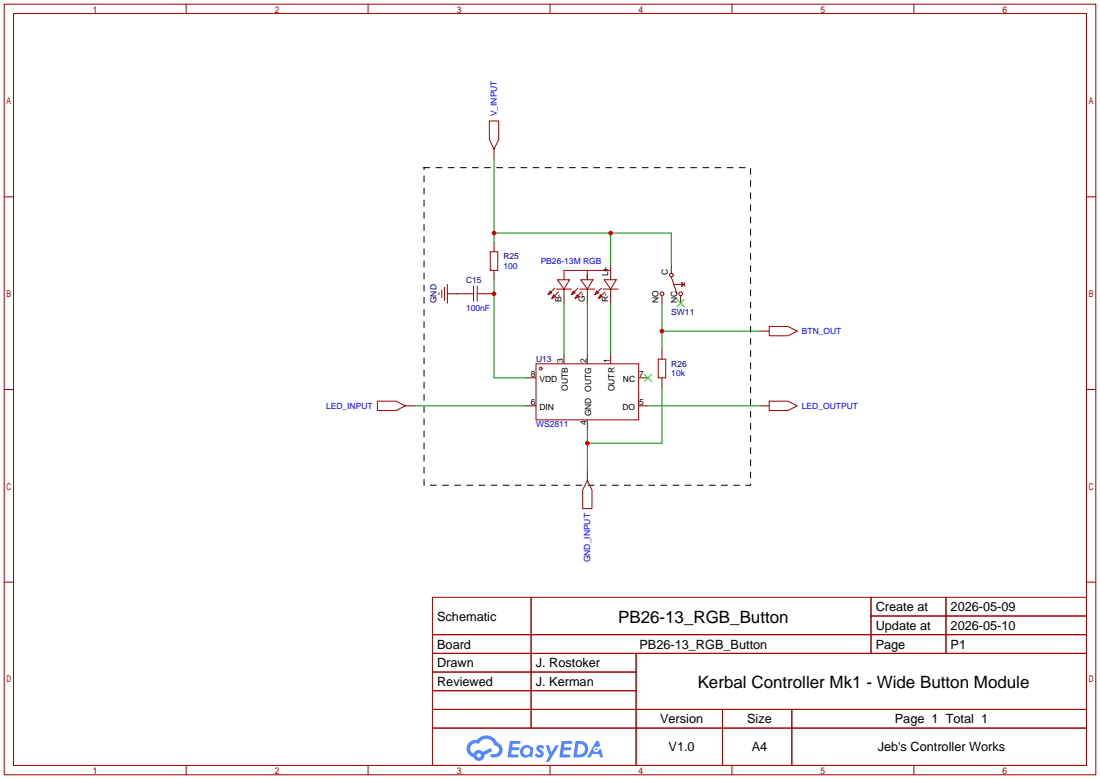
[picture p209: page 16]

Schematic | PB26-13_RGB_Button | Create at | 2026-05-09

Update at | 2026-05-10

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

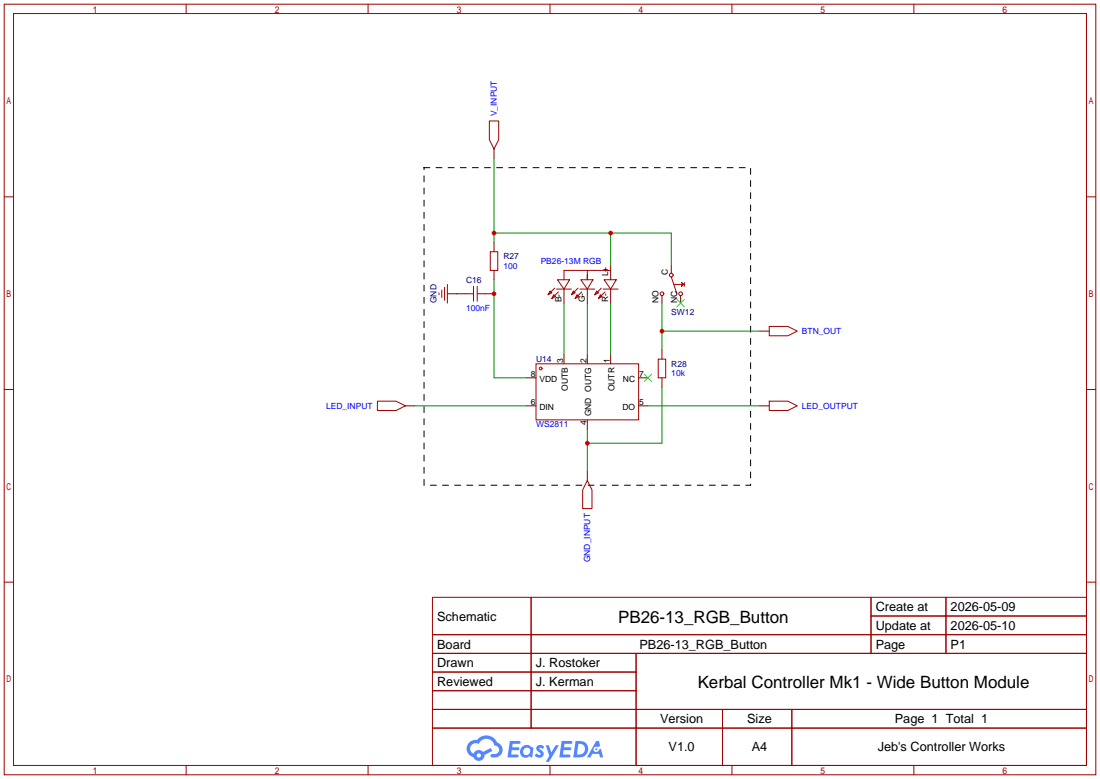
[picture p210: page 17]

Schematic | PB26-13_RGB_Button | Create at | 2026-05-09

Update at | 2026-05-10

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
