bigJRo/KerbalControllerMk1/Documents/Drawings/KC-01-1812_V2.0_Wide Button Module_PWB.pdf

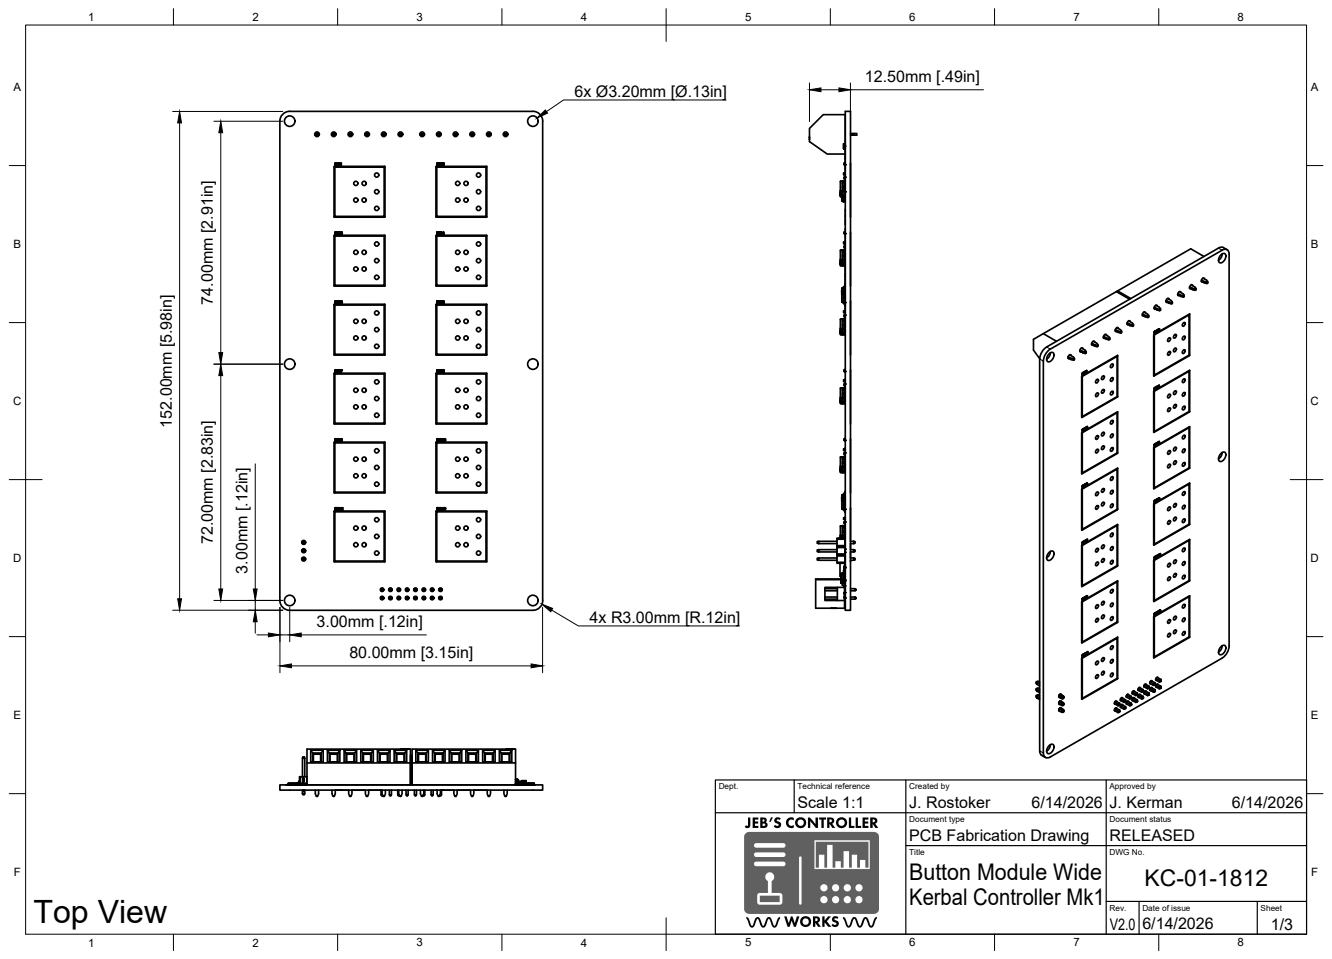
[picture p211: page 1]
Dept.; Technical reference; Created by; Approved by; Document type; Document status; Title; DWG No.; Rev.; Date of issue; Sheet; PCB Fabrication Drawing; RELEASED; Kerbal Controller Mk1; Button Module Wide; Scale 1:1; J. Rostoker; J. Kerman; Top View

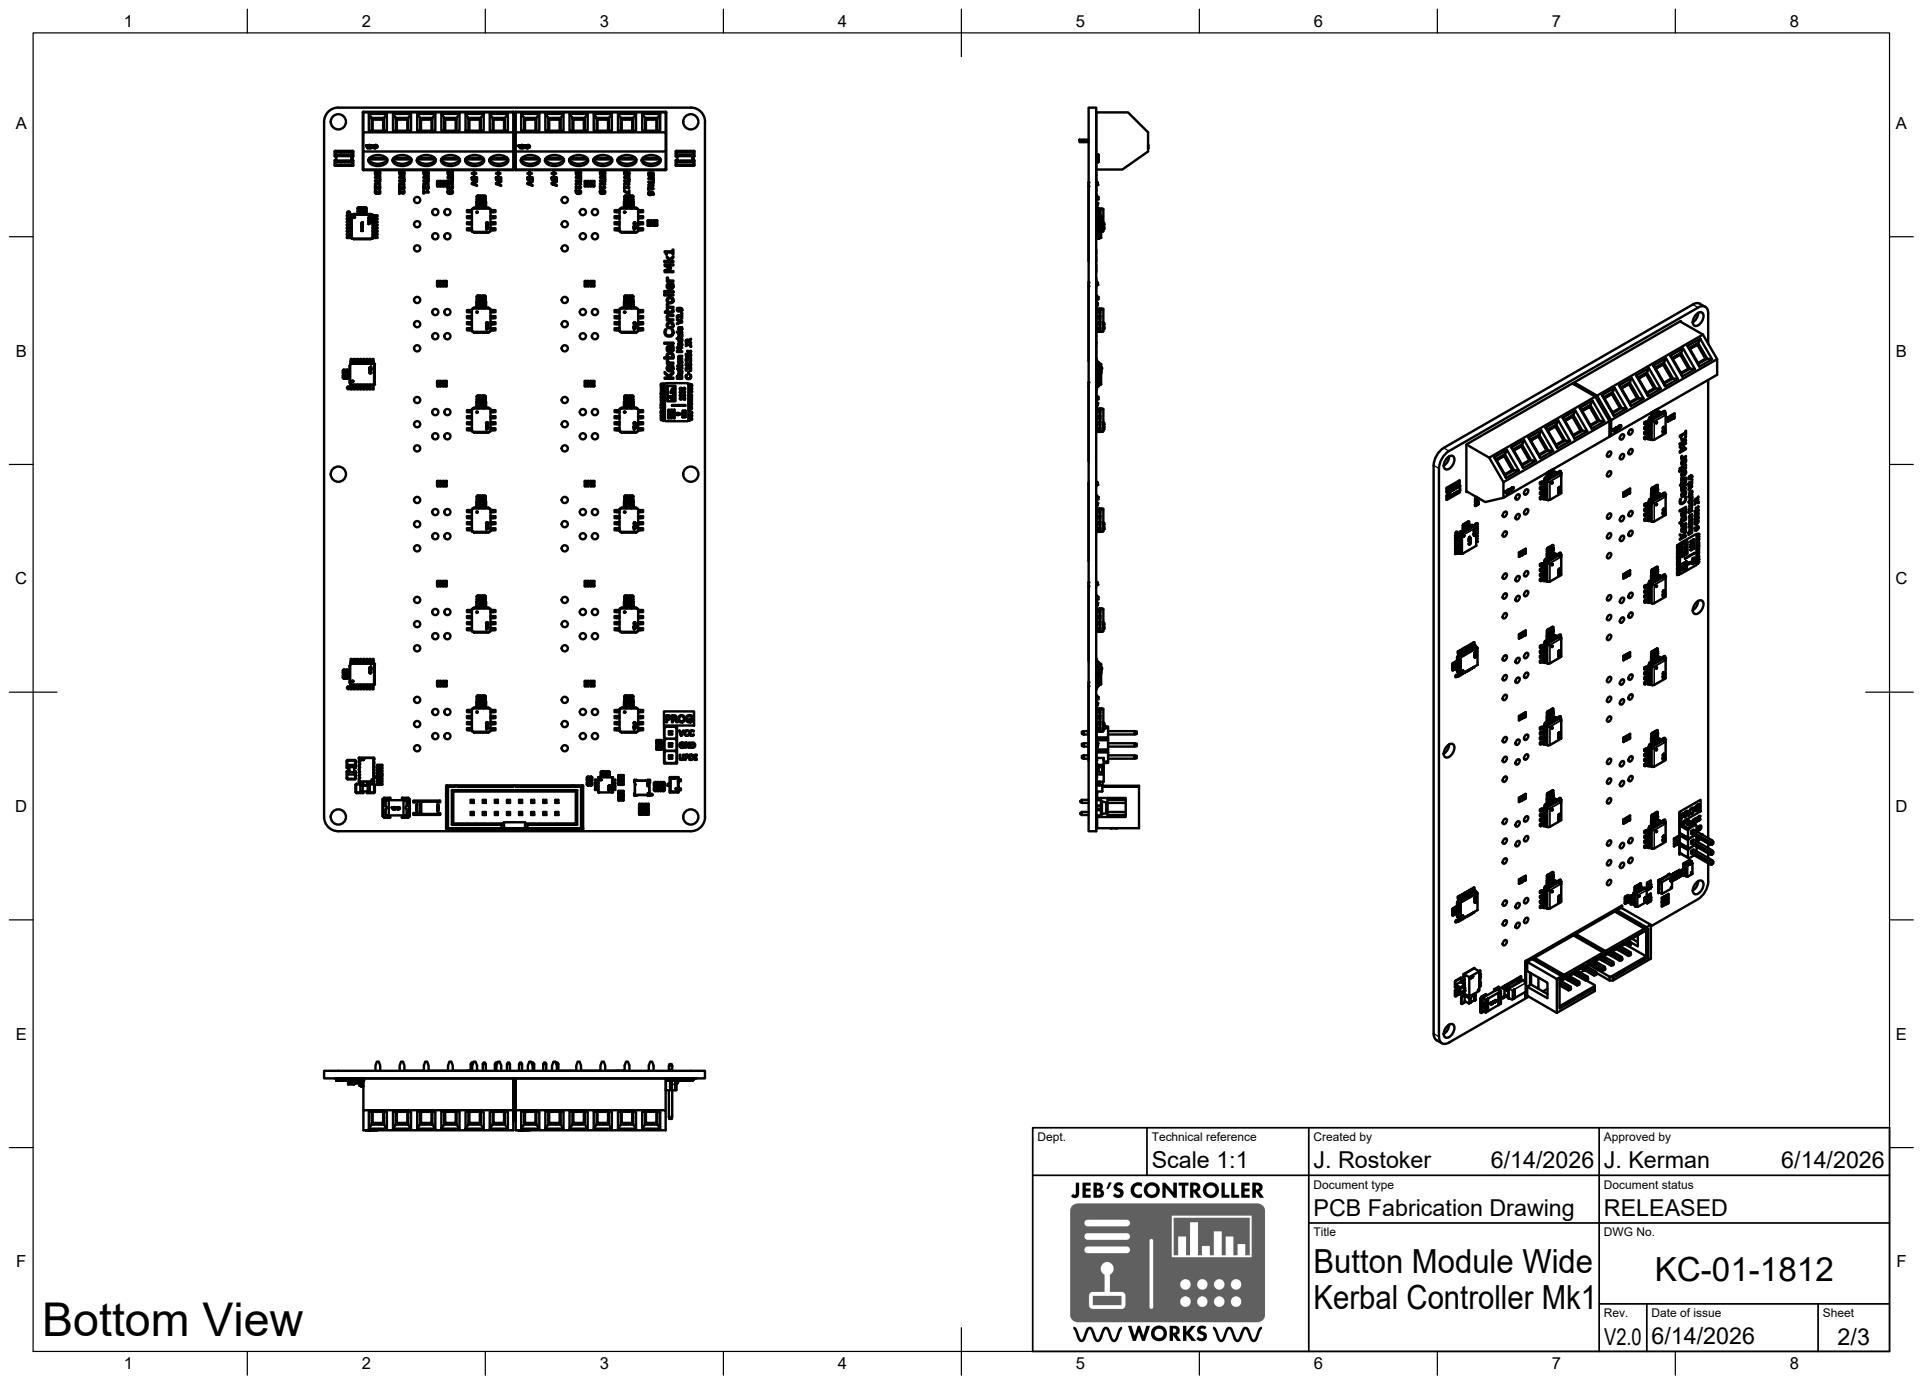
[picture p212: page 2]
Dept.; Technical reference; Created by; Approved by; Document type; Document status; Title; DWG No.; PCB Fabrication Drawing; RELEASED; Button Module Wide; Scale 1:1; J. Rostoker; J. Kerman; Bottom View

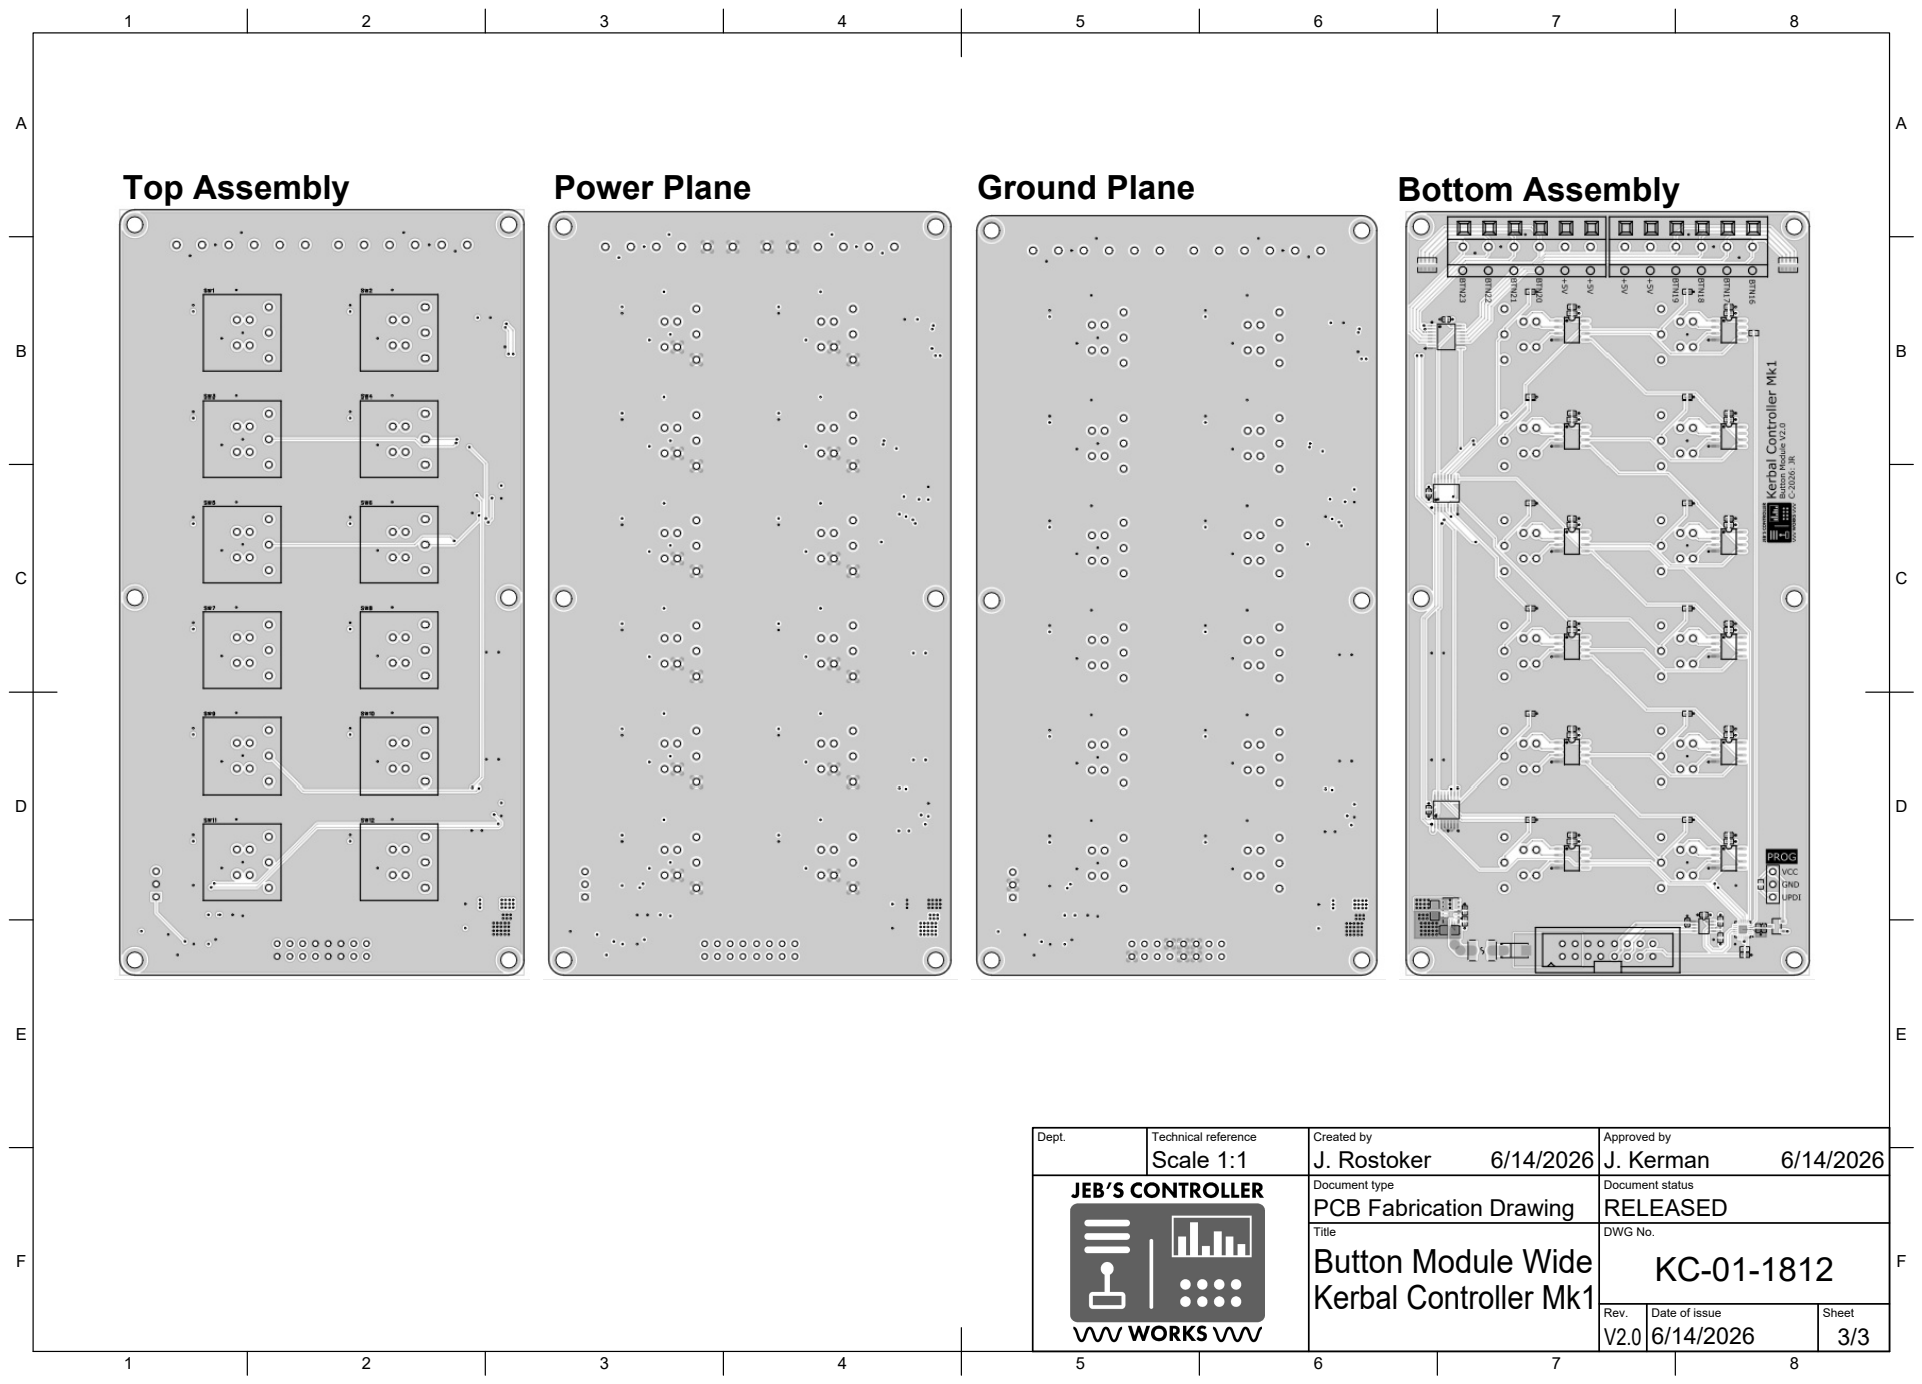
[picture p213: page 3]
Title; DWG No.; Button Module Wide; Top Assembly; Power Plane; Ground Plane; Bottom Assembly

Dept. | Technical reference Scale 1:1 | Created by J. Rostoker 6/14/2026 | Approved by J. Kerman 6/14/2026

Document type PCB Fabrication Drawing | Document status RELEASED
