bigJRo/KerbalControllerMk1/Documents/Drawings/KC-01-1830_RevA_Joystick Module Complete.pdf

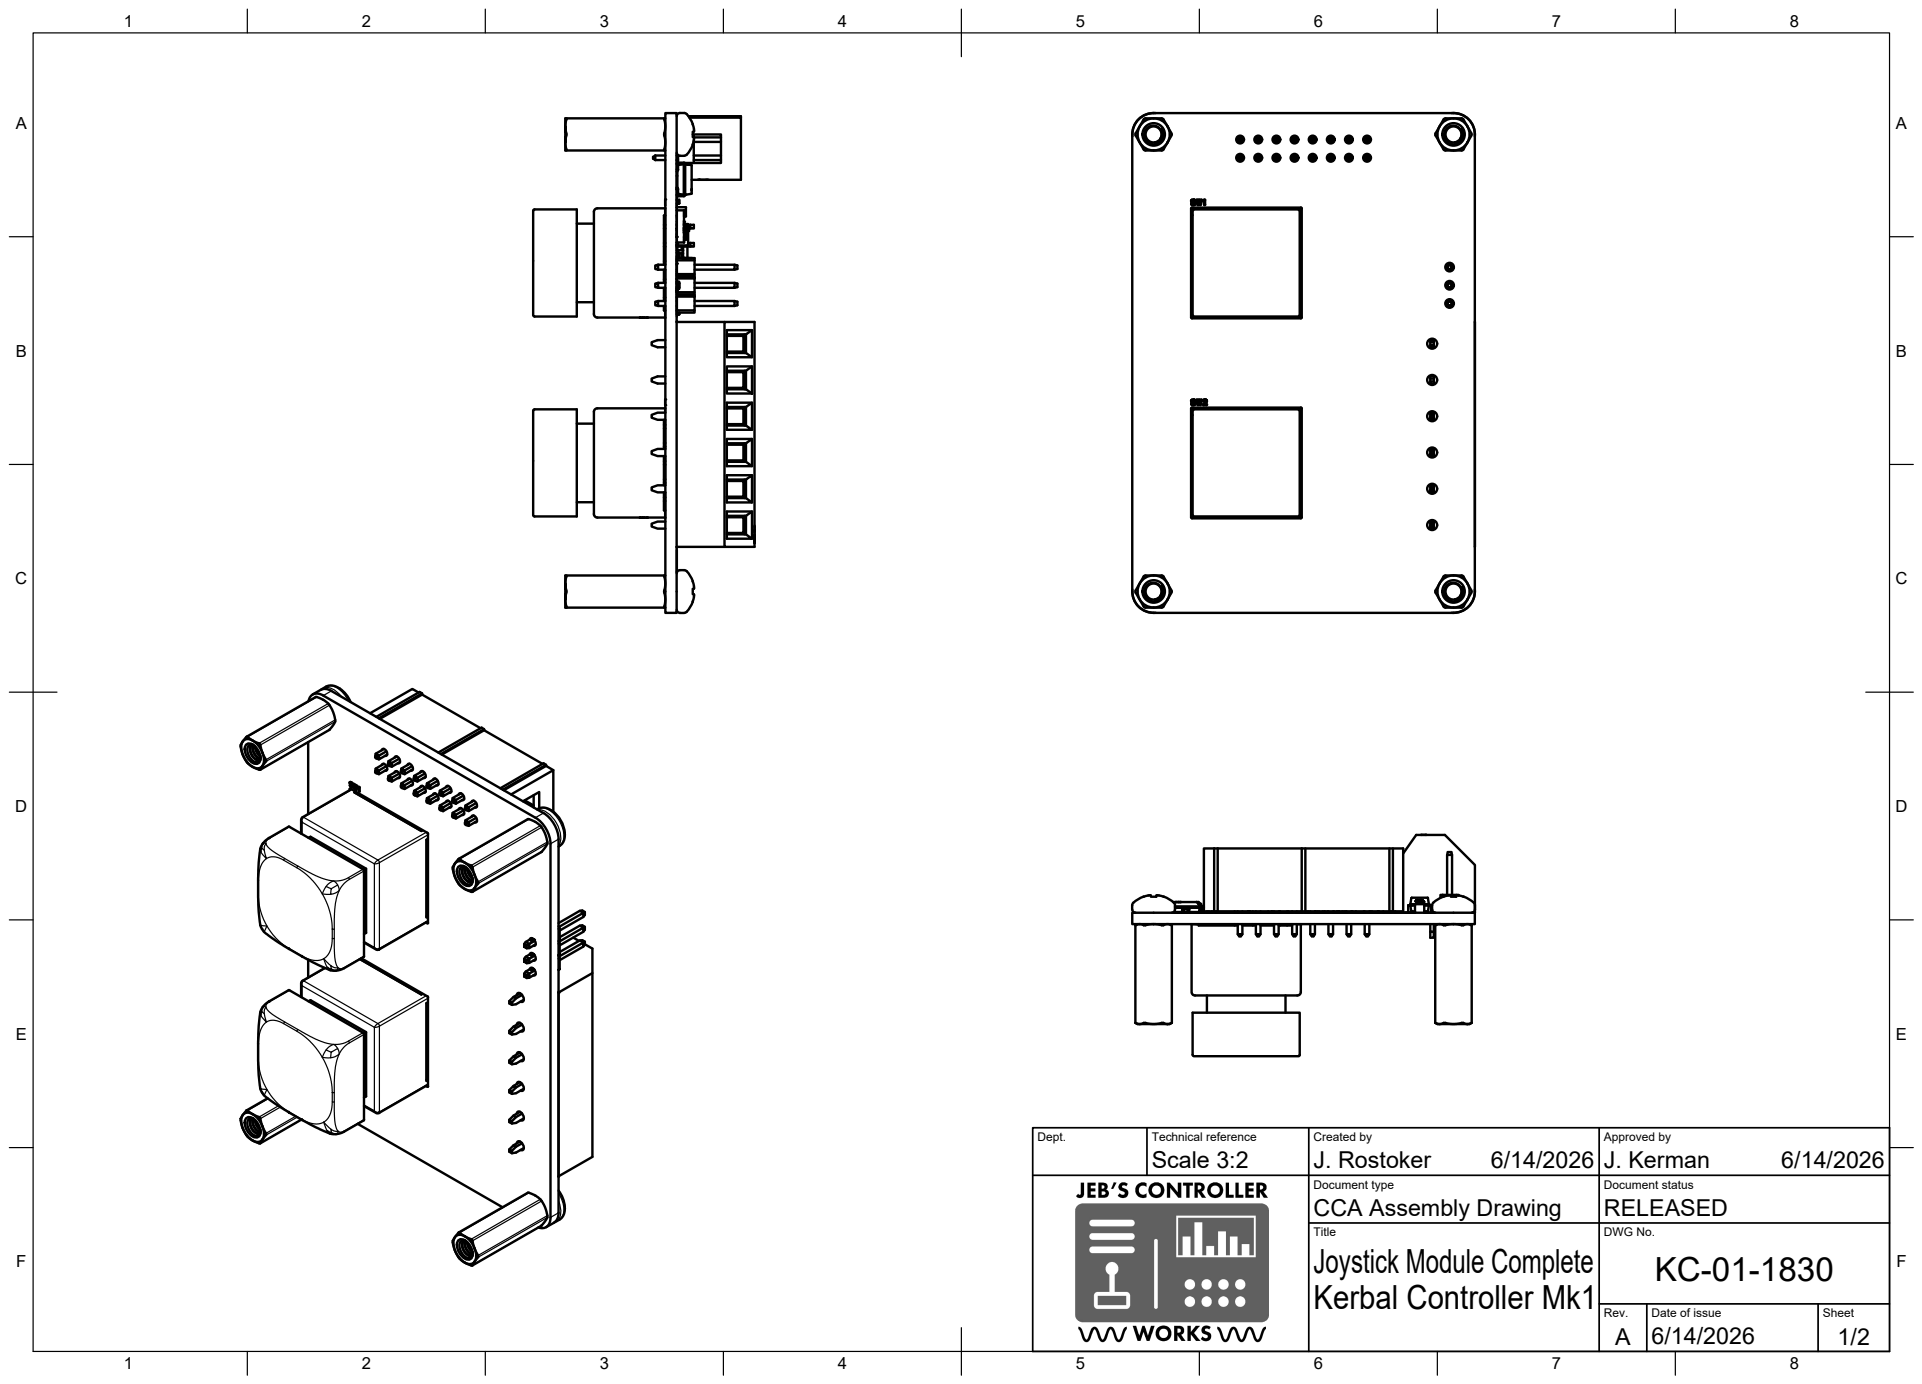
[picture p214: page 1]
Title; DWG No.; Rev.; Date of issue; Sheet; Kerbal Controller Mk1; Joystick Module Complete

Dept. | Technical reference Scale 3:2 | Created by J. Rostoker 6/14/2026 | Approved by J. Kerman 6/14/2026

Document type CCA Assembly Drawing | Document status RELEASED

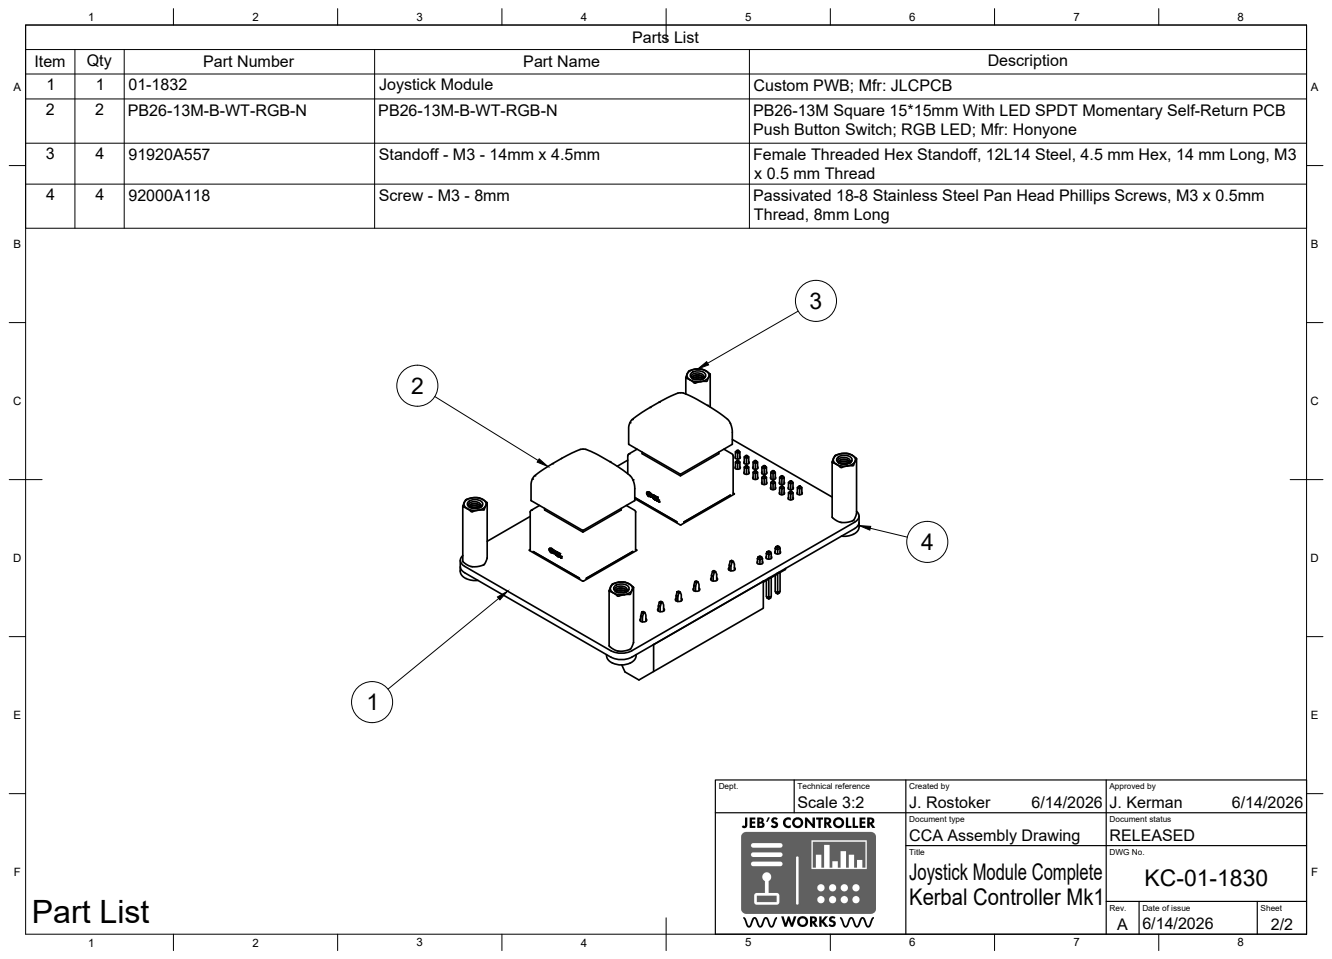
[picture p215: page 2]
Part List

Parts List

Item | Qty | Part Number | Part Name | Description
1 | 1 | 01-1832 | Joystick Module | Custom PWB; Mfr: JLCPCB
2 | 2 | PB26-13M-B-WT-RGB-N | PB26-13M-B-WT-RGB-N | PB26-13M Square 15*15mm With LED SPDT Momentary Self-Return PCB Push Button Switch; RGB LED; Mfr: Honyone

3 | 4 | 91920A557 | Standoff - M3 - 14mm x 4.5mm | Female Threaded Hex Standoff, 12L14 Steel, 4.5 mm Hex, 14 mm Long, M3 x 0.5 mm Thread

4 | 4 | 92000A118 | Screw - M3 - 8mm | Passivated 18-8 Stainless Steel Pan Head Phillips Screws, M3 x 0.5mm Thread, 8mm Long

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

Document type CCA Assembly Drawing | Document status RELEASED

Title Joystick Module Complete Kerbal Controller Mk1 | DWG No. KC-01-1830

Rev. A | Date of issue 6/14/2026 | Sheet 2/2
