bigJRo/KerbalControllerMk1/Documents/Drawings/KC-01-1831_V2.0_Joystick Module_SCH.pdf

## Panel Control Connector

# Power Input

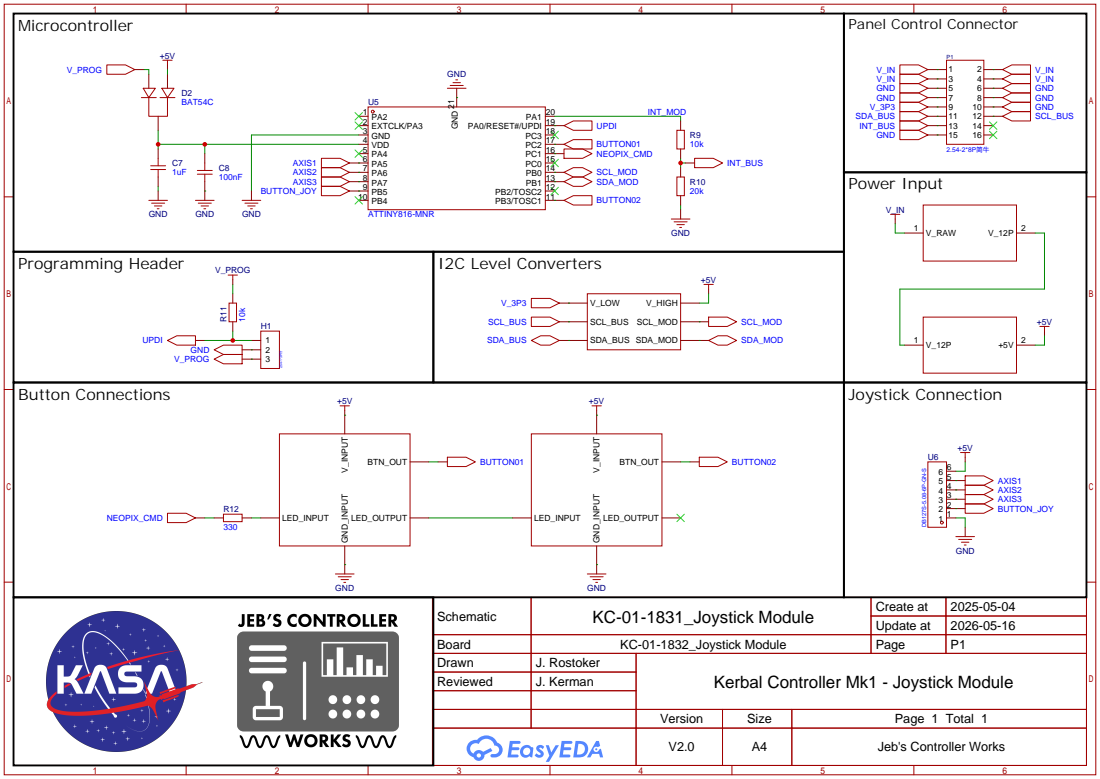
[picture p216: page 1]

Schematic | KC-01-1831_Joystick Module | Create at | 2025-05-04

Update at | 2026-05-16

Board | KC-01-1832_Joystick Module | Page | P1
Drawn | J. Rostoker | Kerbal Controller Mk1 - Joystick Module
Reviewed | J. Kerman

Version | Size | Page 1 Total 1
V2.0 | A4 | Jeb's Controller Works

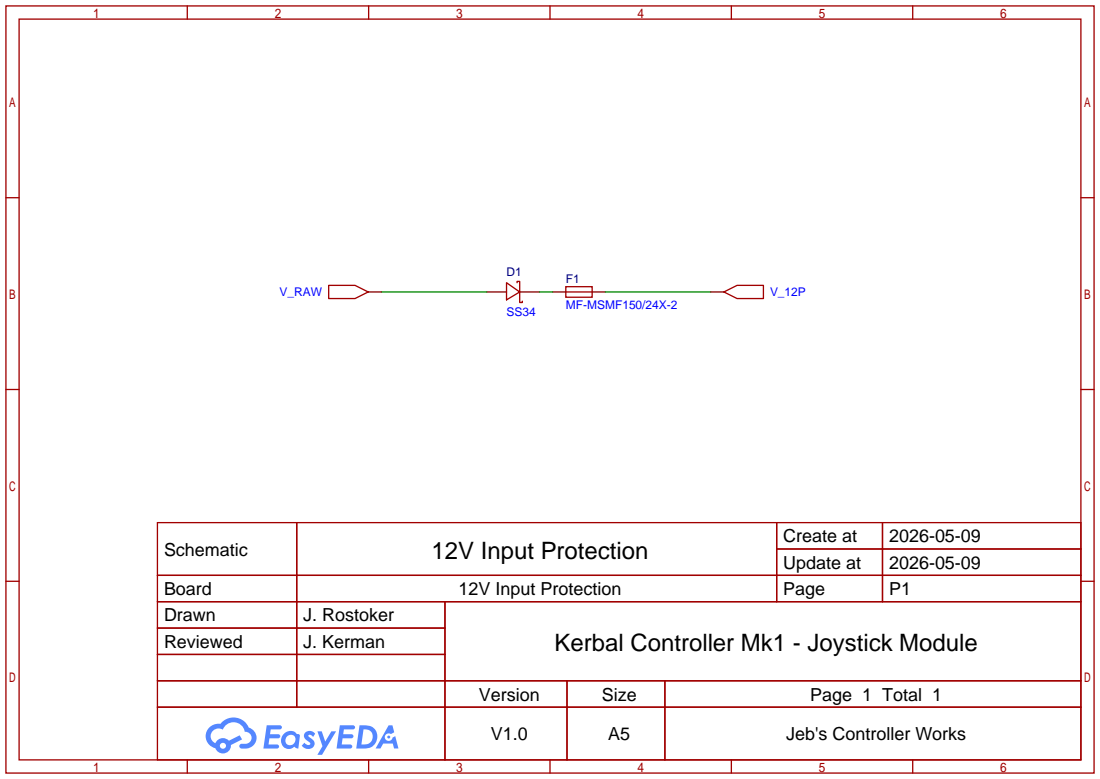
[picture p217: page 2]

Schematic | 12V Input Protection | Create at | 2026-05-09

Update at | 2026-05-09

Board | 12V Input Protection | Page | P1
Drawn | J. Rostoker | Kerbal Controller Mk1 - Joystick Module
Reviewed | J. Kerman

Version | Size | Page 1 Total 1
V1.0 | A5 | Jeb's Controller Works

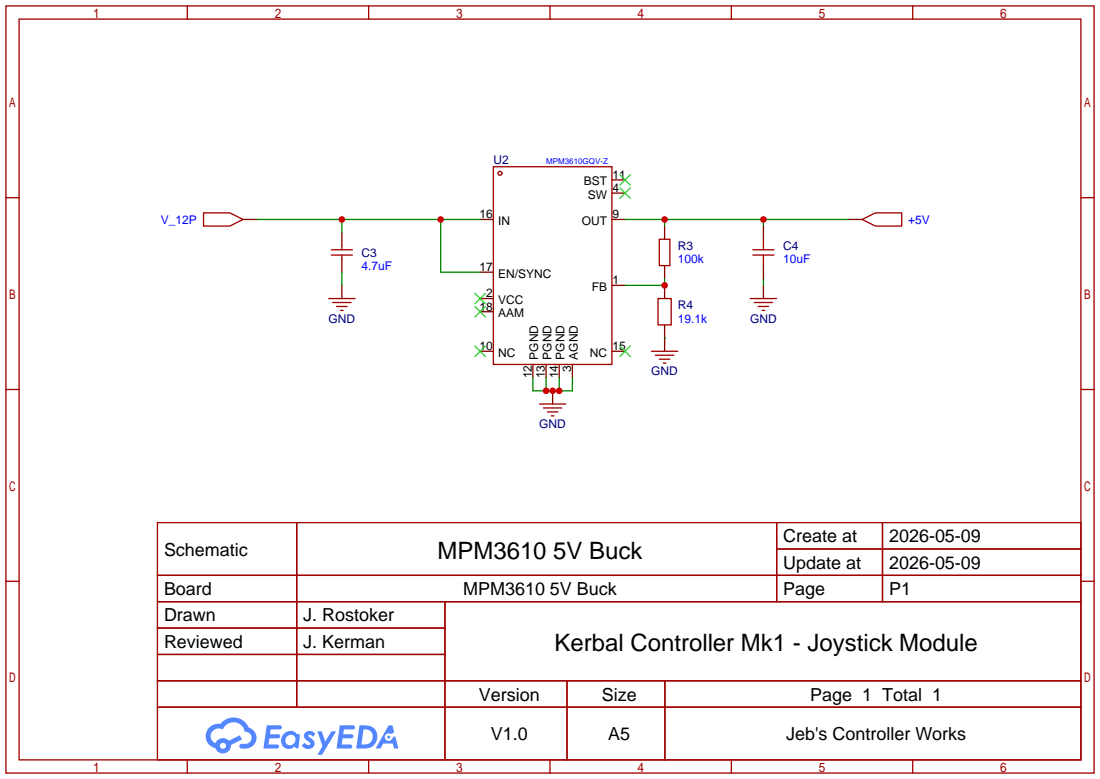
[picture p218: page 3]

Schematic | MPM3610 5V Buck | Create at | 2026-05-09

Update at | 2026-05-09

Board | MPM3610 5V Buck | Page | P1
Drawn | J. Rostoker | Kerbal Controller Mk1 - Joystick Module
Reviewed | J. Kerman

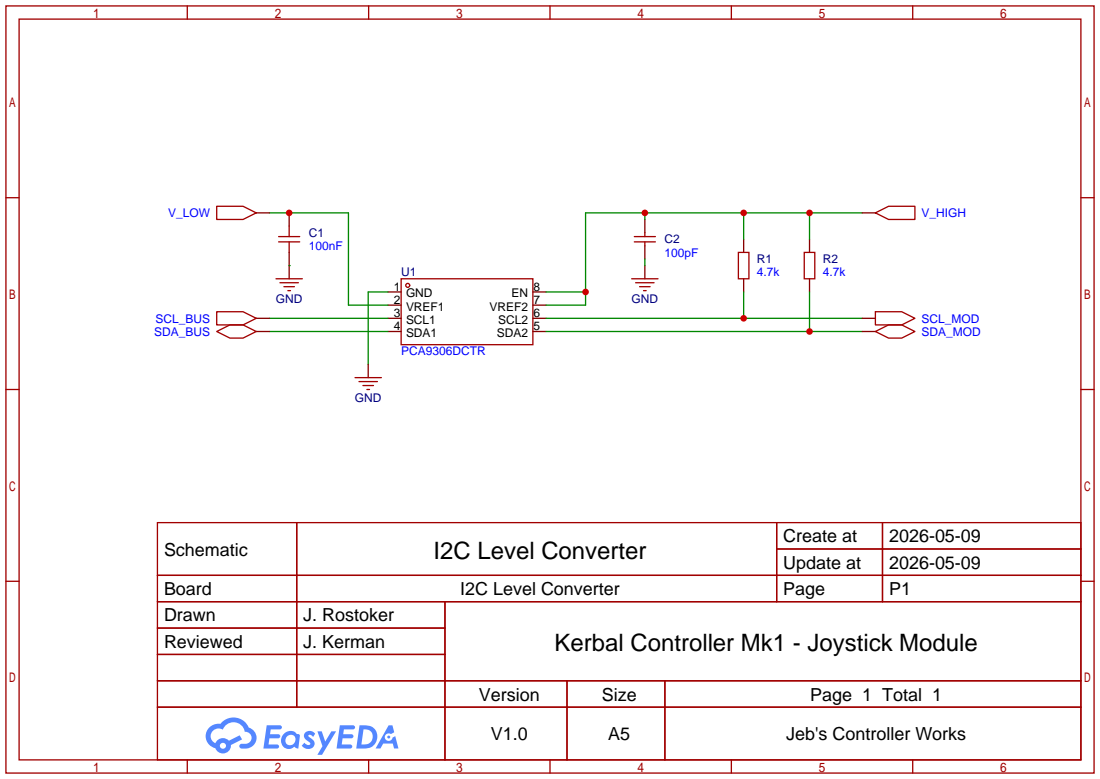
[picture p219: page 4]

Schematic | I2C Level Converter | Create at | 2026-05-09

Update at | 2026-05-09

Board | I2C Level Converter | Page | P1
Drawn | J. Rostoker | Kerbal Controller Mk1 - Joystick Module
Reviewed | J. Kerman

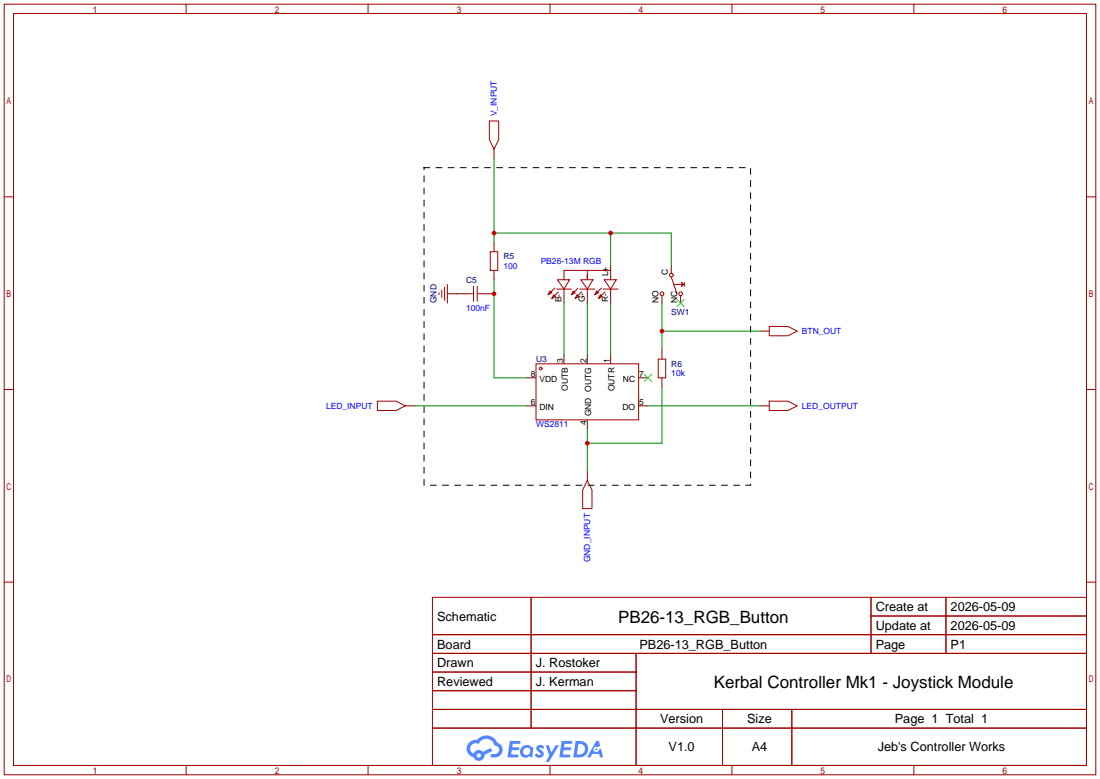
[picture p220: page 5]

Schematic | PB26-13_RGB_Button | Create at | 2026-05-09

Update at | 2026-05-09

Board | PB26-13_RGB_Button | Page | P1
Drawn | J. Rostoker | Kerbal Controller Mk1 - Joystick Module
Reviewed | J. Kerman

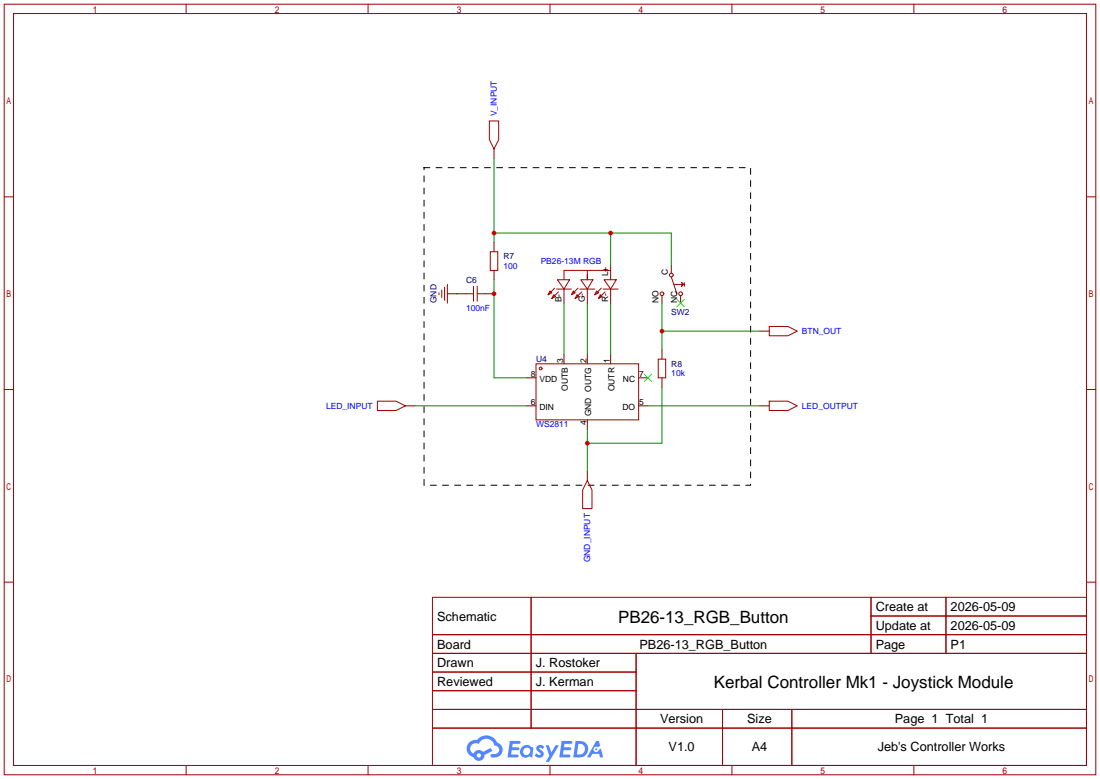
[picture p221: page 6]

Schematic | PB26-13_RGB_Button | Create at | 2026-05-09

Update at | 2026-05-09

Board | PB26-13_RGB_Button | Page | P1
Drawn | J. Rostoker | Kerbal Controller Mk1 - Joystick Module
Reviewed | J. Kerman
