bigJRo/KerbalControllerMk1/Documents/Drawings/KC-01-1832_V2.0_Joystick Module_PWB.pdf

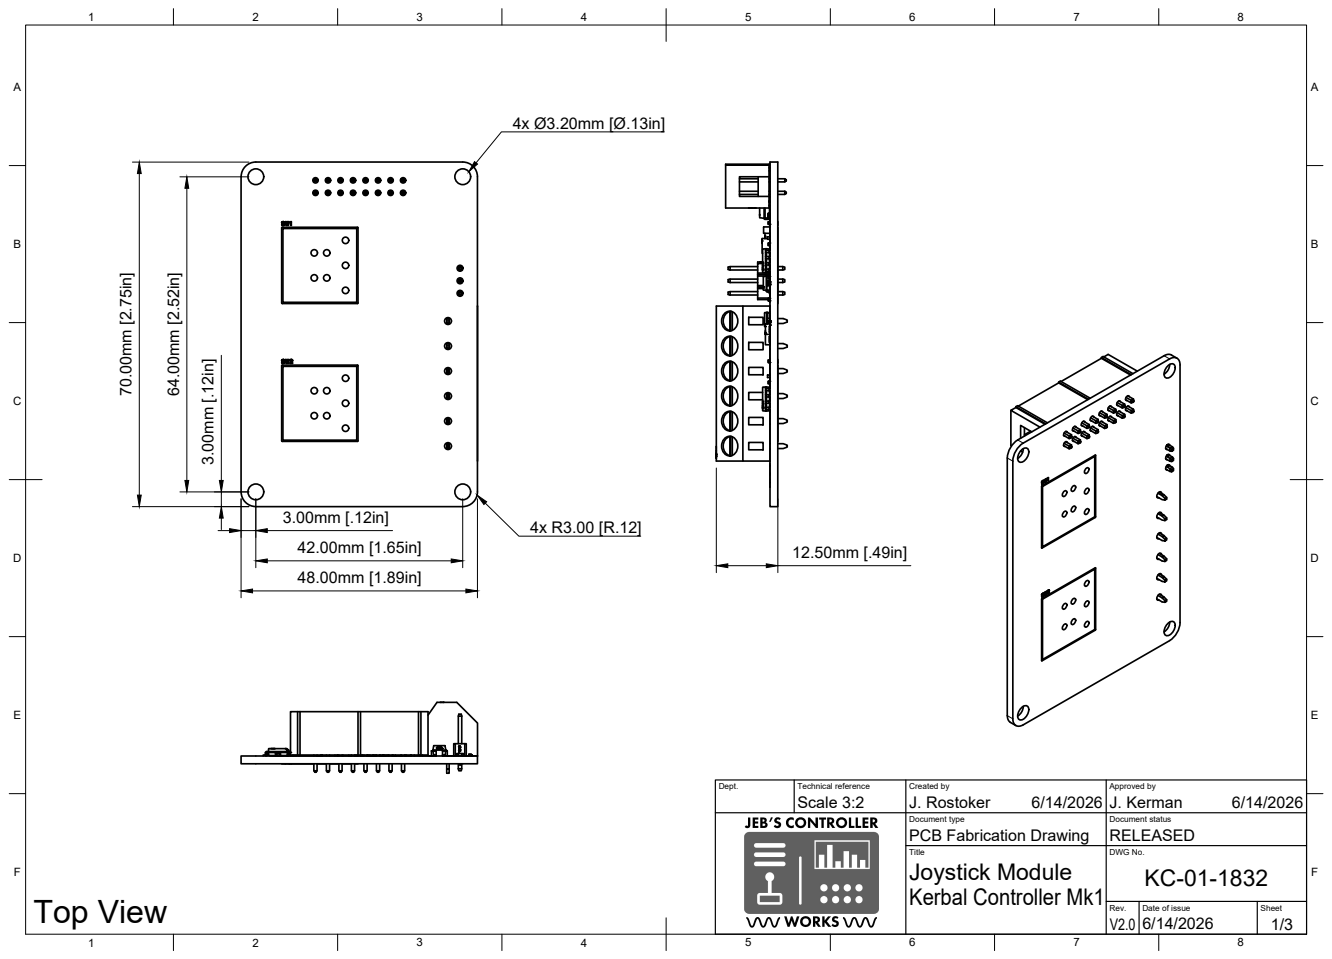
[picture p222: page 1]
Title; DWG No.; Rev.; Date of issue; Sheet; Kerbal Controller Mk1; Joystick Module; Top View

Dept. | Technical reference Scale 3:2 | Created by J. Rostoker 6/14/2026 | Approved by J. Kerman 6/14/2026

Document type PCB Fabrication Drawing | Document status RELEASED

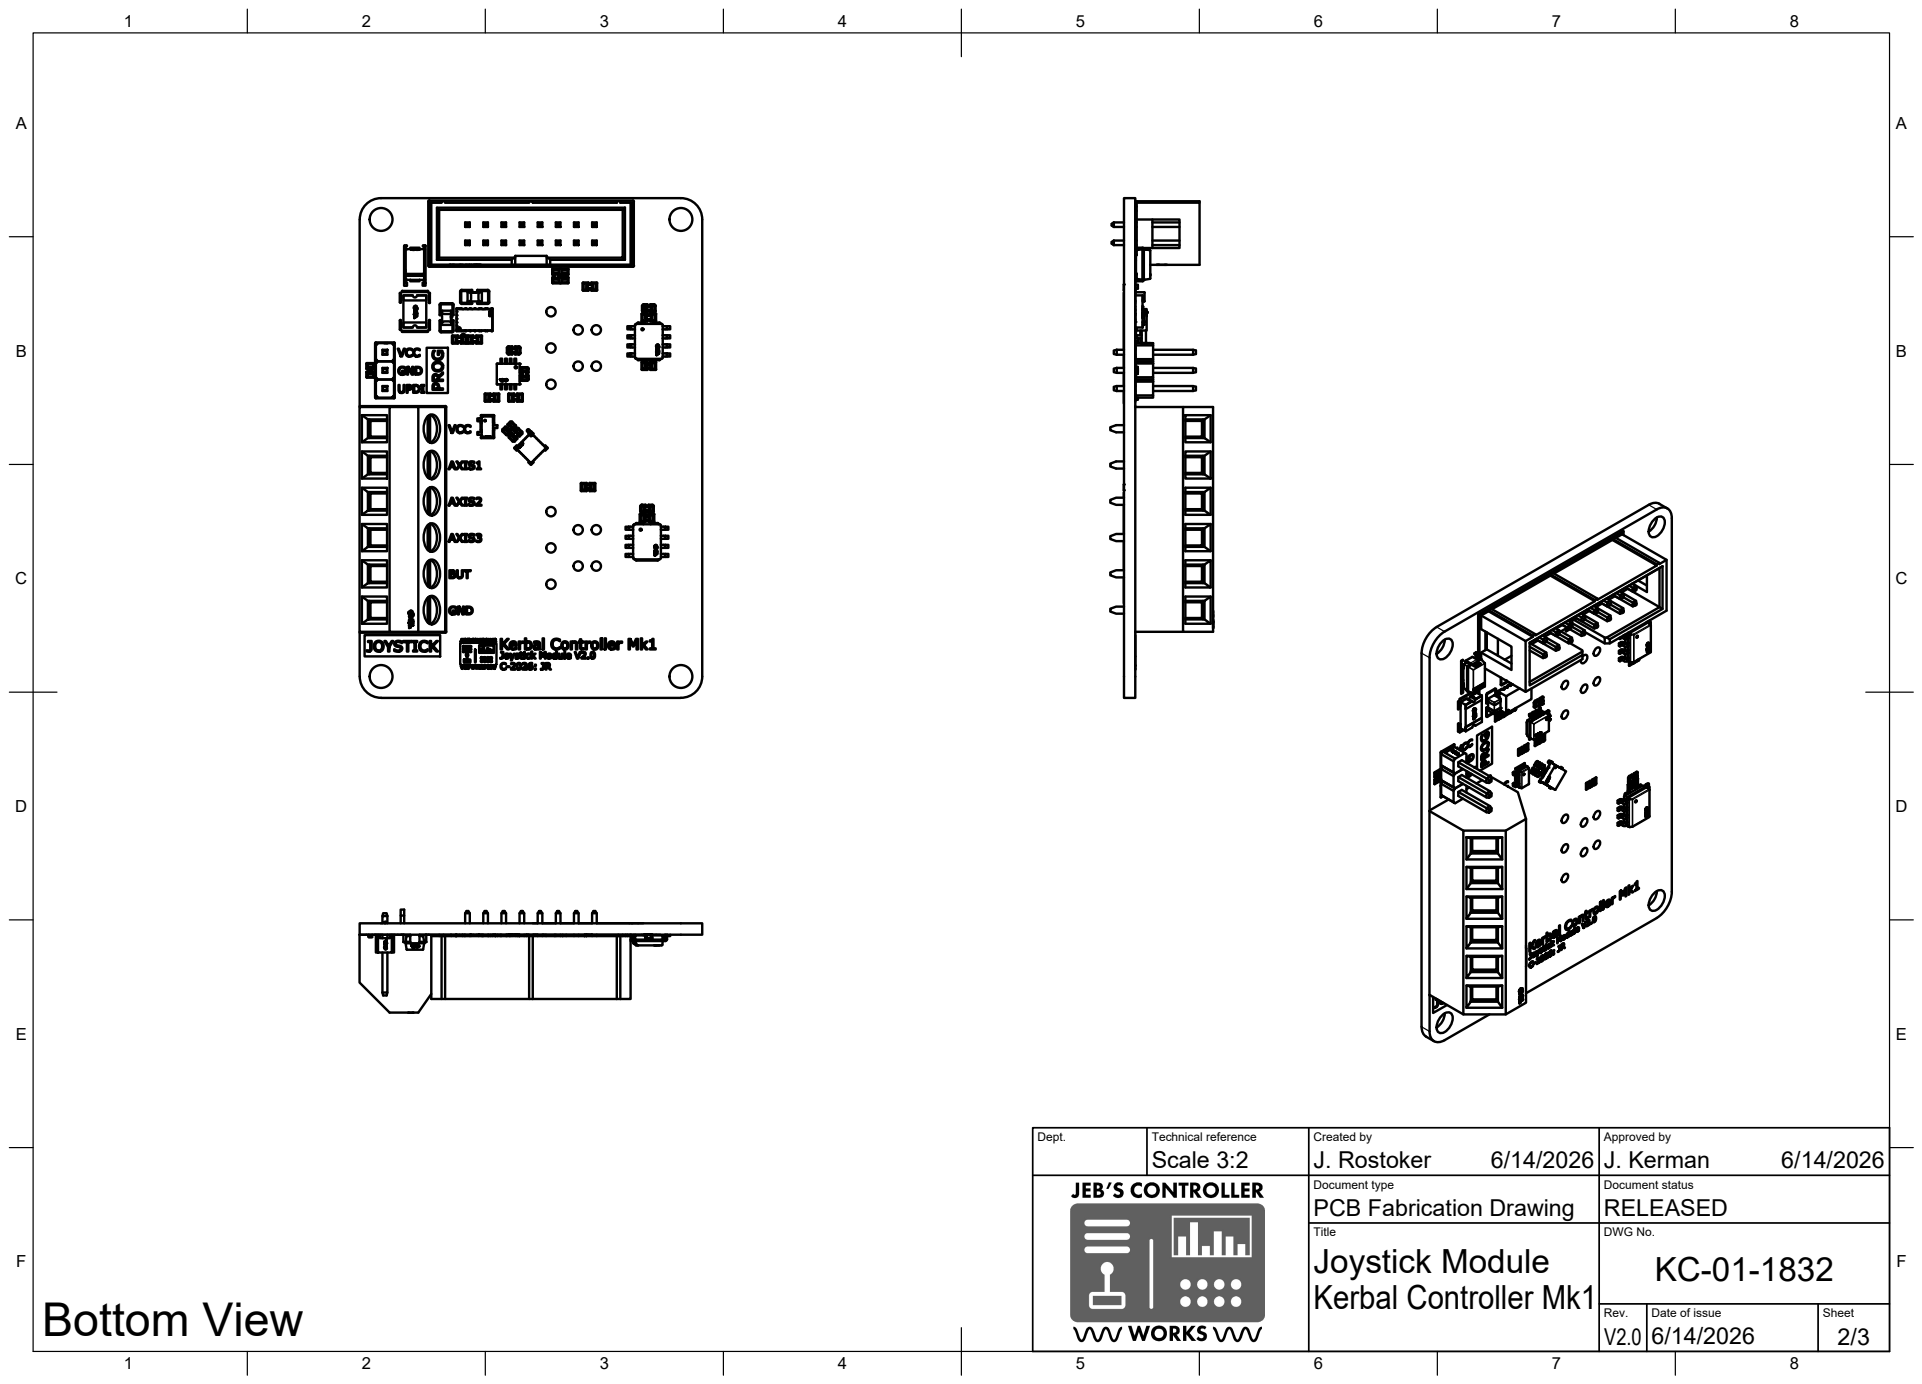
[picture p223: page 2]
Dept.; Technical reference; Created by; Approved by; Document type; Document status; Title; DWG No.; PCB Fabrication Drawing; RELEASED; Joystick Module; Scale 3:2; J. Rostoker; J. Kerman; Bottom View

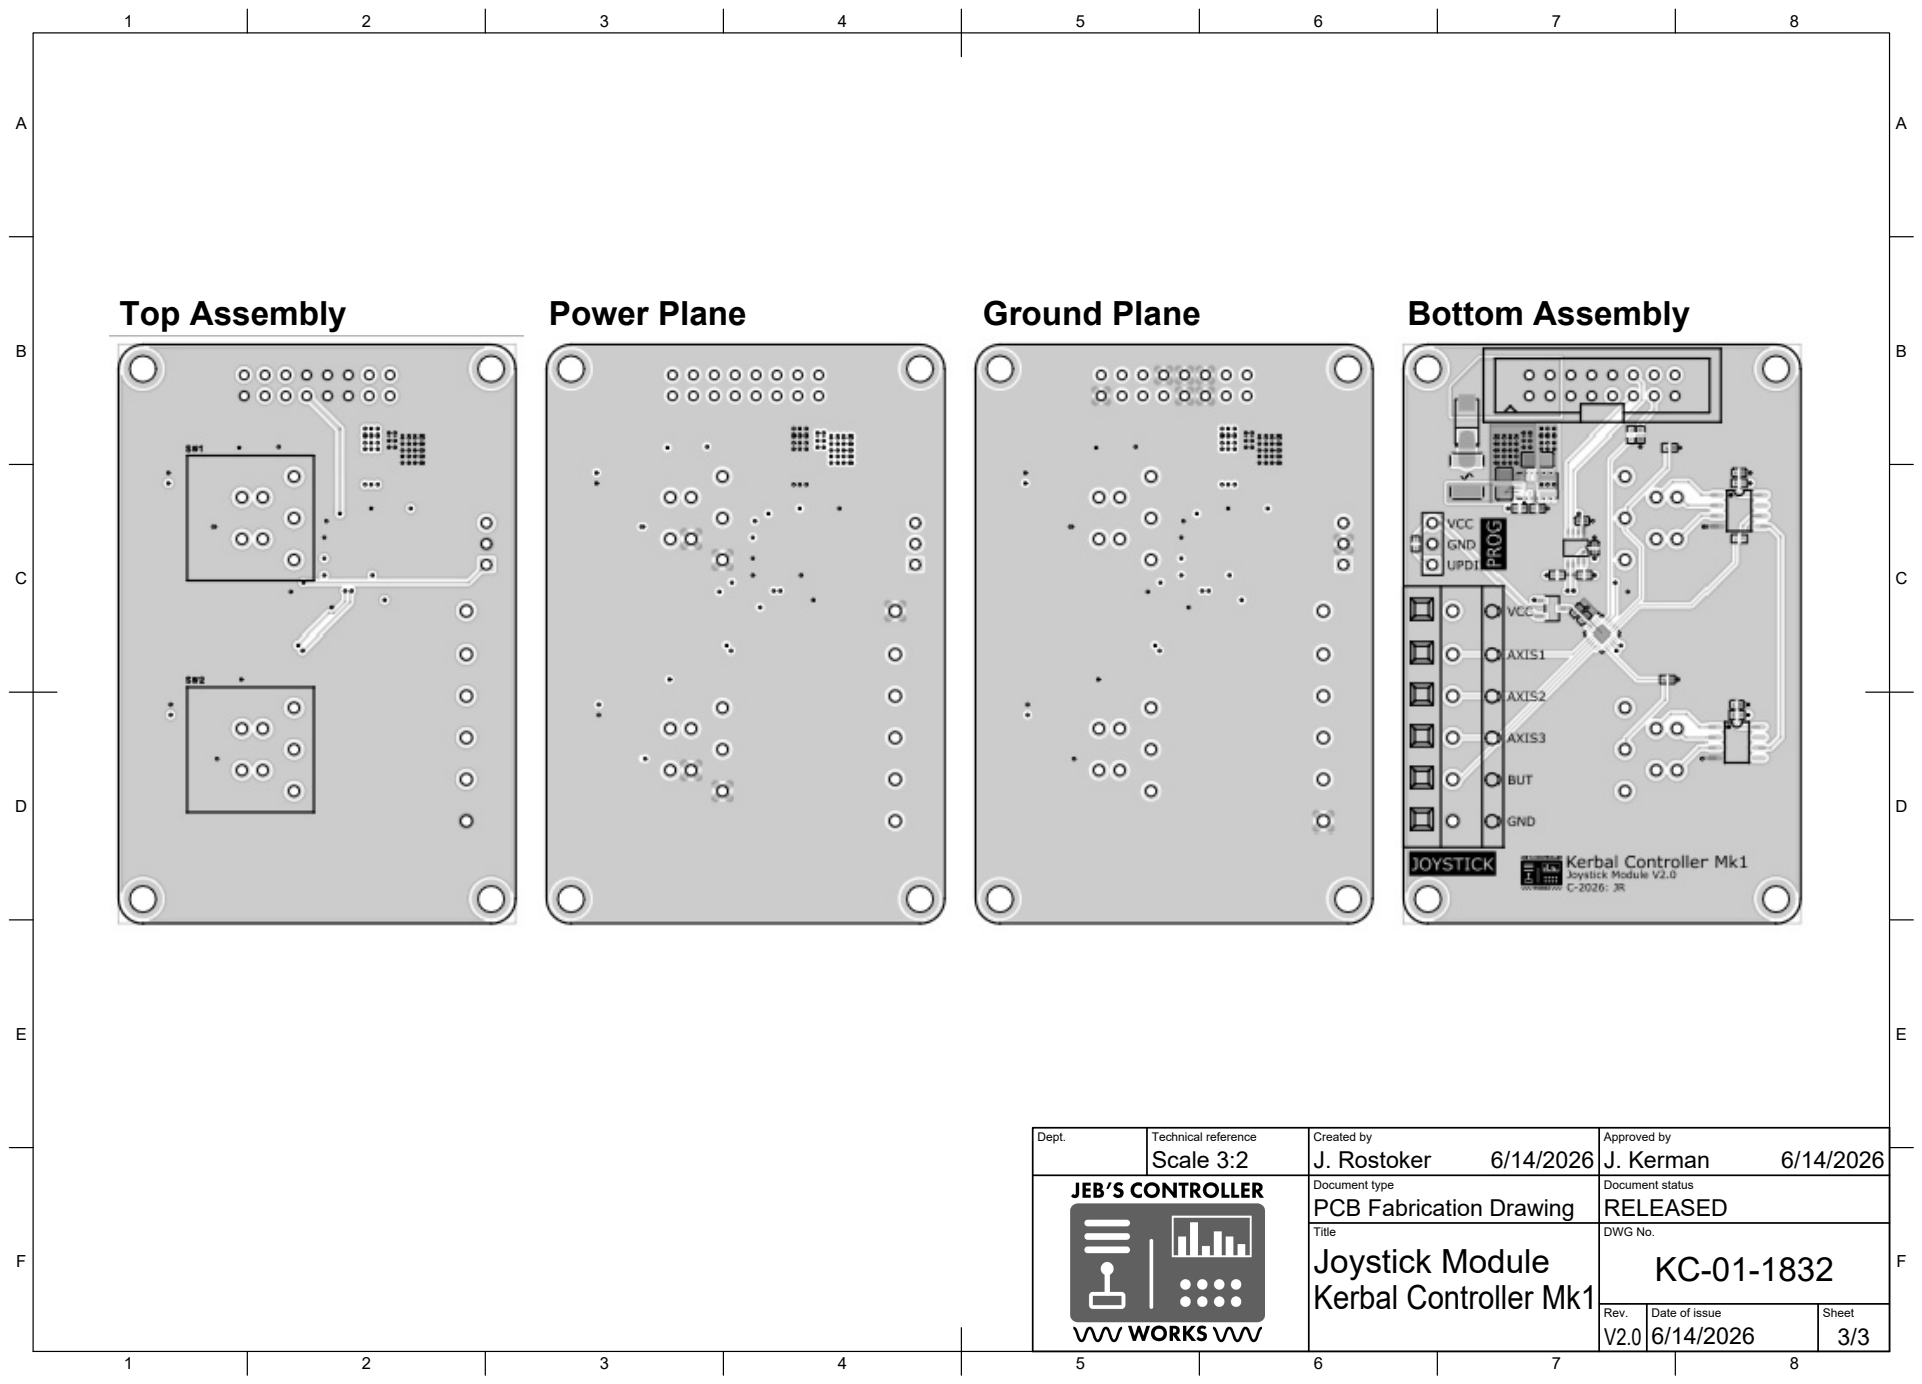
[picture p224: page 3]
Title; DWG No.; Joystick Module; Top Assembly; Power Plane; Ground Plane; Bottom Assembly

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

Document type PCB Fabrication Drawing | Document status RELEASED
