bigJRo/KerbalControllerMk1/Documents/Drawings/KC-01-1840_RevA_7-Segment Display Module Complete.pdf

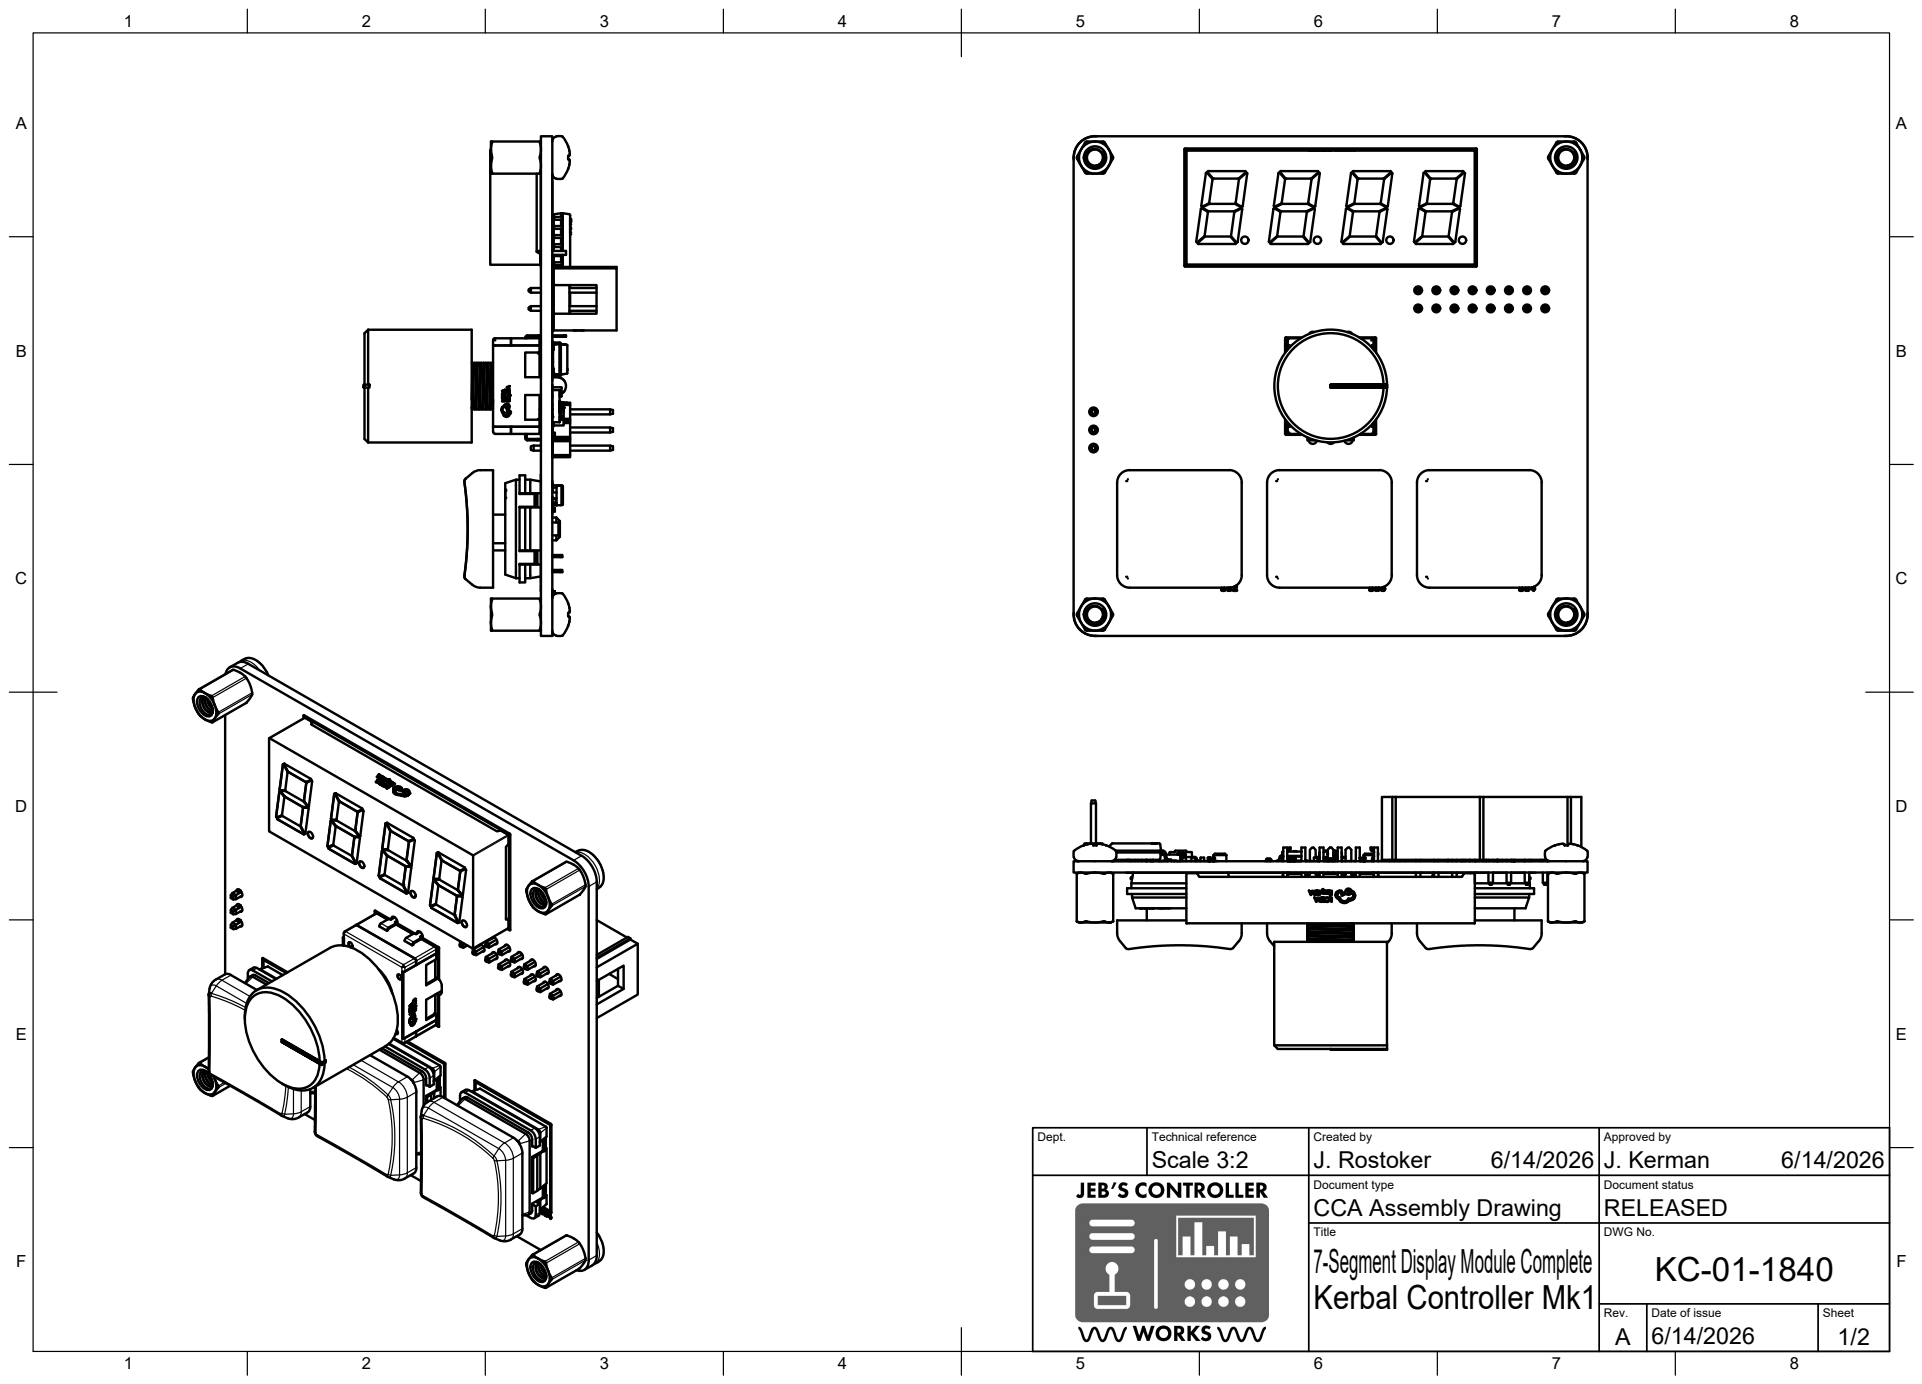
[picture p225: page 1]
Dept.; Technical reference; Created by; Approved by; Document type; Document status; Title; DWG No.; Rev.; Date of issue; Sheet; CCA Assembly Drawing; RELEASED; Kerbal Controller Mk1; 7-Segment Display Module Complete; Scale 3:2; J. Rostoker; J. Kerman

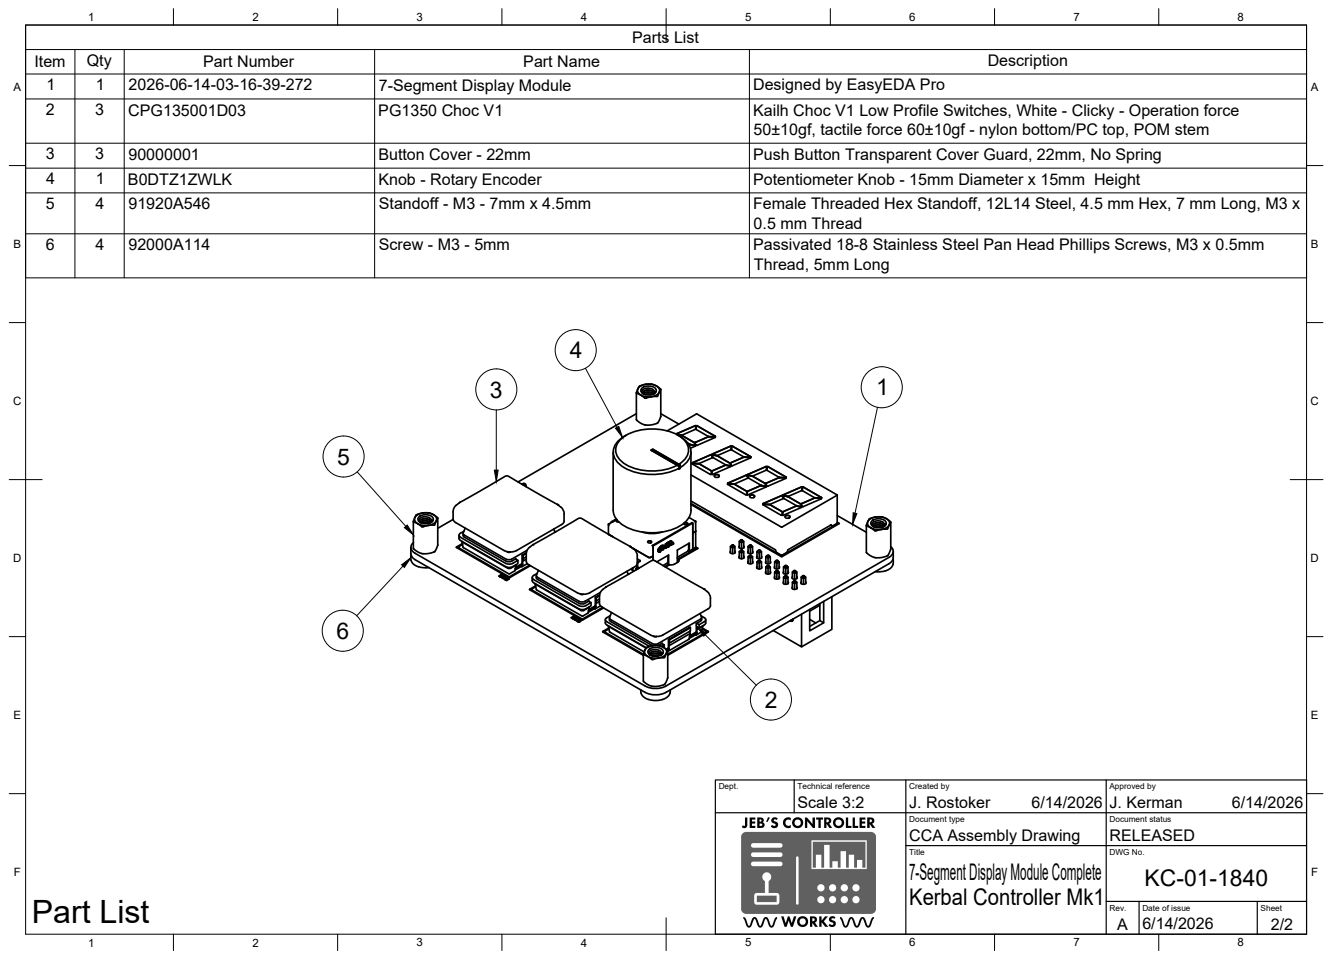
[picture p226: page 2]
Part List

Parts List

Item | Qty | Part Number | Part Name | Description
1 | 1 | 2026-06-14-03-16-39-272 | 7-Segment Display Module | Designed by EasyEDA Pro
2 | 3 | CPG135001D03 | PG1350 Choc V1 | Kailh Choc V1 Low Profile Switches, White - Clicky - Operation force 50±10gf, tactile force 60±10gf - nylon bottom/PC top, POM stem

3 | 3 | 90000001 | Button Cover - 22mm | Push Button Transparent Cover Guard, 22mm, No Spring
4 | 1 | B0DTZ1ZWLK | Knob - Rotary Encoder | Potentiometer Knob - 15mm Diameter x 15mm Height
5 | 4 | 91920A546 | Standoff - M3 - 7mm x 4.5mm | Female Threaded Hex Standoff, 12L14 Steel, 4.5 mm Hex, 7 mm Long, M3 x 0.5 mm Thread

6 | 4 | 92000A114 | Screw - M3 - 5mm | Passivated 18-8 Stainless Steel Pan Head Phillips Screws, M3 x 0.5mm Thread, 5mm Long

Dept. | Technical reference Scale 3:2 | Created by J. Rostoker 6/14/2026 | Approved by J. Kerman 6/14/2026

Document type CCA Assembly Drawing | Document status RELEASED

Title 7-Segment Display Module Complete Kerbal Controller Mk1 | DWG No. KC-01-1840

Rev. A | Date of issue 6/14/2026 | Sheet 2/2
