bigJRo/KerbalControllerMk1/Documents/Drawings/KC-01-1841_V2.0_7-Segment Display Module_SCH.pdf

Microcontroller | Panel Control Connector

# Rotary Encoder

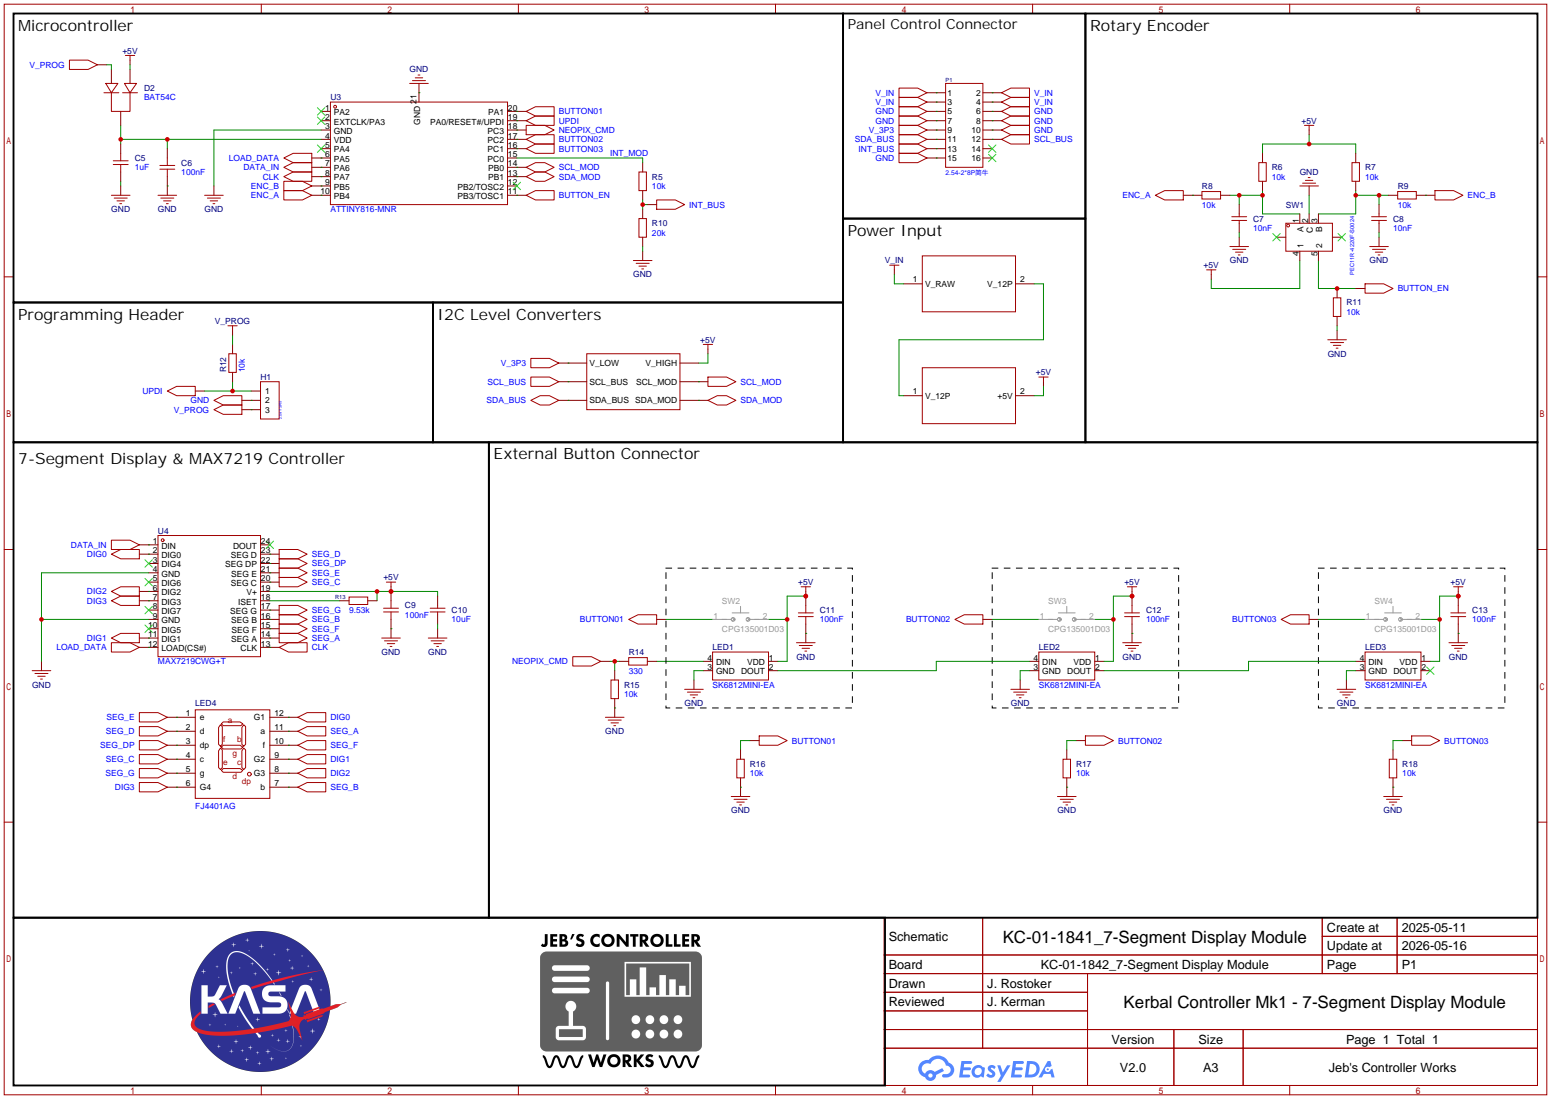
[picture p227: page 1]

Schematic | KC-01-1841_7-Segment Display Module | Create at | 2025-05-11

Update at | 2026-05-16

Board | KC-01-1842_7-Segment Display Module | Page | P1
Drawn | J. Rostoker | Kerbal Controller Mk1 - 7-Segment Display Module
Reviewed | J. Kerman

Version | Size | Page 1 Total 1
V2.0 | A3 | Jeb's Controller Works

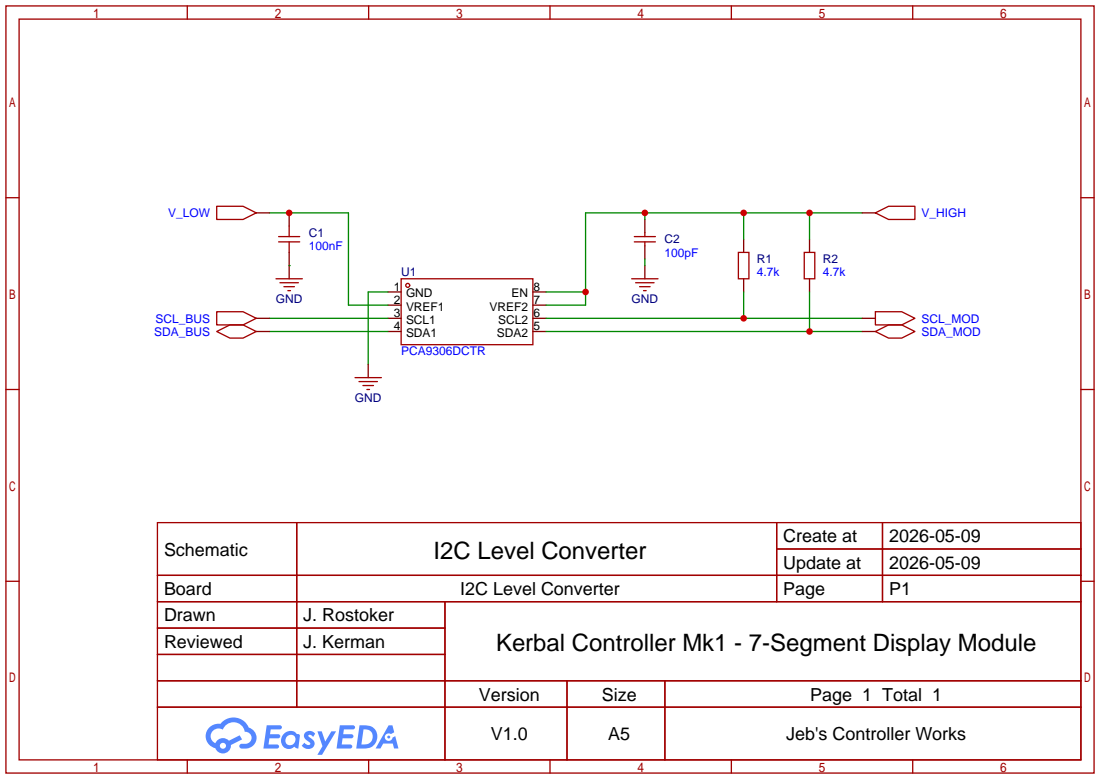
[picture p228: page 2]

Schematic | I2C Level Converter | Create at | 2026-05-09

Update at | 2026-05-09

Board | I2C Level Converter | Page | P1
Drawn | J. Rostoker | Kerbal Controller Mk1 - 7-Segment Display Module
Reviewed | J. Kerman

Version | Size | Page 1 Total 1
V1.0 | A5 | Jeb's Controller Works

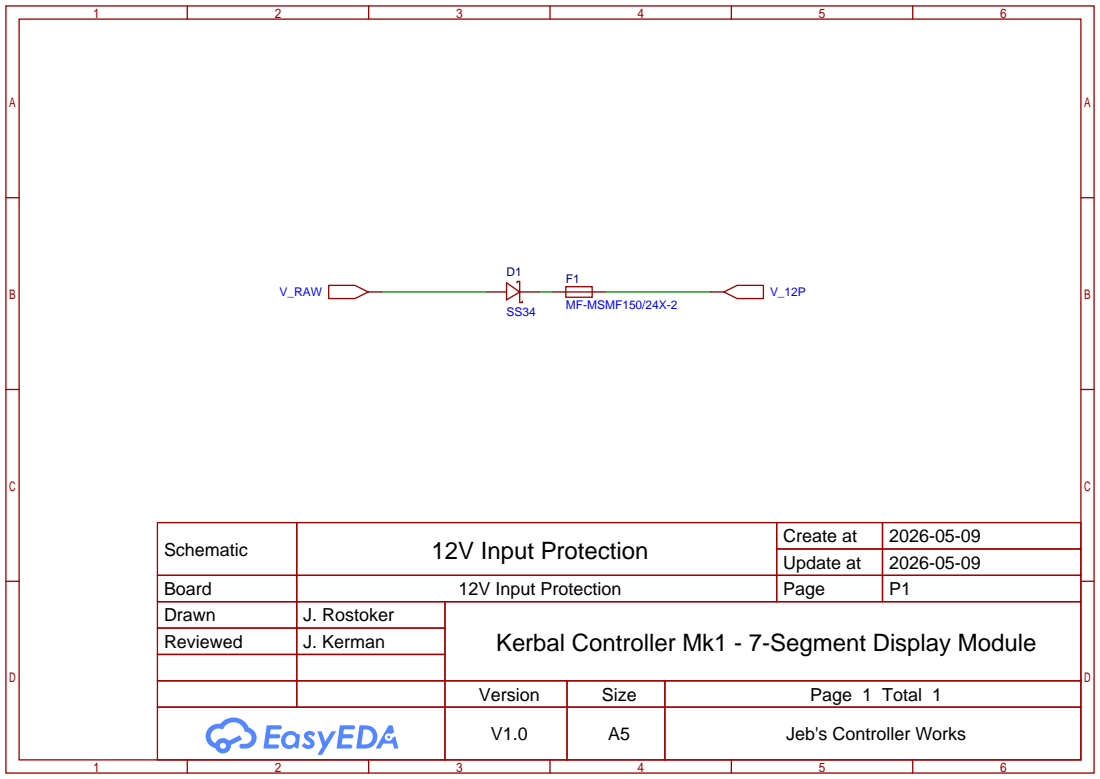
[picture p229: page 3]

Schematic | 12V Input Protection | Create at | 2026-05-09

Update at | 2026-05-09

Board | 12V Input Protection | Page | P1
Drawn | J. Rostoker | Kerbal Controller Mk1 - 7-Segment Display Module
Reviewed | J. Kerman

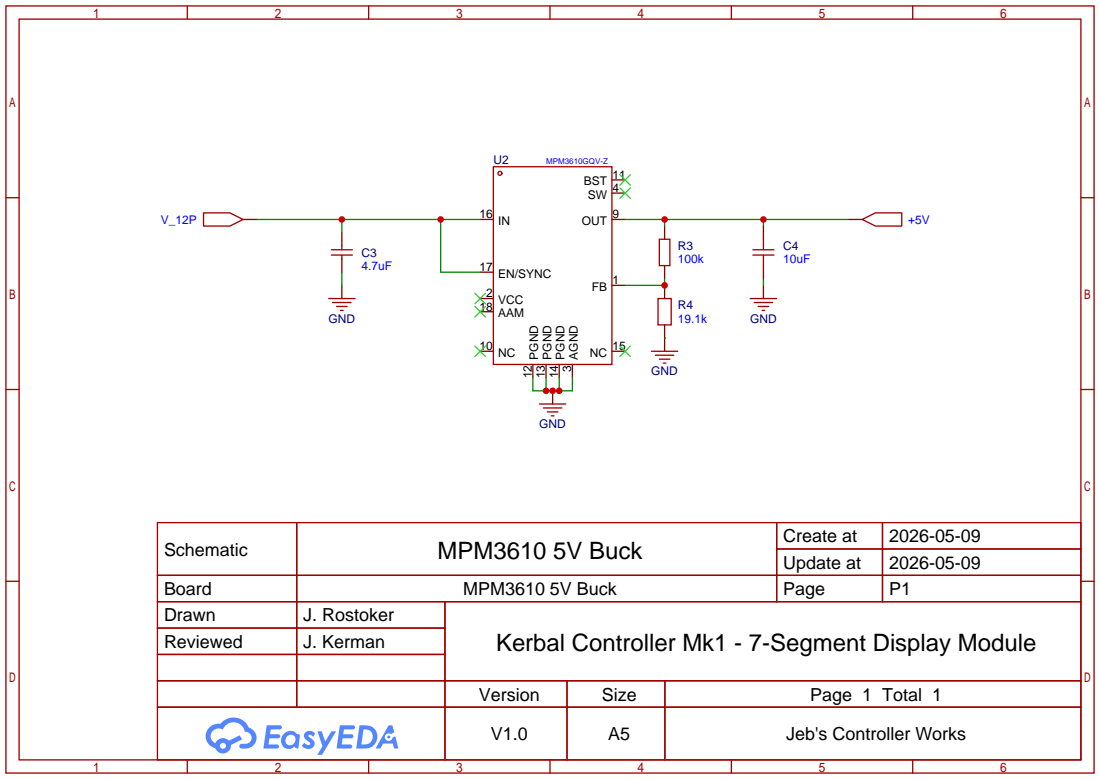
[picture p230: page 4]

Schematic | MPM3610 5V Buck | Create at | 2026-05-09

Update at | 2026-05-09

Board | MPM3610 5V Buck | Page | P1
Drawn | J. Rostoker | Kerbal Controller Mk1 - 7-Segment Display Module
Reviewed | J. Kerman
