bigJRo/KerbalControllerMk1/Documents/Drawings/KC-01-1842_V2.0_7-Segment Display Module_PCB.pdf

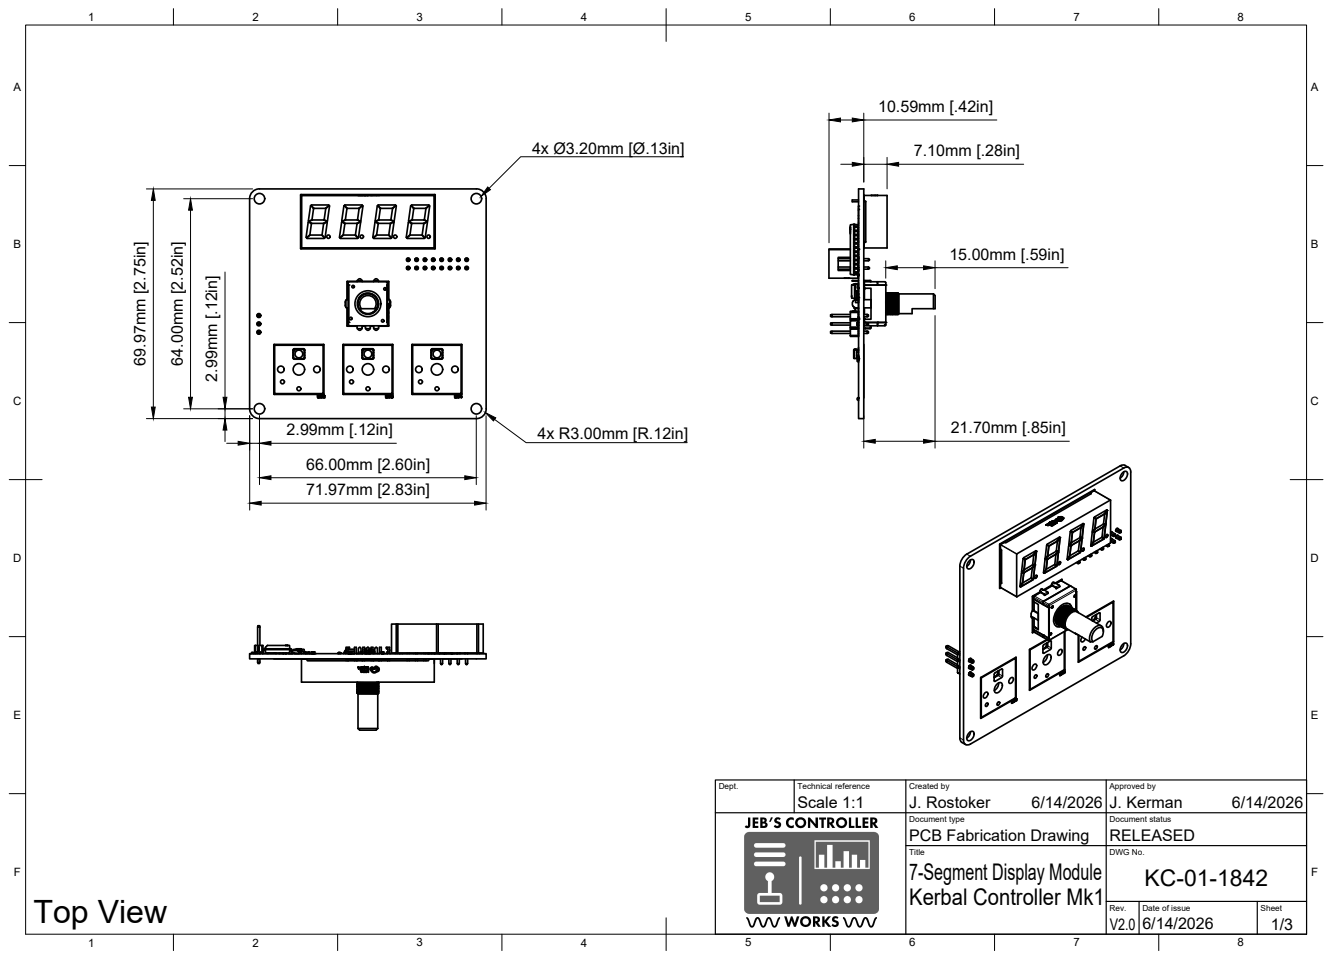
[picture p231: page 1]
Dept.; Technical reference; Created by; Approved by; Document type; Document status; Title; DWG No.; Rev.; Date of issue; Sheet; PCB Fabrication Drawing; RELEASED; Kerbal Controller Mk1; 7-Segment Display Module; Scale 1:1; J. Rostoker; J. Kerman; Top View

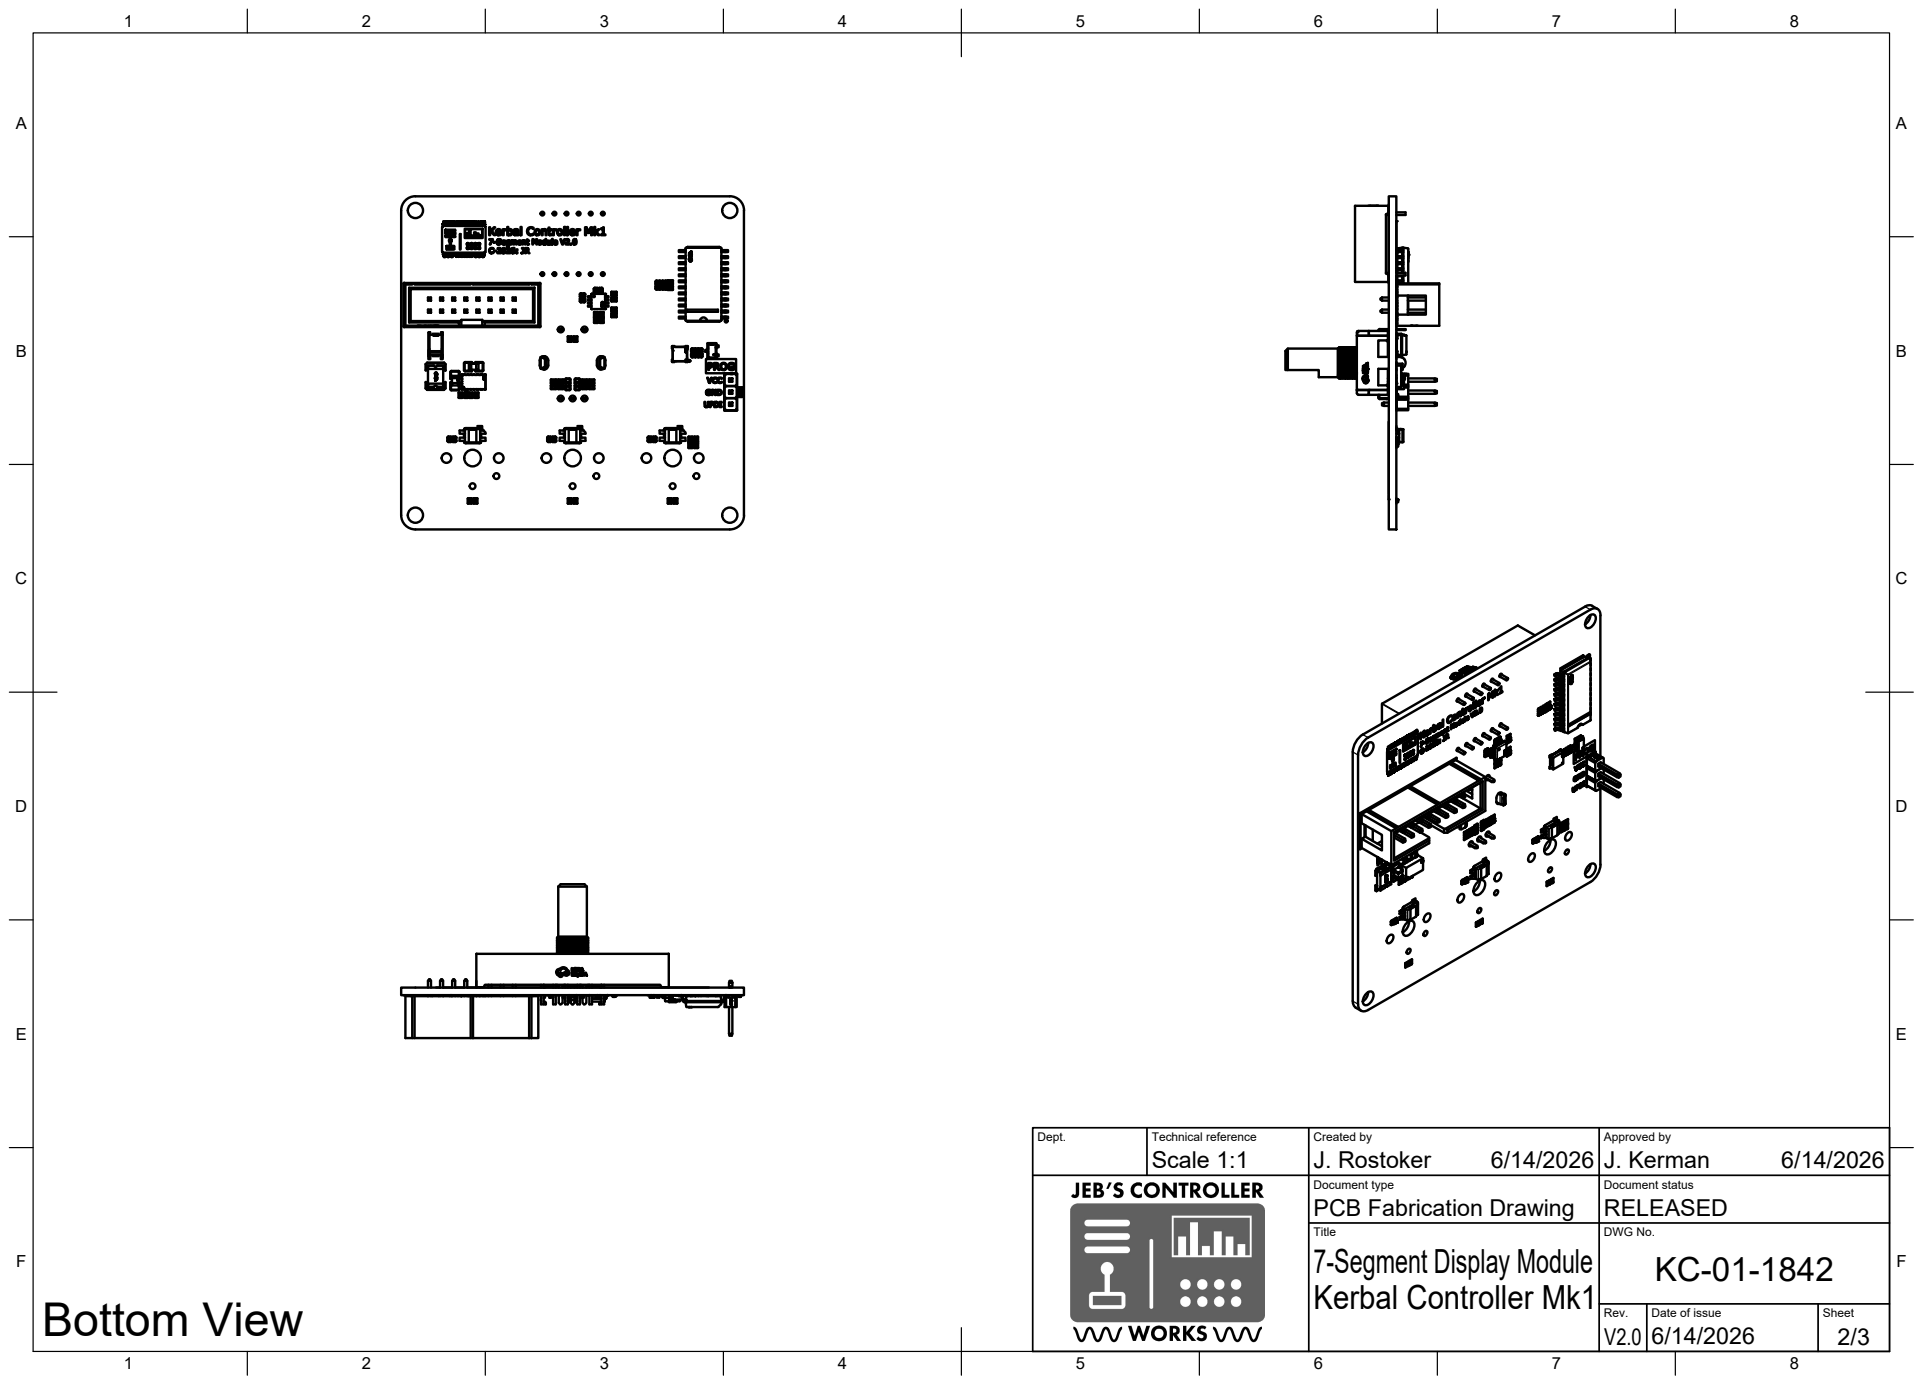
[picture p232: page 2]
Dept.; Technical reference; Created by; Approved by; Document type; Document status; Title; DWG No.; PCB Fabrication Drawing; RELEASED; 7-Segment Display Module; Scale 1:1; J. Rostoker; J. Kerman; Bottom View

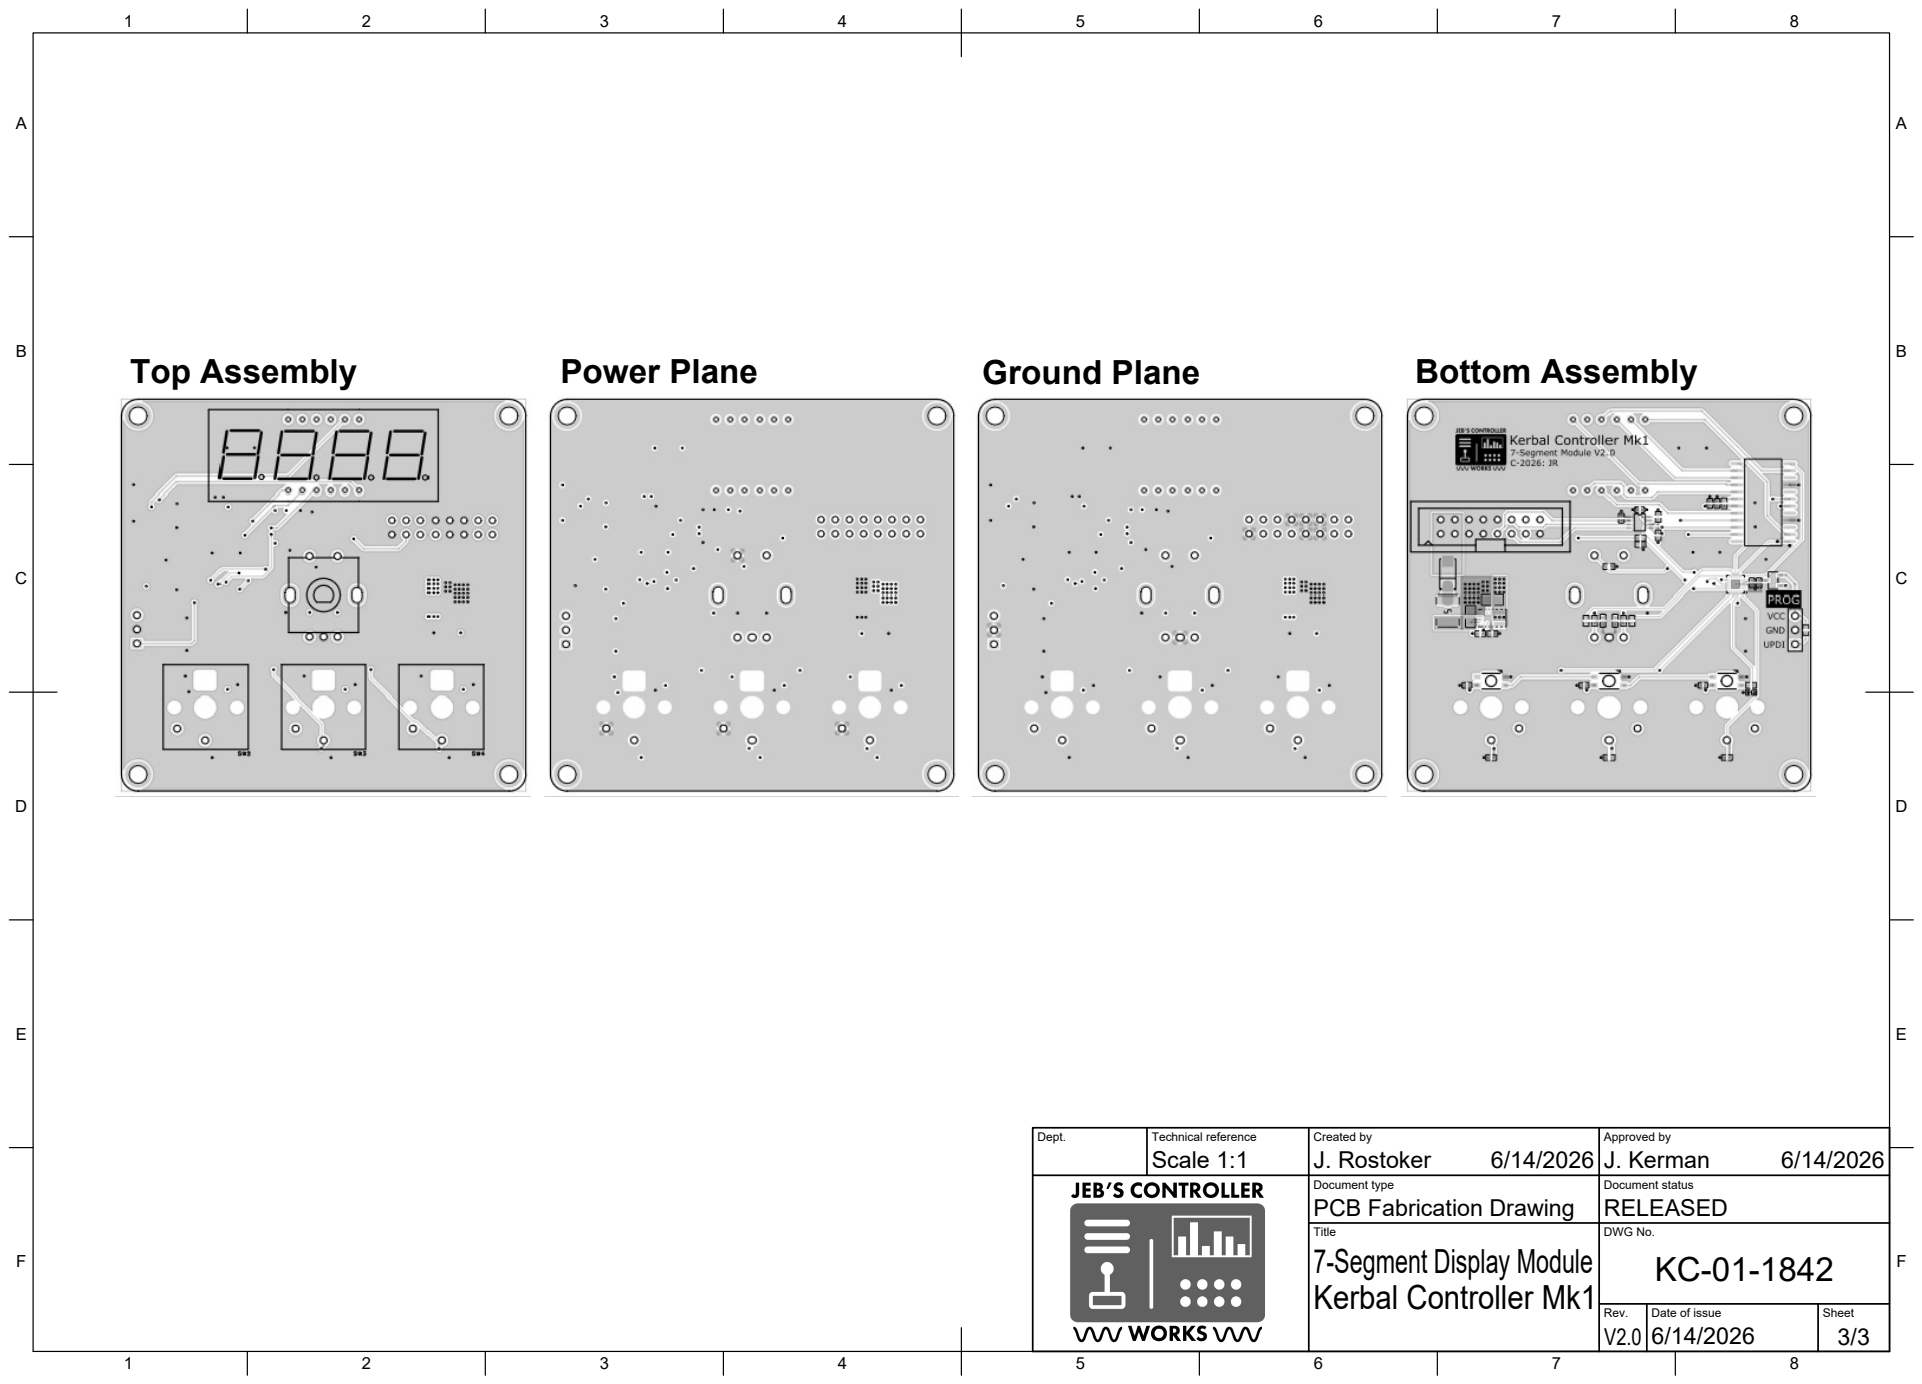
[picture p233: page 3]
Title; DWG No.; 7-Segment Display Module; Top Assembly; Power Plane; Ground Plane; Bottom Assembly

Dept. | Technical reference Scale 1:1 | Created by J. Rostoker 6/14/2026 | Approved by J. Kerman 6/14/2026

Document type PCB Fabrication Drawing | Document status RELEASED
