bigJRo/KerbalControllerMk1/Documents/Drawings/KC-01-1851_V2.0_Encoder Module_SCH.pdf

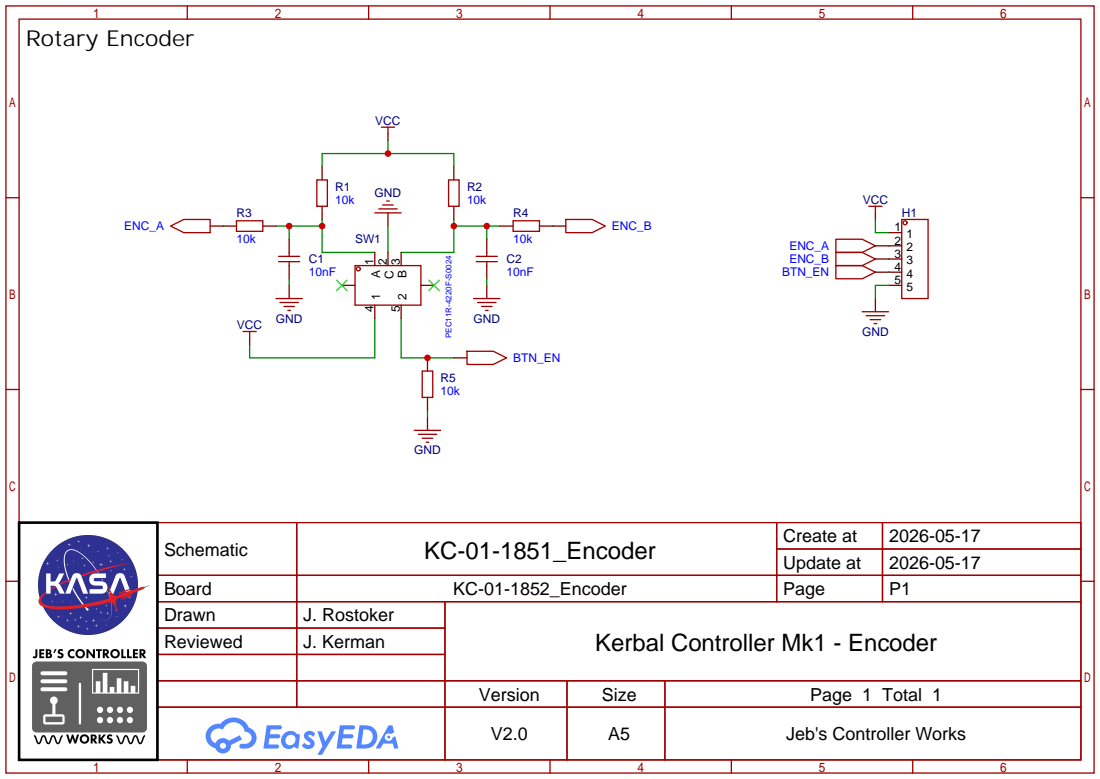
[picture p234: page 1]

Schematic | KC-01-1851_Encoder | Create at | 2026-05-17

Update at | 2026-05-17

Board | KC-01-1852_Encoder | Page | P1
Drawn | J. Rostoker | Kerbal Controller Mk1 - Encoder
Reviewed | J. Kerman

Version | Size | Page 1 Total 1
V2.0 | A5 | Jeb's Controller Works
