bigJRo/KerbalControllerMk1/Documents/Drawings/KC-01-1852_V2.0_Encoder Module_PWB.pdf

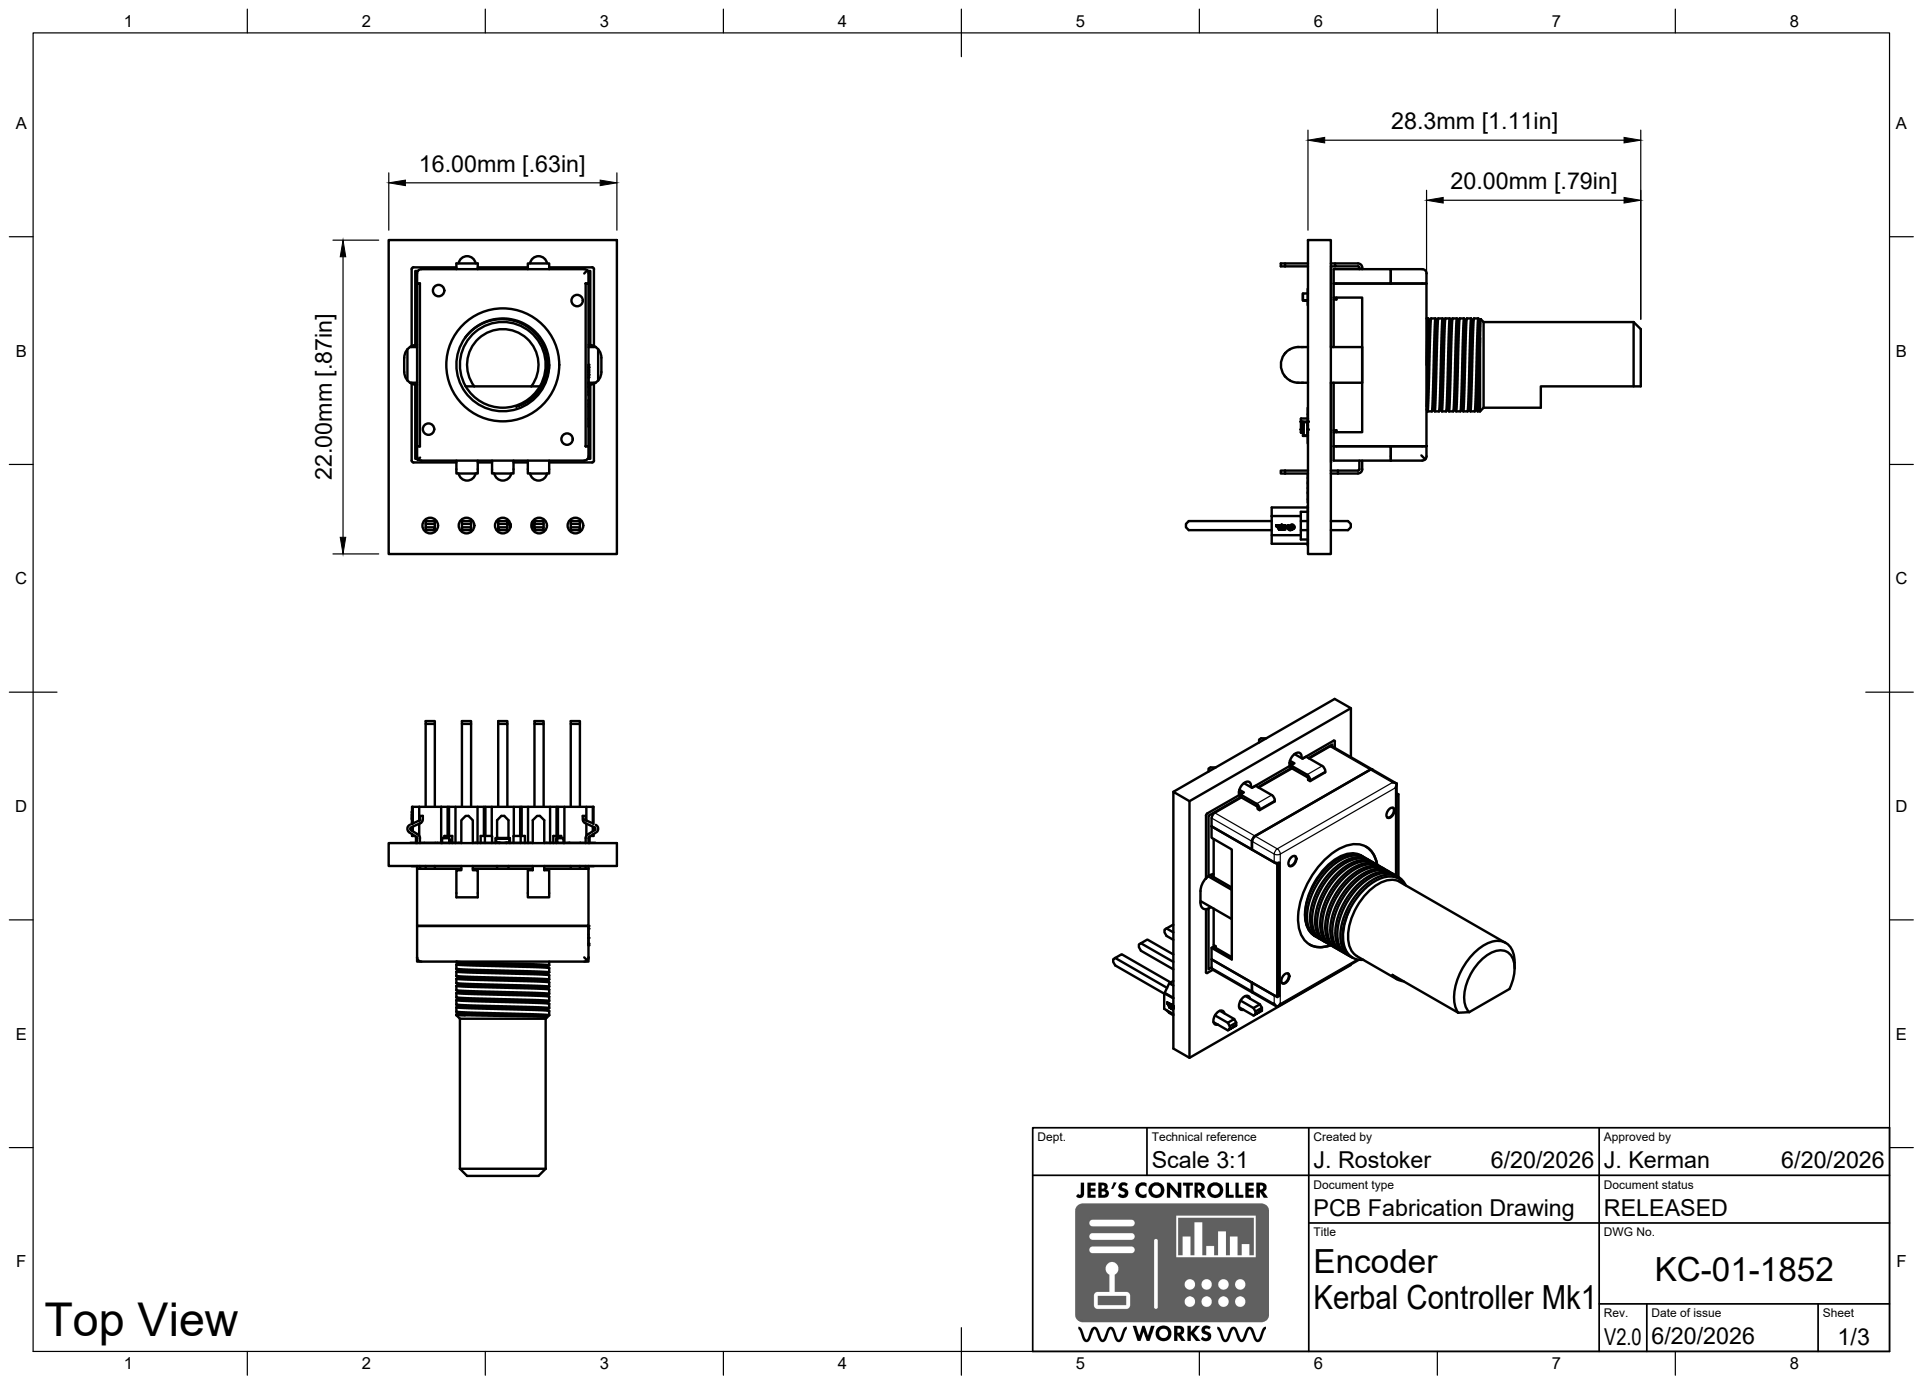
[picture p235: page 1]
Title; DWG No.; Rev.; Date of issue; Sheet; Kerbal Controller Mk1; Top View

Dept. | Technical reference Scale 3:1 | Created by J. Rostoker 6/20/2026 | Approved by J. Kerman 6/20/2026

Document type PCB Fabrication Drawing | Document status RELEASED

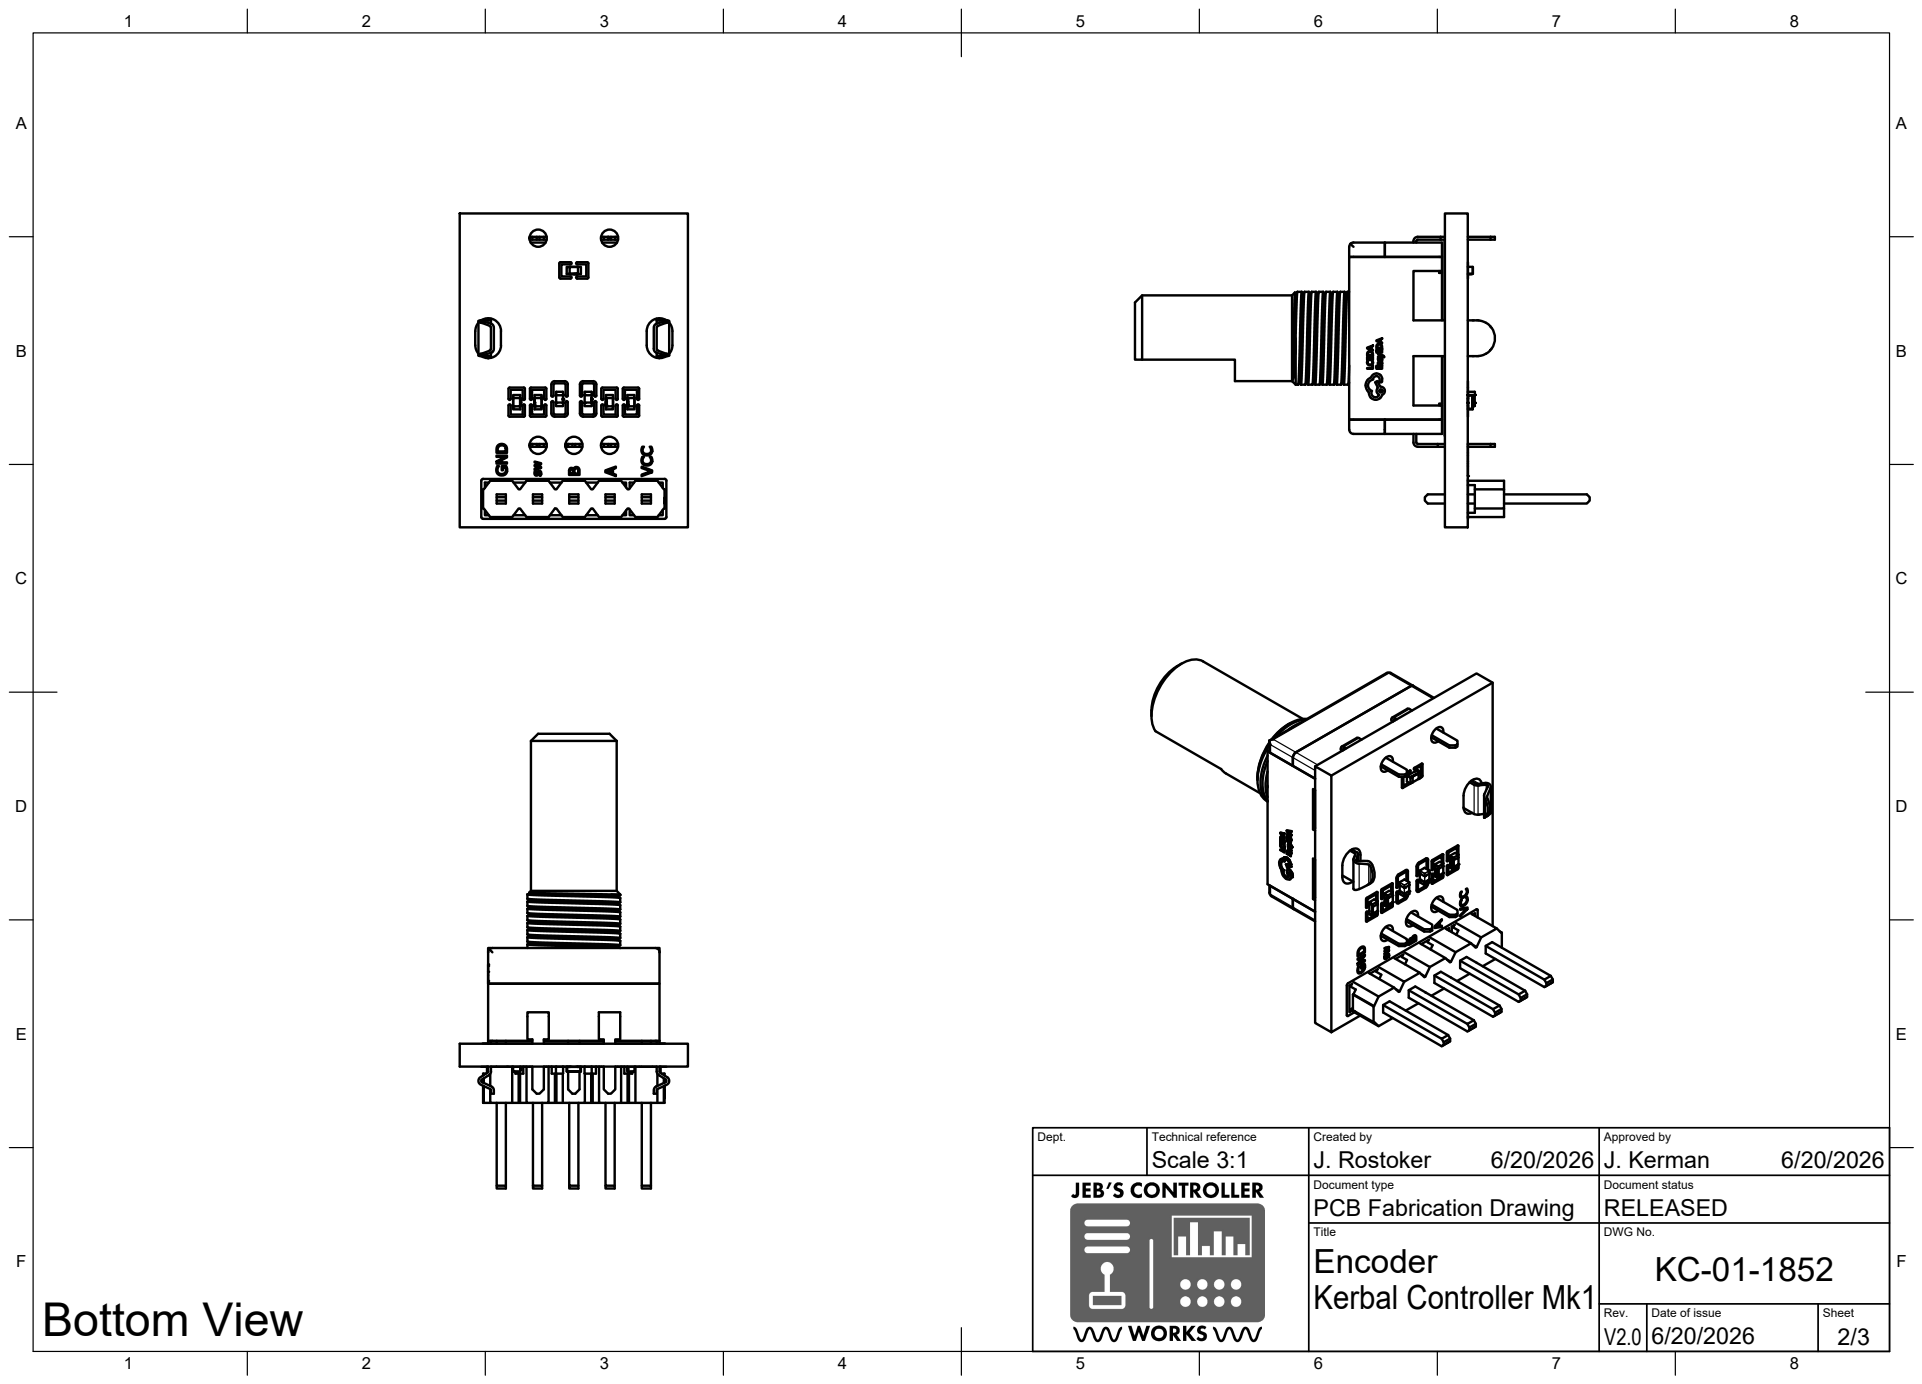
[picture p236: page 2]
Title; DWG No.; Bottom View

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

Document type PCB Fabrication Drawing | Document status RELEASED

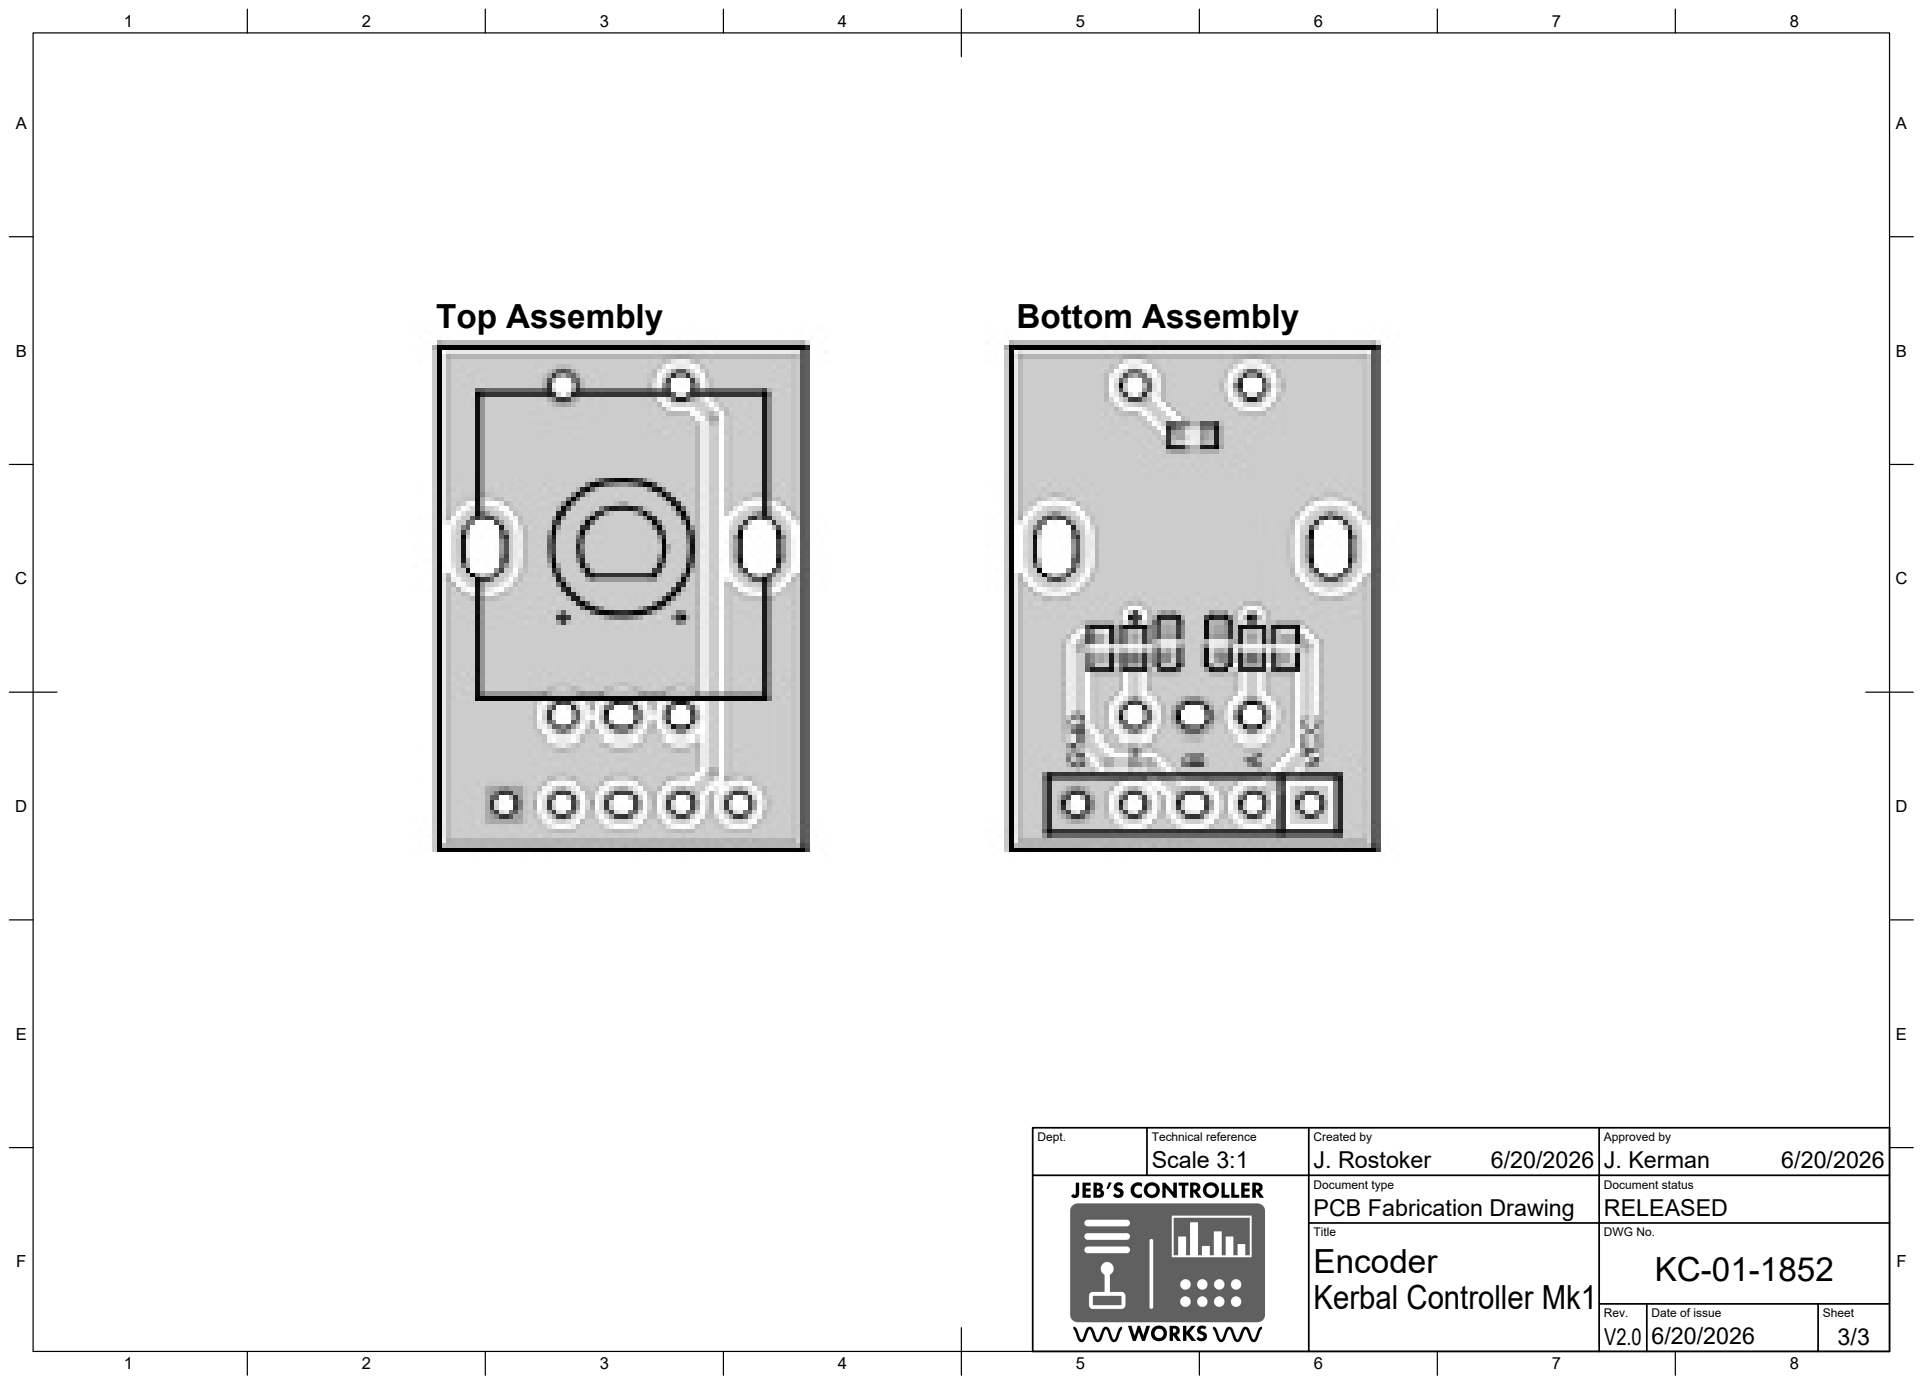
[picture p237: page 3]
Title; DWG No.; Top Assembly; Bottom Assembly

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

Document type PCB Fabrication Drawing | Document status RELEASED
