bigJRo/KerbalControllerMk1/Documents/Drawings/KC-01-1860_RevA_Dual Encoder Module Complete.pdf

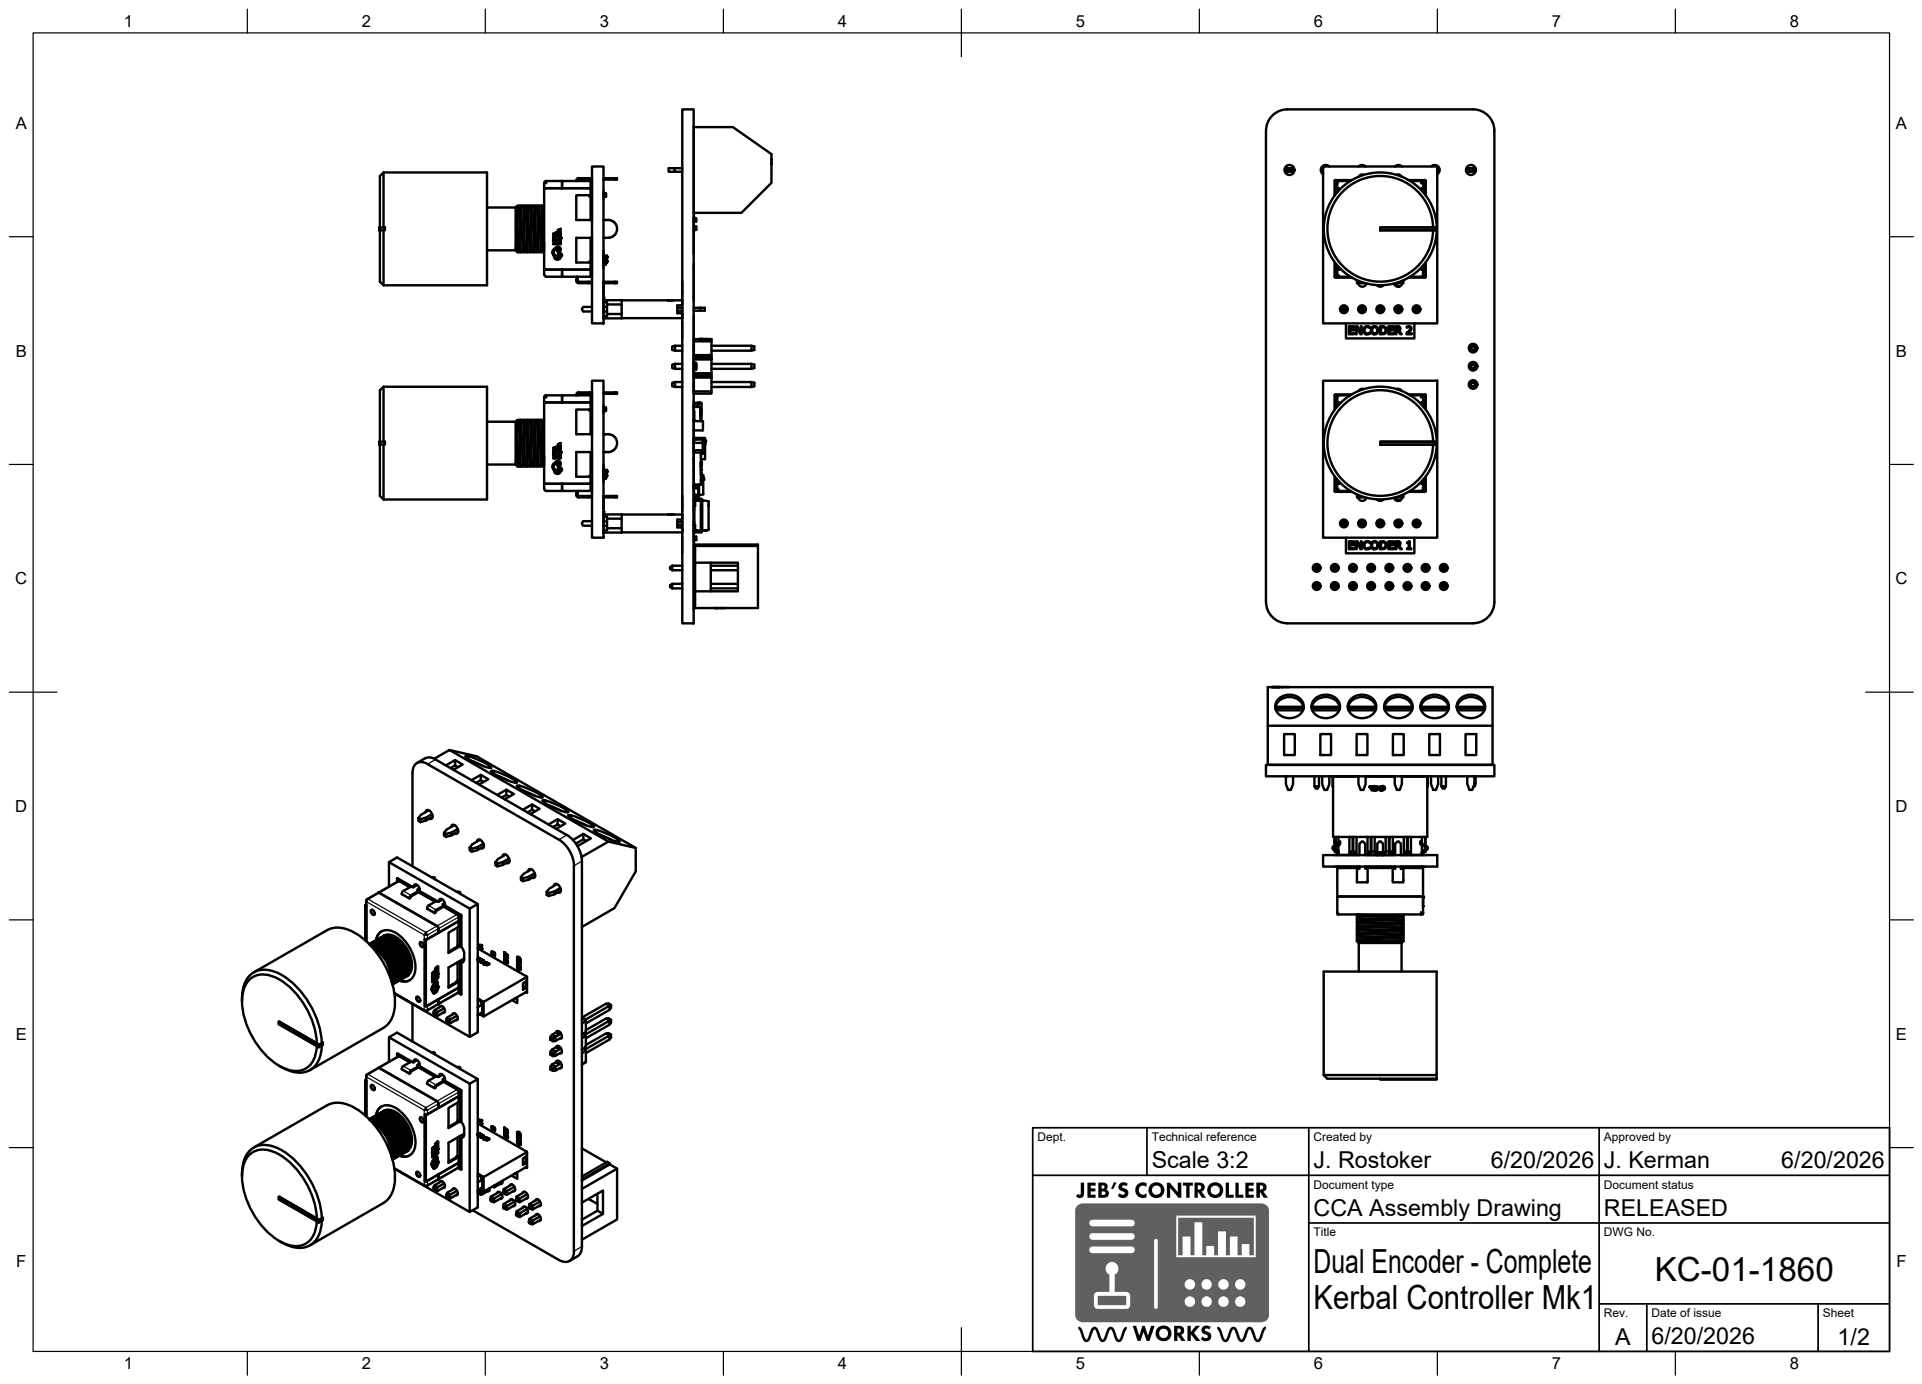
[picture p238: page 1]
Dept.; Technical reference; Created by; Approved by; Document type; Document status; Title; DWG No.; Rev.; Date of issue; Sheet; CCA Assembly Drawing; RELEASED; Kerbal Controller Mk1; Dual Encoder - Complete; Scale 3:2; J. Rostoker; J. Kerman

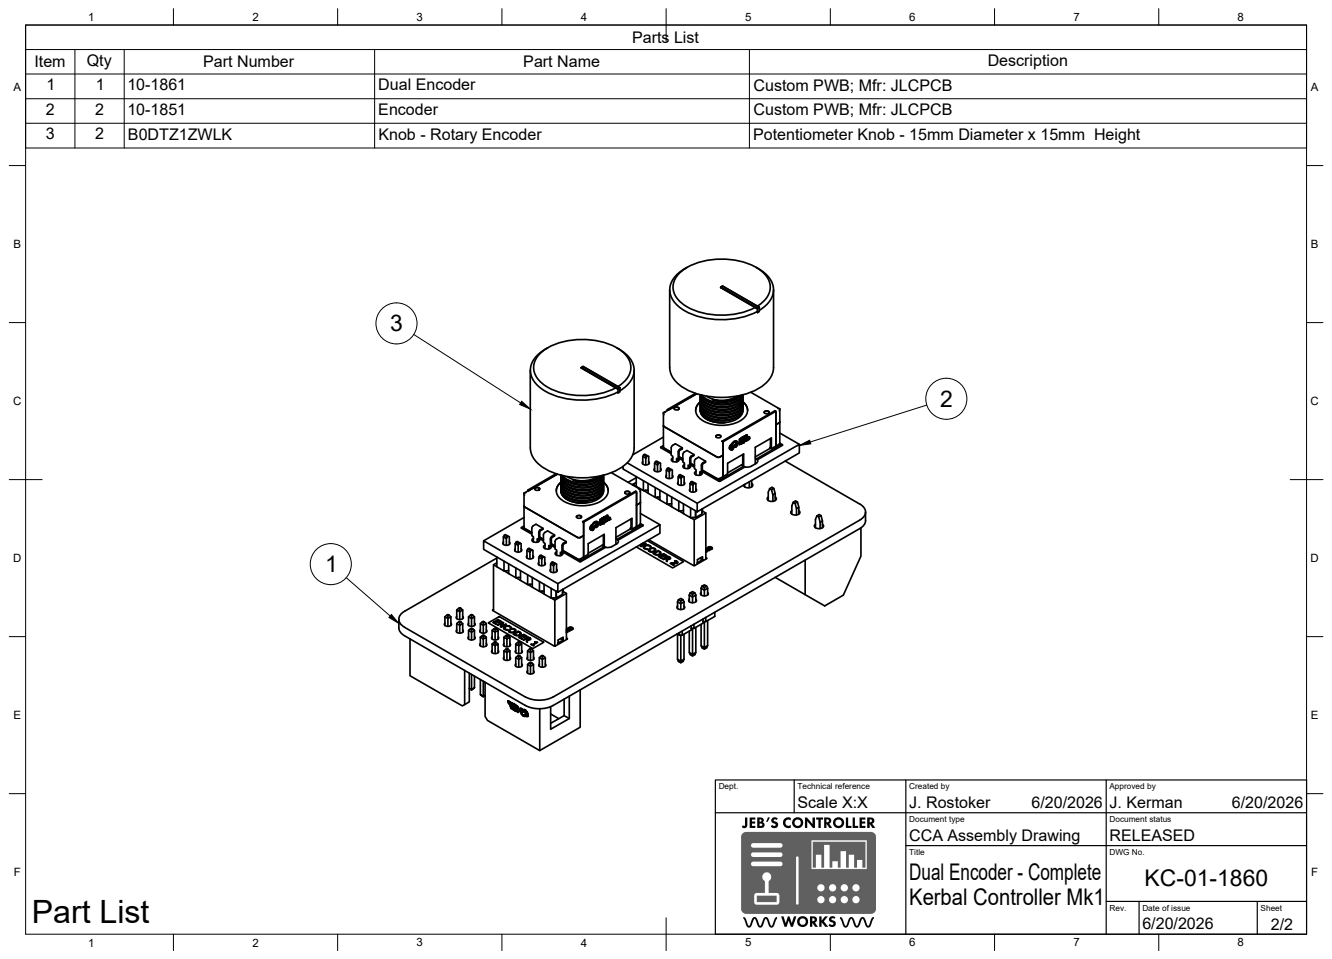
[picture p239: page 2]
Part List

Parts List

Item | Qty | Part Number | Part Name | Description
1 | 1 | 10-1861 | Dual Encoder | Custom PWB; Mfr: JLCPCB
2 | 2 | 10-1851 | Encoder | Custom PWB; Mfr: JLCPCB
3 | 2 | B0DTZ1ZWLK | Knob - Rotary Encoder | Potentiometer Knob - 15mm Diameter x 15mm Height

Dept. | Technical reference Scale X:X | Created by J. Rostoker 6/20/2026 | Approved by J. Kerman 6/20/2026

Document type CCA Assembly Drawing | Document status RELEASED

Title Dual Encoder - Complete Kerbal Controller Mk1 | DWG No. KC-01-1860

Rev. | Date of issue 6/20/2026 | Sheet 2/2
