bigJRo/KerbalControllerMk1/Documents/Drawings/KC-01-1861_V2.0_Dual Encoder Module_SCH.pdf

Microcontroller | Panel Control Connector

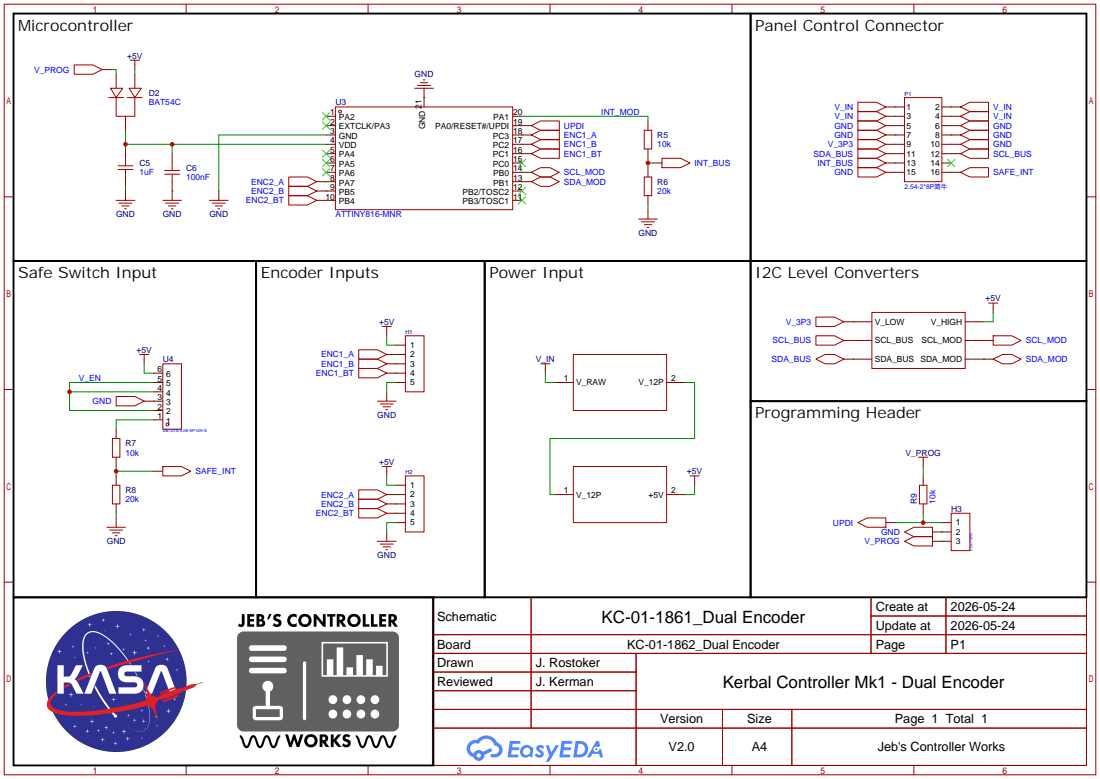
[picture p240: page 1]

Schematic | KC-01-1861_Dual Encoder | Create at | 2026-05-24

Update at | 2026-05-24

Board | KC-01-1862_Dual Encoder | Page | P1
Drawn | J. Rostoker | Kerbal Controller Mk1 - Dual Encoder
Reviewed | J. Kerman

Version | Size | Page 1 Total 1
V2.0 | A4 | Jeb's Controller Works

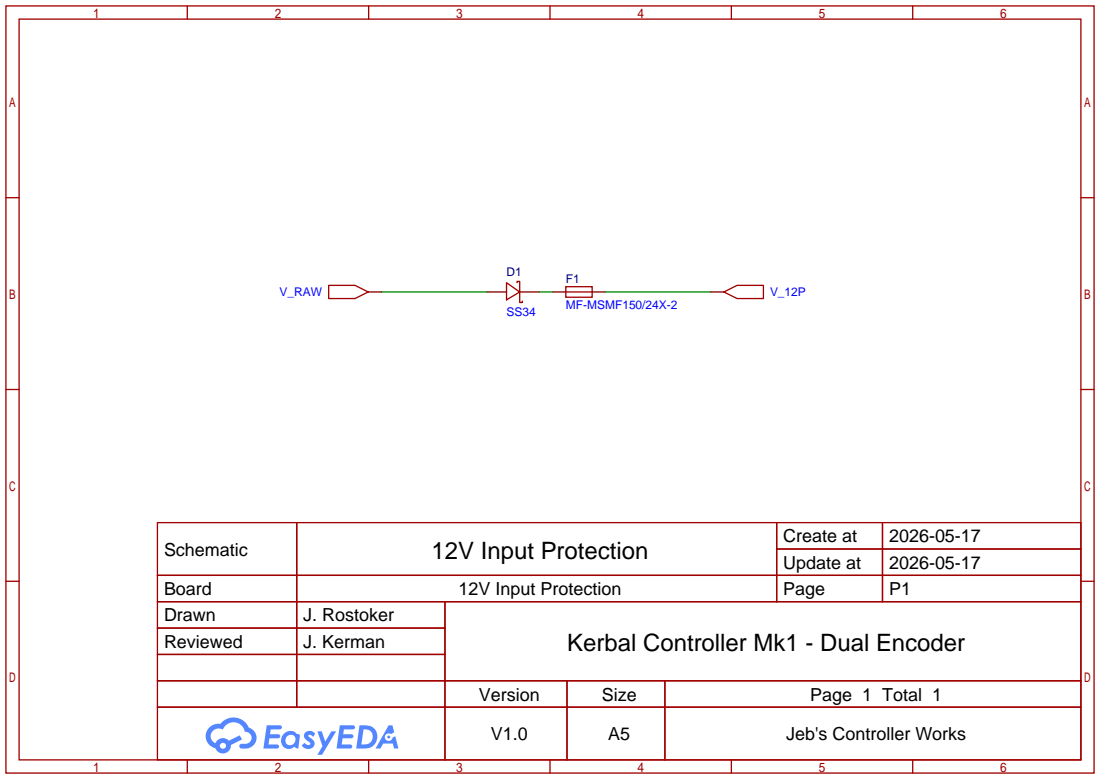
[picture p241: page 2]

Schematic | 12V Input Protection | Create at | 2026-05-17

Update at | 2026-05-17

Board | 12V Input Protection | Page | P1
Drawn | J. Rostoker | Kerbal Controller Mk1 - Dual Encoder
Reviewed | J. Kerman

Version | Size | Page 1 Total 1
V1.0 | A5 | Jeb's Controller Works

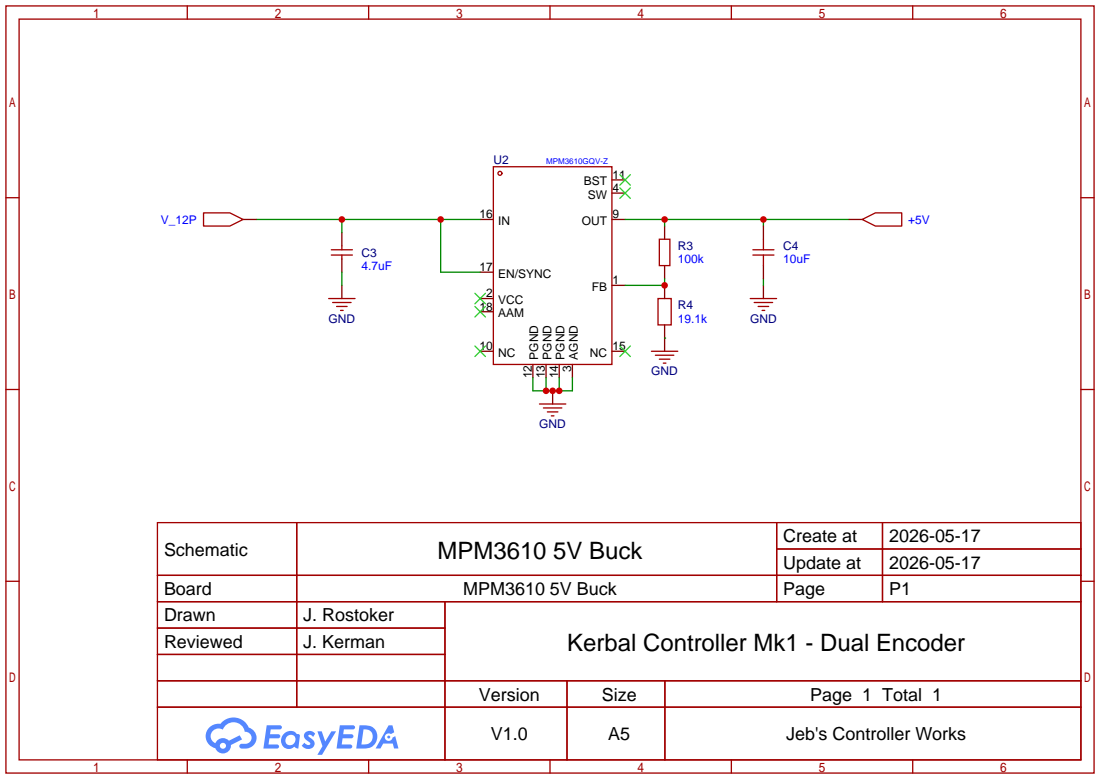
[picture p242: page 3]

Schematic | MPM3610 5V Buck | Create at | 2026-05-17

Update at | 2026-05-17

Board | MPM3610 5V Buck | Page | P1
Drawn | J. Rostoker | Kerbal Controller Mk1 - Dual Encoder
Reviewed | J. Kerman

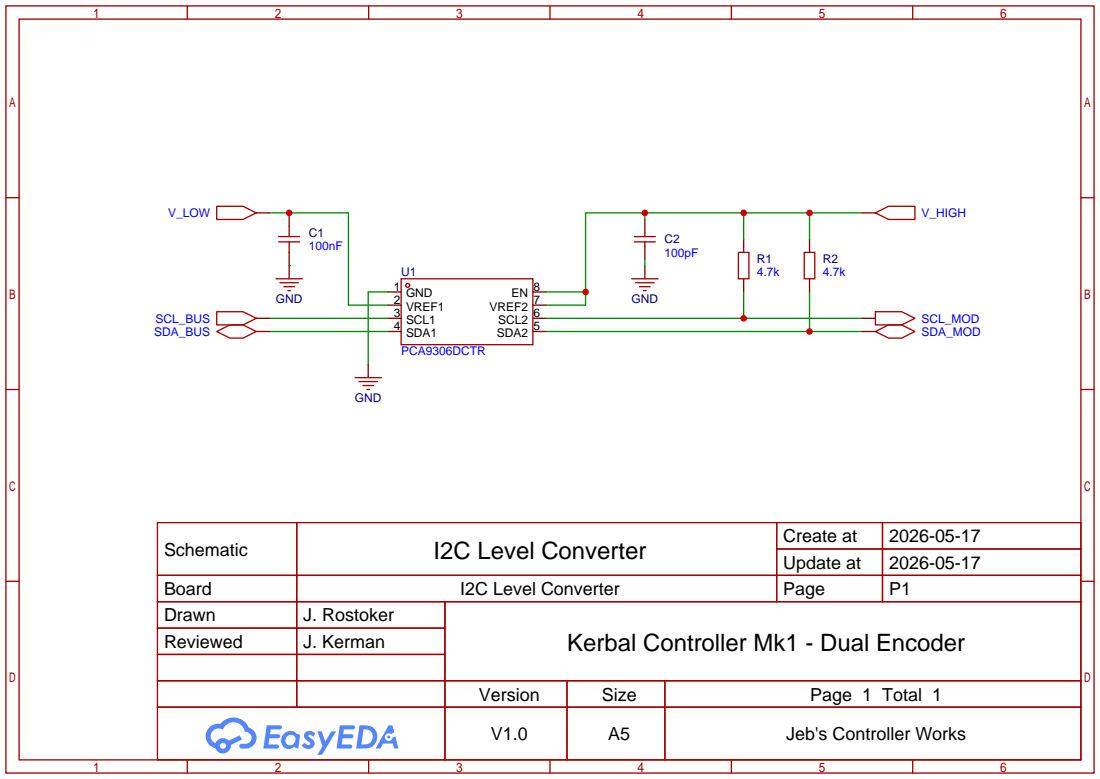
[picture p243: page 4]

Schematic | I2C Level Converter | Create at | 2026-05-17

Update at | 2026-05-17

Board | I2C Level Converter | Page | P1
Drawn | J. Rostoker | Kerbal Controller Mk1 - Dual Encoder
Reviewed | J. Kerman
