bigJRo/KerbalControllerMk1/Documents/Drawings/KC-01-1862_V2.0_Dual Encoder Module_PWB.pdf

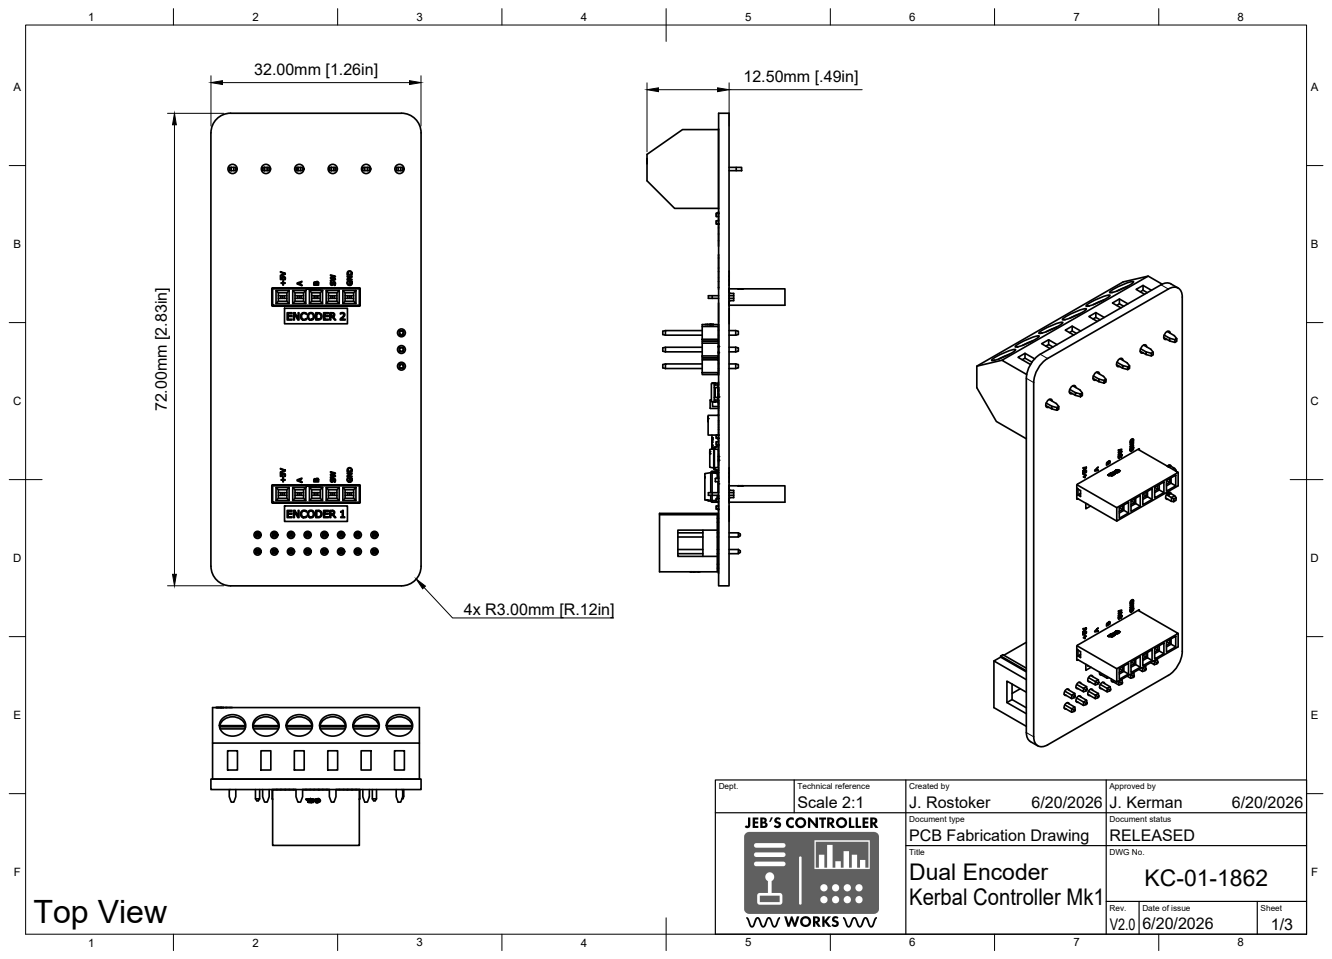
[picture p244: page 1]
Title; DWG No.; Rev.; Date of issue; Sheet; Kerbal Controller Mk1; Dual Encoder; Top View

Dept. | Technical reference Scale 2:1 | Created by J. Rostoker 6/20/2026 | Approved by J. Kerman 6/20/2026

Document type PCB Fabrication Drawing | Document status RELEASED

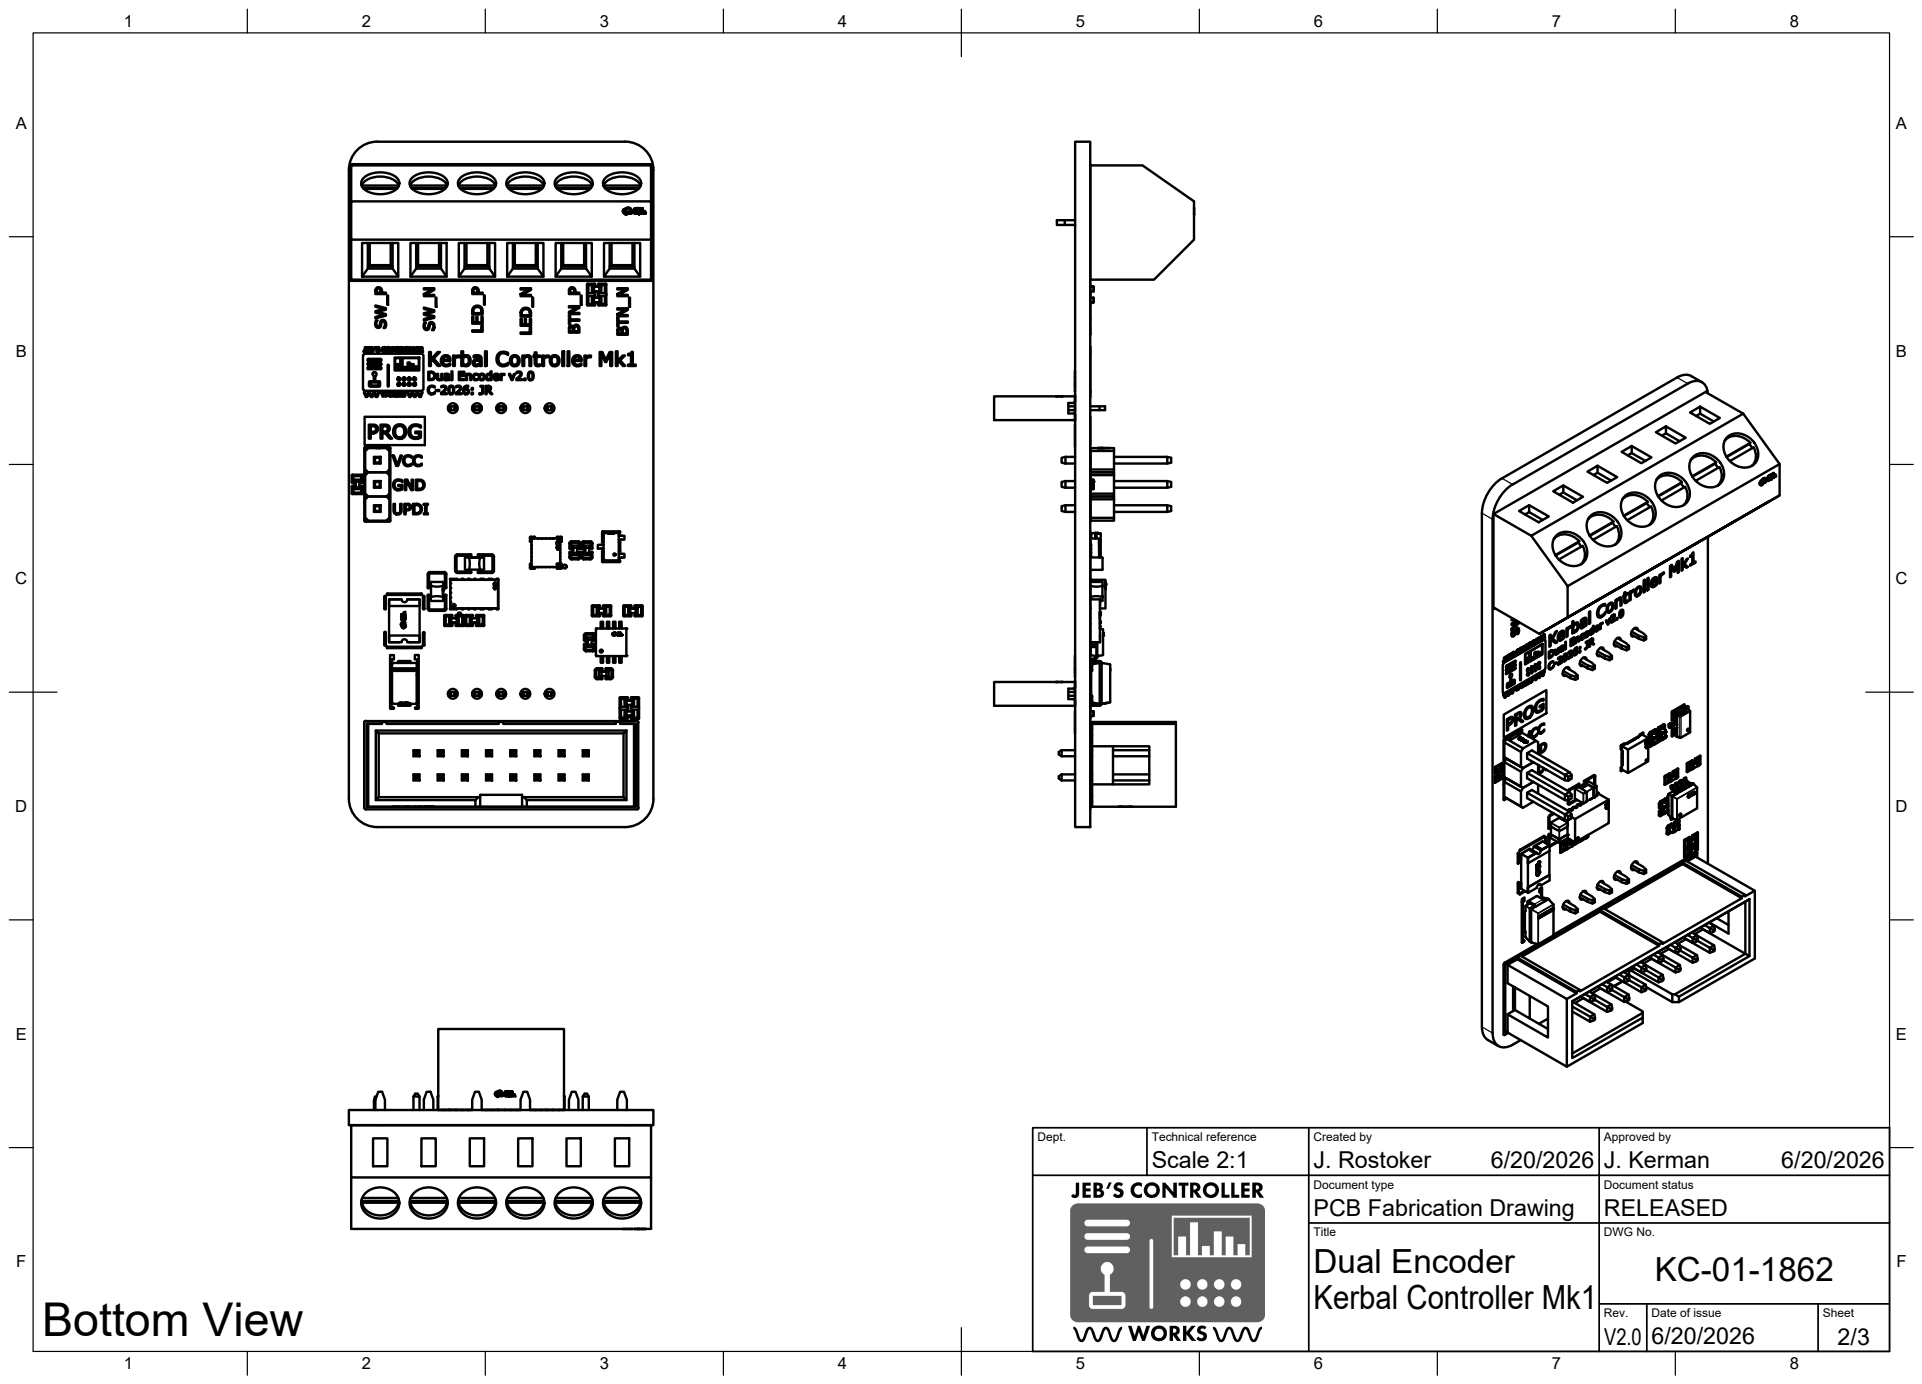
[picture p245: page 2]
Dept.; Technical reference; Created by; Approved by; Document type; Document status; Title; DWG No.; PCB Fabrication Drawing; RELEASED; Dual Encoder; Scale 2:1; J. Rostoker; J. Kerman; Bottom View

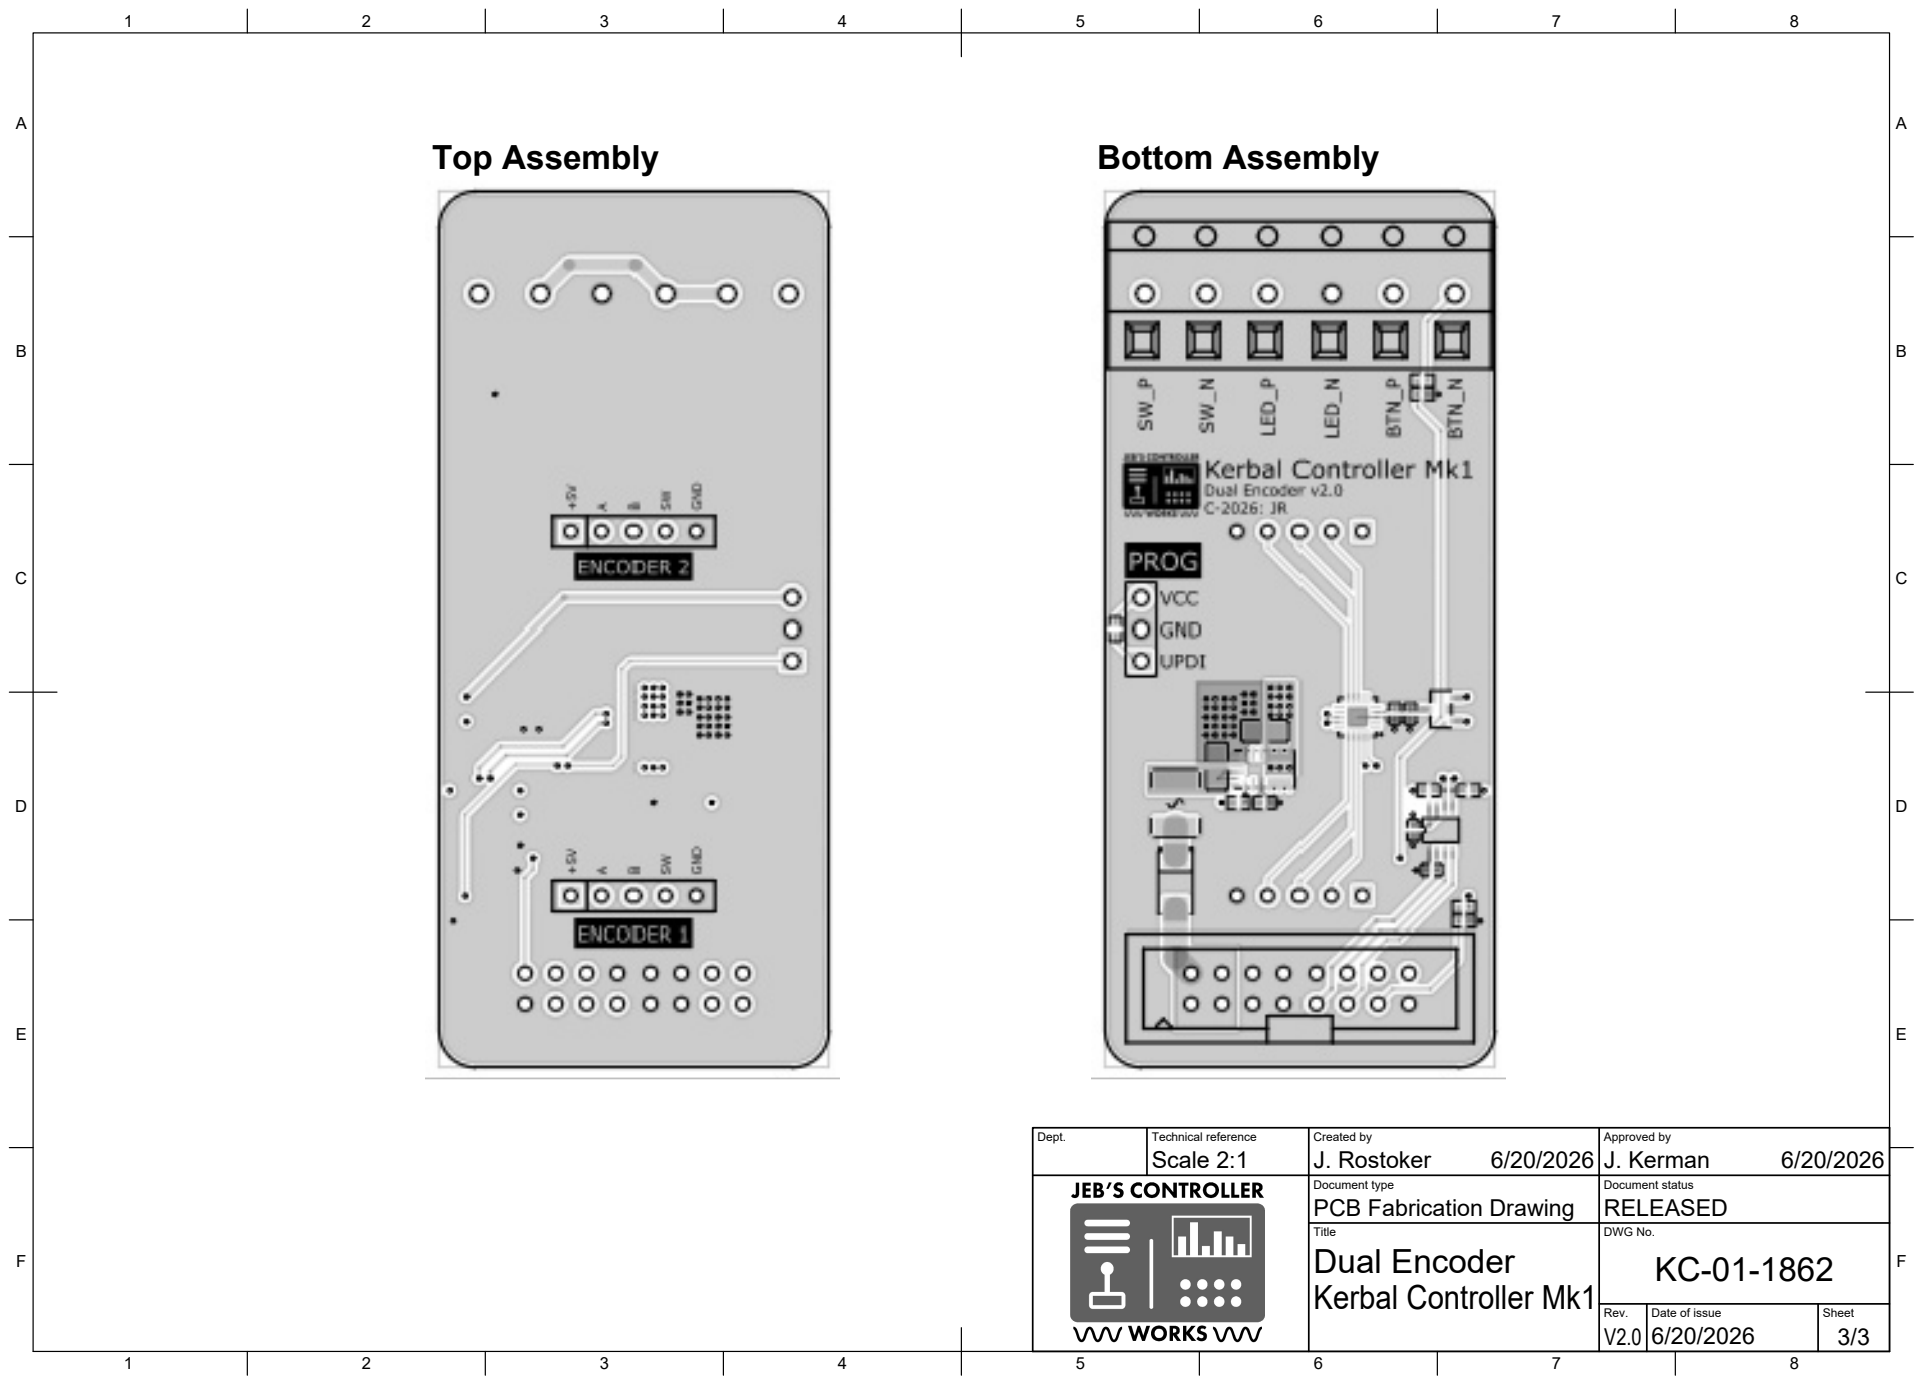
[picture p246: page 3]
Title; DWG No.; Dual Encoder; Top Assembly; Bottom Assembly

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

Document type PCB Fabrication Drawing | Document status RELEASED
