bigJRo/KerbalControllerMk1/Documents/Drawings/KC-01-1870_RevA_Throttle Module Complete.pdf

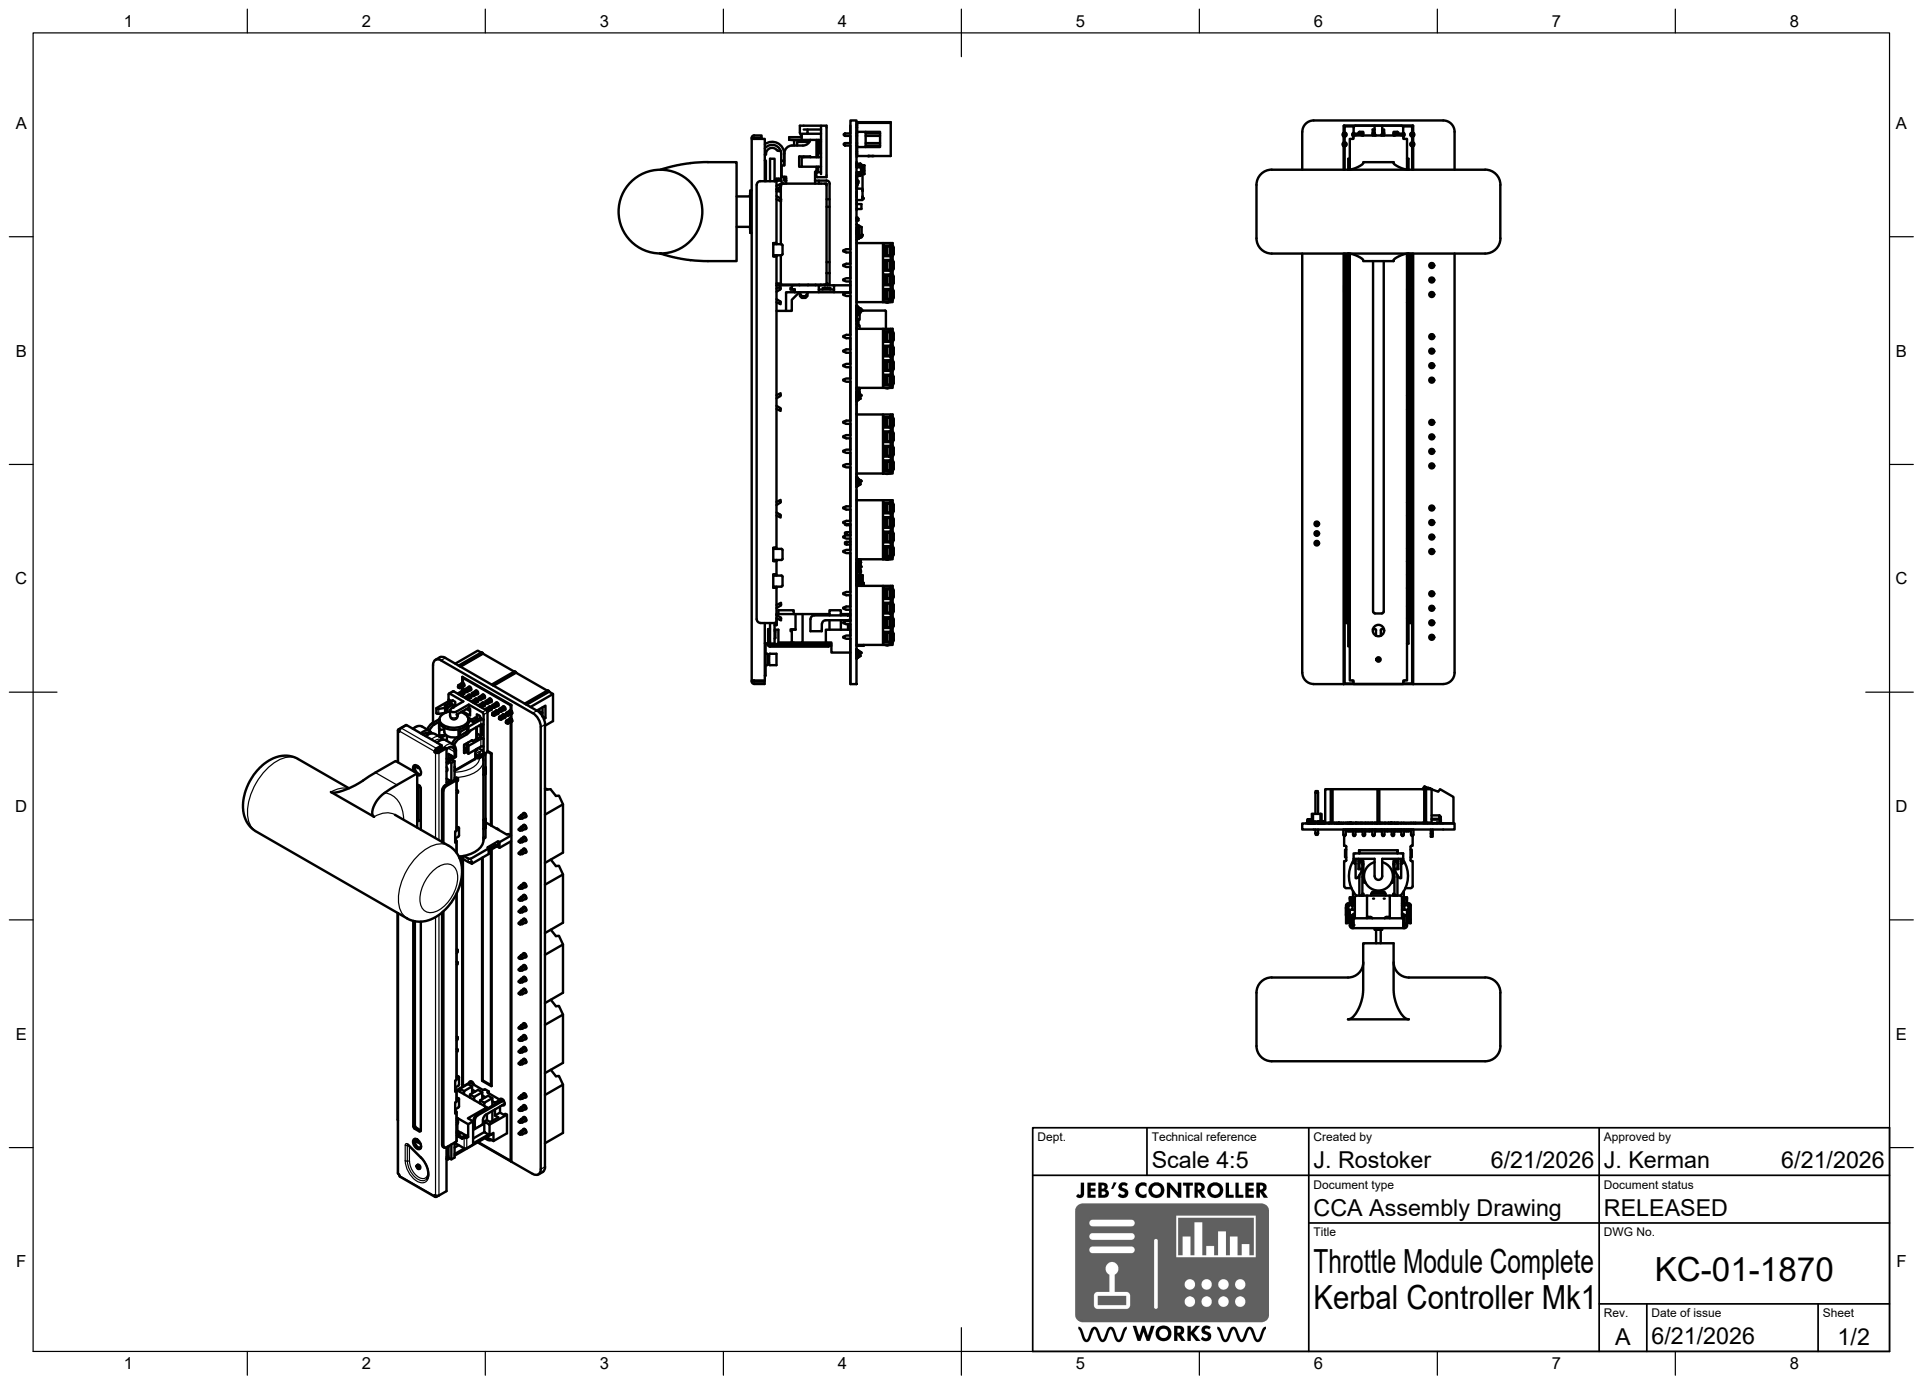
[picture p247: page 1]
Dept.; Technical reference; Created by; Approved by; Document type; Document status; Title; DWG No.; Rev.; Date of issue; Sheet; CCA Assembly Drawing; RELEASED; Kerbal Controller Mk1; Throttle Module Complete; Scale 4:5; J. Rostoker; J. Kerman

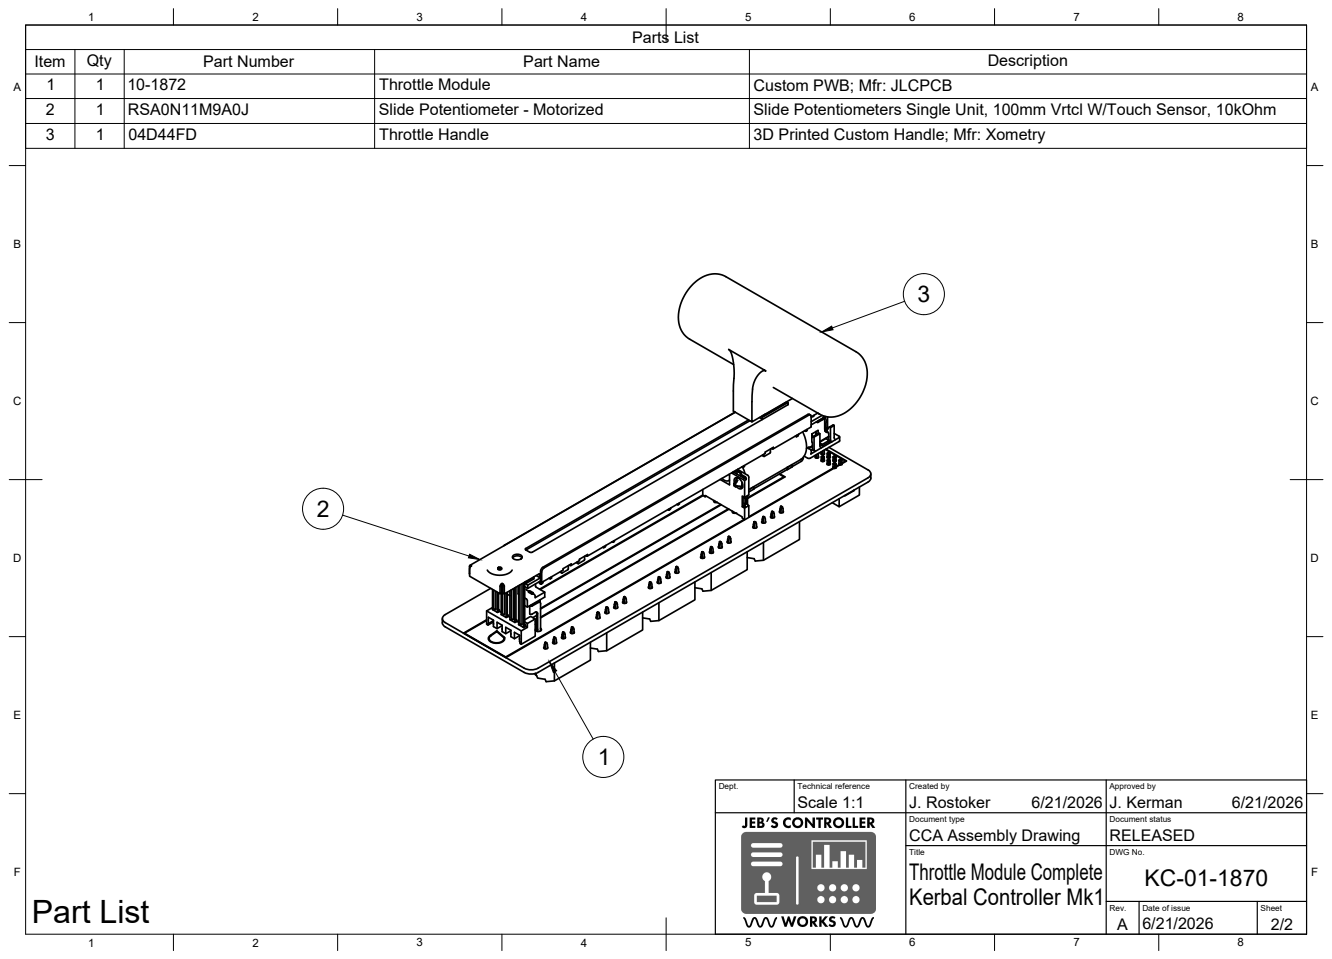
[picture p248: page 2]
Part List

Parts List

Item | Qty | Part Number | Part Name | Description
1 | 1 | 10-1872 | Throttle Module | Custom PWB; Mfr: JLCPCB
2 | 1 | RSA0N11M9A0J | Slide Potentiometer - Motorized | Slide Potentiometers Single Unit, 100mm Vrtcl W/Touch Sensor, 10kOhm
3 | 1 | 04D44FD | Throttle Handle | 3D Printed Custom Handle; Mfr: Xometry

Dept. | Technical reference Scale 1:1 | Created by J. Rostoker 6/21/2026 | Approved by J. Kerman 6/21/2026

Document type CCA Assembly Drawing | Document status RELEASED

Title Throttle Module Complete Kerbal Controller Mk1 | DWG No. KC-01-1870

Rev. A | Date of issue 6/21/2026 | Sheet 2/2
