bigJRo/KerbalControllerMk1/Documents/Drawings/KC-01-1871_V2.0_Throttle Module_SCH.pdf

Microcontroller | Panel Control Connector

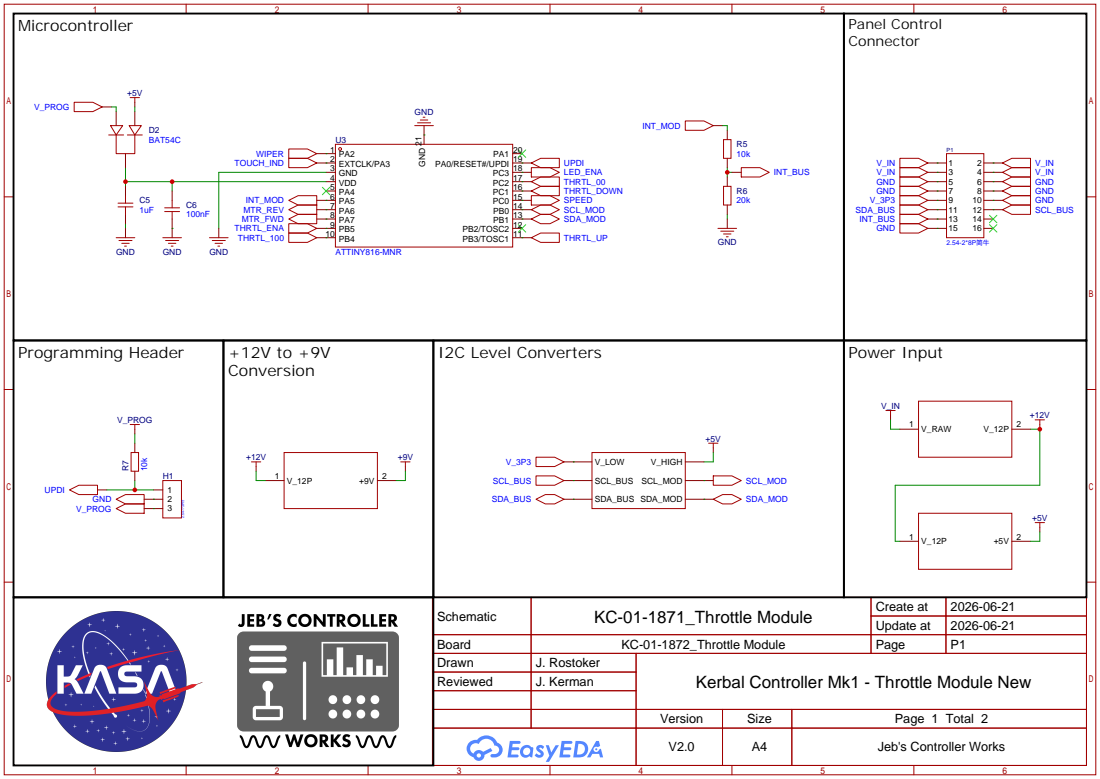
[picture p249: page 1]

Schematic | KC-01-1871_Throttle Module | Create at | 2026-06-21

Update at | 2026-06-21

Board | KC-01-1872_Throttle Module | Page | P1
Drawn | J. Rostoker | Kerbal Controller Mk1 - Throttle Module New
Reviewed | J. Kerman

Version | Size | Page 1 Total 2
V2.0 | A4 | Jeb's Controller Works

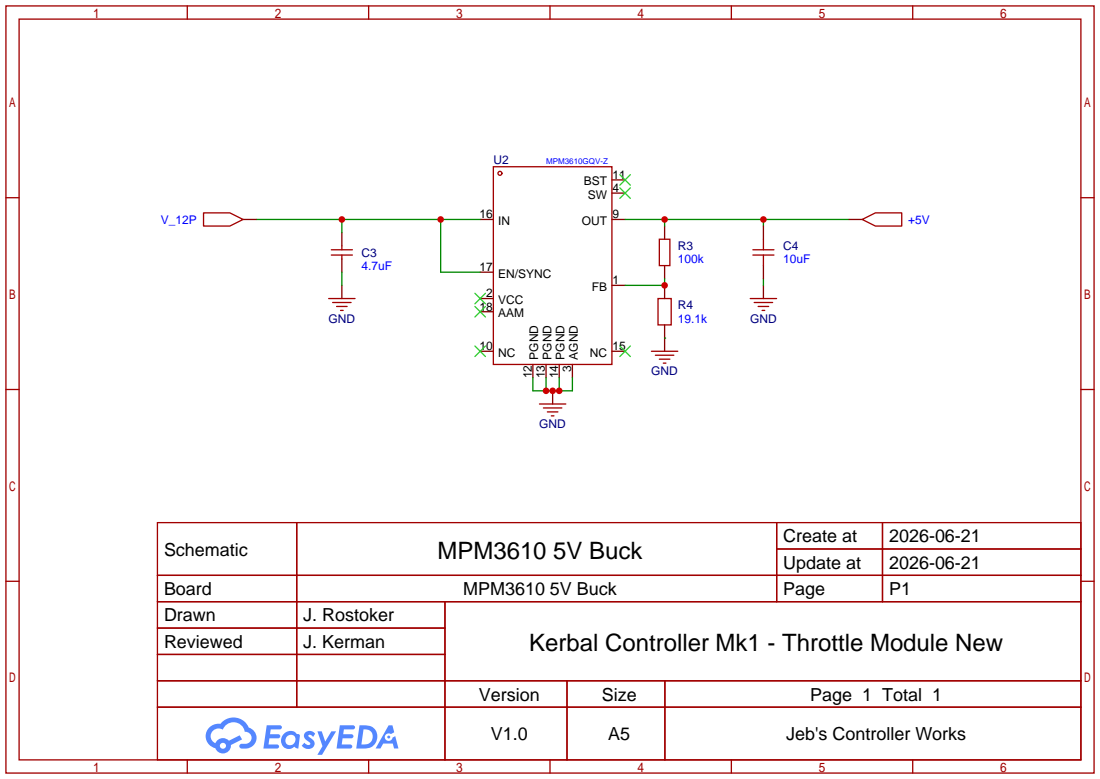
[picture p250: page 2]

Schematic | MPM3610 5V Buck | Create at | 2026-06-21

Update at | 2026-06-21

Board | MPM3610 5V Buck | Page | P1
Drawn | J. Rostoker | Kerbal Controller Mk1 - Throttle Module New
Reviewed | J. Kerman

Version | Size | Page 1 Total 1
V1.0 | A5 | Jeb's Controller Works

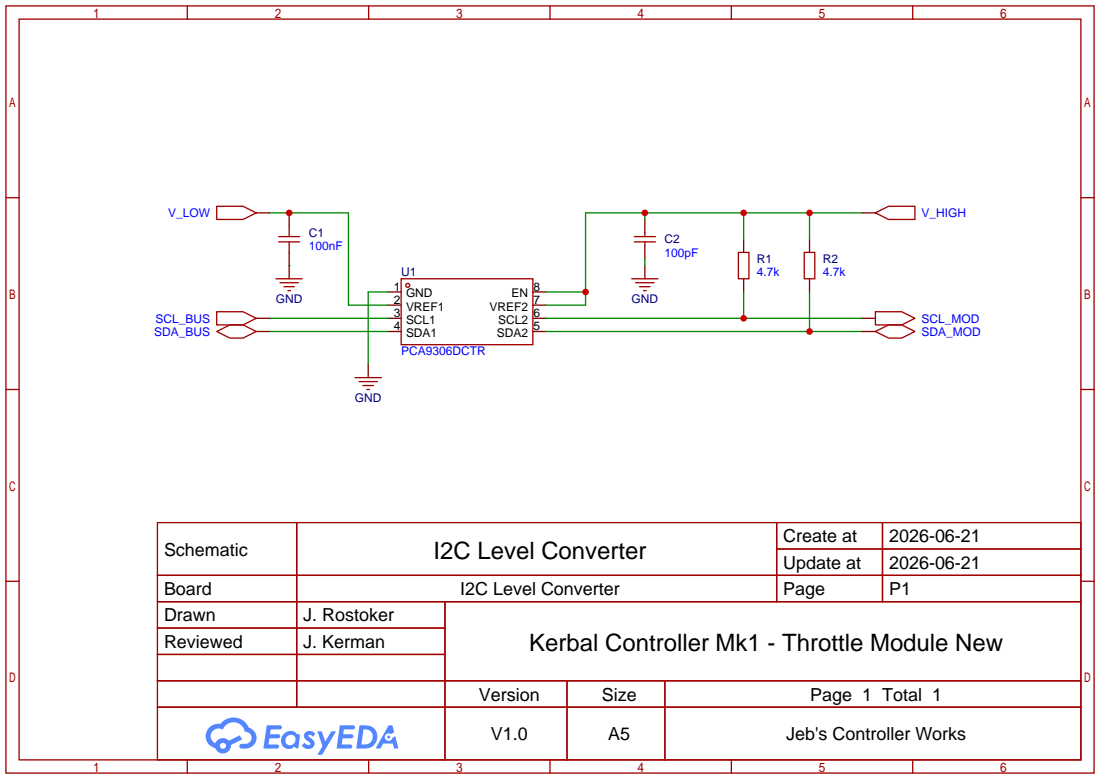
[picture p251: page 3]

Schematic | I2C Level Converter | Create at | 2026-06-21

Update at | 2026-06-21

Board | I2C Level Converter | Page | P1
Drawn | J. Rostoker | Kerbal Controller Mk1 - Throttle Module New
Reviewed | J. Kerman

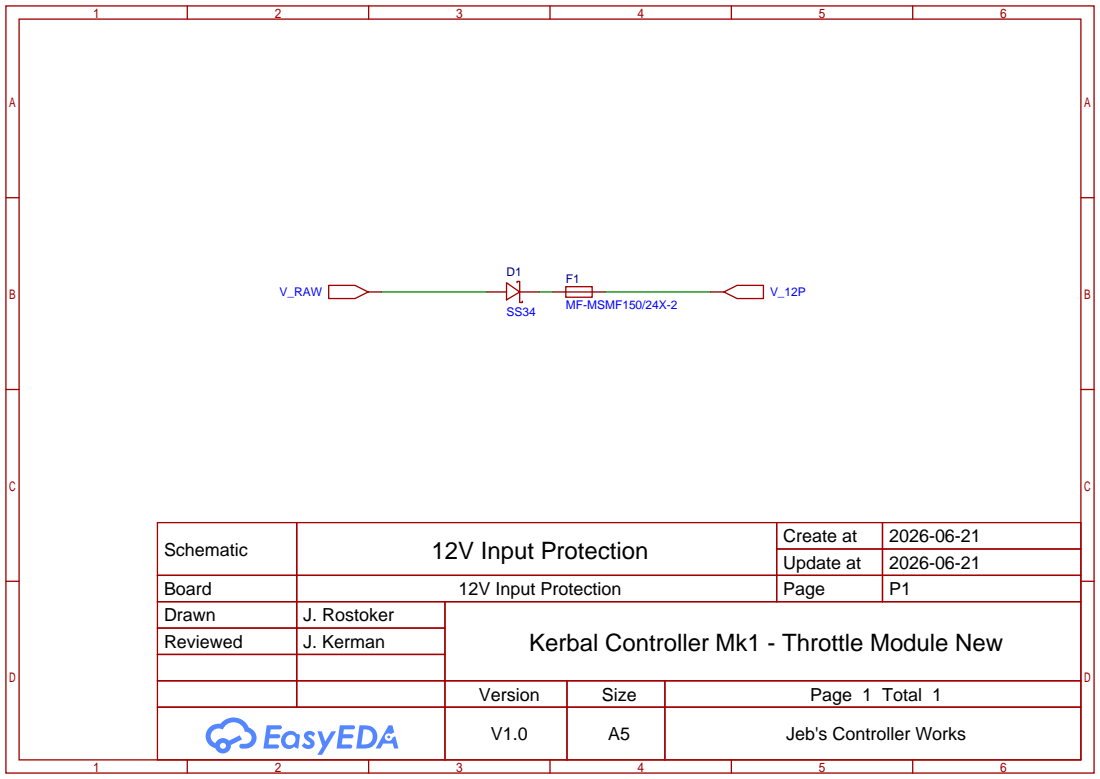
[picture p252: page 4]

Schematic | 12V Input Protection | Create at | 2026-06-21

Update at | 2026-06-21

Board | 12V Input Protection | Page | P1
Drawn | J. Rostoker | Kerbal Controller Mk1 - Throttle Module New
Reviewed | J. Kerman

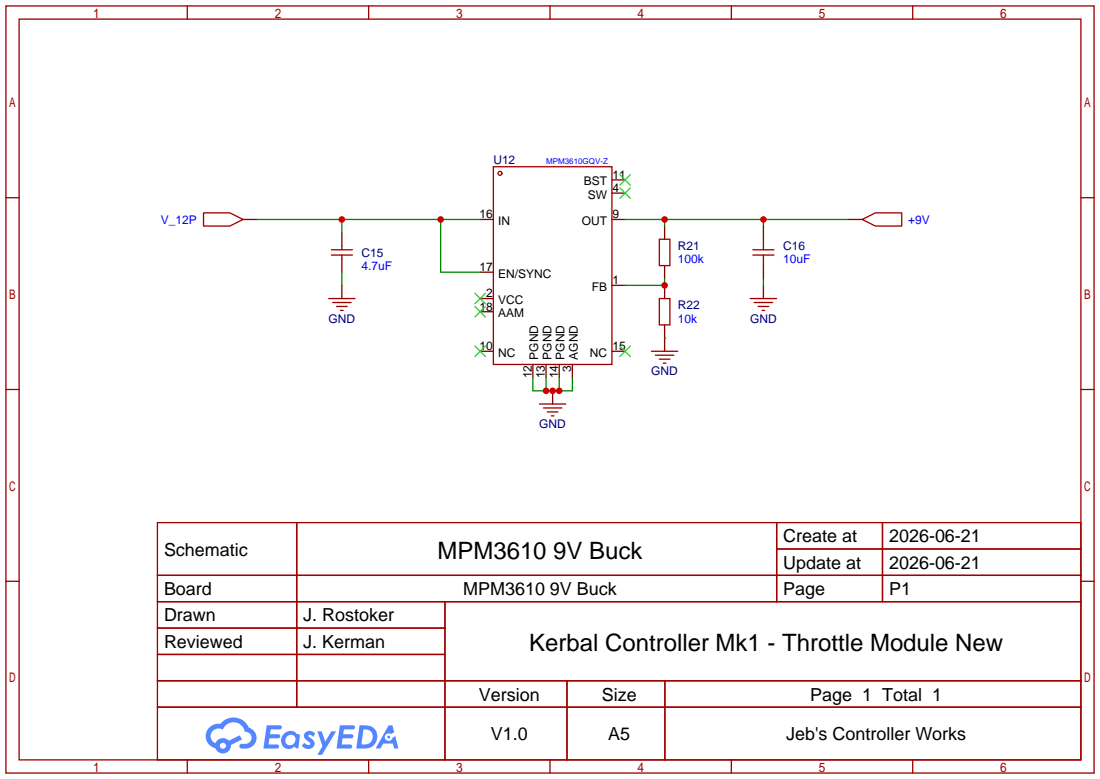
[picture p253: page 5]

Schematic | MPM3610 9V Buck | Create at | 2026-06-21

Update at | 2026-06-21

Board | MPM3610 9V Buck | Page | P1
Drawn | J. Rostoker | Kerbal Controller Mk1 - Throttle Module New
Reviewed | J. Kerman

# Motorized Slide Potentiometer & Touch Sensor

# External Button/Switch Connections

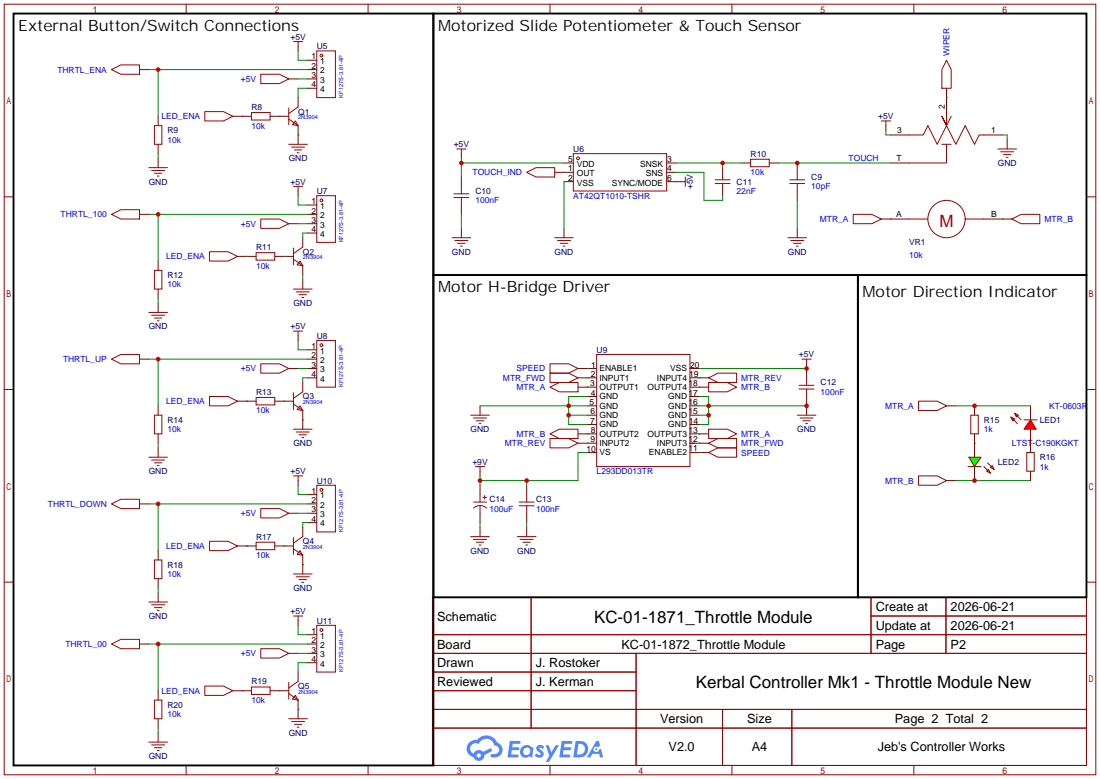
[picture p254: page 6]

Schematic | KC-01-1871_Throttle Module | Create at | 2026-06-21

Update at | 2026-06-21

Board | KC-01-1872_Throttle Module | Page | P2
Drawn | J. Rostoker | Kerbal Controller Mk1 - Throttle Module New
Reviewed | J. Kerman

Version | Size | Page 2 Total 2
V2.0 | A4 | Jeb's Controller Works
