bigJRo/KerbalControllerMk1/Documents/Drawings/KC-01-1872_V2.0_Throttle Module_PWB.pdf

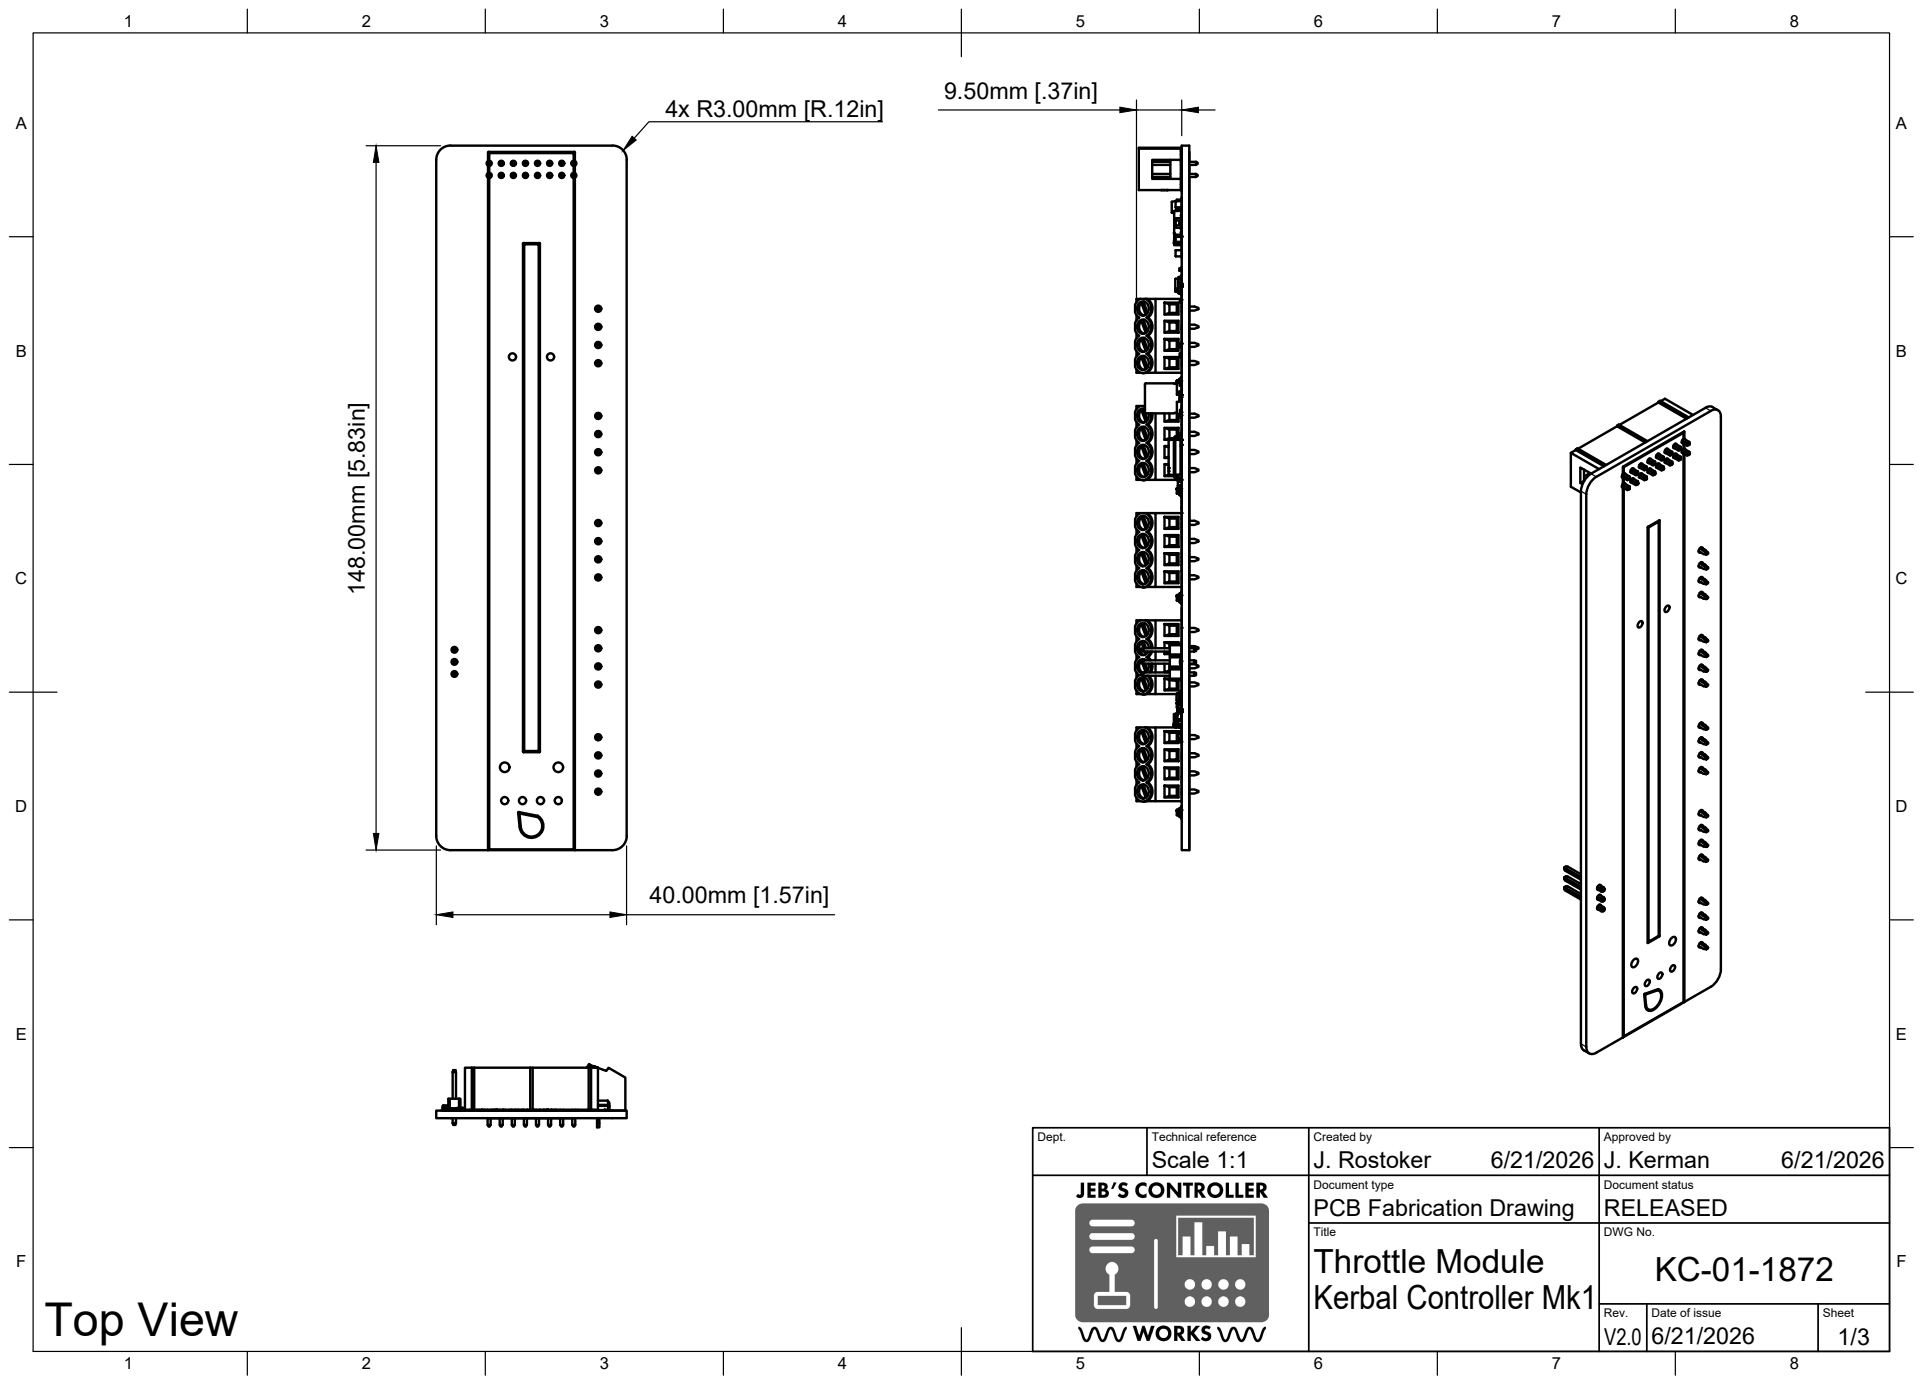
[picture p255: page 1]
Dept.; Technical reference; Created by; Approved by; Document type; Document status; Title; DWG No.; Rev.; Date of issue; Sheet; PCB Fabrication Drawing; RELEASED; Kerbal Controller Mk1; Throttle Module; Scale 1:1; J. Rostoker; J. Kerman; Top View

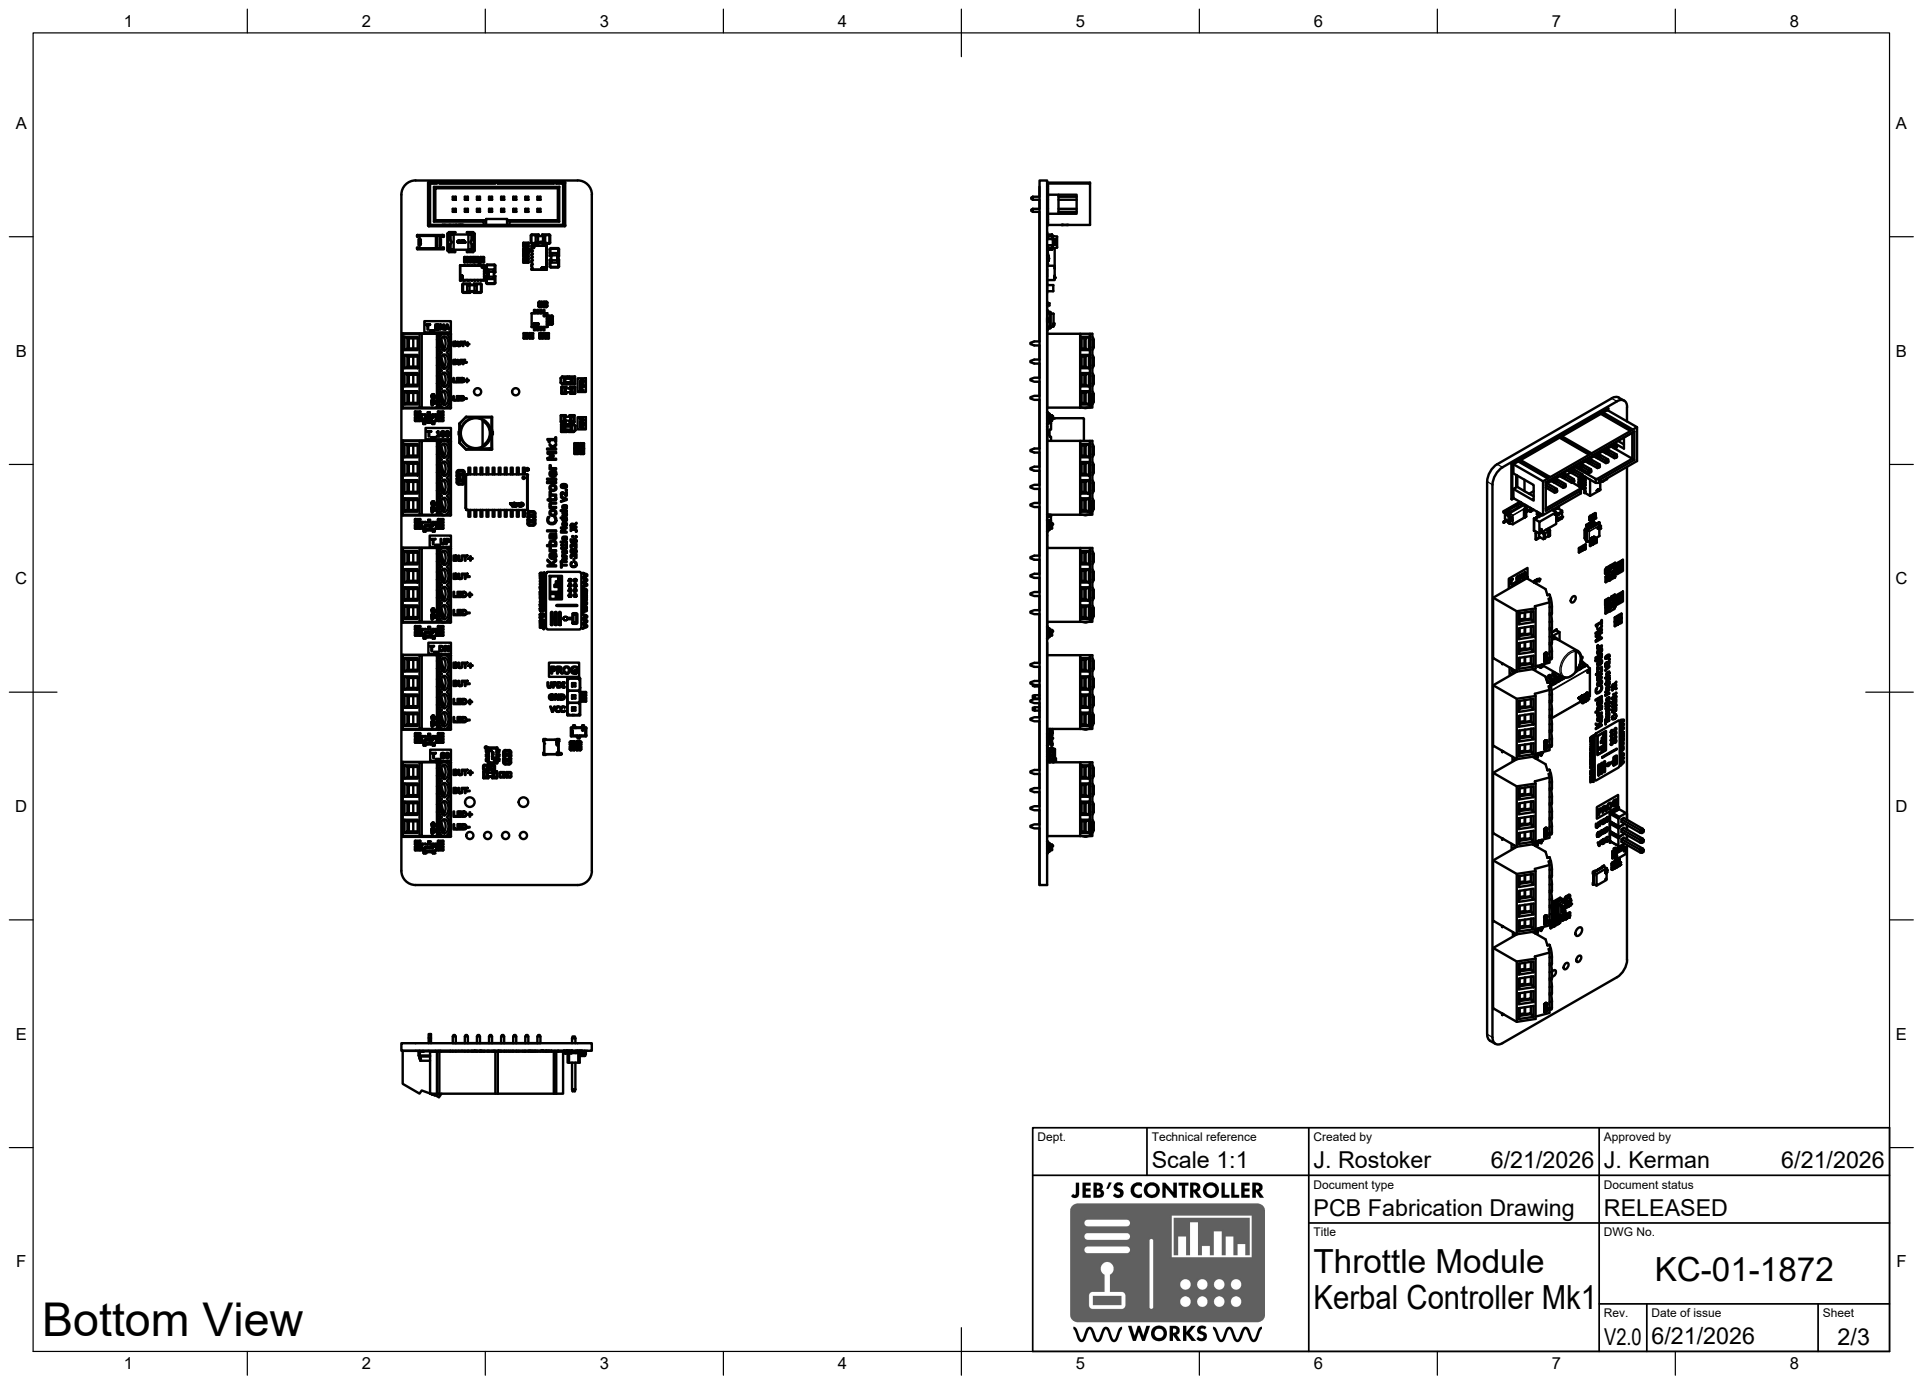
[picture p256: page 2]
Dept.; Technical reference; Created by; Approved by; Document type; Document status; Title; DWG No.; PCB Fabrication Drawing; RELEASED; Throttle Module; Scale 1:1; J. Rostoker; J. Kerman; Bottom View

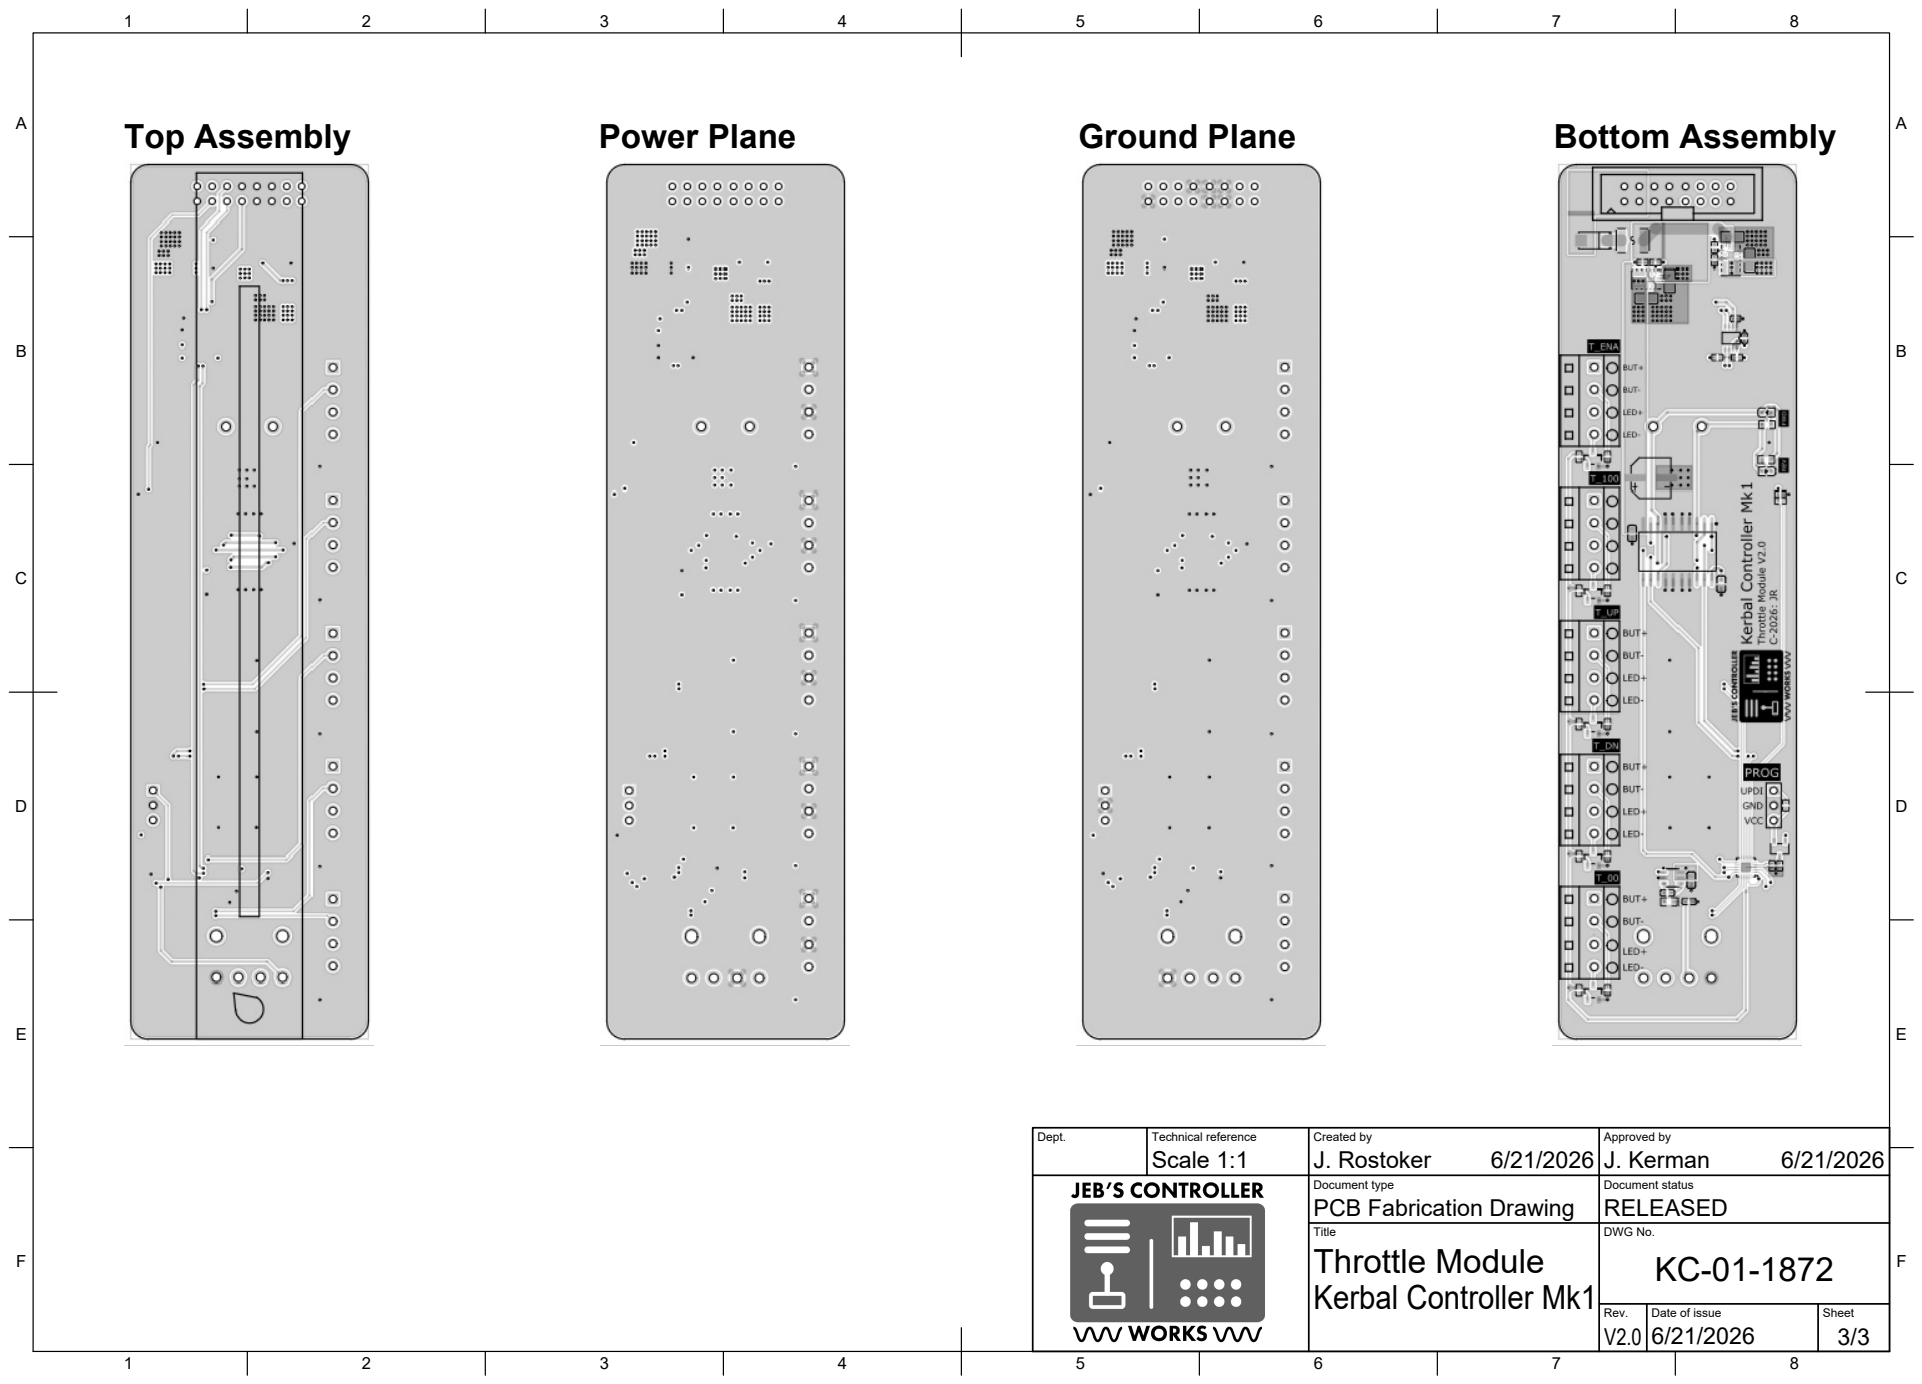
[picture p257: page 3]
Title; DWG No.; Throttle Module; Top Assembly; Power Plane; Ground Plane; Bottom Assembly

Dept. | Technical reference Scale 1:1 | Created by J. Rostoker 6/21/2026 | Approved by J. Kerman 6/21/2026

Document type PCB Fabrication Drawing | Document status RELEASED
