bigJRo/KerbalControllerMk1/Documents/Drawings/KC-01-1900_RevA_2in TFT Display Driver Complete.pdf

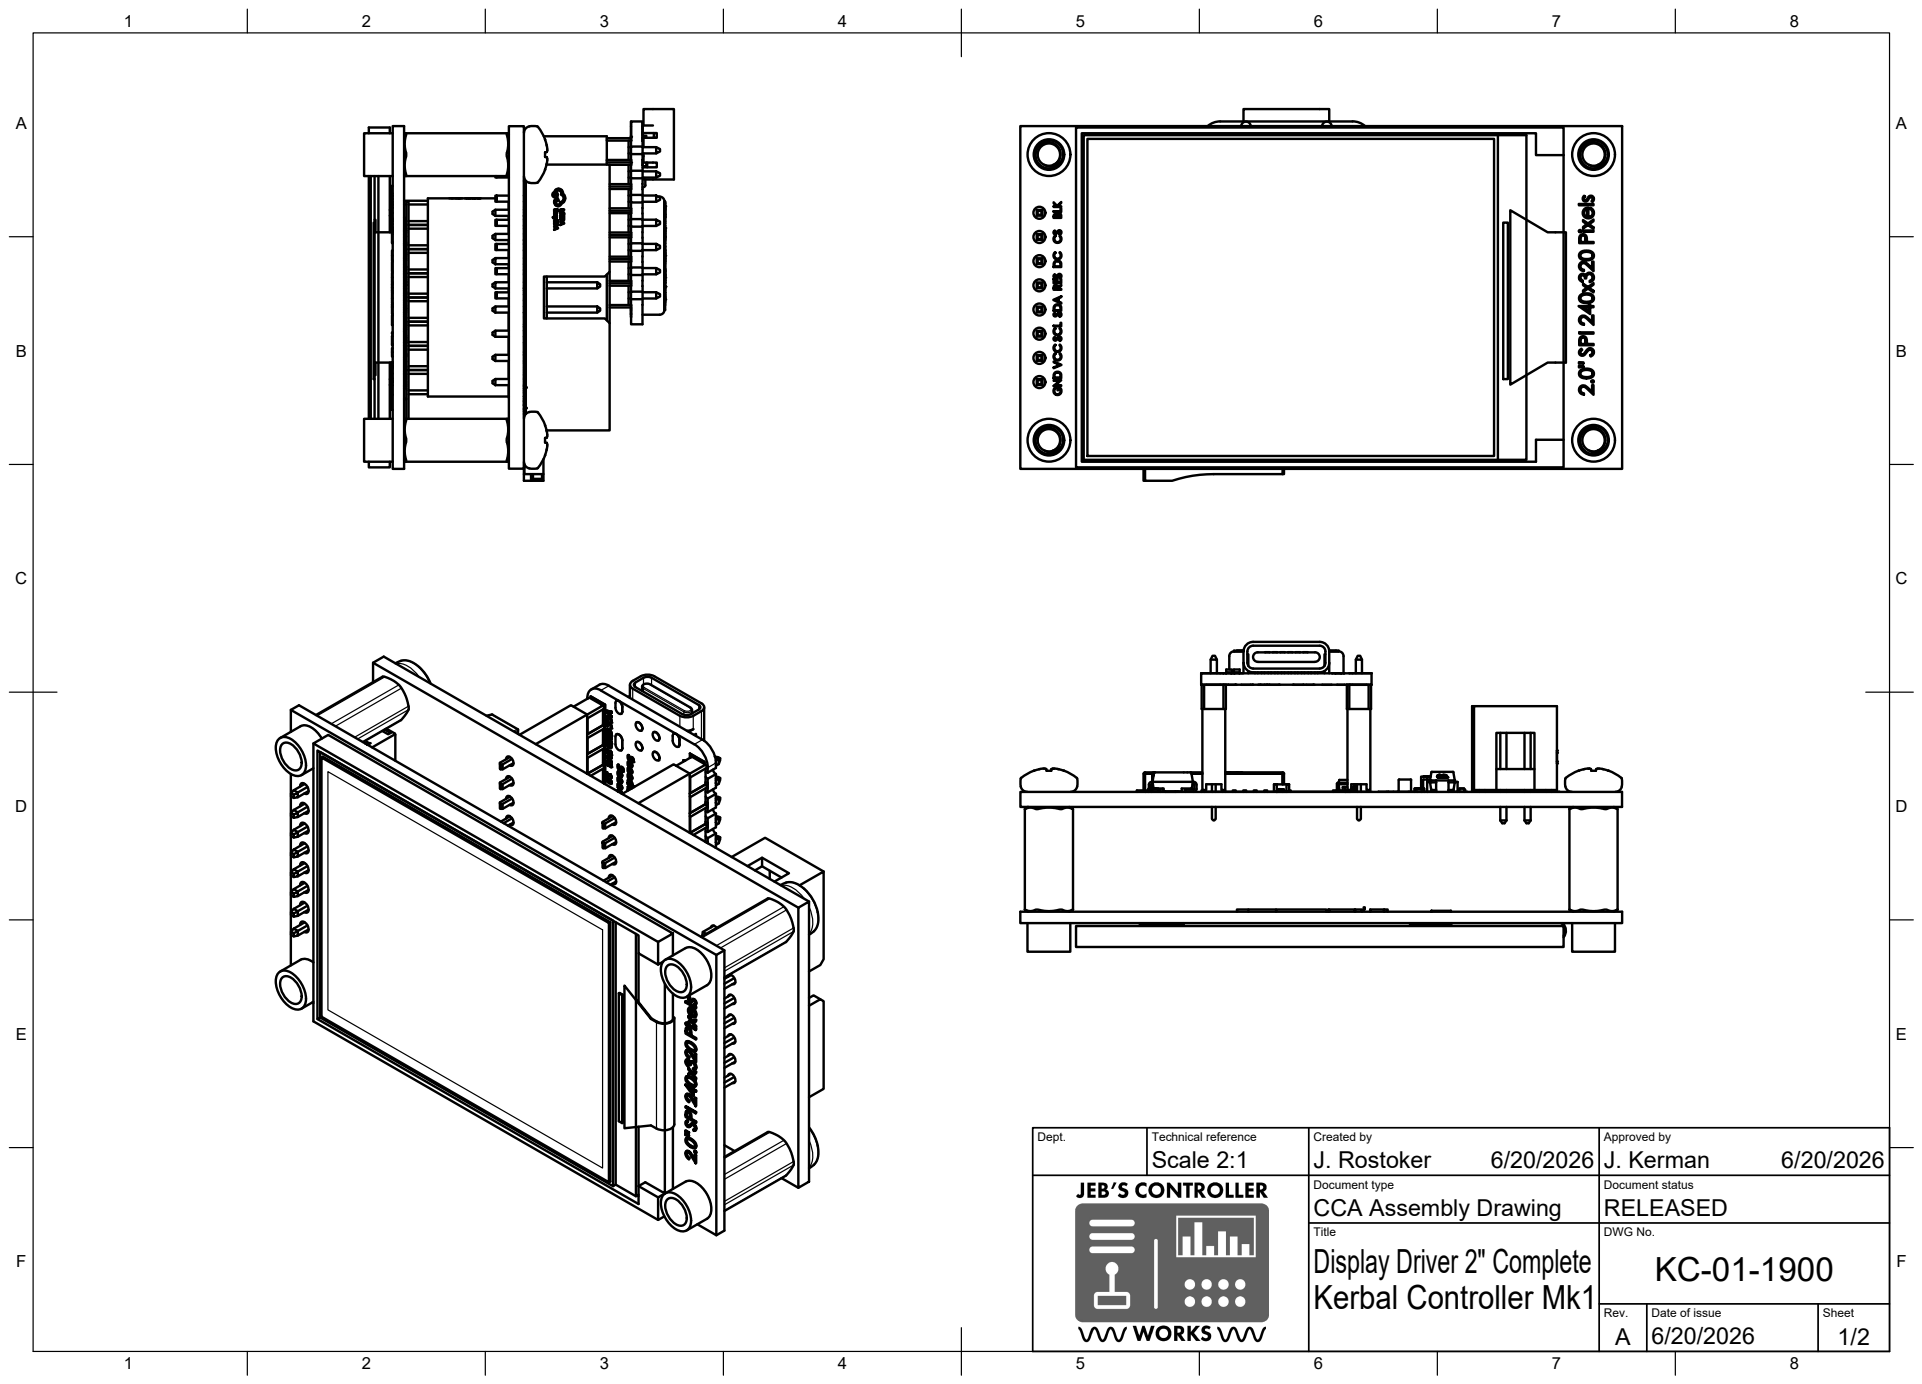
[picture p258: page 1]
Dept.; Technical reference; Created by; Approved by; Document type; Document status; Title; DWG No.; Rev.; Date of issue; Sheet; CCA Assembly Drawing; RELEASED; Kerbal Controller Mk1; Display Driver 2" Complete; Scale 2:1; J. Rostoker; J. Kerman

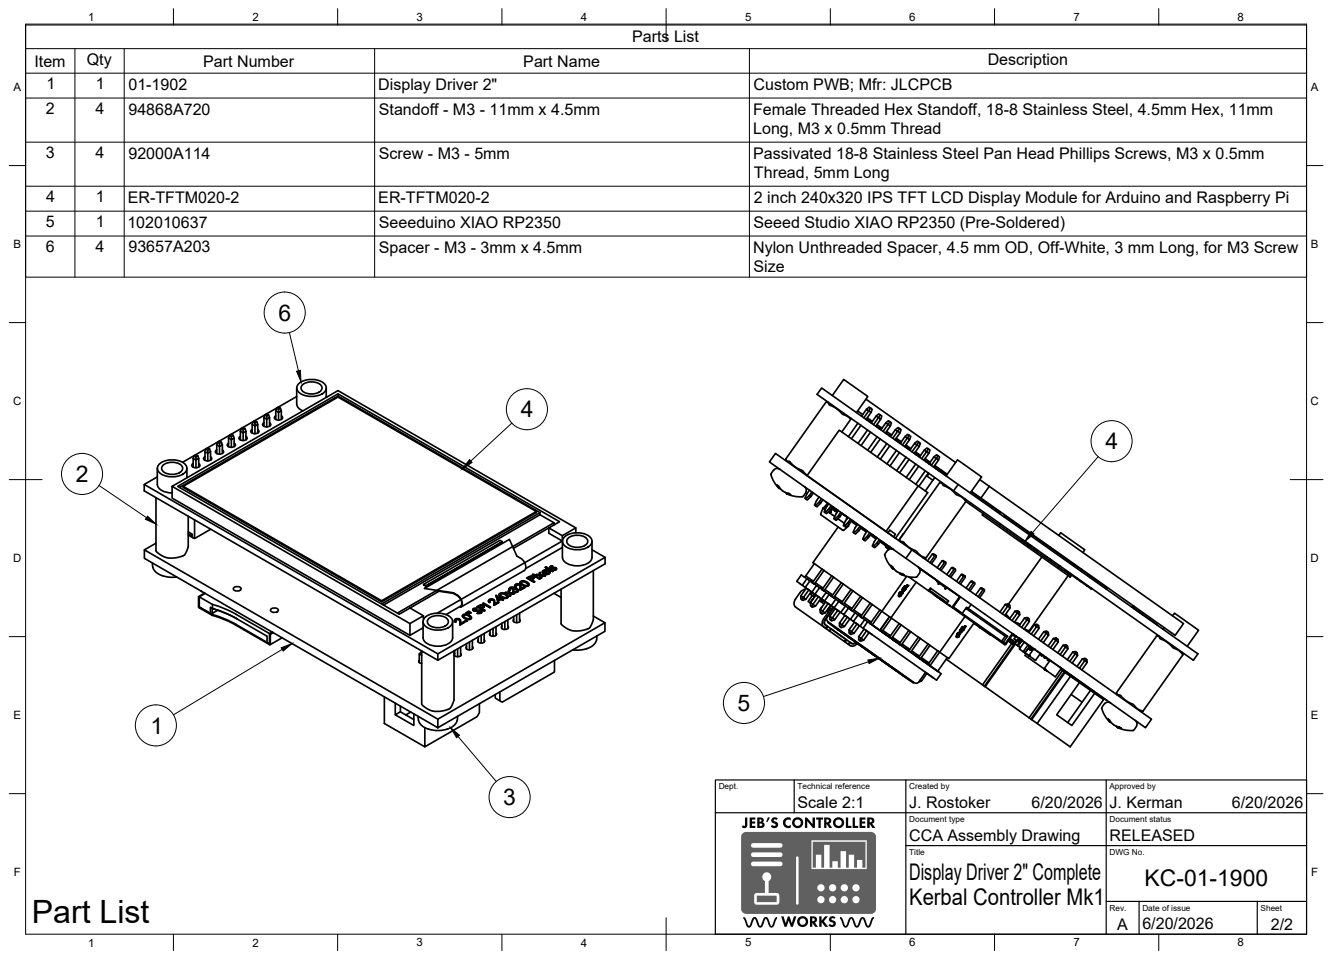
[picture p259: page 2]
Part List

Parts List

Item | Qty | Part Number | Part Name | Description
1 | 1 | 01-1902 | Display Driver 2" | Custom PWB; Mfr: JLCPCB
2 | 4 | 94868A720 | Standoff - M3 - 11mm x 4.5mm | Female Threaded Hex Standoff, 18-8 Stainless Steel, 4.5mm Hex, 11mm Long, M3 x 0.5mm Thread

3 | 4 | 92000A114 | Screw - M3 - 5mm | Passivated 18-8 Stainless Steel Pan Head Phillips Screws, M3 x 0.5mm Thread, 5mm Long

4 | 1 | ER-TFTM020-2 | ER-TFTM020-2 | 2 inch 240x320 IPS TFT LCD Display Module for Arduino and Raspberry Pi
5 | 1 | 102010637 | Seeeduino XIAO RP2350 | Seeed Studio XIAO RP2350 (Pre-Soldered)
6 | 4 | 93657A203 | Spacer - M3 - 3mm x 4.5mm | Nylon Unthreaded Spacer, 4.5 mm OD, Off-White, 3 mm Long, for M3 Screw Size

Dept. | Technical reference Scale 2:1 | Created by J. Rostoker 6/20/2026 | Approved by J. Kerman 6/20/2026

Document type CCA Assembly Drawing | Document status RELEASED

Title Display Driver 2" Complete Kerbal Controller Mk1 | DWG No. KC-01-1900

Rev. A | Date of issue 6/20/2026 | Sheet 2/2
