bigJRo/KerbalControllerMk1/Documents/Drawings/KC-01-1901_V2.0_2in TFT Display Driver_SCH.pdf

# Microcontroller

## Seeed XIAO RP2350

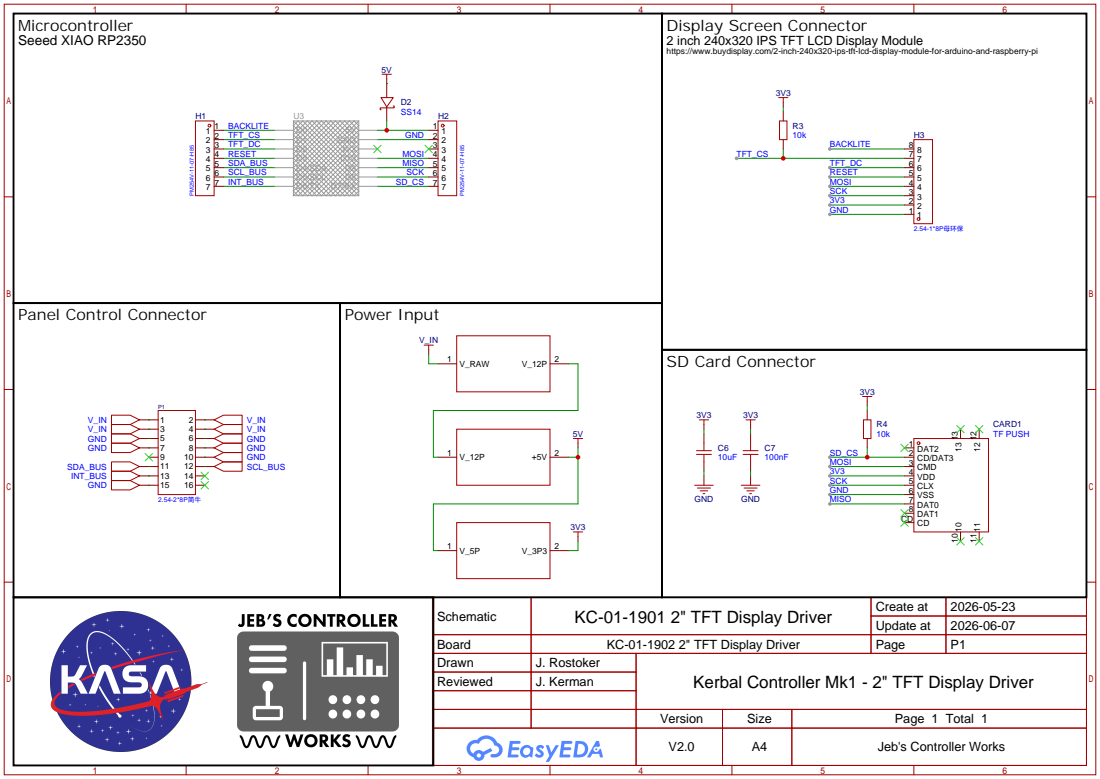
[picture p260: page 1]

Display Screen Connector
2 inch 240x320 IPS TFT LCD Display Module
https://www.buydisplay.com/2-inch-240x320-ips-tft-lcd-display-module-for-arduino-and-raspberry-pi

Schematic | KC-01-1901 2" TFT Display Driver | Create at | 2026-05-23

Update at | 2026-06-07

Board | KC-01-1902 2" TFT Display Driver | Page | P1
Drawn | J. Rostoker | Kerbal Controller Mk1 - 2" TFT Display Driver
Reviewed | J. Kerman

Version | Size | Page 1 Total 1
V2.0 | A4 | Jeb's Controller Works

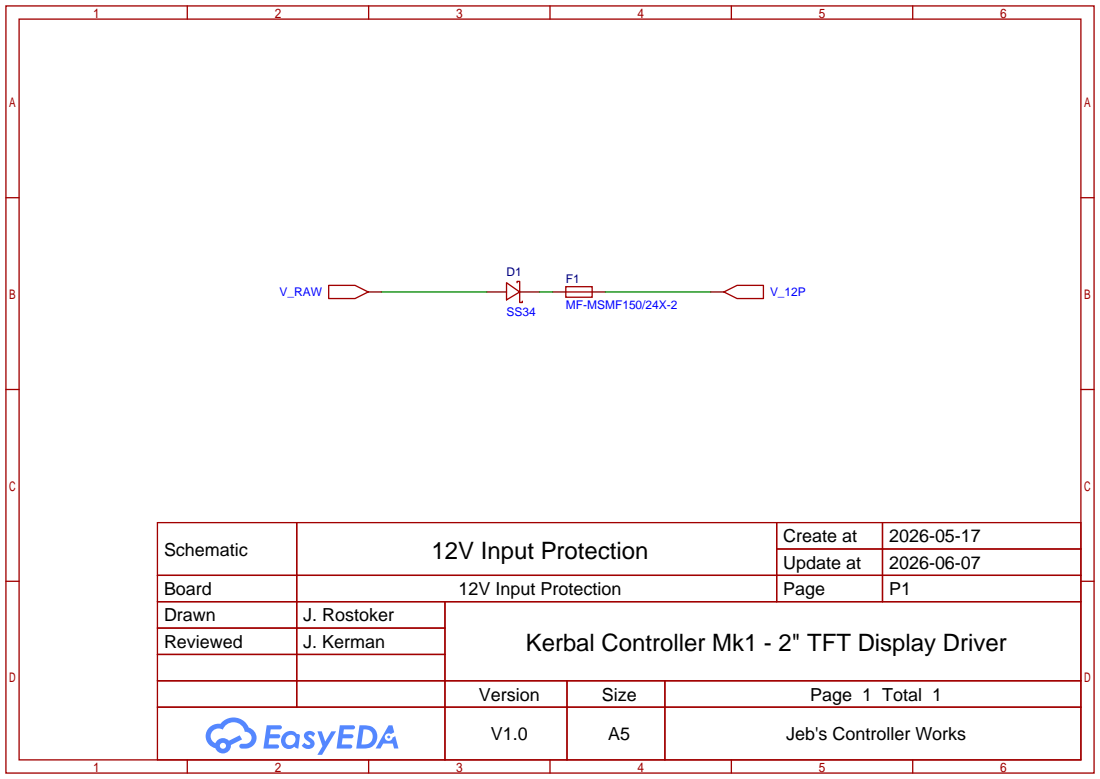
[picture p261: page 2]

Schematic | 12V Input Protection | Create at | 2026-05-17

Update at | 2026-06-07

Board | 12V Input Protection | Page | P1
Drawn | J. Rostoker | Kerbal Controller Mk1 - 2" TFT Display Driver
Reviewed | J. Kerman

Version | Size | Page 1 Total 1
V1.0 | A5 | Jeb's Controller Works

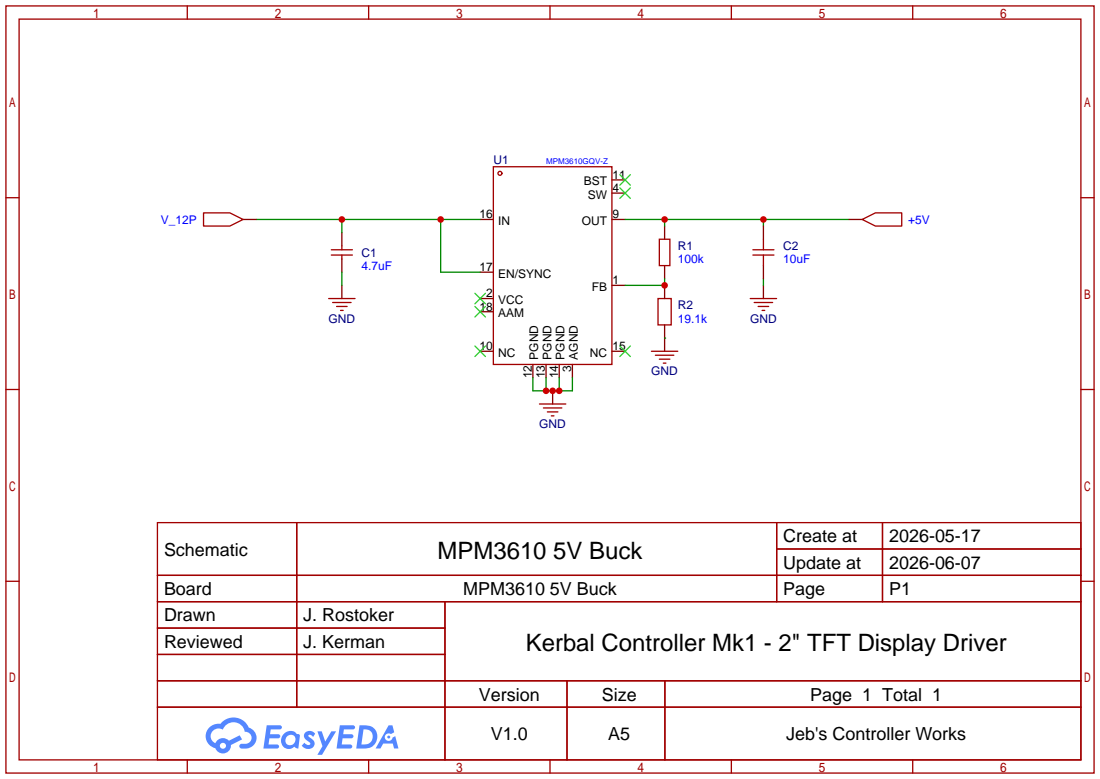
[picture p262: page 3]

Schematic | MPM3610 5V Buck | Create at | 2026-05-17

Update at | 2026-06-07

Board | MPM3610 5V Buck | Page | P1
Drawn | J. Rostoker | Kerbal Controller Mk1 - 2" TFT Display Driver
Reviewed | J. Kerman

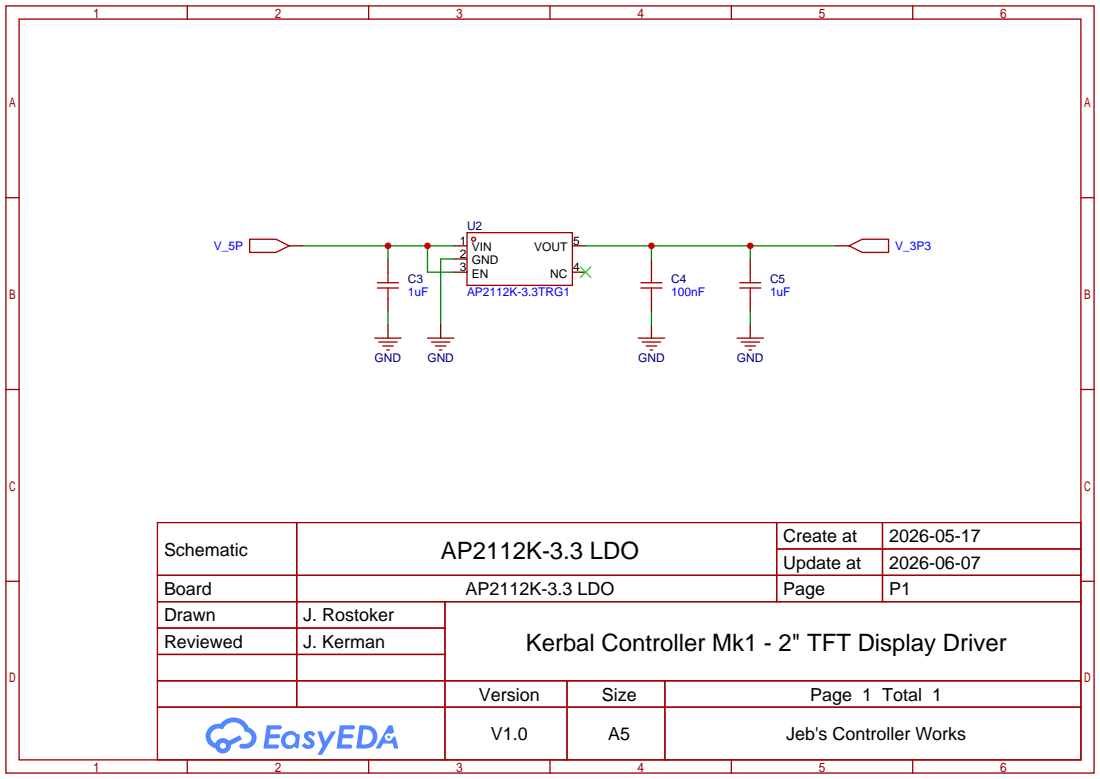
[picture p263: page 4]

Schematic | AP2112K-3.3 LDO | Create at | 2026-05-17

Update at | 2026-06-07

Board | AP2112K-3.3 LDO | Page | P1
Drawn | J. Rostoker | Kerbal Controller Mk1 - 2" TFT Display Driver
Reviewed | J. Kerman
