bigJRo/KerbalControllerMk1/Documents/Drawings/KC-01-1902 V2.0_2in TFT Display Driver_PWB.pdf

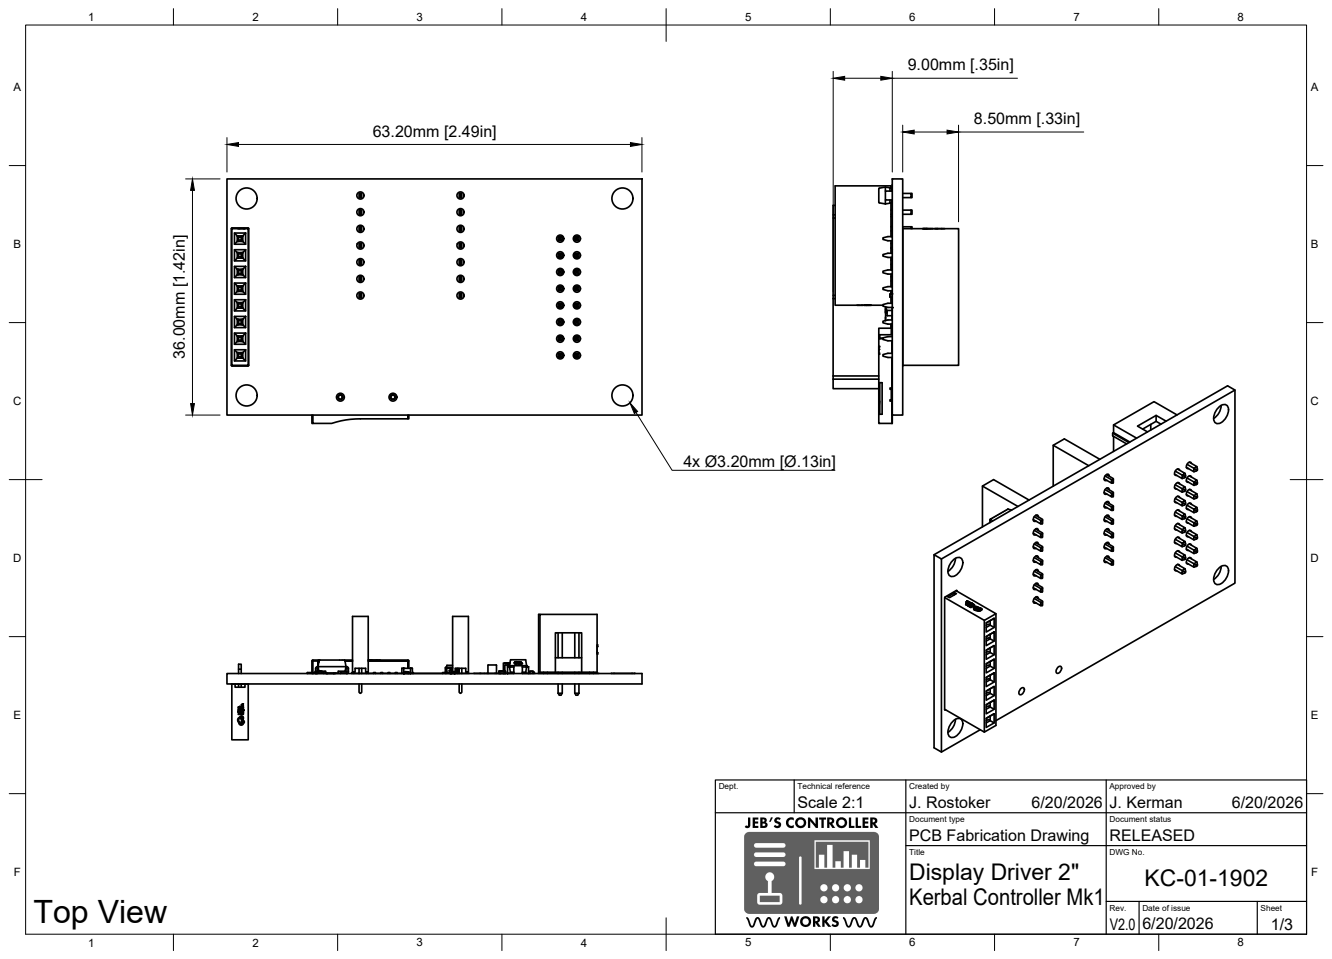
[picture p264: page 1]
Title; DWG No.; Rev.; Date of issue; Sheet; Kerbal Controller Mk1; Display Driver 2"; Top View

Dept. | Technical reference Scale 2:1 | Created by J. Rostoker 6/20/2026 | Approved by J. Kerman 6/20/2026

Document type PCB Fabrication Drawing | Document status RELEASED

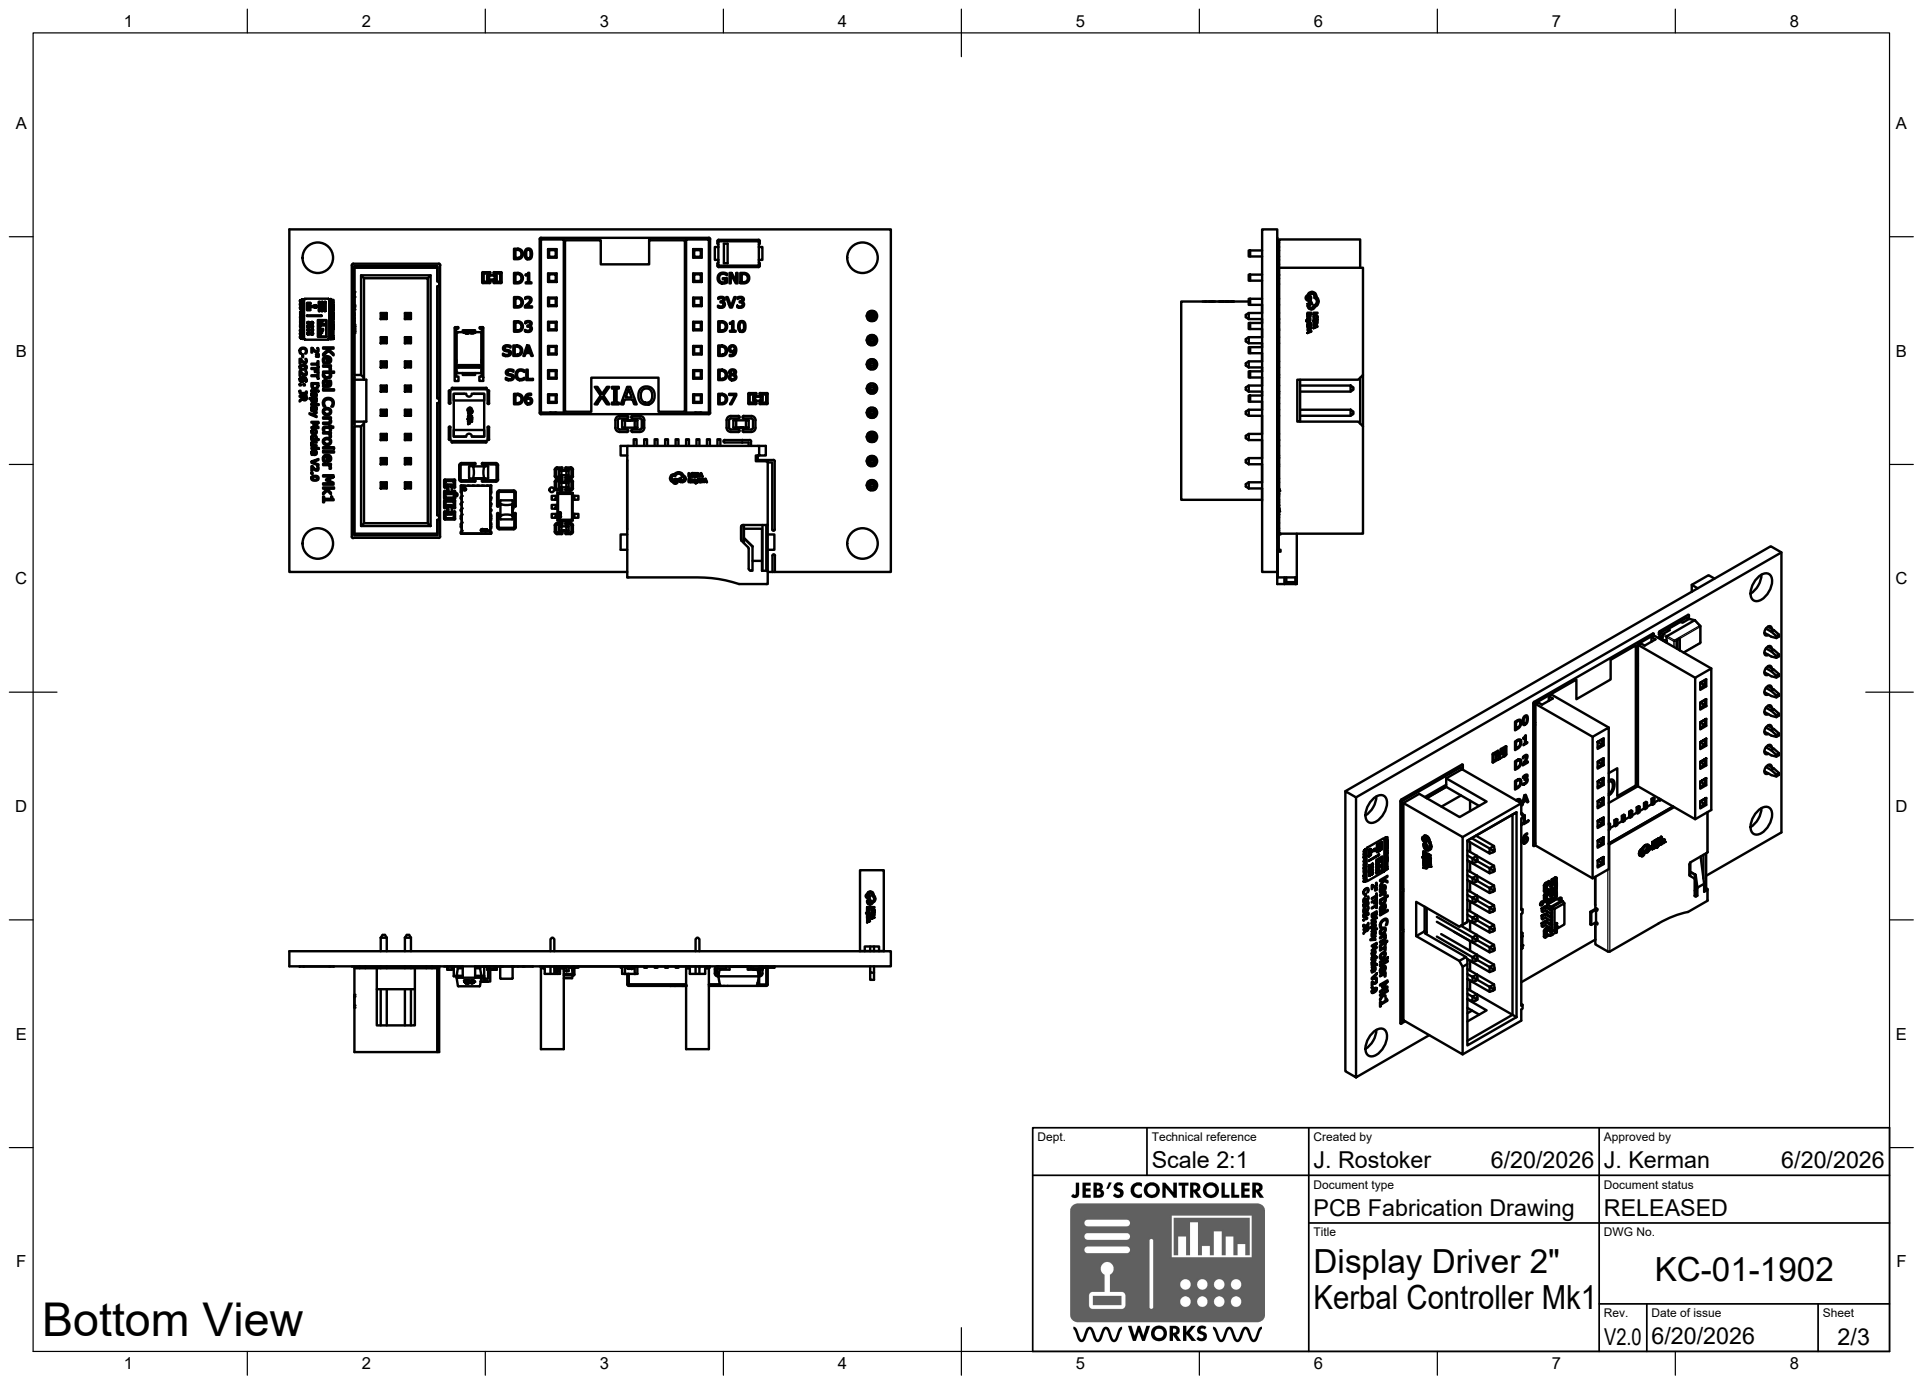
[picture p265: page 2]
Dept.; Technical reference; Created by; Approved by; Document type; Document status; Title; DWG No.; PCB Fabrication Drawing; RELEASED; Display Driver 2"; Scale 2:1; J. Rostoker; J. Kerman; Bottom View

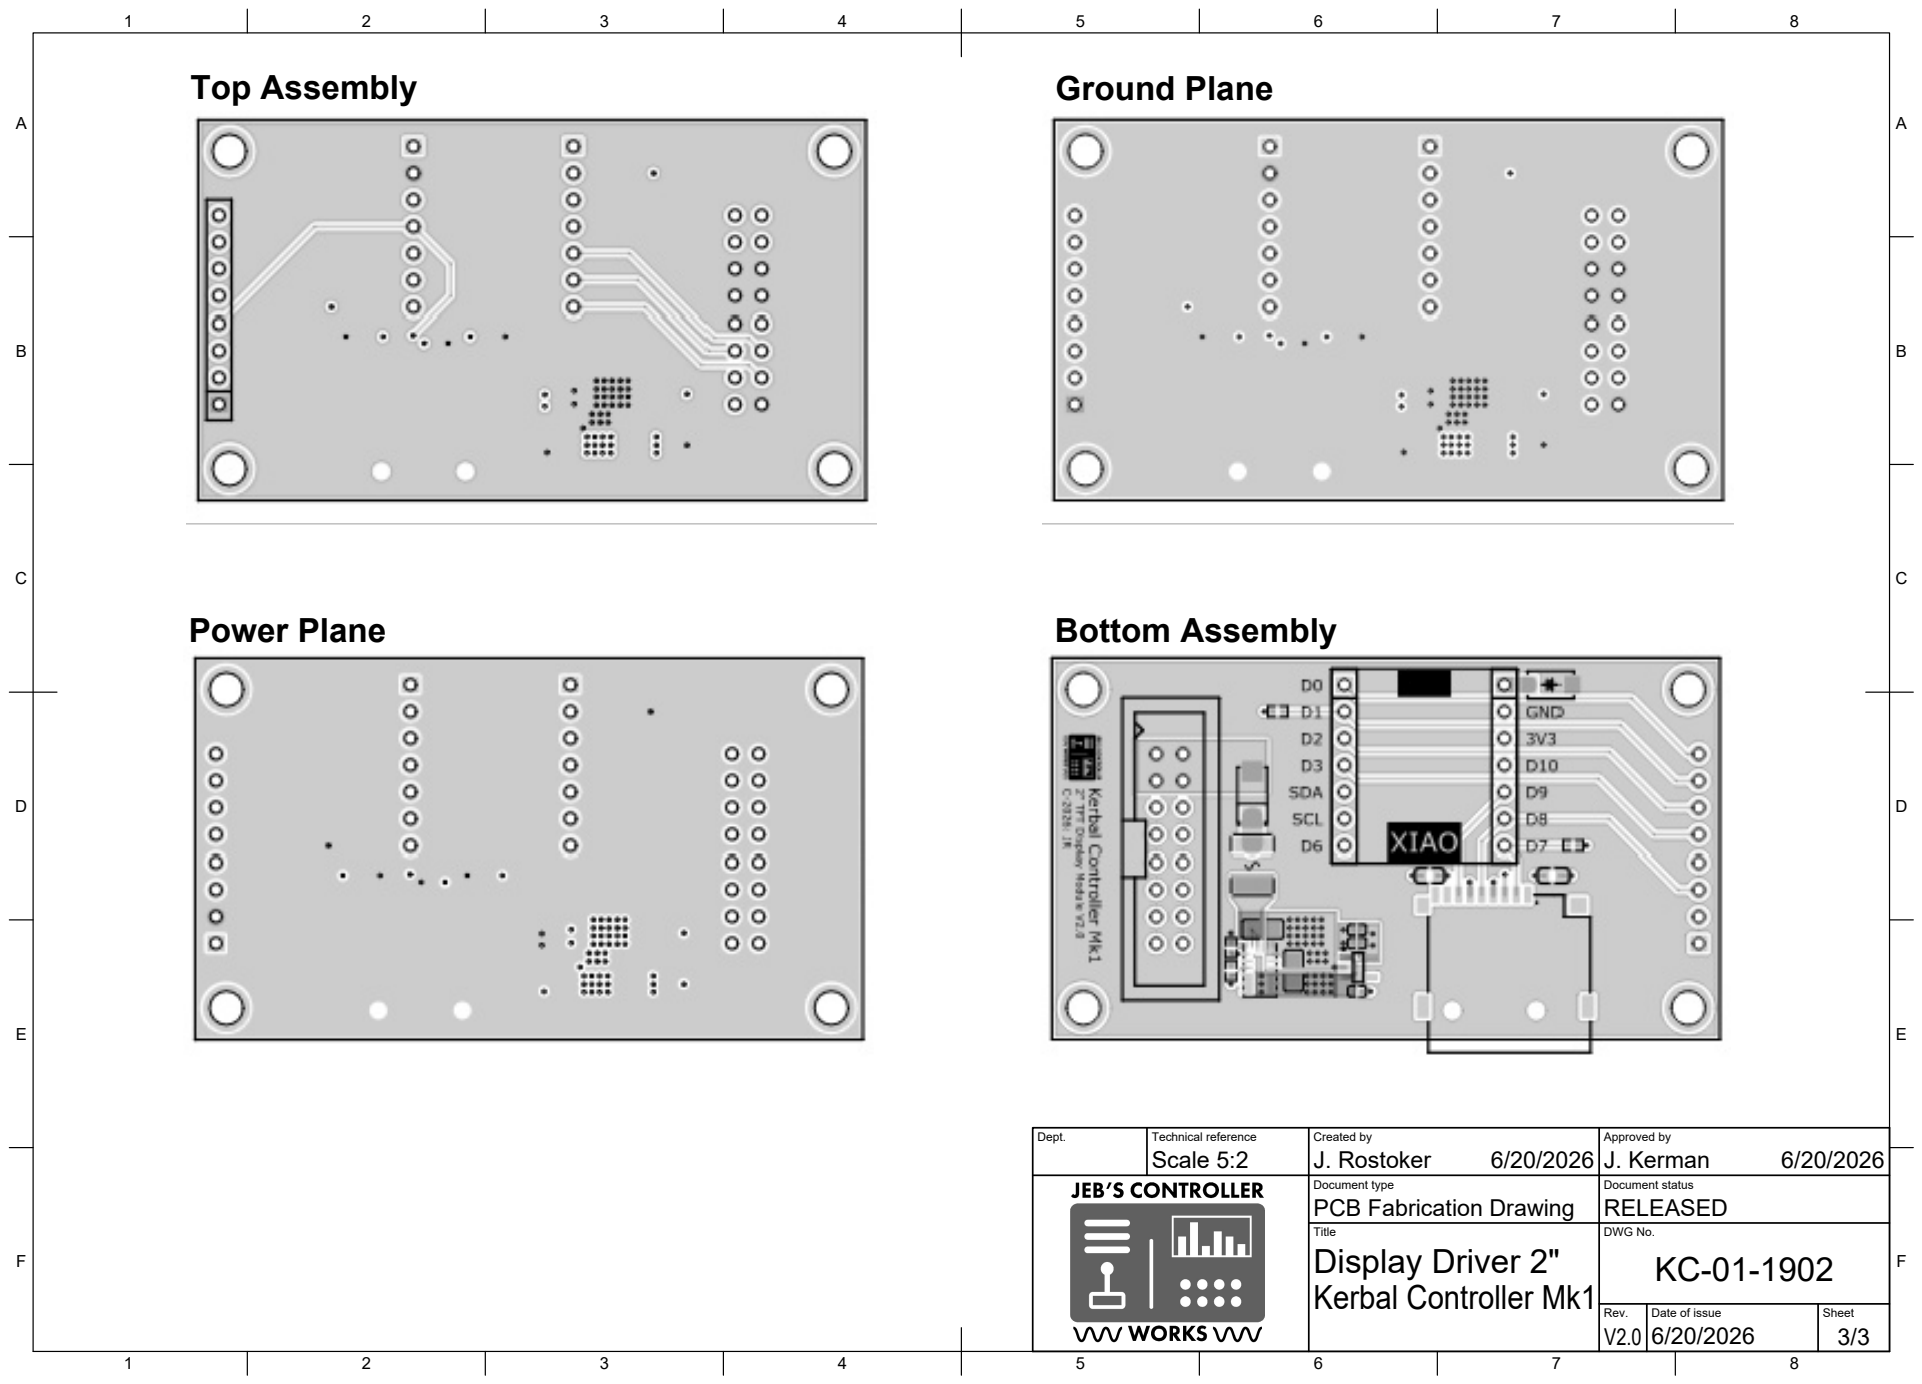
[picture p266: page 3]
Title; DWG No.; Display Driver 2"; Top Assembly; Ground Plane; Power Plane; Bottom Assembly

Dept. | Technical reference Scale 5:2 | Created by J. Rostoker 6/20/2026 | Approved by J. Kerman 6/20/2026

Document type PCB Fabrication Drawing | Document status RELEASED
