bigJRo/KerbalControllerMk1/Documents/Drawings/KC-01-1912_V2.0_7in TFT Display Driver_PWB.pdf

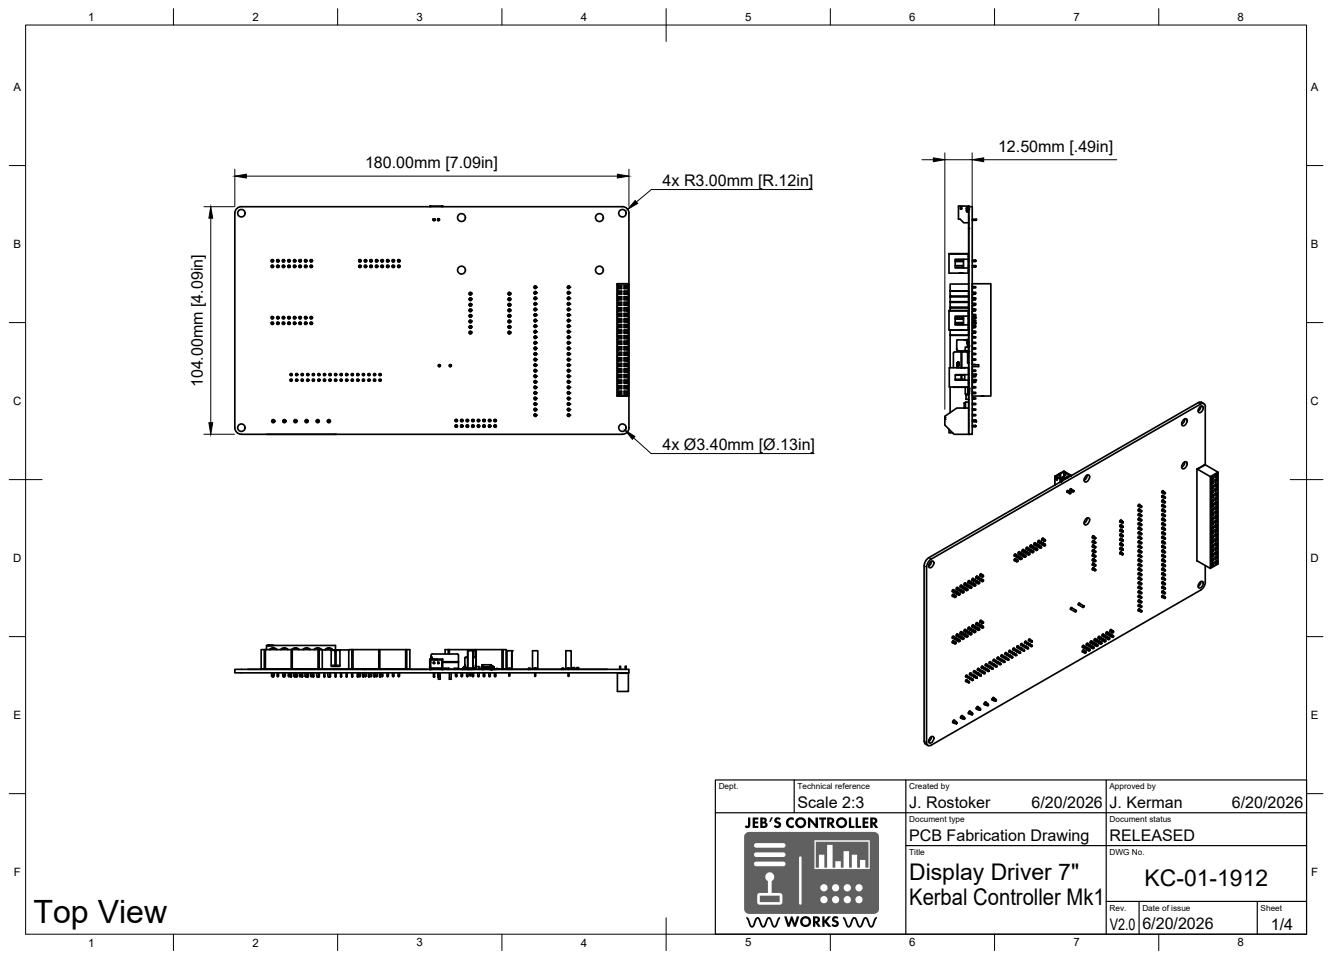
[picture p269: page 1]
Dept.; Technical reference; Created by; Approved by; Document type; Document status; Title; DWG No.; Rev.; Date of issue; Sheet; PCB Fabrication Drawing; RELEASED; Kerbal Controller Mk1; Display Driver 7"; Scale 2:3; J. Rostoker; J. Kerman; Top View

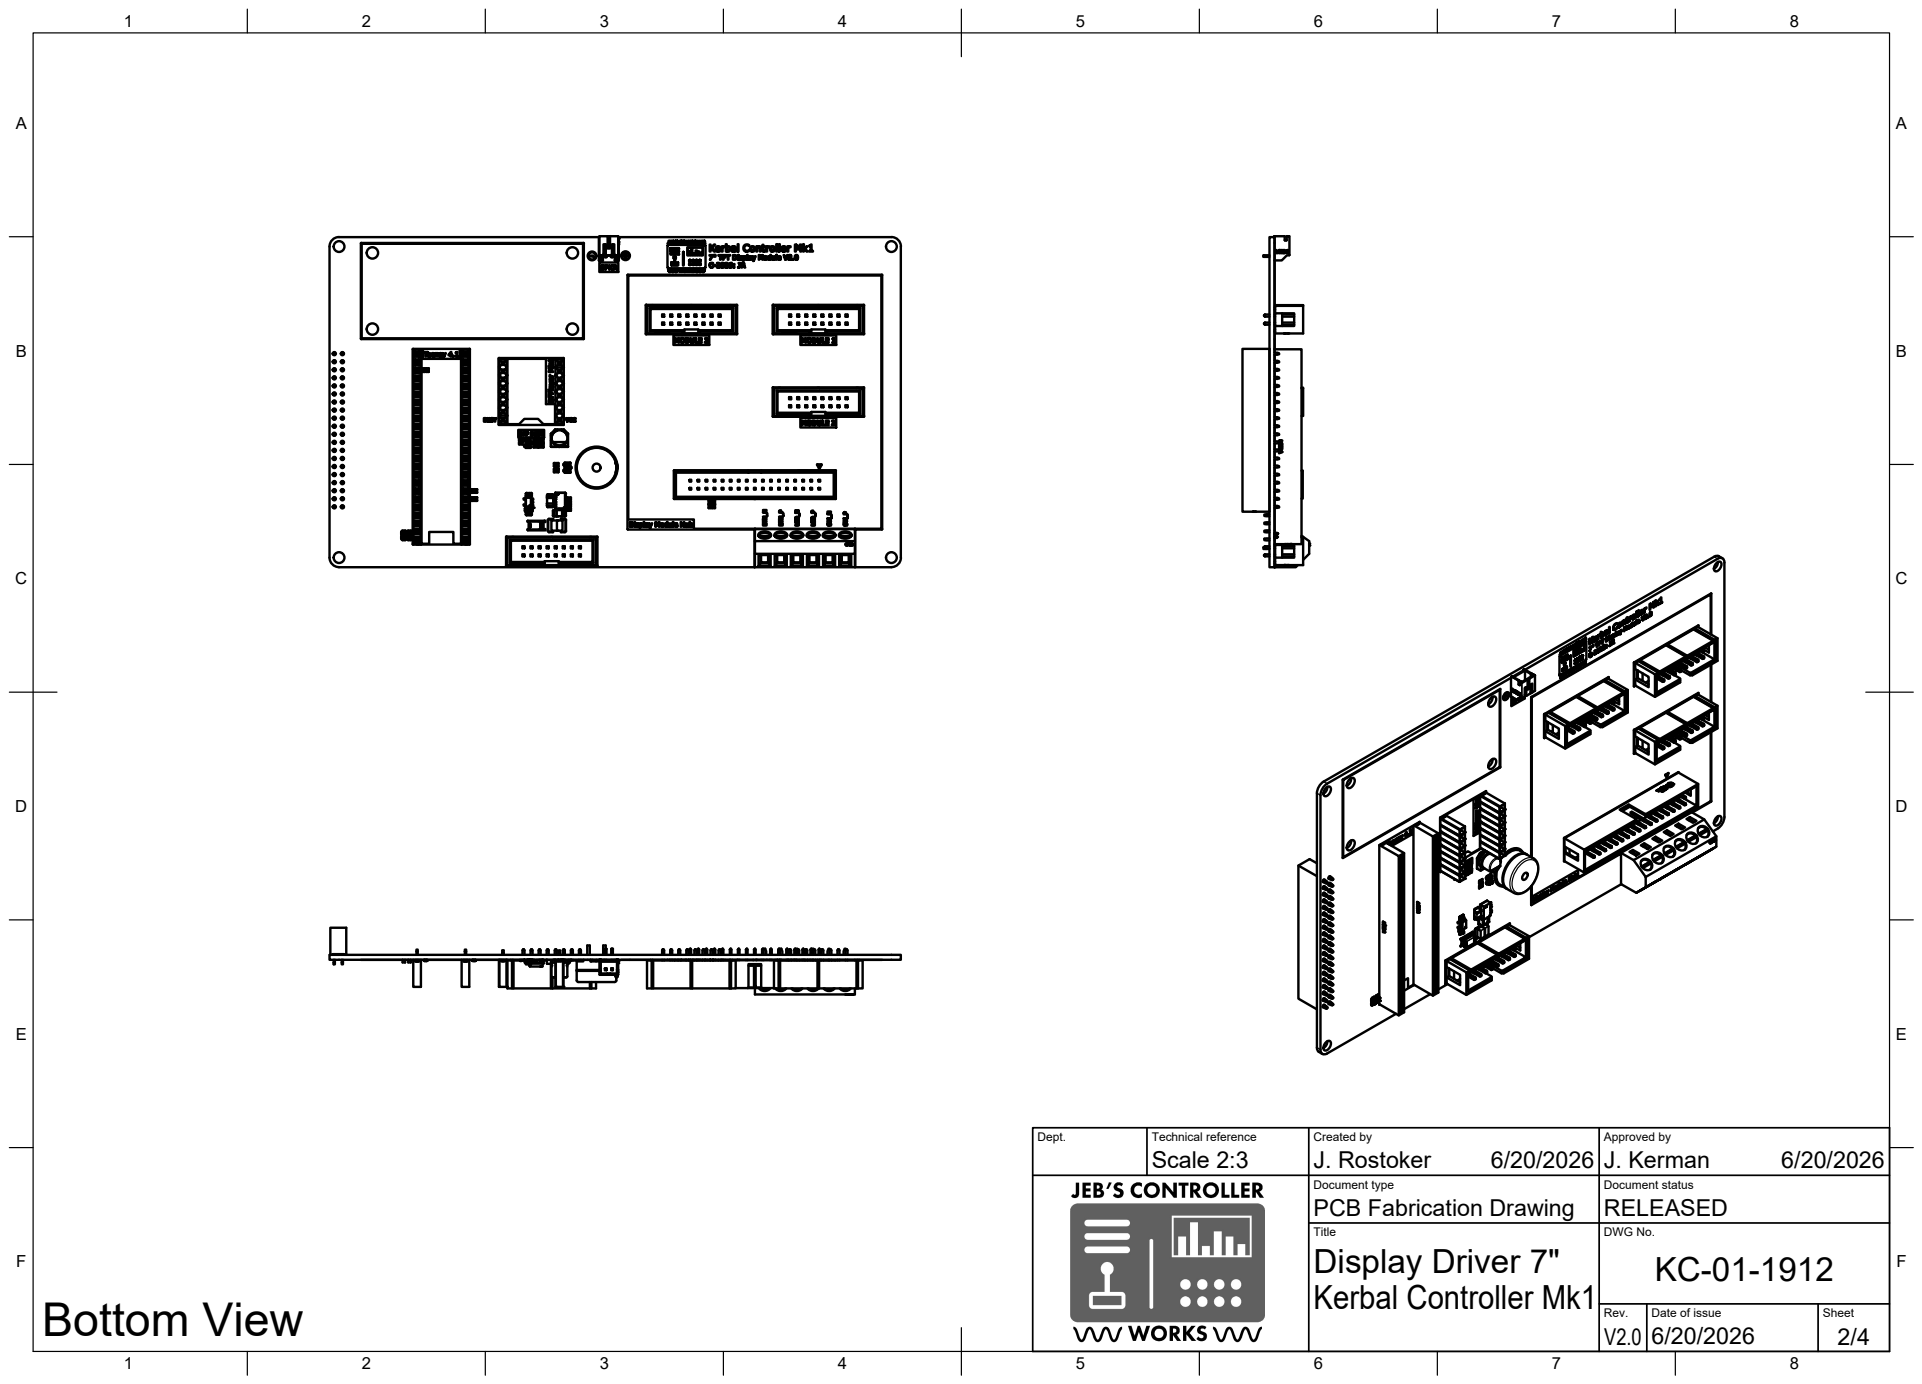
[picture p270: page 2]
Dept.; Technical reference; Created by; Approved by; Document type; Document status; Title; DWG No.; PCB Fabrication Drawing; RELEASED; Display Driver 7"; Scale 2:3; J. Rostoker; J. Kerman; Bottom View

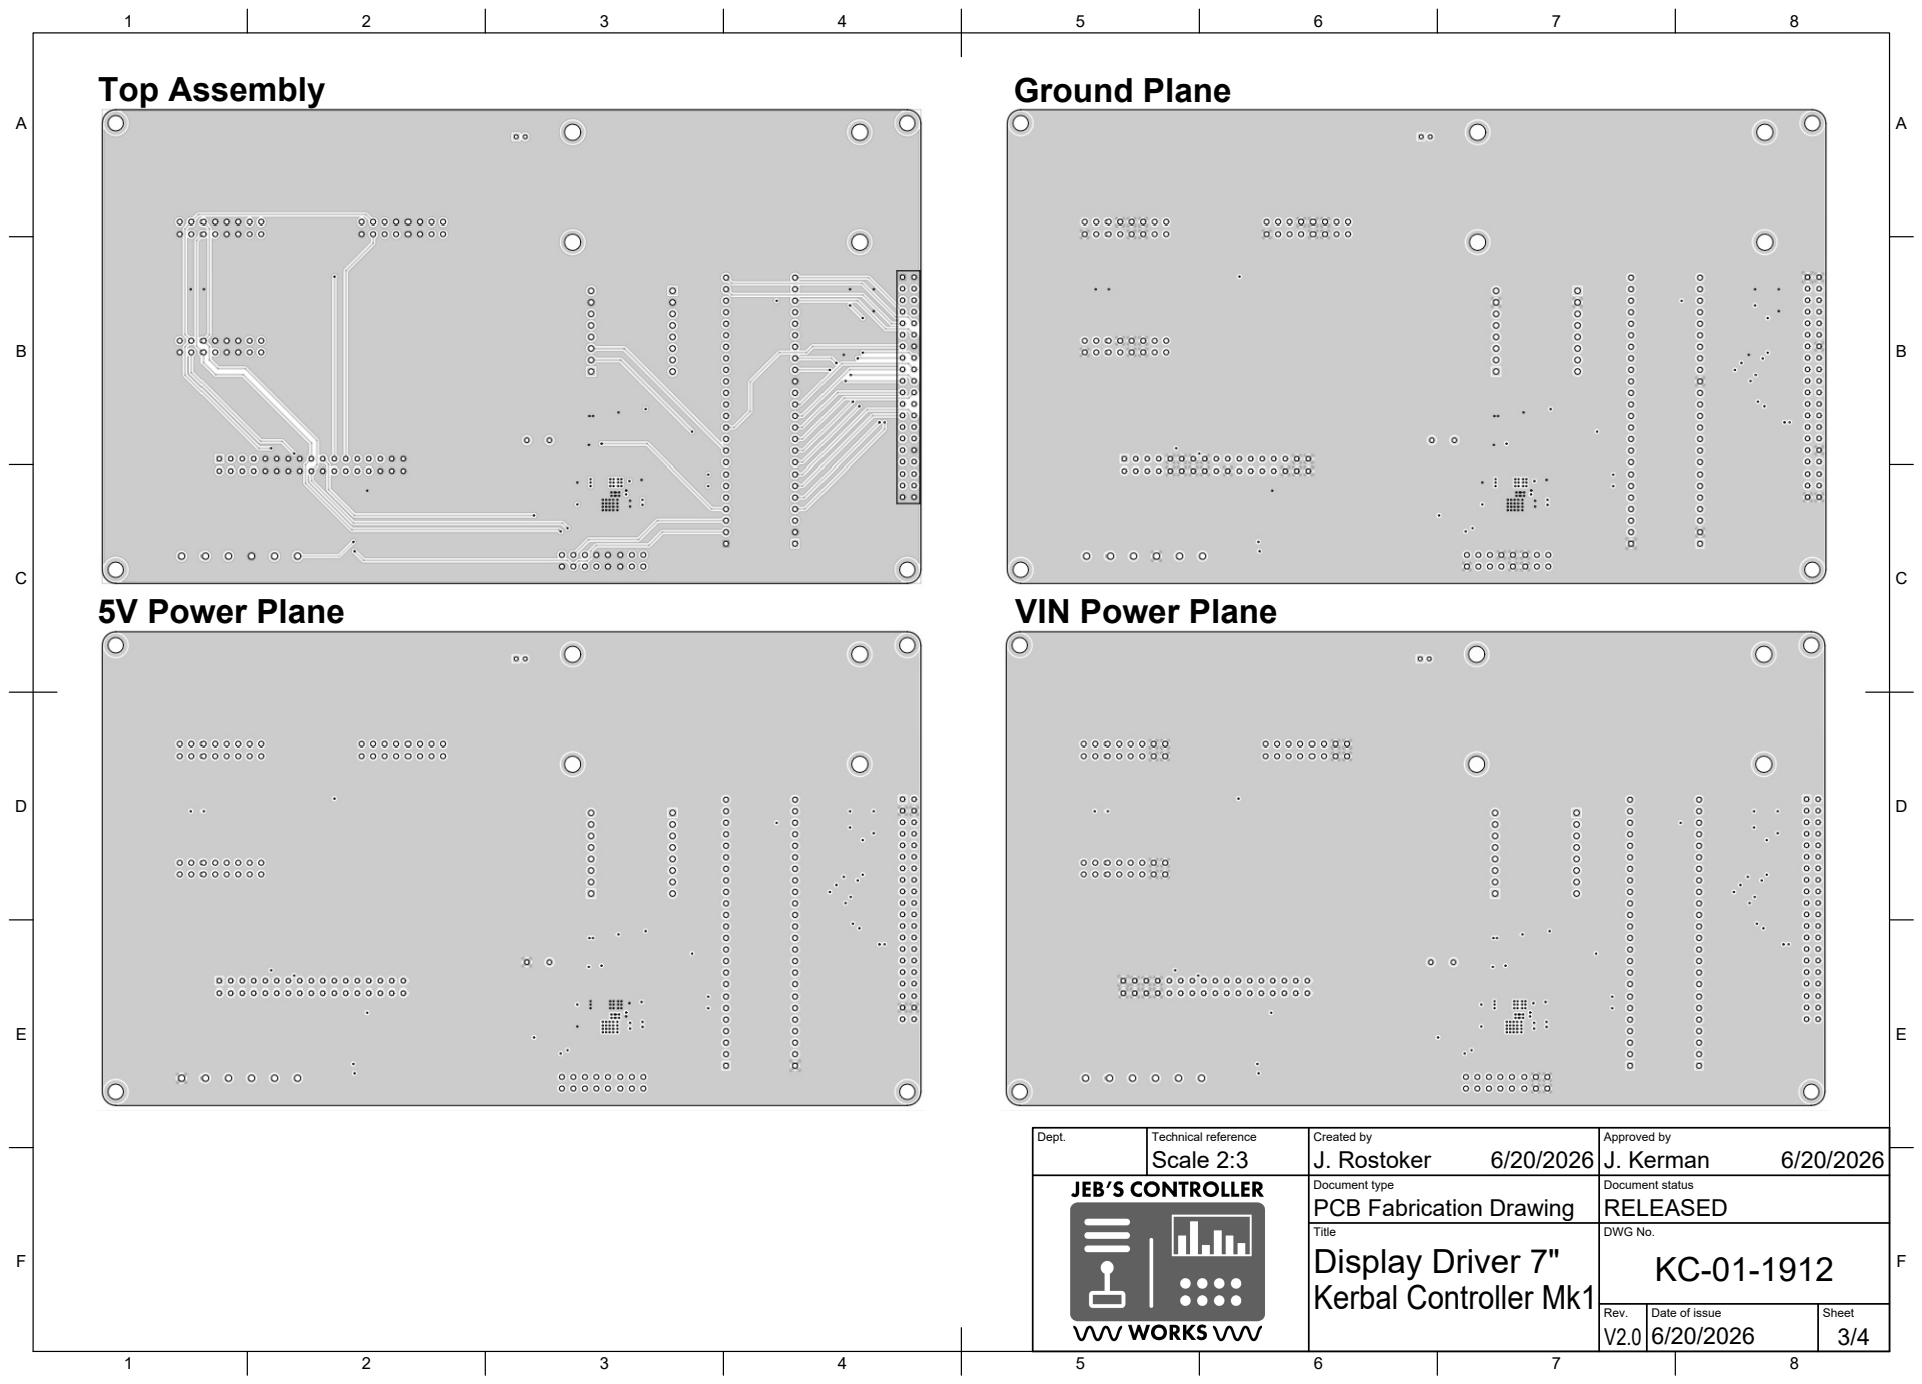
[picture p271: page 3]
Title; DWG No.; Display Driver 7"; Top Assembly; 5V Power Plane; VIN Power Plane; Ground Plane

Dept. | Technical reference Scale 2:3 | Created by J. Rostoker 6/20/2026 | Approved by J. Kerman 6/20/2026

Document type PCB Fabrication Drawing | Document status RELEASED

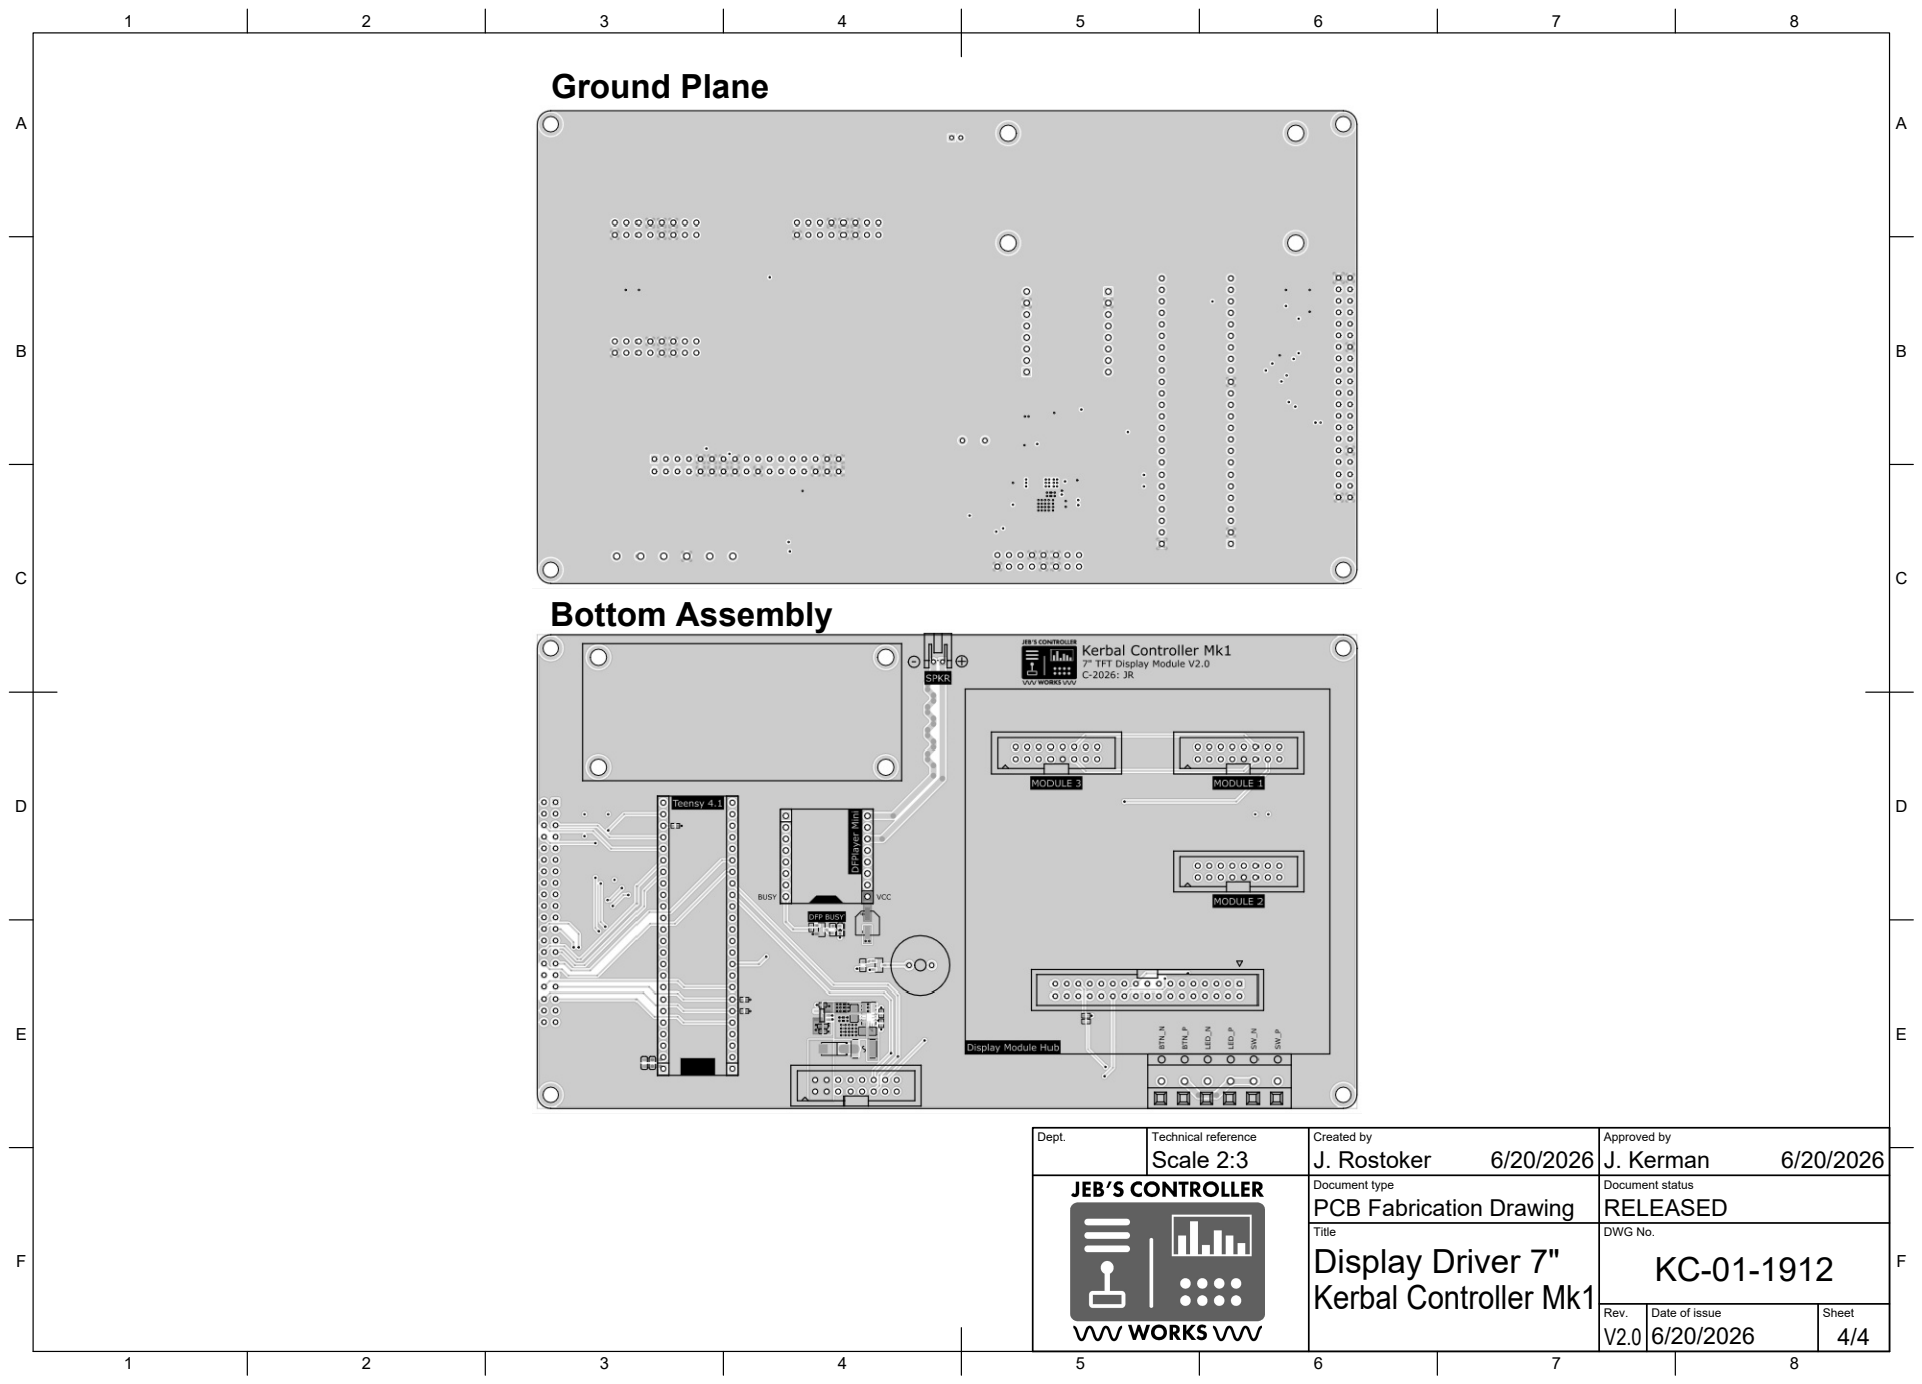
[picture p272: page 4]
Title; DWG No.; Display Driver 7"; Ground Plane; Bottom Assembly

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

Document type PCB Fabrication Drawing | Document status RELEASED
