bigJRo/KerbalControllerMk1/Documents/Drawings/KC-01-1051_RevA_Panel B2 Base.pdf

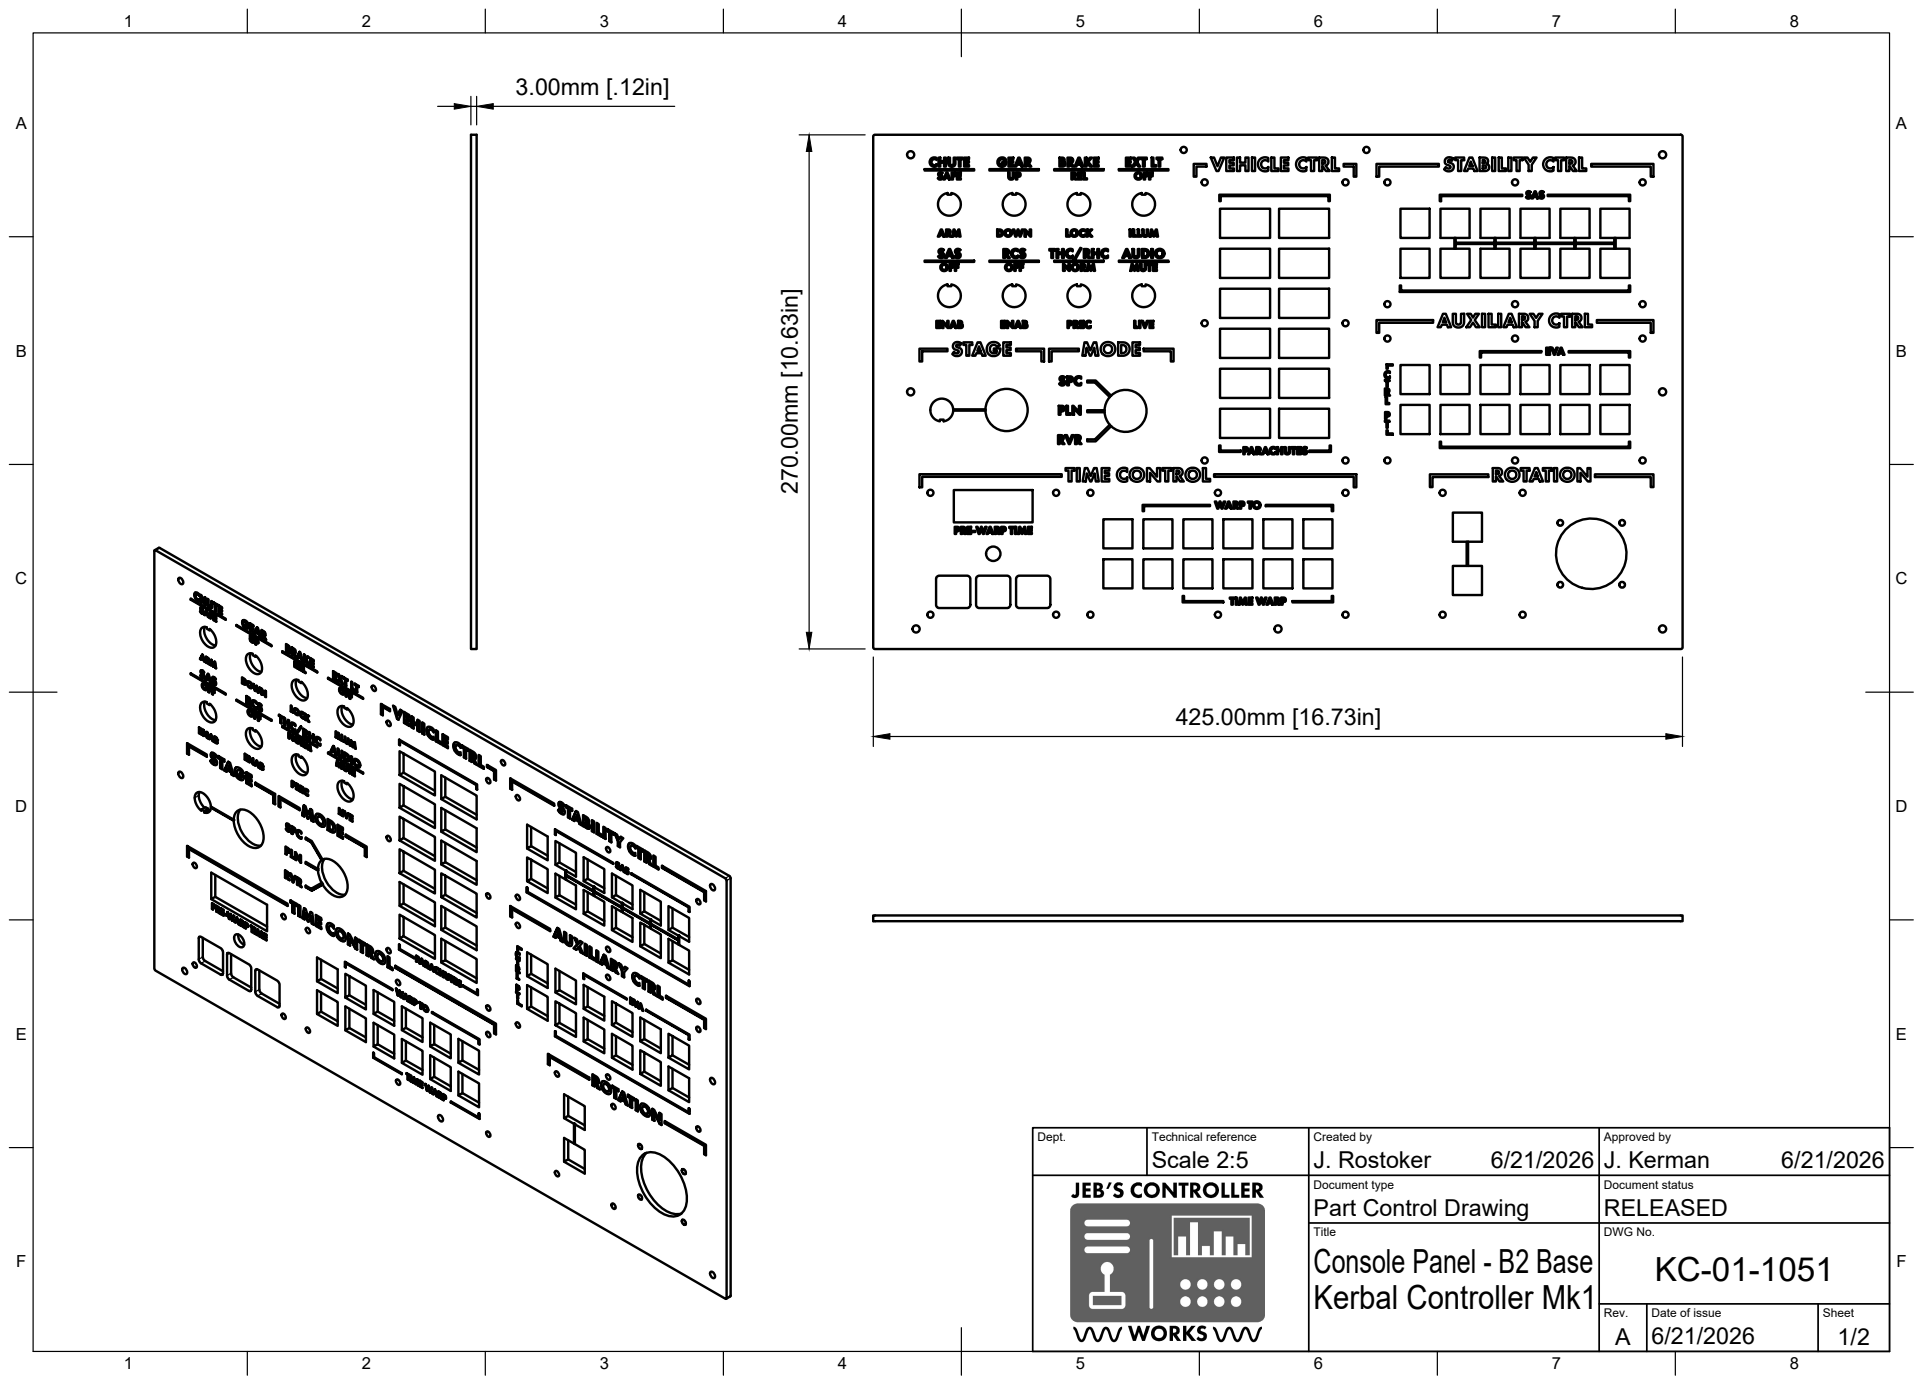
[picture p279: page 1]
Title; DWG No.; Rev.; Date of issue; Sheet; Kerbal Controller Mk1; Console Panel - B2 Base

Dept. | Technical reference Scale 2:5 | Created by J. Rostoker 6/21/2026 | Approved by J. Kerman 6/21/2026

Document type Part Control Drawing | Document status RELEASED

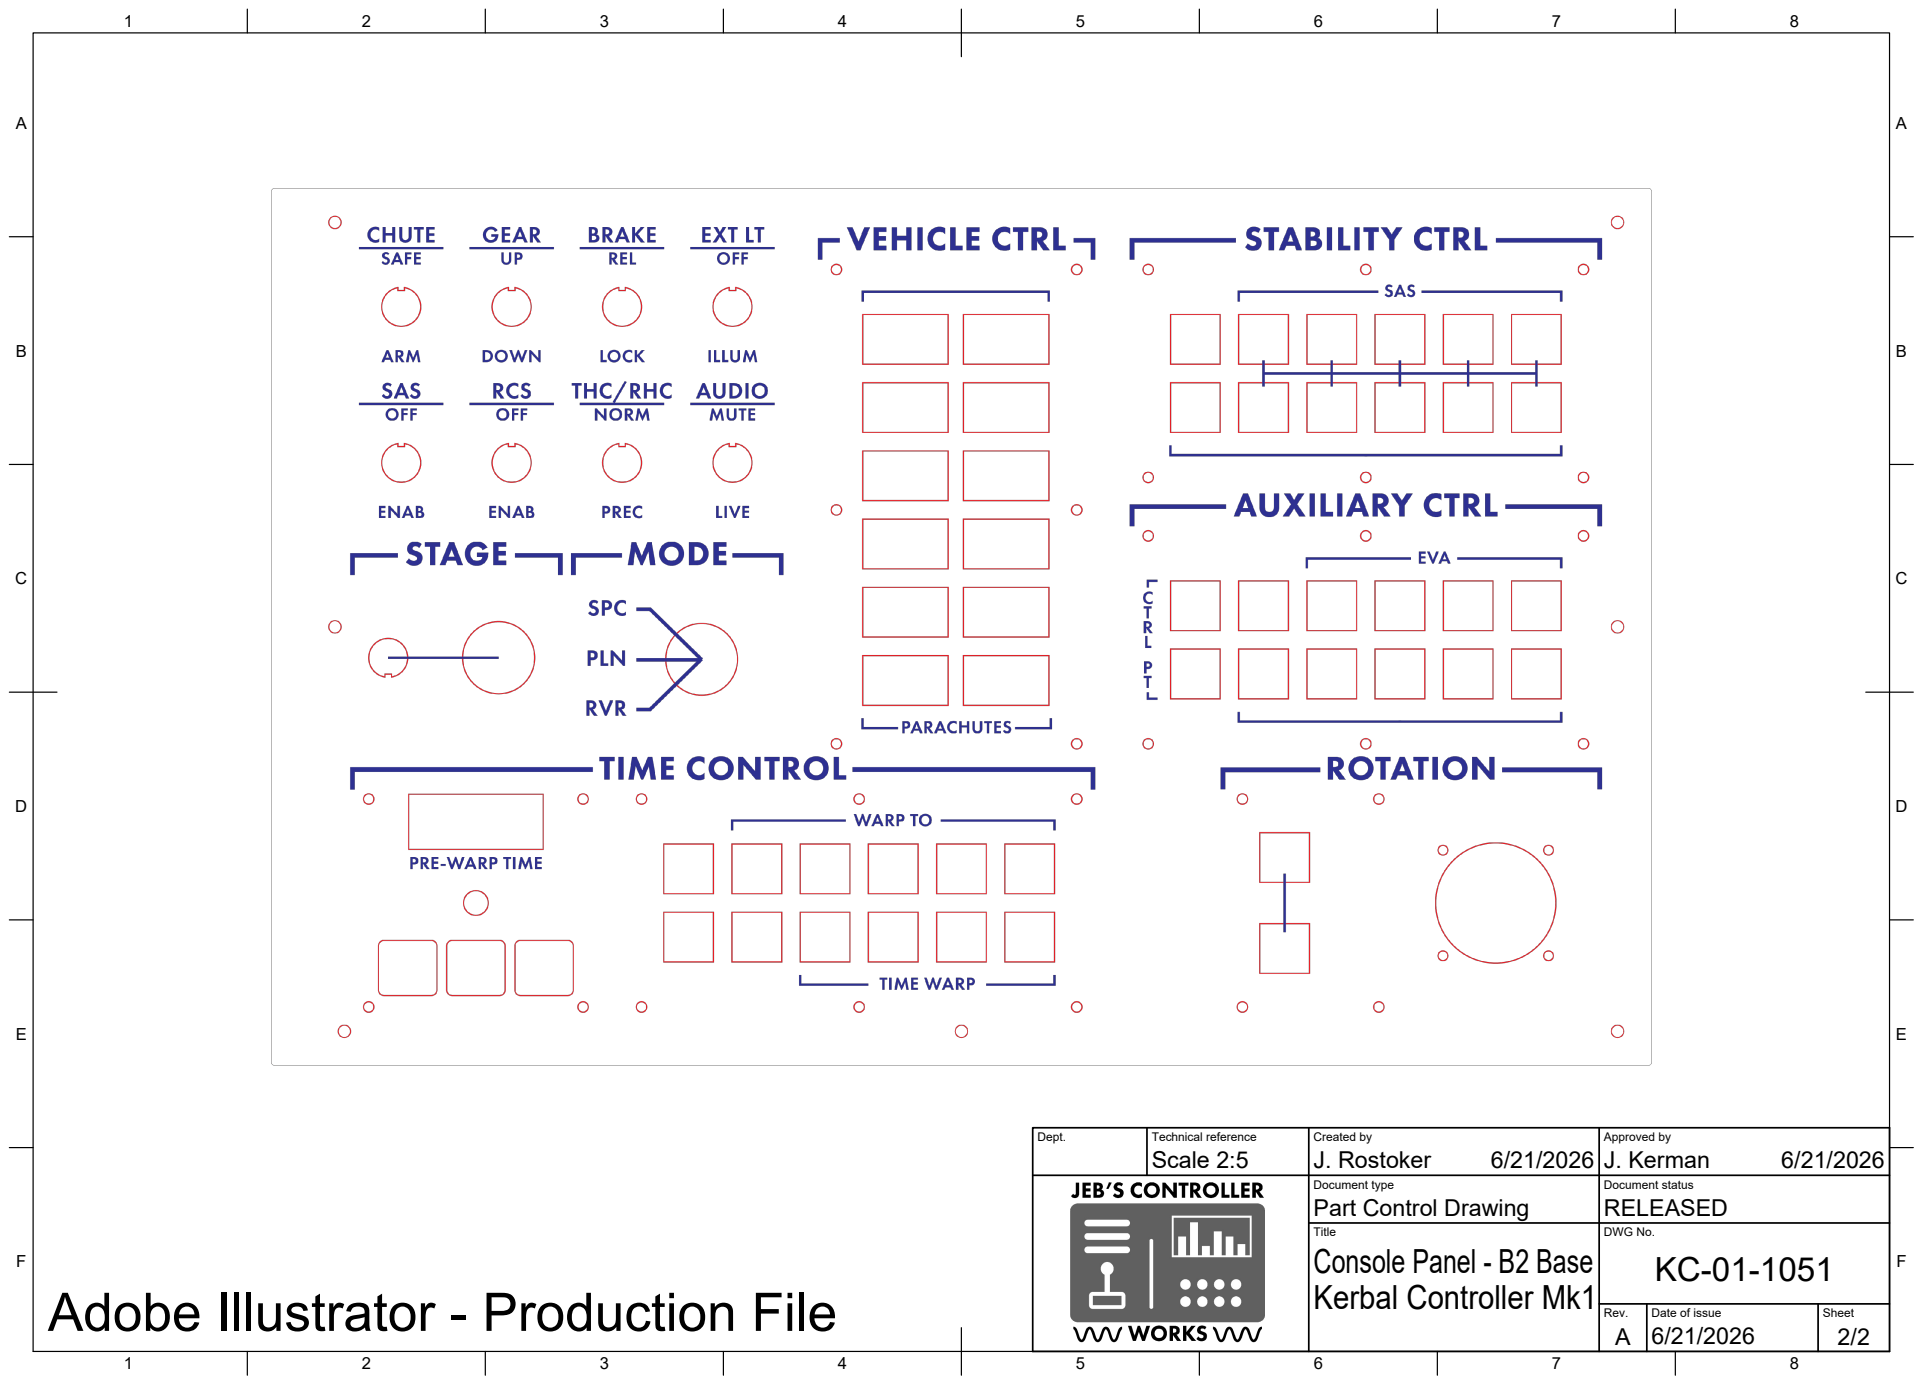
[picture p280: page 2]
Title; DWG No.; Rev.; Date of issue; Sheet; Kerbal Controller Mk1; Console Panel - B2 Base

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

Document type Part Control Drawing | Document status RELEASED

Adobe Illustrator - Production File
