bigJRo/KerbalControllerMk1/Software/Controller_Main/Controller_Main.ino

/********************************************************************************************************************************
  Main Application for Kerbal Controller Mk1 

  Adafruit reference examples code written by Limor Fried/Ladyada for Adafruit Industries.
  Also reference UntitledSpaceCraft code written by CodapopKSP (https://github.com/CodapopKSP/UntitledSpaceCraft)

  Licensed under the GNU General Public License v3.0 (GPL-3.0).

  Final code written by Jason Rostoker for Jeb's Controller Works.
********************************************************************************************************************************/
#include <Wire.h>                      // I2C Wire Library
#include <Bounce.h>                    // Button Debounce Library
#include <KerbalSimpit.h>              // Kerbal Simpit Plugin for game interfaces
#include <KerbalSimpitMessageTypes.h>  // Kerbal Simpit message types
#include <PayloadStructs.h>            // Kerbal Simpit payload structures definitions
#include <Adafruit_EMC2101.h>          // Library to support Adafruit EMC2101 Fan Controller
#include <Adafruit_INA219.h>           // Add support for INA219 current sensor
#include <Watchdog_t4.h>               // Inlcude Watchdog Timer library
extern "C" void usb_init(void);

#include "module_packets.h"               // Per-type I2C packet sizing + universal header helpers
#include "module_variables.h"             // Module Register Definitions
#include "attitude_controller.h"          // Shared attitude PID (ascent + hold-mode autopilots)
#include "ascent_autopilot.h"             // Launch-to-orbit ascent autopilot
#include "hold_autopilot.h"               // Aircraft / rover hold-mode autopilot
#include "burn_autopilot.h"               // Orbital: node / apsis / plane-change burns, approach-rate hold
#include "landing_autopilot.h"            // Landing: descent-rate hold, hover, suicide burn, re-entry attitude
#include "control_links.h"                // Throttle Module, rotation joystick, Info Display, Annunciator / Resource Display links
#include "C:\Dev\KerbalControllerMk1\Software\Common\custom_action_grp_def.h"  // Custom Action Group Definitions
#include "C:\Dev\KerbalControllerMk1\Software\Common\keyboard_def.h"           // Keyboard Code Definitions
#include "C:\Dev\KerbalControllerMk1\Software\Common\body_params.h"            // Shared celestial-body table (ascent autopilot)


/***************************************************************************************
   I2C Address Definitions
****************************************************************************************/
#define ANNUN_MC 0x10
#define RES_MC 0x11   // Resource Display slave (KCM_I2C_ADDR_RESDISP)
#define INFO_MC 0x12  // Info Display 1 slave  (KCM_I2C_ADDR_INFODISP)
#define INFO2_MC 0x13 // Info Display 2 slave  (KCM_I2C_ADDR_INFODISP_2) — autopilot console command source

// I2C module addresses — Module UI Reference / I2C Protocol Specification v2.10 registry.
#define UI_MOD 0x20           // UI Control          (KMC_TYPE_UI_CONTROL)
#define Function_MOD 0x21     // Function Control    (KMC_TYPE_FUNCTION_CONTROL, 24-input)
#define ActionCtrl_MOD 0x22   // Action Control      (KMC_TYPE_ACTION_CONTROL)
#define StabCtrl_MOD 0x23     // Stability Control   (KMC_TYPE_STABILITY_CONTROL)
#define VehCtrl_MOD 0x24      // Vehicle Control     (KMC_TYPE_VEHICLE_CONTROL, 24-input)
#define Time_MOD 0x25         // Time Control        (KMC_TYPE_TIME_CONTROL)
#define AUX_MOD 0x26          // Auxiliary Control   (KMC_TYPE_AUX_CTRL)
// 0x27 reserved
#define Rotation_MOD 0x28     // Joystick Rotation   (KMC_TYPE_JOYSTICK_ROTATION)
#define Translation_MOD 0x29  // Joystick Translation(KMC_TYPE_JOYSTICK_TRANS)
#define GPWS_MOD 0x2A         // GPWS Input Panel    (KMC_TYPE_GPWS_INPUT)
#define PreWarp_MOD 0x2B      // Pre-Warp Time       (KMC_TYPE_PRE_WARP_TIME)
#define Throttle_MOD 0x2C     // Throttle Module     (KMC_TYPE_THROTTLE)
#define DualEnc_MOD 0x2D      // Dual Encoder        (KMC_TYPE_DUAL_ENCODER)
// 0x2E retired — was Switch Panel (superseded by Switch Groups 1/2)

#define INA219_ADDR 0x44
#define EMC2101_ADDR 0x4C


/***************************************************************************************
   Teensy Pin Definitions
****************************************************************************************/
#define ALIVE 2     // Main microcontroller Status
#define MC01_INT 3  // MC01 Interrupt (Annunciator MC)
#define MC02_INT 4  // MC02 Interrupt (Information MC)
#define MC03_INT 5  // MC03 Interrupt (Resource MC)

#define PanelCtrl_INT 25    // Panel Control Interrupt
#define UI_INT 26           // UI Panel Interrupt
#define StabCtrl_INT 27     // Stability Control Panel Interrupt
#define Function_INT 28     // Function Control Panel Interrupt
#define EVA_INT 29          // EVA Panel Interrupt
#define Staging_INT 30      // Staging Interrupt
#define Translation_INT 31  // Translation Module Interrupt
#define Throttle_INT 32     // Throttle Module Interrupt
#define Rotation_INT 33     // Rotation Module Interrupt
#define Switch_INT 34       // Switch Module Interrupt
#define VehCtrl_INT 35      // Vehicle Control Panel Interrupt
#define ActCtrl_INT 36      // Action Control Panel Interrupt
#define Abort_INT 37        // Abort Interrupt
#define GPWS_INT 38         // GPWS Panel Interrupt

#define OFFBOARD_CONNECT 39  // Offboard Connect
#define INTERBOARD_06 40     // Inter-Board Connec 06
#define INTERBOARD_05 41     // Inter-Board Connec 05
#define INTERBOARD_04 13     // Inter-Board Connec 04
#define INTERBOARD_03 14     // Inter-Board Connec 03
#define INTERBOARD_02 15     // Inter-Board Connec 02
#define INTERBOARD_01 20     // Inter-Board Connec 01

#define EXT_SCL 16  // Hardware Accelerated i2c Serial Clock (External Connection)
#define EXT_SDA 17  // Hardware Accelerated i2c Serial Data (External Connection)
#define SDA 18      // Hardware Accelerated i2c Serial Data
#define SCL 19      // Hardware Accelerated i2c Serial Clock


/***************************************************************************************
   Declare Spercific Library Objects
****************************************************************************************/
KerbalSimpit mySimpit(SerialUSB1);             // Declare a KerbalSimpit object that will communicate using the "Serial" device
Bounce stageButton = Bounce(Staging_INT, 10);  // 10 ms debounce
Bounce abortButton = Bounce(Abort_INT, 10);    // 10 ms debounce
Adafruit_EMC2101 fan;                          // Object to support Adafruit EMC2101 Fan Controller
Adafruit_INA219 ina219(INA219_ADDR);           // Object to support Voltage/Current Measurements
WDT_T4<WDT1> wdt;                              // Watchdog timer type 1 object


/***************************************************************************************
  Fan Setup Variables
****************************************************************************************/
float tempC;
float dutyCycle;
float rpm;


/***************************************************************************************
   Define custom action group parameters
****************************************************************************************/
// Active control group (1..6). Per-group AGX stride is CTRL_GRP_STRIDE (40),
// defined in custom_action_grp_def.h. ctrlGrpAdd retained as an alias.
const uint8_t ctrlGrpAdd = CTRL_GRP_STRIDE;

// Final (group-offset-applied) CAG numbers issued by the commands. One per
// base in custom_action_grp_def.h. Recomputed by setActionGroups() whenever
// the active control group changes.
uint8_t ag1, ag2, ag3, ag4, ag5, ag6, ag7, ag8, ag9, ag10, ag11, ag12;
uint8_t antenna;
uint8_t fuel_cell;
uint8_t solar_array;
uint8_t cargo_door;
uint8_t radiator;
uint8_t ladder;
uint8_t heat_shield_deploy;
uint8_t heat_shield_release;
uint8_t parachute;            // main chute deploy
uint8_t main_chute_cut;
uint8_t drogue;               // drogue deploy
uint8_t drogue_cut;
uint8_t les;
uint8_t fairing;
uint8_t engineMode;
uint8_t collectSci;
uint8_t engine1;
uint8_t science1;
uint8_t engine2;
uint8_t science2;
uint8_t intake;
uint8_t lock_surfaces;
uint8_t cp_primary;
uint8_t cp_alternate;
uint8_t cp_docking;
uint8_t airbrake;
uint8_t rw_disable;


/***************************************************************************************
   Global Variable Definitions
****************************************************************************************/
String lastAction;  // Storage location for last value in watchdog check
long runtime_start = millis();
float alt_surf;

/***************************************************************************************
   Panel Control Boolean Definitions
****************************************************************************************/
bool demo = false;          // use without needing to be connected to simpit or the MST Arduino
bool debug = false;         // debug sends data to the serial monitor
bool throttleEn = false;    // Throttle Input is enabled
bool audioEn = true;        // Annunciator audio. Follows the AUDIO switch (Vehicle Control B23,
                            // MUTE / LIVE) once that panel is read; LIVE until then.
bool idleMode = false;      // controls whether the idle screen is set
bool mstrMCActive = false;  //active when mstrMCActive is on
bool trimMode = false;      //used to activate trim mode for rotation stick
bool mapRevMode = false;    //used to properly cycle key-pressed when the request is cycle map backward TODO: Need to check need for this
bool camCtrlSet = false;    //used to activate the camera control mode for the translation joystick
uint8_t ctrlMode = ANL_CTRL_SPACECRAFT;  // Ctrl Mode Toggle (SPC / PLN / RVR) as the Annunciator shows it.
                            // The switch's wiring is still open (Module UI Reference item 14).


/***************************************************************************************
Arduino Setup Function
****************************************************************************************/
void setup() {
  /********************************************************
    Start Serial Interface
  *********************************************************/
  Serial.begin(115200);
  SerialUSB1.begin(115200);

  Serial.println("------------------------------------------------------------------");
  Serial.println("Console initialization...");
  Serial.println("------------------------------------------------------------------");
  Serial.println("Serial communucation established");


  /********************************************************
    Set Pin Modes for necessary inputs/outputs
  *********************************************************/
  Serial.print("Setup pin functions...");
  pinMode(Staging_INT, INPUT);
  pinMode(Abort_INT, INPUT);


  Serial.println("COMPLETE");

  /********************************************************
    I2C bus + module / display links
  *********************************************************/
  Wire.begin();
  Wire.setClock(400000);
  thrInit();   // Throttle Module lever link
  rotInit();   // Rotation joystick link

  /********************************************************
    Initialise the ascent autopilot (loads default config;
    edit via apGetConfig()/apSetTargets() and engage with apArm())
  *********************************************************/
  apInit();

  /********************************************************
    Initialise the hold-mode autopilot (aircraft / rover hold
    modes, engaged from the Info Display 2 consoles) and the
    console link that polls the display and pushes status.
  *********************************************************/
  hpInit();
  arbInit();   // attitude / throttle ownership across the autopilot modules
  bpInit();    // burn autopilot (ORBITAL AUTOPILOT console)
  lpInit();    // landing autopilot (LANDING AUTOPILOT console)
  idlInit();
  anlInit();   // Annunciator + Resource Display: release the boot hold, then the periodic command
  anlService();       // first command now, so the carriers leave their boot hold before KSP is up

  /********************************************************
    KerbalSimpit link to KSP (SerialUSB1). One attempt here;
    simpitService() retries from loop() until KSP answers,
    so the I2C links keep running in the meantime.
  *********************************************************/
  initSimpitObject();
}


/***************************************************************************************
Arduino Loop Function
****************************************************************************************/
void loop() {

  simpitService();    // KerbalSimpit: inbound messages to the autopilots, or a reconnect attempt

  /********************************************************
    Process Staging Button
  *********************************************************/
  if (stageButton.update()) {
    if (stageButton.fallingEdge()) {
      mySimpit.activateAction(STAGE_ACTION);
    }
  }

  /********************************************************
    Process Abort Button
  *********************************************************/
  if (abortButton.update()) {
    if (abortButton.fallingEdge()) {
      mySimpit.activateAction(ABORT_ACTION);
      apDisarm();  // an abort always drops the autopilot back to manual control
      hpDisconnectAll(HP_REASON_PILOT);
    }
  }

  /********************************************************
    Ascent Autopilot
      - apSerialConsole() lets you ARM/DISARM and set ALT/INC/LOFT
        over the primary Serial link for bench testing.
      - apUpdate() runs the guidance loop and emits control to KSP
        only while the autopilot is armed; it is a no-op otherwise.
  *********************************************************/
  thrService();       // Throttle Module: poll lever, forward pilot throttle, drive the lever
  apSerialConsole();  // bench console (ARM/DISARM/ALT/... and HP <cmd> for the hold autopilot)
  apUpdate();
  hpUpdate();         // hold-mode autopilot loops (no-op unless a mode is engaged)
  bpUpdate();         // burn executor / approach hold
  lpUpdate();         // landing modes
  rotService();       // joystick poll + merged rotation send (silent while the ascent AP is armed)
  idlService();       // Info Display 2 console: command poll / ACK / status push
  anlService();       // Annunciator / Resource Display command, GPWS Input Panel relay
}
