bigJRo/KerbalControllerMk1/Software/Displays/KCMk1_InfoDisp/AAA_Config.ino

/***************************************************************************************
   AAA_Config.ino -- Tunable constants for Kerbal Controller Mk1 Information Display
   Sketch version is defined in KCMk1_InfoDisp.h
****************************************************************************************/
#include "KCMk1_InfoDisp.h"


/***************************************************************************************
   OPERATING MODE
****************************************************************************************/
bool debugMode = false;
bool demoMode  = false;  // true = sine-wave demo values, no KSP required
bool fpsDiag   = false;  // true = print frame-rate / render-time diagnostics to Serial (~1 Hz)

// INFO_DISP_UNIT — which physical Info Display board this firmware image targets —
// now lives in KCMk1_InfoDisp.h. It has to be visible before any .ino tab compiles
// because the layout constants and sidebar tables are conditional on it, and this
// file is concatenated after the header is processed. Set it there, not here.
// The sync/framing byte (0xAE) is shared by both units; the INT pin (pin 0) is
// per-board wiring. (The System Info Display, addr 0x14, is separate hardware.)

// STANDALONE_TEST: true = no I2C master connected — skip the boot PROCEED handshake
// and enter loop() immediately. Safe to leave true for bench/UI testing; set false
// for production (master will send PROCEED after reading the status packet).
const bool STANDALONE_TEST = false;


/***************************************************************************************
   DISPLAY ROTATION
   0 = normal (connector at bottom), 2 = 180deg (connector at top)
****************************************************************************************/
const uint8_t DISPLAY_ROTATION = 0;


/***************************************************************************************
   PARACHUTE ACTION GROUP ASSIGNMENTS  (LNDG re-entry screen)
   Set to match your vessel's CAG bindings. Set to 0 to disable.
****************************************************************************************/
const uint8_t DROGUE_DEPLOY_CAG = 1;
const uint8_t DROGUE_CUT_CAG    = 2;
const uint8_t MAIN_DEPLOY_CAG   = 3;
const uint8_t MAIN_CUT_CAG      = 4;

// Airbrake — base Custom Action Group 38 (Function Control B4); see
// Documents/Developer/Module_UI_Reference.md. Read for the AIRCRAFT screen's
// AIRBRK indicator. Set to 0 to disable (button always shows stowed).
const uint8_t AIRBRAKE_CAG      = 38;


/***************************************************************************************
   FLIGHT THRESHOLDS — AIRCRAFT (ACFT screen)
   Tune these per-aircraft during flight testing.
****************************************************************************************/

// IAS stall speed (m/s). REMOVED, not merely disabled: it was 0.0f, which meant the
// AIRCRAFT IAS row's threshold branch had never executed and the row was permanently
// dark green while the code implied a stall warning existed. A stall speed is
// per-airframe and KSP does not report one, so there was never a value to put here.
// Low-speed awareness lives on the AoA arc and the AoA row instead, which is the
// physically correct predictor and is what modern light-aircraft PFDs fit for the same
// reason. See the note on the IAS row in Screen_ACFT.ino before re-adding anything here.

// Maximum safe gear-down speed (m/s). Gear DOWN above this → yellow warning.
// Typical KSP aircraft: 150–200 m/s. 160 m/s ≈ 576 km/h.
const float GEAR_MAX_SPEED_MS = 160.0f;

// Roll angle thresholds for aircraft (degrees absolute)
const float ROLL_WARN_DEG  = 60.0f;   // yellow — steep bank
const float ROLL_ALARM_DEG = 90.0f;   // white-on-red — inverted / structural risk

// AoA thresholds (degrees absolute) — cross-panel aligned with the Annunciator GPWS
// STALL callout via KCMk1_SystemConfig.h (same "stall AoA" on both panels).
const float AOA_WARN_DEG  = KCM_AOA_WARN_DEG;   // yellow — approaching stall AoA
const float AOA_ALARM_DEG = KCM_AOA_STALL_DEG;  // white-on-red — beyond stall AoA (GPWS STALL point)

// Transonic band (Mach). The MACH readout on AIRCRAFT and RE-ENTRY turns yellow across
// it: drag and control authority both change abruptly here.
const float MACH_TRANSONIC_LO = 0.85f;
const float MACH_TRANSONIC_HI = 1.2f;

// Sideslip thresholds (degrees absolute)
const float SLIP_WARN_DEG  = 5.0f;   // yellow
const float SLIP_ALARM_DEG = 15.0f;  // white-on-red

// G-force thresholds (shared with LNDG re-entry and DOCK)
const float G_WARN_POS  = KCM_HIGH_G_WARN_POS;    // #3D yellow — sustained high-G   (cross-panel aligned)
const float G_ALARM_POS = KCM_HIGH_G_ALARM_POS;   // #3D aligned with Annunciator CW_HIGH_G_ALARM
const float G_WARN_NEG  = KCM_HIGH_G_WARN_NEG;    // #3D yellow — negative G          (cross-panel aligned)
const float G_ALARM_NEG = KCM_HIGH_G_ALARM_NEG;   // #3D aligned with Annunciator CW_HIGH_G_WARN


/***************************************************************************************
   FLIGHT THRESHOLDS — LANDING (LNDG screen)
****************************************************************************************/

// T.Grnd / V.Vrt — gear UP (time-based, matches annunciator CW_GROUND_PROX)
const float LNDG_TGRND_ALARM_S  = KCM_GROUND_PROX_S;   // #3D aligned with Annunciator CW_GROUND_PROX_S
const float LNDG_TGRND_WARN_S   = 30.0f;   // yellow — T.Grnd below this with gear UP
const float LNDG_TGRND_HYST_S   = 3.0f;    // colour-band hysteresis: relax only after clearing a
                                           // threshold by this margin, so a jittery estimate sitting
                                           // near a boundary can't flip-flop green<->yellow each frame

// T.Grnd / V.Vrt — gear DOWN (speed-based, structural landing limits)
const float LNDG_VVRT_ALARM_MS  = -8.0f;   // red — crash landing speed (m/s, negative)
const float LNDG_VVRT_WARN_MS   = -5.0f;   // yellow — fast landing (m/s, negative)

// Alt.Rdr thresholds (m)
const float ALT_RDR_ALARM_M      = 50.0f;   // white-on-red — very low (LNDG + ACFT)
const float ALT_RDR_WARN_M       = 500.0f;  // yellow — low altitude (LNDG + ACFT)
const float LNDG_ALT_RDR_WARN_M  = 200.0f;  // yellow — powered-descent-specific tighter low-alt warning

// Horizontal velocity thresholds (Fwd/Lat) — tighten contextually with T.Grnd
// T.Grnd > 60s: loose  |  30-60s: mid  |  10-30s: tight  |  <10s: final
const float LNDG_HVEL_WARN_LOOSE_MS  = 20.0f;  const float LNDG_HVEL_ALARM_LOOSE_MS  = 999.0f;
const float LNDG_HVEL_WARN_MID_MS    =  5.0f;  const float LNDG_HVEL_ALARM_MID_MS    =  15.0f;
const float LNDG_HVEL_WARN_TIGHT_MS  =  2.0f;  const float LNDG_HVEL_ALARM_TIGHT_MS  =   8.0f;
const float LNDG_HVEL_WARN_FINAL_MS  =  1.0f;  const float LNDG_HVEL_ALARM_FINAL_MS  =   2.0f;

// Parachute deployment limits as dynamic pressure q = 0.5*airDensity*v^2 (Pa).
// KSP destroys a chute deployed above a structural q (force) limit, which is
// body-independent; expressing the limit as q makes the safe-deploy SPEED
// altitude-correct (higher up in thin air, lower near the ground). Cross-panel
// aligned with the Annunciator CW_CHUTE_ENV via KCMk1_SystemConfig.h.
const float LNDG_CHUTE_MAIN_MAX_Q   = KCM_CHUTE_MAIN_MAX_Q;    // main rips above this q (Pa)
const float LNDG_CHUTE_DROGUE_MAX_Q = KCM_CHUTE_DROGUE_MAX_Q;  // drogue rips above this q (Pa)

// Parachute deployment state thresholds
// LNDG_CHUTE_SEMI_DENSITY: air density (kg/m³) above which the chute begins to
//   semi-deploy. Matches KSP's default minAirPressureToOpen = 0.04 atm.
//   On Kerbin: 0.04 atm × 1.225 kg/m³ (sea-level density) ≈ 0.049 kg/m³.
//   Chute shows ARMED (cyan) below this; OPEN yellow/green above it.
const float LNDG_CHUTE_SEMI_DENSITY = 0.049f;

// Full-deploy radar altitudes — below these the chute transitions from OPEN yellow
// (semi-deploying) to OPEN green (fully open). Drogues deploy higher than mains.
const float LNDG_DROGUE_FULL_ALT = 2500.0f;   // drogue fully open below 2500m AGL
const float LNDG_MAIN_FULL_ALT   = 1000.0f;   // main fully open below 1000m AGL

// T.Grnd band boundaries for Fwd/Lat context-dependent thresholds (seconds)
const float LNDG_HVEL_T_LOOSE_S = 60.0f;   // above this: loose thresholds
const float LNDG_HVEL_T_MID_S   = 30.0f;   // above this: mid thresholds

// Re-entry SAS indicator: below this Mach number aerodynamic forces are strong
// enough that SAS OFF is acceptable (capsule stabilises ballistically).
// Above this threshold SAS OFF is alarmed white-on-red.
// Tune during flight testing — Mach 3.0 is a reasonable starting point.
const float REENTRY_SAS_AERO_STABLE_MACH = 3.0f;
const float DV_STG_ALARM_MS = KCM_LOW_DV_MS;   // #3D aligned with Annunciator CW_LOW_DV_MS
const float DV_STG_WARN_MS  = 300.0f;  // yellow

// Total ΔV threshold (m/s) — VEH screen
const float DV_TOT_WARN_MS  = 500.0f;  // yellow — mission nearly out of propellant


/***************************************************************************************
   FLIGHT THRESHOLDS — TARGET (TGT screen)
****************************************************************************************/

// Distance to target (m) — yellow <5km, white-on-green <200m (ready for DOCK)
const float RNDZ_DIST_WARN_M  = 5000.0f;   // yellow — closing

// Closure velocity alarm (m/s, absolute value). ONE tier, deliberately -- and it is
// gated on range as well as speed (see Screen_TGT): the alarm is "closing fast AND
// already inside RNDZ_DIST_WARN_M", because 500 m/s of closure at 40 km is a normal
// transfer and the same number at 3 km is an impact. There used to be a
// TGT_VCLOSURE_WARN_MS = 200 here as well, documented as "yellow -- fast approach". No
// code ever read it; the row's yellow means the closure is NEGATIVE (opening, and so
// not an approach at all), which is a different quantity entirely. Removed rather than
// wired up: a speed-only middle tier would have fired constantly on any normal
// rendezvous and taught the pilot to ignore the colour.
const float TGT_VCLOSURE_ALARM_MS = 500.0f;  // white-on-red — very fast, and close
// V.CLOSE "holding station" dead band: a closure rate that prints as zero is neither
// closing nor opening and reads green; only a rate at or above this is "opening" (yellow).
// Each is the screen's print resolution: TARGET one decimal, DOCKING two.
const float TGT_VCLOSE_HOLD_MS  = 0.05f;
const float DOCK_VCLOSE_HOLD_MS = 0.005f;

// Approach alignment error thresholds (degrees absolute)
// THE RETICLE RINGS ARE THE COLOUR BANDS. Every reticle draws its good zone at
// full-scale/4 and its middle ring at full-scale/2, so the thresholds are set to those
// radii and the picture can never disagree with the numbers: green inside the inner
// ring, yellow out to the middle ring, red beyond. TGT runs +/-60 deg full scale.
// These really are wider than DOCK now — the old 5/15 was TIGHTER than DOCK's 10/20,
// the opposite of what this comment claimed and of what the two phases need.
const float TGT_BRG_WARN_DEG  = 15.0f;   // yellow — inner ring  (60/4)
const float TGT_BRG_ALARM_DEG = 30.0f;   // white-on-red — middle ring  (60/2)


/***************************************************************************************
   FLIGHT THRESHOLDS — DOCKING (DOCK screen)
****************************************************************************************/

// Distance to target (m)
const float DOCK_DIST_ALARM_M = 50.0f;    // white-on-red
const float DOCK_DIST_WARN_M  = 200.0f;   // yellow

/***************************************************************************************
   CONTEXT ROUTING — mission-phase display (Info Display 2 only)
   Bounds for the two context rules that only became affordable once the PFD moved to
   its own panel. On a single display, auto-routing to TARGET or MANEUVER would have
   cost the pilot their attitude reference; with Info Display 1 permanently holding
   the PFD family, it costs nothing.
****************************************************************************************/

// TARGET auto-select window (m). Below DOCK_DIST_WARN_M the DOCKING screen wins; past
// this the target is far enough that ORBIT is the more useful view, so a plane-change
// or transfer burn planned around a distant target does not sit on an RPOD scope.
const float TGT_CONTEXT_MAX_M = 2000.0f;

// MANEUVER auto-select lead time (s) before ignition. Nodes persist long after they
// stop being the pilot's concern, so the rule is gated on the burn being imminent
// rather than merely planned. Negative time-to-ignition (the burn is running) also
// passes, which keeps MANEUVER up through the burn itself.
const float MNVR_CONTEXT_LEAD_S = 600.0f;   // 10 min

/***************************************************************************************
   CONTEXT ROUTING — continuous evaluation
   Both ladders are re-evaluated every frame rather than only at vessel/scene
   boundaries, so the panels follow the mission. Two guards keep that from flapping:

   A release band on every numeric rule. Once a rule owns the screen its threshold
   widens, so a value parked on the boundary — station-keeping at 200 m, a burn sitting
   at ten minutes out — cannot oscillate the panel. Entry thresholds are unchanged;
   only the exit is looser.

   A minimum dwell between automatic switches, as a blanket guard for everything the
   bands do not cover (an atmosphere boundary flickering inAtmo, a target flickering
   in and out of Simpit's view).
****************************************************************************************/
const uint32_t CONTEXT_DWELL_MS      = 4000;     // min gap between automatic switches
// A sidebar press is deliberate, so it is protected for longer than one automatic
// switch protects the next. This is a floor, not the mechanism: the manual latch is
// what actually holds a chosen screen, and this only covers the case where the latch
// releases immediately because the ladder's answer legitimately changed.
const uint32_t MANUAL_DWELL_MS       = 10000;    // min gap between a press and an auto switch
const float    DOCK_CTX_RELEASE_M    = 250.0f;   // leave DOCKING past this (enter at 200)
// A target counts as present while targetAvailable is set OR a TARGETINFO arrived this
// recently. Simpit sends TARGETINFO only while there is a target, and nothing clears
// state.tgtDistance, so without an age the last distance outlived its target.
const uint32_t TGT_INFO_FRESH_MS     = 2000;
const float    TGT_CTX_RELEASE_MIN_M = 150.0f;   // leave TARGET below this (enter at 200)
const float    TGT_CTX_RELEASE_MAX_M = 2400.0f;  // leave TARGET above this (enter at 2000)
const float    MNVR_CTX_RELEASE_S    = 700.0f;   // leave MANEUVER past this (enter at 600)

// RE-ENTRY auto-select. The corridor test (periapsis inside the atmosphere, descending)
// is true for any aircraft in level flight too — its periapsis is far underground — so
// the rule additionally requires the vessel to be coming in fast or from outside the
// atmosphere. Mach 3 is the same marker the RE-ENTRY screen already uses for its SAS
// annunciation.
const float REENTRY_CTX_MACH = 3.0f;
// Once chosen, RE-ENTRY holds through the rest of the descent (parachutes included)
// rather than dropping at Mach 3. The hold releases on climbing faster than this ...
const float REENTRY_HOLD_CLIMB_MS = 50.0f;
// ... or when the engines are thrusting (throttle above this with a stage that has burn
// time), which is a powered landing and belongs to POWERED DESCENT.
const float REENTRY_HOLD_THROTTLE = 0.02f;

// NO-PROPELLANT NEUTRAL. A craft carrying neither liquid fuel nor oxidizer -- a re-entry
// capsule -- reports 0 stage dV and 0 burn time, and every stage readout used to show
// its low-fuel alarm for a vessel that has no fuel to be low on. Below this many units
// of BOTH (on the whole vessel) the stage dV / burn-time / total-dV readouts draw in
// neutral dark grey instead (issue #72). Craft with LF only (nuclear, jets) are unaffected.
const float PROP_EMPTY_UNITS = 0.01f;

// POWERED DESCENT auto-select. The old rule was `type_Lander && sit_SubOrb`, which
// missed every Ship doing a Mun landing and fired on ascent (sub-orbital is also what
// a rocket climbing out looks like). Proximity plus a real descent rate is what the
// screen is actually for. Planes in atmosphere are excluded: their approach instrument
// is the AIRCRAFT screen on the other panel.
const float LNDG_CTX_ALT_M         = 10000.0f;  // radar altitude to enter
const float LNDG_CTX_ALT_RELEASE_M = 12000.0f;  // and to leave (release band)
const float LNDG_CTX_VVERT_MS      = -5.0f;     // descending at least this fast

// ASCENT — dynamic pressure bands (kPa). A Kerbin ascent peaks near 10-15 kPa around
// 5-8 km; a steep or overpowered climb pushes past that, which is where an airframe
// starts paying for it. Caution then alarm, so max Q annunciates instead of merely
// being computable.
const float LNCH_Q_WARN_KPA  = KCM_HIGH_Q_PA / 1000.0f;   // 20 kPa, = the Annunciator HIGH Q tile
const float LNCH_Q_ALARM_KPA = 40.0f;

// ASCENT — load factor bands (g): the panel-wide G_WARN_POS / G_ALARM_POS, which are
// the Annunciator's crew limits, so the two panels cannot disagree about what a
// high-G ascent is.
const float LNCH_G_WARN  = G_WARN_POS;
const float LNCH_G_ALARM = G_ALARM_POS;

// LAUNCH — throttle at or below this counts as coasting, which is what moves the screen
// from ASCENT to CIRCULARISATION. Not zero: KSP can report a hair of throttle from a
// trim or a spent stage still nominally lit.
const float LNCH_COAST_THROTTLE = 0.02f;

// LAUNCH context — the ascent arc releases when the vessel stops climbing. Zero is the
// entry threshold; this is the release threshold, so a coast through apoapsis (where
// vertical speed passes through zero on its way to the circularisation burn) does not
// drop the screen. Same release-band pattern as the DOCKING, TARGET and MANEUVER rules.
const float LNCH_CTX_VVERT_RELEASE_MS = -20.0f;

// NAV — drift (ground track minus heading) shown yellow past this. In an atmosphere a
// large crab angle is either a strong sideways component or a vessel that is not going
// where it is pointed; either is worth noticing before it becomes a heading error.
const int16_t NAV_DRIFT_WARN_DEG = 10;

// Closure rate — alarm at >2 m/s within 100m
const float DOCK_VCLOSURE_ALARM_MS   = 2.0f;
const float DOCK_VCLOSURE_ALARM_DIST_M = 100.0f;

// Time to dock (distance over closure rate, seconds)
const float DOCK_TDOCK_WARN_S  = 30.0f;   // yellow
const float DOCK_TDOCK_ALARM_S = 10.0f;   // white-on-red

// Drift speed (m/s magnitude)
const float DOCK_DRIFT_WARN_MS  = 0.1f;   // yellow
const float DOCK_DRIFT_ALARM_MS = 0.5f;   // white-on-red

// Bearing/elevation angle (degrees absolute) — the reticle rings, as above.
// DOCK runs +/-20 deg full scale, so these are tighter than TGT: the precision phase
// gets the tighter tolerance, which is what the old 10/20-vs-TGT-5/15 had backwards.
// Applied to BOTH V.Brg/V.Elv (approach path vs port) and Nos.Off (nose off bore) —
// two different quantities sharing one band, which suits both at docking range.
const float DOCK_BRG_WARN_DEG  =  5.0f;  // yellow — inner ring  (20/4)
const float DOCK_BRG_ALARM_DEG = 10.0f;  // red — middle ring  (20/2)


/***************************************************************************************
   FLIGHT THRESHOLDS — MANEUVER (MNVR screen) & VEHICLE INFO
****************************************************************************************/

// Time to ignition (MNVR screen, seconds)
const float MNVR_TIGN_WARN_S  = 60.0f;   // yellow — get ready to light
const float MNVR_TIGN_ALARM_S = 10.0f;   // white-on-red — light NOW

// Total ΔV margin over maneuver ΔV — yellow if within this factor (e.g. 1.1 = within 10%)
const float MNVR_DV_MARGIN = 1.1f;

// CommNet signal (percent)
const float VEH_SIGNAL_WARN_PCT = 50.0f;   // yellow — weak link

// ── Thermal & electrical (annunciator-aligned) ───────────────────────────────
// Thermal limits (percent of part limit; core or skin temperature). Alarm aligned
// to the Annunciator CW_HIGH_TEMP (KCM_TEMP_ALARM_PCT); the warn tier is a
// display-only yellow pre-alarm (the C&W panel has no temperature warning tier).
const uint8_t TEMP_WARN_PCT  = 75;                  // yellow — getting hot
const uint8_t TEMP_ALARM_PCT = KCM_TEMP_ALARM_PCT;  // white-on-red — critical (= 90)

// Electric charge (fraction 0..1). Alarm aligned to Annunciator CW_BUS_VOLTAGE
// (KCM_EC_LOW_ALARM_FRAC = 5%); warn aligned to the resource-low convention
// (KCM_RES_LOW_WARN_FRAC = 20%, same tier as CW_PROP_LOW / CW_RCS_LOW).
const float EC_LOW_WARN_FRAC  = KCM_RES_LOW_WARN_FRAC;   // yellow — 20%
const float EC_LOW_ALARM_FRAC = KCM_EC_LOW_ALARM_FRAC;   // white-on-red — 5%

// Pre-launch EC readiness check — deliberately stricter than the in-flight low-EC
// alarm above (you want the battery topped off before launch, not merely above the
// 5% bus-voltage floor). Display-only; no C&W analog.
const uint8_t EC_PRELAUNCH_READY_PCT = 90;   // green — good to go
const uint8_t EC_PRELAUNCH_LOW_PCT   = 75;   // yellow — below this: white-on-red


/***************************************************************************************
   FLIGHT THRESHOLDS — MANEUVER reticle (heading/pitch error)
****************************************************************************************/
// MNVR runs +/-20 deg full scale, so these match the reticle rings exactly as above.
// WARN also gates the neon-green alignment box drawn around the maneuver marker.
const float ATT_ERR_WARN_DEG  =  5.0f;   // yellow — inner ring  (20/4)
const float ATT_ERR_ALARM_DEG = 10.0f;   // white-on-red — middle ring  (20/2)


/***************************************************************************************
   FLIGHT THRESHOLDS — LAUNCH (LNCH screen)
****************************************************************************************/

// Time to apoapsis caution during gravity turn (seconds)
const float LNCH_TOAPO_WARN_S  = 30.0f;   // yellow — apoapsis close during burn

// Stage burn time thresholds (seconds)
const float LNCH_BURNTIME_ALARM_S = KCM_LOW_BURN_S;   // #3D aligned with Annunciator CW_LOW_BURN_S
const float LNCH_BURNTIME_WARN_S  = 120.0f;  // yellow

// Fallback body radius when currentBody.radius is unavailable (Kerbin, metres).
const float DEFAULT_BODY_RADIUS_M = 600000.0f;

// Altitude (as a fraction of body radius) at which the ascent/circularization mode
// switch flips, with a small hysteresis band so it doesn't chatter near the boundary.
// AIRCRAFT row 0 hands over from Alt.SL to Alt.Rdr near the ground, the way a real PFD
// brings radio altitude in only for the approach (the A320 shows it below 2,500 ft, i.e.
// ~760 m). Hysteresis so levelling off at the switch height cannot chatter the label.
const float ACFT_ALT_RDR_ON_M  = 750.0f;   // below this, radar altitude takes row 0
const float ACFT_ALT_RDR_OFF_M = 850.0f;   // above this, barometric altitude takes it back

const float ORB_SWITCH_ALT_FRAC_ASC  = 0.06f;   // switch up to orbital view above this
const float ORB_SWITCH_ALT_FRAC_DESC = 0.055f;  // switch back down below this


/***************************************************************************************
   FLIGHT THRESHOLDS — ROVER (ROVR screen)
****************************************************************************************/

// Pitch (slope) thresholds (degrees). Tune per rover — heavier/wider rovers tolerate more.
const float ROVER_PITCH_WARN_DEG  = 20.0f;   // yellow — getting steep
const float ROVER_PITCH_ALARM_DEG = 30.0f;   // red text — rollover risk

// Roll (lateral tilt) thresholds (degrees). Roll is typically the more critical axis.
const float ROVER_ROLL_WARN_DEG   = 15.0f;   // yellow — leaning significantly
const float ROVER_ROLL_ALARM_DEG  = 25.0f;   // red text — rollover imminent

// Endurance thresholds (seconds of charge remaining). The ROVER block that used to show
// EC% now shows time to empty, so it is coloured on TIME, not on percentage -- see the
// note on the readout in Screen_ROVR.ino. The percentage tiers still exist where a
// percentage is displayed: the Resource Display shows EC%, and the Annunciator owns the
// low-charge alarm on EC_LOW_WARN_FRAC / EC_LOW_ALARM_FRAC.
const int32_t ROVER_ENDUR_WARN_S  = 3600;   // yellow — under an hour of charge left
const int32_t ROVER_ENDUR_ALARM_S = 600;    // white-on-red — under ten minutes

// Percentage tiers, for the places a CHARGE LEVEL is still what is displayed: SPACECRAFT's
// EVA row 6, and the Resource Display. Named for the quantity rather than for the rover,
// which no longer uses them. Aligned to the shared low-EC thresholds so every percentage
// on the panel and the Annunciator's CW_BUS_VOLTAGE alarm agree.
const float EC_PCT_WARN  = EC_LOW_WARN_FRAC  * 100.0f;   // yellow — 20%
const float EC_PCT_ALARM = EC_LOW_ALARM_FRAC * 100.0f;   // white-on-red — 5%
