bigJRo/KerbalControllerMk1/Software/Modules/Dual Encoder/0. RotaryEncoderCore/src/RotaryEncoder.cpp

#include "RotaryEncoder.h"

void attachEncoder(RotaryEncoder& encoder, uint8_t pinA, uint8_t pinB, uint8_t buttonPin) {
  encoder.pinA = pinA;
  encoder.pinB = pinB;
  encoder.buttonPin = buttonPin;

  pinMode(pinA, INPUT);
  pinMode(pinB, INPUT);
  if (buttonPin != 0xFF) {
    pinMode(buttonPin, INPUT);  // Active-high: no pull-up
  }
}

void updateEncoder(RotaryEncoder& encoder) {
  static uint8_t lastState = 0;
  uint8_t state = (digitalRead(encoder.pinA) << 1) | digitalRead(encoder.pinB);
  if ((lastState == 0b00 && state == 0b01) ||
      (lastState == 0b01 && state == 0b11) ||
      (lastState == 0b11 && state == 0b10) ||
      (lastState == 0b10 && state == 0b00)) {
    encoder.position++;
  } else if ((lastState == 0b00 && state == 0b10) ||
             (lastState == 0b10 && state == 0b11) ||
             (lastState == 0b11 && state == 0b01) ||
             (lastState == 0b01 && state == 0b00)) {
    encoder.position--;
  }
  lastState = state;
}

void updateEncoderButton(RotaryEncoder& encoder, unsigned long shortThreshold, unsigned long longThreshold) {
  if (encoder.buttonPin == 0xFF) return;

  bool pressed = digitalRead(encoder.buttonPin);  // Active-high logic

  if (pressed && !encoder.buttonPressed) {
    encoder.buttonPressed = true;
    encoder.buttonPressTime = millis();
    encoder.buttonHandled = false;
  } else if (!pressed && encoder.buttonPressed) {
    unsigned long duration = millis() - encoder.buttonPressTime;
    encoder.buttonPressed = false;

    if (!encoder.buttonHandled) {
      if (duration < shortThreshold) {
        if (encoder.onShortPress) encoder.onShortPress();
      } else if (duration >= longThreshold) {
        if (encoder.onLongPress) encoder.onLongPress();
      }
    }
    encoder.buttonHandled = true;
  }
}
