bigJRo/KerbalControllerMk1/Software/Displays/KCMk1_Annunciator/KCMk1_Annunciator.h

#pragma once
/***************************************************************************************
   KCMk1_Annunciator.h -- Shared declarations for Kerbal Controller Mk1 Annunciator
   Included by every .ino tab. Defines types, enums, AppState, C&W bit constants,
   and extern declarations for all globals defined in AAA_Config.ino and AAA_Globals.ino.
****************************************************************************************/

// Requires KerbalDisplayCommon >= 3.0.0 (hardware rev 2: RA8876 / Teensy 4.1)
#include <KerbalDisplayCommon.h>   // pulls in KCM_Display (KCM_TFT) + ILI9341_t3 fonts
#include <KCM_Touch.h>             // FT5316 touch: TouchResult/setupTouch/isTouched/readTouch
// KerbalDisplayAudio pulls its TONE (pin 29) and amp-enable TONE_EN (pin 30) pins from
// KCMk1_SystemConfig automatically (KCM_AUDIO_TONE_PIN / KCM_AUDIO_EN_PIN) — no local
// override needed. The PAM8302A amp is powered down between cues (no idle hiss).
#include <KerbalDisplayAudio.h>
#include <KCM_DFPlayer.h>          // sampled audio (DFPlayer Mini on Serial2)
#include <KerbalSimpit.h>
#include <KCMk1_SystemConfig.h>   // shared hardware/threshold constants (KCMk1_SystemConfig library)

// Forward declaration for GPWS.ino's ladder-rung struct. GpwsRung is fully defined in
// GPWS.ino, but the Arduino builder injects gpwsCrossed()'s prototype at the top of the
// combined sketch (before that definition); this makes the type name resolve there.
struct GpwsRung;


/***************************************************************************************
   CONTROL MODE ENUM
   Panel-specific -- not part of the KSP API.
****************************************************************************************/
enum CtrlMode : uint8_t {
  ctrl_Rover      = 0,
  ctrl_Plane      = 1,
  ctrl_Spacecraft = 2
};


/***************************************************************************************
   APPLICATION STATE STRUCT
   All telemetry-driven display values.
   Two instances declared in Globals.ino: state (current) and prev (last drawn).
****************************************************************************************/
struct AppState {
  bool       masterAlarmOn        = false;
  uint32_t   cautionWarningState  = 0x00000000;  // expanded to 32-bit for 25 C&W bits
  uint8_t    vesselSituationState = 0x00;         // display bitmask: bit0=DOCKED..bit7=LANDED
  CtrlMode   vehCtrlMode          = ctrl_Spacecraft;
  VesselType vesselType           = type_Ship;
  String     vesselName           = "";                 // blank until VESSEL_NAME arrives (demo sets its own)
  uint8_t    maxTemp    = 0;
  uint8_t    crewCount  = 0;
  uint8_t    twIndex    = 0;
  uint8_t    commNet    = 0;
  uint8_t    stage      = 0;
  uint8_t    skinTemp   = 0;    // default 0 (like maxTemp) so a fresh boot doesn't trip HIGH_TEMP before the first TEMP_LIMIT_MESSAGE
  uint8_t    ctrlGrp    = 1;
  uint8_t    capValue   = 0;                             // "Cap" readout, byte 5 of the rev-2 inbound I2C command
  String     gameSOI    = "";                           // note: String heap -- low risk on Teensy 4.1

  // Mode/status flags shown in the bottom-right 6x2 grid (rev 2). All 12 bits are
  // reported by the master controller over I2C (bytes 3-4 of the rev-2 inbound
  // command); default off until the master sends them. Bit positions are the MF_*
  // constants below.
  uint16_t   modeFlags  = 0;

  // Action groups
  bool gear_on   = false;
  bool abort_on  = false;

  // Altitude (metres)
  float alt_sl   = 0.0f;
  float alt_surf = 0.0f;

  // Velocity (m/s)
  float vel_surf = 0.0f;
  float vel_vert = 0.0f;

  // Apsides (metres)
  float apoapsis  = 0.0f;
  float periapsis = 0.0f;

  // Delta-V and burn time
  float stageDV       = 0.0f;
  float stageBurnTime = 0.0f;

  // G-forces
  float gForces = 0.0f;

  // Attitude -- degrees (ROTATION_DATA). roll drives the GPWS bank-angle callout
  // (Mode 6); pitch and surfaceVelocityPitch give the GPWS STALL AoA proxy
  // (angle of attack = pitch - srfVelPitch). roll range approx -180..180.
  float roll        = 0.0f;
  float pitch       = 0.0f;
  float srfVelPitch = 0.0f;   // surface-velocity (flight-path) pitch

  // Target (TARGETINFO) -- used by the GPWS rendezvous-radar distance callouts.
  float tgtDistance = 0.0f;  // metres to target (0 = no/unknown target)
  float tgtVelocity = 0.0f;  // closing speed along the bearing (m/s); negative = closing

  // Resources -- electric charge
  float EC       = 0.0f;
  float EC_total = 0.0f;

  // Resources -- propellant (current stage)
  float LF_stage     = 0.0f;
  float LF_stage_tot = 0.0f;
  float OX_stage     = 0.0f;
  float OX_stage_tot = 0.0f;
  float SF_stage     = 0.0f;   // solid fuel -- current stage (for SRB ACTIVE)
  float SF_stage_tot = 0.0f;

  // Resources -- propellant (whole vessel), for the no-propellant LOW dV suppression
  float LF_vessel    = 0.0f;   // liquid fuel on board (LF_MESSAGE, available)
  float OX_vessel    = 0.0f;   // oxidizer on board    (OX_MESSAGE, available)
  bool  propSeen     = false;  // an LF / OX message has arrived for this vessel (needs ARP)

  // Resources -- MonoPropellant (total vessel)
  float mono     = 0.0f;
  float mono_tot = 0.0f;

  // Resources -- TAC-LS (total vessel)
  // Consumables: available units remaining and total capacity
  float tacFood        = 0.0f;
  float tacFood_tot    = 0.0f;
  float tacWater       = 0.0f;
  float tacWater_tot   = 0.0f;
  float tacOxygen      = 0.0f;
  float tacOxygen_tot  = 0.0f;

  // Atmosphere
  float atmoPressure = 0.0f;  // kPa   -- for HIGH Q proxy
  float airDensity   = 0.0f;  // kg/m3 -- for CHUTE ENV (true dynamic pressure q)

  // Throttle
  uint8_t throttleCmd = 0;  // 0-100%
};


/***************************************************************************************
   CELESTIAL-BODY / MEATBALL IMAGE SIZE
   The SOI globe and KASA meatball BMPs are 236x164 (named *_236x164.bmp). Shared
   here so ScreenMain and ScreenSOI centre them identically in their render areas.
****************************************************************************************/
static const uint16_t BODY_IMG_W = 236;
static const uint16_t BODY_IMG_H = 164;


/***************************************************************************************
   VESSEL SITUATION DISPLAY BITMASK BIT POSITIONS
   state.vesselSituationState is a display bitmask assembled in SimpitHandler from
   Simpit's FLIGHT_STATUS raw situation bits. Named constants here prevent magic
   literals spreading into ScreenMain and CautionWarning.
   Bit 0 (DOCKED) is set/cleared by VESSEL_CHANGE_MESSAGE, not FLIGHT_STATUS.
   Bit 7 (LANDED) is set from the Simpit sit_Landed bit in FLIGHT_STATUS.
****************************************************************************************/
static const uint8_t VSIT_DOCKED    = 0;
static const uint8_t VSIT_PRELAUNCH = 1;
static const uint8_t VSIT_FLIGHT    = 2;
static const uint8_t VSIT_SUBORBIT  = 3;
static const uint8_t VSIT_ORBIT     = 4;
static const uint8_t VSIT_ESCAPE    = 5;
static const uint8_t VSIT_SPLASH    = 6;
static const uint8_t VSIT_LANDED    = 7;


/***************************************************************************************
   MODE/STATUS FLAG BIT INDICES (bottom-right 6x2 grid, rev 2)
   state.modeFlags bit positions, row-major to match the grid draw order:
     Row 0: DEMO  WARP  AUDIO  AP_ARM  TRIM  AUTOPILOT
     Row 1: DEBUG SWITCH_ERR  SIMPIT_LOST  THRTL_PREC  INPUT_PREC  ENG_ARM
   All driven by the master over I2C (default off). Labels/colours in ScreenMain.
   NOTE: the exact label/colour/source for each tile is provisional — confirm
   against the final master protocol (several are not in the I2C spec yet).
****************************************************************************************/
// panel-lint: keep-begin — these name the WIRE FORMAT, not call sites. The tile grid is
// drawn by index from a table, so most of the twelve are never referenced by name; they
// exist so the master's I2C bit assignment is written down somewhere the firmware can be
// checked against. Do not delete the unreferenced ones as dead code.
static const uint8_t MF_DEMO        =  0;
static const uint8_t MF_WARP        =  1;
static const uint8_t MF_AUDIO       =  2;
static const uint8_t MF_AP_ARM      =  3;   // A/P INHIB / ARM switch (was THRTL ENA, same bit)
static const uint8_t MF_TRIM        =  4;
static const uint8_t MF_AUTOPILOT   =  5;
static const uint8_t MF_DEBUG       =  6;
static const uint8_t MF_SWITCH_ERR  =  7;
static const uint8_t MF_SIMPIT_LOST =  8;
static const uint8_t MF_THRTL_PREC  =  9;
static const uint8_t MF_INPUT_PREC  = 10;
static const uint8_t MF_ENG_ARM     = 11;
static const uint8_t MF_COUNT       = 12;
// panel-lint: keep-end
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
