bigJRo/KerbalControllerMk1/(commit log)

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2026-03-23 Update w/ bug fixes and new features
    Incorporated new features pioneered during the Resource Display development and incorproated bug fixes that coincide with recent KerbalDisplayCommon fixes.
    [ScreenMain.ino, SimpitHandler.ino]
2026-03-25 Minor bug fix and Resource Displ completion
    Minor bug fixes in both across Annunciator and Resource Display as well as implementing boot screen text for the resource display.
    [AAA_Config.ino, AAA_Globals.ino, BootScreen.ino, Demo.ino, I2CSlave.ino, KCMk1_ResourceDisp.h, KCMk1_ResourceDisp.ino, Resources.ino]
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2026-04-09 Updated files from pre-test optimization
    Incoporated bug fixes, optimizations, and pin assignment reviews
    [Buttons.cpp, Config.h, I2C.cpp, I2C.h, KCMk1_Joystick_Rotation.ino, KCMk1_Joystick_Translation.ino, KCMk1_PreWarp_Time.ino, KCMk1_Throttle_Module.ino]
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2026-06-28 Throttle firmware v2.0: full I2C protocol v2.4 conformance
    Brings the standalone Throttle Module firmware to conformance with I2C
    Protocol Specification v2.4 (resolves THR-001..004). The motor, wiper,
    touch, button, and precision-mode logic and the CMD_SET_THROTTLE /
    CMD_SET_PRECISION handlers already conformed and are preserved.
    data-changed, module type ID, transaction counter); the previous
    module-specific flags move to payload byte 3 (THR_PACKET_SIZE 4 -> 7)
    BOOT_REA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
    [Config.h, I2C.cpp, I2C.h, KCMk1_Throttle_Module.ino]
2026-06-28 Module sketches: implement UI Reference Open Items #7-#10
    Updates the four button-module sketches to the v5.x panel design and the
    v2.0 KerbalButtonCore library.
    - #8 Action Control (0x22): B10/B11 recoloured ROSE->GREEN — all twelve
    positions are now AG1-AG12 action groups. Former CP PRI/ALT moved to AUX
    CTRL; CTRL_MODE discrete inputs moved to the direct-wired Ctrl Mode Toggle.
    - #10 Stability Control (0x23): RCS added as a GREEN NeoPixel button at B10;
    former SAS_ENA/RCS_ENA discrete inputs at B12/B13 removed (moved to Switch
    Group 2); B14/B15 documented as the discrete staging input + interlock LED.
    - #7 Function Control (0x21): relaid out to LES / Fairing Jettison / Air
    Int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
    [KCMk1_Action_Control.ino, KCMk1_Function_Control.ino, KCMk1_Stability_Control.ino, KCMk1_Vehicle_Control.ino]
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2026-06-28 Controller: add per-type I2C packet-size + universal-header helpers
    Adds module_packets.h as the controller-side single source of truth for I2C
    packet framing under protocol v2.6:
    - moduleTotalPacketSize(typeId): total bytes to read per module type, covering
    the new 24-input switch-group modules (9 bytes: Function/Vehicle Control)
    and joystick modules (12 bytes), plus standard (7) and display (8).
    - moduleInputBytes(typeId): bitmask-plane width (2 or 3 bytes).
    - Universal header offsets (status/type/tx counter) and status-field accessors
    (lifecycle, fault, data-changed).
    Wires the resolver into the existing read handlers so they read the correct
    total size and parse past the 3-byte un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
    [Controller_Main.ino, function_definitions.ino, module_packets.h]
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2026-06-28 Controller: reconcile spec-derived structures to v5.x
    Aligns the master controller's specification-derived data and tables to the
    v5.x module design / I2C Protocol v2.6. The controller remains a broader
    work-in-progress (see note); this pass fixes the parts that are unambiguous
    and driven by the published specs.
    - I2C address map (Controller_Main.ino) rewritten to the v5.x registry
    (UI 0x20, Function 0x21, Action 0x22, Stability 0x23, Vehicle 0x24,
    Time 0x25, EVA 0x26, Joy Rot 0x28, Joy Trans 0x29, GPWS 0x2A,
    Pre-Warp 0x2B, Throttle 0x2C, Dual Encoder 0x2D, Switch Panel 0x2E);
    the removed "Panel Control" module is dropped. Absolute Windows include
    paths converted to relative (../C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
    [Controller_Main.ino, custom_action_grp_def.h, function_definitions.ino, module_variables.h]
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2026-06-28 Docs: reconcile module READMEs with canonical Module UI Reference
    Documentation-only pass aligning per-module docs with the canonical
    Module UI Reference (and, for byte layouts, the actual firmware):
    - UI Control (0x20) / Time Control (0x25): correct PCB designator
    KC-01-1822 -> KC-01-1802 (button-module board) and bump the
    KerbalButtonCore dependency reference to v2.0.0 (README + .ino).
    UI Control B5 relabelled "Navball Reference Cycle" per canonical.
    - Throttle (0x2C), Dual Encoder (0x2D), Switch Panel (0x2E) READMEs:
    data packet corrected from 4 -> 7 bytes (3-byte universal header was
    added in protocol v2.x); byte-layout tables rewritten from firmware.
    Switch Panel README not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
    [KCMk1_Joystick_Rotation.ino, KCMk1_Joystick_Translation.ino, KCMk1_Time_Control.ino, KCMk1_UI_Control.ino]
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2026-06-28 KerbalJoystickCore: correct axis/button pinout to KC-01-1832 schematic
    The joystick pin map was wrong in BOTH the firmware and the docs (and
    each was wrong differently). Per the KC-01-1832 schematic the correct
    mapping is:
    AXIS1 = PA5 (AIN5) AXIS2 = PA6 (AIN6) AXIS3 = PA7 (AIN7)
    BTN_JOY = PB5
    Firmware (KJC_Config.h) previously had AXIS1=PB5, AXIS2=PA7, AXIS3=PA6,
    BTN_JOY=PA5 — so axis data was read from the wrong pins. Corrected the
    KJC_PIN_* defines and ADC-channel comments; the ADC path reads through
    analogRead(KJC_PIN_AXISn) so no other code change is needed. Module
    READMEs, .ino headers, panel SVGs, and the KerbalJoystickCore README
    pin-assignment table all updated to match.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
    [KCMk1_Joystick_Rotation.ino, KCMk1_Joystick_Translation.ino]
2026-06-28 Action Control: fix panel SVG/README orientation (AG1 top-right)
    The panel_layout.svg and the README's Panel Layout text drew the panel
    mirrored — AG1 at the top-LEFT — contradicting the canonical Module UI
    Reference (and the sketch's own prose) which specify the panel reads
    right-to-left with AG1 at the top-RIGHT and AG12 bottom-left.
    The button->AG mapping was already correct (B10=AG1 ... B0=AG6); only the
    physical left/right rendering was flipped. Mirror the SVG horizontally so
    AG1/AG7 are on the right and AG6/AG12 on the left, relabel columns
    Col 1 (left) ... Col 6 (right), and fix the matching README orientation
    sentence. Also aligned the sketch header's ASCII grid comment (which h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
    [KCMk1_Action_Control.ino]
2026-06-28 Revert "Action Control: fix panel SVG/README orientation (AG1 top-right)"
    This reverts commit 3eb71c7731eb5dfb0f2e35c38697fcad4124cb1b.
    [KCMk1_Action_Control.ino]
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2026-06-28 Replace EVA module with Auxiliary Control (AUX CTRL) at 0x26
    The standalone 6-button EVA module (KC-01-1852) is retired and replaced
    by the canonical 12-button Auxiliary Control module — a standard
    KerbalButtonCore target on KC-01-1802, matching the Module UI Reference
    0x26 spec (EVA kerbal controls B0-B9 + Control-Point selection B10/B11,
    functions resolved controller-side).
    - Deleted Software/Modules/EVA/ entirely.
    - Added Software/Modules/Auxiliary Control/ (sketch + README + panel SVG).
    - Renamed I2C type 0x07 KMC_TYPE_EVA_MODULE -> KMC_TYPE_AUX_CTRL (value
    unchanged) across KerbalModuleCommon, controller (AUX_MOD), module_packets,
    Module Tester, and the KMC README; added KBC_TYPE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
    [Buttons.cpp, Buttons.h, Config.h, Controller_Main.ino, Encoders.cpp, Encoders.h, I2C.cpp, I2C.h]
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2026-06-28 Module Tester v2.0: rewrite for KC-01-9001 v2.0 (RA4M1 + touchscreen)
    Ground-up rewrite of the Module Tester for the new hardware and current
    protocol. The old serial-menu sketch (XIAO SAMD21, hard-coded protocol
    constants, Switch Panel/EVA leftovers) is replaced.
    New board (per schematic KC-01-9001 V2.0):
    - Seeed XIAO RA4M1 MCU
    - 2.8" ILI9341 240x320 SPI TFT with FT6236 capacitive touch
    - INA228 high-side V/I power monitor
    - Soft-latching 12V supply -> 5V/3V3; module fed via P1 (3.3V logic)
    Firmware (multi-file Arduino sketch):
    - KCMk1_Module_Tester.ino app state machine (splash/scan/dashboard)
    - TesterConfig.h pin map, I2C addresses, INA228 cal, timing
    - ModuleCa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
    [KCMk1_Module_Tester.ino, ModuleCatalog.cpp, ModuleCatalog.h, TesterConfig.h, TesterHW.cpp, TesterHW.h, TesterUI.cpp, TesterUI.h]
2026-06-28 Module Tester: verify parser, add per-board construction tests
    Parser verification: cross-checked hwParsePacket against every module's
    actual firmware packet-build code (KerbalButtonCore 16/24-input,
    KerbalJoystickCore, Kerbal7SegmentCore, Throttle, Dual Encoder). All byte
    layouts match. Two non-parser fixes from the review:
    - Catalog: display modules (GPWS, Pre-Warp) gain the 4th input, the
    encoder pushbutton (events bit 3), which was missing.
    - UI: joystick button chips now render from the persistent state byte
    (st.flags) instead of the one-frame rising-edge events byte.
    Latent bug fixed (found during the review): KMC_CMD_SET_THROTTLE /
    KMC_CMD_SET_PRECISION were referenced by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
    [ConstructionTest.cpp, ConstructionTest.h, KCMk1_Module_Tester.ino, ModuleCatalog.cpp, TesterUI.cpp, TesterUI.h]
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2026-07-04 Module Tester: switch display stack to Adafruit (RA4M1-compatible)
    LovyanGFX has no Renesas RA4M1 (renesas_uno) platform port — on the UNO
    R4 core its generic fallback fails to compile ('HardwareSPI' does not
    name a type) — and it also defines a global 'using RGBColor =
    lgfx::bgr888_t' that collides with KerbalModuleCommon's struct RGBColor.
    TesterUI.cpp is converted as a pure device-layer swap to Adafruit_GFX +
    Adafruit_ILI9341 (hardware SPI, software reset) + Adafruit_FT6206 (the
    FT6236 is register-compatible). All screens, layouts, palette values,
    and behaviors are unchanged; a single rawTouch() helper now owns the
    portrait->landscape touch mapping with in-place flip instructions for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
    [TesterUI.cpp]
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2026-07-04 Module Tester: portrait 240x320 re-layout of all screens
    Hardware bring-up showed the ER-TFT028A3-4 panel does not honor the
    ILI9341 row/column-exchange addressing the landscape build relied on:
    drawing clamped into the top 240 rows (overlapping text) and physical
    rows 240-319 were never written, showing GRAM power-up noise.
    Rework TesterUI.cpp for native portrait (rotation 0, 240x320):
    - uiBegin() clears the full 240x320 GRAM once at boot
    - Touch: FT6236 coordinates pass straight through (flip comments kept)
    - Two stacked 14px top bars (title / right-aligned power readout)
    - Scan: full-width 30px rows (up to 7), centered Rescan button
    - Dashboard: taller input area (y44-217), 4-chips-per-r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
    [TesterUI.cpp]
2026-07-04 Module Tester: correct display driver to ST7789V (Adafruit_ST7789)
    The ER-TFT028A3-4 panel uses an ST7789V controller, not an ILI9341 (per
    the buydisplay datasheet). The shared MIPI-DCS command set let the
    ILI9341 driver mostly work, but its init programs ILI9341-specific
    display-function/power/VCOM registers that misconfigure the ST7789V's
    line drive — observed on hardware as a permanent garbage band at the
    panel bottom that survives full-GRAM fills, plus a rotated-90-degrees
    orientation surprise.
    Swap TesterUI.cpp to Adafruit_ST7789 (tft.init(240, 320), rotation 0,
    same GFX API otherwise; invertDisplay() toggle documented in case this
    panel's inversion polarity differs). Controller name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
    [KCMk1_Module_Tester.ino, TesterConfig.h, TesterUI.cpp]
2026-07-04 Module Tester: robust INA228 reads, hold last power reading, scan flicker fix
    Hardware observation: the power readout intermittently flashed to all
    zeros, most often with no module attached. Root causes fixed:
    - _ina228Read() reported I2C failures as a 0 value and hwReadPower()
    set ok=true unconditionally, so transient bus glitches rendered as
    0.00V/0.00A. Reads now return an explicit success flag, use a full
    STOP between pointer write and read instead of repeated-start (flaky
    on the Renesas Wire core right after the scan's burst of NAKed
    probes), drain partial data, and retry the full set once. Persistent
    failure returns ok=false.
    - The app keeps the last good PowerReading and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
    [KCMk1_Module_Tester.ino, TesterHW.cpp]
2026-07-04 Module Tester: suppress phantom I2C devices in the bus scan
    With no module attached, the scan list would periodically flash grey
    "Unknown" rows (t:00 / t:FF): the Renesas Wire core's zero-length
    address probe occasionally returns a spurious ACK, and the follow-up
    identity read then yields no data (t:00) or floating-bus 0xFF bytes.
    Two-layer fix:
    - hwScanModules() requires an address to ACK two consecutive probes
    before it counts as present.
    - doScan() keeps only devices whose CMD_GET_IDENTITY reply is sane
    (4 bytes, type != 0x00/0xFF). Real modules always answer identity in
    every lifecycle state, so this cannot hide real hardware; an
    identified-but-uncatalogued type is still listed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
    [KCMk1_Module_Tester.ino, TesterHW.cpp]
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2026-07-04 Module Tester: presence hysteresis + identity cache in the bus scan
    On real hardware the GPWS module intermittently dropped to "No modules
    found" and returned: the scanner re-probed AND re-identified the module
    every 750 ms, and the ATtiny target answers I2C from an ISR — a single
    busy/glitched transaction failed the identity gate and removed it from
    the list for one cycle.
    Rework doScan() around a presence cache:
    - A module is identified ONCE when it first appears (with one in-scan
    retry); afterwards only presence-probed — no more per-scan identity
    interrogation (less ISR pressure on the target too).
    - An entry is removed only after 3 consecutive missed probes (real
    unplug); tran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
    [KCMk1_Module_Tester.ino]
2026-07-04 Module Tester: NeoPixel chip colors, bulb toggle, CT flicker fix, blue Back
    Batch of fixes/features from live GPWS bench testing:
    - Per-input NeoPixel colors: ModuleInfo gains an RGB565 color table
    (derived from the canonical KMC_* palette for all 13 module types);
    dashboard chips now light in the module's actual LED color so the
    screen visually cross-checks the board. GPWS chips render PERSISTENT
    state from the flags byte (GPWS Enable green in full mode / amber in
    proximity-only, Proximity/Radar green when active) — fixes the chip
    dropping back to grey when an encoder packet arrived. Toast text is
    now calm sky-blue (red reserved for failures); Back button is royal
    blue so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
    [ConstructionTest.cpp, I2C.cpp, KCMk1_Module_Tester.ino, ModuleCatalog.cpp, ModuleCatalog.h, TesterUI.cpp]
2026-07-04 Module Tester: fix display inversion (colors), CT SEG flicker, LED Cycle on display modules
    - Disable ST7789 inversion (invertDisplay(false)): the ER-TFT028A3-4 glass
    is normally-black, so the library's default INVON rendered every colour
    complemented — black bg showed white, royal-blue Back showed brown, green
    chips (GPWS Enable / Reset) showed purple, sky-blue toasts showed red. This
    restores the intended dark theme and true NeoPixel-matched chip colours.
    - stepSeg: keep the on-screen status text static ("Cycling 8888 / 1234") while
    still driving the module display through both patterns. Previously the text
    changed every second, which changed ctRender's signature and forced a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
    [ConstructionTest.cpp, KCMk1_Module_Tester.ino, TesterUI.cpp]
2026-07-04 Module Tester: GPWS-specific construction test sequence
    The generic display sequence assumed the master drives the 7-seg value and
    button LEDs directly. The GPWS Input module is autonomous: it lights its
    display and reports its secondary buttons only when the operator engages GPWS
    mode (BTN01), and it drives its own button LEDs (ignores CMD_SET_LED_STATE).
    So SET_VALUE showed nothing after enable and the LED walk did nothing.
    Give GPWS (selected by type ID, since the tester identifies each module) its
    own sequence: ENABLE -> BULB -> VALUEDELTA -> BTNWALK -> SUMMARY.
    - BULB replaces the SET_VALUE segment cycle: CMD_BULB_TEST lights every 7-seg
    segment and all button LEDs at once, regardle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
    [ConstructionTest.cpp]
2026-07-04 Module Tester: bulb-test the LEDs for generic display modules
    Pre-Warp Time (and any K7SC display module) drives its own button NeoPixels
    and ignores CMD_SET_LED_STATE, so the LED walk in the generic display sequence
    lit nothing. Replace it with a bulb-test step, which lights all 7-seg segments
    and all button LEDs via the module's own handler. The SET_VALUE segment cycle
    and live value/button steps stay, since these modules turn their display on and
    honour CMD_SET_VALUE as soon as they go ACTIVE (unlike GPWS, which keeps its
    dedicated table).
    STEPS_DISP: ENABLE -> SEG -> VALUEDELTA -> BTNWALK -> BULB -> SUMMARY.
    Button/joystick sequences keep the LED walk (those modules are master-driven).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
    [ConstructionTest.cpp]
2026-07-05 Module Tester: require a real value swing in the encoder/value-delta step
    The value-delta step flagged up/down on any one-count change against a running
    baseline, so a residual SET_VALUE report carried in from the preceding segment
    step (or single-count encoder jitter) could satisfy both directions and
    auto-advance before the operator turned the encoder.
    Track the running min/max of the reported value and require it to climb at
    least V_DELTA counts above its lowest point AND drop at least V_DELTA below its
    highest point before passing. A single residual value (min == max) and small
    jitter can no longer trip it; a deliberate up-then-down (or down-then-up) turn
    still passes from any starting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
    [ConstructionTest.cpp]
2026-07-05 Align Dual Encoder firmware with KC-01-1862 v2.0 schematic
    The Dual Encoder module firmware still carried the v1.0 (KC-01-1871/1872)
    pin map, which no longer matches the latest hardware design. Verified pin
    assignments against the KC-01-1862 V2.0 schematic and corrected them:
    ENC1_A : PC1 -> PC3 (channel A and switch were swapped)
    ENC1_SW: PC3 -> PC1
    ENC2_A : PA6 -> PA7 (encoder 2 moved to a new pin group)
    ENC2_B : PA5 -> PB5
    ENC2_SW: PA4 -> PB4
    ENC1_B (PC2), INT (PA1), SCL (PB0) and SDA (PB1) are unchanged.
    Also updates the board designator from KC-01-1871/1872 to KC-01-1862
    (matching the Hardware and Module UI references), refreshes the
    not-connected pin list, notes the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
    [Buttons.h, Config.h, KCMk1_Dual_Encoder.ino]
2026-07-05 Dual Encoder: fix fast-spin reversal; make tester Reset + button live view reliable
    Field testing on the Module Tester surfaced three issues:
    1. Spinning an encoder quickly registered the wrong direction. The module
    decoded quadrature by polling A/B every 5 ms with a time-gated debounce
    that kept a stale last-state. Sampling slower than the signal changes
    aliases: skip enough states and a CW turn reads as a single CCW step, so
    the sign flips at speed. Reworked to the same interrupt-driven scheme the
    7-Segment core uses — a rising-edge interrupt on each channel A samples
    channel B for direction — giving exactly +/-1 per detent with no aliasing
    or reversal at any turn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
    [Config.h, ConstructionTest.cpp, Encoders.cpp, Encoders.h, KCMk1_Module_Tester.ino, TesterUI.cpp, TesterUI.h]
2026-07-05 Throttle: correct pin map to KC-01-1871/1872 V2.0 schematic
    Config.h was pinned for the wrong board (its header cited KC-01-1861/1862, the
    Dual Encoder's number). Verified against KC-01-1871_V2.0_Throttle Module_SCH
    and corrected every mismatched pin:
    - Motor: MTR_FWD PB4->PA7, MTR_REV PB5->PA6, SPEED PB3->PC0
    - Buttons: THRTL_100 PA6->PB4, THRTL_UP PB2->PB3, THRTL_00 PC3->PC2
    (THRTL_DOWN PC1 unchanged)
    - LEDs: the board has ONE shared switch-backlight enable (LED_ENA, PC3), not
    four independent LEDs. Replaced the four THR_PIN_LED_* pins with THR_PIN_LED_ENA
    and updated Buttons.cpp/.h (which already drove the LEDs only as a group).
    - Added THR_PIN_THRTL_ENA (PB5) for the 5th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
    [Buttons.cpp, Buttons.h, Config.h, KCMk1_Throttle_Module.ino]
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2026-07-05 Firmware comments: fix factual errors + normalize license/terminology
    Repo-wide comment review across the module libraries and firmware, correcting
    comments that contradicted the code and unifying style.
    Factual fixes:
    - KerbalButtonCore: purge stale discrete-LED wording from setBrightness/render/
    header docs; correct the _remap banner (uint32_t / KBC_INPUT_COUNT, not
    uint16_t/16); "Bumped to 2" minor-version note; pulse-width note (begin()
    always applies it); add missing @param altColors; remove the orphaned
    KBC_DISCRETE_ON alias; refresh example color arrays (12-15 = switch inputs).
    - Kerbal7SegmentCore: fix inverted MAX7219 digit-orientation comments (reg1 =
    leftmost); correct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
    [Buttons.cpp, Buttons.h, I2C.cpp, I2C.h, KCMk1_Action_Control.ino, KCMk1_GPWS_Input.ino, KCMk1_PreWarp_Time.ino, KCMk1_Stability_Control.ino]
2026-07-05 Firmware: remove Indicator module, unify @version, bump spec cites to v2.9
    Follow-up to the comment review, per project decisions:
    - Remove the Indicator module firmware entirely (Software/Modules/Indicator/) —
    it is no longer a physical design. Retired its Type ID 0x10 in
    KerbalModuleCommon (define removed, registry rows in the header and README
    marked retired like 0x0F). This also resolves the stale conformance-claim
    comments that module carried.
    - Unify every module/library file header to @version 2.0.0 in X.Y.Z form
    (was a mix of 1.0 / 1.1.0 / 2.0 / 2.2 / 2.0.0). KerbalModuleCommon keeps its
    own independent version (1.7.1).
    - Bump the I2C Protocol Specification version cit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
    [Buttons.cpp, Buttons.h, Config.h, Encoders.cpp, Encoders.h, I2C.cpp, I2C.h, KCMk1_Action_Control.ino]
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2026-07-10 Annunciator: GFX-Common API fixes for compile (setFont ref, drop setXY)
    - BootScreen _bs_check/_bs_print: setFont takes a reference (deref BS_FONT/font).
    - ScreenSOI drawStaticSOI: remove RA8875-only setXY(0,0); GFX fillScreen needs
    no prior cursor set.
    Preempts the same pointer-vs-reference issue already fixed in the library.
    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
    [BootScreen.ino, ScreenSOI.ino]
2026-07-10 Annunciator: aesthetics + demo coverage fixes (observations #1-9)
    Layout/labels:
    - drawVerticalText now distributes chars evenly across the box (centred per
    slot) instead of fixed cap_height stacking — DOCKED fits all 6 letters, tighter
    (#1).
    - Vessel-name field gets a grey border; add a light perimeter around the whole
    bottom zone so the bottom/side edges read consistently (#2, #3).
    - "Cap:" -> "Max Crew:" (smaller font in that cell so label+value fit) (#4);
    "COM:" -> "COMM:" (#5).
    - SPCFT tile: left-aligned text with the right ~80px reserved for the vessel
    icon; own border (#6).
    Demo coverage:
    - Add LANDED to the situation sweep (lights LANDED + CONTACT) and mirror
    sit_Lande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
    [Demo.ino, ScreenMain.ino]
2026-07-10 Annunciator: aesthetics round 2 + lamp test (observations #1-9)
    - DOCKED -> "DOCK" at 20pt (fits cleanly, larger, consistent with regime tiles) (#1).
    - Bottom-zone perimeter inset 1px so the bottom border clears the overscan edge (#2).
    - "Max Crew:" -> "SEATS:" at full 28pt (fits label+value; clearer term) (#3).
    - Unify greens: situation flags + DOCK now TFT_DARK_GREEN to match regime/C&W/
    telemetry (#6).
    - SPCFT/TimeWarp/CtrlGrp confirmed all 28pt (no change) (#5); COMM already fixed (#4).
    - SOI detail screen: row height 36->52, data font 28->40pt (#9).
    Demo:
    - DEMO/AUDIO/DEBUG mode-grid tiles now reflect demoMode/audioEnabled/debugMode
    steadily; the other tiles still walk for inspecti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
    [AAA_Config.ino, Demo.ino, KCMk1_Annunciator.h, ScreenMain.ino, ScreenSOI.ino]
2026-07-10 Annunciator tuning round 3: DOCK compaction, borders, situation column, lamp test, colors, CAP label
    - drawVerticalText: pack letters at ~0.8x cap-height pitch and centre the whole
    stack (was even h/len distribution that left visible inter-letter gaps); fall
    back to even distribution only when the stack would overflow. DOCK label bumped
    to Roboto_Black_24 (fits 4 letters in 100px with the tighter pitch). (#1)
    - drawStaticMain: move the bottom-zone perimeter drawRect to the very end so its
    bottom edge lands on top of every tile fill in the zone. CtrlGrp's own box
    border sits on the overscan row (invisible), so it now inherits this line and
    reads with a bottom border consistent wit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
    [ScreenMain.ino]
2026-07-11 Annunciator tuning round 4: DOCK size, jungle situations, larger mode grid, CREW, persistent bottom border
    - DOCK label font Roboto_Black_24 -> Roboto_Black_16 to match the regime tiles
    (FLYING LOW etc.); the tight-pitch drawVerticalText keeps it a compact centred
    block. (#1)
    - Situation tiles PRE-LAUNCH/FLIGHT/SUB-ORBIT/ORBIT/ESCAPE/LANDED on-colour back to
    TFT_JUNGLE (CONTACT stays sky, SPLASH stays navy). (#2)
    - Mode/config grid text Roboto_Black_12 -> Roboto_Black_16 (cap 19; two lines fit
    the 40px tile). AUTOPILOT -> "AUTO PILOT" so the one long single word wraps
    instead of being skipped for exceeding tile width at the larger font. (#3)
    - CREW: telemetry label capitalised (was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
    [ScreenMain.ino]
2026-07-11 Mode grid text back to _12; fix master-alarm audio not sounding on screen entry
    1. Mode/config grid font Roboto_Black_16 -> Roboto_Black_12: at _16 the labels
    overflowed the 40px tile borders. Reverted AUTOPILOT back to a single word
    (fits one line at _12; the _16-era space is no longer needed).
    2. Master-alarm tone silent while MASTER ALARM lit: the alarm tone was only
    started/stopped by updateScreenMain()'s C&W block, which fires only on a bit
    TRANSITION while already on the Main screen. drawStaticMain() syncs
    prev.cautionWarningState = state on entry, so any alarm condition already
    active on arrival (guaranteed under lampTest, and common in normal flight)
    never produ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
    [Audio.ino, KCMk1_Annunciator.h, KCMk1_Annunciator.ino, ScreenMain.ino]
2026-07-11 Fix boot phantom-touch jumping to SOI (which also blocked master-alarm audio); loosen DOCK spacing
    Root cause of "boots into SOI" and "no audio" was a single settling touch:
    - The FT5316 can report a spurious touch for a short window after its reset. The
    only code path to the SOI Detail screen is a touch in the upper-left region on
    the Main screen, so that phantom was knocking the panel onto SOI at startup.
    - All master-alarm audio triggering lives in updateScreenMain(), and leaving the
    Main screen calls audioSilence() by design. So once stuck on SOI, the alarm tone
    code never ran -- the panel looked alarmed (MASTER ALARM tile) but stayed silent.
    TouchEvents: require at least one co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
    [TouchEvents.ino]
2026-07-11 Boot screen: bigger text, real subsystem status, faster pacing
    Polish + real + faster rework of the POST sequence:
    - Text enlarged to TerminalFont_32 for the title, checks, and summary (version and
    attribution stay at _16 as fine print; the long version string overflows at 32px).
    Status column computed at runtime from a fixed 19-char label slot so statuses
    align regardless of the font's glyph advance.
    - Checks now report REAL status instead of canned OK! lines:
    DISPLAY -> OK (rendering, so up)
    TOUCH -> OK / FAIL from probeTouch() (new FT5316 I2C ACK probe)
    SD CARD -> OK / NONE from setupSD()'s return (missing card is non-fatal, yellow)
    AUDIO / I2C SLAVE -> OK
    K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
    [BootScreen.ino, KCMk1_Annunciator.ino]
2026-07-11 Boot screen: add tuning pause (slow pacing + hold for tap)
    BS_TUNE_PAUSE (in BootScreen.ino, so it won't collide with local AAA_Config edits):
    when true, per-line reveal slows to 400ms and the finished screen shows a
    "TAP TO CONTINUE" prompt and freezes until a deliberate tap so the layout can be
    inspected. _bs_holdForTouch() clears any lingering/boot-phantom touch, waits for a
    press, then waits for release so the tap isn't consumed as a gesture on Main.
    Set BS_TUNE_PAUSE = false to restore the fast production auto-advance.
    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
    [BootScreen.ino]
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2026-07-11 Boot screen: revert version line to terminal-16 branding, shrink diagnostics, restore watermark
    Addresses tuning feedback:
    1. Version line back to the previous aesthetic: "Jeb's Controller Works v.. KDC..
    KDA.." at TerminalFont_16 (was the oversized _32 "FW.." line). Terminal font only
    exists at 16/32 with no clean in-between, so kept at 16 per preference.
    2. Diagnostics dropped to TerminalFont_16 (their own 11-char status column) so they
    read as subordinate to the _32 checks instead of the whole screen being uniform.
    Diag values coloured aqua.
    3. Copyright watermark "Jeb's Controller Works // C-2026" restored at the bottom in
    BOTH modes; in dev (BS_TUNE_PAUSE) the "TAP TO CO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
    [BootScreen.ino]
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2026-07-11 Rename body/meatball BMPs to real 236x164 size + centre them via shared constants
    The *_240x168.bmp files were actually 236x164. Rename all 18 (17 body globes +
    KASA_Meatball) to *_236x164.bmp and repoint every reference:
    - KerbalDisplayCommon.cpp body table (17 paths) + the h struct-comment example.
    - ScreenSOI.ino meatball path.
    Centre the art on its real dimensions via new shared BODY_IMG_W/H (236x164) in
    KCMk1_Annunciator.h:
    - Main globe: (SOI_GLOBE_W-BODY_IMG_W)/2 etc -> (19,230); was hardcoded 240/168 ->
    (17,228), i.e. 2px off-centre. Now correct.
    - SOI meatball + right body BMP: centred in the SOI_IMG_W x SOI_IMG_H slots
    (evaluates to the same 2,2 / 786,2, now explicit rather tha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
    [KCMk1_Annunciator.h, ScreenMain.ino, ScreenSOI.ino]
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2026-07-11 InfoDisp Phase 1 compile fixes: surfGrav->gravity, exclude 4 superseded screen files
    First full compile surfaced pre-existing issues (not from the mechanical port):
    - BodyParams renamed surfGrav (Earth-g) -> gravity (m/s²). Fixed the 3 call sites in
    Screen_LNCH_Ascent and Screen_LNCH_Circ: use currentBody.gravity directly in the
    mu = g*r^2 formulas and drop Ascent's now-redundant *9.81 (Earth-g->m/s² conv).
    - Screen_ATT / Screen_RNDZ / Screen_MISC / Screen_APSI are dead, superseded files
    (Screen_TGT's own header: "Replaces Screen_RNDZ.ino ... Delete Screen_RNDZ.ino";
    ATT->SCFT, APSI->ORB). All their functions were "defined but not used", and ATT/
    RNDZ referenced enum values remov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
    [Screen_LNCH_Ascent.ino, Screen_LNCH_Circ.ino]
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2026-07-11 InfoDisp: sidebar bottom-border fix, drop touch dead-zone, 84px sidebar
    Follow-up tuning to the Phase 2 nav framework:
    - AAA_Screens.ino (drawSidebar): the 12 buttons tile to row 599 (the panel's
    final scanline), where the last button's bottom border is hidden by the bezel.
    Clamp the last button's height so its border lands on SCREEN_H-2 and stays
    visible. Also clamp the sidebar divider line to the last on-panel row.
    - TouchEvents.ino: remove the bottom Y dead-zone guard. It was a GSL1680
    edge-noise workaround (rev-1); the FT5316 does not ghost at the boundary, and
    the guard was swallowing taps on the bottom sidebar button (REEN). Drop the
    now-unused TOUCH_DEAD_ZONE constant and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
    [AAA_Screens.ino, KCMk1_InfoDisp.h, TouchEvents.ino]
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2026-07-11 InfoDisp: TEMP touch diagnostics for sidebar hit-test
    Tapping the bottom REEN button lands on the LANDING button instead. The touch
    math (y2 / (SCREEN_H/12)) and the sidebar geometry agree, and the vendor touch
    mapping is confirmed, so instrument to capture what the panel actually reports
    in the y 480-599 band (never exercised under the Phase-1 letterbox).
    - setup(): enable setTouchDebug(true) under debugMode — prints raw->mapped coords.
    - TouchEvents sidebar hit-test: log final x/y, computed button index, and ID.
    To be reverted once the mapping is understood.
    Claude-Session: https://claude.ai/code/session_01MfMjxhbhDzv5hr8pUwDtQ2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
    [KCMk1_InfoDisp.ino, TouchEvents.ino]
2026-07-11 InfoDisp: TEMP enable debugMode for touch diagnostics
    The touch/sidebar diagnostic prints are gated on debugMode, which defaults to
    false in the committed config, so nothing appeared on serial. Turn it on for the
    diagnostic build. Revert to false along with the diagnostics.
    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
    [AAA_Config.ino]
2026-07-11 InfoDisp: fix REEN screen kicking back to LANDING (retarget re-entry to screen_LNDGRE)
    Root cause found via touch diagnostics: the tap resolved correctly to REEN
    (btn 11, screen 11) — then the re-entry DRAW function immediately switched to
    screen_LNDG (powered descent, screen 6). Screen_LNDG_Reentry.ino was written
    when re-entry was a sub-mode of screen_LNDG (index 6): on a row-label toggle it
    called switchToScreen(screen_LNDG) to force a chrome redraw of itself, and cached
    under rowCache[6]/printState[6]. Now that re-entry is its own screen (screen_LNDGRE
    = 11), those calls threw the user to powered descent, and the cache index no
    longer matched drawStaticScreen(11)'s invalidation.
    - Ret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
    [AAA_Config.ino, KCMk1_InfoDisp.ino, Screen_LNDG_Reentry.ino, TouchEvents.ino]
2026-07-11 InfoDisp Ascent: single override dot + full-height 400px right readout panel
    1. Fix the double manual-override red dot. Screen_LNCH.ino drew a per-frame
    indicator at the hardcoded old-screen x=706 while drawStaticScreen drew the
    chrome dot at CONTENT_W-14. Point both at CONTENT_W-14 so they coincide as
    one indicator near the sidebar.
    2. Redesign the Ascent numeric readout panel for the full 1024x600 panel:
    right-aligned to the content edge (flush against the sidebar), 400 px wide,
    stretched to fill the full height below the title bar (8 rows x 67 px), and
    larger fonts (labels Roboto_Black_28, values Roboto_Black_36). Introduces
    Ascent-only LNCH_AS2_* geometry + _lnchAs2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
    [Screen_LNCH.ino, Screen_LNCH_Ascent.ino]
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2026-07-11 InfoDisp: compact >1day time format + taller V.Vrt/V.Orb bars
    1. formatTime: past 1 day, switch from the verbose "D d: HH h: MM m: SS s" to a
    compact "Dd HH:MM" (drops seconds) so long durations stay narrow enough for
    tight value cells (e.g. T.Brn/T+Ap). Global change — all screens benefit.
    2. Expand V.Vrt and V.Orb bars to a shared tall gauge band (body 130..556) so
    they fill the vertical space alongside the taller ladder, and enlarge their
    labels: names Black_16 -> Black_20, endpoint labels Black_12 -> Black_16.
    Endpoint units ("m/s") dropped so the larger text fits the 40 px bar's label
    box. New LNCH_AS_GAUGE_* band constants will be shared by the FPA arc and the
    a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
    [Screen_LNCH_Ascent.ino]
2026-07-11 InfoDisp Ascent: bar labels/width/borders, ATMO ticks+twin markers, FPA semicircle, spacing
    Bars (V.Vrt/V.Orb):
    - Restore "m/s" unit on the endpoint labels.
    - Widen bars 40 -> 52 px and the label box (LBL_OVERHANG) so "+500 m/s" fits.
    - Fix the missing top border: give the top label more clearance and draw the
    border/zero-line LAST so a label glyph can't nibble it.
    ATMO gauge:
    - Ticks in the bright SKY (top) zone use a darker color (DARK_GREY) so they no
    longer wash out against the light background.
    - Add a second triangle indicator on the RIGHT of the bar (mirrors the left),
    and nudge the whole gauge left (ATMO_RIGHT_GAP) so the right marker clears the
    readout column by the standar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
    [Screen_LNCH_Ascent.ino]
2026-07-11 InfoDisp Ascent: narrower bars, tighter spacing, larger FPA
    - V.Vrt / V.Orb bars narrowed 52 -> 44 px; ATMO bar set to the same 44 px.
    - Compact horizontal whitespace: COL_GAP 16 -> 12 (LBL_OVERHANG 12 -> 14 so the
    "m/s" labels still fit the narrower bars). Frees room for the FPA.
    - FPA semicircle grown ~45%: R 66 -> 96 (height 132 -> 192), with the needle,
    ticks and pivot scaled to match. Now fills more of the band.
    All positions derive from the layout anchors, so the cluster reflows with even
    12 px gaps and the right-anchored ATMO clears the readout by 18 px. Verified no
    overlaps.
    Claude-Session: https://claude.ai/code/session_0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
    [Screen_LNCH_Ascent.ino]
2026-07-11 InfoDisp Ascent: reorder columns, enlarge FPA labels/marker, top-align FPA
    Reorder the left-panel graphic columns to: ladder | ATMO | V.Vrt | V.Orb | FPA.
    The ATMO gauge is now left-anchored right after the ladder (feeding the bar
    chain), and the FPA dial is the rightmost column. Constants reordered so each
    column derives from the previous one; COL_GAP tightened to 10 to fit the FPA.
    FPA:
    - +90 / -90 / 0 angle labels enlarged Black_12 -> Black_20 and repositioned with
    clearance from the tick marks (they were running into the ticks).
    - Target (orange) marker enlarged (~1.7x).
    - Top-align the dial: arc top now sits near the gauge body top (CY derived from
    BODY_TOP + R) instead of vertical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
    [Screen_LNCH_Ascent.ino]
2026-07-11 InfoDisp Ascent: heading tape below the FPA dial (with 90° launch bug)
    Fill the whitespace under the FPA with a horizontal heading tape, modeled on the
    Spacecraft screen's HDG tape:
    - Scrolling compass centered on the current vessel heading (state.heading), with
    a numeric "NNN°" box at center and N/E/S/W + degree tick labels.
    - Amber bug fixed at 90° (due-east launch azimuth) — the primary reference.
    - Green velocity-vector heading marker (state.srfVelHeading), shown only above
    20 m/s surface speed so it doesn't jitter on the pad.
    Geometry derives from the FPA anchors: centered horizontally under the dial and
    vertically in the gap between the FPA readout and the band bottom. Change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
    [Screen_LNCH_Ascent.ino]
2026-07-11 InfoDisp Ascent: HDG tape tweaks, unify FPA/HDG label fonts, center GND label
    - HDG tape: minor ticks every 5° (was 2°) since the tape is narrow; drop tape
    labels that would run off an edge instead of clamping them (clamping made them
    stall and bunch as the tape scrolled).
    - HDG title "HDG" -> Black_20 to match the FPA label font.
    - FPA numeric readout Black_28 -> Black_20 to match the HDG box value / arc labels
    (uniform Black_20 across the FPA + HDG group).
    - Ladder: center the GND label on its ground line (matching ATM/ORB) now that the
    ladder bottom clears the screen edge.
    Claude-Session: https://claude.ai/code/session_01M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
    [Screen_LNCH_Ascent.ino]
2026-07-11 InfoDisp: Model A double buffering (RA8876 page flip)
    Redraw the entire active screen to the hidden back page each frame, then
    flip — eliminating the single-buffer overdraw artifacts (ticks drawn
    through label text, ATM/TGT/ORB/GND reference lines, etc.) and giving a
    tear-free presentation.
    - Add global KCMDoubleBuffer infoDB (declared extern in KCMk1_InfoDisp.h,
    defined in AAA_Globals.ino).
    - setup(): infoDB.begin(infoDisp) after setRotation so the boot/standby
    splash lands on the visible page 0.
    - drawStandbyScreen(): present the splash via beginFrame/flip; the loop
    returns early during standby so the held image stays on screen.
    - loop(): standby returns early; a screen transition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
    [AAA_Globals.ino, KCMk1_InfoDisp.h, KCMk1_InfoDisp.ino]
2026-07-11 InfoDisp LNCH Ascent: reflow FPA column, shrink dial labels, add AoA gauge
    Rework the rightmost column into a top→bottom stack that reflows from the
    layout anchors: HDG tape at the top (name row top-aligned with the V.Vrt
    name), FPA dial vertically centered between the HDG and AoA blocks, and a
    new AoA gauge in the bottom whitespace.
    - FPA angle labels (+90/0/-90) drop from Black_20 to Black_16 to match the
    V.Vrt "±500 m/s" endpoint labels; positions derive from new P90/M90/LBL_H
    anchors.
    - FPA numeric readout gets a light-grey bordered box (drawn in chrome,
    interior repainted per update) matching the HDG number-box aesthetic.
    - "FPA" title relocated to sit above the +90 label, cen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
    [Screen_LNCH_Ascent.ino]
2026-07-11 InfoDisp: add frame-rate / render-time diagnostic to loop
    New fpsDiag flag (default true) prints ~1 Hz to Serial:
    - FPS: end-to-end frames/sec (all loop work included)
    - render ms avg/min/max: drawStatic + updateScreen + flip's wait-for-GPU,
    i.e. the true per-frame cost, timed with the beginFrame frame-period
    spin-wait excluded so it isolates draw work from idle time.
    Comparing the two shows whether we're capped by the ~20 ms double-buffer
    frame period (render < 20 ms, FPS ≈ 50) or render-bound (render > 20 ms,
    FPS ≈ 1000/render). Set fpsDiag = false in AAA_Config.ino to silence.
    Claude-Session: https://claude.ai/code/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
    [AAA_Config.ino, KCMk1_InfoDisp.h, KCMk1_InfoDisp.ino]
2026-07-11 InfoDisp: split FPS diagnostic into chrome / update / flip-wait
    Break the per-frame render time into its three phases so we can see where
    the ~244 ms full-redraw cost lives:
    - chrome: drawStaticScreen (fillScreen + all static labels/borders)
    - update: updateScreen (all dynamic values, tape, gauges)
    - flipwait: flip()'s block until the async 2D engine finishes queued
    geometry (fills/lines/triangles complete here)
    Synchronous glyph rasterization shows up in chrome/update; async geometry
    completion shows up in flipwait. This tells us whether the bottleneck is
    text (must go incremental) or fills/lines (optimizable).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
    [KCMk1_InfoDisp.ino]
2026-07-11 InfoDisp: incremental double buffering via RA8876 BTE page copy
    Model A (full redraw every frame) measured 244 ms/frame = ~4 fps on Launch
    Ascent — the split showed chrome 157 ms + update 86 ms, flipwait 0, i.e. it
    was re-rasterizing all unchanged text every frame (synchronous glyph blits).
    Switch to incremental drawing on top of the double buffer, using the
    RA8876's Block Transfer Engine:
    - KCMDoubleBuffer::beginFrameCopy() does a hardware bteMemoryCopy of the live
    front page into the hidden back page (then check2dBusy), so the back page
    exactly mirrors what's on screen. Incremental, change-detected updateScreen
    then redraws only what moved/changed and its erase/repair; unchanged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
    [KCMk1_InfoDisp.ino]
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2026-07-11 InfoDisp: remove temporary per-section profiler, quiet fpsDiag by default
    Performance work is settled at ~32 fps on Launch Ascent (was 4 fps): fast
    glyph blitter + writeRect page fix + triple buffering. The remaining ~30 ms
    frame is almost entirely the full-page BTE copy (27.5 ms); update is ~3 ms.
    - Drop the temporary LNCH-left / LNCH-right per-section timing from the value
    functions (it served its purpose pinpointing the text hotspot).
    - Default fpsDiag = false so production is quiet; the FPS/work diagnostic in
    loop() stays available behind the flag.
    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
    [AAA_Config.ino, Screen_LNCH_Ascent.ino]
2026-07-11 InfoDisp LNCH Ascent: remove AoA, FPA back to top, HDG to bottom, 2° ticks
    Rework the rightmost column per feedback:
    - Remove the AoA gauge entirely (too crowded) — constants, state, functions,
    chrome/value wiring, and reset all deleted.
    - FPA dial back to top-aligned: "FPA" name on the shared gauge name row
    (aligned with the V.Vrt/V.Orb names), arc top ≈ gauge body top.
    - HDG tape dropped to the bottom: its number-box bottom is now flush with the
    ATMO bar bottom (GAUGE_BODY_BOT); tape and name stack upward from there.
    - Heading tape minor ticks back to every 2° (were 5°).
    Layout: FPA name 80, dial 144–336, value box 378–412; HDG name 502, tape
    528–556, box 528–562. All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
    [Screen_LNCH_Ascent.ino]
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2026-07-11 InfoDisp LNCH Circ: match right readout panel to the ascent phase
    Convert the circularization phase's right text region to the ascent phase's
    LNCH_AS2_* layout so the two LNCH phases present an identical readout: 360 px
    wide at x=580 (right-aligned to the content edge), full height, 8 rows of 67 px,
    Black_28 labels / Black_36 values, with the same full-height vertical divider and
    group dividers. Same 8 rows (Alt.SL, V.Orb, ApA, PeA, T+Ap, Thrtl, T.Brn, ΔV.Stg)
    and change-detection state; only geometry/fonts changed (were the shared
    LNCH_AS_RPANEL_* at x=453/267 px, Black_20/Black_24).
    Left panel (orbit diagram, ΔV bar, ATT/IGN/Burn-Dur cluster) is unchanged for
    now — its readout moving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
    [Screen_LNCH_Circ.ino]
2026-07-11 InfoDisp LNCH Circ: remove the IGN button
    Remove the burn-active IGN lamp from the circularization left panel per
    feedback — its function/aspect is disliked, and engine-firing is already
    conveyed by the Thrtl readout on the right panel. Deletes the button geometry,
    the _lnchOrUpdateIgnButton draw fn, its _lnchOrPrevBurnActive state + resets,
    and the per-frame call. (T+Ign / TIGN time-to-ignition row is unrelated and
    kept.) Left-panel redesign to reclaim the freed space follows.
    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
    [Screen_LNCH_Circ.ino]
2026-07-12 InfoDisp LNCH Circ: reflow left panel for the widened graphics area
    Reorganize the circularization graphics into a "burn director" layout that uses
    the now-576-px-wide panel and full height:
    - Orbit diagram is the hero: enlarged (R 140->186) and re-centered (CX 280->348,
    CY 234->272) to dominate the center-right.
    - ATT alignment disc moves to a left rail and grows slightly (R 52->58, CX 60->74,
    CY 150->172), with the Burn Dur readout beneath it.
    - ΔV Burn bar becomes a full-width bottom band (x 40..536, was 53..399) and the
    T+Ign countdown below it is made prominent at Black_36 (was Black_24; row
    31->48 px) as the "burn now" cue.
    - Bar-area clear widened to the new panel edge (LNCH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
    [Screen_LNCH_Circ.ino]
2026-07-12 InfoDisp LNCH Circ: bottom-band font sizes, larger orbit markers, FPS diag on
    - Fix ΔV Burn value clipping the bar: move the label row up and add a 6 px gap
    to the bar (BAR_LBL_Y 486->483, BAR_Y 512->518), value clear region 24->31 px.
    - ΔV Burn label + value up one size (Black_20 -> Black_24).
    - T+Ign label + value down one size (Black_36 -> Black_28); row 48->40 px.
    - Orbit diagram R 186->180 to keep clearance under the taller bottom band and
    the larger Ap/Pe labels.
    - Pe/Ap dots 3->5 px, labels Black_12 -> Black_16, outboard offset 12->15 px;
    erase radii/rects widened to match.
    - Vessel dot 4->6 px; direction chevron ~1.4x (tip 7->10, base 5->7); erase
    radii widened to match.
    -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
    [AAA_Config.ino, Screen_LNCH_Circ.ino]
2026-07-12 InfoDisp LNCH Circ: add ΔV-to-circularize readout; drop 5 Hz graphic throttle
    - Fill the left-rail whitespace below Burn Dur with a "ΔV Circ" readout: the
    vis-viva estimate of the ΔV needed to circularize at apoapsis (label Black_20,
    value Black_28 dark-green, "---" when sub-orbital). Change-detected on rounded
    m/s; centered on the ATT column.
    - Extract the estimate into a shared _lnchOrCircDvEstimate() helper and refactor
    the ΔV Burn bar's no-node estimate branch to use it (single source of truth).
    - Remove the ~5 Hz (200 ms) redraw cap on the orbit graphic + bar. That cap
    existed to hide single-buffer redraw flicker, which the double buffer now
    handles by drawing to the hid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
    [Screen_LNCH_Circ.ino]
2026-07-12 InfoDisp: quiet fpsDiag after Circ refresh-rate check
    Circularization measured 28-32 fps with the 5 Hz throttle removed (coasting ~32,
    orbit-morphing burn ~28-30; the full orbit-curve re-stroke adds only ~3-4 ms of
    update over the ~27.5 ms BTE copy). Refresh rate is healthy — turn the
    diagnostic back off for normal use.
    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
    [AAA_Config.ino]
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2026-07-12 InfoDisp LNCH Circ: keep Pe/Ap/vessel dots on top of the curve and body
    The dots sit on the orbit curve (Pe can also sit on the body edge) but were
    only repainted when their own position changed. When the curve re-strokes
    (orbit morphing during a burn) or the static layer (body/atmo/target) redraws,
    it painted over a stationary dot, leaving it partially clipped.
    Add a markers_dirty flag (any_erase || static_geom_changed) and repaint the
    Pe/Ap/vessel dots whenever anything beneath them was redrawn this frame, so they
    always sit on top. Cheap (a few fillCircles + two labels) and only fires on
    frames that already redrew the curve/body.
    C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
    [Screen_LNCH_Circ.ino]
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2026-07-12 InfoDisp demo: hold the pre-launch board ~30 s (freeze t during pad hold)
    Make the pre-launch board easier to study: prepend a 30 s pad HOLD to the LNCH
    demo cycle with the profile time frozen at t=0, then run the full 180 s ascent.
    Freezing t means no ascent time is skipped when the board clears. Hold duration
    is a single constant (DEMO_PL_HOLD_MS) if you want it longer/shorter.
    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
    [Demo.ino]
2026-07-12 InfoDisp demo: revert the pre-launch board hold rig
    Launch variants are done — remove the demo rigging that held the pre-launch
    board for review:
    - Restore the LNCH demo profile timer (t = millis()%180000) and the original
    situation logic (sit_PreLaunch only for t<1s); demo no longer drives
    _lnchPrelaunchMode / switchToScreen.
    - Restore the loop order (stepDemoState after the screen-change check).
    Kept the one-line state.electricChargePercent demo population (fills a field the
    demo left unset; unrelated to the hold).
    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
    [Demo.ino, KCMk1_InfoDisp.ino]
2026-07-12 InfoDisp ORB: expand both panels to fill half the 1024x600 area
    Redesign the Orbit screen for the rev-2 940x600 content area. The two
    graphical elements (PLAN orbit view and INCL inclination view) each now
    fill half the width: divider moves 360 -> 470, PLAN centres at x=235,
    INCL at x=705. Shared vertical centre drops to y=287 to use the taller
    screen, with graphics spanning the header bottom (y=92) down to the
    readout strips.
    - ORB_MAX_R 150 -> 190 (orbit half-extent)
    - INC_L 130 -> 185, INC_BR 20 -> 26 (inclination line + body disc)
    - PLAN x[6,354]->[6,468], y1 400->508; INCL x[362,719]->[476,938], y1 374->482
    - Escape/SOI radii scaled to match: PRE_SCALE_PX 167->210, SOI_PX 155->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
    [Screen_ORB.ino]
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2026-07-12 InfoDisp OrbAdv: redesign for 1024x600
    The advanced (full-numeric) orbit screen was still on the mechanically
    ported 720x480 layout — divider at x=360, both columns crammed into the
    top-left, 28pt text. Rework it to match the redesigned basic ORB screen:
    - Panel divider x=360 -> 470, full 600px height
    - Text 28 -> 36pt (cap 43)
    - Left column fills x=[0,470], right column x=[470,940]; values
    right-justified to an 8px inset (left edge 462, right edge 930)
    - Row pitch 40 -> 73, first row y=100 -> 90, so the 7 rows fill the
    full height (last row bottom ~571)
    Value cells verified against worst-case strings at 36pt: "5 h: 06 m: 07 s"
    (241px) fits the 294px right column; "999,99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
    [Screen_OrbAdv.ino]
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2026-07-12 InfoDisp MNVR: fix ΔV value/bar overlap, add Brg/Elv decimal, more top gap
    1. ΔV Burn value sat ~1 px above the bar border (touching). Bumped the
    label/value line up (lblY = barY-34, barY = CY+R+42) so the Black_24
    text clears the border by ~5 px; label and value stay on one line.
    2. Brg/Elv values now show 1 decimal (%+.1f). They render in Black_28
    (vs the panel's Black_36) so the widest case (±180.0°, 98 px) fits the
    ~117 px half-cell; at 36 pt the decimal form overflowed.
    3. Reticle shrunk slightly (R 225->210) and nudged down (CY 295->300) so
    the whitespace above the graphic grows from ~8 px to ~28 px; bottom
    margin stays ~22 px.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
    [Screen_MNVR.ino]
2026-07-12 InfoDisp: revert MNVR Brg/Elv font; reflow DOCK + TGT like MNVR
    MNVR: revert the Brg/Elv values to the panel's Black_36 with integer
    degrees (%+.0f) — "+180°" (96px) fits the ~99px half-cell, so no decimal.
    DOCK: apply the MNVR layout. Reticle centred/enlarged in the freed left
    region (CX 192->289, CY 251->300, R 170->210, rings/scale derived from R,
    dots 11/9/16 -> 14/12/20). Right panel to the ascent template (x=580,
    360 wide, labels Black_28 / values Black_36, buttons Black_28). Approach
    bar centred under the reticle (X derived from CX, W 346->450, H 22->26),
    label/value Black_24, positioned to clear the border. Ring/legend labels
    Black_16. Per-frame Serial debug gated behind debugMod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
    [Screen_DOCK.ino, Screen_MNVR.ino, Screen_TGT.ino]
2026-07-12 InfoDisp: TGT closure bar + fix value-ghost and ring-label bugs
    TGT: add a closure-velocity bar centred under the scope (mirrors DOCK's
    approach bar), filling the space the reticle no longer uses. Fill is
    |closure|/250 m/s; colour matches the V.Tgt row (green closing, yellow
    opening, red too-fast-at-short-range); signed value right-aligned in
    Black_24. Cache reset on screen entry.
    Fix value ghost (reported on DOCK T+Dock): printValue's textRight
    right-aligns the value unclamped, so a value wider than its cell (e.g. an
    hours-form time) spills left of the value region into the label gap; the
    shrink-clear only cleared from the region start, leaving the leading digit
    as a ghost. Extend the clea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
    [Screen_DOCK.ino, Screen_TGT.ino]
2026-07-12 InfoDisp OrbAdv: rename PRD/TA/MA labels
    - PRD -> Period, TA -> True Anom, MA -> Mean Anom.
    "True Anom:"/"Mean Anom:" (~207px at 36pt) are far wider than "TA:"/"MA:",
    so the right-column value column shifts right (x 628->690, W 310->248) to
    clear them; the wide time values (T+Pe/T+Ap) have short labels so they
    still fit. "Period:" fits the left column as-is.
    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
    [Screen_OrbAdv.ino]
2026-07-12 InfoDisp: clamp DOCK T+Dock at 59:59; revert printValue overflow tweak
    The hours-form time (241px) is wider than the T+Dock cell (215px), so it
    spills onto the "T+Dock:" label; the value's leading digit and the label
    colon land on the same pixels, so no clear can remove the ghost without
    nicking the colon. Fix it at the root by keeping the value in its cell:
    clamp T+Dock at 59 m: 59 s (time-to-dock in hours isn't actionable).
    Revert the earlier printValue left-extend clear — it only traded the
    ghost for the colon-cut. printValue again clears from regionX only (never
    into the caller's label); a comment now documents that callers must keep
    values within regionW.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
    [Screen_DOCK.ino]
2026-07-12 InfoDisp: add formatTimeCompact() and use it for all time readouts
    New formatTimeCompact() in KerbalDisplayCommon: identical to formatTime()
    below 1 hour (keeps seconds — the actionable range, so common readouts
    look unchanged), but at/above 1 hour it drops to a 2-unit form
    ("Hh MMm" / "Dd HHh", <=~175px) instead of the verbose "H h: MM m: SS s"
    (~241px) that overflows tight value cells.
    Applied to every time-value readout across the screens (MNVR T+Ign/
    T+Mnvr/Burn dur, DOCK T+Dock, TGT T+Int, ORB PRD/T+Pe/T+Ap, OrbAdv
    Period/T+Pe/T+Ap, LNCH ascent/circ, LNDG, SCFT). This fixes the hours-form
    overflow generally while preserving the real value (hours/days) instead
    of clamping it.
    DOCK T+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
    [Screen_DOCK.ino, Screen_LNCH_Ascent.ino, Screen_LNCH_Circ.ino, Screen_LNDG_Powered.ino, Screen_LNDG_Reentry.ino, Screen_MNVR.ino, Screen_ORB.ino, Screen_OrbAdv.ino]
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2026-07-12 InfoDisp ROVR: centre compass on title, equal columns, corner FWD/REV, bottom Tgt strip
    Address five layout issues from hardware review:
    1. Columns now start at the title-bar rule (y=62) and end at y=552 with
    visible bottom borders (previously y=63..600, clipping the last border).
    2. Compass recentred at CX=470 (CONTENT_W/2, the ROVER title centre) instead
    of 495; R trimmed 205->200 and CY->344 so the ring erase floor (y=551)
    clears the new bottom strip.
    3. Throttle bar replaced by two FWD/REV drive-state blocks in the top corners
    of the compass area, flanking the heading readout (green/yellow when engaged,
    muted off-black when neutral).
    4. Left and right columns both 190 px w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
    [Screen_ROVR.ino]
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2026-07-12 InfoDisp ROVR: lighten compass rose to raise turning framerate
    The rotating compass is redrawn in software on every heading change, and at
    ~25 ms/frame it was the dominant cost on ROVR (~18 fps while turning, atop the
    fixed 27.5 ms page copy). Two cuts:
    - Tick spacing 5deg -> 15deg: 72 ticks -> 24 (majors every 30deg, one minor at
    each 15deg midpoint). Cuts the per-frame tick redraw from 144 to 48 drawLines.
    - Drop the per-frame outer-ring re-stamp. Tick ends pulled 4 px inside the ring
    (R_TICK_OUTER 199 -> 196) so the tick-erase can no longer nibble it, making the
    full software drawCircle (~1100 px) each heading change unnecessary.
    Ring is still drawn once in chrome. No geometry cha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
    [Screen_ROVR.ino]
2026-07-12 InfoDisp ROVR: replace per-frame black-text erases with hardware fillRect
    The tick-count cut didn't move the framerate because the real per-frame cost is
    software text rasterization, not lines/circles. Every changed readout was erased
    by re-rendering the old string black-on-black (a full software glyph raster) before
    drawing the new one. While driving, the compass labels plus V.Srf/EC/Elev/Pitch/
    Roll/heading readouts all change continuously, so that was ~a dozen redundant text
    renders per frame.
    Replace all of those erases with a hardware fillRect over the exact same box:
    - Compass labels: inline fillRect over each glyph box (clear of ring/ticks/target).
    - Numeric readouts + heading box: n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
    [Screen_ROVR.ino]
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2026-07-12 InfoDisp ACFT: gate per-frame timing Serial prints behind debugMode
    The aircraft screen printed ~6-10 timing lines to Serial on every single frame
    (ball fill/horiz/ladder sub-timers plus a per-frame frame/attitude dump), all
    ungated. That floods the serial log and stalls the frame on the blocking UART
    writes. Gate them all behind the existing debugMode flag (default false), matching
    the MNVR/DOCK convention.
    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
    [Screen_ACFT.ino]
2026-07-12 InfoDisp ACFT: reflow EADI for 1024x600 with a larger attitude ball
    The aircraft screen was still laid out for the old 800x480 panel, occupying only
    the top-left ~720x480 of the content area. Reflow it to fill 1024x600 with a
    bigger ball (the requested priority):
    - Ball R 150 -> 200 (+33%), centred at CX=345/CY=300 so the bank ticks clear the
    title rule (top y=84) and the slip strip reaches the screen bottom. ACFT_SCALE,
    the pitch/heading tapes, VSI, slip ball, AoA arc and ADI markers all derive from
    CX/CY/R and rescale automatically (slip ball R 15 -> 24).
    - Data panel extended to the real content edge: PANEL_RIGHT 720 -> CONTENT_W-2
    (938), widening it from 281 to 364 px; its 8 row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
    [Screen_ACFT.ino]
2026-07-12 InfoDisp ACFT: panel abut + larger fonts/symbols, AoA label
    Follow-up refinements to the aircraft screen:
    1. Panel right edge PANEL_RIGHT 938 -> CONTENT_W (940) so horizontal dividers and
    the right-column buttons reach x=939, abutting the sidebar divider at 940.
    2. Data-panel fonts up a tier: values 24->28, labels/buttons 20->24 (rows are now
    67px tall so they fit comfortably).
    3. ADI ball markers (prograde/target/maneuver diamonds) doubled: MRK_HD 8 -> 16.
    4. Aircraft reference symbol (wings/dot/fin) +50%: DOT_R 7->11, WO 50->75, etc.
    5. Pitch/Roll/Heading/Slip label+value fonts enlarged (labels ->24, values ->28);
    Roll readout block and Pitch label box widened/heightened to fit th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
    [Screen_ACFT.ino]
2026-07-12 InfoDisp ACFT: roll readout/pointer/markers, slip ranges, button rows, ladder font
    Address hardware-review items on the aircraft screen:
    1. Roll pointer ghost trail: widen the erase triangle (width +5px each side — the
    lateral margin is what the rotated pointer needs) and redraw ALL bank ticks
    within 7deg of the old angle instead of just the first.
    2. Roll readout moved up/right: anchor to (CX+R-54, CY-R-34) so its right edge
    (571) tucks against the panel divider and its top (66) sits near the title rule.
    3/4. Fix the Gear/Airbrk (row 6) vs Brakes/SAS (row 7) button geometry: row 6 was
    using rowYFor() (which adds ROW_PAD) while row 7 used the raw grid, so the rows
    were 65px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
    [Screen_ACFT.ino]
2026-07-12 InfoDisp: fix SCFT row-7 underflow + DOCK bar font-measure; refresh stale comments
    Correctness fixes surfaced by a codebase audit:
    - Screen_SCFT.ino:1326 rh = 480 - ry underflowed (uint16) after the content height
    moved to 538 (ry=531 > 480), drawing the RCS/SAS button row to a garbage height.
    Use SCREEN_H - ry, and extend the panel dividers from the old 479 to SCREEN_H-1.
    (SCFT still needs a full horizontal reflow — deferred — but the vertical is no
    longer broken.)
    - Screen_DOCK.ino: approach-bar distance value is drawn in Roboto_Black_24 but its
    width was measured with RP_LBL (Black_28), mis-positioning the right-aligned text.
    Measure with the draw font.
    Stale comments ref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
    [AAA_Screens.ino, Screen_DOCK.ino, Screen_MNVR.ino, Screen_ROVR.ino, Screen_SCFT.ino, Screen_TGT.ino]
2026-07-12 InfoDisp: derive fixed layout constants from globals (no value change)
    Replace value-identical literals with their governing constant so a future
    re-layout touches one place:
    - ROVR: CX 470->CONTENT_W/2; three title-rule tops 62->TITLE_TOP; right-column
    Pitch/Roll Y now stack additively (ELEV_Y+ELEV_H, PITCH_Y+PITCH_H) like the
    left column instead of hard-coded 170/385.
    - ORB: ORB_TITLE_TOP/HDR_Y0 -> TITLE_TOP, ORB_SCREEN_H -> SCREEN_H.
    - OrbAdv: ADV_TITLE_TOP -> TITLE_TOP; panel divider 470/600 -> CONTENT_W/2 / SCREEN_H.
    - ACFT: HDG_BOX_H -> ACFT_HDG_TAPE_H + 8.
    All substitutions verified to yield identical pixel values.
    Claude-Se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
    [Screen_ACFT.ino, Screen_ORB.ino, Screen_OrbAdv.ino, Screen_ROVR.ino]
2026-07-12 KerbalDisplayCommon: add drawDiamondMarker(); use on MNVR/DOCK/TGT
    The solid horizontal-split diamond (two waist-sharing triangles) was copy-pasted
    six times across the three reticle screens — as both the legend swatch and the
    on-map marker. Add drawDiamondMarker(tft, cx, cy, half, color) and replace all six
    call sites (MNVR maneuver=blue, DOCK port + TGT target=violet). Pixel-identical:
    the legend swatches map to (LEG_X+6, midY, half=6), the map markers to the dot
    centre + DS/ds half-size.
    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
    [Screen_DOCK.ino, Screen_MNVR.ino, Screen_TGT.ino]
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2026-07-12 InfoDisp: parametrize ORB divider, LNDG divider x, and DEG_TO_RAD literals
    - ORB panel divider 470 -> CONTENT_W/2.
    - LNDG_Powered: the graphical/text divider x was the literal 360 (=text section
    RX 364 - 4) in 10 places; add file-scope LNDG_TEXT_X/LNDG_DIV_X and reference
    them (the local RX now aliases LNDG_TEXT_X too).
    - LNDG_Powered: replace four inline 0.017453f with the DEG_TO_RAD constant used
    everywhere else (sub-pixel difference, matches the rest of the codebase).
    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
    [Screen_LNDG_Powered.ino, Screen_ORB.ino]
2026-07-12 InfoDisp: refresh stale LNCH_Circ / LNDG_Powered header comments
    LNCH_Circ's orbit-diagram geometry is already centralized in named LNCH_OR_*
    constants; only the header prose was stale (R=186 / MAX_R=140 / y=63..479 -> the
    actual MAX_R=175, CY=272, full 1024x600 panel). Fix those and the LNDG_Powered
    right-panel x range comment.
    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
    [Screen_LNCH_Circ.ino, Screen_LNDG_Powered.ino]
2026-07-12 InfoDisp: reticle inner-ring label + ACFT roll/brake HW fixes
    Reticle (MNVR/DOCK/TGT):
    - reticleRepair() now returns the erase box's distance to centre so callers
    can detect a good-zone hit. When a marker enters the inner circle the
    good-zone refill repaints over the innermost ring label; each screen now
    redraws that label whenever the marker is inside the good zone (goodZoneHit),
    not only when the erase box overlaps its bbox.
    - MNVR gains ring-label repair (previously had none).
    - TGT reticle ticks lengthened 10 -> 14 to match MNVR/DOCK for a consistent
    reticle family.
    ACFT:
    - Roll pointer erase widened (+9px lateral, base +3) to kill the residual
    orange ghost trail as the poin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
    [Screen_ACFT.ino, Screen_DOCK.ino, Screen_MNVR.ino, Screen_TGT.ino]
2026-07-12 InfoDisp: reticle crosshair repair + ACFT panel/PADI/slip + ROVR target
    Reticle (MNVR/DOCK/TGT): reticleRepair() painted the inner good-zone
    OFF_BLACK *after* restoring the cardinal lines and centre crosshair, so
    those target lines vanished whenever a marker crossed the inner circle.
    Reordered so the good-zone refill happens first and the crosshair is drawn
    back on top.
    ROVR: pulled the violet target-bearing triangle inward (tip R135->128,
    base R117->110) so it clears the compass number label boxes (inner reach
    R~136) — the "15" label was clipping the triangle when the bearing lined up
    with it.
    - Right-panel readouts enlarged to match the reticle/launch panels: labels
    Roboto_Blac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
    [Screen_ACFT.ino, Screen_ROVR.ino]
2026-07-12 ACFT: fix -Wnarrowing on slip marker offset array
    The slip reference-tick offsets used unary minus on int16_t values inside a
    braced initializer; -m15 / -m5 promote to int, narrowing to int16_t. Make the
    array `int` — the values are only ever added to ACFT_CX (int) anyway.
    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
    [Screen_ACFT.ino]
2026-07-12 InfoDisp: reticle crosshair + nose size; ACFT slip/brake bottom + slip ticks
    Reticle:
    - reticleRepair() now restores the inner cross UNCONDITIONALLY whenever the
    good-zone refill fires. The earlier reorder only helped when the erase box
    straddled an axis; a marker sitting near centre in a diagonal quadrant
    refilled the good zone but skipped both conditional cardinal redraws, so the
    vertical/horizontal target lines still vanished. Now the inner cardinal
    stubs, crosshair, and centre dot are redrawn with the refill.
    - TGT reticle gap 16 -> 18 (reticleDrawBase, reticleRepair, and the VEL-clip
    crosshair redraw) so the centre nose crosshair matches MNVR/DOCK exactly.
    - Slip stri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
    [Screen_ACFT.ino, Screen_TGT.ino]
2026-07-12 ACFT: pull slip strip and BRAKES/SAS bottom border to row 598
    Row 599 is lost to panel overscan, so a border drawn there is invisible. Move
    the slip strip up 1px (bottom border now on row 598, height still matches the
    HDG tape) and shorten the row-7 buttons by 1px (bottom border on row 598).
    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
    [Screen_ACFT.ino]
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2026-07-12 SCFT: reflow to mirror the ACFT screen (no VSI/slip/AoA)
    The spacecraft EADI was still on the old small 800x480-era layout. Reflow it to
    match the aircraft screen exactly so the two attitude screens are visually
    identical, keeping the spacecraft-specific readouts and orbital-mode logic and
    omitting the VSI, slip, and AoA indicators (which SCFT never had).
    Synced to ACFT:
    - Ball centre/radius CX/CY/R = 345/300/206; readout panel 580..940 (360px, 8 rows).
    - Panel fonts 20/24 -> 28/36; tape value boxes and Pitch:/Hdg: labels enlarged
    to 28/24; buttons 20 -> 24.
    - Aircraft symbol, pitch-ladder rungs (+font _16), ADI markers, roll pointer,
    bank scale, and tape markers resized to the ACFT val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
    [Screen_SCFT.ino]
2026-07-12 SCFT: add throttle bar (left) and vitals strip (bottom)
    Fill the two areas the aircraft screen uses for the VSI and slip indicators,
    which the spacecraft screen left empty.
    - Throttle bar: vertical 0-100% gauge in the far-left strip (the ACFT VSI slot),
    filled bottom-up in amber, with 25% ticks, 0/50/100 labels, and a rotated
    "THR" label — mirrors the VSI structure. Driven by state.throttle.
    - Vitals strip: three horizontal bars below the heading tape (the ACFT slip
    slot) — Electric Charge %, hottest core temp %, hottest skin temp %. EC is
    green when high (low = alarm); temps are green when low (high = alarm). Driven
    by state.electricChargePercent / coreTempPct / skinTempPct.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
    [Screen_SCFT.ino]
2026-07-12 SCFT: align vitals thresholds to annunciator; fix throttle/vitals layout
    Threshold alignment (item 1):
    - Added temperature and electric-charge alarm thresholds to the shared
    cross-panel config (KCMk1_SystemConfig.h): KCM_TEMP_ALARM_PCT=90 (=
    Annunciator CW_HIGH_TEMP), KCM_EC_LOW_ALARM_FRAC=0.05 (= CW_BUS_VOLTAGE),
    KCM_RES_LOW_WARN_FRAC=0.20 (= CW_PROP_LOW/CW_RCS_LOW yellow tier).
    - InfoDisp AAA_Config now defines annunciator-aligned TEMP_WARN/ALARM_PCT and
    EC_LOW_WARN/ALARM_FRAC that alias the shared values; VEH_TEMP_* repointed to
    them (alarm 85->90, warn 70->75). SCFT vitals use these instead of the
    hardcoded 20/50 and 75/90 it shipped with, so EC now reads red only below the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
    [AAA_Config.ino, Screen_SCFT.ino]
2026-07-12 SCFT: add 5% minor ticks to the throttle bar
    Minor ticks every 5% (short, dark grey, unlabelled) between the 20% major ticks
    (long, light grey, labelled) — matches the VSI/pitch-tape tick style.
    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
    [Screen_SCFT.ino]
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2026-07-12 LNDG powered descent: spatial rebalance for 1024x600
    Reflowed the powered-descent screen from its mechanically-ported (left-cramped)
    state to fill the display, with the X-Pointer surface-drift indicator as the
    featured centrepiece.
    - Text panel standardized to the 360px right-panel used by every other screen
    (x=580..940); the graphics zone now spans the full left x=0..578.
    - X-Pointer enlarged 230->360px and centred (x=128..488), scale 12 px/(m/s)
    so +/-15 reaches the field edge. Its perimeter ticks/labels derive from the
    anchor constants and reposition automatically.
    - V.Vrt descent-rate bar made full-height on the far right (x=544..574),
    mirroring the altitude tape and flanking th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
    [Screen_LNDG_Powered.ino]
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2026-07-13 LNDG: fix X-Pointer needle rendering + shrink field; VERT VELOCITY label
    - Label renamed VERTICAL VELOCITY -> VERT VELOCITY.
    - Needle intersection now clamped >=8px inside the field. At max drift the
    intersection previously reached the field edge, so the connecting bars (drawn
    only within nx1..nx2) vanished and the arrowhead/erase boxes spilled grey
    background past the field border. Clamping keeps the bars drawn and the
    erase/arrowhead boxes (±7px) inside the edge.
    - Border drawRect moved BEFORE the arrowheads so the end triangles always
    render on top of it (was drawn after, clipping them).
    - X-Pointer field shrunk 350 -> 342px for more whitespace (18px gap to the
    V.Vrt bar).
    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
    [Screen_LNDG_Powered.ino]
2026-07-13 LNDG: move ATT bullseye 15deg label outboard of the ring border
    It was sitting on the outer ring edge (dist == R); pushed to R+6 outboard so it
    no longer overlaps the border.
    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
    [Screen_LNDG_Powered.ino]
2026-07-13 LNDG: add ground-track compass below the X-Pointer
    Fills the empty space flanking the ATT bullseye. Shifted the ATT left of the
    X-Pointer centre (CX 307->216) and added a heading-up ground-track compass to
    its right (CX 398), the pair balanced about the X-Pointer centre.
    The compass shows a rotating N/E/S/W rose (nose-up), a fixed white lubber line
    at the top (vessel heading), and a green track marker pointing in the surface-
    velocity direction relative to the nose (suppressed when nearly stationary).
    Driven by state.heading / srfVelHeading / surfaceVel; repaints only when the
    heading or track moves. Gaps to the ATT assembly (52px) and V.Vrt bar (48px)
    verified.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
    [Screen_LNDG_Powered.ino]
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2026-07-13 LNDG: regime-aware T+Grnd (Keplerian + kinematic), shared helper
    Replaced the naive radarAlt/|verticalVel| time-to-ground (duplicated in the
    powered-descent and re-entry screens) with a single shared estimateTimeToGround()
    in AAA_Globals that picks a method by flight regime:
    - Coasting in vacuum / thin atmosphere -> Keplerian: computes the ground radius
    and, from the received orbit elements (e, a, period, timeToPe), the time to the
    descending crossing of that radius. Exact for ballistic arcs; returns "---"
    when periapsis is above the ground (no impact).
    - Under thrust or in dense atmosphere -> kinematic: solves the constant-
    acceleration quadratic using a low-pass-filtered measured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
    [AAA_Globals.ino, Screen_LNDG_Powered.ino, Screen_LNDG_Reentry.ino]
2026-07-13 InfoDisp: add estimateTimeToAtmosphere + refine LNDG ground-track compass
    - AAA_Globals: add regime-aware estimateTimeToAtmosphere() (Keplerian time to
    atmosphere top when coasting, kinematic projection when under thrust, naive
    fallback) mirroring estimateTimeToGround(); reuses _ttgKeplerianToRadius().
    - Screen_LNDG_Reentry: replace the inline naive T+Atm estimate with
    estimateTimeToAtmosphere().
    - Screen_LNDG_Powered: ground-track compass ticks now every 15° (bright cardinals,
    medium 30° marks, short dim 15° marks); replace the thin nose lubber line with a
    filled white triangle for a far more obvious nose marker.
    Claude-S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
    [AAA_Globals.ino, Screen_LNDG_Powered.ino, Screen_LNDG_Reentry.ino]
2026-07-13 InfoDisp: fix mixed altitude-tape colour scheme on LNDG powered descent
    The altitude tape chrome was painted using _lndgLowAltMode, but that flag was
    not updated from the current radarAlt until the END of _lndgChromePowered —
    after the tape background had already been drawn. On screen entry the tape was
    therefore painted with the regime left over from the previous visit (e.g. the
    normal red/yellow/red three-zone scheme), while the per-frame strip update used
    the freshly-set correct regime (the <50 m white/grey scheme), leaving the two
    schemes mixed on the same tape.
    Set _lndgLowAltMode from state.radarAlt at the top of _lndgChromePowered, before
    _lndgDrawTapeChrome, so the initial backgro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
    [Screen_LNDG_Powered.ino]
2026-07-13 InfoDisp: fix T+Grnd green/yellow flicker from double-advanced accel filter
    estimateTimeToGround() advanced the shared low-pass vertical-acceleration filter
    as a side effect, and it must run only once per frame. On the powered-descent
    screen it was called twice per frame (X-Pointer needle colour + panel text); on
    the re-entry screen both estimateTimeToGround() and estimateTimeToAtmosphere()
    advanced it when T+Atm was shown. The extra advance each frame saw an unchanged
    verticalVel over a real dt, computed dv/dt = 0, and decayed the filter ~30%
    toward zero; the next frame's first call pushed it back up, so the acceleration
    estimate oscillated, the kinematic tGround swung across the WARN thres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
    [AAA_Globals.ino, Screen_LNDG_Powered.ino, Screen_LNDG_Reentry.ino]
2026-07-13 InfoDisp: stop T+Grnd green/yellow flicker with smoothing + colour hysteresis
    Removing the double-advanced accel filter reduced but did not eliminate the
    flicker: the kinematic time-to-ground is still sensitive to the (noisy) vertical
    acceleration and jumps ~2x when the descent-arrest boundary flips it to the naive
    fallback, so a value hovering near the 30 s WARN threshold still dithered the
    colour green<->yellow every frame.
    Two-part fix:
    - AAA_Globals: low-pass the final estimate inside estimateTimeToGround() and
    estimateTimeToAtmosphere() (EMA, reset when not applicable) so the value and
    its colour band don't jitter frame-to-frame.
    - Add shared lndgTGroundColors() with band hysteresi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
    [AAA_Config.ino, AAA_Globals.ino, Screen_LNDG_Powered.ino, Screen_LNDG_Reentry.ino]
2026-07-13 InfoDisp: stabilize T+Grnd value (accel ring + sub-second display dither)
    Colour is now steady but the number still jumped between adjacent seconds. Two
    sources, both fixed at the estimate:
    - ttgAdvanceAccel sampled dv/dt every frame, but KSP updates verticalVel slower
    than the frame rate. On the stale frames it fed dv/dt = 0, so the acceleration
    filter rang (decay then spike) and the kinematic time-to-ground jittered. Now
    it samples only when verticalVel actually changes, over the real inter-sample
    interval, with heavier smoothing (0.30 -> 0.15).
    - Added _ttgSticky(): a ~1 s display deadband that holds the shown value until the
    smoothed estimate has moved by at least a second, s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
    [AAA_Globals.ino]
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2026-07-13 InfoDisp: reorganize sidebar to 10 buttons with grouped PFD
    Decouple the sidebar from the 12-entry ScreenType enum via a button->screen map so
    the three PFD screens share one button and the layout can be reordered:
    LNCH PFD ORB ORB+ VEH MNVR TGT DOCK LNDG REEN
    - AAA_Screens: SB_BTN_COUNT = 10; SB_BTN_SCREEN / SB_BTN_IDS tables; screenToButton()
    reverse map (SCFT/ACFT/ROVR -> PFD button). drawSidebar highlights the active
    screen's button. PFD screens get the title-toggle indicator.
    - AAA_Globals: PFD button helpers — pfdContextScreen() (rover -> ROVR, plane in
    atmosphere -> ACFT, else SCFT default), pfdScreenForSel(), pfdSelectedScreen()
    (manual override or context). co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
    [AAA_Globals.ino, AAA_Screens.ino, KCMk1_InfoDisp.h, SimpitHandler.ino, TouchEvents.ino]
2026-07-13 InfoDisp: rework context auto-routing (SCFT default, no landing/orbit auto)
    contextScreen() changes per request:
    - Default fall-through now returns SPACECRAFT (screen_SCFT) instead of ORBIT, so any
    state not matched by rules 1-5 shows the spacecraft PFD.
    - Condition 3 is PRE-LAUNCH only (was pre-launch OR landed) and still routes to the
    LAUNCH screen's pre-launch board; landed vessels now fall through to the default.
    - Removed the lander-in-flight → POWERED DESCENT auto-switch entirely; LANDING and
    ORBIT are now sidebar-select only.
    Also: ADVANCED ORBIT is no longer a manual-lock screen — isManualLockScreen() now
    protects only RE-ENTRY, so a context event may switch away from ORB+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
    [AAA_Globals.ino, KCMk1_InfoDisp.h]
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2026-07-31 Add ascent autopilot to master controller
    Implements a self-contained launch-to-orbit guidance module that runs on
    the master Teensy 4.1 over the existing KerbalSimpit link:
    vertical climb -> gravity turn (targeting a commanded inclination)
    -> coast to apoapsis -> circularization burn
    Features:
    - Configurable target apoapsis, inclination, and a "loft" exponent that
    shapes gravity-turn aggressiveness for the craft's performance.
    - Angle-of-attack limiter (clamps commanded pitch to surface prograde).
    - Managed throttle: max-Q limiting, skin-temperature back-off, and an
    apoapsis-approach taper to avoid overshoot.
    - Roll control with body-frame steering mix (correct regardless of roll)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
    [Controller_Main.ino, ascent_autopilot.h, ascent_autopilot.ino, simpit_message_handler.ino]
2026-07-31 Ascent autopilot: end handoff in SAS stability-hold
    At mission completion (after the circularization burn) hand the vessel
    back to the pilot with stock SAS enabled in Stability Assist / attitude
    hold, instead of prograde hold.
    Claude-Session: https://claude.ai/code/session_01G6QQMNQ2jGxjWPu9GGXCTJ
    [ascent_autopilot.ino]
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2026-07-31 Deduplicate body table: single shared source in Software/Common
    The ascent autopilot's AP_BODIES table duplicated the pre-existing
    celestial-body table in the KerbalDisplayCommon library. Consolidate to
    one canonical source.
    - Relocate the BodyParams struct + _bodyTable[] + getBodyParams() into a
    new header-only Software/Common/body_params.h (header-only so it is
    shareable across the two independent Arduino sketch trees without a
    separate compilation unit). Two Kerbol/Duna values that exceeded float's
    exact-integer range are now explicit float literals (value-identical).
    - KerbalDisplayCommon.h now includes the shared header; its .cpp no longer
    defines the table/lookups. The displ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
    [Controller_Main.ino, ascent_autopilot.ino]
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2026-08-01 InfoDisp: graphical re-entry screen redesign
    Replace the text-only re-entry board with a graphical instrument layout, a sibling
    of POWERED DESCENT. Left/centre graphics zone + condensed 360px text panel.
    Widgets:
    - Corridor tape (altitude ladder + periapsis regime): full-height altitude tape whose
    coloured zones are the re-entry corridor — NO RE-ENTRY / AEROBRAKE / SAFE / DANGER —
    anchored on the body table (flyHigh / reentryAlt / lowSpace) and shifted upward with
    entry velocity (vFac = clamp(surfaceVel / (escapeVel/√2), 1..1.7)). Current-altitude
    (white) and periapsis (magenta) markers ride the tape.
    - Heat-shield / retrograde alignment ball: plots the surface-retrograde vect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
    [Screen_LNDG.ino, Screen_LNDG_Reentry.ino]
2026-08-01 InfoDisp: fix re-entry build — move ReCorridor struct to header
    Arduino auto-generates a prototype for _reCorridor() (which returns ReCorridor) and
    inserts it above the in-.ino struct definition, so the type was unknown at the
    prototype ("'ReCorridor' does not name a type"). Declare struct ReCorridor in
    KCMk1_InfoDisp.h so it precedes all auto-prototypes.
    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
    [KCMk1_InfoDisp.h, Screen_LNDG_Reentry.ino]
2026-08-01 InfoDisp: rework re-entry corridor tape (labels, ticks, markers, streak fix)
    - Scale top now 1.5x atmosphere top (was 1.15x).
    - Powered-descent tape style: km scale labels + major/minor ticks on both bar edges.
    - Both markers moved to the right of the bar and enlarged: current altitude (white,
    inboard triangle, tip at the bar) and periapsis (magenta, longer outboard triangle);
    periapsis across-bar line thickened to 5px.
    - Fix marker streaking: the triangles sit in the gutter outside the bar interior, which
    the per-frame zone fill never cleared. The whole tape footprint (label gutter + bar +
    marker gutter) is now erased each frame before redraw.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
    [Screen_LNDG_Reentry.ino]
2026-08-01 InfoDisp: re-entry tape — 3 minor ticks per major division
    Replace the single half-step minor tick with quarter-step minor ticks (3 between
    each major), skipping positions that coincide with a major tick.
    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
    [Screen_LNDG_Reentry.ino]
2026-08-01 InfoDisp: re-entry tape markers — flush Pe, larger label, edge alignment fix
    - Move the periapsis triangle flush against the bar like the altitude marker.
    - Enlarge the "Pe" label (Roboto_Black_12 -> _20); it travels with the marker.
    - Fix top/bottom misalignment: the across-bar line and the triangle now share one
    clamped y (margin = triangle half-height), so they stay aligned at the scale ends
    instead of the line reaching the edge while the triangle stopped short.
    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
    [Screen_LNDG_Reentry.ino]
2026-08-01 InfoDisp: re-entry tape — inset mapping for true-value markers, alt on top
    - Alt marker now drawn after (on top of) the Pe marker.
    - Replace marker position clamping (which misreported the value at the ends) with an
    inset altitude->y mapping: the bar and its scale are shrunk by the marker
    half-height so alt/Pe reach the true 0 and scaleTop without their triangles
    overhanging. Zone fills, border, ticks and markers all use the inset range.
    - Extend the tape erase by 2 rows so the enlarged "Pe" label can't streak at the
    bottom of the scale.
    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
    [Screen_LNDG_Reentry.ino]
2026-08-01 InfoDisp: re-entry ball -> reticle-style RETRO ALIGNMENT dial
    - Use the shared reticleDrawBase() (as MNVR/TGT/DOCK) for the dial: good-zone ring,
    concentric rings, cardinal lines, nose crosshair, 30° ticks, bezel. Scale is now
    10/20/30/40° with ring labels.
    - Draw a navball-style retrograde symbol (ringed circle + internal X + three spokes)
    instead of the plain dot, coloured green/yellow/red by alignment error; clamped to
    keep the whole symbol inside the disc.
    - Retitle "SHIELD / RETRO (AoA)" -> "RETRO ALIGNMENT".
    - Drop the roll pointer/ticks to match the reticle format (roll still rotates the
    marker into the cockpit frame). AoA angle readout kept below the dial.
    Co-Authored-By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
    [Screen_LNDG_Reentry.ino]
2026-08-01 InfoDisp: re-entry RETRO ALIGNMENT — add bank indicator + degree on AoA
    - Add a bank/roll indicator: fixed 0/±30/±60 scale + a moving yellow sky-pointer,
    drawn inside the top of the reticle so the disc fill erases it each frame (no extra
    space needed, so the chute envelope stays full-size).
    - Append the degree glyph (\xB0) to the AoA readout below the dial.
    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
    [Screen_LNDG_Reentry.ino]
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2026-08-02 InfoDisp: re-entry chute bar — auto-range axis, edge-centred labels, title, in-bar ticks
    - Fix red-marker-in-green-zone: the safe-deploy speeds exceed a fixed 1000 m/s axis at
    altitude, so boundaries pegged off-scale and the bar read all-green while the q-based
    marker was red. Auto-range the airspeed axis (1000..3000 m/s, 500 steps) to always
    contain the current speed and the drogue boundary, so position and colour agree.
    - Centre the axis labels on their ticks, including 0 (left edge) and full-scale (right
    edge) — no longer shoved inward.
    - Move the "CHUTE DEPLOY" title down next to the bar so it reads as the instrument label.
    - Add tick marks inside the bar on both edges (major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
    [Screen_LNDG_Reentry.ino]
2026-08-02 InfoDisp: re-entry chute bar — ticks inside border, centred title + axis label
    - Map the airspeed axis to the bar interior so the full-scale tick no longer prints
    outside the border rectangle.
    - Remove "(airspeed m/s)" from the title; add a dedicated "AIRSPEED (m/s)" axis label
    below the numeric ticks.
    - Centre both "CHUTE DEPLOY" and the axis label on the bar.
    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
    [Screen_LNDG_Reentry.ino]
2026-08-02 InfoDisp: re-entry chute bar — center title/axis label via textCenter
    Replace the manual getFontStringWidth centering (which rendered CHUTE DEPLOY
    off-centre) with the proven textCenter helper, centring both the title and the
    AIRSPEED (m/s) axis label within the bar's box.
    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
    [Screen_LNDG_Reentry.ino]
2026-08-02 InfoDisp: re-entry — match ATMO bar to altitude tape (size + label format)
    Make the ATMO gauge identical in footprint to the altitude/corridor tape and give
    them a common label style:
    - ATMO bar now 44 px wide and full height (70..597), same as the tape.
    - Both bars use the same vertical text label format ("ALTITUDE" / "ATMO"), drawn as
    chrome to the left of each bar (replaces ATMO's former horizontal top label).
    - Shift the RETRO ALIGNMENT reticle and the chute bar ~30 px right to open room for
    the wider ATMO column; the chute is redrawn before ATMO so its overlapping footprint
    can't clip the ATMO bar.
    Claude-Session: https://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
    [Screen_LNDG_Reentry.ino]
2026-08-02 Re-entry: shrink Pe label, thin tapes to 80%, zone-background G meter
    - Pe marker label reduced to Roboto_Black_12 and ATMOSPHERE bar shifted
    left equivalently (RE_ATMO_LBL_X=114, RE_ATMO_X=130).
    - Altitude and ATMOSPHERE tapes thinned to 80% width (RE_TAPE_W 44->35,
    gutter 42->34) for more breathing room.
    - Reworked the G meter into a zone-background gauge (matching the tape
    style): green/yellow/red bands keyed to the G warn/alarm thresholds,
    0-g reference line, integer ticks, and a tier-colored marker triangle.
    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
    [Screen_LNDG_Reentry.ino]
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2026-08-02 Re-entry: fit the Drogue/Main status cells at the value font
    The split half-cells overflowed because printValue reserved the label slot
    in the value font, leaving no room for the status word. Fix it:
    - Shorten the status words: STOWED->STOW, ARMED->ARM (OPEN/CUT unchanged).
    - Trim the wider "Drogue:" label to "Drog:" so its value sub-cell is wide
    enough ("Main:" already fits).
    - Drop printValue's redundant label reservation (empty param) and right-
    align the status in a sub-cell positioned past the chrome label, so the
    values stay at the full 28pt panel value font and no longer spill into
    the adjacent cell.
    Claude-Session: htt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
    [Screen_LNDG_Reentry.ino]
2026-08-02 Re-entry: replace the text-panel G row with vertical descent rate
    The G load is now the graphical G meter, so the "G:" text row was
    redundant. Replace it with "V.Vrt:" (state.verticalVel via fmtMs).
    Coloured with the powered-descent landing thresholds (WARN -5, ALARM -8
    m/s) but only within the final 500 m (in-atmo, radarAlt < ALT_RDR_WARN_M);
    at altitude a high descent rate is normal, so it reads neutral there.
    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
    [Screen_LNDG_Reentry.ino]
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2026-08-02 Unify LNDG panel fonts and standardize Pe/Ap/Alt labels
    1. Powered descent value font 28->32 so both LNDG modes (powered descent
    and re-entry) read at the same 20/32. Thrtl stays at 28 — it shares a
    half-cell with the RCS button and is too tight for 32.
    2. Standardize orbital-parameter label wording to the majority long forms:
    - ORB: Pe:->PeA:, Ap:->ApA: (Alt.SL: already correct)
    - OrbAdv: Pe:->PeA:, Ap:->ApA:, Alt:->Alt.SL:
    Alt.SL: is 1px narrower than OrbAdv's existing Period: label, so it fits
    the same column with no geometry change.
    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
    [Screen_LNDG_Powered.ino, Screen_ORB.ino, Screen_OrbAdv.ino]
2026-08-02 Consistency batch 1-2: de-magic thresholds, unify VEH labels
    Batch 1 (threshold magic numbers -> named constants):
    - SCFT T+Ign warn: literal 60 -> MNVR_TIGN_WARN_S (same value, no behavior change)
    - PreLaunch CommNet: literal 50 -> VEH_SIGNAL_WARN_PCT (same value, no behavior change)
    - Powered Alt.Rdr warn: literal 200 -> new LNDG_ALT_RDR_WARN_M (keeps the intentionally
    tighter 200 m powered-descent warning, now named rather than hardcoded)
    Batch 2 (label unification, approved forms):
    - VEH vessel name: Name: -> Vessel:
    - VEH CommNet: Signal: -> Comm:
    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
    [AAA_Config.ino, Screen_LNCH_PreLaunch.ino, Screen_LNDG_Powered.ino, Screen_SCFT.ino, Screen_VEH.ino]
2026-08-02 Consistency batch 2: unify remaining shared-field labels
    Canonical labels applied across screens (all fit-verified):
    - Orbital velocity: OrbAdv Vel: -> V.Orb:
    - Orbital period: ORB PRD: -> Period:
    - Arg. of periapsis: OrbAdv ArgPe: -> Arg.Pe: (+ layout comment)
    - Throttle: PreLaunch Throttle: -> Thrtl:
    - Burn duration: MNVR Burn dur: -> Burn Dur:
    - Distance to tgt: ROVR Tgt: -> Dist:
    - Closure velocity: TGT V.Tgt: -> V.Close:
    Mach stays split by deliberate exception: Mach: cannot fit ACFT's
    180px half-width Mach/G cell at 36pt, so ACFT keeps Ma: and Reentry
    keeps Mach:.
    Claude-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
    [Screen_LNCH_PreLaunch.ino, Screen_MNVR.ino, Screen_ORB.ino, Screen_OrbAdv.ino, Screen_ROVR.ino, Screen_TGT.ino]
2026-08-02 Consistency batch 3: route all velocity readouts through fmtMs
    Unifies the divergent velocity formatters onto the shared fmtMs() so
    values >=1000 m/s show thousands separators consistently across screens:
    - LNCH Ascent/Circ: remove _lnchAsFmtMs1 (1-decimal, no separator);
    V.Srf/V.Orb/V.Vrt/ΔV.Stg now use fmtMs. fmtMs is never wider than the
    old form here (drops the decimal, adds a comma at >=1000), so it stays
    within the tight ~140 px value region.
    - OrbAdv V.Orb: was snprintf "%d m/s" (no separator) -> fmtMs.
    - Powered ΔV.Stg: was snprintf "%.0f m/s" (no separator) -> fmtMs.
    Worst case ~341 px fits the 360 px full-width row at 32 pt.
    Left intentionally distinct (deliberate preci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
    [Screen_LNCH_Ascent.ino, Screen_LNCH_Circ.ino, Screen_LNDG_Powered.ino, Screen_OrbAdv.ino]
2026-08-02 Consistency batch 4: dV semantics, stage-dV warnings, escape apoapsis
    1. MNVR ΔV.Plan data fix: it was reading state.totalDeltaV (vessel total,
    owned by DELTAV_MESSAGE) while labeled as the maneuver-plan total. Add
    state.mnvrTotalDeltaV, populate it from the Simpit maneuver message's
    deltaVTotal (dV remaining across all planned nodes), and point ΔV.Plan
    at it. VEH/PreLaunch ΔV.Tot (vessel total) unchanged. Demo updated.
    2. Stage-ΔV low-fuel warning: Powered and SCFT showed ΔV.Stg flat green;
    they now use the same DV_STG_ALARM/WARN thresholdColor as VEH/LNCH, so
    low stage fuel warns consistently. MNVR keeps its burn-relative colour.
    3. Escape apoapsis standardized to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
    [Demo.ino, KCMk1_InfoDisp.h, Screen_LNCH_Ascent.ino, Screen_LNCH_Circ.ino, Screen_LNDG_Powered.ino, Screen_MNVR.ino, Screen_SCFT.ino, SimpitHandler.ino]
2026-08-02 Reticle screens: replace diamond markers with KSP navball symbols
    Add drawProgradeMarker() to the shared library — a 2px ring + centre dot +
    three spokes at 12/4/8 o'clock, the shape KSP uses for the velocity/target/
    maneuver markers. Colour selects meaning.
    Replace the diamond/hollow-circle markers on the reticle screens with it:
    - DOCK: PORT (target) diamond -> magenta target marker; VEL circle ->
    green prograde marker (legend + live markers).
    - TGT: target diamond -> magenta target marker; VEL circle -> green
    prograde marker (legend + live markers).
    - MNVR: maneuver-node diamond -> blue maneuver marker (legend + live marker).
    Marker footprints stay within the existing erase boxes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
    [Screen_DOCK.ino, Screen_MNVR.ino, Screen_TGT.ino]
2026-08-02 Correct reticle markers to match KSP navball symbols
    Verified the shapes against the KSP navball (per the KSP wiki / community
    descriptions) — the previous versions were wrong:
    - Prograde/velocity marker: spokes now point up + left + right (the KSP
    "vertical top + two horizontal sides" shape), not up + two diagonals.
    Fixes velocity (green) and maneuver (blue), which share this shape.
    - Target marker: was drawn prograde-style (ring + dot + spokes), which is
    wrong. KSP's target marker is a ring split into four arc segments with
    gaps forming a "+" (no centre dot, no spokes). Added drawTargetMarker()
    and pointed the DOCK port / TGT target markers + legends at it.
    Target marker has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
    [Screen_DOCK.ino, Screen_TGT.ino]
2026-08-02 Correct maneuver + retrograde markers; apply KSP symbols to ACFT/SCFT ADI
    Per the reference image:
    - Maneuver marker: was prograde-style; it's actually a centre dot with three
    prongs (up, lower-left, lower-right) each ending in a perpendicular crossbar,
    no ring. Added drawManeuverMarker() and used it on MNVR + ACFT/SCFT balls.
    - Retrograde (re-entry): spokes corrected to up/left/right (ring + X + spokes),
    matching prograde-with-X. Colour stays the alignment-based mc (green aligned).
    - Target marker: centre dot added (matches the other markers).
    ACFT and SCFT ADI-ball markers (velocity/target/maneuver) were filled diamonds;
    they now draw the proper KSP symbols via a marker-kind param (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
    [Screen_ACFT.ino, Screen_LNDG_Reentry.ino, Screen_MNVR.ino, Screen_SCFT.ino]
2026-08-02 Unify SAS-mode buttons: abbreviated labels + 28pt everywhere
    Labels (a): Re-entry used full words (STABILITY/RETROGRADE/.../SAS OFF)
    while every other screen used the abbreviated set. Re-entry now matches:
    STAB/PRO/RETR/NRM/ANRM/RAD+/RAD-/TGT/ATGT/MNVR, off = SAS.
    Font (b): SAS buttons ranged 20/24/28pt even though all buttons are the
    same ~180x65px size (the spread was per-screen choice, not a fit limit).
    Unified to 28pt (the DOCK/MNVR/ROVR majority). Because each SAS button
    shares its bottom row with a sibling (RCS/Gear/Brakes), the whole bottom
    button block was bumped to keep rows uniform:
    - ACFT, SCFT: 24 -> 28
    - LNDG Powered, LNDG Re-entry: 20 -> 28 (Re-entry gets a dedicated
    R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
    [Screen_ACFT.ino, Screen_LNDG_Powered.ino, Screen_LNDG_Reentry.ino, Screen_SCFT.ino]
2026-08-02 Boot screen: span the full 1024px width
    The boot sequences were written for an ~800px layout and never updated for
    the 7" 1024x600 panel:
    - Header separator rules were hardcoded at 800px wide -> now SCREEN_W, so
    they span the full panel instead of stopping ~220px short.
    - Text wrap width was hardcoded at 792 -> now SCREEN_W - 8, so the log text
    uses the full width.
    Text flows from y=0 (terminal style) so nothing was clipped vertically;
    this is purely the horizontal size fix. Body/title fonts unchanged
    (TerminalFont_16 / _32 are the only terminal sizes available).
    Claude-Session: https://claude.ai/code/session_01MfMjxhbhDzv5hr8pUwD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
    [BootScreen.ino]
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2026-08-02 InfoDisp AscentAP: rename KEY_W/KEY_H to avoid Teensy core macro clash
    The Teensy 4 core's keylayouts.h defines KEY_W and KEY_H as keyboard
    scancode macros, which collide with the keypad cell-size constants and
    break compilation. Rename them to AP_KEY_W / AP_KEY_H.
    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
    [Screen_LNCH_AscentAP.ino]
2026-08-02 Markers: double size and thicken prograde/retrograde/target/maneuver
    Make the KSP navball vector markers larger and bolder for readability.
    Sub-elements (stroke width, centre-dot radius, spoke/prong overshoot) now
    scale from the marker radius, and a new drawThickLine() helper strokes the
    spokes/prongs/X at 2-3 px, so markers stay proportional and legible at any
    size. Doubled the marker sizes at the navball/reticle call sites:
    - SCFT/ACFT ADI: prograde 11->22, maneuver 12->24, target 14->28
    - DOCK: DOT_R_PORT 14->28, DOT_R_VEL 12->24
    - TGT: TGT_DOT_R_TGT 14->28, TGT_DOT_R_VEL 12->24
    - MNVR: MNVR_MRK_DS 16->32
    - Reentry retrograde symbol 9->18
    Legend key markers stay small. Adjusted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
    [Screen_ACFT.ino, Screen_DOCK.ino, Screen_LNDG_Reentry.ino, Screen_MNVR.ino, Screen_SCFT.ino, Screen_TGT.ino]
2026-08-02 InfoDisp audit: fix keypad-modal bug, dead code, stale comments
    Correctness:
    - AscentAP: reset the keypad modal in chromeScreen_LNCHAP so it can never
    persist across a leave/return. Previously, tapping a sidebar button while
    the numeric keypad was open left apKpOpen set; returning to the screen drew
    a frozen panel and misrouted taps into the stale keypad.
    - AscentAP: relative reconcile tolerance for target apoapsis (a float32 ULP
    exceeds 1 m above ~8.4e6 m, so the fixed 1 m window never closed for
    interplanetary targets and the field stayed cyan forever).
    - AscentAP: don't enqueue commands in demo mode (no master drains the queue,
    so it would fill and silently drop after 15 edits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
    [AAA_Screens.ino, I2CSlave.ino, KCMk1_InfoDisp.h, Screen_LNCH.ino, Screen_LNCH_AscentAP.ino]
2026-08-02 Docs: sync InfoDisp README + refs to AscentAP, 10-byte I2C, 13 screens
    - InfoDisp README: bump to v0.14.0; update overview/hardware baseline to
    Teensy 4.1 + LT7683 1024x600 (flag the legacy SPI pin table pending
    revision); rewrite the I2C protocol section (10-byte outbound + command
    frame, inbound ackSeq, 40-byte AscentStatus push); rebuild the screens
    table for the current 10-button sidebar and add ASC + ENTR descriptions;
    fix boot-sequence INT pin/packet size; add the AscentAP tab and a
    version-history entry.
    - Bump SKETCH_VERSION 0.13.3 -> 0.14.0.
    - Ascent_Autopilot_Interface.md: Teensy 4.0 -> 4.1.
    - Display_Reference.md: add the Ascent Autopilot (ASC) screen.
    - I2C_Protocol_S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
    [KCMk1_InfoDisp.h]
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2026-08-02 Refactor: OrbAdv uses shared rowCache via advPut, drops shadow arrays
    Replace Screen_OrbAdv's private _advPS[]/_advLastValue[] shadow caches with the
    already-allocated global rowCache[screen_ORBADV]/printState[screen_ORBADV], and
    collapse the 14 copy-pasted 'if changed -> printValue -> save' blocks into a
    local advPut() helper. Behaviour is unchanged (value-only compare, dark green on
    black). chromeScreen_OrbAdv now invalidates the shared cache slots.
    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
    [Screen_OrbAdv.ino]
2026-08-02 Markers: reduce size ~80% and eliminate stroke gaps
    Per request: shrink the KSP navball markers to 20% of the doubled size
    (navball prograde 22->4, maneuver 24->5, target 28->6; DOCK/TGT 28/24->6/5;
    MNVR 32->6; reentry retro 18->4) and scale the supporting bounds down to
    match (ADI repaint/rim half-extent 34->9, reticle erase 38/36->11, reentry
    disc clamp R-28->R-11; the DOCK/TGT position clamps auto-scale).
    Gap fix: drawThickLine now fills a quad (two triangles) with round end-caps
    instead of drawing parallel offset lines, which collapsed or gapped at
    diagonal angles; the target ring is drawn as connected thick arc segments
    rather than concentric thin arcs. Together these close the seams t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
    [Screen_ACFT.ino, Screen_DOCK.ino, Screen_LNDG_Reentry.ino, Screen_MNVR.ino, Screen_SCFT.ino, Screen_TGT.ino]
2026-08-02 Refactor: ORB readout strip uses shared rowCache via orbPut
    Replace Screen_ORB's private _orbPS[7]/_lastReadout[7] shadow caches with the
    already-allocated global rowCache[screen_ORB]/printState[screen_ORB] (verified
    otherwise unused for this screen), and collapse the seven copy-pasted readout
    draw blocks into a local orbPut(slot,x,y,w,v) helper. Behaviour unchanged
    (value-only compare, dark green on black; the T+Pe/T+Ap label-flip logic and
    _lastTLabel tracker are untouched). Completes the ORB/OrbAdv shadow-cache
    cleanup.
    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
    [Screen_ORB.ino]
2026-08-02 Markers: set to 80% of the doubled size (per clarification)
    Reinterpret 'reduce by 80%' as 80% OF the doubled size (a mild trim), not 20%.
    Navball prograde 22->18, maneuver 24->19, target 28->22; DOCK/TGT port/vel
    28/24->22/19; MNVR prong 32->26; reentry retro 18->14. Supporting bounds scaled
    to match: ADI repaint/rim half-extent ->28, reticle erase ->30 (DOCK/TGT) / 29
    (MNVR), reentry disc clamp R-23. The gap-free thick-line/arc fix stays.
    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
    [Screen_ACFT.ino, Screen_DOCK.ino, Screen_LNDG_Reentry.ino, Screen_MNVR.ino, Screen_SCFT.ino, Screen_TGT.ino]
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2026-08-02 EADIBall: fix block comment closing early on */ in SCFT_*/ACFT_*
    The header block comment contained 'SCFT_*/ACFT_*', whose */ closed the
    /* */ comment early, dropping subsequent comment text into code context and
    tripping 'extended character is not valid in an identifier' on the next
    non-ASCII byte. Reworded to remove the */ sequence. No code change.
    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
    [EADIBall.ino]
2026-08-02 EADI extract stage 2: shared bank/roll arc
    Move the bank/roll indicator into EADIBall.ino: eadiDrawRollPointer,
    eadiEraseRollPointer, eadiDrawBankLabel, eadiDrawBankTick,
    eadiUpdateRollIndicator (byte-identical between SCFT and ACFT), plus the
    EADI_PTR_* geometry and a shared _eadiPrevRollIndicator with an
    eadiResetRollIndicator() the chrome calls on entry.
    Removed the _scft*/_acft* copies, the SCFT_/ACFT_ PTR_* constants, and the
    per-screen prev-indicator statics; repointed all call sites (chrome tick/label
    draw + drawScreen roll update + the entry reset). The prev-indicator static is
    now shared, which is safe: SCFT and ACFT are mutually exclusive and each resets
    it in its chrome. No behav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
    [EADIBall.ino, Screen_ACFT.ino, Screen_SCFT.ino]
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2026-08-02 EADI extract stage 5: shared horizon full/delta fill + delta-fill state
    The delicate one. Move the horizon sky/ground fill into EADIBall.ino: the chord
    half-width table, the per-scanline dirty bitmap machinery, the prev-frame split
    cache, eadiFullDraw and eadiDeltaDraw (byte-identical between SCFT and ACFT), and
    the reset/swap helpers. These become shared statics (~1.8 KB): SCFT and ACFT are
    mutually exclusive and each resets on entry via eadiBallResetState(), and both
    force a full redraw on entry so the prev-split cache never carries across; the
    chord table is geometry-identical (R=206) so it is built once and reused.
    Dropped the dirty-buffer parameter threaded through stages 3-4: eadiDraw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
    [EADIBall.ino, Screen_ACFT.ino, Screen_SCFT.ino]
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2026-08-02 Revert PFD tape marker parking; keep original hide-near-box behaviour
    Parking a tape marker at the value-box edge when it falls in the band showed it
    at a false pitch/heading, which reads as more confusing than the marker simply
    not being on the tape. Revert to the original behaviour (marker hidden while it
    overlaps the readout box). Tape code is back to the pre-change state on both
    SCFT and ACFT.
    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
    [Screen_ACFT.ino, Screen_SCFT.ino]
2026-08-02 Audit cleanup: remove dead ATT test harness, dead constants, stale bits
    - Remove ATT_StaticTest.ino (its only caller was commented out in Demo.ino)
    and drop the commented-out call block.
    - Simplify the parachute CAG guards: drop the '&& CAG <= 256' half, which is
    always true for a uint8_t (the '>= 1' 0-disables guard is the real check).
    - Remove unused constants whose feature does not exist: VEH_TEMP_SUPPRESS/WARN/
    ALARM_PCT (the VEH screen has no thermal bar) and APSI_TIME_WARN_S (no APSI
    screen). The shared TEMP_WARN/ALARM_PCT they aliased stay (used by the SCFT
    and re-entry temp bars).
    - Fix stale Screen_LNCH comment claiming the orbital left panel is blank; it is
    drawn per-fr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
    [AAA_Config.ino, Demo.ino, Screen_LNCH.ino, SimpitHandler.ino]
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2026-08-02 Docs: update display READMEs/refs for the 7-inch TFT (rev-2) hardware
    The 7-inch TFT upgrade (Teensy 4.1 / RA8876 / 1024x600 / 8080-parallel / FT5316 /
    Wire2) landed in code but several docs still described the rev-1 stack (Teensy
    4.0 / RA8875 / 800x480 / SPI / GSL1680F / Wire 18-19). Corrected against the code:
    - InfoDisp README: I2C slave bus Wire2 (24/25) not Wire (18/19); full rev-2 pin
    table; SD = SDIO/BUILTIN_SDCARD; backlight pin 9, buzzer pin 2; dependencies
    (RA8876_t41_p driver, KCM_Display/KCM_Touch, ILI9341_fonts, KDC >= 3.0.0);
    demoMode default true.
    - KerbalDisplayCommon README + library.properties: v3.0.0, RA8876/KCM_TFT/FT5316,
    rev-2 pin table, dropped RA8875 dependen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
    [I2CSlave.ino, KCMk1_InfoDisp.h]
2026-08-02 Docs: rev-2 rewrite of the Annunciator README + stale comments
    Update KCMk1_Annunciator/README.md from the rev-1 stack to the actual rev-2
    hardware (Teensy 4.1 / RA8876 / 1024x600 / 8080-parallel / FT5316 / Wire2),
    verified against the sketch (I2C 0x10, sync 0xAC, 3 screens, SKETCH_VERSION
    3.0.0): hardware + full pin table, dependencies (RA8876_t41_p driver, drop
    RA8875), I2C notes (Wire2 24/25, INT pin 0), and a 3.0.0 changelog entry. Also
    fix stale KCMk1_Annunciator.h comments (Teensy 4.0 -> 4.1, KDC >= 3.0.0).
    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
    [KCMk1_Annunciator.h]
2026-08-02 EADI markers: implement the full KSP navball marker set (KDC 3.1.0)
    Add the seven missing navball glyphs to KerbalDisplayCommon and refine the three
    existing ones, all to the approved designs:
    - New: drawRetrogradeMarker (ring+X+3 spokes), drawNormalMarker (up-triangle+dot),
    drawAntiNormalMarker (down-triangle+dot+face spokes), drawRadialInMarker (ring+
    inward diagonal spokes), drawRadialOutMarker (ring+dot+outward diagonal spokes),
    drawAntiTargetMarker (dot+3 gapped spokes), drawLevelIndicator (winged nose
    reticle with centre dot).
    - Refined: prograde spokes lengthened (~2/3 r); target arc gaps widened; maneuver
    now gaps the centre dot from its prongs.
    - Extend KspMarkerKind with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
    [EADIBall.ino]
2026-08-02 EADI: use the level indicator as the central marker; add anti-target
    - Replace the dot+wings+fin aircraft symbol with the new gold level indicator
    (drawLevelIndicator, nose dot on the wing line at the ball centre). Applies to
    both SCFT and ACFT. Refine drawLevelIndicator so its origin is the nose dot.
    - Draw the anti-target marker on the ball (antipodal to the target, shown when a
    target is available), alongside the prograde/retrograde/target/maneuver markers.
    The ball's spherical projection + cone clip show each only when it is in view.
    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
    [EADIBall.ino]
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2026-08-02 TGT/DOCK reticles: draw the opposite markers when in the scope FOV
    Add the anti-target (opposite of the target/port marker) and retrograde
    (opposite of the velocity marker) to both reticles, computed as the antipodal
    direction in each reticle's own bearing/elevation convention. Each is drawn only
    while inside the scope FOV (no rim-clamping): it appears near centre when you
    point away from the target/prograde and is erased (with chrome repair) when it
    moves or leaves view. In-view markers are redrawn every frame to stay robust
    against overdraw from the primary markers.
    Also bump the reticle erase half-size 30 -> 33 to cover the lengthened
    prograde/retrograde spokes (KDC 3.1.0) and reset the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
    [Screen_DOCK.ino, Screen_TGT.ino]
2026-08-02 Marker fixes: capless spokes, smaller level dot, reticle ghost fix (KDC 3.1.1)
    - drawThickLine gains an optional caps arg (default true). The round end-caps
    blob on free-ended spokes, so the prograde/retrograde/radial/anti-target
    spokes, maneuver prongs+crossbars, retrograde X and anti-normal face-spokes
    now draw capless (arcs and triangle outlines keep caps for clean joints).
    - Shrink the level-indicator nose dot (r/4 -> r/7).
    - TGT/DOCK: the velocity marker's always-on-top redraw now uses the cached
    (last-erased-to) position instead of the live one, so sub-pixel drift no
    longer smears/ghosts it for a few frames.
    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
    [Screen_DOCK.ino, Screen_TGT.ino]
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2026-08-02 Marker fixes: reticle opposite suppression, level indicator, re-entry retro
    1. TGT/DOCK reticles: when an opposite (anti-target / retrograde) is in the FOV,
    suppress its primary (target / prograde) -- which is clamped to the rim
    pointing away -- so the two are never shown together. The opposite helper now
    returns its in-view state to drive this.
    2. Level indicator: draw the wings/dip capless (with small interior joint fills)
    so the free tips no longer show end-cap blobs.
    3. Level indicator: ~20% larger (r 40 -> 48) and a thicker stroke.
    4. Re-entry screen: replace the local retrograde glyph (old up/left/right spokes)
    with the shared drawRetrogradeMarker so it matches the EADI/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
    [EADIBall.ino, Screen_DOCK.ino, Screen_LNDG_Reentry.ino, Screen_TGT.ino]
2026-08-02 Reticle two-phase draw + re-entry chute cell width
    - TGT/DOCK: rework the marker rendering into a strict erase-all-then-draw-all
    pass over the four markers (anti-target, retrograde, target, velocity). A
    moving marker's erase rectangle no longer clips a stationary neighbour (fixes
    the target being partially wiped when the prograde marker passes near it).
    Folds in the opposite in-view suppression and the draw-at-cache anti-ghosting.
    - Re-entry: widen the drogue/main status value sub-cells (label reservation
    80/76 -> 70) so STOW/OPEN fit the Roboto_Black_32 value font. Previously the
    wide value spilled left of the clearable region and left a residual (the 'S')
    when a narrower valu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
    [Screen_DOCK.ino, Screen_LNDG_Reentry.ino, Screen_TGT.ino]
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2026-08-02 SCFT/ACFT: enlarge TRIM to Roboto_Black_20, inset 8px from tape edges
    Bump the TRIM annunciation font one size up (16 -> 20) and pull it 8px
    left and 8px up from the heading-tape right/top edges so it no longer
    overwrites the tape dividers.
    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
    [Screen_ACFT.ino, Screen_SCFT.ino]
2026-08-02 Reentry: rows 0-5 to reticle font tier (labels 28, values 36)
    Bump the re-entry text panel's full-width readouts (T+Grnd/Alt/V.Srf/V.Vrt/
    PeA/Mach) from labels 20/values 32 to labels 28/values 36 — matching the
    reticle screens (TGT/DOCK/MNVR), which run the identical 360px 8-row panel.
    Verified against the real font glyph data: worst case is 303/343px, ~40px
    of horizontal headroom.
    Row 6 (Drog:/Main: split status) keeps the original 20/32 tier via new
    RE_LF6/RE_VF6 constants: its tight half-width value sub-cells cannot hold
    STOW/OPEN at 36pt. Row 7 buttons (RE_BTN) already use Roboto_Black_28,
    consistent with every other in-panel state button, so they are unchanged.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
    [Screen_LNDG_Reentry.ino]
2026-08-03 Powered descent full-width rows to reticle tier; enlarge TRIM to 24pt
    Powered-descent text panel: bump the five full-width readouts (V.Vrt,
    T+Grnd, Alt.Rdr, V.Srf, ΔV.Stg) from labels 20/values 32 to labels 28/
    values 36, matching the reticle screens and the re-entry panel. Split
    rows keep their smaller fonts via a new RCFS label constant: Fwd/Lat
    values (24pt) are already at their column limit and the Throttle value
    (28pt) has no safe headroom at 32pt. Buttons stay at Roboto_Black_28.
    SCFT/ACFT TRIM annunciation: font 20 -> 24. The x/y anchors derive from
    the glyph width and cap height, so the right and bottom edges stay fixed
    and the larger text grows up and to the left.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
    [Screen_ACFT.ino, Screen_LNDG_Powered.ino, Screen_SCFT.ino]
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2026-08-03 BootScreen: fix Thrust-to-weight checklist alignment
    The dotted-leader checklist aligns the status column by character count in
    the monospace terminal font. "Thrust-to-weight ratio ........." was 33 chars
    while every other item was 34, shifting its status one column left. Add one
    dot so all items are 34 chars and the column lines up.
    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
    [BootScreen.ino]
2026-08-03 Fonts: add Terminalia (OFL) family, retire pixel TerminalFont; enlarge boot text
    Replace the old IBM VGA TerminalFont (which shipped only at 16/32) with
    Terminalia, a Terminus-faithful monospace terminal font under the SIL Open
    Font License 1.1. Terminalia renders crisply at any size, so terminal/boot
    screens can pick whatever size fits.
    Fonts: generate Terminalia_{16,20,24,28,32,36} from Terminalia-Regular.ttf
    via a new vendored generator (ttf_to_ili9341.py) that renders each glyph
    1-bit, full-cell, monospace (width == delta), and round-trip verifies every
    glyph against the ILI9341_t3 decode logic. Add OFL.txt + the .ttf source.
    Wire-up:
    - InfoDisp boot: body 16 -> Terminalia_24, title 32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
    [BootScreen.ino]
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2026-08-03 Fonts: add clean Terminalia_40 (2x native 20) for the boot heading
    40 isn't a native Terminus size, so rendering the outline at 40 distorts
    diagonal stems like the Y. Instead generate Terminalia_40 by pixel-doubling
    the native 20px strike (each pixel -> 2x2), which is exact and artifact-free,
    giving a crisp bold heading. Add a "N=2xM" doubling token to the generator.
    Use Terminalia_40 for the InfoDisp boot heading. Make bsBig() advance
    font-aware (cap_height + 5) instead of a fixed 38 so the taller heading
    can't overlap the next line; this preserves ResourceDisp's 32px title
    advance exactly (33+5=38) while giving the 40px title proper spacing.
    Verified every InfoDisp boot sequence still fit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
    [BootScreen.ino]
2026-08-03 Fonts: replace outline Terminalia with real Terminus bitmaps (KcmTerm)
    The Terminalia set was an autohinted OUTLINE font; 1-bit rasterisation
    distorted several glyphs off the design grid (the Y stem drifted, etc.) at
    multiple sizes. Replace it with KcmTerm, carrying the hand-designed BITMAPS
    of Terminus Font 4.49 (SIL OFL 1.1) converted straight from the BDF sources
    by a new pure-Python bdf_to_ili9341.py. Bitmaps are pixel-exact, so every
    native size (16/20/24/28/32) is perfect; 36/40 are artifact-free 2x doubles
    of the 18/20 strikes.
    Renamed the family Terminalia -> KcmTerm (Terminus's Reserved Font Name
    forbids reusing it) across the header includes and all boot screens; swapped
    in Termin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
    [BootScreen.ino]
2026-08-03 Annunciator boot: match Info Display header format, rework spacing
    Restructure the Annunciator POST header to the same layout the Info Display
    uses: top rule / version line (grey, body font) / bottom rule / big panel
    title -- previously it was title-first with the version below a single rule.
    The version string now follows the Info Display style,
    "KCMk1-ANNUN // Jeb's Controller Works // v.. / KDC .. / KDA ..".
    Take advantage of the crisp Terminus font and full 1024x600: title and
    summary go to KcmTerm_40, the version line to KcmTerm_24 (matching the Info
    Display), checks stay at KcmTerm_32, diagnostics at KcmTerm_16. Row pitches
    opened up (checks 40->44, diagnostics 22->26, title/summa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
    [BootScreen.ino]
2026-08-03 ResourceDisp port (1/3): build against the rev-2 libraries
    Make the Resource Display sketch compile against the already-migrated rev-2
    libraries (KerbalDisplayCommon v3, KCM_Display/KCM_TFT, KCM_Touch):
    - AAA_Globals: construct KCM_TFT infoDisp(KCM_TFT_RS, KCM_TFT_CS,
    KCM_TFT_RESET) instead of the removed RA8875(RA8875_CS, RA8875_RESET).
    - Swap every RA8875 type -> KCM_TFT (the extern + all draw/screen signatures).
    - Header: add #include <KCM_Touch.h> (FT5316; the touch API was used but never
    included), add the `typedef ILI9341_t3_font_t tFont` compat alias, bump
    SKETCH_VERSION to 3.0.0 and the KDC requirement to >= 3.0.0.
    - I2CSlave: move the slave bus from Wire (Teensy 4.0 pins 18/1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
    [AAA_Globals.ino, BootScreen.ino, I2CSlave.ino, KCMk1_ResourceDisp.h, KCMk1_ResourceDisp.ino, ScreenDetail.ino, ScreenMain.ino, ScreenSelect.ino]
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2026-08-03 ResourceDisp: correct the KerbalDisplayAudio pin-9 note
    Verified the linked-but-unused KerbalDisplayAudio dependency touches no pins:
    the library has no global object (only free functions + POD file statics), the
    sketch never calls setupAudio()/any audio*(), and AUDIO_PIN defaults to pin 2
    (moved off the old rev-1 pin 9, which is now the TFT backlight). The earlier
    comment/README note implied an active pin-9 collision; there is none. Reword
    both to state the actual behaviour.
    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
    [KCMk1_ResourceDisp.h]
2026-08-03 ResourceDisp: fix RA8876 GFX font API (setFont by ref, cap_height)
    The RA8876 GFX text API differs from the rev-1 RA8875 (sumotoy) driver the
    screen code was written against; compiling the port surfaced two mismatches:
    - setFont takes the font by reference, not by pointer. Change the direct
    tft.setFont(&Roboto_*) calls to tft.setFont(Roboto_*), and the pointer-var
    calls in ScreenMain to tft.setFont(*font). (drawButton()/getFontStringWidth()
    still take a const tFont*, so those &Font args are left as-is.)
    - ILI9341_t3_font_t has no font_height member; use cap_height for the
    vertical-centre math in ScreenMain, matching the InfoDisp convention.
    Mirrors the already-ported InfoDisp (tft.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
    [ScreenDetail.ino, ScreenMain.ino, ScreenSelect.ino]
2026-08-03 ResourceDisp: add STANDALONE_TEST mode (skip master boot handshake)
    Mirror the InfoDisp/Annunciator standalone flag so the panel can boot without
    an I2C master. When STANDALONE_TEST is true, setup() skips asserting INT and
    the blocking `while (!i2cProceedReceived)` wait, proceeding straight past the
    boot screen into loop().
    - AAA_Config: new `const bool STANDALONE_TEST = true;` (same default/comment as
    the InfoDisp — flip to false for production).
    - Header: extern declaration alongside the other AAA_Config externs.
    - setup(): wrap the build-packet + PROCEED-wait block in `if (!STANDALONE_TEST)`.
    setupI2CSlave() still runs unconditionally, so a master can still attach and
    drive the slav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
    [AAA_Config.ino, KCMk1_ResourceDisp.h, KCMk1_ResourceDisp.ino]
2026-08-03 ResourceDisp: main-screen bar/percentage fixes + detail-screen sizing
    Address five bench-test findings:
    1. Percentage flicker: decouple the bar-fill redraw from the percentage-label
    redraw. The bar still updates on any BAR_LEVEL_HYSTERESIS-sized level change,
    but the number is now repainted only when the integer % actually changes
    (tracked in _prevPerc[]). Previously it was cleared-and-reprinted every frame
    the level moved 0.2%, which flickered constantly in demo mode.
    2. Bar color: bars always render in the resource's designated color regardless
    of fill level (dropped the <LOW_RES_THRESHOLD -> red recolor). Low-level
    warning is still conveyed by the percentage text color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
    [AAA_Config.ino, KCMk1_ResourceDisp.h, ScreenDetail.ino, ScreenMain.ino]
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2026-08-03 ResourceDisp: add fixed EC/O2/Food/H2O ring gauges to the main screen
    Add four always-on 270° ring gauges down the left of the main screen (present
    in both TOTAL and STAGE mode); the bar area condenses to sit to their right.
    Data model:
    - New gauges[GAUGE_COUNT] (EC/O2/Food/Water) tracked independently of slots[].
    isGaugeResource() keeps these four out of the bar/selection pool: filtered
    from initDefaultSlots/initAllSlots, addResource, loadPreset, and shown as
    inert dimmed tiles (blocked in the tap handler) on the Select grid.
    - SimpitHandler.updateSlot() now also routes matching values to updateGauge(),
    so the gauges get live data from the same channels (EC / TACLS O2,Food,Water).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
    [AAA_Globals.ino, Demo.ino, KCMk1_ResourceDisp.h, Resources.ino, ScreenMain.ino, ScreenSelect.ino, SimpitHandler.ino]
2026-08-03 Revert "ResourceDisp: add fixed EC/O2/Food/H2O ring gauges to the main screen"
    This reverts commit b745bbe. The left-side ring-gauge view didn't work out as
    hoped, so back out the whole feature: the gauges[] data model, isGaugeResource()
    bar/selection exclusion, the Simpit updateGauge() routing, the demo animation,
    the Select-grid disabling, and the ScreenMain gauge column / condensed bars.
    The main screen returns to the full-width bar + sidebar layout. Kept: the
    independent drawButton border-clamp fix (f4c8449), which is unrelated.
    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
    [AAA_Globals.ino, Demo.ino, KCMk1_ResourceDisp.h, Resources.ino, ScreenMain.ino, ScreenSelect.ino, SimpitHandler.ino]
2026-08-03 ResourceDisp: bigger axis font, wider bar gaps, 10-resource default
    Main bar screen tuning:
    - Vertical axis labels Roboto_Black_12 -> Roboto_Black_16 (AXIS_W 44 -> 50 to fit).
    - Bar gap BAR_PAD 8 -> 14 for clearer separation between bars.
    - Default bar set 8 -> 10 resources. STD/DFLT is now EC, LF, LOx, MP, SF,
    Ablator, O2, Food, Water, Ore — adding re-entry (Ablator) and ISRU (Ore) to
    the existing power/propellant/life-support set. DEFAULT_SLOT_COUNT, the STD
    preset, and initDefaultSlots() kept in sync. At 10 bars each is ~73px wide
    (vs ~95px at 8), addressing the "too wide" look.
    Claude-Session: https://claude.ai/code/sessi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
    [KCMk1_ResourceDisp.h, Resources.ino, ScreenMain.ino, ScreenSelect.ino]
2026-08-03 ResourceDisp: shrink detail selector font so 2-line names clear the border
    The detail-screen selector font tiers were sized for single-line text, so a
    two-line wrapped name (e.g. "Enriched Uranium") plus its descenders printed over
    the button's bottom border — most visible at the new 10-slot default (~60px
    buttons on the Black_20 tier). Re-tier the font by button height for the
    two-line worst case (~2*cap_height + descender must clear btnH - 2*BTN_PAD):
    >=100 -> 28, >=80 -> 24, >=64 -> 20, >=54 -> 16, else 12
    Fits cleanly for 4-15 active slots (the default 10 now has ~11px margin); only
    the extreme 16-slot case stays ~1px tight, where the 37px button height leaves
    no room for two l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
    [ScreenDetail.ino]
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2026-08-03 ResourceDisp: EVA mode — fixed bar set + hide EVA fuel when not on EVA
    Drive an "EVA mode" from KerbalSimpit's FLIGHT_STATUS_MESSAGE (FLIGHT_IS_EVA
    bit of the flags byte, msg[0]):
    - Detection: register FLIGHT_STATUS_MESSAGE; its handler latches evaFlag.
    loop() reconciles evaFlag -> evaActive after each message batch and swaps the
    bar set, forcing screen_Main to show the result.
    - On EVA: slots become the fixed set Electric Charge, EVA Propellant, Oxygen,
    Food, Water (loadEvaSlots()). The vessel layout is snapshotted every non-EVA
    frame (_evaBackup) and restored when EVA ends, then a Simpit refresh repopulates
    values. VESSEL_NAME recall is skipped while on EVA so the Kerbal's nam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
    [AAA_Globals.ino, KCMk1_ResourceDisp.h, KCMk1_ResourceDisp.ino, Resources.ino, ScreenSelect.ino, SimpitHandler.ino, TouchEvents.ino]
2026-08-03 ResourceDisp: temporary demo-only EVA test toggle
    Add a bench-test hook for EVA mode: in demo mode, tapping the top-left 60x60
    corner of the Main screen flips evaFlag, so loop() reconciles the EVA bar-set
    swap exactly as it would from a live FLIGHT_STATUS_MESSAGE. Guarded by demoMode
    so it has no effect in live operation. Marked TEMPORARY — remove before
    production.
    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
    [TouchEvents.ino]
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2026-08-03 Displays: remove EVA demo toggle, set all three sketches to production config
    - ResourceDisp: remove the temporary demo-only EVA test toggle from
    TouchEvents; demoMode=false, STANDALONE_TEST=false.
    - InfoDisp: demoMode=false, STANDALONE_TEST=false, fpsDiag=false (no serial
    diagnostics spam in production).
    - Annunciator: demoMode=false (standaloneMode/standaloneTest/lampTest were
    already false).
    audioEnabled on the Annunciator is left false — it's a feature toggle rather
    than a bench/production flag; flip to true if the panel's audio is wired.
    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
    [AAA_Config.ino, TouchEvents.ino]
2026-08-03 Displays: audit fixes — real bug, defensive guards, stale comments
    Cross-sketch audit follow-up (code + comment fixes; dead-code removal, the
    subtle yellow-tier redraw, and README drift are reported separately for review).
    - BUG: skinTemp default 100 -> 0. At 100 it exceeded tempAlarm (90) and tripped
    CW_HIGH_TEMP + the master alarm on every flight entry until the first
    TEMP_LIMIT_MESSAGE (permanently if that channel never arrives). Now matches maxTemp.
    - Add msgSize guards to SCENE_CHANGE / VESSEL_CHANGE before reading msg[0].
    - Stale comments: RCS caution threshold 15% -> 20% (matches CW_RCS_LOW_FRAC=0.20,
    3 sites); GSL1680F/y479 -> FT5316/y599; RA8875 boot-mode note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
    [BootScreen.ino, CautionWarning.ino, KCMk1_Annunciator.h, KCMk1_Annunciator.ino, KCMk1_InfoDisp.ino, KCMk1_ResourceDisp.h, Resources.ino, ScreenDetail.ino]
2026-08-03 Displays: fix Annunciator yellow-tier redraw (BUG-2) + more stale comments
    Annunciator BUG-2: the two-tier yellow C&W tiles (PE_LOW / PROP_LOW / LIFE_SUPPORT)
    are driven by peLowYellow/propLowYellow/lsYellow, which can toggle without changing
    cautionWarningState. Both the caller gate and updateCautWarnPanel's internal gate
    keyed only on bit/chute changes, so a pure yellow transition never repainted. Add
    prev-tracking for the three companion bools and include them in both gates (updated
    alongside prevChuteEnvState).
    Stale comments:
    - InfoDisp TouchEvents: replace the phantom rev-1 touchISR()/_touchPending "Defence
    layer 1" and the "skipped for ISR-latched touches" note with the rev-2 polli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
    [BootScreen.ino, KCMk1_InfoDisp.h, ScreenMain.ino, Screen_ROVR.ino, SimpitHandler.ino, TestMode.ino, TouchEvents.ino]
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2026-08-03 feat(infodisp): compile-time unit selector for Info Display 1/2 (D3)
    Info Display 2 is a second instantiation of the same Info Display firmware
    distinguished only by its I2C slave address, so the master can address each
    board independently on the shared Wire2 bus.
    - SystemConfig.h: add KCM_I2C_ADDR_INFODISP_2 (0x13); reserve
    KCM_I2C_ADDR_SYSINFODISP (0x14) for the future System Info Display
    (separate hardware, not yet coded). Note 0xAE sync is shared by both units.
    - AAA_Config.ino: add INFO_DISP_UNIT board selector (1 -> 0x12, 2 -> 0x13).
    - I2CSlave.ino: derive I2C_SLAVE_ADDR from INFO_DISP_UNIT with an #error guard;
    update the header comment to describe the selectable address.
    Co-A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
    [AAA_Config.ino, I2CSlave.ino]
2026-08-03 fix(controller): correct swapped Info/Resource display I2C addresses
    Controller_Main.ino had INFO_MC=0x11 and RES_MC=0x12, but the slave
    firmware assigns the opposite (KCMk1_SystemConfig.h): Resource Display
    is 0x11, Info Display is 0x12. As written the master would poll each
    display at the other's address. Swap them to match the slaves.
    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
    [Controller_Main.ino]
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2026-08-03 docs: fix backwards chip naming in display sketch header comments (D1)
    The three display main-sketch header comments still read
    "RA8876 (LT7683)"; standardize to "LT7683 (RA8876-compatible)" to match the
    rest of the audit. Driver/type references (RA8876/KCM_TFT) are left as-is.
    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
    [KCMk1_Annunciator.ino, KCMk1_InfoDisp.ino, KCMk1_ResourceDisp.ino]
2026-08-08 refactor(infodisp): audit batch A — core/infra fixes
    Bugs:
    - SimpitHandler: add msgSize guards to CAGSTATUS/SCENE_CHANGE/VESSEL_CHANGE
    handlers (were reading msg[] unguarded, unlike every other handler).
    - AAA_Globals estimateTimeToGround: test vessel situation with bitmask & (it is
    a bitmask) instead of ==, matching contextScreen().
    - TouchEvents: reject count != 1 on the confirmation re-read too (was count==0
    only), and also bounds-check y >= SCREEN_H (already in code; comment fixed).
    - I2CSlave: guard the outbound-packet memcpy with noInterrupts() so onI2CRequest
    can't transmit a torn packet (bytes 0-2 are outside the command checksum).
    Dead code:
    - Removed unused drawChrome()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
    [AAA_Globals.ino, AAA_Screens.ino, Demo.ino, EADIBall.ino, I2CSlave.ino, KCMk1_InfoDisp.h, SimpitHandler.ino, TouchEvents.ino]
2026-08-08 refactor(annunciator): audit batch B — bugs, design changes, cleanup
    Bugs / design (both approved):
    - Fixed the orbit-insertion alert chirp: the situation-column update synced
    prev.vesselSituationState BEFORE the chirp edge-check read it, so the ORBIT
    chirp could never fire. Capture the pre-update value for the check.
    - Silence latch: syncMasterAlarmAudio() now reconciles the alarm mask DIRECTLY
    to current C&W state instead of replaying each bit through updateAlarmMask().
    Replaying treated already-active conditions as "new while silenced" and
    un-silenced the alarm, so a crew-silenced master alarm re-blared after a mere
    SOI->Main round-trip. It now stays silenced until condition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
    [AAA_Globals.ino, Audio.ino, BootScreen.ino, CautionWarning.ino, Demo.ino, I2CSlave.ino, KCMk1_Annunciator.h, ScreenMain.ino]
2026-08-08 refactor(resourcedisp): audit batch C — EVA reset, cleanup, dedup
    - EVA latch (evaFlag/evaActive) is now cleared on leave-flight and vessel-switch
    so an EVA that ended off-scene doesn't stay engaged (it self-corrects back on
    if the new vessel is still an EVA Kerbal).
    - noInterrupts() guard around the outbound-packet memcpy (torn-packet race).
    - Removed the redundant boot re-zero loop (live-mode initDefaultSlots already
    zeroes values) and the unreachable demoMode=false in the SCENE_CHANGE handler
    (Simpit is never serviced while demoMode is true).
    Functionalize / reuse:
    - Added initSlotValues()/zeroAllSlotValues() and used them across the four
    slot-loading paths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
    [AAA_Config.ino, AAA_Globals.ino, I2CSlave.ino, KCMk1_ResourceDisp.ino, Resources.ino, ScreenMain.ino, ScreenSelect.ino, SimpitHandler.ino]
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2026-08-08 fix(infodisp): audit batches E/F — reticle-bar stale statics + AoA comment
    Bugs (same stale-function-static pattern):
    - MNVR ΔV-burn bar (_mnvrPrevDV) and DOCK approach-distance bar (_dockPrevDist)
    are now file-scope statics reset in their chrome functions, so the bar fill +
    value repaint on screen re-entry instead of staying blank until the value
    next moves ≥1 (chrome only drew the border/label, not the fill).
    Comments:
    - Screen_ACFT AoA-arc comments were inverted vs the code (which does
    arcAngle = 180 + aoa, so positive AoA increases the angle: warn 190-200,
    alarm 200-205). Corrected — this is the stall-risk indicator, so the doc
    matters. Also fixed the DOCK "sentinel r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
    [Screen_ACFT.ino, Screen_DOCK.ino, Screen_MNVR.ino, Screen_VEH.ino]
2026-08-08 refactor(infodisp): shared sasNavballLabel() for SCFT/ACFT/ROVR
    The SAS-mode -> label + fg/bg palette switch was triplicated verbatim across the
    three PFD screens. Extracted to sasNavballLabel() in AAA_Screens.ino (prototype in
    KCMk1_InfoDisp.h) and replaced all three switches with a call. Behaviour is
    identical (255/unknown -> dimmed "SAS"); removes ~45 duplicated lines.
    Deferred-refactor series (compile-check target 1/N).
    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
    [AAA_Screens.ino, KCMk1_InfoDisp.h, Screen_ACFT.ino, Screen_ROVR.ino, Screen_SCFT.ino]
2026-08-08 refactor(infodisp): remove dead EADI-ball constants from SCFT/ACFT
    Since the attitude ball moved to the shared EADIBall.ino renderer, each PFD screen
    kept ~10 now-unused constants (SKY/GND/HORIZON/WINGS/LADDER colours, BALL_Y0/Y1,
    SCANLINES, BX_ALLSKY/ALLGND). Grep-confirmed zero references beyond their
    definitions; removed. Also fixed the stale ACFT_SCALE "6.667 px/deg" comment
    (it's R/30 = 6.867) — the removed BALL_Y0/Y1/SCANLINES comments carried the other
    stale ACFT geometry numbers.
    Deferred-refactor series (compile-check target 3/N).
    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
    [Screen_ACFT.ino, Screen_SCFT.ino]
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2026-08-08 style(infodisp): recolor sidebar nav buttons (green idle/selected, navy for ASC)
    New sidebar button palette:
    idle : BLACK background, DARK_GREEN text
    selected : DARK_GREEN background, WHITE text
    ASC button: NAVY in place of DARK_GREEN (idle: BLACK bg / NAVY text,
    selected: NAVY bg / WHITE text)
    - btnScreenOff/btnScreenOn recolored (buttons always draw with isOn=true, so
    the *On fields are what render; *Off mirrored for clarity).
    - drawSidebar() ASC override now swaps DARK_GREEN for NAVY on both the selected
    background and the idle text, replacing the previous violet/purple treatment.
    Claude-Session: https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
    [AAA_Screens.ino]
2026-08-08 Revert "style(infodisp): recolor sidebar nav buttons (green idle/selected, navy for ASC)"
    This reverts commit eaf09f9e6d8bf91da9e39d1ce84ea616bb889923.
    [AAA_Screens.ino]
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2026-08-08 release: bump display firmware/library versions for main merge
    Version stamps had fallen behind the code — this session's audit batches,
    refactors, and the sidebar navigation redesign all landed on top of the
    existing stamps without a bump. Stamp final versions and record them.
    - InfoDisp 0.14.0 -> 1.0.0 (production release: 6-button sidebar nav,
    refactors, audit batches A/E/F, unit selector)
    - Annunciator 3.0.0 -> 3.1.0 (silence-latch fix; outbound C&W I2C widened
    to all 25 bits, packet 4->6 bytes)
    - ResourceDisp 3.0.0 -> 3.0.1 (EVA reset + audit batch C cleanup)
    - KerbalDisplayCommon 3.1.1 -> 3.1.2 (drawButton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
    [KCMk1_Annunciator.h, KCMk1_InfoDisp.h, KCMk1_ResourceDisp.h]
2026-08-08 Point shared-include paths at the actual checkout root (C:\Dev)
    The Software/Common absolute includes hardcoded a C:\Users\jason\OneDrive
    root, but the repo is checked out at C:\Dev\KerbalControllerMk1, so the
    shared body_params.h include (and the pre-existing custom_action_grp_def.h
    / keyboard_def.h includes in Controller_Main) would fail "No such file".
    Update the root to C:\Dev in both the KerbalDisplayCommon library header
    and Controller_Main.ino.
    Note: unrelated to the RA8876_t41_p.h build error, which is a missing
    third-party library required by main's KCM_Display (7-inch TFT upgrade).
    Claude-Session: https://claude.ai/code/sess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
    [Controller_Main.ino]
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2026-08-15 Docs: describe V2.1 PAM8302A audio amp across SystemConfig + panel docs
    Update the current-state audio description from the old S8050 buzzer to the
    KC-01-1911 V2.1 PAM8302A Class-D amplifier + external speaker with a TONE_EN
    amp-enable line, for consistency with the new hardware:
    - KCMk1_SystemConfig.h: rewrite the AUDIO section header and the
    KCM_AUDIO_TONE_PIN comment; document KCM_AUDIO_EN_PIN (TONE_EN -> amp /SD)
    with a TODO for the actual GPIO, pending the schematic pin assignment.
    - Top-level README, Annunciator README (hardware + pin tables),
    InfoDisp README, ResourceDisp.h, PORTING_7inch_TFT.md: buzzer -> amp
    wording; add TONE_EN amp-enable rows/notes.
    Historical changelog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
    [KCMk1_Annunciator.ino, KCMk1_ResourceDisp.h]
2026-08-15 Audio pins -> TONE 29 / TONE_EN 30 (V2.1); library auto-derives from SystemConfig
    The KC-01-1911 V2.1 schematic moved the tone output to pin 29 and put the
    PAM8302A amp-enable (TONE_EN) on pin 30.
    - KCMk1_SystemConfig.h: KCM_AUDIO_TONE_PIN 2 -> 29, add KCM_AUDIO_EN_PIN 30.
    - KerbalDisplayAudio: the header now pulls in KCMk1_SystemConfig via a guarded
    __has_include and defaults AUDIO_PIN / AUDIO_EN_PIN to KCM_AUDIO_TONE_PIN /
    KCM_AUDIO_EN_PIN. This resolves the pins in every translation unit including
    the library's own .cpp -- a sketch-level `#define AUDIO_PIN` does NOT reach a
    separately-compiled library .cpp, so the previous "sketch overrides the pin"
    pattern never actually confi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
    [KCMk1_Annunciator.h, KCMk1_ResourceDisp.h]
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2026-08-15 Annunciator 3.1.1: changelog for V2.1 PAM8302A audio hardware
    Bump SKETCH_VERSION to 3.1.1 and add a changelog entry describing the V2.1
    audio adaptation: tone() moved to pin 29, S8050 buzzer -> PAM8302A Class-D
    amp + speaker with volume trim, amp-enable TONE_EN on pin 30 (idle-hiss mute),
    and DFPlayer BUSY on pin 11 for isPlaying() polling. No sketch-logic change --
    KerbalDisplayAudio self-configures the pins from KCMk1_SystemConfig; requires
    KerbalDisplayAudio >= 1.3.0.
    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
    [KCMk1_Annunciator.h]
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2026-08-15 Annunciator GPWS: fix callout state-machine defects from review
    Address five findings in the GPWS callout state machine (all within the
    unreleased 3.2.0 feature):
    1. SINK RATE no longer swallows the low-altitude flare callouts. The sink
    envelope is narrowed from a flat time-to-impact bound to an altitude-scaled
    descent-rate boundary (Mode-1 style, only evaluated below GPWS_SINK_CEIL_M),
    so a normal approach no longer trips it and suppresses the ladder.
    2. Altitude callouts now DEFER instead of DROP. _prevAlt (the crossing tracker)
    is advanced only when a rung is actually spoken; higher-priority branches and
    busy-player frames leave it frozen, so gpwsCrossedClip() announces th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
    [AAA_Config.ino, GPWS.ino, KCMk1_Annunciator.h]
2026-08-16 Annunciator GPWS: recurring TOO LOW GEAR, add Mode 3 (DON'T SINK) and BANK ANGLE
    Extend the GPWS callout suite toward fuller real-GPWS coverage:
    - TOO LOW GEAR (Mode 4A) now RE-ANNUNCIATES while the vessel stays in the
    envelope (fires on entry, then every GPWS_GEAR_GAP_MS), replacing the
    once-per-entry latch to match real Mode-4 behaviour.
    - Mode 3 (DON'T SINK) implemented: armed on the liftoff edge (on-ground ->
    airborne via the situation bits), disarmed once an established climb clears
    GPWS_MODE3_CEIL_M; fires on a net altitude loss from the post-takeoff peak
    greater than GPWS_MODE3_LOSS_M, recurring on GPWS_MODE3_GAP_MS. Requires a
    real on-ground frame first, so a vessel load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
    [AAA_Config.ino, GPWS.ino, KCMk1_Annunciator.h, SimpitHandler.ino]
2026-08-16 GPWS: faithful mode envelopes, feet callouts, rendezvous distance mode, threshold bug tone
    Rework the Annunciator GPWS into an aviation-faithful implementation and add the
    control model, callout units, rendezvous mode, and threshold bug the user
    specified. Spans the Annunciator sketch and the GPWS Input module firmware.
    Control model (real GPWS = no per-mode arm; system on = all modes):
    GREEN (ACTIVE) -> all warning modes + altitude callouts + MINIMUMS + bug tone
    AMBER + proxAlarm -> altitude callouts + MINIMUMS + bug tone only (no warnings)
    AMBER + rdvRadar -> target-distance callouts + bug tone only (on tgtDistance)
    proxAlarm/rdvRadar are now mutually-exclusive amber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
    [AAA_Config.ino, GPWS.ino, I2CSlave.ino, KCMk1_Annunciator.h, KCMk1_GPWS_Input.ino, SimpitHandler.ino]
2026-08-16 GPWS: dense Airbus altitude ladder + STALL/V1/ROTATE/RETARD/APPROACHING MINIMUMS
    Expand the callout suite to the confirmed v2 clip map (31 clips):
    - Altitude ladder is now the Airbus-dense feet schedule: 2500/1000/500/400/300/
    200/100/90/80/70/60/50/40/30/20/10/5 ft (adds 90/80/70/60/5). Distance ladder
    drops the 1 m rung (no "ONE" clip): 500/200/100/50/40/30/20/10/5 m.
    - APPROACHING MINIMUMS at threshold + APPR_MIN_MARGIN_M (~100 ft) above the bug,
    alongside MINIMUMS + bug tone at the bug.
    - New non-GPWS extras (fixed-threshold approximations, GREEN mode):
    STALL -- AoA = pitch - surfaceVelocityPitch > STALL_AOA_DEG, airborne in atmo.
    V1 / ROTATE -- takeoff-roll speed callout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
    [GPWS.ino, KCMk1_Annunciator.h, SimpitHandler.ino]
2026-08-16 GPWS: align STALL AoA with InfoDisp AoA arc; realistic V1/Vr defaults
    - Add cross-panel aligned AoA thresholds to KCMk1_SystemConfig
    (KCM_AOA_WARN_DEG = 10, KCM_AOA_STALL_DEG = 20). Both the InfoDisp aircraft
    EADI AoA arc (AOA_WARN_DEG/AOA_ALARM_DEG) and the GPWS STALL callout now alias
    them, so the "beyond stall AoA" point is identical on both panels. GPWS STALL
    threshold moves 15 -> 20 deg to match the InfoDisp red tier. Both use the same
    AoA = pitch - surfaceVelocityPitch formula.
    - V1/Vr defaults lowered 70/80 -> 55/65 m/s to match typical KSP takeoff speeds
    (rotation rule of thumb ~50 m/s; planes range ~40-110 m/s), documented as
    per-craft tunables.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
    [AAA_Config.ino, GPWS.ino]
2026-08-16 Annunciator 3.2.1: GPWS EGPWS-conformance pass (priority + Modes 2/3/4C/6)
    Graded the GPWS function against the Honeywell MK VI/VIII Pilot Guide and
    applied six changes:
    A. Reorder the aural priority to the manual's priority table: STALL >
    PULL UP/TERRAIN > post-warning TERRAIN > bug TONE > MINIMUMS > TOO LOW
    TERRAIN > RETARD > callouts > TOO LOW GEAR > SINK RATE > DON'T SINK >
    BANK ANGLE > V1 > ROTATE. Callouts/MINIMUMS/RETARD now correctly
    outrank SINK RATE / DON'T SINK / TOO LOW GEAR.
    B. Mode 4C minimum-terrain-clearance floor: TOO LOW TERRAIN when sinking
    below 75% of the post-takeoff peak radio altitude with gear up
    (reuses the Mode 3 peak tracker).
    C. Mode 3 DON'T SI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
    [GPWS.ino, KCMk1_Annunciator.h]
2026-08-16 Annunciator 3.3.0: GPWS Mode 2A/2B split, nuisance gates, throttle RETARD, GEAR UP
    Refinements informed by comparing against the KSP_GPWS mod:
    - Mode 2 gains a 2A/2B envelope split. Gear-down selects a lower-ceiling,
    desensitised landing-configuration envelope (M2B_CEIL_M ~789 ft, higher
    closure floor) so a normal gear-down approach over rising terrain does not
    nuisance-trip; gear-up keeps the sensitive 2A envelope (M2A_CEIL_M ~2200
    ft). Gear state is the flaps proxy KSP doesn't otherwise expose.
    - TOO LOW GEAR is inhibited for TOOLOW_ARM_MS (~15 s) after liftoff, tracked
    via a new _takeoffMs stamp, so the initial gear-up climb-out stays silent.
    - RETARD is gated on commanded thro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
    [GPWS.ino, KCMk1_Annunciator.h]
2026-08-16 Annunciator 3.4.0: GPWS lander/rocket profile, selected by vessel type
    gpwsUpdate() now dispatches by vessel type: type_Plane keeps the full EGPWS
    aircraft suite; any other type (rocket, lander, probe, ...) runs the new
    gpwsUpdateLander() vertical-landing profile.
    Lander callouts (priority high -> low): SINK RATE > HORIZONTAL SPEED >
    bug TONE > RETARD > metre altitude callouts.
    - SINK RATE uses the time-to-impact metric (alt_surf / |vel_vert| <
    LANDER_TIMP_S), aliased to the cross-panel KCM_GROUND_PROX_S so the voice
    callout and the C&W GROUND PROX lamp (and the InfoDisp landing screen)
    stay consistent.
    - HORIZONTAL SPEED warns on lateral speed above an altitude-ramped limit
    (tip-ov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
    [GPWS.ino, KCMk1_Annunciator.h]
2026-08-16 Annunciator 3.4.1: descent-rate floor on the lander SINK RATE
    SINK RATE now requires both a low time-to-impact AND a descent rate above
    LANDER_SINK_FLOOR_MS (6 m/s), so a gentle powered landing no longer trips it
    inside the 10 s time-to-impact window. 6 m/s is ~half the ~12 m/s impact
    tolerance shared by the stock LT-05/LT-1/LT-2 landing legs (a 2x margin) and
    about the usual gentle-landing target. Renames the old LANDER_SINK_MIN_MS
    crawl-ignore threshold, which the floor subsumes.
    Claude-Session: https://claude.ai/code/session_01XBKuFzWhtHdCquD5Av41J7
    [GPWS.ino, KCMk1_Annunciator.h]
2026-08-16 Annunciator 3.5.0: gear/type/altitude decision tree for the threshold bug
    Reworks what fires when a vessel descends through the threshold-bug altitude:
    - Gear UP (aircraft or lander) -> new GROUND PROXIMITY call (clip 34): you
    are at your set altitude with no gear down.
    - Gear DOWN, aircraft, bug >= DH_SPLIT_M (300 m) -> generic altitude TONE
    (a high bug is just a level marker).
    - Gear DOWN, aircraft, bug < 300 m -> a real decision height: APPROACHING
    MINIMUMS (100 ft above) then MINIMUMS, no tone.
    - Gear DOWN, lander (any bug) -> TONE (a lander's bug is always a landing
    cue; no minimums, no 300 m split).
    - rdvRadar range bug -> TONE only on closing through, gear-agnostic.
    The numb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
    [GPWS.ino, KCMk1_Annunciator.h]
2026-08-16 Annunciator 3.5.1: match DON'T SINK / STALL playback to the recorded clips
    - DON'T SINK (clip 6) is a single "don't sink" utterance, so the firmware
    now plays it twice (_dsRepeat) to form the "don't sink, don't sink"
    doublet. The second half fires on the next BUSY-clear at Mode 3 priority,
    so a real warning can still preempt it; annunciation cadence is unchanged.
    - STALL (clip 8) is a buzzer: STALL_GAP_MS 1200 -> 60 ms so it re-triggers
    the instant it ends (small debounce covers BUSY-assert latency) and sounds
    continuously while the stall condition is present.
    Claude-Session: https://claude.ai/code/session_01XBKuFzWhtHdCquD5A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
    [GPWS.ino, KCMk1_Annunciator.h]
2026-08-16 Annunciator 3.5.2: fix Arduino build -- forward-declare GpwsRung
    The Arduino builder concatenates the .ino tabs and injects a prototype for
    gpwsCrossed(const GpwsRung*, ...) at the top of the combined sketch, above
    GPWS.ino's `struct GpwsRung { ... };` definition, so the type name fails to
    resolve: "'GpwsRung' does not name a type". A plain top-to-bottom C++ compile
    of GPWS.ino doesn't hit this because there's no injected prototype.
    Fix: forward-declare `struct GpwsRung;` in KCMk1_Annunciator.h (included by
    the main sketch before the injection point). The full definition stays in
    GPWS.ino; the prototype's pointer params only need the incomplete type. No
    behaviour change.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
    [KCMk1_Annunciator.h]
2026-08-29 DOCK: make the velocity marker a flyable relative-velocity marker
    The green VEL marker was computed target-referenced
    (tgtHeading - tgtVelHeading, tgtPitch - tgtVelPitch) but plotted on a
    nose-referenced reticle, where the fixed crosshair is the boresight and
    the PORT marker is measured from state.heading/state.pitch. Two frames on
    one scope: the marker sat at centre whenever the craft was flying at the
    port, no matter where the nose pointed, so it did not respond to an RCS
    translation the way a prograde marker should.
    All four plotted pairs in reticleComputeAngles() are now referenced to the
    nose, so the whole marker layer lives in one frame. The target-referenced
    approach-path error moves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
    [AAA_Screens.ino, KCMk1_InfoDisp.h, Screen_DOCK.ino, Screen_TGT.ino]
2026-08-29 Project world directions about the boresight, not by subtracting angles
    Every attitude display -- MNVR, TGT, DOCK, the EADI ball markers and the
    re-entry retro ball -- placed a world direction by subtracting headings and
    pitches and scaling the differences. That is only valid near zero pitch.
    Heading lines converge toward the poles, so the bearing axis stretched by
    roughly 1/cos(pitch): a 10 deg error read 14 deg at 45 deg pitch and 20 deg
    at 60 deg. The degree-labelled rings were misreporting, anisotropically --
    thrust left and thrust down moved the DOCK marker 90 px and 35 px for the
    same delta-v at 60 deg pitch.
    Past about 80 deg it inverted outright. That is exactly where a radial-in
    or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
    [AAA_Screens.ino, EADIBall.ino, KCMk1_InfoDisp.h, Screen_DOCK.ino, Screen_LNDG_Reentry.ino, Screen_MNVR.ino, Screen_TGT.ino]
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2026-08-29 Distinguish target-relative prograde; make the reticle rings the colour bands
    Two of the three collisions from the reticle review. The demo-visibility
    question needed no change.
    SYMBOL. The velocity marker on TGT/DOCK drew the same neon-green prograde
    glyph the PFD ball uses, where it means orbital or surface velocity rather
    than target-relative. Identical symbol, identical colour, two reference
    frames, nothing on screen to tell them apart. New
    drawTargetProgradeMarker draws prograde's three spokes and centre dot with
    the target marker's four-arc gapped ring -- "prograde, target flavour".
    Borrowing the target ring keeps the KSP reading that prograde is prograde,
    and spends no colour, which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
    [AAA_Config.ino, KCMk1_InfoDisp.h, Screen_DOCK.ino, Screen_MNVR.ino, Screen_TGT.ino]
2026-08-29 Restore the VALUE FORMATTERS block dropped in 9a6cf7a
    fmtNum / fmtUnit / fmtMs went missing, breaking the build at 19 call sites
    across ACFT, DOCK, LNCH Ascent/Circ/PreLaunch, LNDG Powered/Reentry, MNVR,
    OrbAdv, SCFT, TGT and VEH.
    My fault, and a scripted-edit failure rather than a reasoning one. Rewriting
    reticleComputeAngles in 9a6cf7a I spliced the file as s[:i] + new + s[j:]
    with j = s.index("\n\n", <inside the function>), assuming the first blank
    line after the body was the one right below its closing brace. It was not:
    the next blank line came after the VALUE FORMATTERS block below, so the
    splice swallowed the three formatters along with the function it meant to
    replace. The block is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
    [AAA_Screens.ino]
2026-08-29 Revert the target-prograde glyph; keep the plain prograde symbol
    Your call after seeing it rendered: the context-dependent reading is
    acceptable. The TGT/DOCK velocity marker and both reticle legends go back to
    drawProgradeMarker, the same glyph the PFD ball uses for orbital and surface
    velocity. Context and the per-screen legend distinguish them, which is also
    what KSP itself does -- its navball shows the same prograde symbol whatever
    the velocity mode.
    drawTargetProgradeMarker is removed rather than left unused. The library is
    now byte-identical to 3.3.1, so its version, library.properties and
    changelog all roll back to 3.3.1 -- 3.4.0 existed only on this branch and
    had no consumers, so l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
    [KCMk1_InfoDisp.h, Screen_DOCK.ino, Screen_TGT.ino]
2026-08-29 Derive the angle readouts from the markers; one name per quantity
    Item 4 of the reticle review, all three parts.
    READOUTS VS MARKERS. The Brg/Elv/Err rows still computed horizon-frame
    heading and pitch differences after 1.0.3 moved the markers to a true
    boresight projection, so the numbers contradicted the picture AND the
    ring-derived colour bands. A node 10 deg off the nose printed 13.8 deg at
    45 deg pitch and 62.9 deg at 80; a 6 deg approach-path error printed 9.9 deg
    at 60 deg pitch -- yellow, while the marker sat inside the green ring. MNVR
    now takes its Brg/Elv from the same boresight angles that place its marker
    and gate its alignment box, and DOCK's Nos.Off already did after 1.0.3.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
    [AAA_Config.ino, AAA_Screens.ino, KCMk1_InfoDisp.h, Screen_DOCK.ino, Screen_MNVR.ino, Screen_TGT.ino]
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2026-08-29 Correct the stale geometry notes on the reticle screens
    Item 6, and it turned out to be wider than the MNVR header I flagged.
    MNVR's header and inline comments still described the pre-shared-constants
    layout: centre (289,295), radius 225, scale 11.25 px/deg, rings
    56/112/168/225, a disc drawn at "R=170", MNVR_CY "nudged down for more
    whitespace" and MNVR_R "slightly reduced". All of it has been the shared
    RETICLE_* values for some time: (289,300), 210, 10.5, 52/105/157/210. Its
    "marker colour = always maneuver blue" line was also outdated by the
    previous commit, which dims it while pinned.
    DOCK's layout diagram listed rows that have not existed for a while --
    DRIFT.H and DRIFT.V rather tha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
    [Screen_DOCK.ino, Screen_MNVR.ino, Screen_TGT.ino]
2026-08-29 DOCK: carry the same four angle rows as TGT
    DOCK showed only V.Brg/V.Elv, as two full-width rows, and offered the
    nose-to-port angle solely as the unsigned Nos.Off magnitude. So the signed
    Brg/Elv pair that TGT shows was missing from the screen that needs it most.
    Rows 4 and 5 are now split pairs mirroring TGT exactly:
    Row 4 Brg | Elv the port relative to the nose, informational
    Row 5 V.Brg | V.Elv approach-path error about the target axis,
    colour-banded, "---" past 90 deg
    Nos.Off takes the freed full-width row 6 and keeps its colour band, so
    alignment status is still signalled and DOCK ends up a superset of TGT
    rather than a rearrangement.
    One real t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
    [KCMk1_InfoDisp.h, Screen_DOCK.ino]
2026-08-29 Fix two info-display graphics defects: MNVR value ghost, INCL layering
    printValue cleared the value region starting at regionX (label width + 1 px),
    but textRight right-aligns to x0+w-TEXT_BORDER. The two ends account for
    TEXT_BORDER asymmetrically, so a value that measures inside regionW can still
    be painted up to TEXT_BORDER-1 px to the left of regionX, and the opaque
    background it paints there survived every clear. On MNVR's Brg:/Elv: half
    cells that is 1-4 px: a three-digit alarm reading ("-100°", "+180°") replaced
    by a two-digit one left a red bar at the left edge of the value field. The
    clear now starts at the previous value's own left edge, derived from
    PrintState::prevWidth. That r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
    [Screen_ORB.ino]
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2026-08-30 InfoDisp: fix Info 1 not defaulting to the PFD
    Two defaults still pointed at LAUNCH after the role split.
    SCREEN_HOME: the boot value, the demo-mode entry screen and the screen
    parked behind the standby splash were all hard-coded to screen_LNCH on
    both units, so the vehicle-type panel opened on LAUNCH and only reached
    the PFD once a scene or vessel change fired a context switch — and never
    at all if it booted into an already-running flight scene. Now per unit:
    SPACECRAFT on unit 1, LAUNCH on unit 2. This is the role's resting
    screen rather than its ladder fallback: unit 2's ladder rests on ORBIT,
    but a panel that has never seen telemetry is far likelier to be about to
    launch than to be in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
    [AAA_Globals.ino, KCMk1_InfoDisp.h, KCMk1_InfoDisp.ino, SimpitHandler.ino]
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2026-08-30 InfoDisp: ASC key follows the effective armed state, not the echo
    The sidebar read state.apArmed — the flag Controller_Main echoes back in
    its AscentStatus push — while everything on the Ascent Autopilot screen
    reads apGArmed(), which prefers the pilot's commanded intent while a tap
    is still in flight. Two things annunciating one fact, reading different
    sources of truth.
    So the ARM button flipped to DISARMED on touch while the sidebar key
    stayed green until the echo arrived, and stayed green indefinitely
    whenever it did not. In demo mode it never does: stepDemoState() drives
    state.apArmed from the demo phase and never acknowledges a DISARM tap,
    so apArmOvr never clears and the two disag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
    [AAA_Screens.ino, KCMk1_InfoDisp.h, Screen_LNCH_AscentAP.ino]
2026-08-30 InfoDisp: promote PFD to the top sidebar key on both units
    The sidebar was ordered purely by mission phase, which put LNCH first
    and PFD second. That ordering made sense when one panel had to serve
    every phase; with the roles split it buries the screen a pilot returns
    to from anywhere, and on unit 1 it buried that panel's entire reason for
    existing.
    PFD is now button 0 on both units. The remaining five keep the
    mission-phase progression (LNCH, ORB, TGT, LNDG) with the single-mode
    key at the bottom, so this is a promotion rather than a reshuffle, and
    the order is identical on both panels so one reach serves either.
    SB_PFD_BTN and SB_LNCH_BTN swap values and the two tables reorder.
    Every con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
    [AAA_Screens.ino, KCMk1_InfoDisp.h]
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2026-08-30 Displays: adopt a flight scene already in progress
    flightScene was only ever set by SCENE_CHANGE_MESSAGE, which Simpit
    sends as an event — there is no way to ask for the current scene. A
    panel that boots, or whose USB re-enumerates, while a flight is already
    running never hears it and sits on the standby screen until the pilot
    happens to change scene or vessel.
    Simpit sends FLIGHT_STATUS only from a flight scene, so receiving it
    while the panel believes it is not in one is proof the transition was
    missed. Each panel now adopts the scene there. The hook sits at the end
    of the FLIGHT_STATUS handler rather than earlier so the message's own
    vessel data is already applied: the InfoDisp context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
    [KCMk1_Annunciator.h, KCMk1_InfoDisp.h, KCMk1_ResourceDisp.h, SimpitHandler.ino]
2026-08-30 InfoDisp: armed annunciations show the autopilot's state, not the request
    Tapping DISARM flipped the ARM button and the ARMED/DISARMED banner
    immediately, before Controller_Main acknowledged anything. A command
    that was delayed, dropped, or never sent therefore left the panel
    reading DISARMED while the autopilot was still flying the vehicle —
    the one direction of this control that must not be optimistic.
    The two questions are now separate and named for which is which:
    apArmCommanded() what the pilot has asked for. Decides only what
    the NEXT tap does, so a second tap reverses a
    pending command rather than repeating it and a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
    [AAA_Screens.ino, KCMk1_InfoDisp.h, Screen_LNCH_AscentAP.ino]
2026-08-30 InfoDisp: demo mode acknowledges Ascent Autopilot console commands
    With 1.3.0 making annunciations wait for Controller_Main, and
    apEnqueueCmd() a no-op in demo, the ARM button on the bench did nothing
    at all — correct, but useless for exercising the console.
    The demo now plays the master's part. apDemoApplyCommand() applies
    ARM/DISARM and all six parameter setters to a demo-side autopilot model,
    and stepDemoState() publishes that model into state.ap* instead of the
    literals it used to hardcode, so the command-out/value-back round trip
    closes and the pending cue clears exactly as it does in flight.
    Publishing from a model rather than literals is what makes this work at
    all: the demo previ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
    [Demo.ino, KCMk1_InfoDisp.h, Screen_LNCH_AscentAP.ino]
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2026-08-30 InfoDisp: give EVA its own instruments
    The panel had no EVA awareness at all. type_EVA appeared in exactly two
    label lookups and in neither context ladder, while the other two panels
    already handled it -- the Annunciator tracks inEVA, the ResourceDisp swaps
    to a fixed EVA bar set.
    What a Kerbal outside the craft actually saw:
    Vehicle panel -> SPACECRAFT. The attitude ball is right; you do orient on
    EVA. The numeric panel beside it was not, offering dV.Stg, ApA, PeA, T+Ap
    and T+Ign -- five rows, none of which a person holding a jetpack has.
    Mission panel -> ORBIT, whenever no target was set. That is an apoapsis
    for a Kerbal.
    SPACECRAFT now swaps rows 2-6 to Alt.Rdr, V.Srf, Dist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
    [AAA_Globals.ino, KCMk1_InfoDisp.h, Screen_SCFT.ino]
2026-08-30 InfoDisp: stop NAVIGATION capturing rocket ascent
    Walking the ten mission scenarios against the ladders caught this on the
    first one. A booster a kilometre off the pad is also in an atmosphere with
    a trivial apoapsis, so the rule added in 1.6.0 handed a vertical rocket a
    compass rose from liftoff -- and then swapped to ORBIT mid-burn, the moment
    apoapsis crossed the top of the atmosphere. Two wrong screens and an
    oscillation, across the busiest three minutes of a flight.
    The rule now requires the aircraft condition, which is exactly the one the
    other panel uses to put AIRCRAFT up. A navigation display exists to pair
    with an attitude display, so NAV appears if and only if its partner PFD is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
    [AAA_Globals.ino, KCMk1_InfoDisp.h]
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2026-08-30 InfoDisp: LAUNCH owns the ascent arc, not just the pad
    Rule 1 routes to LAUNCH on sit_PreLaunch alone, so the screen vanished the
    instant the clamps released. The mission panel then spent the entire climb
    to orbit on ORBIT -- a plan view of an orbit that does not exist yet --
    while the ascent readout it does have (ApA, T+Ap, T.Burn, dV.Stg) sat one
    press away. A circularisation node pulled it to MANEUVER, the generic burn
    reticle, rather than the screen built for that exact burn.
    New rule 7 gives LAUNCH the arc from liftoff to orbit insertion. Two tests,
    and between them they say "going up, and not there yet":
    periapsis < max(minSafe, lowSpace) -- there is no orbit yet. That is the
    bou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
    [AAA_Config.ino, AAA_Globals.ino, KCMk1_InfoDisp.h]
2026-08-30 InfoDisp: ASCENT/CIRCULARISATION switches on the engine, not altitude
    The switch fired at 6% of body radius -- 36 km on Kerbin -- which put the
    LAUNCH screen into CIRCULARISATION while the vessel was still climbing
    under power, long before the burn that mode exists to fly.
    Altitude is the wrong axis for it, not a threshold set too low. A spaceplane
    can have its apoapsis parked above the atmosphere while still burning at
    35 km, and a Mun ascent finishes below the Kerbin threshold altogether, so
    no single number serves both. What separates the stages is the engine: you
    are ascending while you are pushing apoapsis up, and coasting once you stop.
    Two conditions start the coast. Throttle closed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
    [AAA_Config.ino, KCMk1_InfoDisp.h, Screen_LNCH.ino, Screen_LNCH_Ascent.ino, SimpitHandler.ino]
2026-08-30 InfoDisp: an apsis convergence tape on the circularisation screen
    The right third of this screen was eight numeric rows mirroring the ascent
    panel: Alt.SL, V.Orb, ApA, PeA, T+Ap, Thrtl, T.Brn, dV.Stg. The pairing
    review measured seven of the eight as also present on the PFD beside it, in
    every phase this screen is up -- 88% of the column, spending 38% of the
    display restating the panel two feet away.
    Swapping the values for better ones was the cheap fix and the wrong one.
    The replacements were all check-once numbers, and the space would still
    have gone on text a glance exhausts.
    What the phase needs is a feedback loop. A circularisation burn is a single
    task -- raise periapsis until it mee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
    [KCMk1_InfoDisp.h, Screen_LNCH_Circ.ino]
2026-08-30 InfoDisp: fix three build errors in the apsis tape
    All three are things my host test could not see, because it extracted the
    new block and compiled that alone.
    'OrTape' does not name a type. The struct lived in the .ino, and Arduino
    hoists a generated prototype for every function to the top of the sketch
    -- so the prototype for the helper that returns one by value was emitted
    ahead of the struct that defines it. It moves to the header beside
    ReCorridor, whose comment documents this exact failure, and is renamed
    ApsisTape.
    The tape's state block sat below _lnchOrResetState(), which clears it, so
    the reset could not see any of it. Moved above.
    _lnchOrPrevApY and _lnchOrPre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
    [KCMk1_InfoDisp.h, Screen_LNCH_Circ.ino]
2026-08-30 InfoDisp: fix marker trails on both halves of the circularisation screen
    The tape and the orbit diagram were sharing one marker cache, so each erased
    at the other's row and both left trails.
    Cause: the 1.9.1 rename ran over a region defined as "everything after the
    tape section", and the orbit diagram's code sits BELOW the tape in this
    file. So _lnchOrPrevApY / _lnchOrPrevPeY were renamed to the tape's
    _lnchOrTp* there as well, and the diagram started writing its own marker
    pixels into the tape's cache. The diagram's names are restored; the two sets
    no longer touch.
    That is the second time a bulk rename in this file has done collateral
    damage -- the first took _lnchOrPrevPeValid by prefix.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
    [KCMk1_InfoDisp.h, Screen_LNCH_Circ.ino]
2026-08-30 InfoDisp: group the circularisation numbers by subject
    The three numbers describing the burn were scattered across the screen for
    historical reasons rather than by intent. dV Circ and Burn Dur sat on the
    left rail because that is where they had always been, and the right column
    carried Ecc and Ap-Pe -- which describe the orbit, not the burn, and had
    landed there only because they were the values the PFD did not duplicate.
    They swap.
    The right column is now dV.Circ / Burn Dur / Stg.Brn. Read top to bottom
    they are one question: can this stage finish this burn. The left rail takes
    Ecc and Ap-Pe, beside the orbit diagram they describe -- the gap in
    particular is the distance between the two d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
    [KCMk1_InfoDisp.h, Screen_LNCH_Circ.ino]
2026-08-30 InfoDisp: stop Ap-Pe overflowing its box
    formatAlt() only switches to km above 1,000,000 m, so every apsis gap from
    100 km to 1000 km rendered as six digits and a separator. "513,000 m"
    measures 135 px and the left-rail value box is 130.
    That band is not exotic -- it is where a Kerbin circularisation starts.
    Apoapsis at 101 km with periapsis still hundreds of kilometres underground
    gives a 513 km gap, so the readout overflowed on the very first frame of the
    burn it was put there to support.
    A local compact formatter promotes a unit band early enough that the scaled
    value never reaches five digits, capping the widest output at "9,999 Mm" at
    128 px. The 9999.5 thresholds are the part that ma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
    [KCMk1_InfoDisp.h, Screen_LNCH_Circ.ino]
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2026-08-30 InfoDisp: remove the two shared row updaters the ascent rework orphaned
    _lnchAs2UpdateAlt() and _lnchAs2UpdateApA() were the shared updaters for the
    Alt.SL and ApA rows in both LAUNCH phases. Neither has a caller left: 1.9.0
    replaced the circularisation phase's readout column with the apsis tape, and
    1.10.0 moved those two values onto the altitude ladder that already draws
    their markers. The Teensy build reported both as defined but not used.
    Removed, and the comment above the shared block corrected -- it still named
    all four shared updaters when only T+Ap and Stg.Brn remain, and now says why
    the other two went.
    The host harness could have caught this. -Wunused-function is in -Wall and
    app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
    [KCMk1_InfoDisp.h, Screen_LNCH_Ascent.ino]
2026-08-30 InfoDisp: box the ascent gauge windows, and fix the ATMO one reading dead
    Three bench findings.
    Boxed windows. Each gauge value now has a thin border, so it reads as part
    of its gauge rather than as loose text floating above it. The clear that
    wipes the old value covers the inside only, so the frame is never touched.
    The ATMO window looked like density was not wired up. It was: the LNCH demo
    path sets airDensity from an exponential atmosphere, and overrides the
    general demo path that runs before it. The format was the problem. The bar
    plots (rho / rho_surface)^0.25 -- a fourth root, precisely so the thin upper
    atmosphere stays visible -- while the window printed kg/m3 at two decimals,
    whic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
    [KCMk1_InfoDisp.h, Screen_LNCH_Ascent.ino]
2026-08-31 InfoDisp: unstack the ascent gauge windows, and give the ATMO one a value worth reading
    Two bench reports on the reworked ascent panel.
    The ATMO and V.Vrt value windows were touching, and the divider between
    them flickered every frame. The ATMO window was a fixed 100 px box centred
    on the bar, x 152..252, while the V.Vrt window starts at 248: both drawRects
    painted the same four columns, so whichever repainted last owned them. The
    window now matches the column's true extent, triangle to triangle -- 166..238,
    72 px, the same width as the other two windows with the same 10 px gap.
    The ATMO window's percentage is gone. Restating where the triangle already
    points adds nothing, which is the sam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
    [KCMk1_InfoDisp.h, Screen_LNCH_Ascent.ino]
2026-08-31 InfoDisp: repair what the ladder markers erase, and stop mixing two screens on a switch
    Four bench reports.
    The atmosphere column loses its value window. A percentage restated where
    the triangle already points, and the time-to-vacuum that briefly replaced it
    was a different quantity from the one the bar plots, which forced the column
    name to label the number rather than the gauge. It is a name and a bar now.
    Q, in the right column, is the atmospheric number that earns digits, and it
    is the one the bar genuinely cannot show.
    The ladder's vessel marker is labelled ALT. It carried "V", which read as a
    velocity, and then nothing at all, which said less than it should.
    Chrome the marker erase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
    [KCMk1_InfoDisp.h, KCMk1_InfoDisp.ino, Screen_LNCH_Ascent.ino]
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2026-08-31 InfoDisp: NAV's compass markers stop erasing each other, and the card gets an aeroplane
    Two bugs behind one bench report of green and violet trails.
    The screen cleared each marker cache's prevAvail whenever the card rotated,
    on the premise that the tick and label redraw passes through the band the
    markers occupy. It does not: ticks live at r=199..219 and the label boxes at
    about 164..188, while the markers are at 123..143. Clearing prevAvail
    suppressed the only erase those markers had, so every rotation left one
    behind.
    The second bug is why the green marker eventually disappeared outright rather
    than smearing. The two markers share one annulus, so the moving target-bearing
    marker's erase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
    [Compass.ino, KCMk1_InfoDisp.h, Screen_NAV.ino]
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2026-08-31 InfoDisp: four NAV cells were blank on entry instead of dashed
    The bench saw it on DRIFT. The cause is general.
    Every value cell on this screen is change-detected against a cached previous
    value, and DRIFT's cache reset to -9999 -- the same sentinel the cell uses for
    "no ground track". So entering the screen with nothing to show compared equal
    to the reset value, the draw was skipped, and the cell stayed black instead of
    showing "---". V.CLS had the identical collision on -9999; DIST and T+INT had
    it on -1. Only BRG escaped, and only by accident, because its reset value and
    its no-value marker happened to differ.
    One reset sentinel that no cell can produce ends the whole class. DIST's
    para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
    [KCMk1_InfoDisp.h, Screen_NAV.ino]
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2026-08-31 InfoDisp: POWERED DESCENT swaps V.Srf for Stg.Brn
    V.Srf was not merely duplicated on SPACECRAFT. It was derivable from three
    numbers on its own screen: the panel already shows V.Vrt, and Fwd and Lat are
    the two components of the horizontal speed, which is itself
    sqrt(V.Srf^2 - V.Vrt^2). Anyone reading the other three already had it.
    Stg.Brn takes the row. Seconds of thrust left has no picture on either panel
    and it is the number a powered descent turns on -- whether you can still stop.
    It uses the same field, the same label and the same thresholds ASCENT and
    CIRCULARISATION already use, so a burn-time warning means the same thing on
    the way up and on the way down.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
    [KCMk1_InfoDisp.h, Screen_LNDG_Powered.ino]
2026-08-31 InfoDisp: TARGET drops to five taller rows
    Alt.SL and V.Orb are gone. Both were duplicated on this screen's partner --
    TARGET is reached from three of the mission ladder's rules and SPACECRAFT is
    the vehicle panel in all three -- and, unlike Dist and V.Close, neither
    related to anything on the scope.
    That distinction is the whole test. The scope is purely angular: it plots the
    bearing and elevation of the target and of the relative velocity vector. Range
    and closure are the two numbers it cannot show, which is exactly what earns
    them their rows despite being on the partner too. Altitude above sea level and
    orbital speed are not about the target at all.
    Nothing replaces them. The closest-ap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
    [KCMk1_InfoDisp.h, Screen_TGT.ino]
2026-08-31 InfoDisp: one name per quantity across all fourteen screens
    Every readout label was collected and compared. Seven quantities carried two
    names:
    Thrtl: was Thr: on ASCENT AUTOPILOT
    Inc: was Incl: on ASCENT AUTOPILOT
    Q: was q: on ASCENT AUTOPILOT
    Drogue: was Drog: on RE-ENTRY
    Slip: was Sl: on the AIRCRAFT panel row -- while the slip BALL on the
    same screen said "Slip:", three inches away
    V.CLOSE was V.CLS on NAVIGATION
    Alt.Trn: was Elev: on ROVER
    The ROVER one was the worst of them. "Elev:" sat one letter from the "Elv:"
    that DOCKING, TARGET and MANEUVER use for an elevation ANGLE -- a different
    quantity in different u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
    [KCMk1_InfoDisp.h, Screen_ACFT.ino, Screen_LNCH_AscentAP.ino, Screen_LNDG_Reentry.ino, Screen_NAV.ino, Screen_ROVR.ino]
2026-08-31 InfoDisp: VEHICLE's status row keeps the situation when the vessel is recoverable
    RECOVERABLE replaced the situation instead of qualifying it, and it discarded
    the more informative half exactly where it mattered. KSP reports a vessel on
    the pad as recoverable -- the same quirk vehicleContextScreen() already has to
    shield against -- so the row read RECOVERABLE rather than PRE-LAUNCH. Splashed
    lost to it too, and being in the water is worth knowing before pressing
    recover.
    It now reads "SPLASHED - RECOVERABLE", still sky blue when recoverable and
    nominal green otherwise. There was never a reason to choose between them: the
    value cell is 749 px wide and the worst combined case is 689.
    Spelled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
    [KCMk1_InfoDisp.h, Screen_VEH.ino]
2026-08-31 Fonts: add U+00B7 MIDDLE DOT to every Roboto Black size
    0xB7 was absent from all ten sizes. The family's second index range runs
    128..181 and 0xB7 is 183, so it fell two codepoints past the end.
    That is worth more than a missing character usually is, because of how the
    renderer treats one: a glyph outside the index range measures zero and draws
    nothing. getFontStringWidth() skips it and kcmDrawString() skips it. So a
    separator written as "\xB7" renders as an unexplained gap and never as an
    error -- it is only ever caught by measuring, which is how this surfaced.
    fonts_ili/add_middot.py does the work, and does not draw the dot by hand. For
    each size it takes that font's OWN period (0x2E) in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
    [KCMk1_InfoDisp.h, Screen_VEH.ino]
2026-08-31 InfoDisp: PFD row 5 is T+Ign in orbit and V.Vrt below the mode switch
    The spacecraft PFD had no vertical speed anywhere. The fix is not to add one
    unconditionally.
    In a circular orbit vertical speed is flatly zero. In an eccentric one it is
    large -- 451 m/s in a 100x500 km Kerbin orbit, 1,156 on a Mun transfer -- but
    it goes to zero exactly at apoapsis and periapsis, so in orbit it is a
    worse-resolution restatement of where you are between the apsides, which
    T+Ap/T+Pe already answers better and in a form you can act on. It is the
    number actually being flown only near a body: touchdown at about -2 m/s,
    powered descent -50, re-entry -200, ascent pitchover +200.
    Real spacecraft treat altitude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
    [KCMk1_InfoDisp.h, Screen_SCFT.ino]
2026-08-31 Fix target closure sign: Simpit sends a magnitude, not a signed rate
    KerbalSimpitRevamped's TargetInfo.cs sets
    myTargetInfo.velocity = FlightGlobals.ship_tgtVelocity.magnitude;
    which is never negative, but AppState documented the field as "negative =
    closing" and every consumer gated on that sign. The gates were therefore
    false forever:
    NAV T+INT permanently "---"
    TARGET T+Int permanently "---"
    DOCKING T+Dock permanently "---"
    TARGET V.Close never nominal green -- yellow or red only
    DOCKING V.Close never green, and %+.2f always printed a leading +,
    so an approach always read as opening
    Demo mode hid all five: Demo.ino writes st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
    [KCMk1_Annunciator.h, KCMk1_InfoDisp.h, SimpitHandler.ino]
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2026-08-31 InfoDisp: PFD row 5 counts a noded burn down
    Apollo's Entry Monitor System dV counter was set before a burn and counted
    to zero as the SPS thrust; the crew shut down on it, and it was the most
    watched number in the burn. Nothing on this controller counted a burn down
    -- MANEUVER carries Brg, Elv, Burn.Dur, T+Ign and T+Mnvr, and no dV at all.
    Row 5 gains a third state. Below the mode switch it stays V.Vrt; above it,
    T+Ign until the burn actually lights, then dV.Rem counting down. The fit is
    exact: a countdown TO ignition is meaningless once ignition has happened, so
    the row is free precisely when the burn number is wanted. V.Vrt's claim below
    the switch is untouched -- a noded burn under 36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
    [KCMk1_InfoDisp.h, Screen_SCFT.ino]
2026-08-31 InfoDisp: pilot-selectable attitude references, and AIRCRAFT gets an altimeter
    Two screens, one mechanism.
    AIRCRAFT had no barometric altitude at all. Row 0 was Alt.Rdr full-time and
    its partner does not cover for it -- NAVIGATION carries Trk, Drift, Brg,
    Dist, V.Close, T+Int and Hdg -- so you could fly a KSP aeroplane on this
    controller and read your clearance over the ridge you were about to hit, but
    never the altitude you were cruising at. Real practice settles both halves at
    once: the PFD's altitude tape is barometric always, and radio altitude is a
    separate conditional readout that appears for the approach (below 2,500 ft on
    the A320) and steps its resolution up as the ground comes clo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
    [AAA_Config.ino, AAA_Globals.ino, AAA_Screens.ino, KCMk1_InfoDisp.h, Screen_ACFT.ino, Screen_SCFT.ino, SimpitHandler.ino, TouchEvents.ino]
2026-08-31 InfoDisp: extreme-attitude chevrons, IAS trend, and a dead stall warning removed
    Chevrons (both attitude screens). Every modern PFD draws red chevrons pointing
    at the horizon past an extreme pitch -- 50 up / 30 down on the G1000, 60/40 on
    the G5 -- because at that attitude the ball alone stops telling you which way
    is out. The onset here is OUR geometry rather than Garmin's numbers: the ball
    is scaled R/30, so the horizon leaves the disc at exactly +/-30 deg both ways
    and the fill goes solid sky or solid ground, which the renderer already has
    ALLSKY/ALLGND sentinels for. Symmetric, because our geometry is. The labelled
    rungs still give the number; the chevrons add the direction of recovery a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
    [AAA_Config.ino, EADIBall.ino, KCMk1_InfoDisp.h, Screen_ACFT.ino]
2026-08-31 InfoDisp: ROVER shows endurance and time-to-target instead of charge level
    A percentage was the wrong number for that block. No EV instrument cluster
    shows state of charge alone -- SOC is always paired with estimated range,
    because SOC answers "how full" and range answers the question actually being
    asked, which is "can I get back". On a Mun rover, 20% says nothing about
    whether that is four minutes or forty. The level is not lost: the Resource
    Display carries EC% and the Annunciator owns the low-charge alarm on the same
    percentage thresholds.
    This is the rover's version of the swap POWERED DESCENT already made from
    V.Srf to Stg.Brn -- convert a level into the time it buys you, because time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
    [AAA_Config.ino, KCMk1_InfoDisp.h, Screen_ROVR.ino, Screen_SCFT.ino]
2026-08-31 InfoDisp: drop the dangling STALL_SPEED_MS extern
    The constant went with the dead stall branch, but its extern declaration
    stayed in the header, still promising a symbol nothing defines. Also corrects
    two comments that named the pre-rename EC threshold constants.
    Claude-Session: https://claude.ai/code/session_01N6pbKZEnqeWZHFHC3kZFPt
    [KCMk1_InfoDisp.h, Screen_ACFT.ino, Screen_ROVR.ino]
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2026-08-31 InfoDisp: fix three readout collisions found on the bench
    All three are geometry defects in the features added over the last few
    commits, and all three were invisible to the host harnesses because those
    verify what a function draws, not what its neighbours draw on top of it.
    SPACECRAFT rate cluster (Screen_SCFT.ino)
    The stack started at y=96, but the roll readout is right-justified into
    x 497..583 and paints its value row at y 97..130 -- squarely on top of
    the "P" label and the top 20 px of the pitch bar, so every change in the
    roll digits erased them. Moved the stack down to y=136 and shortened the
    bars 100 -> 92 so the yaw bar still ends (y=469) above the TRIM flag's
    erase rec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
    [KCMk1_InfoDisp.h, Screen_ACFT.ino, Screen_ROVR.ino, Screen_SCFT.ino]
2026-08-31 Displays: deduplicate PFD geometry, remove dead code, add panel_lint
    A maintenance pass with no behaviour change. Every retained geometry value
    is provably identical and the formatter's output is byte-identical; what
    changes is how many places state each fact, and how many of them are wrong.
    ONE PFD, ONE SET OF NUMBERS
    SPACECRAFT, AIRCRAFT and the shared EADIBall renderer draw one instrument
    and must agree pixel for pixel about where the disc, the tapes and the
    value boxes are. They said so three times over, each re-deriving the whole
    layout from its own copy of CX/CY/R. Comparing every EADI_* constant
    against its ACFT_* and SCFT_* counterpart: 84 pairs, 84 identical, zero
    diffe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
    [AAA_Config.ino, AAA_Screens.ino, EADIBall.ino, KCMk1_Annunciator.h, KCMk1_InfoDisp.h, Screen_ACFT.ino, Screen_LNCH.ino, Screen_LNCH_Ascent.ino]
2026-08-31 InfoDisp: a sidebar press no longer undoes itself
    Found on unit 2: press a button and the panel jumps straight to a third
    screen. Two defects, and the first needs no telemetry to move at all.
    THE LADDER'S HYSTERESIS WAS KEYED ON WHAT THE PRESS CHANGES
    Five mission rules widen their threshold once their screen has been
    chosen, so the panel does not oscillate on a boundary: DOCKING enters at
    200 m and leaves at 250, MANEUVER at 600 s and leaves at 700, POWERED
    DESCENT at 10 km and 12, TARGET at 200/2000 m and 150/2400, LAUNCH at
    V.Vrt >= 0 and releases at -20.
    All five tested `activeScreen`, which switchToScreen() sets. So pressing
    away from an auto-chosen screen collapsed its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
    [AAA_Config.ino, AAA_Globals.ino, KCMk1_InfoDisp.h, SimpitHandler.ino, TouchEvents.ino]
2026-09-02 ResourceDisp: tape meters replace the bar chart (3.3.0)
    Each slot is now a Shuttle-style tape meter instead of a filled bar:
    a narrow thermometer column with the resource's caution and alarm
    fractions painted as a red/yellow limit band on the scale itself, tick
    marks every 5%, and a frame that takes the alert colour on breach. The
    bars' only warning had been the percentage label changing colour, and
    the limits were invisible until crossed.
    Thresholds come from a per-resource table (resLimits). Consumables
    alert low at the cross-panel KCM_RES_LOW_WARN_FRAC / KCM_EC_LOW_ALARM_FRAC
    fractions so a meter goes yellow and red where the Annunciator does;
    waste-type resources (CO2, Waste, Liquid Was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
    [AAA_Config.ino, KCMk1_ResourceDisp.h, KCMk1_ResourceDisp.ino, Resources.ino, ScreenMain.ino]
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2026-09-02 ResourceDisp: split stage column replaces the caret marker; demo sweeps to 100%
    The secondary-value caret sat in a gutter left of the band and was
    erased over the tape rows only, so at 100% its top half sat above
    TAPE_TOP and was never cleared, leaving a ghost when the value moved.
    The caret is gone. For resources with a stage channel the tape is now
    split the way the Shuttle PRPLT QTY meter carried its pointers side by
    side: a wide primary column in the resource colour, a narrow secondary
    column in a half-brightness shade, and a white line across the whole
    interior at the secondary level so it reads against the ticks where
    the narrow column is only a few pixels wide. Everything the marker
    d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
    [Demo.ino, KCMk1_ResourceDisp.h, ScreenMain.ino]
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2026-09-02 ResourceDisp: TTE key replaces the TOTL/STG toggle
    With total and stage both on the tape, the mode key no longer revealed
    anything; it only chose which column was wide and which value the
    counters followed, and leaving the counters on the narrow column was a
    confusing state to strand the panel in. The columns are now fixed:
    wide is vessel total, narrow is active stage, counters follow total,
    and stage figures stay on the DATA screen. stageMode is removed.
    The freed key becomes TTE at the bottom of the sidebar. Engaged, the
    counter row shows time to empty at the current rate (time to full for
    waste-type resources; "---" while steady, filling, or too slow to
    measure), formatted to fit the com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
    [AAA_Config.ino, AAA_Globals.ino, KCMk1_ResourceDisp.h, ScreenMain.ino, TouchEvents.ino]
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2026-09-02 ResourceDisp 3.4.0: alert strip, reserve bugs, balance, rate rows, hysteresis
    Step 1: alert thresholds gain ALERT_HYST_FRAC of hysteresis so a level
    resting on a limit no longer flips colour every message. TTE and rate
    are corrected to game time with the warp index in FLIGHT_STATUS (byte
    2; the in-atmosphere flag selects the physics-warp table), and sampling
    restarts on a warp change so no window blends two rates.
    Step 2: a tap on a meter's foot opens Detail on that resource. Rate and
    trend sampling moves out of the Main screen into Sampling.ino, sampled
    per loop for both total and stage, so Detail gains Rate (units per game
    second) and Time rows in both sections. The Select screen flashes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
    [AAA_Config.ino, AAA_Globals.ino, Demo.ino, I2CSlave.ino, KCMk1_ResourceDisp.h, KCMk1_ResourceDisp.ino, Resources.ino, Sampling.ino]
2026-09-02 Displays: host_compile.py, an IDE-faithful host compile check
    The Arduino IDE concatenates the tabs and hoists a prototype for every
    function above them, which is what turned a struct defined inside a
    .ino into "'MeterStyle' does not name a type" on the bench while a
    tab-by-tab host compile passed. This tool reproduces the hoisting and
    runs g++ -fsyntax-only against stand-ins for the Arduino core, display,
    touch, Simpit and audio libraries in tools/host_stubs/. The palette and
    font metrics are generated from the real KerbalDisplayCommon sources,
    so a TFT_ colour or font name that does not exist fails here too.
    Covers the ResourceDisp's surface today; a new symbol on another panel
    is a one-l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
    [Arduino.h, KerbalSimpit.h, Wire.h]
2026-09-02 ResourceDisp: meters spread across the full width; balance text buffer widened
    The pitch is now the meter area divided by the slot count, so a
    partial set uses the whole screen instead of sitting centred at a
    fixed pitch. The meter itself stays fixed: tape width, stage column
    and fonts still come in the standard (up to nine) and compact
    (ten to sixteen) classes.
    The balance counter's buffer was one byte short for the widest units
    string, which the Teensy build reported as -Wformat-truncation.
    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
    [KCMk1_ResourceDisp.h, ScreenMain.ino]
2026-09-02 ResourceDisp: counter and trend arrow centred as one group
    The counter no longer spans the pitch cell with the arrow parked in a
    fixed cell at its right edge. Counter, a two-space gap and the arrow
    slot are laid out as one group and centred in the cell; the arrow slot
    is reserved whether or not an arrow shows, so the number stays put as
    the trend comes and goes. The alarm tile hugs the group instead of
    filling the cell, which mattered once the pitch could be the whole
    screen.
    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
    [KCMk1_ResourceDisp.h, ScreenMain.ino]
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2026-09-02 KerbalDisplayCommon 3.8.0: TFT_BRICK, TFT_PLUM, TFT_STRAW; ResourceDisp uses them
    Three palette entries for the ResourceDisp meter fills, each filling a
    gap the existing palette could not: a rust red for Solid Fuel that
    stays clearly off the alarm red beside a red limit band; a muted
    magenta for CO2, which alerts HIGH against a red band and so cannot be
    a red; and a pale straw yellow for Liquid Waste, which is meant to
    read as what it is, the way Waste is brown.
    Stored Charge moves from dull yellow, which sat too close to the gold
    Electric Charge uses, to purple. The host compile tool now takes the
    library version from the real header rather than a hardcoded stub.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
    [Resources.ino]
2026-09-02 ResourceDisp: tap a meter for Detail, hold a tape for the bug, bug in cyan
    A tap anywhere on a meter now opens Detail. The reserve bug moves to a
    two-second hold on the tape: a confirmed meter touch arms a hold
    record instead of acting, and the outcome is decided later -- release
    before BUG_HOLD_MS is a tap, a matured hold on a tape sets or clears
    the bug at the level first touched and the release then does nothing.
    The sidebar keys still fire on touch-down.
    A crossed bug is its own alert state, ALERT_BUG, drawn in the bug's
    cyan on the frame, the counter and the strip message rather than
    caution yellow; the fixed limit bands outrank it.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
    [AAA_Config.ino, KCMk1_ResourceDisp.h, Resources.ino, ScreenMain.ino, TouchEvents.ino]
2026-09-02 KerbalDisplayCommon: TFT_LIME; Stored Charge uses it
    Purple for Stored Charge sat too close to the plum CO2 now uses, and
    every other free palette entry was dark, a chrome colour, or a near
    neighbour of something in an adjacent group. A yellow-green is far in
    hue from both the gold beside it and the magentas, and reads as
    electrical. Folded into the 3.8.0 palette additions.
    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
    [Resources.ino]
2026-09-02 ResourceDisp: a meter release must persist before it counts
    isTouched() is a polled register read over bit-banged I2C, and one
    read can come back empty or fail while the finger is still down. The
    hold logic took any single untouched read as the release, so a glitch
    mid-hold looked like a tap and opened Detail before the bug could
    mature. A release now has to persist for TOUCH_RELEASE_MS; a shorter
    gap is ignored and the hold keeps timing from its original start.
    Debug output added for the arm, mature and tap events.
    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
    [TouchEvents.ino]
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2026-09-02 ResourceDisp: grab a bug to drag it, hold still on it to clear it
    Clearing a bug needed the hold to land within 3% of it, which a
    finger rarely manages, so a hold near a bug set a second one beside it
    instead. A touch that lands within BUG_GRAB_TOL of a bug now grabs
    it: held still for BUG_HOLD_MS it clears the bug; moved more than
    BUG_DRAG_MIN_PX it becomes a drag and the bug follows the finger
    until release, with neither hold nor tap firing. The travel threshold
    is the hysteresis that keeps a twitch during a hold from reading as a
    move. A touch that lands clear of any bug behaves as before: hold to
    set, release early to open Detail.
    toggleMeterBug is replaced by meterLevelAtY, meterBugNea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
    [AAA_Config.ino, KCMk1_ResourceDisp.h, ScreenMain.ino, TouchEvents.ino]
2026-09-02 ResourceDisp: presence-driven meters, mission presets, CLR BUG key, fixed order
    Resource presence: the Simpit plugin sends a resource message with
    total = 0 and available = 0 when the vessel has no such resource, and a
    channel request forces that message even when nothing changed, so a
    zero total after a refresh is a definitive "not aboard". Every vessel
    message now records presence per resource type; a refresh resets it
    to unknown, and a channel that never answers becomes absent at the
    timeout. An absent resource draws no meter -- the row is laid out from
    the visible slots only, so SF and Ablator in the launch preset cost
    nothing on a craft without them -- and is inert on the Select screen,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
    [KCMk1_ResourceDisp.h, Resources.ino, Sampling.ino, ScreenMain.ino, ScreenSelect.ino, SimpitHandler.ino, TouchEvents.ino]
2026-09-02 ResourceDisp 3.5.0: bug figures, strip taps, Detail bug bar, time-remaining tiers
    The reserve bug shows its percent in small cyan figures beside the
    index, and is clamped to 1..99%. A tap on an alert-strip message opens
    Detail on that resource; the strip records the x range of each message
    it draws. The Detail screen gains a bug bar along the bottom: the bug's
    value in cyan, -10 / -1 / +1 / +10 keys to set it to a precise percent
    (the first step on a resource without a bug starts one at the caution
    fraction), and CLR with the guard treatment; the data rows shrink to
    make room, with Roboto_Black_32 for the ten-row layout.
    EC, Oxygen, Water and Food also alert on the time they have left at
    th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
    [AAA_Config.ino, KCMk1_ResourceDisp.h, Resources.ino, ScreenDetail.ino, ScreenMain.ino, TouchEvents.ino]
2026-09-02 ResourceDisp: bigger Detail bug keys, CLR BUG last and two-line, preset order, demo absence
    The Detail bug bar is 80 px tall with 110 x 68 px keys, and a tap
    anywhere in the bar's height on a key's column counts; the old 38 px
    keys sat partly inside the bottom-edge touch dead zone. CLR BUG moves
    to the bottom of the sidebar and draws its legend on two lines in the
    sidebar font. Presets run SPCT, XPD, SRF, ACFT, LSP, ADV. Demo mode
    gains a scripted presence scenario: every 20 s it moves through
    nothing absent, SF and Ablator absent, then those plus MP and Xenon,
    holding an absent resource's values at zero, so the collapse and the
    Select dimming can be checked on the bench.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
    [Demo.ino, KCMk1_ResourceDisp.h, Resources.ino, ScreenDetail.ino, ScreenMain.ino, ScreenSelect.ino, TouchEvents.ino]
2026-09-02 ResourceDisp: bug hold is 1 s; touch-set bugs snap to 5%
    A finger is not a 1% instrument. Bugs set by a hold or moved by a drag
    now land on the nearest multiple of BUG_SNAP_PCT; the Detail screen's
    keys still set a bug to the exact percent.
    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
    [AAA_Config.ino, KCMk1_ResourceDisp.h, ScreenMain.ino]
2026-09-02 ResourceDisp: 5% snap applies to the hold only; a drag moves the bug by 1%
    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
    [AAA_Config.ino, KCMk1_ResourceDisp.h, ScreenMain.ino, TouchEvents.ino]
2026-09-02 ResourceDisp 3.6.0: presence across refresh, rates across redraws, alarm flash, no floor, strip tab
    A plain refresh no longer resets presence to unknown, so a Select
    change does not flash absent meters back as "..." for three seconds;
    only a vessel switch or scene entry resets it. The sampling arrays and
    the strip's alarm timers are indexed by slot and are now discarded only
    when the slot sequence actually changed, so a redraw for a presence
    change or a vessel-name message keeps the ten-second rate estimate.
    A tile that has just turned alarm flashes in the strip for
    ALARM_FLASH_MS, the caution-and-warning convention for a new alarm,
    then holds steady. The Detail selector dims a resource the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
    [AAA_Config.ino, KCMk1_ResourceDisp.h, KCMk1_ResourceDisp.ino, Resources.ino, ScreenDetail.ino, ScreenMain.ino, ScreenMainStrip.ino, ScreenSelect.ino]
2026-09-02 Displays: host_compile.py covers all three panels on the real libraries
    The tool now compiles against the in-repo libraries themselves --
    KerbalDisplayCommon, KCM_Display, KCM_Touch, KerbalDisplayAudio,
    KCMk1_SystemConfig and the fonts -- with stand-ins only for what the
    repo does not carry: the Arduino/Teensy core, the RA8876 driver class,
    and the KerbalSimpit client, whose message ids, flags and payload
    structs are reproduced with the library's real values. A colour, font,
    library function or Simpit id that does not exist fails here the way
    it fails in the IDE, and the stubs no longer have to track the
    library. KerbalDisplayCommon.h's absolute Windows include of
    Software/Common/body_params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
    [Arduino.h, KerbalSimpit.h, RA8876_t41_p.h, SimpitHandler.ino]
2026-09-02 ResourceDisp 3.7.0: EVA layout as 270-degree ring gauges
    On EVA the Main screen hands its content area to ScreenEVA.ino: one
    large gauge for EVA Propellant, the resource a jetpack is about, and
    four small ones for EC, O2, Food and Water. Each is a 270-degree arc
    open at the bottom, filling clockwise from the lower left in the
    resource colour on a half-brightness track -- a dial, not a progress
    ring -- with the label in the gap, the percent counter and trend
    arrow inside, the time to empty always shown, and on the big gauge
    the raw units. Limit bands are thin red and yellow arcs just outside
    the track at the low end of the sweep; a reserve bug is a cyan dot
    outside them.
    The driver has no ar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
    [KCMk1_ResourceDisp.h, KCMk1_ResourceDisp.ino, ScreenEVA.ino, ScreenMain.ino, TouchEvents.ino]
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2026-09-02 ResourceDisp: EVA gauges on a fixed dot grid, solid bands, re-spaced, bug figures
    The trail of light colour left on a shrinking arc was a phase error:
    the erasing dots started from the new end angle and so never landed
    on the centres the coloured dots were drawn at, leaving their scallops
    poking out between. Every dot now sits on a fixed angular grid of a
    whole number of steps across the sweep, so an erase covers exactly
    what a draw painted; the arc end is the highest grid index at or
    below the level and the cap is relit after an erase.
    The limit bands were sparse dots and read as beads; they are now
    thick-line arcs of short round-capped chords, one solid stroke.
    The small gauges overlappe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
    [ScreenEVA.ino]
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2026-09-02 ResourceDisp: vessel memory and TTE toggle persist in EEPROM
    The per-vessel slot cache (types and reserve bugs) and the TTE toggle now
    survive a power cycle. New Persist.ino keeps them in the Teensy 4.1's
    emulated EEPROM as a ~1.5 KB image with a magic, a schema number and a
    CRC-16; a block that fails any of those is discarded and a fresh empty one
    written, which is also how a schema bump or PERSIST_WIPE forgets.
    Writes happen on a vessel switch and on leaving the flight scene, where a
    few milliseconds' hitch cannot be seen, and otherwise once a signature of
    the live state (slot types, bug percents, the toggle) has held still for
    PERSIST_SETTLE_MS (30 s), when the current vessel's layout is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
    [AAA_Config.ino, AAA_Globals.ino, Arduino.h, EEPROM.h, KCMk1_ResourceDisp.h, KCMk1_ResourceDisp.ino, Persist.ino, SimpitHandler.ino]
2026-09-03 ResourceDisp: pilot-set default layout; unknown vessels start from it
    The Select screen gains a DFLT key above CLEAR: the current selection,
    reserve bugs included, becomes the default layout, what the panel shows at
    boot and what a vessel not in memory starts with. The key lights cyan when
    the selection already is the default and the slot counter flashes DFLT SET.
    An empty selection cannot be a default, so CLEAR then DFLT drops the stored
    one (DFLT CLR) and the SPCT preset is the default again. The default is
    written to EEPROM at once and travels in the persistence image beside the
    vessel memory (schema 2, so a 3.8.0 block is discarded once at boot).
    A vessel whose name is not in memory now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
    [AAA_Config.ino, AAA_Globals.ino, KCMk1_ResourceDisp.h, KCMk1_ResourceDisp.ino, Persist.ino, Resources.ino, ScreenSelect.ino, SimpitHandler.ino]
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
